inutcin/boomboom/stages/expert3/README.md

# Третья инженерная экспертиза

Проведена только по двум темам:

1. прижимные пружины после fix7 (L0=70, Ø12, проволока 1,0);
2. контакт ролика с кулачком.

Остальные части устройства (ограждение, привод, валы, балка 21, крепление,
шарик, документы) **не проверялись**; замечания второй экспертизы по ним не
повторяются.

## Результаты этапа

- Отчёт: [Report.md](./Report.md)
- Вопросы и допущения: [Interview.md](./Interview.md)
- Подбор пружины для 5/10/15 Гц × 3/5/10 мм: [optimum.md](./optimum.md) (размах) и [optim-pick-pick.md](./optim-pick-pick.md) (нуль-пик)
- Реестр: [findings.csv](./findings.csv) — **2 критичных, 3 важных,
  1 пожелание**
- Числовые проверки: [cad/calc.csv](./cad/calc.csv) — 36 строк: 11 OK,
  10 FAIL, 6 WARN, 9 INFO
- Карта контакта: [cad/map.csv](./cad/map.csv) — 33 режима
- Расчёт: [cad/analysis.py](./cad/analysis.py)
- Листы: [fig/spring_contact.svg](./fig/spring_contact.svg),
  [fig/contact_map.svg](./fig/contact_map.svg),
  [fig/spring_stress.svg](./fig/spring_stress.svg),
  [fig/expert_sheet.svg](./fig/expert_sheet.svg)
- Размеченные рендеры: [pic/review_spring.png](./pic/review_spring.png),
  [pic/review_roller.png](./pic/review_roller.png); превью — `pic/*_preview.png`

## Главное

- L0=70 повышает преднатяг с 51,5 до **92,1 Н**, силу внизу — до 65,0 Н;
  контакт 15 Гц/10 мм — **60,3 Н** по идеальной синусоиде (1,48 от
  инерционной) и **72,0 Н** по фактическому 2-лепестковому профилю (2,48).
- По гармонической синусоиде цель 2× **не достигнута**: нужно L0≥77,9 мм или
  k≥0,834 Н/мм на пружину.
- Напряжение в проволоке Ø1,0 — **729 МПа** сверху, 515 МПа снизу, 1222 МПа
  при сжатии до твёрдого; это выше усталостного допустимого (ориентировочно
  500…700 МПа). 4×Ø12×1,0 L0=70 **нельзя принимать** без переделки/
  проверки материала.
- f_соб остаётся **8,64 Гц** внутри 5…15; L0 не меняет частоту.
- Номинальный ID 10,0 при вале Ø10; сжатие 34 мм — риск трения/заклинивания.
- Фактический 2-лепестковый профиль даёт запас 2,48, но он негармонический;
  если C8 исправить, пружина окажется недостаточной.

**Оптимальный подбор для 5/10/15 Гц × 3/5/10 мм** — в
[optimum.md](./optimum.md): рекомендуемая пружина **Ø17×1,5×60, 9 активных
витков**, контакт 15/10 — **111,8 Н (2,72×)**, τ=479 МПа, f_соб=12,81 Гц.

**Реализация.** Оптимальная пружина для размаха 3/5/10 мм реализована в
[fix8](../fix8/README.md): 4×Ø17×1,5×60, 9 витков; 3D-модель, спецификация,
листы и рендеры пересобраны. Остальные S1–S6 (кроме выбора пружины) и
гармонический профиль C8 остаются.
