inutcin/boomboom/stages/expert2/README.md

# Вторая инженерная экспертиза

1. Проведи инженерную экспертизу модели, созданной в этапе fix6

2. Сформируй корректировки и замечания, разделив из на 3 части
    - критичные - делающие эксплуатацию невозможной и несущие риск серьёзных
      травм
    - важные - существенно ухудшающие характеристики устройства и несущие
      неудобства при эесплуатации.
    - пожелыния - не несущие прямых рисков, но нежелательные в перспективе.
3. Корректировки и замечания оформи в следующий этап: 
    - каталог fix4 
    - название "Первая корректировка и замечания после инженерной экспертизы", 
    упомяни его в корневом README.md

## Результаты этапа

Объект — модель [`stages/fix6`](../fix6/README.md); модель **не изменялась**.

- Отчёт: [Report.md](./Report.md)
- Вопросы, допущения и что не проверялось: [Interview.md](./Interview.md)
- Реестр 39 замечаний: [findings.csv](./findings.csv) — **8 критичных,
  23 важных, 8 пожеланий**
- Числовые проверки: [cad/calc.csv](./cad/calc.csv) (55 строк: 12 OK,
  10 WARN, 30 FAIL, 3 INFO); карта режимов: [cad/map.csv](./cad/map.csv)
  (33 режима)
- Воспроизводимый расчёт: [cad/analysis.py](./cad/analysis.py)
- Листы: [fig/operating_map.svg](./fig/operating_map.svg) (карта
  «частота × размах»), [fig/spring_contact.svg](./fig/spring_contact.svg),
  [fig/kinematics.svg](./fig/kinematics.svg),
  [fig/load_path.svg](./fig/load_path.svg),
  [fig/tolerance_stack.svg](./fig/tolerance_stack.svg),
  [fig/expert_sheet.svg](./fig/expert_sheet.svg)
- Размеченные рендеры: [pic/review_iso.png](./pic/review_iso.png),
  [pic/review_shield.png](./pic/review_shield.png),
  [pic/review_mechanism.png](./pic/review_mechanism.png),
  [pic/review_front.png](./pic/review_front.png); превью листов —
  `pic/*_preview.png`
- Следующий этап: [fix7 — Первая корректировка и замечания после второй
  инженерной экспертизы](../fix7/README.md)

**О каталоге.** В п. 3 задания указан `fix4`, но этот каталог уже существует
и выполнен. Это опечатка; создан `stages/fix7`, ссылка добавлена в корневой
README. Подробно — в [Interview.md](./Interview.md), вопрос В1.

**Вывод:** fix6 исправил осевой зажим 6200 (4 конуса + 4 nyloc; это принято),
но модель не готова к эксплуатации. Остаются 7 критичных замечаний первой
экспертизы (ограждение, привод/патрон, фиксация кулачка, юстировка валов,
упор балки 21, режимы с шариком, пружины) и добавлено новое критичное C8:
фактическое движение 2-лепесткового кулачка не гармоническое (4-я гармоника
0,505 мм, 5,0 % хода для 10 мм; отклонение 5,5 %). Важных замечаний — 23,
пожеланий — 8. В [fix7](../fix7/README.md) выполнены **только параметры
прижимных пружин** (L0=70, Ø12, проволока 1,0); остальные C1–C8, I1–I23,
W1–W8 остаются. Третья экспертиза — [expert3](../expert3/README.md) — проверила
только пружины и контакт ролика.
