inutcin/boomboom/stages/expert/README.md

# Инженерная экспертиза

1. Проведи инженерную экспертизу модели, созданной в этапе fix3
2. Сформируй корректировки и замечания, разделив из на 3 части
    - критичные - делающие эксплуатацию невозможной и несущие риск серьёзных
    травм
    - важные - существенно ухудшающие характеристики устройства и несущие
    неудобства при эесплуатации.
    - пожелыния - не несущие прямых рисков, но нежелательные в перспективе.
3. Корректировки и замечания оформи в следующий этап: 
    - каталог fix4 
    - название "Первая корректировка и замечания после инженерной экспертизы", 
    упомяни его в корневом README.md

## Результаты этапа

- Отчёт: [Report.md](./Report.md)
- Вопросы, допущения и что не проверялось: [Interview.md](./Interview.md)
- Реестр 33 замечаний: [findings.csv](./findings.csv) — 7 критичных,
  18 важных, 8 пожеланий
- Числовые проверки: [cad/calc.csv](./cad/calc.csv) (33 строки: 6 OK,
  8 WARN, 14 FAIL, 5 INFO); карта режимов: [cad/map.csv](./cad/map.csv)
- Воспроизводимый расчёт: [cad/analysis.py](./cad/analysis.py)
- Листы: [fig/operating_map.svg](./fig/operating_map.svg) (карта
  «частота × размах»), [fig/spring_contact.svg](./fig/spring_contact.svg),
  [fig/kinematics.svg](./fig/kinematics.svg),
  [fig/load_path.svg](./fig/load_path.svg),
  [fig/tolerance_stack.svg](./fig/tolerance_stack.svg),
  [fig/expert_sheet.svg](./fig/expert_sheet.svg)
- Размеченные рендеры: [pic/review_iso.png](./pic/review_iso.png),
  [pic/review_mechanism.png](./pic/review_mechanism.png),
  [pic/review_front.png](./pic/review_front.png); превью листов — `pic/*_preview.png`
- Следующий этап: [fix4 — Первая корректировка и замечания после инженерной экспертизы](../fix4/README.md)

**Вывод:** модель fix3 геометрически целостна (143/144 проверок OK), но не
готова к эксплуатации: 7 критичных замечаний (ограждение, привод/патрон,
осевая фиксация кулачка, юстировка валов, упор балки 21, режимы с шариком,
пружины), 18 важных и 8 пожеланий. Модель fix3 не изменялась; исправления
вынесены в fix4.
