inutcin/boomboom/stages/fix11/Report.md

# Отчёт по этапу «Третья корректировка после третьей инженерной экспертизы»

Дата: 2026-11-03; дополнение по валам — 2026-11-05
Этап: `stages/fix11`
База: [`stages/fix9`](../fix9/README.md) (имперская ветвь)
Инструменты: FreeCAD 0.19 (`Part`, HLR), Blender 3.0.1 (EEVEE),
Python 3.10, cairosvg.

Этап выполняет **10 замечаний** [`README.md`](./README.md) с уточнениями
пользователя: шпильки разведены на **40 мм** от осевой линии, сверху
ничего не накручивается, балка поджимается снизу шайбой и гайкой,
опора шпильки — шайба и гайка на нижней балке.

## 1. Результат

| Результат | Файлы |
|---|---|
| 3D-модель, STEP сборки | `cad/step/vibrotable_assembly.step` |
| STEP деталей и отрезков | `cad/step/22_T01…T18.step`, `22_frame.step`, `41_clamp_studs.step`, `42_clamp_bottom.step`, `43_clamp_press.step`, остальные `*.step` |
| Исходники | `cad/model.py`, `params.py`, `build.py`, `draw_sheet.py`, `export_groups.py`, `render_views.py` |
| Печатные детали | `cad/stl/table.stl`, `overlay.stl`, `podstol.stl`, `cam_3/5/10.stl`; `cad/print.csv` |
| Спецификация | [`spec.csv`](./spec.csv) (45 поз.), [`shopping.csv`](./shopping.csv) (47 строк), [`params.csv`](./params.csv) |
| Деталировка труб и сварка | [`fig/frame_tubes.svg`](./fig/frame_tubes.svg), [`tube_cut.csv`](./tube_cut.csv); размеры рамы 300/200/360, виброотсек/вынос 160/200, поперечины 140, балки выноса 180, по граням поперечин 110/130 |
| Раскрой 4 труб ×1000 мм | [`techdraw/`](./techdraw/README.md): A4 альбом, М 1:5, PDF/SVG/PNG, `cut_plan.csv`; 18 отрезков рамы, остаток 170 мм; балки 21 — из отдельной трубы |
| Раскрой направляющих валов | [`techdraw/shaft_cut_layout.py`](./techdraw/shaft_cut_layout.py): A4 альбом, М 1:2,5, PDF/SVG/PNG/CSV; 2 прутка Ø10×500 → 4 вала по 176 мм (166 + 5×2), резьба M10×15, рез 5 мм, остаток 276 мм |
| Эскизы деталей | [`fig/details.svg`](./fig/details.svg), [`fig/clamp.svg`](./fig/clamp.svg), [`fig/cam.svg`](./fig/cam.svg), [`fig/vibrotable_shield.svg`](./fig/vibrotable_shield.svg) |
| Проекции / изометрия | [`fig/vibrotable_views.svg`](./fig/vibrotable_views.svg), [`fig/iso.svg`](./fig/iso.svg), [`fig/iso_open.svg`](./fig/iso_open.svg) |
| Инструкция по сборке | [`Assembly.md`](./Assembly.md), [`fig/assembly_steps.svg`](./fig/assembly_steps.svg), [`torque.csv`](./torque.csv) |
| Проверки / массы | [`cad/checks.csv`](./cad/checks.csv) (207: 204 OK, 3 предупреждения), [`cad/mass.csv`](./cad/mass.csv) |
| Рендеры | `pic/render_*.png` (Blender EEVEE); превью листов — `pic/*.png` |

## 2. Что изменено по замечаниям

| № | Замечание | Реализация |
|---|---|---|
| 1 | Не фрезеровать пазы в уголках, не сверлить стойки | Пазы и отверстия в стойках убраны; в накладках только 2×Ø4,5 под M4 |
| 2 | Уголки не держат балку вниз; держат от вываливания вперёд/назад | Накладки 50×50, ширина 25, 2 мм, 8 шт.; лепесток 50 перекрывает стойку на 20 мм и упирается, без крепления; влево-вправо держат стойки |
| 3 | 2×Ø10 в верхней грани нижней балки, низ не сверлить | В T13/T14: 4 отверстия Ø10 (по 2 на балку), X=10/150, **Y=60/140**, только верхняя стенка |
| 4 | Сквозные Ø10 в прижимной балке | В балке 21: 2×Ø10 сквозь верхнюю и нижнюю грани на Y=60/140 |
| 5 | Шпилька M10 в нижнюю балку и через прижимную | 4 шпильки **M10×117**, строительные 4.6; низ Z=18 в гнезде, верх Z=135 (5 мм над балкой); Y=60/140 |
| 6 | Шайбы и гайки между балками; опускание верхними гайками | **Сверху ничего**; опора — шайба + гайка nyloc на верхней грани нижней балки (Z=20); поджим — шайба + гайка снизу прижимной балки (Z=100,5…110); ход 20 мм поджимной гайкой |
| 7 | Лепестки 50 мм; к балке M4 с nyloc; к стойкам не фиксировать | Накладки 50×50; 8 винтов M4×35 + 8 nyloc + 16 шайб; к стойкам крепления нет |
| 8 | Вал привода и ось ролика — высокопрочные | В спецификации: «8.8 высокопрочная»; шпильки поджима — «4.6 строительная» |
| 9 | 3 комплекта шпилек привода с приваренной гайкой | Поз. 20 — 3 компл. (1 установлена + 2 запасных); в сборке 1 |
| 10 | Шпильки поджима — строительные | Отдельная поз. 41, M10×117, 4 шт., 4.6 |

## 3. Геометрия узла поджима

- **Рама:** 18 отрезков 20×20×2, 360×200×300; T13/T14 — 4×Ø10 только
  в верхней стенке (Z=18…20), низ не сверлить; отверстий в стойках нет.
- **Балка 21:** 2 шт., труба 20×20×2, L=159,6, Z=110…130; седло R15×5;
  2×Ø10 на Y=60/140; 4×Ø4,5 на Y=30/45/155/170; 4 втулки 16×16×2 L=16.
- **Накладки:** 8 шт., 50×50, ширина 25, 2 мм; вертикальный лепесток
  25×50 (Z=80…130), горизонтальный 50×25 (Z=110…135); перекрытие
  стойки 20 мм; 2×M4×35 на конец.
- **Шпильки:** 4×M10×117; X=10/150, **Y=60/140**; низ Z=18 (гнездо),
  верх **Z=135**; над балкой **5 мм**; до нижних гаек валов (Z=140,5) —
  **5,5 мм** (по Y разнесены на 10 мм); до средней поперечины — 15 мм.
- **Опора:** шайба Ø20/Ø10,5×1,5 + гайка M10 nyloc на верхней грани
  нижней поперечины (Z=20…29,5); шпилька опирается на гайку.
- **Поджим:** шайба Ø20/Ø10,5×1,5 + гайка M10 снизу прижимной балки
  (Z=100,5…110); сверху на шпильку ничего нет.
- **Ход балки:** 20 мм (130→110) поджимной гайкой; прорезь уходит ниже
  6200 на 15 мм.
- **Съём:** отдать поджимную гайку, опустить балку на 20 мм, поднять её
  со шпильками на 2 мм; снять опорную гайку, поднять шпильку на 2 мм и
  вынуть. Верх шпильки при этом 137 мм — ниже средней поперечины (150).

## 4. Проверки

[`cad/checks.csv`](./cad/checks.csv): **207 проверок, 204 OK,
3 предупреждения**.

| Проверка | Значение | Норма | Статус |
|---|---|---|---|
| Рама — число отрезков / сечение | 18 / 20×20×2 | 18 / 20×20×2 | OK |
| Рама — габарит | 360×200×300 | 360×200×300 | OK |
| Рама — отверстия под шпильки | 4×Ø10, только верхняя стенка | 4 | OK |
| Рама — отверстия в стойках | 0 | 0 | OK |
| Балка 21 — Ø10 / Ø4,5 | 2 / 4 | 2 / 4 | OK |
| Накладки — 50×50 / перекрытие | 50×50 / 20 мм | 50×50 / 20 | OK |
| Накладки — к стойкам | нет | нет | OK |
| Шпильки — 4×M10×117 | 4 / 117 / 5 | 4 / 117 / ≤5 | OK |
| Шпильки — Y=60/140 | 40 мм от оси | 40 | OK |
| Шпильки — опора / поджим | шайба+гайка / шайба+гайка | 1+1 | OK |
| Шпильки — сверху | ничего | нет | OK |
| Шпильки — зазор до нижних гаек валов | 5,5 мм | >2 | OK |
| Валы — длина / резьба | 176 / M10×15 | 176 / M10×15 | OK |
| Валы — крепление | 2 гайки M10 + 2 шайбы Ø18 | 2+2 | OK |
| Шпильки — зазор до поперечины | 15 мм | >0 | OK |
| Шпильки — зазор до 6200 | 20 мм | >5 | OK |
| Ход балки | 20 мм | 20 | OK |
| Съём — подъём шпильки | 2 мм | <8 | OK |
| Съём — верх шпильки | 5 мм | ≤5 | OK |
| Съём — балка над шпильками | 2 мм | ≤8 | OK |
| Седло 6200 в стенке 2 мм | R15×5 | R15×5 | **ВНИМАНИЕ** |
| f_соб стола | 12,8 Гц | вне 5…15 | **ВНИМАНИЕ** |
| Кожух — резьба M4 в стенке 2 мм | 2 мм | ≥2 | **ВНИМАНИЕ** |
| Габарит сборки | 382×218×313 | 382×218×313 | OK |
| Масса без дрели | 9,12 кг | — | OK |
| Пересечения (все пары) | 0,000 мм³ | <0,5 | OK |
| Ходы стола ±5 / кулачки 3/5/10 | 0,000 мм³ | <0,5 | OK |
| Балка 21 вниз 20 / картридж 44 | 0,000 мм³ | <0,5 | OK |

Предупреждения — только унаследованные:

1. **Седло 6200 в стенке 2 мм** — контакт по кромке, проверить.
2. **f_соб 12,8 Гц** внутри 5…15 Гц — S3 expert3; демпфер.
3. **Резьба M4 в стенке 2 мм** под кожух — слабая, но нагрузка мала.

## 5. Масса

| Узел | Масса, г |
|---|---:|
| Рама (18 труб + втулки/гайки) | 4193,1 |
| Балка 21 + втулки + заглушки | 450,6 |
| Накладки + крепёж M4 | 297,7 |
| Шпильки, опора, поджим | 381,7 |
| Стол / накладка | 559,5 |
| Подстолье + винты | 540,2 |
| Валы / гайки / шайбы / пружины | 572,4 |
| LMK / 6200 / ролик | 579,4 |
| Картридж (кулачок, вал, ось, гайки, кронштейн) | 498,8 |
| Кожух / винты | 747,7 |
| Остальное (заглушки, U-хомуты, винты LMK/накладки, буферы, кольца) | 301,9 |
| **ИТОГО без дрели** | **9123,1** |

Масса снизилась с 9458,3 г (fix9) на **335,2 г**:

- добавлены шпильки, опора и поджим: +381,7 г;
- накладки и крепёж M4 вместо уголков и M6: −402,5 г;
- убраны 8 втулок из стоек: −108,9 г;
- замена ограничителей WCS10FR на гайки/шайбы и удлинение валов:
  −192,2 г;
- прочее (отверстия, заглушки): ≈−13,3 г.

Две запасные шпильки вала с гайками (по 149,5 г) в сборку не входят:
транспортная масса ≈**9,42 кг**. Движущаяся масса (стол + накладка +
LMK + кронштейны + ролик + пружины + шарик) ≈0,92 кг; 4k=5,989 Н/мм;
f_соб≈12,8 Гц.

## 6. Узел поджима: как работает

- Шпилька **не** проходит через всю высоту с гайками: сверху ничего нет,
  по длине только две гайки — опорная (nyloc) и поджимная.
- Опорная гайка с шайбой лежит на верхней грани нижней поперечины;
  шпилька опирается на неё, а не на дно балки. Это задаёт высоту шпильки.
- Поджимная гайка с шайбой стоит снизу прижимной балки и поднимает её
  к 6200; при ослаблении балка опускается на 20 мм. Верх шпильки 135 мм,
  поэтому нижние гайки валов (Z=140,5…148,5) не задеваются; по Y они
  разнесены на 10 мм.
- Съём: отдать поджимную гайку, опустить балку, поднять её со шпильками на 2 мм; затем снять опорную гайку и вынуть шпильку (подъём 2 мм).
  Средняя поперечина (Z=150) не мешает: верх шпильки 137 мм.

## 7. Остатки expert2 / expert3

В этап **не входили** и остаются:

- **C1** — ограждение/аварийный останов;
- **C2** — привод «дрель–вал» (патрон, хвостовик, муфта, осевой упор);
- **C3** — осевая/радиальная фиксация кулачка;
- **C4** — юстировка параллельности валов;
- **C5** — седло/кромка 2 мм балки 21 — испытания;
- **C6** — определение «амплитуды» (принят размах) и карта режимов;
- **C7** — пружины: паспорт/испытания;
- **C8** — гармонический профиль кулачка;
- **I1–I23** — смена диска, точность, шарик, дрель, крепление к станине,
  массы, моменты и т.д.;
- **W1–W8** — пожелания;
- **S3, S5, S6** — f_соб, профиль, преднатяг.

## 8. Ограничения

- Расчёт прочности шпилек/опоры — только геометрия и масса; FEA,
  усталости и испытаний 10^6 циклов нет.
- Ø10 в T13/T14 сверлить до сварки средних поперечин или угловой
  насадкой; сверху мешает средняя поперечина (Z=150…170).
- Опорная гайка nyloc на верхней грани нижней балки: доступ изнутри
  рамы; проверить, что гайка не мешает ходу балки (зазор до низа
  балки ≈80 мм при верхнем положении).
- Седло 6200 в стенке 2 мм — принятое решение fix9, не проверено на
  смятие/износ.
- Резьба M4 в стенке 2 мм — слабая; для кожуха принята.
- Резьба M10×15 на валах не моделируется в 3D (гладкий Ø10 h6);
  она задана на чертеже `tachdraw/pdf/02_shaft.pdf` и в спецификации.
- Реальные k/L0/ID пружины, материал и термообработка не измерены.
- Динамика с шариком, удар, податливость PLA, шум и резонанс рамы не
  моделировались.
- Масса — по объёмам модели и плотностям; реальные LMK/6200/крепёж могут
  дать отклонение.
- Остатки C1–C8, I1–I23, W1–W8, S3, S5, S6 — вне этапа.

## 9. Воспроизведение

```bash
cd stages/fix11/cad
freecadcmd build.py          # STEP, STL, spec, params, tube_cut, checks,
                             # mass, print, torque
freecadcmd draw_sheet.py     # fig/*.svg (кэш cache/views_v9.json)
freecadcmd export_groups.py  # stl/groups/*.stl
blender -b --python render_views.py
cd ..
python3 - <<'PY'
import cairosvg
for n in ("vibrotable_views", "vibrotable_spec", "iso", "iso_open",
          "frame_tubes", "details", "assembly_steps", "clamp", "cam",
          "vibrotable_shield"):
    cairosvg.svg2png(url=f"fig/{n}.svg", write_to=f"pic/{n}.png", dpi=110)
PY
```

Если нужно пересобрать проекции: удалить `cad/cache/views_v9.json`.

## 10. Изменение крепления валов (2026-11-05)

По требованию пользователя изменена концепция крепления направляющих
валов:

- кольца-ограничители WCS10FR (поз. 1, 8 шт.) **удалены** из модели,
  спецификации, списка покупок, чертежей, рисунков и рендеров;
- валы удлинены на **5 мм с каждого торца**: `L=176 мм`,
  `Z=137…313` (было 166 мм, `Z=142…308`);
- на обоих концах — резьба **M10×15**;
- крепление — **2 гайки M10 + 2 шайбы Ø18/Ø10,5×1,5 на вал**
  (поз. 45/46, 8 + 8 шт.), снаружи средней и верхней поперечин;
- затяжка 8 Н·м, фиксатор резьбы;
- резьбовые участки вне LMK: нижний `Z=137…152`, верхний `Z=298…313`.

Обновлены:

- `cad/model.py`, `cad/params.py`, `cad/build.py` — новая геометрия,
  гайки/шайбы, проверки;
- `spec.csv` — 45 позиций (поз. 1 исключена, добавлены 45/46);
- `shopping.csv` — удалён WCS10FR, добавлены пруток Ø10×500 (2 шт.),
  гайки M10 (8) и шайбы Ø18 (8);
- `torque.csv` — момент гаек вала 8 Н·м;
- `fig/*.svg`, `pic/*.png` — перегенерированы без колец;
- `tachdraw/pdf/02_shaft.pdf` — новый лист вала Ø10 h6, L=176,
  M10×15, деталь А 2:1;
- `techdraw/*` — лист раскроя валов обновлён: L=176, M10×15,
  гайка + шайба Ø18.

Проверки: **207, 204 OK, 3 предупреждения** (седло 2 мм, f_соб,
резьба кожуха). Габарит сборки — `382×218×313`; масса без дрели —
**9,123 кг**. Пересечений валов с гайками/шайбами и рамой нет.

## 11. Размеры на схеме сварки рамы (2026-11-05)

На лист [`fig/frame_tubes.svg`](./fig/frame_tubes.svg) (и
[`pic/frame_tubes.png`](./pic/frame_tubes.png)) добавлены размеры
схемы сварки рамы:

- общая высота — **300**;
- общая ширина — **200**;
- общая глубина — **360**;
- глубина виброотсека — **160**, выноса — **200**;
- расстояние между поперечинами виброотсека — **140** по осям
  (X=10/150);
- расстояние между продольными балками выноса — **180** по осям
  (Y=10/190);
- от нижней грани верхней поперечины (Z=280) до верхней грани
  средней поперечины (Z=170) — **110**;
- от нижней грани средней поперечины (Z=150) до верхней грани
  нижней поперечины (Z=20) — **130**.

Размеры 300/200/360/160/200 — по наружным плоскостям; 140 и 180 —
между осями труб; 110/130 — по граням поперечин. Значения сверены с
`params.csv`:
`H_frame=300`, `W_frame=200`, `L_frame=360`, `L_vibro=160`,
`L_ext=200`, `guide_x1/x2=10/150`, `top_z0=280`, `mid_z1=170`,
`mid_z0=150`, `base_h=20`; T11/T12 — `Y=0/180` (оси 10/190).
Лист перегенерирован в масштабе 1:4, PNG обновлён.

## 12. Стоимость генерации

Модель `deepseek/deepseek-flash` (variant high): вход $0,15/млн, чтение
кэша $0,003/млн, выход (включая reasoning) $0,60/млн. Учёт — `session_v2`
OpenCode, сессия `ses_e601a7ab3ffeW92x1UC57lqzAx`; снимок на 2026-11-03
после сборки.

| Категория | Токены | Стоимость, USD |
|---|---:|---:|
| **Всего** | **53 924 224** | **0,35160** |
| Входящие мимо кэша | 335 009 | 0,05025 |
| Закешированные входящие | 53 353 728 | 0,16006 |
| Исходящие (output) | 90 530 | 0,05432 |
| Исходящие (reasoning) | 144 957 | 0,08697 |
| **Исходящие всего (output + reasoning)** | **235 487** | **0,14129** |

Стоимость fix9 и expert3 — в их отчётах; здесь учтён только этап fix11.
Стоимость дополнений «изменение крепления валов» и «размеры на схеме
сварки» — в [`techdraw/Report.md`](./techdraw/Report.md), раздел 10.
