inutcin/boomboom/stages/model/Report_prev.md

# Отчёт по этапу «Формирование эскизов устройства по рисунку от руки»

## 1. Исходные данные и результат

Исходные данные — три эскиза от руки (`pic/vibrotable_front.png`,
`pic/vibrotable_left.png`, `pic/vibrotable_top.png`) и описание конструкции в
корневом `README.md`.

Сделано:

| Результат | Файл(ы) |
|---|---|
| Параметрическая 3D-модель (CadQuery 2.7) | `cad/model.py`, `cad/params.py` |
| Сборка STEP | `cad/step/assembly.step` |
| Детали STEP (31 типоразмер, локальные системы) | `cad/step/parts/*.step` |
| Печатные детали STL (ориентация для печати) | `cad/stl/print/overlay_150x150x10.stl`, `cam_R45-50_t14.stl` |
| STL сборки для рендера (86 позиций) | `cad/stl/asm/*.stl` |
| Эскиз в 3 проекциях, A3, HLR из модели | `fig/vibrotable_views.svg` |
| Спецификация + таблица параметров, A3 | `fig/vibrotable_spec.svg` |
| Спецификация (данные) | `cad/spec.csv` |
| Таблица параметров (данные) | `cad/params.csv` |
| Рендеры (9 ракурсов) | `pic/render_*.png` |
| Превью листов | `pic/views_sheet.png`, `pic/spec_sheet.png` |

## 2. Принятые базы и система координат

- **X** — вдоль рамы: 0 — левый торец, 400 — правый; вибро-байон 0…200,
  байон дрели 200…400.
- **Y** — поперёк рамы: 0 — плоскость симметрии, ±100 — наружные грани.
- **Z** — вверх: 0 — плоскость установки (пол/станина), 300 — верх рамы.
- **Ось привода и кулачка:** X = 100, Y = 0, Z = 150.
- **Оси направляющих:** X = 100 ± 54, Y = ±54.
- **Плоскости:** стол Z = 224…234, накладка 234…244, подстолье 188…200,
  верх рамы 300 (вибро-байон), 188 (байон дрели).

Все отверстия и центры подшипников привязаны к этим базам; размеры собраны в
`cad/params.py` (42 параметра) и `cad/params.csv`.

## 3. Состав изделия

31 типоразмер, 86 позиций сборки:

- **Рама** — сварная из трубы 20×20×1,5: нижний прямоугольник 400×200,
  4 стойки вибро-байона, 4 стойки байона дрели, верхние обвязки на Z=300 и
  Z=188, две средние поперечины (X = 80 и 120) с гнёздами Ø31 под подшипники
  вала привода и 4 дополнительные стойки этих поперечин.
- **Подвижный стол** — фанера 10 мм, 156×156, с отверстиями под валы, фланцы
  LMF10UU и потайные М4.
- **Накладка** — 3D-печать, 150×150×10, сферическая вогнутость R1500
  (стрела 1,9 мм).
- **4 направляющих** Ø10×120, **4 ограничителя** (планки 30×59×5 с гайкой М10),
  **4 линейных подшипника** LMF10UU (10×22×30, фланец Ø42),
  **4 прижимные пружины** Ø18×56 (свободная 70).
- **Кулачковый механизм:** вал привода — шпилька М10, **кулачковый диск**
  Ø95 (R45…R50, эксцентриситет 2,5, толщина 14, ложбинка 8×1,5),
  **2 ролика** 6200 (Ø30×9) на осях М10, зажатых **4 угловыми кронштейнами**
  40×40×20×2 через конические гайки и контрагайки, **2 подшипника вала** 6200
  в гнёздах поперечин, **2 балки фиксации** с полукольцевым гнездом,
  **4 зажима «краб-система»**.
- **Вынос дрели:** подстолье (фанера 12, 190×190), прокладка 17 мм под корпус
  дрели, **2 U-образных хомута** М6, шпилька-хвостовик М10 и соединительная
  гайка, дрель (условная модель-заглушка).

## 4. Числовые проверки

| Проверка | Значение | Норма/вывод |
|---|---|---|
| Габарит сборки | 485 × 200 × 313 мм | X выходит за раму на шпильку (−30) и дрель (455), Z — на гайки валов (313) |
| Габарит рамы | 400 × 200 × 300 мм | по эскизу |
| Ход стола | 5,0 мм (Rmax − Rmin) | требование 3…10 мм — выполнено |
| Радиус контакта ролика | 49,41 мм | в диапазоне Rmin…Rmax = 45…50; натяг к среднему профилю 0,3 мм |
| Зазор стол — кулачок | 24,0 мм | не пересекаются |
| Зазор стол — стойки | 2,0 мм | положительный |
| Фланец LMF — кромка стола | 3,0 мм | фланец целиком на столе |
| Шаг направляющих | 108 × 108 мм | принято (см. Interview.md, п. 1) |
| Пружина монтажная | 56 мм (сжатие 20 %) | свободная 70 мм |
| Ограничители вала | макс. Y = 98 мм | в габарите рамы (100) |
| Масса сборки | **8,324 кг** | сталь 5,328; покупные 1,378; дрель 0,693; фанера 0,398; PLA 0,370; резина 0,156 |
| Минимальная стенка | 1,5 мм (труба), 2 мм (кронштейн) | по эскизу/сортаменту |
| Число тел сборки | 86 | STEP переимпортируется, объём = сумме объёмов деталей |

Массы посчитаны по объёму STEP и плотностям (сталь 7,85; фанера 0,60;
PLA 1,24; резина 1,20 г/см³). Дрель учтена условно.

Визуальные проверки: 9 рендеров Blender (`render_iso`, `render_iso_rear`,
`render_front`, `render_left`, `render_top`, `render_cam`, `render_cam_axial`,
`render_mech_iso`, `render_mech_axial`). На двух последних рама, кронштейны и
LMF10UU скрыты — видны оба ролика, касающиеся кулачка, и эксцентриковое
отверстие диска.

## 5. Отклонения от эскиза и предложения

1. **Шаг направляющих** уменьшен с ~182×108 до 108×108, стол — с 160 до 156 мм:
   иначе фланец Ø42 свешивается за кромку стола, а стол касается стоек.
2. **Две средние поперечины получили 4 стойки** — в эскизе они не опираются на
   раму; без стоек балки фиксации подшипников крепить не к чему.
3. **Кулачок:** толщина 14 мм и кольцевая ложбинка 8×1,5 (в эскизе только
   «1–2 мм»).
4. **Два ролика по Y = ±30** вместо четырёх по углам стола: четыре ролика не
   могут одновременно касаться одного диска. Рекомендация — оставить один
   рабочий ролик, второй выставить с зазором (см. Interview.md, п. 2).
5. **Регулировочные пазы** оставлены в горизонтальной полке (как в эскизе);
   вертикальная регулировка ролика выполняется коническими гайками.
6. **Хомут дрели** R25, шпильки 60 мм вместо R90–100, h150 — размеры эскиза не
   соответствуют корпусу бытовой дрели.
7. **Прокладка 17 мм** между корпусом дрели и подстольем обеспечивает
   соосность патрона и вала привода (Z = 150); при другой дрели толщина
   подбирается.
8. **Накладка** — сферическая вогнутость R1500; в эскизе показан только профиль.
9. **Краб-система** смоделирована упрощённо (зажим с двумя М6).
10. **Пружины** выбраны без расчёта (усилие не задано): Ø18, 1,5 мм, 70/56 мм.

## 6. Ограничения этапа

- Не выполнялись прочностные, жёсткостные и динамические расчёты; жёсткость
  пружин подобрана конструктивно.
- Чертежи деталей (единичные) не выпускались — только эскиз сборки и
  спецификация; STEP-детали пригодны для правки и фрезеровки/печати.
- Дрель — модель-заглушка; конкретная модель не выбрана.
- Верхний вид насыщен скрытыми линиями (скрытые контуры пружин, фланцев,
  ограничителей); читаемость ограничена масштабом 1:2,5.
- В сборке номинальный натяг ролик–кулачок 0,3 мм; реальный зазор
  выставляется пазами кронштейнов и коническими гайками.
- Совпадающие контактные плоскости (верх рельсов рамы и низ подстолья на Z=188,
  прокладка и подстолье, накладка и стол) в модели корректны, но на рендерах дают
  тонкие тёмные линии на стыках; для печати/фрезеровки это не влияет, при
  изготовлении детали сопрягаются по месту.

## 7. Стоимость генерации

По данным учёта сессий OpenCode (модель deepseek/deepseek-flash: вход $0,15/млн,
кэш-чтение $0,003/млн, выход $0,60/млн).

| Категория | Токены | Стоимость, USD |
|---|---:|---:|
| **Всего** | **59 635 439** | **0,7507** |
| Входящие мимо кэша | 518 343 | 0,0778 |
| Закешированные входящие | 58 286 976 | 0,1749 |
| Исходящие (включая reasoning 562 684) | 830 120 | 0,4980 |

Это стоимость текущего прогона этапа (главная сессия + 13 подсессий-исполнителей) (по состоянию учёта на 17:55; финальные вызовы добавили < 2 %).
С учётом предыдущих попыток этого же этапа за 2026-10-29 (сервер перезапускался,
рабочее дерево откатывалось) суммарно по проекту за день: **90 104 076 токенов,
$1,2150** (вход 687 673 — $0,1032; кэш 88 003 328 — $0,2640; выход 1 413 075 —
$0,8478).

## 8. Как воспроизвести

```bash
export PYTHONPATH=/tmp/opencode/cadlibs      # cadquery 2.7 / OCP 7.8
cd stages/model/cad
python3 params.py      # params.csv
python3 model.py       # STEP, STL, spec.csv + проверки
python3 draw.py        # fig/*.svg, pic/*_sheet.png (HLR ~60 c)
blender -b --python render.py   # pic/render_*.png
```
