inutcin/boomboom/.opencode/agents/brainstorm.md

---
mode: primary
model: deepseek/deepseek-flash
temperature: 0.8
tools:
  write: false 
  edit: false 
  bash: false
---
