inutcin/boomboom/.opencode/agents/plan.md

---
mode: primary
model: deepseek/deepseek-flash
temperature: 0.1
permission:
  write: ask
tools:
  write: true
  edit: false 
  bash: false
---
