inutcin/boomboom/stages/correct/README.md

# Замечания и корректировки по модели

Во время этапа [Формирование модели устройства по эскизу от руки без конкретных размеров](../../model/README.md)
были сформированы первые версии чертежей. По этим чертежим надо реализовать 
несколько частей замечаний и корректировок.

- [Часть 1](./1/README.md)
