inutcin/boomboom/stages/correct/1/README.md

# Замечания и корректировки по модели. Часть 1.

## Исходные замечания

1. По чертежам не очень понятно устройство крепления роликов, подстолья,
   крепление дрели к подстолью и крепление кулачкового диска к дрели.
   Необходимо для каждой детали создать изометрическое изображение.
2. Платформа должна быть лёгкой достаточно, чтобы дрель её прокручивала.
3. На платформе (столе) будет лежать шарик. Платформа должна быть слегка
   вогнутой, чтобы шарик не слетал с центра, а если слетал, то корректировался.

## Замечания и уточнения из чата

1. **Узел ролик — кронштейн — втулка — болт и крепление к столу непонятны.**
   Нужна более реалистичная схема; при необходимости — дополнительные виды.
2. **Кронштейн воспринимается как направляющая кулачкового диска.**
   Размер недостаточен, диск может выходить из паза и цепляться за угол.
   Кронштейн нужно немного увеличить, углы скруглить.
3. **Шестигранный крепёж.** Все болты и гайки, имеющие шестигранную форму,
   должны выглядеть шестигранными; крепёж под внутренний шестигранник должен
   иметь шестигранное отверстие под ключ.
4. **Линии выносок не должны пересекаться.** При необходимости номера
   размещать по всем сторонам чертежа.
5. **Финальный PDF-альбом.** Нужно собрать не просто перечисление этапов,
   а все изображения, поясняющие как общий вид, так и детали конкретных
   узлов, используя все предыдущие этапы.

## Уточнения, принятые в чате

1. **«Платформа» и дрель.** Дрель вращает кулачковый диск, стол колеблется
   на пружинах. Требование «лёгкая платформа» понято как облегчение
   подвижного стола; кинематика сохранена.
2. **Шарик** — стальной, Ø20 мм (масса ≈ 33 г).
3. **Изометрии** — для четырёх узлов из замечания 1: крепление роликов,
   подстолье, крепление дрели, крепление диска. Крепёж показывается
   в спецификации; отдельные изометрии гаек и шайб не требуются.
4. **Каталоги** — существующие `figs/` и `pics/`; PNG — A3, 200 dpi,
   3307 × 2339 px.

## Принятые решения

1. **Столешница** — 500 × 400 × 12 мм, фанера; сферическая лунка Ø360 × 3 мм
   (R ≈ 5400 в центре), бортик 10 × 10 мм, шарик Ø20. Масса стола ≈ 1,9 кг,
   подвижной сборки ≈ 2,6 кг.
2. **Подстолье** — 500 × 400 × 18 мм; окно Ø250; отверстия шпилек M12
   Ø14 (440 × 340); отверстия U-болтов Ø9: (130; ±45) и (260; ±45).
3. **Крепление ролика** — кронштейн 84 × 50, щёки 50 × 55, углы R5;
   подшипник 6202-2RS (35 × 15 × 11), ось M12×45, втулка 15/12 × 11;
   крепление к столу винтами M8×20 с потайной головкой и внутренним
   шестигранником, головки закрыты пробками Ø16.
   Кронштейн не является радиальной направляющей: диск катится по ролику,
   а щёки образуют защитную скобу; зазор между щеками 11 мм, диск 6 мм,
   запас 2,5 мм на сторону.
4. **Крепление дрели** — два U-болта M8 под Ø80, подкладка-седло 10 мм,
   верхняя подкладка 2 мм; гайки M8 шестигранные.
5. **Крепление диска** — оправка Ø10/Ø40 × 6, диск с отверстием Ø40,
   винт M8×25 с внутренним шестигранником, шайба Ø60 × 4.
6. **Крепёж** — M12: шестигранные головка и гайка; M8: шестигранные гайки,
   потайные винты с внутренним шестигранником; для винтов добавлены виды
   на головку и разрезы с шестигранным гнездом.
7. **Выноски** — номера разнесены по сторонам; для изометрий и сечений
   применено упорядочивание по углу/стороне, чтобы линии не пересекались.
8. **PDF-альбом** — `stages/all_stages.pdf`, 11 страниц A3: обложка,
   общий вид (эскиз, вид сбоку, вид слева, изометрия) и детали узлов
   (столешница, подстолье, крепление ролика, ось ролика, крепление дрели,
   крепление диска). Более поздние редакции узлов — листы `correct/1`.

## Состав этапа

```
stages/correct/1/
  figs/
    table.svg
    subtable.svg
    roller_unit.svg
    roller_axle.svg
    drill_mount.svg
    cam_mount.svg
  pics/
    table.png
    subtable.png
    roller_unit.png
    roller_axle.png
    drill_mount.png
    cam_mount.png
  tools/
    generate.js
  Interview.md
  Report.md
  README.md
```

Сводный PDF: `stages/all_stages.pdf`.

## Замечания, которые нужно проверить на экспертизе

1. Жёсткость стола 12 мм при нагрузке до 5 кг.
2. Поведение шарика на 15 Гц и размахе 10 мм; плоский борт лунки.
3. Момент дрели на 150…450 об/мин и масса диска.
4. Посадка U-болтов относительно вентиляционных окон дрели.
5. Контакт ролик–диск, ресурс подшипников, биение оправки.
6. Обновление общих видов `model` по результатам части 1.
