inutcin/boomboom/stages/expert3/Report.md

# Отчёт по этапу «Третья инженерная экспертиза»

Дата: 2026-10-30
Этап: `stages/expert3`
Объект: [`stages/fix7`](../fix7/README.md) — модель после задания пружин
L0=70, Ø12, проволока 1,0.
Инструменты: Python 3.10 (`cad/analysis.py`, NumPy), Pillow, cairosvg;
исходные данные fix7 (`params.csv`, `mass.csv`, `checks.csv`), рендеры fix7.

**Область экспертизы.** Только прижимные пружины и контакт ролика с
кулачком. Ограждение, привод, валы, балка 21, крепление, шарик и документы
**не проверялись**; замечания второй экспертизы по ним не повторяются.
Модель fix7 не изменялась.

## 1. Результат

| Результат | Файлы |
|---|---|
| Отчёт | `Report.md` (этот файл) |
| Вопросы, допущения, что не проверялось | [`Interview.md`](./Interview.md) |
| Подбор пружины 5/10/15 Гц × 3/5/10 мм: размах / нуль-пик | [`optimum.md`](./optimum.md) / [`optim-pick-pick.md`](./optim-pick-pick.md) |
| Реестр 6 замечаний (2 / 3 / 1) | [`findings.csv`](./findings.csv) |
| Числовые проверки (36) | [`cad/calc.csv`](./cad/calc.csv) |
| Карта контакта (33 режима) | [`cad/map.csv`](./cad/map.csv) |
| Воспроизводимый расчёт | [`cad/analysis.py`](./cad/analysis.py) |
| Листы: пружины/контакт, карта, напряжение | [`fig/spring_contact.svg`](./fig/spring_contact.svg), [`fig/contact_map.svg`](./fig/contact_map.svg), [`fig/spring_stress.svg`](./fig/spring_stress.svg) |
| Сводный лист A3 | [`fig/expert_sheet.svg`](./fig/expert_sheet.svg), превью [`pic/expert_sheet_preview.png`](./pic/expert_sheet_preview.png) |
| Размеченные рендеры | [`pic/review_spring.png`](./pic/review_spring.png), [`pic/review_roller.png`](./pic/review_roller.png) |
| Превью | `pic/spring_contact_preview.png`, `contact_map_preview.png`, `spring_stress_preview.png` |

## 2. Постановка и допущения

Проверяется, достаточно ли пружин 4×Ø12×1,0 L0=70 для:

1. положительного контакта ролика с кулачком на всех режимах 5…15 Гц ×
   3…10 мм;
2. запаса контакта ≥2× инерционной силы (критерий второй экспертизы);
3. прочности/усталости пружины и её сборки (сжатие 34 мм, ID/вал);
4. отсутствия резонанса/недопустимых сил.

Принято: пружинная сталь (65Г/60С2ХА или аналог), 11 активных витков,
закрытые шлифованные концы, 4 пружины; установленная длина 36 мм; k по
формуле `G·d⁴/(8·D³·n)`; допустимое напряжение кручения для усталости
ориентировочно 500…700 МПа (зависит от материала/термообработки).
Движущаяся масса — 0,919 кг (с реальными LMK/6200 и шариком 33 г).

Контакт считается в двух вариантах:

- **идеальная синусоида** — цель по ТЗ «гармонические колебания»; сила
  контакта `F = F_пружин + mg − m·(s/2)·ω²`;
- **фактический 2-лепестковый профиль fix7** — по опорной функции h(φ)
  (C8 второй экспертизы); сила сверху/снизу разная.

## 3. Пружина в цифрах

| Параметр | Значение |
|---|---:|
| Свободная длина L0 | 70 мм |
| Наружный диаметр / проволока | 12 / 1,0 мм |
| Средний диаметр D | 11 мм |
| Активных витков | 11 |
| Жёсткость k | 0,677 Н/мм |
| 4 пружины, 4k | 2,708 Н/мм |
| Установленная длина | 36 мм |
| Сжатие | 34 мм (было 19 при L0=55) |
| Преднатяг | 92,1 Н |
| Сила внизу (L=46) | 65,0 Н |
| f_соб | 8,64 Гц |
| Твёрдая длина | 13 мм |
| Запас до твёрдого | 23 мм |
| Сила до твёрдого | 38,6 Н/пружину |
| Индекс C / Wahl | 11 / 1,131 |
| Масса | 2,38 г/шт.; 9,53 г на 4 |
| ID номинал / вал | 10,0 / 10,0 мм; в модели 10,2 |

Жёсткость не зависит от L0; L0=70 увеличивает только преднатяг и силу.

## 4. Напряжение и усталость пружины

`τ = Kw·8FD/(πd³)`, `Kw=1,131`:

| Режим | Сила/пружину, Н | τ, МПа |
|---|---:|---:|
| L0=55, верх (fix6) | 12,9 | 407 |
| L0=55, низ | 6,1 | 193 |
| **L0=70, верх** | **23,0** | **729** |
| **L0=70, низ** | **16,2** | **515** |
| L0=77,9 (для 2×), верх | 28,4 | 898 |
| 8×Ø12×0,9, верх | 14,7 | 636 |
| L0=70, сжатие до твёрдого | 38,6 | 1222 |

- Размах при L0=70: 729−515=214 МПа; среднее 622 МПа.
- Для пружинной проволоки Ø1,0 при C=11 это **выше** усталостного
  допустимого (ориентировочно 500…700 МПа); при 15 Гц и длительной работе
  риск просадки/поломки.
- При сжатии до твёрдого 1222 МПа — выше предела; сборка не должна доводить
  до твёрдого.
- Увеличение L0 до 77,9 мм для запаса 2× поднимает напряжение до 898 МПа —
  ещё хуже. Нужен не «длиннее», а другой пружинный пакет (больше пружин /
  меньшая проволока / проверенный материал).

**Геометрия.** Сжатие 34 мм при твёрдой длине 13 мм — запас 23 мм; по
геометрии допустимо. Но номинальный ID 10,0 при вале Ø10 (в модели 10,2)
означает нулевой зазор; при сжатии 34 мм витки могут тереться о вал.
Нужен ID≥10,5 или направляющая втулка.

## 5. Контакт ролика

### 5.1 Идеальная синусоида

| Режим | Инерционная, Н | Контакт, Н | Запас |
|---|---:|---:|---:|
| 15 Гц / 10 мм | 40,8 | **60,3** | **1,48** |
| 15 Гц / 5 мм | 20,4 | 80,7 | 3,95 |
| 15 Гц / 3 мм | 12,2 | 88,8 | 7,26 |
| 5 Гц / 10 мм | 4,5 | 96,6 | 21,3 |
| 8,64 Гц / 10 мм | 13,5 | 87,5 | 6,47 |

Цель 2× на 15 Гц/10 мм — 81,6 Н; фактически 60,3 Н. Нужно:

- L0≥**77,9 мм** (при том же k) — но напряжение 898 МПа; или
- k≥**0,834 Н/мм** на пружину (4k≥3,34) — напряжение ещё выше; или
- больше пружин с меньшей проволокой.

### 5.2 Фактический 2-лепестковый профиль

| Режим 15 Гц/10 мм | Сила, Н | Запас |
|---|---:|---:|
| сверху | 72,0 | 2,48 |
| снизу | 135,1 | 2,21 |

Фактический негармонический профиль даёт запас >2, но:

- он не соответствует требованию «гармонические колебания» (C8);
- внизу сила 135 Н и p0≈42 МПа на PLA-кулачке;
- если C8 исправить на гармонический закон, контакт падает до 60,3 Н
  (1,48) — пружина окажется недостаточной.

**Нельзя принимать пружину по фактическому профилю, не исправив/не
согласовав C8.**

### 5.3 Карта и варианты

[`fig/contact_map.svg`](./fig/contact_map.svg): красная область — идеальный
запас <2×; при L0=70 почти весь диапазон 3…10 мм при 5…13 Гц попадает в неё;
запас ≥2 только при больших размахах/высоких частотах (например, 10 мм при
15 Гц — 1,48, всё ещё <2).

Вариант **8×Ø12×0,9 L0=70**:

- k=0,432 Н/мм; 8k=3,46 Н/мм; преднатяг 117,6 Н;
- контакт 15/10 — 85,8 Н (2,10);
- τ=636 МПа — высокое (верхняя часть 500…700); нужен материал/испытание;
- f_соб=9,76 Гц — по-прежнему внутри 5…15;
- требуется 8 мест/переделка крепления пружин.

### 5.4. Оптимальный подбор

Подробный подбор для 5/10/15 Гц × 3/5/10 мм — в [`optimum.md`](./optimum.md).
Рекомендуемая пружина: **4×Ø17×1,5×60, 9 активных витков** (11 полных),
шайба Ø18; контакт 15/10 — **111,8 Н (2,72×)**, τ=479 МПа, f_соб=12,81 Гц.
Это лучше fix7 (4×Ø12×1,0 L0=70: 60,3 Н / 1,48×, τ=729 МПа) по контакту и
напряжению; вариант Ø18×1,5×70, 10 витков даёт 2,92×, но 535 МПа и шайбу
Ø20.

Реализация — [`../fix8`](../fix8/README.md): 4×Ø17×1,5×60, 9 витков;
3D-модель, спецификация, листы и рендеры пересобраны.

Для **нуль-пик** 3/5/10 мм — [`optim-pick-pick.md`](./optim-pick-pick.md):
4×Ø17×1,8×65, 12 витков; контакт 15/10 — **212,9 Н (2,57×)**, τ=558 МПа,
f_соб=16,4 Гц; шайба Ø18. Там размах 6/10/20 мм, а не 3/5/10.

## 6. Замечания

| ID | Категория | Замечание | Корректировка | Приёмка |
|---|---|---|---|---|
| S1 | критичное | 4×Ø12×1,0 L0=70 перегружены: τ=729/515 МПа, размах 214, твёрдое 1222; усталость | 8…16 пружин с меньшим d (8×0,9: 636 МПа) или проверенный материал/термообработка; допускаемое τ и ресурс | τ_max≤допускаемого; остаточная деформация ≤0,5 %; сила ±5 % после 10^6 |
| S2 | критичное | Контакт 1,48× по гармонической синусоиде <2×; L0=70 недостаточно | L0≥77,9 мм или k≥0,834 Н/мм (но растёт τ) или больше пружин; проверить оба профиля | Контакт ≥2× на 15 Гц/10 мм и на всём диапазоне для гармонического и фактического профиля |
| S3 | важное | f_соб=8,64 Гц внутри 5…15; L0 не меняет; демпфера нет | Демпфер/втулки или изменить k/m; проверить 8,64 Гц | f_соб вне 5…15 или ζ≥0,1; амплитуда ±0,2 мм |
| S4 | важное | ID 10,0 при вале Ø10; сжатие 34 мм — трение/заклинивание | ID≥10,5 или направляющая втулка Ø9,6; проверить скольжение | Зазор ≥0,3 мм; страгивание ≤5 Н; износ ≤0,02 мм за 10 ч |
| S5 | важное | Фактический 2-лепестковый профиль маскирует недостаток пружины; внизу 135 Н, p0≈42 МПа | Согласовать пружину и профиль; при гармоническом профиле усилить пакет; стальная вставка при необходимости | Контакт ≥2× для обоих профилей; p0≤допускаемого; 10^6 |
| S6 | пожелание | Нет регулировки преднатяга и паспорта пружины | Шайбы/винт преднатяга; паспорт k/L0/материал/концы/допуск/ресурс | Преднатяг регулируется; сила ±5 %; паспорт в spec.csv |

## 7. Числовые проверки

Полный список — [`cad/calc.csv`](./cad/calc.csv) (36 строк: 11 OK, 10 FAIL,
6 WARN, 9 INFO) и [`cad/map.csv`](./cad/map.csv) (33 режима). Ключевые:

| Проверка | Значение | Норма / вывод |
|---|---|---|
| L0 / OD / проволока | 70 / 12 / 1,0 мм | задание fix7 |
| k / 4k | 0,677 / 2,708 Н/мм | L0 не влияет |
| Преднатяг / внизу | 92,1 / 65,0 Н | было 51,5 / 24,4 |
| Сжатие / твёрдая длина | 34 / 13 мм | запас 23 мм |
| f_соб | 8,64 Гц | внутри 5…15 → S3 |
| τ верх / низ / твёрдое | 729 / 515 / 1222 МПа | выше 500…700 → S1 |
| ID / вал | 10,0 / 10,0; модель 10,2 | зазор 0 → S4 |
| Контакт 15/10 идеал | 60,3 Н (1,48) | цель 81,6 → S2 |
| Контакт 15/10 факт | 72,0 / 135,1 Н (2,48/2,21) | негармонический профиль → S5 |
| L0 для 2× | 77,9 мм | +7,9 мм; τ→898 |
| k для 2× | 0,834 Н/мм | +23 %; τ растёт |
| p0 при 135 Н | 42,1 МПа | PLA-кулачок; вставка/испытание |
| 8×0,9 L0=70 | 85,8 Н (2,10); τ=636 | лучше, но τ высокое |
| Допуск L0/k | не задан | ±1 мм/±5 %; контакт ±2,7 Н |
| Материал/концы/ресурс | не заданы | паспорт; 10^6 |
| Регулировка преднатяга | нет | S6 |

## 8. Визуальные проверки

- [pic/review_spring.png](./pic/review_spring.png) — пружины, S1/S3/S4;
- [pic/review_roller.png](./pic/review_roller.png) — ролик/кулачок, S2/S5;
- [fig/spring_contact.svg](./fig/spring_contact.svg) — сила пружин от сжатия
  и контакт при 15 Гц;
- [fig/contact_map.svg](./fig/contact_map.svg) — карта запаса 2×;
- [fig/spring_stress.svg](./fig/spring_stress.svg) — напряжения и геометрия;
- [fig/expert_sheet.svg](./fig/expert_sheet.svg) — сводный лист A3.

## 9. Ограничения

- Проверены только пружины и контакт; остальные части не оценивались.
- Нет FEA, усталостных и трибологических испытаний; напряжения — аналитические
  по Wahl, допускаемое 500…700 МПа — ориентировочное.
- Нет реальной пружины: k, L0, ID, концы и материал не измерены; допуски не
  заданы.
- Контакт — квазистатический, жёсткий ролик; удар, податливость PLA и
  динамика рамы не моделировались.
- Фактический 2-лепестковый профиль взят из expert2 (C8); его исправление не
  входит в этот этап.
- Нет испытаний 10^6 циклов, измерения силы/напряжения, износа ID.

## 10. Воспроизведение

```bash
cd stages/expert3/cad
python3 analysis.py          # calc.csv, map.csv, findings.csv, fig/*.svg,
                             # pic/review_*.png, pic/*_preview.png
```

Скрипт читает `stages/fix7/params.csv`, `cad/mass.csv`, `cad/checks.csv`, не
меняет fix7 и не требует FreeCAD.

## 11. Стоимость генерации

Модель `deepseek/deepseek-flash` (variant high): вход $0,15/млн, чтение кэша
$0,003/млн, выход (включая reasoning) $0,60/млн. Учёт — `session_v2`
OpenCode, сессия `ses_e726e0ef1ffeC8VnXNji0HrEe0`; разбивка по сообщениям
этапа expert3 (fix7 учитывается отдельно). Снимок на 2026-10-30 после
формирования отчёта; финальный ответ может добавить ~$0,002…0,005.

| Категория | Токены | Стоимость, USD |
|---|---:|---:|
| **Всего** | **28 797 242** | **0,17825** |
| Входящие мимо кэша | 53 379 | 0,00801 |
| Закешированные входящие | 28 603 136 | 0,08581 |
| Исходящие (включая reasoning) | 140 727 | 0,08444 |

Исходящие = 45 664 (output) + 95 063 (reasoning). Стоимость fix7 — в
[`../fix7/Report.md`](../fix7/Report.md), $0,05066.
