inutcin/boomboom/stages/expert_correct/Report.md

# Отчёт по этапу «Корректировки и замечания после инженерной экспертизы»

Дата: 28.10.2026  
Этап: `stages/expert_correct`  
Вход: [`stages/expert/Report.md`](../expert/Report.md), [`stages/expert/Interview.md`](../expert/Interview.md), листы `stages/model` и `stages/correct/1`, ответы 1–18 из [`README.md`](./README.md)  
Цель: устранить критические и важные замечания инженерной экспертизы, выпустить обновлённые листы, расчёты и оценку подскока шарика.

## 1. Краткое заключение

Конструкция переработана по ответам пользователя:

- кожух из поликарбоната 4–5 мм с двумя нижними Г-образными дверками, верхней крышкой и куполом-уловителем 500 мм;
- кулачок вынесен на отдельную ось с двумя подшипниками; вал зажимается в патроне дрели, ось смещена на 50 мм в сторону дрели, чтобы обе опоры стояли между кулачком и патроном;
- нижние пружины удалены; введены 4 верхние пружины, две балки и 4 направляющие с линейными подшипниками;
- верхняя плита удалена; стол — печатная плита с вогнутостью 6 мм и стальными накладками 0,5/0,3–0,5 мм;
- кулачки — печатные, 20 мм, `e = 1,38 / 2,76 / 4,60 мм` для амплитуд 3/6/10 мм;
- дрель крепится двумя U-болтами M8 с резиновой подкладкой и упором от проворота; ручка выведена через вырез в дверке;
- рама — стальная труба 30×30×1,5 с укосинами и усиливающими пластинами.

Главные ограничения:

- **масса ≈38–45 кг** при лимите 20 кг — принятое отклонение; для лёгкой версии нужна алюминиевая рама и/или сетка вместо части поликарбоната;
- **обратное вращение** требует проверки патрона на самоотвинчивание;
- **печатные кулачки** имеют ограниченный ресурс и точность FDM; нужен запасной комплект и маркировка по фактической амплитуде;
- **рама 30×30×1,5** примерно в 4,4 раза менее жёсткая, чем 40×40×3; укосины обязательны, резонанс проверяется на макете.

## 2. Что сделано

Выпущено 5 листов A3 и обложка:

| Лист | SVG | PNG | Содержание |
|---:|---|---|---|
| Обложка | `fig/00_cover.svg` | `pic/00_cover.png` | Титул, состав, габарит, масса |
| 1 | `fig/01_general.svg` | `pic/01_general.png` | Общий вид: рама, кожух, купол, стол, привод, дверки, пульт |
| 2 | `fig/02_suspension.svg` | `pic/02_suspension.png` | Подвеска: балки, 4 пружины, направляющие, линейные подшипники, демпферы |
| 3 | `fig/03_cam_roller.svg` | `pic/03_cam_roller.png` | Контакт кулачка и роликов: 3 профиля, 2×6202 на ролик, кронштейны |
| 4 | `fig/04_cam_mount.svg` | `pic/04_cam_mount.png` | Крепление кулачка: щель подстолья, опоры, подшипники, вал, гайки, патрон |
| 5 | `fig/05_drill_mount.svg` | `pic/05_drill_mount.png` | Крепление дрели: U-болты, подкладки, упор, вырез под ручку |

Каждый лист имеет четыре вида: сверху слева — вид сверху, сверху справа — вид слева, снизу слева — вид сбоку, снизу справа — изометрия; спецификация — в правой части листа. Выносные номера расположены по периметру видов; генератор проверяет выход текста за лист и пересечения выносок.

Генератор:

```bash
node stages/expert_correct/tools/generate.js
```

PNG — A3, 200 dpi, 3307 × 2339 px; PDF — `expert_correct.pdf`, 6 страниц (обложка + 5 листов); сводный `stages/all_stages.pdf` — 19 страниц (14 прежних + 5 новых).

## 3. Закрытие критических замечаний

| № | Замечание | Решение | Статус |
|---:|---|---|---|
| К1 | Открытый привод, нет ограждения и аварийного останова | ПК-кожух 4–5 мм, три глухие стороны, верхняя часть стороны дрели, две Г-образные дверки, верхняя крышка, купол 500 мм, E-stop, УЗО, концевики, знаки | Закрыто конструктивно; проверить блокировки и массу |
| К2 | Кулачок в патроне дрели, радиальная нагрузка | Кулачок на отдельной оси, две опоры 6202-2RS; ось смещена на 50 мм, чтобы опоры стояли между кулачком и патроном; патрон передаёт только момент | Закрыто с остаточной соосностью; проверить биение |
| К3 | Ненадёжное осевое крепление диска | Конические гайки + контргайки + резьбовой фиксатор + стопорная пластина/штифт; большой момент затяжки; обратное вращение | Закрыто с риском самоотвинчивания патрона; проверить |
| К4 | Нет направляющих, статическая неопределимость | 4 направляющие Ø20 + LM20UU, две балки, 4 пружины; нижние пружины удалены | Закрыто конструктивно; проверить люфт/наклон |
| К5 | Пружины не рассчитаны | 4 пружины `d=2,0`, `D=30`, `n=16`, `L0=233`, монтажная 110 мм, 45 Н/пружину, `f_соб≈3,5 Гц`; предподжим 180 Н; контакт при 15 Гц/10 мм сохраняется | Закрыто расчётом; проверить на макете |
| К6 | Несущая цепь из фанеры, верхняя плита | Верхняя плита удалена; пружины опираются на две балки; стол — печатная плита со стальными накладками; рама 30×30×1,5 с укосинами | Частично: масса и резонанс рамы требуют проверки |
| К7 | Крепление дрели только на трении | U-болты M8, резиновая подкладка 2–3 мм, регулировочные шайбы, положительный упор от проворота | Закрыто конструктивно; проверить 2× момент |

## 4. Закрытие важных замечаний

| № | Замечание | Решение | Статус |
|---:|---|---|---|
| В1 | Амплитуда не равна `2e` | Пересчитаны `e = 1,38 / 2,76 / 4,60` для `A = 3 / 6 / 10` при `z=±50`; маркировка по фактической амплитуде | Закрыто расчётом; калибровка на макете |
| В2 | Гармоничность не обеспечена | Предложен критерий THD вертикального ускорения ≤5–10 %; проверка на макете | Не подтверждено |
| В3 | Регулятор дрели не стабилизирует частоту | Плавная регулировка, фиксация курка, внешний тахометр/стробоскоп | Частично |
| В4 | Резонанс и пуск | `f_соб≈3,5 Гц`, рабочий диапазон 5–15 Гц; плавный пуск/останов; рама с укосинами | Частично; проверить АЧХ |
| В5 | Зазор по наружному кольцу подшипника | Зазор между щеками 24 мм, два 6202 (22 мм), по 1 мм на сторону; обработка после сварки | Закрыто |
| В6 | Винт M8×20 короток | Принято M8×25/30 или резьбовая вставка; проверить по месту | Закрыто в спецификации |
| В7 | Стол 12 мм и местное ослабление | Печатная плита 15 мм с рёбрами, стальные накладки 0,5/0,3–0,5 мм, локальные шайбы | Закрыто конструктивно; проверить прогиб |
| В8 | Шарик и лунка | Вогнутость 6 мм по всей плоскости, бортик, купол 500 мм | Закрыто конструктивно; испытания |
| В9 | 8 пружин и 4 шпильки | Нижние пружины удалены; 4 пружины, 4 направляющие; меньше точек трения | Закрыто |
| В10 | Износ и твёрдость кулачка | Печатный PA-CF/PETG, 20 мм, сменный комплект; контроль износа | Частично: ресурс ограничен |
| В11 | Нет регулировки кулачка | Подкладки под кронштейны, конические гайки, осевая регулировка, настройка по индикатору | Закрыто |
| В12 | Противоречия чертежей | Новые листы — единая редакция; старые листы `model`/`correct/1` сохранены как история | Частично: старые листы не перевыпущены |
| В13 | Балансировка и биение | Кулачок симметричен; биение кромки ≤0,05 мм; балансировка с оправкой | Частично; проверить |
| В14 | Жёсткость рамы | Труба 30×30×1,5, 4–6 укосин, усиливающие пластины, резиновые опоры | Частично; проверить резонанс |
| В15 | Нет программы испытаний | Программа в разделе 8 | Частично: протокол не заполнен |
| В16 | Технологичность и стоимость | Печатные кулачки/стол, покупные подшипники/крепёж; спецификация на листах | Частично |
| В17 | Расчётная нагрузка не определена | Принято: шарик 33 г, подвижная масса ≈3 кг | Закрыто |

## 5. Расчёты

### 5.1. Амплитуда при двух роликах

`A = √((R + e + r_р)² − z²) − √((R − e + r_р)² − z²)`, где `R = 110`, `r_р = 17,5`, `z = 50` мм.

| A, мм | e, мм | Rmax, мм | Rmin, мм |
|---:|---:|---:|---:|
| 3 | 1,38 | 111,38 | 108,62 |
| 6 | 2,76 | 112,76 | 107,24 |
| 10 | 4,60 | 114,60 | 105,40 |

Зависимость `A(e)` нелинейна; для точных 3/6/10 мм диски маркируются по фактическому измерению.

### 5.2. Пружины

Принято: подвижная масса `m ≈ 3,0 кг`, 4 пружины, `f_соб ≈ 3,5 Гц`.

- суммарная жёсткость `k = m(2πf)² ≈ 1,46 Н/мм`;
- на пружину `k₁ ≈ 0,366 Н/мм`;
- предподжим 45 Н/пружину (180 Н total), сжатие ≈123 мм;
- `d=2,0`, `D=30`, `n≈16`, `L0≈233`, монтажная 110 мм, твёрдость/материал 65Г/60С2А;
- напряжение при предподжиме ≈473 МПа; критическая частота витков ≈99 Гц;
- сила пружин на ходе ±5 мм меняется на ≈7,3 Н total;
- на верхней точке контакт ролика `N ≈ 84 Н` (положителен), на нижней ≈335 Н.

Параметры предварительные; окончательно проверить по фактической массе и на макете.

### 5.3. Контакт печатного кулачка

Для `F ≈ 300 Н`, ширины контакта 22 мм, `R_р=17,5`, `R_кул≈110`:

- приведённый радиус ≈15,1 мм;
- для стали по пластику `E*≈6,87 ГПа`, полуширина ≈0,195 мм, `p_max≈45 МПа`;
- при трёхкратной перегрузке `p_max≈135 МПа`.

Для PETG это на пределе, для PA-CF лучше. Рекомендуется PA-CF, заполнение 80–100 %, запасной комплект кулачков и контроль износа. Стальная вставка не применяется по решению пользователя.

### 5.4. Подскок шарика

Модель 1D, `dt=1·10⁻⁴ с` (в 10 раз крупнее первого варианта), 5 с, 4 начальные фазы. Подробно — [`Jump.md`](./Jump.md).

| Режим | e=0,7 | e=0,8 | e=0,9 |
|---|---:|---:|---:|
| 15 Гц / 10 мм | 109–209 мм | 187–363 мм | 304–408 мм |
| 15 Гц / 6 мм | — | — | ≈156 мм |
| 15 Гц / 3 мм | — | — | ≈38 мм |
| 10 Гц / 10 мм | — | — | ≈175 мм |
| 5 Гц / 10 мм | отрыва нет | отрыва нет | отрыва нет |

Принят купол 500 мм над столом (габарит ≈1060 мм) с мягкой накладкой. При 250 мм крышка будет касаться шариком.

### 5.5. Массовый бюджет

| Составляющая | Масса |
|---|---:|
| Рама 30×30×1,5 (6,6–7,8 м) | 9–10,5 кг |
| Укосины и усиливающие пластины | 3–5 кг |
| Поликарбонат 4–5 мм с куполом | 14–16 кг |
| Узлы, стол, подстолье, дрель, кулачки, крепёж | 12–14 кг |
| **Итого** | **≈38–45 кг** |

Лимит 20 кг **не выполняется**. Это принятое отклонение; резервы снижения: ПК 4 мм вместо 5 на глухих сторонах, сетка вместо части ПК, алюминиевая рама, облегчённые стол и подстолье.

### 5.6. Жёсткость рамы

Труба 30×30×1,5: `A=171 мм²`, масса 1,34 кг/м, `I≈23 213 мм⁴`. Труба 40×40×3: `I≈101 972 мм⁴`. Отношение ≈0,228, то есть 30×30×1,5 примерно в 4,4 раза менее жёсткая. Без укосин первая мода рамы может попасть в 5–15 Гц; обязательны 4–6 диагональных укосин и проверка резонанса. Стенка 1,5 мм не допускает нарезание резьбы — только сквозные болты, резьбовые заклёпки или закладные пластины.

## 6. Проверка требований README

| № | Требование | Статус | Комментарий |
|---:|---|---|---|
| 1 | Амплитуда 3…10 мм | Частично | Расчётные `e`; калибровка по столу |
| 2 | Частота 5…15 Гц | Частично | `f=n/30`; нужен тахометр/стробоскоп |
| 3 | Гармонический характер | Не подтверждено | Критерий THD; испытания |
| 4 | Минимум движущихся частей/трения | Частично | 4 направляющих и 4 линейных подшипника добавили деталей |
| 5 | Минимум сложных деталей | Частично | Печатные кулачки и стол; кронштейны |
| 6 | Минимум «непокупных» деталей | Частично | Кулачки, стол, кронштейны — изготовление |
| 7 | Минимизация вибраций подстолья | Частично | Укосины, балансировка, резиновые опоры; проверить |
| 8 | Минимум точек регулировки | Не выполнено | Амплитуда, частота, поджим, положение кулачка, осевое положение |
| 9 | Линейные зависимости | Не выполнено | `A(e)` нелинейна; `f=n/30` линейна |
| 10 | Безопасность | Частично | Кожух, E-stop, УЗО; масса и обратное вращение — риски |
| — | Масса ≤20 кг (ответ 16) | **Не выполнено** | ≈38–45 кг; принятое отклонение |

## 7. Программа проверки макета

1. Статическая тарировка пружин: жёсткость, свободная длина, предподжим.
2. Биение кромки кулачка ≤0,05 мм; балансировка с оправкой.
3. Амплитуда по индикатору на 3/6/10 мм; частота по тахометру/стробоскопу.
4. Ускорение и спектр: THD вертикального ускорения ≤5–10 %.
5. Контакт роликов: отсутствие отрыва и ударов на 5/10/15 Гц.
6. Температура дрели и подшипников за цикл.
7. Поведение шарика: видеофиксация на 15 Гц/10 мм; удержание около центра, отсутствие вылета.
8. Проверка патрона на самоотвинчивание при обратном вращении.
9. Проверка рамных резонансов: молоток/акселерометр, 5–15 Гц.
10. Ресурс: 10³–10⁴ циклов, осмотр кулачка, подшипников, крепежа.

## 8. Ограничения

- Расчёты ручные, без МКЭ, натурных испытаний и точных данных о дрели, пружинах и печатных материалах.
- Масса ориентировочная; фактические материалы и кожух могут дать ±10–15 %.
- Печатные кулачки: точность FDM и износ; контактное давление на пределе для PETG.
- Обратное вращение и патрон: риск самоотвинчивания не снят окончательно.
- Рама 30×30×1,5: резонанс требует экспериментальной проверки; без укосин вероятен в рабочем диапазоне.
- Листы — модельные, не рабочие чертежи; допуски, посадки и шероховатости — следующий этап.
- Старые листы `model`/`correct/1` не перевыпущены; в альбоме они остаются историческими, новые листы — единая редакция для изготовления.

## 9. Стоимость генерации

Оценка по объёму контекста, ответов и работы подчинённых сессий; точный учёт — по логам OpenCode. Тарифы DeepSeek Flash: 0,15 USD / 1 млн входящих, 0,60 USD / 1 млн исходящих, 0,003 USD / 1 млн закешированных входящих.

- **Всего:** ≈360 000 токенов (≈0,077 USD).
- **Входящие вне кэша:** ≈150 000 токенов (≈0,0225 USD).
- **Закешированные входящие:** ≈120 000 токенов (≈0,00036 USD).
- **Исходящие:** ≈90 000 токенов (≈0,054 USD).

## 10. Следующий этап

Изготовление опытного образца и испытания по разделу 7; затем рабочие чертежи, допуски/посадки, CAD/STEP и уточнение массово-жёсткостных характеристик. Для лёгкой версии — алюминиевая рама, ПК 2–3 мм + сетка, облегчённые стол и подстолье.
