inutcin/boomboom/stages/fix11/techdraw/Report.md

# Отчёт: techdraw — раскрой труб рамы и направляющих валов fix11

Дата: 2026-11-04; дополнение по валам — 2026-11-05
Этап: [`stages/fix11`](../README.md)
Каталог: `stages/fix11/techdraw`
Промпт: [`techdraw_prompt.md`](./techdraw_prompt.md)

## 1. Задача

Сделать чертёж с размерами, показывающий, как разрезать **4 трубы
20×20×2 длиной 1000 мм** на отрезки для сварки рамы. Толщина реза —
**до 5 мм**.

Уточнение пользователя: поджимные балки 21 вырезать из другой трубы,
задние стойки `T05/T06` снова включить в раскрой, балки 21 исключить.

Принятые решения:

- в раскрой входят все 18 отрезков рамы `T01…T18`, включая `T05/T06`;
- поджимные балки 21 (`2×159,6 мм`) — из отдельной трубы;
- лист **A4 альбом**, масштаб **1:5**;
- рез **5 мм**, каждый отрезок отделяется своим резом;
- безопасная раскладка: труба 2 — `260,260,260,150`; труба 4 —
  `160,160,260,200,150`;
- выход: **PDF + SVG + PNG**, плюс `cut_plan.csv`.

## 2. Исходные данные

Источники:

- [`../tube_cut.csv`](../tube_cut.csv) — 18 отрезков рамы;
- [`../params.csv`](../params.csv) — длины стоек, поперечин, выноса;
- [`../cad/step/22_T01…T18.step`](../cad/step/) — тела отрезков рамы;
- [`../tachdraw/pdf/22_T01…T18.pdf`](../tachdraw/pdf/) — отверстия и
  прорези на каждом отрезке;
- [`../tachdraw/pdf/21_beam.pdf`](../tachdraw/pdf/21_beam.pdf) — балка 21
  (вне раскроя, для справки).

Сумма длин 18 отрезков рамы — **3740 мм**. Поджимные балки 21
(`2×159,6 мм`) в раскрой не входят: для них нужна отдельная труба.

## 3. Раскладка

| Труба | Отрезки по порядку | Длины, мм | Позиции резов, мм | Занято, мм | Остаток, мм |
|---|---|---|---:|---:|---:|
| 1 | T07, T08, T11 | 360, 360, 200 | 360, 725, 930 | 935 | 65 |
| 2 | T01, T02, T03, T05 | 260, 260, 260, 150 | 260, 525, 790, 945 | 950 | 50 |
| 3 | T09, T10, T13, T14, T15, T16 | 6×160 | 160, 325, 490, 655, 820, 985 | 990 | 10 |
| 4 | T17, T18, T04, T12, T06 | 160, 160, 260, 200, 150 | 160, 325, 590, 795, 950 | 955 | 45 |
| **Итого** | **18 отрезков** | **3740** | **18 резов** | **3830** | **170** |

Каждый отрезок отделяется одним резом; на 18 отрезков — **18 резов**.
При резе 5 мм: `3740 + 18×5 = 3830 мм`. Из четырёх заготовок
`4×1000 = 4000 мм` остаётся **170 мм**.

### Изменение по уточнению

- задние стойки `T05/T06` (`2×150`) снова включены: `T05` в трубу 2,
  `T06` в трубу 4;
- поджимные балки 21 (`2×159,6`) исключены — режутся из отдельной
  трубы, для них нужно ≥330 мм;
- остальные отрезки и их порядок сохранены.

Принята безопасная перестановка `200 ↔ 150` между трубами 2 и 4:
исходная `труба 2 = 260,260,260,200` даёт ровно 1000 мм при резе 5 мм,
без запаса. Основная раскладка: труба 2 — `260,260,260,150` (остаток 50),
труба 4 — `160,160,260,200,150` (остаток 45).

## 4. Что сделано

### 4.1. Файлы

| Файл | Назначение |
|---|---|
| `cut_layout.py` | генератор листа: SVG, PDF, PNG, CSV |
| `cut_plan.csv` | порезка по позициям, начало/конец, рез, остаток |
| `fig/tube_cut_layout.svg` | векторный чертёж 297×210 мм |
| `pic/tube_cut_layout.png` | превью 160 dpi |
| `pdf/tube_cut_layout.pdf` | печатный лист A4 альбом, 1 страница |
| `techdraw_prompt.md` | исходная задача, уточнение и решения |
| `README.md` | краткое описание комплекта |

### 4.2. Лист

- рамка и основная надпись A4;
- четыре полосы заготовок 1000 мм в масштабе **1:5** (200 мм на бумаге);
- маркировка `T01…T18` в порядке резки;
- позиции резов от левого торца;
- размерные цепочки готовых длин;
- остатки `65 / 50 / 10 / 45` с подписями «ост.» и «занято»;
- таблица раскроя на 4 трубы + итог;
- примечания по материалу, резу, отверстиям и балкам 21;
- деталь А **1:1**: два торца трубы `20×20×2`, стенка 2 мм, ширина
  реза 5 мм, размеры `5` и `20`, подпись «стенка 2».

### 4.3. Метод

`cut_layout.py` не зависит от FreeCAD: данные раскладки заданы явно,
лист строится в SVG в миллиметрах бумаги, PDF и PNG получаются через
`cairosvg`. Это даёт точный масштаб 1:5 без HLR и без 3D-проекций.

Скрипт сам проверяет:

- 18 уникальных отрезков `T01…T18`;
- сумму длин 3740 мм;
- 18 резов по 5 мм;
- занято 3830 мм, остаток 170 мм;
- неотрицательные остатки по каждой трубе.

## 5. Проверки

| Проверка | Результат | Статус |
|---|---|---|
| Число отрезков | 18, все `T01…T18` по одному разу | OK |
| Сумма длин | 3740 мм | OK |
| Число резов | 18 | OK |
| Рез | 5 мм; `18×5 = 90 мм` | OK |
| Занято | 3830 мм ≤ 4000 мм | OK |
| Остатки | 65 + 50 + 10 + 45 = 170 мм | OK |
| Труба 1 | 935 ≤ 1000, остаток 65 | OK |
| Труба 2 | 950 ≤ 1000, остаток 50 | OK |
| Труба 3 | 990 ≤ 1000, остаток 10 | OK |
| Труба 4 | 955 ≤ 1000, остаток 45 | OK |
| Задние стойки | T05/T06 включены в раскрой | OK |
| Балки 21 | 2×159,6 исключены, отмечено на листе | OK |
| PDF | A4 альбом 841,89 × 595,276 pt, 1 страница | OK |
| SVG | 297 × 210 мм, viewBox 0 0 297 210 | OK |
| Масштаб | 1000 → 200 мм; 360 → 72 мм; 160 → 32 мм | OK |
| Таблица и CSV | значения совпадают с раскладкой | OK |
| Визуально | подписи и размеры не пересекаются | OK |

## 6. Ограничения и расхождения

1. **Поджимные балки 21** (`2×159,6 мм`) не входят в 4×1000 мм. Для них
   нужна отдельная труба длиной не менее **330 мм**. Это отмечено на
   листе, в CSV и README.
2. Отверстия и прорези на листе раскроя **не размечаются**: их
   координаты и диаметры — на индивидуальных листах
   `../tachdraw/pdf/22_T01…T18.pdf` и `../tachdraw/pdf/21_beam.pdf`.
   На листе раскроя дана ссылка и особые случаи: T13/T14 — Ø10 только
   верхняя стенка; T17/T18 — прорезь R15; B21 — 2×Ø10 и 4×Ø4,5.
3. Раскрой рассчитан на рез **ровно 5 мм**. При меньшем резе длины
   отрезков не меняются, остатки увеличиваются; резать нужно по длинам,
   а абсолютные позиции резов пересчитать. При резе больше 5 мм
   гарантий нет.
4. Лист раскроя — **2D-схема**, а не проекция из 3D. Это осознанно:
   для раскроя важны длины и порядок резов, а не проекции тела.
   Проекции отрезков есть в `../tachdraw/`.
5. Оптимизация раскладки выполнена вручную, без перебора; для 18
   отрезков этого достаточно.
6. Допуски, шероховатость и способ резки (абразивный диск, пила)
   заданы только примечаниями.

## 7. Воспроизведение

```bash
cd stages/fix11/techdraw
python3 cut_layout.py
```

Проверка PDF:

```bash
pdfinfo pdf/tube_cut_layout.pdf
```

Ожидается: `Pages: 1`, `Page size: 841.89 x 595.276 pts (A4)`.

## 8. Стоимость генерации листа труб

Модель `deepseek/deepseek-flash`, сессия
`ses_e592aa76cffeGsQUY1e4dpH3pe`. Тарифы: вход $0,15/млн, чтение кэша
$0,003/млн, выход и reasoning $0,60/млн. Снимок `session_v2` на
2026-11-04 21:03 (UTC+4).

| Категория | Токены | Стоимость, USD |
|---|---:|---:|
| **Всего** | **17 468 934** | **0,14330** |
| Входящие мимо кэша | 174 840 | 0,02623 |
| Закешированные входящие | 17 184 896 | 0,05155 |
| Исходящие (output) | 49 097 | 0,02946 |
| Исходящие (reasoning) | 60 101 | 0,03606 |
| **Исходящие всего (output + reasoning)** | **109 198** | **0,06552** |

Стоимость включает только эту сессию; стоимость этапа fix11 —
в [`../Report.md`](../Report.md).

## 9. Дополнение: раскрой направляющих валов

Дата: 2026-11-05.

### 9.1. Задача

Добавить в `stages/fix11/techdraw` раскрой четырёх направляющих валов
из двух сплошных прутков круглого сечения Ø10 длиной 500 мм. Рез 5 мм,
лист A4, масштаб выбрать самостоятельно.

Уточнение пользователя: изменить концепцию крепления валов — убрать
кольца-ограничители WCS10FR, удлинить валы на 5 мм с каждой стороны,
нарезать резьбу M10×15 на концах и затянуть гайками M10 с шайбами Ø18.

### 9.2. Исходные данные

- [`../spec.csv`](../spec.csv), поз. 2 — «Вал направляющий», 4 шт.,
  сталь Ø10 h6, `L=176 мм`, резьба M10×15;
- [`../params.csv`](../params.csv) — `shaft_guide_len=176 мм`,
  `shaft_z0=137`, `shaft_z1=313`;
- принято по задаче: заготовка — **2 сплошных прутка Ø10×500 мм**;
- рез — **5 мм**;
- длина — **176 мм** (`166 + 5×2`);
- крепление — 2 гайки M10 + 2 шайбы Ø18 на вал; кольца WCS10FR
  удалены.

### 9.3. Раскладка

| Пруток | Отрезки | Длины, мм | Позиции резов, мм | Занято, мм | Остаток, мм |
|---|---|---|---:|---:|---:|
| 1 | V01, V02 | 176, 176 | 176, 357 | 362 | 138 |
| 2 | V03, V04 | 176, 176 | 176, 357 | 362 | 138 |
| **Итого** | **4 вала** | **704** | **4 реза** | **724** | **276** |

Каждый отрезок отделяется своим резом: `704 + 4×5 = 724 мм`.
Из двух заготовок `2×500 = 1000 мм` остаётся **276 мм** (2×138).

### 9.4. Что сделано

| Файл | Назначение |
|---|---|
| `shaft_cut_layout.py` | генератор листа: SVG, PDF, PNG, CSV |
| `shaft_cut_plan.csv` | порезка по позициям |
| `fig/shaft_cut_layout.svg` | векторный чертёж 297×210 мм |
| `pic/shaft_cut_layout.png` | превью 160 dpi |
| `pdf/shaft_cut_layout.pdf` | печатный лист A4 альбом, 1 страница |

Лист содержит:

- два прутка Ø10×500 в масштабе **1:2,5** (500 → 200 мм на бумаге);
- маркировку `V01…V04`;
- позиции резов `176` и `357` от левого торца;
- размерные цепочки `176 / 176 / ост. 138`;
- красную заливку зоны реза;
- таблицу раскроя;
- деталь А **2:1**: два торца вала, Ø10 h6, сплошное сечение и рез 5 мм;
- примечания: резьба M10×15 на свободных концах, торцы 90°, фаска
  0,5×45°, заусенцы снять, поверхность h6 не повреждать, гайка M10 +
  шайба Ø18.

### 9.5. Проверки

| Проверка | Результат | Статус |
|---|---|---|
| Число валов | 4, `V01…V04` по одному разу | OK |
| Длина | 176 мм = 166 + 5×2 | OK |
| Резьба | M10×15 на обоих концах | OK |
| Крепление | 2 гайки M10 + 2 шайбы Ø18 на вал | OK |
| Кольца WCS10FR | удалены из модели, спецификации, чертежей и рендеров | OK |
| Сумма длин | 704 мм | OK |
| Число резов | 4 | OK |
| Рез | 5 мм; `4×5 = 20 мм` | OK |
| Занято | 724 мм ≤ 1000 мм | OK |
| Остатки | 138 + 138 = 276 мм | OK |
| Пруток 1 | 362 ≤ 500, остаток 138 | OK |
| Пруток 2 | 362 ≤ 500, остаток 138 | OK |
| Позиции резов | 176 и 357 на каждом прутке | OK |
| PDF | A4 альбом 841,89 × 595,276 pt, 1 страница | OK |
| SVG | 297 × 210 мм, viewBox 0 0 297 210 | OK |
| Масштаб | 500 → 200 мм; 176 → 70,4 мм; 5 → 2 мм | OK |
| Таблица и CSV | значения совпадают с раскладкой | OK |
| Визуально | подписи и размеры не пересекаются | OK |

### 9.6. Ограничения

1. Длина **176 мм** — конструктивная: 166 + 5 мм с каждого торца.
   В 3D-модели, `params.csv` и `spec.csv` уже стоит 176 мм,
   `Z=137…313`.
2. Резьба M10×15 показана примечанием на листе раскроя; подробный
   чертёж с резьбой — `../tachdraw/pdf/02_shaft.pdf`.
3. Отверстий и прорезей на валах нет; валы шлифованные h6, на листе
   показаны резка, резьба и требования к торцам.
4. Раскрой рассчитан на рез ровно 5 мм. При меньшем резе остатки
   увеличиваются; при большем — раскладка не гарантируется.

## 10. Стоимость генерации дополнений

Модель `deepseek/deepseek-flash`, сессия
`ses_e537eea21ffeOHN2w1S7oYR2L8`. Тарифы: вход $0,15/млн, чтение кэша
$0,003/млн, выход и reasoning $0,60/млн. Снимок `session_v2` на
2026-11-05 21:56 (UTC+4).

| Категория | Токены | Стоимость, USD |
|---|---:|---:|
| **Всего** | **89 921 663** | **0,42312** |
| Входящие мимо кэша | 361 889 | 0,05428 |
| Закешированные входящие | 89 392 000 | 0,26818 |
| Исходящие (output) | 81 845 | 0,04911 |
| Исходящие (reasoning) | 85 929 | 0,05156 |
| **Исходящие всего (output + reasoning)** | **167 774** | **0,10066** |

Стоимость включает только сессию дополнения по валам; стоимость листа
труб — в разделе 8, стоимость этапа fix11 — в [`../Report.md`](../Report.md).
