inutcin/boomboom/stages/expert3/optimum.md

# Оптимальная пружина для режимов 5/10/15 Гц × 3/5/10 мм

**Реализация:** выбранная пружина установлена в [`../fix8`](../fix8/README.md).

Дата: 2026-10-30
Объект: [`stages/fix7`](../fix7/README.md), 4 прижимные пружины, установленная
длина 36 мм, ход/размах 3/5/10 мм (сменные диски), вал Ø10, шайба
Ø18/Ø10,5×1,5.

**Важно об «амплитуде».** В таблице амплитуда — это **размах (ход)**
3/5/10 мм, как у сменных дисков fix6/fix7 (peak-to-peak). Если в ТЗ
«амплитуда» означает нуль-пик, то размах будет 6/10/20 мм; для 20 мм при
15 Гц эта пружина не подходит — см. [`optim-pick-pick.md`](./optim-pick-pick.md)
и раздел 6.

## 1. Рекомендация

**Основной вариант — 4 шт. пружины сжатия:**

> **Ø17 × проволока 1,5 × L0=60 мм, 9 активных витков (11 полных),
> закрытые шлифованные концы, 65Г/60С2ХА (или аналог), L0±1 мм, k±5 %.**
>
> Шайбы — существующие **Ø18/Ø10,5×1,5**; ID пружины 14 мм надевается на вал
> Ø10, OD 17 мм не соскальзывает с шайбы Ø18 (запас 0,5 мм на сторону).

Это **одна и та же пружина на все 9 режимов**. Минимальный запас —
**2,72×** в точке 15 Гц / 10 мм; напряжение **479 МПа**; f_соб≈12,8 Гц.
По сравнению с 4×Ø12×1,0 L0=70 (fix7): контакт сверху растёт с 60,3 Н
(1,48×) до 111,8 Н (2,72×), напряжение падает с 729 до 479 МПа; сила на
кулачок внизу — 115/135 Н (fix7, идеал/факт) против 134 Н у выбранной,
то есть практически та же, но контакт сверху почти вдвое больше.

## 2. Параметры выбранной пружины

| Параметр | Значение |
|---|---:|
| Наружный диаметр OD | 17 мм |
| Проволока d | 1,5 мм |
| Средний диаметр D | 15,5 мм |
| Внутренний диаметр ID | 14,0 мм |
| Свободная длина L0 | 60 мм |
| Установленная длина | 36 мм |
| Сжатие | 24 мм |
| Твёрдая длина (11 витков) | 16,5 мм |
| Запас до твёрдого | 19,5 мм |
| Активных витков | 9 |
| Полных витков | 11 |
| Жёсткость k | **1,497 Н/мм** |
| 4 пружины, 4k | **5,989 Н/мм** |
| Преднатяг при L=36 | **143,7 Н** |
| Сила внизу (L=46) | **83,9 Н** |
| Контакт 15 Гц/10 мм (верх) | **111,8 Н (2,72×)** |
| Контакт 15 Гц/10 мм (низ) | 134,0 Н |
| Напряжение τ верх / низ | **479 / 279 МПа** |
| τ при сжатии до твёрдого | 868 МПа (не достигать) |
| f_соб | **12,81 Гц** |
| Масса | 6,14 г/шт.; 24,5 г на 4 |
| Материал / концы | 65Г/60С2ХА; закрытые шлифованные |
| Шайба | Ø18/Ø10,5×1,5 (существующая) |

Формулы: `k=G·d⁴/(8·D³·n)`, `F=4k·(L0−36)`,
`F_контакта=F+mg−m·(s/2)·(2πf)²`,
`τ=Kw·8FD/(πd³)`, `f_соб=√(4k/m)/(2π)`.
Движущаяся масса с учётом 4 пружин — **0,924 кг**.

## 3. Таблица 3 × 3: частота × размах

В каждой клетке — **сила контакта сверху (минимум) / запас к инерционной**.
Одна и та же пружина Ø17×1,5×60, 9 активных витков; установленная 36 мм.

| Частота \ Размах | **3 мм** | **5 мм** | **10 мм** |
|---|---:|---:|---:|
| **5 Гц** | 151,4 Н / **110,7×** | 150,5 Н / **66,0×** | 148,2 Н / **32,5×** |
| **10 Гц** | 147,3 Н / **26,9×** | 143,7 Н / **15,8×** | 134,6 Н / **7,38×** |
| **15 Гц** | 140,5 Н / **11,4×** | 132,3 Н / **6,45×** | **111,8 Н / 2,72×** |

- Все 9 клеток ≥2,7×; целевой минимум 2× выполнен.
- Худшая клетка — **15 Гц / 10 мм**: 111,8 Н при инерционной 41,0 Н,
  запас 2,72; цель 2× — 82,1 Н.
- Внизу хода сила больше (134 Н на 15 Гц/10 мм), потому что пружина сжата
  меньше, а инерционная сила направлена вверх.
- При 5 Гц/3 мм запас 111× — пружина там «переразмерена», но это плата за
  один типоразмер на все режимы.

### Минимально необходимая жёсткость

Для 2× в худшей точке 15 Гц/10 мм при L0=60 нужно `k≥1,19 Н/мм` на пружину
(4k≥4,76 Н/мм). Выбранная k=1,497 даёт запас по жёсткости **+26 %**.
Уменьшать k ниже 1,19 нельзя — контакт упадёт ниже 2×.

## 4. Почему именно эта пружина

- **L0=60** — не максимум 70, а оптимум: при установленной 36 мм сжатие
  24 мм; это позволяет взять k=1,50 при напряжении 479 МПа. При L0=70
  (сжатие 34 мм) для того же контакта нужна k≈1,12, но напряжение 509 МПа,
  f_соб 11,1 Гц (ближе к 10) и сила на кулачок 158 Н. L0=60 даёт лучший
  баланс контакта, напряжения, резонанса и нагрузки на кулачок.
- **Проволока 1,5 мм** — из распространённого ряда 1,0…3,0; при 1,0 мм
  напряжение было бы ≈729 МПа (fix7), при 1,5 мм — 479 МПа.
- **9 активных витков (11 полных)** — типовое число для пружин сжатия
  такого размера; закрытые шлифованные концы.
- **OD17 / ID14** — надевается на вал Ø10 (зазор 4 мм) и не соскальзывает
  с шайбы Ø18 (OD17, запас 0,5 мм). Шайбу менять не нужно.
- **Контакт 2,72×** — достаточный запас, без избыточной силы на кулачок
  (внизу 134 Н против 158 Н у варианта L0=70).
- **τ=479 МПа** — ниже, чем у 4×Ø12×1,0 L0=70 (729 МПа) и у 8×Ø12×0,9
  (636 МПа).
- **f_соб=12,8 Гц** — дальше от 10 Гц, чем у L0=70 (11,1 Гц), но всё ещё
  внутри 5…15; нужен демпфер.

## 5. Альтернативы (если основной типоразмер недоступен)

| Вариант | Параметры | Контакт 15/10 | τ верх | f_соб | Комментарий |
|---|---|---:|---:|---:|---|
| **Основной** | **Ø17×1,5×60, 9 витков** | **111,8 Н (2,72×)** | **479 МПа** | **12,81 Гц** | шайба Ø18; лучший баланс |
| Ходовой Ø18 | Ø18×1,5×60, 9 витков | 87,2 Н (2,12×) | 420 МПа | 11,6 Гц | шайба Ø20; меньше запас |
| Ходовой длинный | Ø18×1,5×70, 10 витков | 119,9 Н (2,92×) | 535 МПа | 11,06 Гц | шайба Ø20; ближе к 10 Гц |
| Максимальный запас | Ø16×1,5×60, 9 витков | 143,8 Н (3,50×) | 548 МПа | 14,1 Гц | выше нагрузка на кулачок |
| 8 пружин | 8×Ø12×0,9×70, 11 витков | 85,8 Н (2,10×) | 636 МПа | 9,76 Гц | 8 мест; напряжение высокое |

Если в продаже есть только **Ø18×1,5×60** — берите 9 витков и шайбу
Ø20/Ø10,5×1,5: контакт 2,12×, напряжение 420 МПа; запас ниже, но
приемлемый. Если важнее запас 2× и f_соб дальше от 10 Гц — **Ø18×1,5×70,
10 витков** (2,92×, 535 МПа, 11,06 Гц), но шайба Ø20 и сила на кулачок
выше.

## 6. Ограничения и важные оговорки

1. **Амплитуда = размах.** Если 3/5/10 — нуль-пик, то размах 6/10/20 мм;
   при 15 Гц/20 мм выбранная пружина даёт контакт
   `143,7+9,1−4·41,0≈−11 Н` — отрыв. Для нуль-пик 10 мм нужен другой
   пружинный пакет (8…16 пружин, другая геометрия/кулачок), в рамках
   4 пружин и L0≤70 это не решается с допустимым напряжением.
2. **f_соб=12,81 Гц** внутри 5…15 Гц; от 10 Гц 2,8 Гц, от 15 Гц 2,2 Гц.
   Контакт на 10 Гц положительный (7,38×), но для «качественного» удержания
   нужен демпфер/полиуретановые втулки или изменение массы; иначе возможны
   резонансные колебания силы/шума.
3. **Напряжение 479 МПа** — ниже нижней границы ориентировочного
   допуска 500…700 МПа, то есть с запасом; материал и термообработку
   нужно подтвердить. При сжатии до твёрдого τ≈868 МПа — не доводить;
   установленное сжатие 24 мм, до твёрдого 43,5 мм; запас 19,5 мм.
4. **Кулачок/ролик.** Внизу 15 Гц/10 мм сила 134 Н; p0 на PLA-кулачке
   ориентировочно 42 МПа. Это меньше, чем у варианта L0=70 (158 Н), но
   проверить контактную усталость/вставку (expert2 S5).
5. **ID=14 мм** — пружина свободно надевается на вал Ø10, но не центрируется
   валом; центрируют шайбы. Если нужен более плотный пояс, поставить
   направляющую втулку Ø10/Ø13,5 или выбрать Ø16×1,5 (ID13).
6. **Типоразмер.** Ø17×1,5×60 — из распространённого ряда, но перед
   покупкой проверить каталог (DIN 2098/ГОСТ 13764): если есть только
   Ø18×1,5×60 или Ø18×1,5×70, использовать варианты из раздела 5.
7. **Расчёт квазистатический**, без удара шарика, податливости PLA и
   динамики рамы; напряжения — по Wahl, допускаемое 500…700 МПа —
   ориентировочное.

## 7. Что покупать и как проверить

- 4 шт. пружины сжатия **Ø17×1,5×60**, 9 активных витков (11 полных),
  закрытые шлифованные концы, 65Г/60С2ХА, L0±1 мм, k±5 %.
- Шайбы — существующие **Ø18/Ø10,5×1,5**, 4 шт. (если Ø18×1,5 — шайбы
  Ø20/Ø10,5×1,5).
- Проверить: k (сжатие 20 мм — сила 29,9 Н), L0, ID/OD, отсутствие
  заклинивания на валу, силу при 36 и 46 мм (143,7/83,9 Н), 10^6 циклов,
  остаточную деформацию ≤0,5 %, контакт на 15 Гц/10 мм (≥82 Н),
  p0/износ кулачка.

**Итог:** для всех девяти режимов 5/10/15 Гц × 3/5/10 мм (размах) нужна
**Ø17×1,5×60, 9 активных витков, 4 шт.**; она держит контакт с запасом
2,72…111×, напряжение 479 МПа, f_соб 12,8 Гц и садится на существующую
шайбу Ø18. Если нужен запас 2× с большим отрывом от 10 Гц — альтернатива
**Ø18×1,5×70, 10 витков** (2,92×, 535 МПа, 11,1 Гц) с шайбой Ø20.
