inutcin/boomboom/stages/expert3/optim-pick-pick.md

# Оптимальная пружина: амплитуда — нуль-пик 3/5/10 мм

Дата: 2026-10-30
Объект: [`stages/fix7`](../fix7/README.md), 4 прижимные пружины, установленная
длина 36 мм, вал Ø10, шайба Ø18/Ø10,5×1,5.

**Определение.** Здесь амплитуда — **нуль-пик** (0…A), поэтому размах
(peak-to-peak) равен **6/10/20 мм** для A=3/5/10 мм. Это отличается от
[`optimum.md`](./optimum.md), где 3/5/10 — размах. Для нуль-пик нужны
сменные диски с ходом 6/10/20 мм; текущие диски 3/5/10 (размах) дают
нуль-пик 1,5/2,5/5 мм.

## 1. Рекомендация

**Основной вариант — 4 шт. пружины сжатия:**

> **Ø17 × проволока 1,8 × L0=65 мм, 12 активных витков (14 полных),
> закрытые шлифованные концы, 65Г/60С2ХА (или аналог), L0±1 мм, k±5 %.**
>
> Шайбы — существующие **Ø18/Ø10,5×1,5**; ID пружины 13,4 мм надевается на
> вал Ø10, OD 17 мм не соскальзывает с шайбы Ø18 (запас 0,5 мм на сторону).

Минимальный запас — **2,57×** в точке 15 Гц / 10 мм (нуль-пик);
напряжение **558 МПа**; f_соб≈16,4 Гц — **выше** рабочего диапазона 5…15 Гц.
Это 4 пружины, без перехода на 8 мест; но нужен более толстый винт 1,8 мм
и свободная длина 65 мм.

## 2. Параметры выбранной пружины

| Параметр | Значение |
|---|---:|
| Наружный диаметр OD | 17 мм |
| Проволока d | 1,8 мм |
| Средний диаметр D | 15,2 мм |
| Внутренний диаметр ID | 13,4 мм |
| Свободная длина L0 | 65 мм |
| Установленная длина | 36 мм |
| Сжатие | 29 мм |
| Твёрдая длина (14 витков) | 25,2 мм |
| Запас до твёрдого | 10,8 мм |
| Активных витков | 12 |
| Полных витков | 14 |
| Жёсткость k | **2,469 Н/мм** |
| 4 пружины, 4k | **9,877 Н/мм** |
| Преднатяг при L=36 | **286,4 Н** |
| Сила внизу (L=56) | **88,9 Н** |
| Контакт 15 Гц / 10 мм нуль-пик (верх) | **212,9 Н (2,57×)** |
| Контакт 15 Гц / 10 мм (низ) | 180,7 Н |
| Напряжение τ верх / низ | **558 / 173 МПа** |
| τ при сжатии до твёрдого | 765 МПа (не достигать) |
| f_соб | **16,39 Гц** (вне 5…15) |
| Масса | 11,52 г/шт.; 46,1 г на 4 |
| Материал / концы | 65Г/60С2ХА; закрытые шлифованные |
| Шайба | Ø18/Ø10,5×1,5 (существующая) |

Формулы: `k=G·d⁴/(8·D³·n)`, `F=4k·(L0−36)`,
`F_контакта=F+mg−m·A·(2πf)²` (A — нуль-пик), `τ=Kw·8FD/(πd³)`,
`f_соб=√(4k/m)/(2π)`. Движущаяся масса с учётом 4 пружин — **0,931 кг**.

## 3. Таблица 3 × 3: частота × амплитуда (нуль-пик)

В каждой клетке — **сила контакта сверху (минимум) / запас к инерционной**.
Одна и та же пружина Ø17×1,8×65, 12 активных витков; установленная 36 мм.

| Частота \ Амплитуда (нуль-пик) | **3 мм** | **5 мм** | **10 мм** |
|---|---:|---:|---:|
| **5 Гц** | 292,8 Н / **106,2×** | 291,0 Н / **63,3×** | 286,4 Н / **31,2×** |
| **10 Гц** | 284,5 Н / **25,8×** | 277,2 Н / **15,1×** | 258,8 Н / **7,04×** |
| **15 Гц** | 270,8 Н / **10,9×** | 254,2 Н / **6,15×** | **212,9 Н / 2,57×** |

- Все 9 клеток ≥2,57×; целевой минимум 2× выполнен.
- Худшая клетка — **15 Гц / 10 мм нуль-пик** (размах 20 мм): 212,9 Н при
  инерционной 82,7 Н, запас 2,57; цель 2× — 165,4 Н.
- Внизу хода сила 180,7 Н; это выше, чем у peak-to-peak-варианта (134 Н),
  потому что ход 20 мм, а не 10.
- При 5 Гц/3 мм запас 106× — пружина «переразмерена», но это плата за
  один типоразмер на все режимы.

### Минимально необходимая жёсткость

Для 2× в худшей точке 15 Гц / 10 мм нуль-пик при L0=65 нужно
`k≥2,06 Н/мм` на пружину (4k≥8,24 Н/мм). Выбранная k=2,469 даёт запас по
жёсткости **+20 %**. Уменьшать k ниже 2,06 нельзя — контакт упадёт ниже 2×.

## 4. Почему именно эта пружина

- **4 пружины** — сохраняется текущее число мест; 4×Ø1,5 для нуль-пик 10 мм
  не проходит по напряжению (нужна k≈2,06, n≈6…7, τ>800 МПа). Ø1,8 — минимум,
  при котором 4 пружины укладываются в 500…700 МПа.
- **L0=65**: при установленной 36 мм сжатие 29 мм; k=2,47; контакт 2,57×;
  при L0=70 сжатие 34 мм, k=2,22, контакт 2,55×, но напряжение 583 МПа;
  при L0=60 сжатие 24 мм, k=2,47, контакт 2,1× (ниже цели). L0=65 — оптимум
  по контакту/напряжению.
- **12 активных витков (14 полных)** — типовое число; закрытые шлифованные
  концы.
- **OD17 / ID13,4** — надевается на вал Ø10 (зазор 3,4 мм) и не соскальзывает
  с шайбы Ø18 (OD17, запас 0,5 мм). Шайбу менять не нужно.
- **f_соб=16,4 Гц** — вне 5…15 Гц; резонанс стола в рабочем диапазоне
  отсутствует (в отличие от 4×1,0 L0=70 с 8,6 Гц и peak-to-peak-варианта
  с 12,8 Гц).
- **τ=558 МПа** — в допустимой зоне 500…700 МПа; ниже, чем у 4×1,0 L0=70
  (729 МПа) и 8×0,9 (636 МПа).

## 5. Альтернативы

| Вариант | Параметры | Контакт 15/10 | τ верх | f_соб | Комментарий |
|---|---|---:|---:|---:|---|
| **Основной** | **Ø17×1,8×65, 12 витков** | **212,9 Н (2,57×)** | **558 МПа** | **16,39 Гц** | шайба Ø18; лучший баланс |
| Ø18, 10 витков | Ø18×1,8×65, 10 витков | 210,5 Н (2,55×) | 583 МПа | 16,34 Гц | шайба Ø20; чуть выше τ |
| Ø18, 11 витков | Ø18×1,8×65, 11 витков | 184,6 Н (2,23×) | 530 МПа | 15,56 Гц | ниже контакт/напряжение |
| 8 пружин | 8×Ø17×1,5×65, 11 витков | 210,4 Н (2,54×) | 473 МПа | 16,3 Гц | 8 мест; ниже напряжение |
| 4×Ø1,5 | Ø17×1,5×65, 7 витков | ~150 Н (1,8×) | ~744 МПа | — | **не проходит** по контакту/τ |

Если в продаже есть только **Ø18×1,8×65** — берите 10 витков и шайбу
Ø20/Ø10,5×1,5: контакт 2,55×, τ=583 МПа, f_соб=16,3 Гц. Если нужен меньший
стресс — 11 витков (2,23×, 530 МПа), но контакт ближе к 2×.

## 6. Ограничения и важные оговорки

1. **Это нуль-пик.** Для размаха 3/5/10 мм (текущие диски) используйте
   [`optimum.md`](./optimum.md): там 4×Ø17×1,5×60, 9 витков, контакт 2,72×,
   τ=479 МПа. Для нуль-пик 3/5/10 нужны **диски 6/10/20 мм**; текущие
   3/5/10 дают нуль-пик 1,5/2,5/5, а не 3/5/10.
2. **f_соб=16,39 Гц** — выше 15 Гц, это хорошо для резонанса, но 15 Гц
   всего на 1,4 Гц ниже; при 15 Гц/20 мм контакт 2,57×, запас есть.
3. **Напряжение 558 МПа** — в допустимой зоне 500…700; при сжатии до
   твёрдого 765 МПа — не доводить; установленное сжатие 29 мм, до твёрдого
   39,8 мм; запас 10,8 мм.
4. **Кулачок/ролик.** Внизу 15 Гц/10 мм нуль-пик сила 180,7 Н; p0 на
   PLA-кулачке ориентировочно 48 МПа. Это выше, чем у peak-to-peak-варианта
   (134 Н); проверить контактную усталость/вставку (expert2 S5).
5. **ID=13,4 мм** — пружина надевается на вал Ø10, но не центрируется валом;
   центрируют шайбы. Если нужен более плотный пояс — направляющая втулка
   Ø10/Ø12,8.
6. **Типоразмер.** Ø17×1,8×65, 12 витков — из распространённого ряда, но
   перед покупкой проверить каталог; если есть только Ø18×1,8×65, использовать
   вариант из раздела 5 (шайба Ø20).
7. **Расчёт квазистатический**, без удара шарика, податливости PLA и
   динамики рамы; напряжения — по Wahl, допускаемое 500…700 МПа —
   ориентировочное.

## 7. Что покупать и как проверить

- 4 шт. пружины сжатия **Ø17×1,8×65**, 12 активных витков (14 полных),
  закрытые шлифованные концы, 65Г/60С2ХА, L0±1 мм, k±5 %.
- Шайбы — существующие **Ø18/Ø10,5×1,5**, 4 шт. (если Ø18×1,8×65 —
  шайбы Ø20/Ø10,5×1,5).
- Проверить: k (сжатие 20 мм — сила 49,4 Н), L0, ID/OD, отсутствие
  заклинивания на валу, силу при 36 и 56 мм (286,4/88,9 Н), 10^6 циклов,
  остаточную деформацию ≤0,5 %, контакт на 15 Гц/10 мм нуль-пик (≥165 Н),
  p0/износ кулачка.

**Итог:** для нуль-пик амплитуд 3/5/10 мм и частот 5/10/15 Гц нужна
**Ø17×1,8×65, 12 активных витков, 4 шт.**: контакт 2,57…106×, τ=558 МПа,
f_соб=16,4 Гц, шайба Ø18 без изменений. Для размаха 3/5/10 мм — вариант
[`optimum.md`](./optimum.md).
