inutcin/boomboom/stages/expert3/Interview.md

# Интервью по этапу «Третья инженерная экспертиза»

Дата: 2026-10-30
Этап: `stages/expert3`
Объект: [`stages/fix7`](../fix7/README.md) — пружины L0=70, Ø12, проволока 1,0.

Экспертиза проведена **только по пружинам и контакту ролика**. Остальные
части устройства не проверялись; замечания expert2 по ограждению, приводу,
валам, балке 21, шарику, креплению и документам здесь не повторяются.

## 1. Вопросы к пользователю

**В1. «Длина 70» — свободная длина L0 или установленная длина?**

Принято: **свободная L0=70 мм**. Установленная длина 36 мм задана геометрией
(стол 241, верхняя поперечина 280, шайбы 1,5+1,5). Если 70 мм — установленная
длина, потребуется поднять верхнюю поперечину/переделать стойки; это не
выполнено.

**В2. Сколько пружин и сколько витков?**

Принято: **4 пружины, 11 активных витков**, закрытые шлифованные концы, как в
fix6. В задании число пружин/витков не указано. При другом числе/витках
жёсткость и преднатяг нужно пересчитать; expert3 показывает, что 4×Ø1,0
L0=70 перегружены.

**В3. Какой материал пружины и допускаемое напряжение?**

Принято: пружинная сталь (65Г/60С2ХА или аналог), допустимое напряжение
кручения для усталости ориентировочно **500…700 МПа**. Точное значение
зависит от материала, термообработки и ресурса; в задании не задано.
Рекомендация: задать материал/τ_доп и ресурс 10^6 циклов.

**В4. Цель контакта 2× — обязательна?**

Принято: да, критерий второй экспертизы — сила контакта ≥2× инерционной на
15 Гц/10 мм. Если цель другая (например, положительный контакт без 2×),
скажите; вывод S2 изменится.

**В5. Какой профиль кулачка считать расчётным — гармонический или
фактический 2-лепестковый?**

Проверены оба. По гармонической синусоиде L0=70 даёт 1,48× (недостаточно);
по фактическому 2-лепестковому профилю — 2,48×, но он негармонический (C8
expert2) и маскирует недостаток пружины. Если C8 будет исправлен, пружину
нужно усиливать. Нужно решение: исправлять ли профиль.

**В6. Допустим ли ID 10,0 при вале Ø10?**

Нет: номинальная 12×1,0 даёт ID 10,0; в модели 10,2; при сжатии 34 мм
возможно трение/заклинивание. Рекомендация: ID≥10,5 или направляющая
втулка Ø9,6. Нужно подтвердить, что вал Ø10 остаётся.

**В7. Можно ли перейти на 8 пружин (8×Ø12×0,9) или на другой пакет?**

Это рекомендация S1/S2: 8×0,9 L0=70 даёт контакт 2,10×, но τ≈636 МПа
(всё ещё высоко) и требует 8 мест. Нужно решение по числу мест/пакету и
материалу.

**В8. Какой протокол испытаний пружин и контакта?**

Рекомендация: измерить k, L0, ID, силу при 36 и 46 мм; 10^6 циклов (или
эквивалент); контроль остаточной деформации; измерить контакт/амплитуду на
15 Гц/10 мм; проверить p0/износ кулачка; протокол.

**В9. Нужен ли отдельный этап fix8?**

В этом этапе fix8 **не создавался**. Замечания S1–S6 — в
[`findings.csv`](./findings.csv). Следующая корректировка возможна после
решения по пружинному пакету, материалу и профилю (C8).

## 2. Принятые допущения

| Вопрос | Принято | Почему |
|---|---|---|
| L0 | 70 мм свободная | установленная 36 задана геометрией |
| OD / проволока | 12 / 1,0 мм | fix7 |
| Витки / концы | 11 / закрытые шлифованные | как fix6 |
| Количество | 4 | как fix6 |
| Материал | пружинная сталь | spec.csv |
| τ_доп | 500…700 МПа | ориентир для усталости |
| Установленная длина | 36 мм | 280−241−2×1,5 |
| Движущаяся масса | 0,919 кг | реальные LMK/6200 + шарик 33 г |
| Контакт | квазистатический, жёсткий ролик | оценка |
| Профиль | идеальная синусоида + фактический 2-лепестковый | C8 expert2 |
| f_соб | 8,64 Гц | k/m; L0 не влияет |

## 3. Что не проверялось

1. Ограждение, привод/дрель, валы, LMK, балка 21, крепление, шарик,
   документы — вне scope.
2. FEA, модальный анализ, усталость рамы/кулачка/вала.
3. Реальная пружина: k, L0, ID, концы, материал, допуски.
4. Удар шарика, податливость PLA, динамика рамы, шум.
5. Износ ID/вала, p0/износ кулачка, ресурс 10^6 циклов.
6. Тепловое поведение, старение, влажность.
7. Испытания на вибростенде; все выводы — аналитические.

## 4. Противоречия и предложения

1. **L0=70 улучшает контакт, но перегружает пружину**: τ 729 МПа при
   допустимом 500…700; нельзя принять 4×Ø12×1,0 L0=70 без переделки/
   проверки. Нужен другой пакет (больше пружин/меньше проволока/материал).
2. **Цель 2× по гармонической синусоиде не достигнута** (1,48); фактический
   профиль даёт 2,48, но он негармонический. Нельзя принимать пружину по
   фактическому профилю.
3. **f_соб 8,64 Гц** внутри 5…15; L0 не меняет; нужен демпфер или другой
   k/m.
4. **ID 10,0 при вале 10** — нулевой зазор; сжатие 34 мм; риск трения.
5. **8×0,9** — вариант, но τ 636 МПа; требуется материал/испытание и 8 мест.
6. **fix8 не создан**; сначала нужно решение по пружинному пакету и C8.

## 5. Связь с fix8

Если пользователь подтвердит пакет (например, 8×Ø12×0,9 или иной), материал
и необходимость гармонического профиля, можно оформить fix8 с S1–S6 и
испытаниями. Пока ограничиваемся этим отчётом и реестром.
