inutcin/boomboom/stages/expert_correct/Interview.md

# Интервью по этапу «Корректировки и замечания после инженерной экспертизы»

Дата: 28.10.2026  
Этап: `stages/expert_correct`  
Исходные материалы: `stages/expert/Report.md`, `stages/expert/Interview.md`, `stages/model/*`, `stages/correct/1/*`

## 1. Ответы, заданные в описании этапа

Ответы 1–18 из [`README.md`](./README.md) приняты как исходные данные. Ключевые:

| № | Вопрос | Ответ |
|---:|---|---|
| 1 | Что измеряется в эксперименте? | Время между соударениями (микрофон), частота (стробоскоп); дополнительно коэффициент восстановления. |
| 2 | Какие сочетания частота–амплитуда нужны? | Достаточно фиксированной амплитуды и регулировки частоты; важна величина `ω²A`. |
| 3 | Полезная нагрузка? | Шарик 33 г, по центру; 5 кг не планируется. |
| 4 | Какая дрель? | Любая бытовая с фиксацией курка и плавной регулировкой; крепление под популярные габариты. |
| 5 | Ресурс? | От секунд до нескольких минут непрерывной работы. |
| 6 | Требования безопасности? | Защитный кожух, вынос ручки управления дрелью. |
| 7 | Шум? | Не регламентируется. |
| 8 | Критерий гармоничности? | Жёстких критериев нет; не должно быть биений, резких фронтов и срезов. |
| 9 | Допустима ли направляющая? | Да, чтобы убрать нижние пружины. |
| 10 | Можно ли убрать нижние пружины? | Да. |
| 11 | Можно ли заменить верхнюю плиту стальной? | Верхнюю плиту убрать, чтобы шарик не бился. |
| 12 | Можно ли заменить фанерную столешницу? | Да: печатная плита с вогнутой поверхностью + стальные листы 0,3–0,5 мм. |
| 13 | Кулачок: закалка/CNC? | Комплект печатных кулачков, толщина 20 мм; ролики и кронштейны увеличить. |
| 14 | Нужен ли CAD/STEP? | Позже, после согласования конструкции и материалов. |
| 15 | Нужны ли датчики в составе? | Измерения внешние. |
| 16 | Габариты/масса? | 600 × 500 × 860 мм, масса ≤ 20 кг; вверх можно увеличить куполом. |
| 17 | Число лепестков? | Два (овальный кулачок). |
| 18 | Шарик и колпак? | Шарик Ø20…33 мм; вместо колпака — купол-уловитель. |

## 2. Вопросы, заданные при выполнении этапа

В ходе работы потребовались уточнения, потому что ответы README вступали в противоречие с массой, безопасностью и компоновкой.

| № | Вопрос | Ответ |
|---:|---|---|
| 1 | Лимит 20 кг не выполняется со стальной рамой 40×40×4 и поликарбонатом 4–5 мм. Что принять? | Сначала: оставить сталь 40×40×4 и ПК 4–5 мм. Затем уточнено: **рама — стальная труба 30×30×1,5 мм**, кожух — **первоначальный ПК 4–5 мм**. |
| 2 | Как соединять вал кулачка с дрелью? | **Вал прямо в патроне + две опоры**, без упругой муфты. |
| 3 | Как обеспечить осевое крепление кулачка? | **Принудительно против часовой стрелки**, правая резьба, большой момент затяжки. |
| 4 | Как изготавливать кулачки 20 мм? | **Только печать PETG/PA-CF**, без стальной вставки. |
| 5 | Высота купола? | **500 мм** над столом, общий габарит ≈1060 мм. |
| 6 | Можно ли 2 мм поликарбонат? | Рассмотрено; 2 мм снижает массу, но слабее защиты. Принято: **вернуться к первоначальному ПК 4–5 мм**. |
| 7 | Можно ли заменить верхнюю часть и купол сеткой, а осевые стороны оставить открытыми? | Рассмотрено; от схемы отказались в пользу полного ПК-кожуха и купола. |
| 8 | Можно ли раму 30×30×1,5? | **Да**, принято; с обязательными укосинами и усиливающими пластинами. |

## 3. Принятые допущения

1. **Амплитуда** — размах (peak-to-peak) вертикального перемещения стола.
2. **Кулачок** — двухлепестковый, `r(φ) = R + e·cos(2φ)`, `R = 110 мм`, `e = 1,38 / 2,76 / 4,60 мм` для `A = 3 / 6 / 10 мм` при двух роликах `z = ±50 мм`.
3. **Ролики** — по два подшипника 6202-2RS на ролик (суммарная ширина 22 мм), кронштейны 100 × 60, щёки 60 × 65, зазор 24 мм.
4. **Кулачок** — печатный, 20 мм, PETG/PA-CF; контактная пара «печатный кулачок — стальное кольцо подшипника»; ресурс ограничен, комплект сменный.
5. **Вал** — шпилька M12, гладкий хвостовик Ø12 в патроне, две опоры 6202-2RS через втулки 15/12. Ось кулачка смещена на 50 мм в сторону дрели, чтобы обе опоры стояли между кулачком и патроном.
6. **Дрель** — бытовая, с фиксацией курка; вращение принудительно против часовой стрелки; патрон должен быть проверен на самоотвинчивание.
7. **Подвеска** — 4 верхние пружины (предв. `d=2,0`, `D=30`, `n=16`, `L0=233`, монтажная 110 мм, 45 Н/пружину, `f_соб ≈ 3,5 Гц`), 4 направляющие Ø20 с LM20UU, две балки на 670 мм; нижние пружины удалены.
8. **Стол** — печатная плита 500 × 400 × 15 с эллиптической вогнутостью 6 мм, стальной лист 0,5 мм сверху и 0,3–0,5 мм снизу, бортики и саморезы; печать сегментами.
9. **Рама** — стальная труба 30 × 30 × 1,5, сварная/сборная, 4–6 укосин, усиливающие пластины, резиновые опоры.
10. **Кожух** — поликарбонат 4–5 мм по первоначальной схеме, две Г-образные дверки, верхняя крышка, купол 500 мм, аварийный останов, УЗО, концевики.
11. **Масса** — расчётно 38–45 кг; лимит 20 кг не выполняется; это принятое отклонение, зафиксированное в `Report.md`.
12. **Габарит** — 600 × 500 × 1060 мм (купол выше станины 860 мм); ответ 16 допускает увеличение вверх.

## 4. Открытые вопросы и риски

1. **Масса 38–45 кг** против лимита 20 кг. Принято отклонение; для будущей лёгкой версии — алюминиевая рама, ПК 2–3 мм + сетка, облегчённые стол и подстолье.
2. **Резонанс рамы 30×30×1,5.** Без укосин первая мода может попасть в 5–15 Гц; обязательны 4–6 укосин и проверка акселерометром/молотком.
3. **Самоотвинчивание патрона при обратном вращении.** Нужен патрон с фиксацией или дополнительный стопор; проверить при первом пуске.
4. **Износ и точность печатных кулачков.** FDM ±0,2 мм при `e=1,38 мм` — заметная погрешность; кулачки измерять, маркировать фактическую амплитуду, иметь запасной комплект.
5. **Контактное давление печатного кулачка.** Оценка 45 МПа статически и до 135 МПа при 3×; для PETG на пределе, для PA-CF лучше; следить за износом.
6. **Соосность вала и патрона.** Вал в патроне + две опоры требуют регулировки подкладками; биение кромки кулачка ≤0,05 мм.
7. **Печатный стол.** Сегментная печать, склейка/стяжка, стальные листы; проверить плоскостность, вогнутость и отсутствие дребезга.
8. **Пружины.** Параметры предварительные; проверить на макете, особенно критическую частоту витков и усталость.
9. **Гармоничность.** Критерий не задан; в отчёте предложен THD вертикального ускорения ≤5–10 % и проверка на макете.
10. **Опечатка в описании этапа.** В README указан «Review.md»; фактически по конвенции проекта выпущен `Report.md`.

## 5. Итог

Все вопросы, влияющие на конструкцию, закрыты или переведены в принятые отклонения. Этап выпускает обновлённые листы, расчёты, `Jump.md` и программу проверки; рабочие чертежи и испытания — следующий этап.
