inutcin/boomboom/stages/expert_correct/Jump.md

# Оценка подскока шарика и высоты купола-уловителя

Дата: 28.10.2026  
Этап: `stages/expert_correct`  
Вход: `stages/expert_correct/README.md` (ответы 1–18), `stages/expert/Report.md`, `stages/expert_correct/Report.md`

## 1. Постановка задачи

Нужно оценить, может ли стальной шарик, лежащий на колеблющемся столе, подскочить настолько, чтобы коснуться верхней крышки (купола-уловителя). Шарик — Ø20…33 мм, масса 33…150 г. Стол совершает вертикальные колебания с размахом `A = 3…10 мм` и частотой `f = 5…15 Гц`.

Рассматриваются два эффекта:

1. **Однократный отрыв** от стола на верхней части хода, когда ускорение стола вниз превышает `g`.
2. **Повторные соударения** шарика со столом при коэффициенте восстановления `e = 0,7…0,9`; при удачном фазировании шарик может накапливать энергию и подниматься существенно выше однократного отрыва.

## 2. Модель

Принята одномерная вертикальная модель:

- стол: `y_ст(t) = (A/2)·sin(ωt)`, `ω = 2πf`;
- шарик: свободный полёт с ускорением `−g`, удар о стол при `y_ш = y_ст`;
- при ударе: `v_ш⁺ = v_ст + e·(v_ст − v_ш⁻)`, где `v_ш⁻` — скорость шарика до удара;
- вращение, трение, качение и воздух не учитываются;
- начальная фаза стола варьируется (0°, 45°, 90°, 135°);
- расчёт вёлся с шагом `dt = 1·10⁻⁴ с` (в 10 раз крупнее первого варианта `1·10⁻⁵ с`), 5 с на режим, 4 начальные фазы. Это 50 тыс. шагов на режим вместо миллионов; для оценочного вывода достаточно.

Модель консервативна по вертикали: реальный шарик на вогнутом столе катится, удары часто косые, а стальной лист на печатной плите имеет коэффициент восстановления ниже, чем сталь по стали.

## 3. Однократный отрыв

Условие отрыва на верхней части хода:

`(A/2)·ω² > g`.

Для 15 Гц и 10 мм:

`(0,005 м)·(2π·15)² = 44,4 м/с² = 4,5g`.

Для 5 Гц и 10 мм:

`(0,005 м)·(2π·5)² = 4,93 м/с² < g` — отрыва нет.

Если бы шарик отрывался только один раз и без повторных ударов, его подъём над средним положением стола при 15 Гц/10 мм составил бы около **11,9 мм**, то есть всего ≈7 мм над верхней точкой стола. Это безопасно. Опасность создают повторные соударения.

## 4. Результаты модели повторных соударений

Максимальная высота шарика над положением стола при `f = 15 Гц`, `A = 10 мм`:

| Коэффициент восстановления e | Высота за 5 с, мм (диапазон по 4 фазам) |
|---:|---:|
| 0,7 | 109–209 |
| 0,8 | 187–363 |
| 0,9 | **304–408** |

Другие режимы (для сравнения):

| Режим | e | Максимальная высота, мм |
|---|---:|---:|
| 15 Гц / 6 мм | 0,9 | ≈156 |
| 15 Гц / 3 мм | 0,9 | ≈38 |
| 10 Гц / 10 мм | 0,9 | ≈175 |
| 5 Гц / 10 мм | 0,9 | отрыва нет, ≈5 |

При `e = 0,9` и 15 Гц/10 мм шарик может подняться на **300–400 мм** над столом. Это выше, чем 250 мм, поэтому плоская крышка на высоте 250 мм будет касаться шариком; при 500 мм запас есть.

## 5. Принятое решение

- Высота купола-уловителя над столом: **500 мм**.
- Верхняя крышка/купол: на высоте ≈1060 мм от пола (стол 560 мм + 500 мм); общий габарит 600 × 500 × 1060 мм. Ответ 16 допускает увеличение вверх за счёт купола.
- Купол — поликарбонат 4–5 мм, с мягкой накладкой (пенополиуретан 10–20 мм) на верхней крышке; шарик может касаться купола, но не должен разрушать крышку.
- Если габарит 860 мм жёсткий: купол 250 мм + мягкий уловитель; при этом касание крышки шариком возможно, крышка должна быть ударопрочной и с мягкой накладкой. Этот вариант не принят.

## 6. Ограничения оценки

- Модель одномерная, без вращения и качения; реальный шарик на вогнутой поверхности может вести себя иначе.
- Коэффициент восстановления `e = 0,7…0,9` — оценка; для стального шарика по стальному листу он может быть 0,8–0,9, для печатной плиты с податливой подложкой — ниже.
- Шаг `dt = 1·10⁻⁴ с` coarse; при удачном фазировании возможны и большие высоты, поэтому запас 500 мм выбран с учётом разброса.
- Модель не учитывает удар шарика о стенку купола и повторное падение; купол должен выдерживать многократные удары.
- Для окончательного вывода нужны испытания с видеофиксацией на 15 Гц/10 мм и измерением фактического `e`.

## 7. Вывод

При 15 Гц и размахе 10 мм шарик может подскакивать на 300–400 мм, поэтому верхняя крышка на 250 мм будет касаться шариком. Принят купол **500 мм** (общий габарит ≈1060 мм), с мягкой накладкой. Если верхнюю часть оставить открытой, шарик будет улетать с установки — это противоречит требованию «шарик остаётся около центра» и не допускается.
