inutcin/boomboom/stages/expert_correct/README.generated.md

# Корректировки и замечания после инженерной экспертизы (черновик, создан по результатам инженерной экспертизы, не является описанием этапа)

Статус: **выполнен 28.10.2026.** Актуальное описание этапа — [`README.md`](./README.md), отчёт — [`Report.md`](./Report.md); этот файл — исторический черновик плана.  
Дата создания плана: 28.10.2026  
Вход: [`stages/expert/Report.md`](../expert/Report.md), [`stages/expert/Interview.md`](../expert/Interview.md), листы `stages/model` и `stages/correct/1`.

## 1. Цель этапа

Устранить критичные замечания, реализовать важные и подготовить основу для пожеланий; выпустить согласованные обновлённые листы, расчёты и программу испытаний макета. Этап не является производством; его результат — конструкция, готовая к изготовлению опытного образца.

## 2. Приоритеты

1. **Безопасность и привод** — критично.
2. **Подвеска, направляющие и несущая цепь** — критично.
3. **Кинематика, амплитуда и динамика** — важно.
4. **Стол, шарик и защита** — важно.
5. **Документация, спецификация и испытания** — важно.
6. **Пожелания** — по возможности, без ущерба первым пяти пунктам.

## 3. Пакеты работ

### WP1. Безопасность и привод (К1–К3, К7)

- Кожух вокруг кулачка, роликов, патрона/муфты и пружин; стальная сетка + поликарбонат 4…5 мм; блокировка кожуха; аварийный останов; УЗО; знаки.
- Отдельный вал кулачка на двух подшипниках в жёстком корпусе; упругая муфта к дрели; радиальная нагрузка на патрон — ноль.
- Положительное осевое крепление диска: буртик, два штифта/шпонка, левая резьба или стопорная пластина, резьбовой фиксатор, момент затяжки.
- Антипроворот дрели: стальное седло/хомуты, реактивная тяга, тонкая резина 2…3 мм; проверка вентиляционных окон.
- Балансировка диска с оправкой; биение кромки ≤ 0,05 мм.

**Приёмка:** при открытом кожухе пуск невозможен; аварийный останов работает; относительный проворот диска отсутствует при 2-кратном моменте; радиальная нагрузка на патрон равна нулю; биение ≤ 0,05 мм.

### WP2. Подвеска, направляющие и несущая цепь (К4–К6)

- Расчёт пружин: 4 верхние (или 8 с обоснованием), жёсткость, свободная длина, диаметр проволоки, материал, напряжение, усталость, критическая частота витков.
- Предподжим с запасом 1,5: не менее 170 Н для 2,6 кг и не менее 480 Н для 7,6 кг (при 15 Гц/10 мм).
- Решение по нижним пружинам: убрать или существенно пересчитать; проверить, что они не отрывают стол от кулачка.
- Направляющая вертикального перемещения: линейные подшипники/стойки, параллелограммная упругая подвеска или центральная штанга; боковой люфт ≤ 0,1 мм, наклон ≤ 0,1°.
- Ловители/ограничители хода, не позволяющие столу упасть при потере контакта; демпфер.
- Стальная верхняя плита 8…10 мм или фанера со стальными прижимными пластинами; болты M8 + штифты к раме; стальные шайбы под гайками; расчёт шпилек.
- Раскосы/косынки рамы; анкеровка/резиновые опоры.

**Приёмка:** контакт ролика положителен на всех режимах; статическая нагрузка 3-кратного веса без остаточной деформации; отсутствие люфта после 10^3 циклов; рама не имеет резонансов в 5…15 Гц.

### WP3. Кинематика, амплитуда и динамика (В1–В4, В11, В13)

- Выбрать схему: один центральный ролик + направляющая (A ≈ 2e) или два ролика с корректным расчётом `A(e)`.
- Пересчитать диски: для точных 3/6/10 мм при двух роликах `e ≈ 1,38 / 2,76 / 4,60 мм`; при одном ролике — 1,5/3/5 мм. Проверить, что максимальная амплитуда не превышает 10 мм.
- Обеспечить регулировку положения кулачка относительно роликов (пазы/шайбы) и осевого положения; процедура настройки по индикатору.
- Критерий гармоничности: THD вертикального ускорения ≤ 5…10 % (уточнить); проверить на макете.
- Стабилизация частоты: мотор с замкнутым контуром или дрель с тахометром; плавный пуск/останов; запрет длительной работы вблизи резонанса.
- Проверить балансировку и биение после сборки.

**Приёмка:** измеренная амплитуда 3…10 мм с допуском ±10 %; частота 5…15 Гц с допуском ±5 %; THD в допуске; отсутствие отрыва и ударов на всех режимах.

### WP4. Стол, шарик и защита (В7, В8)

- Полная вогнутость рабочей плоскости (эллиптическая/параболическая чаша 5…8 мм) либо наклонный борт к лунке; твёрдая съёмная накладка.
- Бортик выше/прозрачный колпак; защита от вылета шарика.
- Локальное усиление столешницы под кронштейнами роликов; проверить прогиб и дребезг.
- Испытания шарика на 15 Гц/10 мм: удержание около центра, отсутствие вылета, видеофиксация.

**Приёмка:** шарик остаётся в центральной зоне на всех режимах; отсутствует вылет; поверхность не деформируется.

### WP5. Крепления и детали (В5, В6, В9, В10, В12, В14, В16)

- Кронштейн ролика: зазор по наружному кольцу 0,5…1 мм на сторону, упорные шайбы, обработка после сварки.
- Крепление кронштейна: M8×25/30 или резьбовая вставка; проверка вырыва.
- Кулачок: 40Х/45, 40…45 HRC, шлифовка, скругление кромки 0,5…1 мм, смазка; лазерная/CNC-резка.
- Обновить общие виды `model` и листы `correct/1` под единую редакцию; устранить расхождения 18/12 мм, M10/M12, хомут/U-болты, 542/548 мм.
- Спецификация с покупными деталями, допусками, посадками, шероховатостями; оценка стоимости.
- Проверить покупные U-болты, пружины, подшипники; при необходимости заменить на стандартные.

**Приёмка:** все детали собираются без доработки по месту; спецификация полная; альбом согласован.

### WP6. Документация и испытания (В15)

- Программа испытаний: статическая тарировка пружин, биение, амплитуда, частота, ускорение/спектр, температура, ресурс, поведение шарика.
- Точки крепления индикатора, акселерометра, тахометра.
- Протокол испытаний и критерии приёмки.
- Обновить `stages/all_stages.pdf`: общие виды, детали, листы экспертизы и корректировок.
- Риск-анализ и инструкция по эксплуатации.

**Приёмка:** протокол заполнен; все требования README подтверждены измерениями или обоснованно признаны неприменимыми.

## 4. Критерии приёмки этапа

1. Все 7 критичных замечаний закрыты или явно приняты как ограничение с письменным обоснованием.
2. Все 17 важных замечаний закрыты либо переведены в пожелания с оценкой последствий.
3. Амплитуда 3…10 мм (размах), частота 5…15 Гц, гармоничность в согласованном допуске.
4. Безопасность: кожух, блокировка, аварийный останов, защита от вылета, инструкция.
5. Комплект: обновлённые листы, спецификация, расчёты, программа испытаний, альбом.

## 5. Ожидаемый состав этапа

```
stages/expert_correct/
  figs/          — обновлённые виды/узлы
  pics/          — PNG-дубли
  (каталоги figs/pics — по конвенции предыдущих этапов)
  tools/         — генератор листов
  Report.md      — отчёт о выполненных корректировках
  Interview.md   — вопросы и ответы
  README.md      — этот план
```

## 6. Открытые вопросы

См. [`stages/expert/Interview.md`](../expert/Interview.md), раздел 3. До начала работ желательно уточнить: расчётную нагрузку, требования лаборатории по безопасности, критерий гармоничности, допустимость направляющей и замены фанеры на сталь, наличие дрели/мотор-редуктора и требуемый ресурс.

## 7. Следующий этап

После выполнения корректировок — изготовление и испытания опытного образца, затем рабочие чертежи и сводный альбом.
