inutcin/boomboom/stages/all_stages.pdf

# ВИБРОСТОЛ

# Сводный альбом: общий вид, детали узлов и экспертиза

ОБЩИЙ ВИД | ДЕТАЛИ УЗЛОВ

### 2. Исходный эскиз

Фотография эскиза от руки — исходная идея устройства.

### 3. Вид сбоку. Разрез А–А

Общая компоновка, разрез по оси, пружины и привод.

### 4. Вид слева

Два ролика, кулачковый диск и пружинная подвеска.

### 5. Изометрия

Пространственная схема устройства и расположение узлов.

### 6. Столешница

Облегчение, лунка Ø360 × 3, бортик и шарик Ø20.

### 7. Подстолье

Окно Ø250, отверстия шпилек M12 и U-болтов M8.

### 8. Крепление ролика

Вид снизу, разрез Д–Д, шестигранный крепёж M8.

### 9. Ось ролика и подшипник

Разрез А–А, 6202-2RS, втулка 15/12, болт M12×45.

### 10. Крепление дрели

Два U-болта M8, резиновые подкладки и окно.

### 11. Крепление кулачкового диска

Оправка Ø10/Ø40, шайба Ø60, винт M8, профиль диска.

## ЭКСПЕРТИЗА

### 12. Кинематика кулачок–ролики

Фактическая амплитуда, угол контакта, боковые силы.

### 13. Динамика подвески и контакт

Сила инерции, требуемый поджим пружин, резонанс.

### 14. Карта рисков и защита

Критичные зоны, рекомендуемый привод, сводка замечаний.

Редакции

Страницы 2–5 — общий вид этапа model; страницы 6–11 — детали узлов этапа correct/1.
Страницы 12–14 — листы инженерной экспертизы; полный перечень замечаний — stages/expert/Report.md. Более поздние редакции узлов — листы correct/1. При противоречии использовать их.
Общие виды model сохранены как исходная редакция, так как позднее не перевыпускались.

28.10.2026 · DeepSeek / OpenCode · A3, 200 dpi · 14 страниц Источники: stages/model/pics/*, stages/correct/1/pics/*, stages/expert/pics/*

# Исходный эскиз

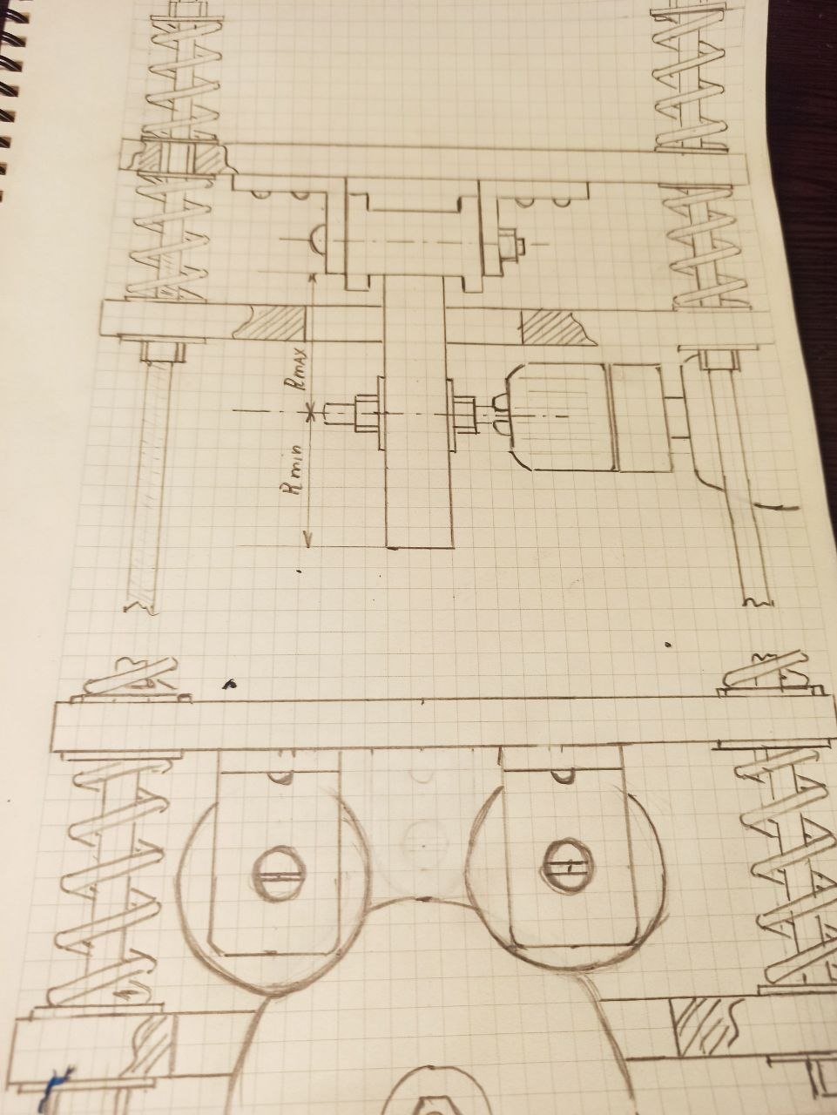
[picture p1: page 2]

model · stages/model/pics/common_idea.jpg

Фотография эскиза от руки; исходный материал этапа model.

# Общий вид установки

Рама 600×500×860, кожух ПК 4–5 мм, купол-уловитель, привод с кулачком

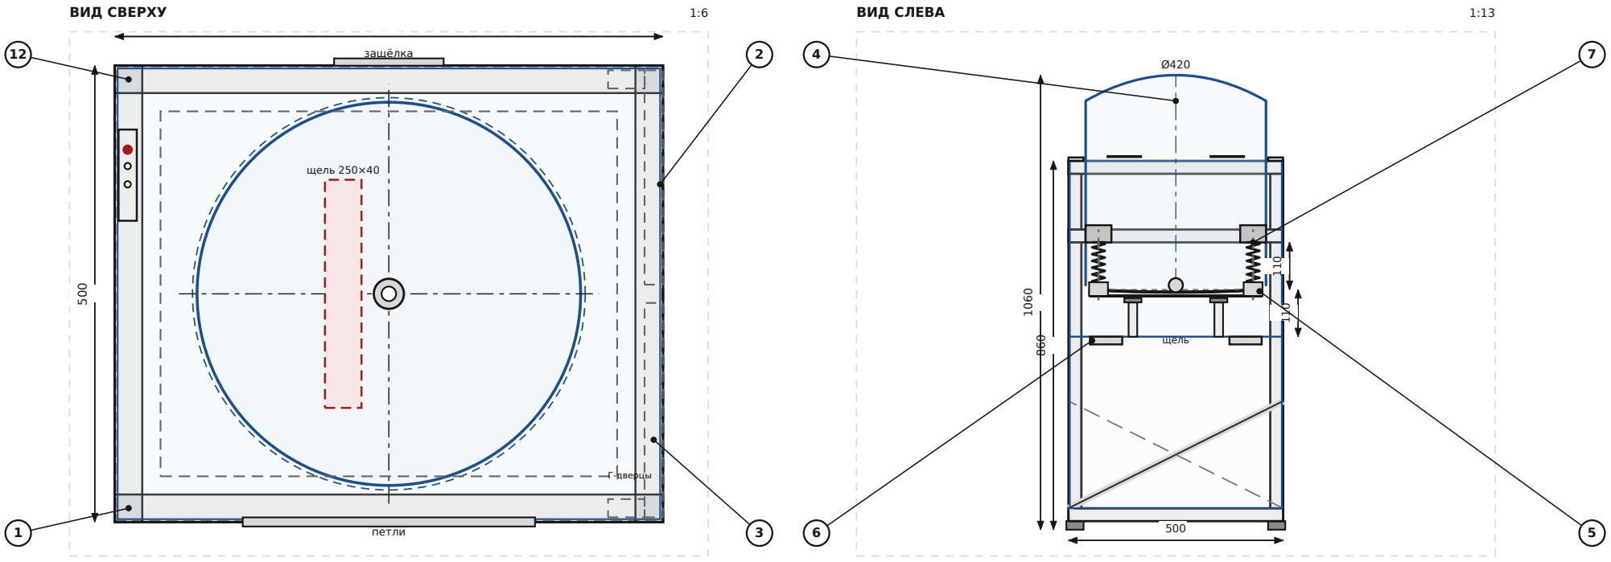
[picture p2: figure]
ВИД СВЕРХУ; ВИД СЛЕВА; защёлка; петли; щель 250×40; Г-дверцы; щель

## СПЕЦИФИКАЦИЯ

№ | Наименование | Кол. | Примечание
1 | Рама 30×30×1,5 | 1 | сталь, раскосы
2 | Панели ПК 4–5 мм | к-т | 3 стороны + верх
3 | Дверцы нижние Г-обр. | 2 | петли, защёлка, концевик
4 | Крышка + купол | 1 | Ø420, верх 1060
5 | Стол 500×400×15 | 1 | печать + сталь
6 | Подстолье 500×400×18 | 1 | щель 250×40
7 | Подвеска стола | к-т | 4 пружины, 4 направ.
8 | Дрель | 1 | покупная
9 | Кулачок 20 мм | 1 из 3 | PETG / PA-CF
10 | Крепление дрели | к-т | 2 U-болта M8
11 | E-stop / УЗО | к-т | E-stop, УЗО, знаки
12 | Опоры / косынки | к-т | резина, сталь

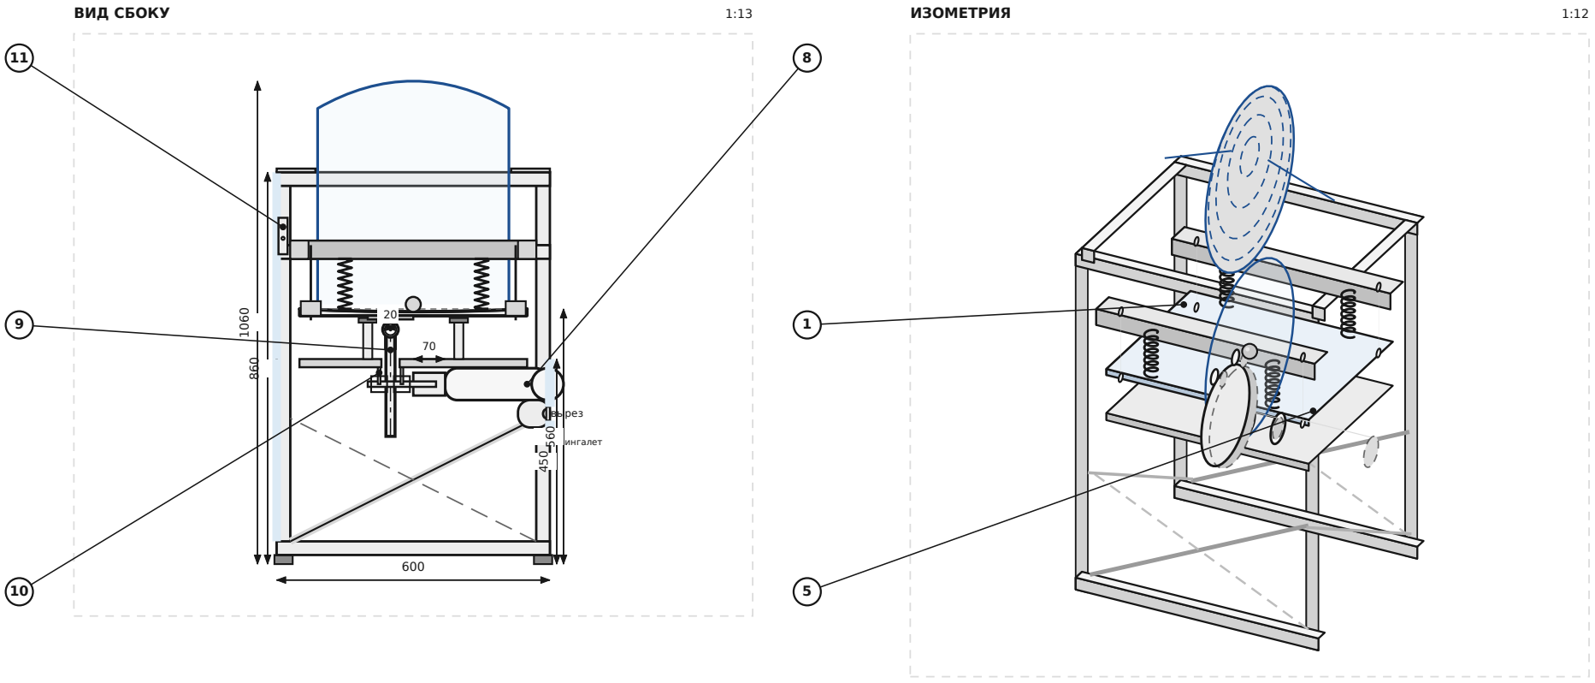
[picture p3: figure]
ВИД СБОКУ; ИЗОМЕТРИЯ; вырез; шпингалет

Масса ≈38–45 кг. Лимит 20 кг НЕ выполнен — принятое отклонение.
Рама 30×30×1,5: жёсткость ≈4,4× ниже 40×40×3; раскосы обязательны.
Габарит с куполом 600×500×1060; рама 860, стол 560, подстолье 450. Купол закреплён на крышке и поднимается вместе с ней.

# ВИБРОСТОЛ

Этап: корректировки после экспертизы
Общий вид

М 1:6…1:13 · размеры, мм
Лист 1 из 5
28.10.2026 · DeepSeek / OpenCode | A3 · 1:10

Корректировки после инженерной экспертизы · 28.10.2026 · лист 1 из 5

# Подвеска стола

## СПЕЦИФИКАЦИЯ

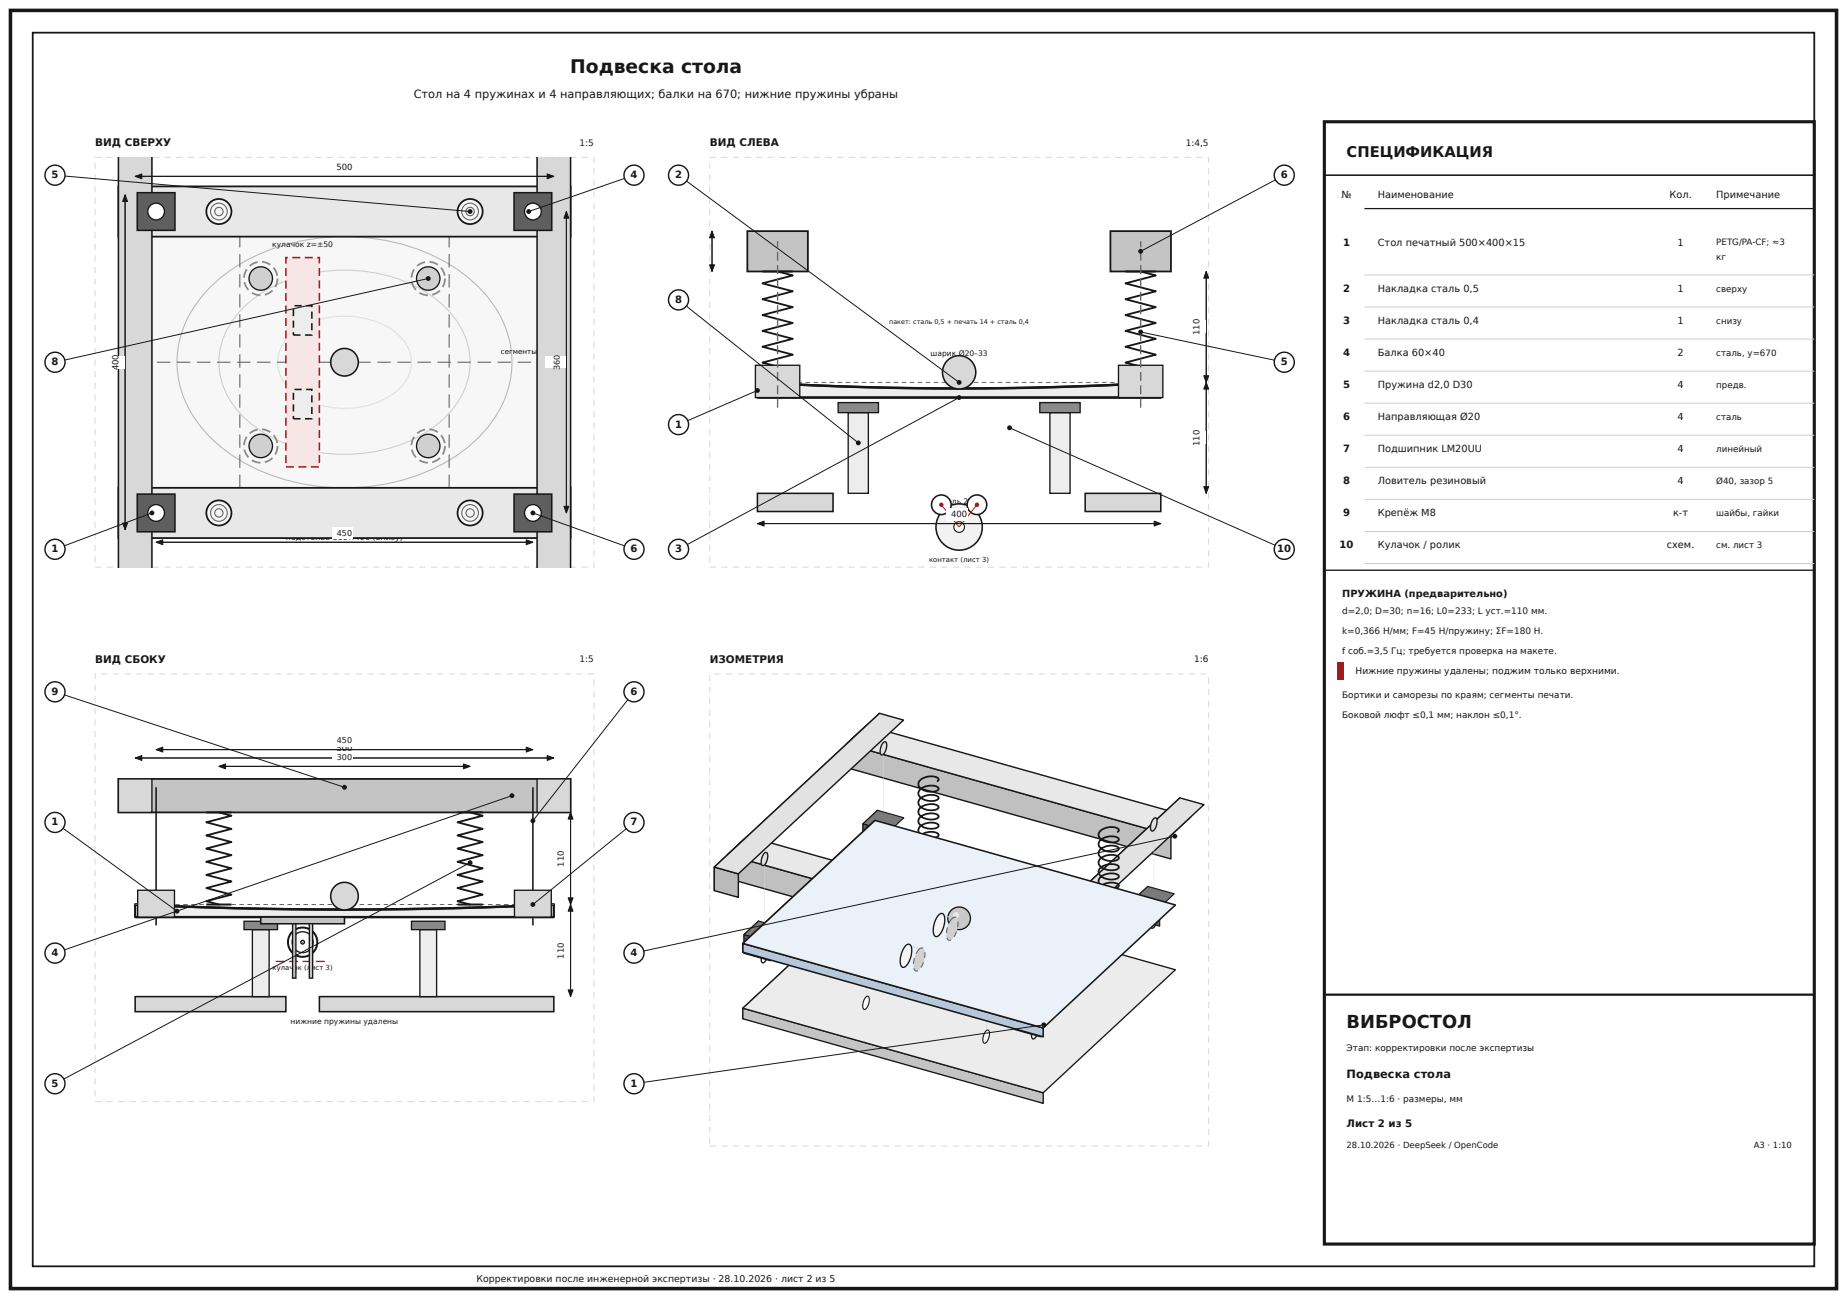
[picture p4: page 16]
ВИД СВЕРХУ; ВИД СЛЕВА; ВИД СБОКУ; ИЗОМЕТРИЯ; подстолье 500×400 (внизу); вогнутость 6 мм; сегменты; кулачок z=±50; щель 250; шарик Ø20–33; контакт (лист 3); кулачок (лист 3); Наименование; Кол.; Примечание; Стол печатный 500×400×15; PETG/PA-CF; ≈3; Накладка сталь 0,5; сверху; Накладка сталь 0,4; снизу; Балка 60×40; сталь, y=670; Пружина d2,0 D30; предв.; Направляющая Ø20; сталь; Подшипник LM20UU; линейный; Ловитель резиновый; Ø40, зазор 5; Крепёж M8; шайбы, гайки; Кулачок / ролик; схем.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

Стол на 4 пружинах и 4 направляющих; балки на 670; нижние пружины убраны

пакет: сталь 0,5 + печать 14 + сталь 0,4

k=0,366 Н/мм; F=45 Н/пружину; ΣF=180 Н.
f соб.=3,5 Гц; требуется проверка на макете.
Нижние пружины удалены; поджим только верхними.
Бортики и саморезы по краям; сегменты печати.
Боковой люфт ≤0,1 мм; наклон ≤0,1°.

нижние пружины удалены

Этап: корректировки после экспертизы
Подвеска стола
М 1:5…1:6 · размеры, мм
Лист 2 из 5

Корректировки после инженерной экспертизы · 28.10.2026 · лист 2 из 5

# Контакт кулачка и роликов

## СПЕЦИФИКАЦИЯ

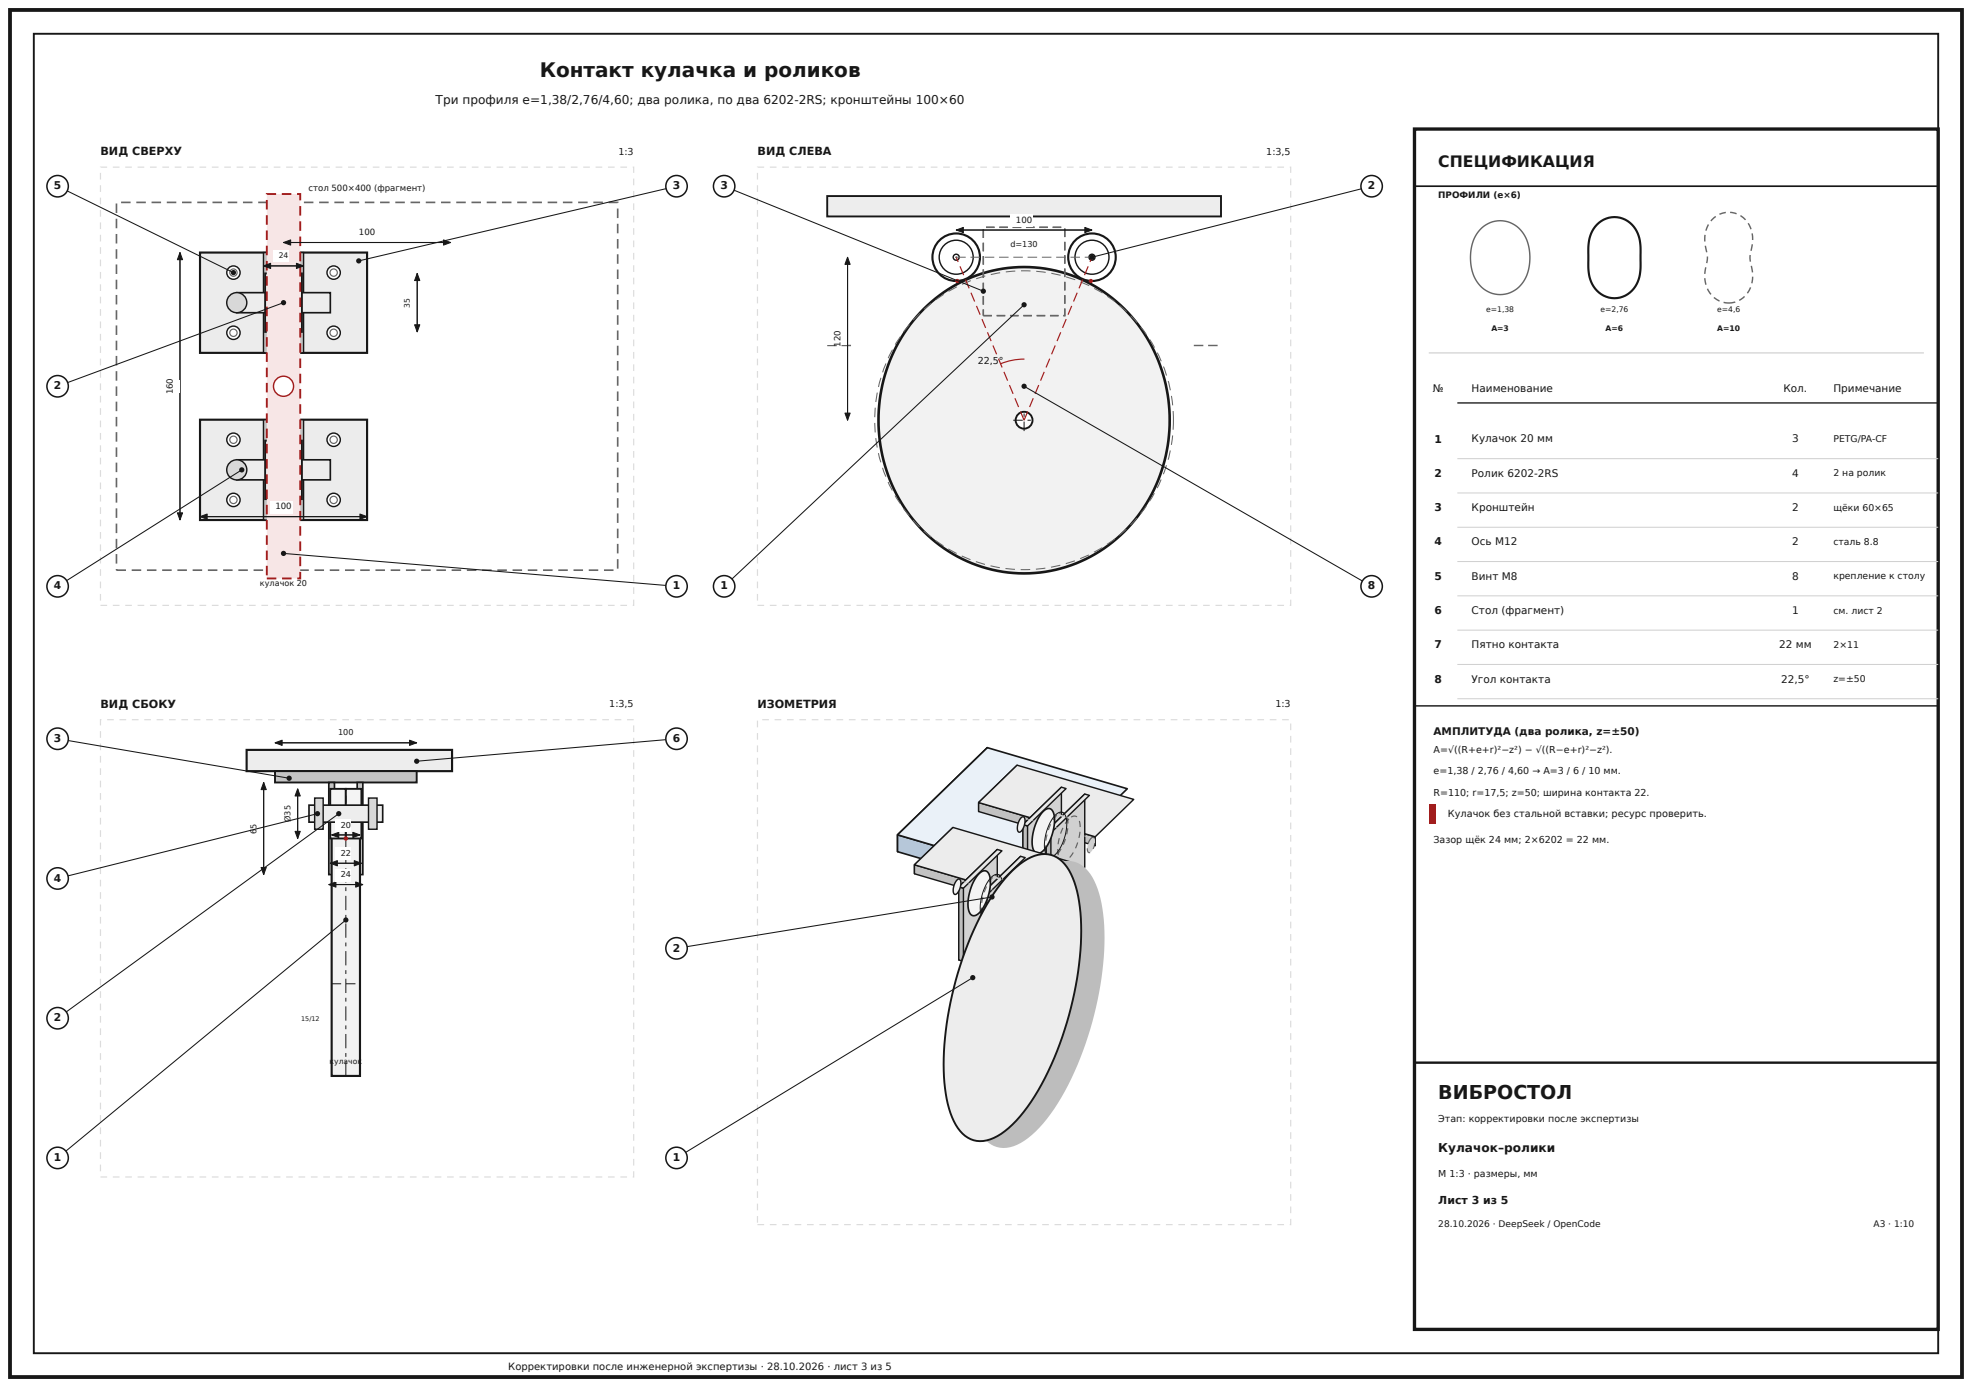
[picture p5: page 17]
ВИД СВЕРХУ; ВИД СЛЕВА; ВИД СБОКУ; ИЗОМЕТРИЯ; стол 500×400 (фрагмент); кулачок 20; подстолье, щель 250; кулачок; ПРОФИЛИ (e×6); Наименование; Кол.; Примечание; Кулачок 20 мм; PETG/PA-CF; Ролик 6202-2RS; 2 на ролик; Кронштейн; щёки 60×65; Ось M12; сталь 8.8; Винт M8; крепление к столу; Стол (фрагмент); см. лист 2; Пятно контакта; Угол контакта; ВИБРОСТОЛ; 28.10.2026 · DeepSeek / OpenCode

Три профиля e=1,38/2,76/4,60; два ролика, по два 6202-2RS; кронштейны 100×60

АМПЛИТУДА (два ролика, z=±50)

R=110; r=17,5; z=50; ширина контакта 22.
Кулачок без стальной вставки; ресурс проверить.

Зазор щёк 24 мм; 2×6202 = 22 мм.

Этап: корректировки после экспертизы
Кулачок–ролики
М 1:3 · размеры, мм
Лист 3 из 5

Корректировки после инженерной экспертизы · 28.10.2026 · лист 3 из 5

# Крепление кулачка на оси

Кулачок на шпильке M12, два подшипника 6202; смещение 50 мм; хвостовик в патроне

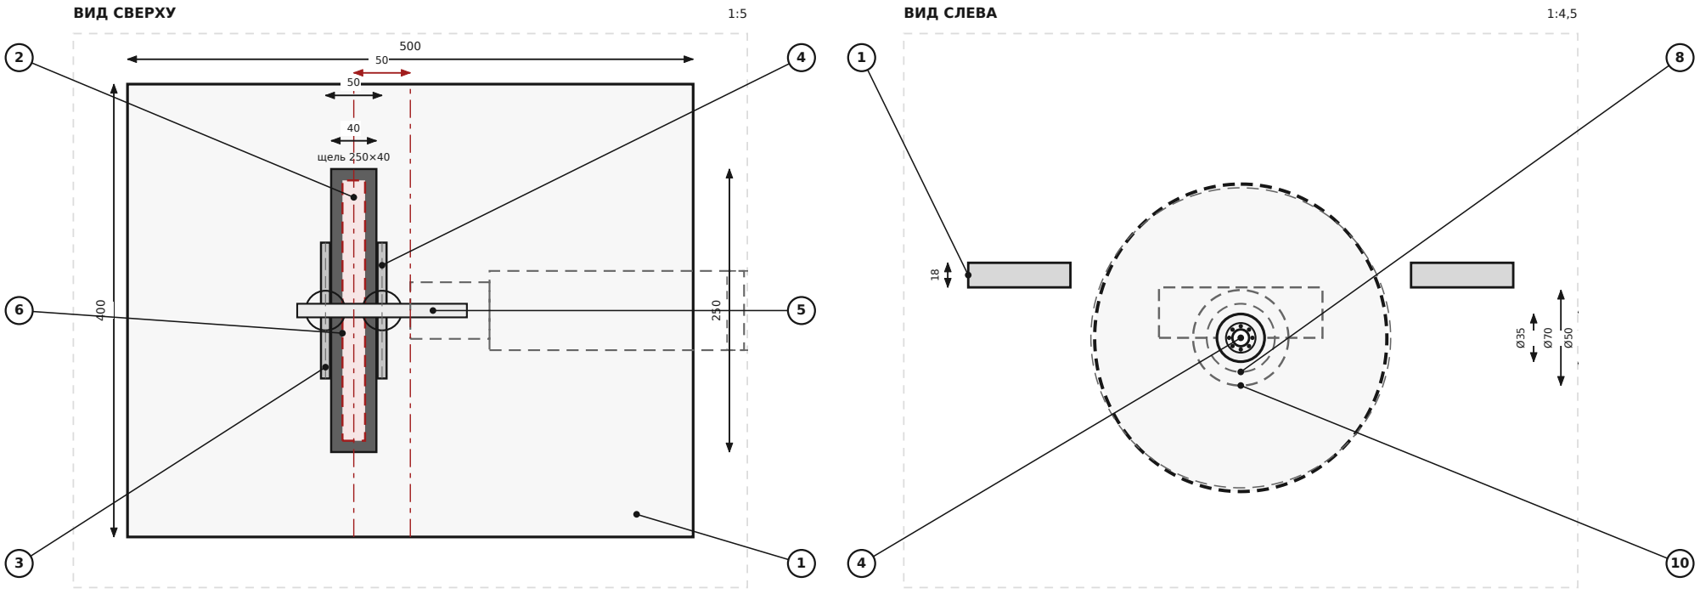
[picture p6: figure]
ВИД СВЕРХУ; ВИД СЛЕВА; щель 250×40; щель 250

## СПЕЦИФИКАЦИЯ

№ | Наименование | Кол. | Примечание
1 | Подстолье 500×400×18 | 1 | щель 250×40
2 | Кулачок 20 мм | 1 | x=−50
3 | Подвес подшипника | 2 | x=−75/−25
4 | Подшипник 6202-2RS | 2 | 35×15×11; втулка 15/12
5 | Вал-шпилька M12 | 1 | Ø12 в патрон
6 | Гайка конич. + контр. | 2+2 | M12
7 | Стопорная пластина | 1 | штифт/винт
8 | Патрон дрели | 1 | покупной
9 | Шайбы-подкладки | к-т | 0,5/1/2 мм
10 | Резьбовой фиксатор | 1 | средний

Ось кулачка смещена на 50 мм от центра стола; подшипники −75/−25. Вращение принудительно против часовой; резьба правая — патрон не должен
| самоотвинчиваться.
Затяжка: большой момент + конические гайки + контрагайки + фиксатор + штифт. Щель 250×40 усилить накладками; биение кромки ≤0,05 мм.
Корпус дрели 70…300; на виде 70…295 + резерв.

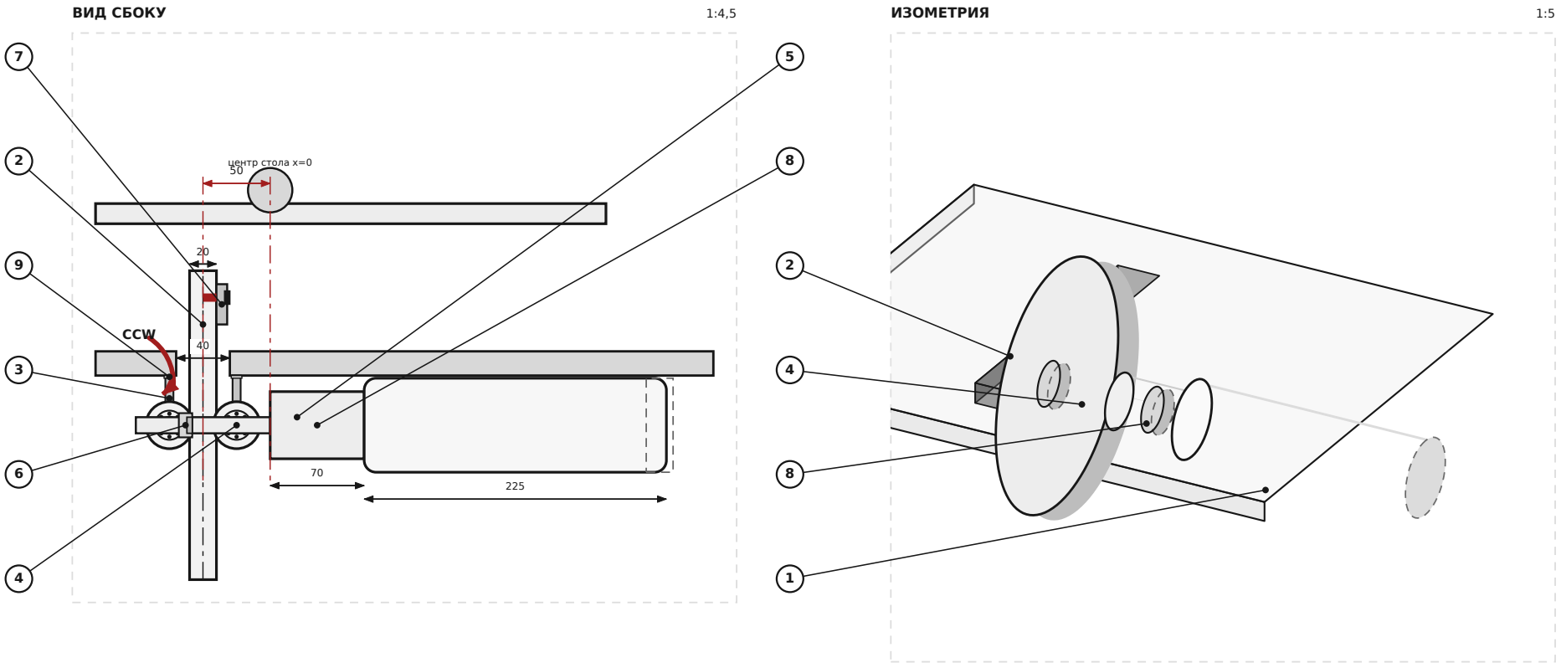
[picture p7: figure]
ВИД СБОКУ; ИЗОМЕТРИЯ; центр стола x=0; CCW

# ВИБРОСТОЛ

Этап: корректировки после экспертизы
Крепление кулачка

М 1:4,5…1:5 · размеры, мм
Лист 4 из 5
28.10.2026 · DeepSeek / OpenCode | A3 · 1:10

Корректировки после инженерной экспертизы · 28.10.2026 · лист 4 из 5

# Крепление дрели к подстолью

Два U-болта M8 под Ø80, резина 2–3 мм, упор от проворота, рычаг курка

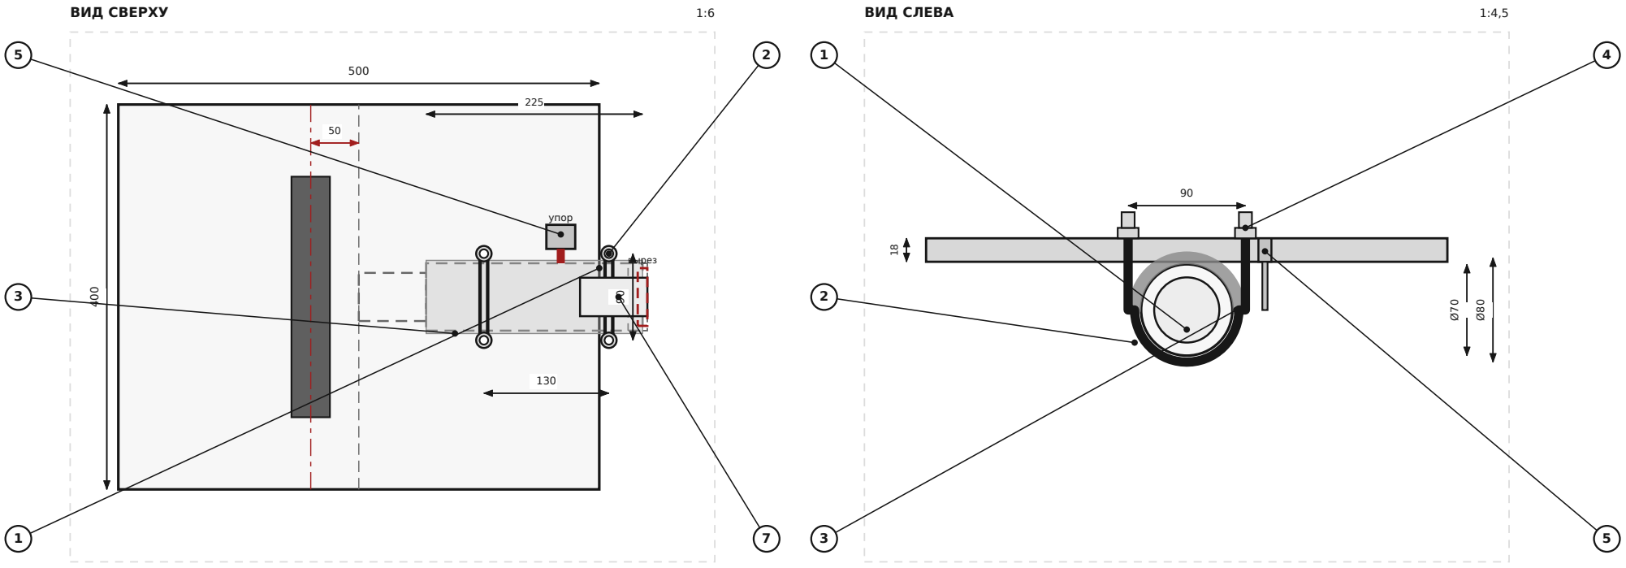
[picture p8: figure]
ВИД СВЕРХУ; ВИД СЛЕВА; упор; вырез

## СПЕЦИФИКАЦИЯ

№ | Наименование | Кол. | Примечание
1 | Дрель бытовая | 1 | покупная
2 | U-болт M8 под Ø80 | 2 | x=130/260
3 | Подкладка резиновая 2–3 | 2 | под скобу
4 | Шайба / гайка M8 | 4+4 | сталь
5 | Упор от проворота | 1 | положительный
6 | Шайбы-подкладки | к-т | 0,5/1/2 мм
7 | Рычаг курка | 1 | через вырез
8 | Ось кулачка | 1 | x=−50
9 | Подстолье | 1 | см. лист 4
| U-болты не должны перекрывать вентиляционные окна дрели. Проверить отсутствие проворота при 2-кратном моменте.

Резина 2–3 мм; шайбы/подкладки для регулировки высоты.
Рычаг курка выведен наружу через вырез в дверце.
Ось кулачка x=−50; патрон 0…70; корпус 70…295 (резерв 300).

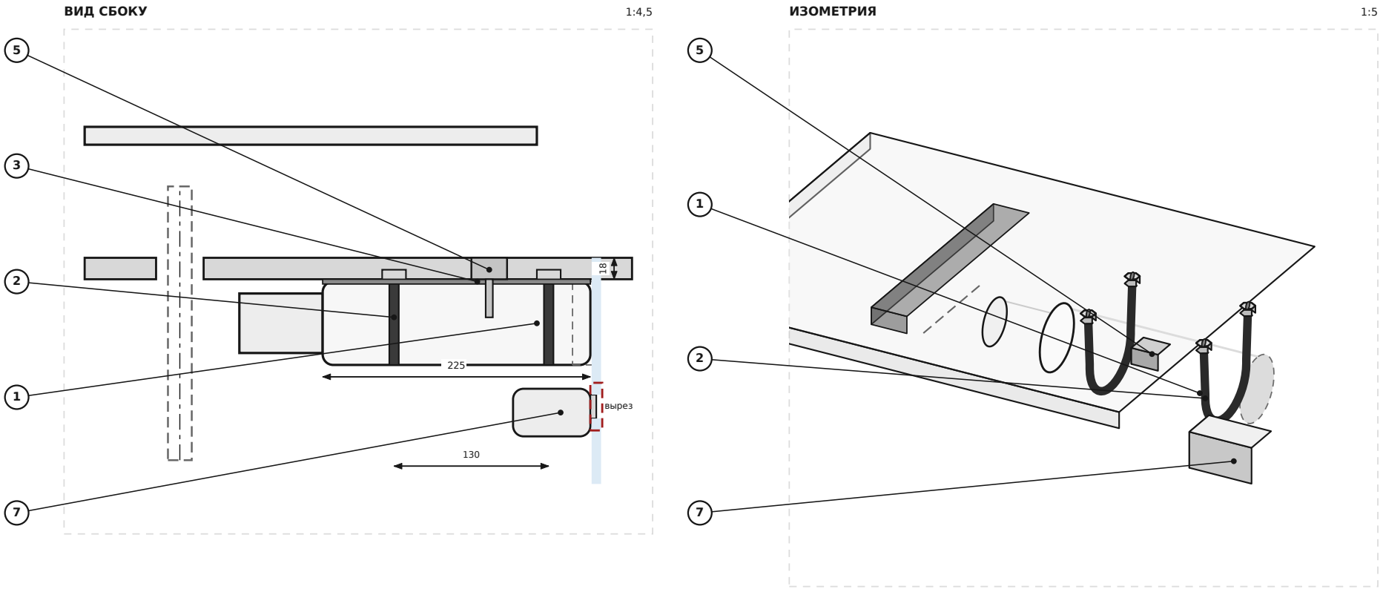
[picture p9: figure]
ВИД СБОКУ; ИЗОМЕТРИЯ; вырез

# ВИБРОСТОЛ

Этап: корректировки после экспертизы
Крепление дрели

М 1:4,5…1:6 · размеры, мм
Лист 5 из 5
28.10.2026 · DeepSeek / OpenCode | A3 · 1:10

Корректировки после инженерной экспертизы · 28.10.2026 · лист 5 из 5
