inutcin/boomboom/stages/fix10l/Report.md

# Отчёт по этапу «Первая версия орочьего вибростола»

Дата: 2026-11-02
Этап: `stages/fix10l`
База: [`stages/fix9`](../fix9/README.md)
Инструменты: FreeCAD 0.19 (`Part`, HLR), Blender (EEVEE), Python 3.10,
cairosvg.

Этап выполняет требования [`README.md`](./README.md). Полная имперская
версия (наследник fix9) остаётся без суффикса; `fix10l` — отдельная
«орочья» ветвь.

## 1. Результат

| Результат | Файлы |
|---|---|
| 3D-модель, STEP сборки | `cad/step/vibrotable_assembly.step` |
| STEP деталей | `cad/step/01_studs.step` … `cad/step/35_cartridge.step` |
| Исходники | `cad/model.py`, `params.py`, `build.py`, `draw_sheet.py`, `export_groups.py`, `render_views.py` |
| Печатные/переиспользуемые детали | `cad/stl/overlay.stl`, `cam_3/5/10.stl`; `cad/print.csv` |
| Спецификация | [`spec.csv`](./spec.csv) (38 поз.), [`params.csv`](./params.csv) |
| Отрезки труб и шпилек | [`beam_cut.csv`](./beam_cut.csv), [`fig/beams.svg`](./fig/beams.svg) |
| Проекции | [`fig/vibrotable_views.svg`](./fig/vibrotable_views.svg) |
| Механизм | [`fig/mechanism.svg`](./fig/mechanism.svg) |
| Детальные эскизы | [`fig/details.svg`](./fig/details.svg) |
| Спецификация-лист | [`fig/spec.svg`](./fig/spec.svg) |
| Изометрия | [`fig/iso.svg`](./fig/iso.svg) |
| Сборка | [`Assembly.md`](./Assembly.md), [`fig/assembly_steps.svg`](./fig/assembly_steps.svg) |
| Проверки / массы / печать | [`cad/checks.csv`](./cad/checks.csv), [`cad/mass.csv`](./cad/mass.csv), [`cad/print.csv`](./cad/print.csv) |
| Моменты | [`torque.csv`](./torque.csv) |
| Рендеры | `pic/render_*.png`; превью листов — `pic/*.png` |

## 2. Что изменено по сравнению с fix9

| Узел | fix9 | fix10l |
|---|---|---|
| Рама | сварная сталь 20×20×2, 18 отрезков | **нет**; 6 шпилек M10 |
| Стойки | 4 высокие + 2 задние трубы | 4+2 шпильки M10 |
| Направляющие стола | 4 вала Ø10 + 8 ограничителей | **шпильки M10** через Ø11 в столе |
| Линейные подшипники | 4×LMK10UU | **нет**; стол скользит по шпилькам |
| Опоры вала | 2×6200 в раме и балке 21 | **2 отверстия Ø10,2** в поперечных балках |
| Балка 21 / уголки | труба + 8 плоских уголков | **нет**; 2 поперечные балки |
| Продольные балки | нет | **2×20×20×2, L=400** |
| Стол | PLA 200×150×10 | **фанера 200×200×10** |
| Накладка | fix9 200×150×6 | **fix9 без изменений**, по центру |
| Верхняя платформа | верхние балки рамы | **фанера 200×200×10, вырез 120×120** |
| Пружины | 4×Ø17×1,5×60, L=36 | **те же**; шайбы Ø20×2; 2 полосы 200×25×5 |
| Нижний демпфер | резиновые кольца на валах | **4 резиновых кольца Ø30/12×2** |
| Кронштейн ролика | 40×40×20×2, паз, M4×16 | **2 уголка 50×50×2, ширина 20, 8 саморезов M4×12** |
| Вал привода | Ø10 L=225, 2×6200, сварная гайка | **M10 L=226, 2 опоры скольжения, приваренная гайка** |
| Подстолье | PETG 160×200×12, 4×M6×60 | **фанера 200×200×10, 2 nyloc + болт M10** |
| Основание | нижние балки рамы | **фанера 400×200×24, 6 шпилек** |
| Кожух | поликарбонат, 22 винта | **нет** (C1) |
| Масса без дрели | 9,458 кг | **6,080 кг** |
| Новые печатные детали | стол, подстолье, кожух, кулачки | **нет**; только fix9 |

## 3. Компоновка

Система координат: X — глубина 0…400 (перед → дрель), Y — ширина 0…200,
Z — высота 0…300.

| Элемент | Положение / размер |
|---|---|
| Шпильки виброотсека | 4×M10: X=30/175, Y=15/185, Z=0…300 |
| Задние шпильки | 2×M10: X=385, Y=15/185, Z=0…220 |
| Стол | фанера 200×200×10, Z=225…235; 4×Ø11 |
| Накладка fix9 | 200×150×6, X=0…200, Y=25…175, Z=235…241 |
| Подкладки пружин | 2 полосы 200×25×5, Z=235…240; 4×Ø12 |
| Пружины | 4×Ø17×1,5×60, Z=242…278 (L=36); шайбы Ø20×2 |
| Верхняя платформа | фанера 200×200×10, Z=280…290; вырез 120×120 (40…160/40…160) |
| Поперечные балки | 2×20×20×2, L=200, X=20…40 и 165…185, Z=130…150 |
| Продольные балки | 2×20×20×2, L=400, Y=15/185, Z=174…194 |
| Подстолье | фанера 200×200×10, X=200…400, Z=194…204 |
| Основание | фанера 400×200×24, Z=0…24; 6 цековок Ø22×20 |
| Вал привода | M10, X=0…226, Y=100, Z=140; 2 шайбы+гайка+jam с каждой стороны балок |
| Кулачок | fix9, X=84…106; приваренная гайка M10 94…102 |
| Ролик | 6200, X=100, Y=100, Z=205 (центр стола) |
| U-болты | 2×M6 R70, X=240/300, Y=30/170; резиновые полукольца Ø100/134 |
| Габарит | 400×200×300 |

Ключевые зазоры:

- шпилька Ø10 — отверстие стола Ø11: радиальный люфт 0,5 мм;
- стол/накладка — шайбы пружин Ø20×2: 0 мм (касание кромки); пружина OD17 — 1,5 мм;
- вырез платформы 120×120 — шайбы Ø20×2 у шпилек: 5 мм;
- нижний демпфер — стол: 11 мм; при ходе 10 мм остаётся 1 мм;
- патрон дрели (X=206) — задняя балка (до X=185): 21 мм;
- корпус дрели Ø100 — продольные балки Y=15/185: 35 мм по Y;
- рукоятка дрели (до X=381) — задние шпильки X=385: 4 мм;
- U-болт R70 — дрель Ø100: 17 мм, заполняется резиновым полукольцом.

## 4. Проверки

[`cad/checks.csv`](./cad/checks.csv): **75 проверок, 72 OK, 3 предупреждения**.

| Проверка | Значение | Норма | Статус |
|---|---|---|---|
| Габарит сборки | 400×200×300 | 400×200×300 | OK |
| Шпильки | 6×M10; 4×300 + 2×220 | 6 | OK |
| Стол | 200×200×10; 4×Ø11 | 200×200×10 | OK |
| Накладка | 200×150×6; без отверстий под шпильки | fix9 | OK |
| Платформа / вырез | 200×200×10 / 120×120 | 120×120 | OK |
| Основание | 400×200×24; 6×Ø11 + Ø22×20 | 400×200×24 | OK |
| Подстолье | 200×200×10 | 200×200×10 | OK |
| Балки | 2×L400 + 2×L200, 20×20×2 | 2+2 | OK |
| Вал / опоры | M10 L=226; 2×Ø10,2; 4 стопки | 2 | OK |
| Пружины | 4×Ø17×1,5×60, L=36; 143,7 Н | L=36 | OK |
| Демпфер | 4×Ø30/12×2; зазор 11 | ≥10 | OK |
| Шайбы пружин | 8×Ø20/10,5×2 | 8 | OK |
| Подкладки пружин | 2×200×25×5; 6 саморезов | 2 | OK |
| Платформа — зазор до шайб | 5 мм | ≥5 | OK |
| Кронштейн | 2 уголка 50×50×2; 8 саморезов | 2 | OK |
| Ролик / ось | 6200 + M10 L=44 | Ø10 | OK |
| Ролик — центр стола | X=100 / 200 | 100 | OK |
| Накладка — крепление | 4×M4×12 саморез | 4 | OK |
| Подстолье — крепление | 2 nyloc; 0 jam | 2 | OK |
| Nyloc — низ станины | 6 | 6 | OK |
| Nyloc — верх подстолья | 2 | 2 | OK |
| Nyloc — верх платформы | 4 | 4 | OK |
| Nyloc — ось ролика | 2 | 2 | OK |
| Nyloc — болт подстолья | 1 | 1 | OK |
| Болт подстолья | M10×50 + nyloc | 1 | OK |
| Контрагайки — шпильки | 26 | 26 | OK |
| Контрагайки — вал | 4 | 4 | OK |
| Вал — вылет за балку | 20 мм | 20 | OK |
| Вал — стопки | 4 стопки | 4 | OK |
| Пересечения (все пары) | 0,000 мм³ / 0 пар | <0,5 | OK |
| Стол, ход 3/5/10 | 0,000 мм³; контакт 0,0000 мм | <0,05 | OK |
| Кронштейн — кулачок | 0,000 мм³ | <0,5 | OK |
| Дрель — подстолье | 0,000 мм³ (касание) | <0,5 | OK |
| Масса без дрели | 6,080 кг | — | OK |
| Движущаяся масса | 685 г | — | OK |
| f_соб стола | ≈14,9 Гц | вне 5…15 или демпфер | **ВНИМАНИЕ** |
| Ограждение | нет | C1 | **ВНИМАНИЕ** |
| Привод дрель-вал | патрон + шпилька | C2 | **ВНИМАНИЕ** |

Три предупреждения — осознанные:

1. **f_соб ≈14,9 Гц** — движущаяся масса 685 г (легче fix9), частота на
   верхней границе 5…15 Гц. Нужен демпфер/испытания; при необходимости —
   добавить массу или изменить пружины.
2. **C1 — нет ограждения.** Вращающийся кулачок, ролик и пружины открыты;
   для реальной работы установить кожух/щиток и аварийный останов.
3. **C2 — привод «дрель–вал».** Прямая шпилька в патроне, без муфты;
   биение и соосность проверять при сборке.

Дополнительно проверено: все 75 строк; 0 пересечений среди 40 деталей;
ход стола вниз 3/5/10 на всех кулачках; контакт ролика `distToShape = 0`;
кулачок не задевает кронштейн; накладка и кулачки совпадают с fix9 по
объёму.

## 5. Масса

| Материал / узел | Масса, г |
|---|---:|
| Сталь (шпильки, балки, крепёж, вал, уголки, U-болты) | 3803,6 |
| Фанера (стол, платформа, основание, подстолье, подкладки) | 1776,8 |
| PLA (накладка fix9 + кулачок) | 306,1 |
| Резина (демпферы + подкладки дрели) | 149,2 |
| Подшипник 6200 | 44,3 |
| **ИТОГО без дрели** | **6079,8** |

Движущаяся масса (стол + накладка + подкладки + кронштейны + ролик +
крепёж + половина нижних пружинных шайб + треть пружин) — **685 г**.
Дрель в массу не входит; её масса ориентировочно 1,5…2 кг.

## 6. Переиспользование и противоречия

- **Накладка fix9**: импортирована из `fix9/cad/step/04_overlay.step`,
  сдвинута на +20 по X; объём **161 413 мм³**, габарит 200×150×6; без
  изменений. Отверстий под шпильки нет — шпильки вынесены на стол.
- **Кулачки fix9**: `10_cam_3/5/10.step`; объём cam_5 **85 378 мм³**;
  R45…50, ход 3/5/10; без изменений.
- **Эскиз пользователя** показывает `Rmin=55`, `Rmax=60` (Ø120). Это
  противоречит требованию переиспользовать диски fix9; принят fix9
  R45/50. Новые диски Ø120 — отдельный этап.
- **Вырез 120×120** несовместим с накладкой 150 мм и шпильками,
  проходящими через неё. Принято: стол 200×200, накладка 200×150 по
  центру, шпильки Y=15/185, пружины на столе. Это отличается от буквального
  «отверстия в накладке и столе», но сохраняет накладку и вырез.
- **Нижняя пружина** заменена резиновыми кольцами: иначе она уменьшала бы
  прижим ролика.
- **Две опоры вала** вместо одной — добавлена вторая поперечная балка;
  это улучшает жёсткость, но отличается от единственного числа в README.
- **Болт M10 / гайка M4.** В ТЗ указана гайка M4 при болте M10 —
  несовместимо. Принят **M10 nyloc** по болту; при необходимости M4 —
  заменить болт на M4×40 и гайку на M4 nyloc.
- **Заглушки торцов труб** убраны по решению пользователя; торцы открыты.
- **Контрагайки h=8** вместо тонких h=4: основание 24 мм (цековки Ø22×20),
  балки Z=174…194, подстолье Z=194…204, демпферы Ø30/12×2 (Z=212…214).
- **Кожух** отсутствует (C1); в «орочьей» версии не входил.

## 7. Остатки expert2 / expert3

Не входили в этап и остаются:

- **C1** — ограждение/аварийный останов;
- **C2** — привод «дрель–вал» (патрон, хвостовик, муфта, осевой упор);
- **C3** — осевая/радиальная фиксация кулачка (сейчас приваренная гайка
  и гайки; проверить);
- **C4** — юстировка параллельности шпилек (сверление по кондуктору,
  регулировка гайками);
- **C5** — износ вала в отверстиях Ø10,2 (заменить балки/втулки при люфте);
- **C6** — определение «амплитуды» (принят размах) и карта режимов;
- **C7** — пружины: паспорт/испытания 4×Ø17×1,5×60;
- **C8** — гармонический профиль кулачка (фактический 2-лепестковый);
- **I1–I23**, **W1–W8**, **S3**, **S5**, **S6** — по отчётам expert2/expert3.

## 8. Ограничения

- Расчёт прочности шпилек, балок, уголков и саморезов — только геометрия и
  масса; FEA, усталости и 10^6 циклов нет.
- Вал M10 в стальных отверстиях Ø10,2 — пара трения скольжения; ресурс не
  проверен; смазка обязательна, при износе — заменить балки/втулки.
- Саморезы M4 в фанере и 2-мм полке — слабые соединения; при ослаблении
  заменить на болты с гайками/заклёпочные гайки.
- Реальные k/L0/ID пружин, материал и термообработка не измерены.
- Динамика с шариком, удар, податливость фанеры/PLA, шум и резонанс не
  моделировались.
- Масса — по объёмам и плотностям; реальные шпильки/крепёж могут дать
  отклонение.
- Дрель — условная модель Ø100; реальная геометрия и биение другие.
- Остатки C1–C8, I1–I23, W1–W8, S3, S5, S6 — вне этапа.

## 9. Воспроизведение

```bash
cd stages/fix10l/cad
freecadcmd build.py
rm -f cache/views_v10l.json          # если нужно пересобрать проекции
freecadcmd draw_sheet.py
freecadcmd export_groups.py
blender -b --python render_views.py
cd ..
python3 - <<'PY'
import cairosvg
for n in ("vibrotable_views", "mechanism", "details", "beams",
          "assembly_steps", "iso", "spec"):
    cairosvg.svg2png(url=f"fig/{n}.svg", write_to=f"pic/{n}.png", dpi=110)
PY
```

`freecadcmd` не принимает `--force` как аргумент скрипта; для сброса кэша
удалить `cad/cache/views_v10l.json`.

## 10. Стоимость генерации

Модель `deepseek/deepseek-flash` (variant high): вход $0,15/млн,
чтение кэша $0,003/млн, выход (включая reasoning) $0,60/млн. Учёт — `session_v2`
OpenCode, сессия `ses_e6317626fffeD3GsznhZYKIx4E`; снимок на 2026-11-02
после сборки, проверок и рендеров. Финальный ответ может добавить
~$0,002…0,005.

| Категория | Токены | Стоимость, USD |
|---|---:|---:|
| **Всего** | **150 590 617** | **0,91154** |
| Входящие мимо кэша | 795 336 | 0,11930 |
| Закешированные входящие | 149 220 992 | 0,44766 |
| Исходящие (output) | 162 256 | 0,09735 |
| Исходящие (reasoning) | 412 033 | 0,24722 |
| **Исходящие всего (output + reasoning)** | **574 289** | **0,34457** |

Стоимость fix9 и expert3 — в их отчётах; здесь учтён только этап fix10l.
