inutcin/boomboom/stages/fix9/Report.md

# Отчёт по этапу «Вторая корректировка после третьей инженерной экспертизы»

Дата: 2026-11-02
Этап: `stages/fix9`
База: [`stages/fix8`](../fix8/README.md)
Инструменты: FreeCAD 0.19 (`Part`, HLR), Blender 3.0.1 (EEVEE),
Python 3.10, cairosvg.

Этап выполняет **только 7 замечаний** [`README.md`](./README.md). Остальные
замечания expert2/expert3 в этап не входят; они перечислены в разделе 7.

## 1. Результат

| Результат | Файлы |
|---|---|
| 3D-модель, STEP сборки | `cad/step/vibrotable_assembly.step` |
| STEP деталей и отрезков | `cad/step/22_T01…T18.step`, `22_frame.step`, `35_cartridge.step`, остальные `*.step` |
| Исходники | `cad/model.py`, `params.py`, `build.py`, `draw_sheet.py`, `export_groups.py`, `render_views.py` |
| Печатные детали | `cad/stl/table.stl`, `overlay.stl`, `podstol.stl`, `cam_3/5/10.stl`; `cad/print.csv` |
| Спецификация | [`spec.csv`](./spec.csv) (45 поз.), [`params.csv`](./params.csv) |
| Деталировка труб и сварка | [`fig/frame_tubes.svg`](./fig/frame_tubes.svg), [`tube_cut.csv`](./tube_cut.csv) |
| Эскизы деталей | [`fig/details.svg`](./fig/details.svg), [`fig/cam.svg`](./fig/cam.svg), [`fig/vibrotable_shield.svg`](./fig/vibrotable_shield.svg) |
| Проекции / изометрия | [`fig/vibrotable_views.svg`](./fig/vibrotable_views.svg), [`fig/iso.svg`](./fig/iso.svg), [`fig/iso_open.svg`](./fig/iso_open.svg) |
| Инструкция по сборке | [`Assembly.md`](./Assembly.md), [`fig/assembly_steps.svg`](./fig/assembly_steps.svg), [`torque.csv`](./torque.csv) |
| Проверки / массы | [`cad/checks.csv`](./cad/checks.csv) (180: 177 OK, 3 предупреждения), [`cad/mass.csv`](./cad/mass.csv) |
| Рендеры | `pic/render_*.png` (новые, Blender EEVEE); превью листов — `pic/*.png` |

## 2. Что изменено

| Узел | fix8 | fix9 |
|---|---|---|
| Рама | PETG, печать одним куском, 26 галтелей | **сварная сталь 20×20×2**, 18 отрезков, все резы 90° |
| Балка 21 | PETG 20×20 сплошная | **стальная труба 20×20×2**, L=159,6; прорезь R15×5 |
| Седла 6200 | карманы R15×5 в PETG | **прорези R15×5 в стенке трубы 2 мм**, без вкладышей |
| Уголки | 2 мм, 20 мм, M4 | **плоские 2 мм, ширина 25, 80×80; M6×40**, 8 шт. |
| LMK | M4×16, Ø4,2 | **M4×12**, цековка фланца Ø7,2×4,2; гайка в столе 7,2×5 |
| Кожух | 22 самореза M4×16 | **22 винта M4×10** с головкой Ø7×4; резьба в раме 2 мм |
| Подстолье | M6×45, обычная головка | **M6×60 потайной**, гайки M6 приварены снизу балок |
| Кронштейн ролика | потайной M4, паз 10×4,5 | **M4×16, головка Ø7×4**, углубление Ø8×5, паз 10×5 |
| Заглушки | не было | **6×20×20 + 4×16×16 (рама); 4×16×16 (балка)** |
| Масса без дрели | 6405,8 г | **9458,3 г** |

Геометрия стола, накладки, кулачка, вала, 6200, ролика, пружин и
подстолья (кроме крепежа) не менялась.

## 3. Рама и балка 21

### 3.1. Рама — 18 отрезков

| Элемент | Длина, мм | Кол. |
|---|---:|---:|
| Стойки высокие | 260 | 4 |
| Стойки задние | 150 | 2 |
| Нижние продольные | 360 | 2 |
| Верхние виброотсека | 160 | 2 |
| Верхние выноса | 200 | 2 |
| Нижние поперечины | 160 | 2 |
| Верхние поперечины | 160 | 2 |
| Средние поперечины | 160 | 2 |

Все резы 90°, стыки 45° не допускаются. Стойки — один кусок; верхние
балки виброотсека лежат на стойках; стойки опираются на нижние продольные
балки. Балки выноса лежат на задних коротких стойках; к средней высокой
стойке — Т-стык без разреза стойки. Приварные гайки M6 — 4 шт.;
распорные втулки 16×16×2, L=16 — 16 шт. (8 в стойках, 8 в балке).
Заглушки: 6×20×20 + 4×16×16 (рама), 4×16×16 (балка).

### 3.2. Седла 6200

По решению пользователя — **прорезь R15×5 в стенке трубы 2 мм**, без
вкладыша, в раме (T17/T18) и в балке 21. Осевой зазор 0,2 мм; ширина
прорези 9,4 мм; плечи 5,3 мм. Контакт идёт по кромке стенки 2 мм — в
проверках предупреждение; после обкатки проверить смятие/люфт. При
появлении люфта — отдельным этапом добавить накладку/вкладыш.

### 3.3. Балка 21

Стальная труба 20×20×2, L=159,6, 2 шт.; прорезь-седло R15×5 в верхней
стенке; 4×Ø6,6 под M6 (Y=30/60/140/170, Z=120); 4 втулки 16×16×2 L=16
на балку; 4 заглушки 16×16.

## 4. Крепёж по замечаниям

### 4.1. LMK10UU — замечание 1

- 16 отверстий Ø5 в столе; 16 шестигранных углублений 7,2 AF×5 под гайки
  M4 nyloc; гайки на клей, заподлицо.
- Цековка фланца LMK 4×Ø7,2×4,2 снизу; остаток фланца 1,8 мм.
- Винт **M4×12** (резьбовая часть 12 мм; по решению пользователя вместо
  10 мм); головка Ø7×4 в цековке; зацепление гайки 5 мм.
- Проверка: головка не выступает, гайка не выступает, LMK вращается.

### 4.2. Кожух — замечание 2

22 винта **M4×10** с цилиндрической головкой Ø7×4; без гаек; резьба M4
в стенке рамы 2 мм. Резьба в стенке 2 мм — предупреждение; в сборке
фиксатор резьбы. Габарит по Y — 218 мм (головки).

### 4.3. Подстолье — замечание 3

4 потайных **M6×60**; зенковка Ø12/90° в подстолье; гайки M6 приварены
снизу верхних балок выноса; выступание винта ниже гайки ≈22 мм (info).

### 4.4. Кронштейн ролика — замечание 4

Винт **M4×16** с головкой Ø7×4; сверху стола углубление Ø8×5; отверстие
Ø5; в кронштейне паз 10×5; гайка M4 nyloc снизу.

### 4.5. Уголки — замечание 5

- 8 плоских уголков, сталь **2 мм**, 80×80, ширина **25 мм**;
- наружная кромка по Y вровень с рамой (Y=0/200), внутрь +5 мм;
- пазы 2×26,6×6,6 с концами R3 на средней оси стойки Y=10/190,
  смещены на 2,5 мм от центра 25-мм лепестка; отверстия в стойке
  Ø6,6, Y=10/190, Z=59/94: верхнее 104→94 (−10), нижнее 74→59
  (−15), шаг 30→35; верхний паз заходит в горизонтальную полку на
  7,3 мм вместо 17,3;
- 8 болтов M6×40 к балке + 8 к стойке; гайки nyloc, шайбы
  Ø18/Ø6,4×1,6 с двух сторон;
- втулки 16×16×2, L=16 в стойках и балке; ход балки 20 мм;
- вырез под стойку в горизонтальной полке убран: полка идёт от
  Y=0/200; верхний паз проходит и через горизонтальную полку над
  стойкой (следствие удаления выреза); болты балки Y=30/60 вне паза.

### 4.6. Заглушки — замечание 7

6 заглушек 20×20×6 и 4 заглушки 16×16×4 в раме (верхние торцы
виброотсека — внутренние, под кожухом); 4 заглушки 16×16×5 в торцы
балки 21.

## 5. Проверки

[`cad/checks.csv`](./cad/checks.csv): **180 проверок, 177 OK,
3 предупреждения**.

| Проверка | Значение | Норма | Статус |
|---|---|---|---|
| Рама — число отрезков / сечение | 18 / 20×20×2 | 18 / 20×20×2 | OK |
| Рама — габарит | 360×200×300 | 360×200×300 | OK |
| Стойки / верхние балки | одним куском; на стойках | — | OK |
| Рама — седла 6200 | 2 × прорезь R15×5 в стенке 2 мм | R15×5 | **ВНИМАНИЕ** |
| LMK — цековка / винт / гайка | Ø7,2×4,2 / M4×12 / 7,2×5 | — | OK |
| Балка 21 — материал / прорезь | сталь 20×20×2 / R15×5 | — | OK |
| Уголки — толщина / ширина / ход | 2 / 25 / 20 | 2 / 25 / 20 | OK |
| Уголки — полки / пазы | 80×80 / 2×26,6×6,6 R3 | 80×80 | OK |
| Уголки — болты | 8 + 8 M6×40 | 8 + 8 | OK |
| Подстолье — винты | 4 × M6×60 | 4 | OK |
| Кожух — винты / резьба | 22 × M4×10 / 2 мм | 22 / ≥2 | **ВНИМАНИЕ** |
| f_соб стола | 12,8 Гц | вне 5…15 или демпфер | **ВНИМАНИЕ** |
| Габарит сборки | 382×218×308 | 382×218×308 | OK |
| Масса без дрели | 9,46 кг | — | OK |
| Масса рамы | 4,30 кг | ≈4,4 | OK |
| Пересечения (все пары) | 0,000 мм³ | <0,5 | OK |
| Ходы стола ±5 / кулачки 3/5/10 | 0,000 мм³ | <0,5 | OK |
| Балка 21 вниз 15 / картридж 44 | 0,000 мм³ | <0,5 | OK |

Три предупреждения — осознанные:

1. **Седло 6200 в стенке 2 мм** — контакт по кромке; проверить после
   обкатки.
2. **f_соб 12,8 Гц** внутри 5…15 Гц — S3 expert3 остаётся; резиновые
   кольца — существующий демпфер.
3. **Резьба M4 в стенке 2 мм** под кожух — слабая, но нагрузка мала;
   фиксатор резьбы, при ослаблении — бобышки/заклёпочные гайки.

Предупреждение «Рама — винты кожуха» снято: пересечение резьбы не
считается столкновением; в модели отверстие Ø4,5, резьба M4 не
моделируется.

## 6. Масса

| Узел | Масса, г |
|---|---:|
| Рама (18 труб + втулки/гайки) | 4302,0 |
| Балка 21 + втулки + заглушки | 463,9 |
| Уголки + крепёж (болты/гайки/шайбы) | 700,2 |
| Стол / накладка | 559,5 |
| Подстолье + винты | 540,2 |
| Валы / ограничители / пружины | 764,7 |
| LMK / 6200 / ролик | 579,4 |
| Кулачок / вал / ось / гайки / кронштейн | 498,8 |
| Кожух / винты | 747,7 |
| Остальное (заглушки рамы, U-хомуты, винты LMK/накладки/кронштейнов, буферы, кольца) | 302,2 |
| **ИТОГО без дрели** | **9458,3** |

Сумма строк 9458,6 г из-за округления; итог по модели — 9458,3 г.

Движущаяся масса (стол + накладка + LMK + кронштейны + ролик + пружины +
шарик) ≈0,92 кг; 4k=5,989 Н/мм; f_соб≈12,8 Гц. Масса рамы выросла с
1,885 кг (PETG) до 4,30 кг; общая — с 6,406 до 9,458 кг. Станина и
струбцины должны держать ≈9,3 кг.

## 7. Остатки expert2 / expert3

В этап **не входили** и остаются:

- **C1** — ограждение/аварийный останов (кожух не замкнут, E-stop нет);
- **C2** — привод «дрель–вал» (патрон, хвостовик, муфта, осевой упор);
- **C3** — осевая/радиальная фиксация кулачка (PLA-буртик, шпонка/втулка);
- **C4** — юстировка параллельности валов (сверление по кондуктору
  улучшает, но регулировки нет);
- **C5** — балка 21: теперь стальная труба, но седло/кромка 2 мм и
  крепление уголками требуют испытаний;
- **C6** — определение «амплитуды» (принят размах) и карта режимов;
- **C7** — пружины: fix8 выбрал 4×Ø17×1,5×60; паспорт/испытания нужны;
- **C8** — гармонический профиль кулачка (фактический 2-лепестковый);
- **I1–I23** — смена диска, шпилька, PETG-карманы (частично снято),
  точность, шарик, дрель, крепление к станине, массы, моменты и т.д.;
- **W1–W8** — пожелания (модульность, привод с обратной связью, демпфер,
  протокол эксперимента);
- **S3** — f_соб 12,8 Гц внутри 5…15 Гц; демпфер/испытания;
- **S5** — фактический 2-лепестковый профиль маскирует запас пружины;
- **S6** — регулировка преднатяга и паспорт пружины.

## 8. Ограничения

- Расчёт прочности рамы/сварки — только проверки геометрии и массы; FEA,
  усталости и испытаний 10^6 циклов нет.
- Седло 6200 в стенке 2 мм — принятое решение, но не проверено на
  смятие/износ; риск отмечен.
- Резьба M4 в стенке 2 мм — слабая; для кожуха принята.
- Реальные k/L0/ID пружины, материал и термообработка не измерены.
- Динамика с шариком, удар, податливость PLA, шум и резонанс рамы не
  моделировались.
- Масса — по объёмам модели и плотностям; реальные LMK/6200/крепёж могут
  дать отклонение.
- Остатки C1–C8, I1–I23, W1–W8, S3, S5, S6 — вне этапа.

## 9. Воспроизведение

```bash
cd stages/fix9/cad
freecadcmd build.py          # STEP, STL, spec, params, tube_cut, checks,
                             # mass, print, torque
freecadcmd draw_sheet.py     # fig/*.svg (кэш cache/views_v9.json)
freecadcmd export_groups.py  # stl/groups/*.stl
blender -b --python render_views.py
cd ..
python3 - <<'PY'
import cairosvg
for n in ("vibrotable_views", "vibrotable_spec", "iso", "iso_open",
          "frame_tubes", "details", "assembly_steps", "cam",
          "vibrotable_shield"):
    cairosvg.svg2png(url=f"fig/{n}.svg", write_to=f"pic/{n}.png", dpi=110)
PY
```

Если нужно пересобрать проекции: удалить `cad/cache/views_v9.json`.

## 10. Стоимость генерации

Модель `deepseek/deepseek-flash` (variant high): вход $0,15/млн, чтение
кэша $0,003/млн, выход (включая reasoning) $0,60/млн. Учёт — `session_v2`
OpenCode, сессия `ses_e6527d936ffeC4Y1EZClrlzZd8`; снимок на 2026-11-02
после сборки. Финальный ответ может добавить ~$0,002…0,005.

| Категория | Токены | Стоимость, USD |
|---|---:|---:|
| **Всего** | **93 632 875** | **0,62201** |
| Входящие мимо кэша | 556 135 | 0,08342 |
| Закешированные входящие | 92 642 304 | 0,27793 |
| Исходящие (output) | 122 746 | 0,07365 |
| Исходящие (reasoning) | 311 690 | 0,18701 |
| **Исходящие всего (output + reasoning)** | **434 436** | **0,26066** |

Стоимость fix8 и expert3 — в их отчётах; здесь учтён только этап fix9.
