inutcin/boomboom/stages/fix8/Report.md

# Отчёт по этапу «Первая корректировка после третьей инженерной экспертизы»

Дата: 2026-10-30
Этап: `stages/fix8`
База: [`stages/fix7`](../fix7/README.md)
Инструменты: FreeCAD 0.19 (`Part`, `Drawing`/HLR), Blender 3.0.1 (EEVEE),
Python 3.10, cairosvg.

Этап выполнен по выбранной в третьей экспертизе оптимальной пружине для
**размаха (peak-to-peak)** 3/5/10 мм. Остальные замечания expert2/expert3 не
выполнялись.

## 1. Результат

| Результат | Файлы |
|---|---|
| 3D-модель, STEP сборки | `cad/step/vibrotable_assembly.step` |
| Блок кулачка | `cad/step/35_cartridge.step` |
| STEP деталей | `cad/step/*.step` |
| Исходники | `cad/model.py`, `cad/params.py`, `cad/build.py` |
| Печатные детали | `cad/stl/frame.stl`, `table.stl`, `overlay.stl`, `podstol.stl`, `retainer.stl`, `cam_3/5/10.stl` |
| Параметры печати | `cad/print.csv` |
| Эскиз в 3 проекциях | `fig/vibrotable_views.svg` (лист 1/2) |
| Спецификация и параметры | `fig/vibrotable_spec.svg` (лист 2/2), `spec.csv` (36 поз.), `params.csv` |
| Изометрия (HLR) | `fig/iso.svg`, `fig/iso_open.svg` |
| Проверки / массы | `cad/checks.csv` (241: 240 OK, 1 предупреждение), `cad/mass.csv` |
| Рендеры | `pic/render_*.png` (17 шт., Blender EEVEE) |
| Превью | `pic/vibrotable_views.png`, `vibrotable_spec.png`, `iso.png`, `iso_open.png` |

## 2. Что изменено

| Параметр | fix7 | fix8 |
|---|---:|---:|
| Пружина | 4×Ø12×1,0 | **4×Ø17×1,5** |
| Свободная длина L0 | 70 мм | **60 мм** |
| Активных витков | 11 | **9** |
| Полных витков | 13 | **11** |
| Установленная длина | 36 мм | 36 мм |
| Сжатие | 34 мм | **24 мм** |
| Жёсткость k | 0,677 Н/мм | **1,497 Н/мм** |
| 4k | 2,708 Н/мм | **5,989 Н/мм** |
| Преднатяг | 92,1 Н | **143,7 Н** |
| Сила внизу (L=46) | 65,0 Н | **83,9 Н** |
| Контакт 15/10 | 60,3 Н (1,48×) | **111,8 Н (2,72×)** |
| τ верх / низ | 729 / 515 МПа | **479 / 279 МПа** |
| f_соб | 8,64 Гц | **12,81 Гц** |
| Масса пружин на 4 | 9,5 г | **24,6 г** |
| Масса без дрели | 6390,8 г | **6405,8 г** |

Геометрия рамы, стола, кулачка, вала и крепежа не менялась. Шайбы пружин —
существующие Ø18/Ø10,5×1,5: ID пружины 14,0 надевается на вал Ø10, OD 17 не
соскальзывает с шайбы Ø18.

## 3. Проверки

[`cad/checks.csv`](./cad/checks.csv): **241 проверка, 240 OK,
1 предупреждение**. Изменённые строки:

| Проверка | Значение | Норма | Статус |
|---|---|---|---|
| Пружина свободная L0 | 60 мм | 60 | OK |
| Пружина установленная (верх) | 36 мм | ≤L0 (60) | OK |
| Пружина при верхнем/нижнем | 36…46 мм | ≤60 | OK |
| Пружина ID — вал Ø10 | 4,0 мм | ≥0,3 | OK |
| Стенка кулачка на минимуме (10 мм) | 3,0 мм | ≥3 (принято) | ВНИМАНИЕ |

Предупреждение осталось только по стенке 3 мм у отверстия R32 на минимуме
диска 10; прежнее предупреждение «пружина ID 10,0 при вале Ø10» снято.

## 4. Пружина и контакт

Выбранная пружина — из [`../expert3/optimum.md`](../expert3/optimum.md):

| Параметр | Значение |
|---|---:|
| k / 4k | 1,497 / 5,989 Н/мм |
| Преднатяг / внизу | 143,7 / 83,9 Н |
| Контакт 15 Гц/10 мм (верх/низ) | 111,8 / 134,0 Н |
| Запас 15 Гц/10 мм | 2,72× |
| τ верх / низ / твёрдое | 479 / 279 / 868 МПа |
| f_соб | 12,81 Гц |
| Твёрдая длина / запас | 16,5 / 19,5 мм |

Таблица 3 × 3 для размаха 3/5/10 мм (сила контакта / запас):

| Частота \ Размах | 3 мм | 5 мм | 10 мм |
|---|---:|---:|---:|
| 5 Гц | 151,4 / 110,7× | 150,5 / 66,0× | 148,2 / 32,5× |
| 10 Гц | 147,3 / 26,9× | 143,7 / 15,8× | 134,6 / 7,38× |
| 15 Гц | 140,5 / 11,4× | 132,3 / 6,45× | 111,8 / 2,72× |

Все 9 режимов ≥2,72×. f_соб=12,81 Гц внутри 5…15 Гц (около 12,8); для
качественного удержания на 10…13 Гц нужен демпфер — это ограничение
сохраняется.

## 5. Визуальные проверки

- `pic/render_iso.png`, `render_front.png`, `render_left.png`,
  `render_top.png`, `render_mechanism.png` — новая пружина Ø17×1,5, 9 витков;
- `pic/render_bearing_1/2/2_left/clamp.png` — осевые зажимы 6200 (без
  изменений);
- `fig/vibrotable_views.svg`, `fig/vibrotable_spec.svg` — проекции и
  спецификация с L0=60;
- `pic/vibrotable_views.png`, `vibrotable_spec.png` — превью листов.

## 6. Ограничения

- Выполнена только замена пружин; C1–C8, I1–I23, W1–W8 expert2 и S1–S6
  expert3 (кроме выбора пружины) не выполнялись.
- Расчёт контакта — квазистатический, без удара шарика/динамики рамы;
  напряжения — по Wahl, допускаемое 500…700 МПа — ориентировочное.
- Пружина покупная; в модели показана установленная (36 мм), свободная 60 мм
  задана в спецификации/расчёте. Реальные k/L0/ID нужно проверить.
- Для нуль-пик 3/5/10 мм (размах 6/10/20) этот вариант не подходит; см.
  [`../expert3/optim-pick-pick.md`](../expert3/optim-pick-pick.md).
- Остаётся предупреждение по стенке 3 мм у R32 на диске 10.

## 7. Воспроизведение

```bash
cd stages/fix8/cad
freecadcmd build.py
freecadcmd draw_sheet.py
freecadcmd export_groups.py
blender -b --python render_views.py
cd ..
python3 - <<'PY'
import cairosvg
for n in ("vibrotable_views", "vibrotable_spec", "iso", "iso_open"):
    cairosvg.svg2png(url=f"fig/{n}.svg", write_to=f"pic/{n}.png", dpi=110)
PY
```

## 8. Стоимость генерации

Модель `deepseek/deepseek-flash` (variant high): вход $0,15/млн, чтение кэша
$0,003/млн, выход (включая reasoning) $0,60/млн.

| Категория | Токены | Стоимость, USD |
|---|---:|---:|
| **Всего** | **14 896 558** | **0,05682** |
| Входящие мимо кэша | 13 518 | 0,00203 |
| Закешированные входящие | 14 866 048 | 0,04460 |
| Исходящие (включая reasoning) | 16 992 | 0,01020 |

Исходящие = 9 770 (output) + 7 222 (reasoning). Стоимость fix7 и expert3 — в
их отчётах; финальный ответ может добавить ~$0,002…0,005.
