inutcin/boomboom/stages/fix6/Report.md

# Отчёт по этапу «Третья корректировка после инженерной экспертизы»

Дата: 2026-10-30
Этап: `stages/fix6`
База: [`stages/fix5`](../fix5/README.md)
Инструменты: FreeCAD 0.19 (`Part`, `Drawing`/HLR), Blender 3.0.1 (EEVEE),
Python 3.10, cairosvg.

Этап выполнен по единственному замечанию [`README.md`](./README.md). Вопросы
и решения — [`Interview.md`](./Interview.md).

## 1. Результат

| Результат | Файлы |
|---|---|
| 3D-модель, STEP сборки | `cad/step/vibrotable_assembly.step` |
| Блок кулачка | `cad/step/35_cartridge.step` |
| STEP деталей | `cad/step/*.step` (в т.ч. `16_shaft_locknuts`, `17_shaft_conical_nuts`, `20_drive_shaft`) |
| Исходники | `cad/model.py`, `cad/params.py`, `cad/build.py` |
| Печатные детали | `cad/stl/frame.stl`, `table.stl`, `overlay.stl`, `podstol.stl`, `retainer.stl`, `cam_3/5/10.stl` |
| Параметры печати | `cad/print.csv` |
| Эскиз в 3 проекциях | `fig/vibrotable_views.svg` (лист 1/2) |
| Спецификация и параметры | `fig/vibrotable_spec.svg` (лист 2/2), `spec.csv` (36 поз.), `params.csv` (237) |
| Изометрия (HLR) | `fig/iso.svg`, `fig/iso_open.svg` |
| Проверки / массы | `cad/checks.csv` (240), `cad/mass.csv` |
| Рендеры | `pic/render_*.png` (17 шт., включая 4 новых вида зажима 6200) |
| Превью | `pic/vibrotable_views.png`, `vibrotable_spec.png`, `iso.png`, `iso_open.png` |

## 2. Замечание и что сделано

**Замечание.** «Оба подшипника подвески основного вала привода должны
поджиматься с боков коническими [гайками], которые должны контриться гайками
M10».

**Что было в fix5.** Оба 6200 (X=10 и X=150) формально имели по 2 конуса и
по 2 контргайки, но при переносе 6200 №2 с X=190 на X=150 (fix3) левая
контргайка осталась на смещении старой схемы:

| Деталь 6200 №2 | fix5 | fix6 |
|---|---|---|
| левый конус | 140…145,5 | 140…145,5 |
| левая контргайка | **137,5…145,5** (поверх конуса) | **132…140** (снаружи конуса) |
| 6200 | 145,5…154,5 | 145,5…154,5 |
| правый конус | 154,5…160 | 154,5…160 |
| правая контргайка | 160…168 | 160…168 |

Пересечение «конус — контргайка» в fix5 — **403 мм³**. Слева у 6200 №2
контргайки фактически не было: гайка сидела на конусе и не могла его
контрить. Это и есть регрессия, которую фиксирует замечание.

**Что сделано.** Осевой стек вынесен в функцию `bearing_clamp(bx)`:
интервалы строятся от центра `bx`, ширины 6200 (9 мм), длины конуса (5,5 мм)
и ширины гайки (8 мм). Для обоих 6200:

| 6200 | гайка M10 | конус | подшипник | конус | гайка M10 |
|---|---|---|---|---|---|
| №1, X=10 | −8…0 | 0…5,5 | 5,5…14,5 | 14,5…20 | 20…28 |
| №2, X=150 | 132…140 | 140…145,5 | 145,5…154,5 | 154,5…160 | 160…168 |

Всего: **4 конуса + 4 контргайки** на опорные 6200 (поз. 17 — 6 шт. с
роликом; поз. 16 — 8 шт. с кулачком и роликом). Спецификация и остальные
детали не менялись.

## 3. Осевой зажим 6200

- Конус: **Ø12 → Ø16 × 5,5 мм**, малый торец к подшипнику. Конус прижимает
  **внутреннее** кольцо; наружное остаётся в кармане 9,4 мм (зазор 0,2 мм).
- Контргайка: **M10 nyloc, 17 AF, 8 мм**, стоит снаружи большого торца
  конуса вплотную. Nyloc — по требованию fix1 для гаек, работающих с
  вибрацией; в fix2 так же были выполнены опорные 6200.
- Затяжка: конус поджимается к торцу внутреннего кольца, затем снаружи
  затягивается контргайка. Вал фиксируется от осевого смещения с двух
  сторон каждого подшипника.
- Конусы и гайки **вынесены по X за 20-мм балку 21 и поперечину**:
  X=20…28, 132…140 (−8…0 и 160…168 — наружные), поэтому ключ заводится
  сбоку по Y. Модель даёт зазор 0,19 мм (правильный шестигранник 17 AF,
  e=19,63); у покупной гайки e≈18,9, реальный зазор ≈0,55 мм.
- Пересечения: конус — 6200 = 0 (касание по торцу), конус — гайка = 0,
  гайка — подшипник = 5,5 мм, гайка — балка/поперечина = 0,19/0,19 мм.

## 4. Числовые проверки

[`cad/checks.csv`](./cad/checks.csv): **240 проверок, 238 OK, 2
предупреждения**. Предупреждения прежние, к зажиму 6200 не относятся:

1. пружина 12×1,0 даёт ID 10,0 при вале Ø10 (в модели 10,2);
2. стенка 3 мм у отверстия R32 на минимуме диска 10 (принято по fix5 п. 5;
   предложение Ø8 / R30).

Новых проверок — **18** (было 222, стало 240): блок осевой фиксации
расширен с 6 до 15 проверок (+9) и добавлены 9 пар пересечений с рамой,
балкой 21, уголками, кулачком и между собой.

| Проверка | Значение | Норма |
|---|---|---|
| Конусные гайки / контргайки 6200 | 4 / 4 | по 2+2 на 6200 |
| 6200 №1 — осевой стек | −8…0 / 0…5,5 / 5,5…14,5 / 14,5…20 / 20…28 | симметрично |
| 6200 №2 — осевой стек | 132…140 / 140…145,5 / 145,5…154,5 / 154,5…160 / 160…168 | симметрично |
| 6200 №2, левая гайка — конус | 132…140 против 140…145,5 | снаружи, не поверх |
| Конус — 6200 (4 шт.) | 0,000 мм | касание |
| Конус — контргайка | 0,000 мм³ | 0 |
| Контргайка — подшипник | 5,5 мм | ≥5 |
| Контргайки — балка 21 / поперечина | 0,19 / 0,19 мм | ≥0,1 |
| Конусы/гайки — рама, балка 21, уголки, кулачок | 0,000 мм³ | <0,5 |
| Вал привода — осевой люфт | 0 (зажат) | 0 |
| Извлечение блока (44 мм, вперёд) | 0,000 мм³ | <0,5 |
| Габарит сборки | 380×215×308 | — |
| Масса без дрели | 6,39 кг | — |

## 5. Массы

[`cad/mass.csv`](./cad/mass.csv): **6390,8 г** без дрели — без изменений
относительно fix5 (детали не добавлялись, одна контргайка только
переставлена).

| Материал | Масса, г |
|---|---:|
| PETG (рама, балка 21, подстолье) | 2526 |
| PLA (стол, накладка, кулачок) | 669 |
| Поликарбонат (кожух) | 704 |
| Сталь (валы, крепёж, уголки) | 1831 |
| Подшипники (LMK, 6200) | 592 |
| Резина (буферы, кольца) | 68 |
| **Итого** | **6391** |

Масса подшипников по-прежнему завышена: LMK/6200 в модели сплошные.

## 6. Визуальные проверки

Новые рендеры (Blender, EEVEE, 1200×900):

- `pic/render_bearing_1.png` — 6200 №1: гайка → конус → подшипник → конус
  → гайка;
- `pic/render_bearing_2.png` — 6200 №2 справа;
- `pic/render_bearing_2_left.png` — **левая пара 6200 №2** (исправленная):
  гайка 132…140, конус 140…145,5, подшипник; гайка не лежит на конусе;
- `pic/render_bearing_clamp.png` — оба опорных узла вдоль вала.

Остальные рендеры обновлены из новой модели: `render_iso`,
`render_iso_rear`, `render_left`, `render_top`, `render_front`,
`render_shield`, `render_mechanism`, `render_cam`, `render_washer`,
`render_ring`, `render_pad`, `render_retainer_down`, `render_podstol`.

Листы: `fig/vibrotable_views.svg` — 3 проекции без кожуха (вид спереди,
слева, сверху), размеры, выноски, примечания; в примечании 6 описаны
4 конуса и 4 контргайки. `fig/vibrotable_spec.svg` — 36 позиций,
параметры, массы, проверки (238/240 OK). Изометрия — `fig/iso.svg`,
`fig/iso_open.svg`.

## 7. Принятые решения и отклонения

1. **«Конические подшипники» прочитано как конические гайки** — по тексту
   fix2 и терминологии проекта; 6200 не заменялись.
2. **Замечание относится к осевой фиксации вала**, а не к наружным
   кольцам: наружные кольца остаются в карманах 9,4 мм с зазором 0,2 мм.
3. **Контргайки — M10 nyloc** (fix1/fix2), по одной на конус; спецификация
   поз. 16 не менялась.
4. **Стек строится от центра 6200**; исправлена только левая пара 6200 №2,
   но проверяются обе пары и обе стороны.
5. **Остальные детали и масса — как fix5**; новых позиций спецификации нет.
6. **4 новых рендера** добавлены в `render_views.py`; листы и кэш проекций
   пересобраны (`views_v7.json`).

## 8. Остаточные риски

1. **Момент затяжки и преднатяг** не рассчитаны; при перетяжке возможно
   смятие торца внутреннего кольца/резьбы, при недотяжке — осевой люфт.
2. **Nyloc не создаёт контрнатяг** на конус; при сильной вибрации
   контргайка держит от проворота, но не поджимает конус. Проверить момент
   после обкатки; при ослаблении — фиксатор резьбы/обычная гайка.
3. **Зазор 0,19 мм** до балки/поперечины в модели (0,55 мм у реальной
   гайки) — контролировать фаску и покрытие гайки.
4. **Шпилька M10 как посадка 6200** — резьба уменьшает поверхность
   (экспертиза I3); предложение — ступенчатый вал с гладкими поясами.
5. **Биение и балансировка** вала с 4 конусами и 4 гайками не проверялись;
   при 450 об/мин возможна вибрация.
6. **Наружное кольцо** имеет осевой зазор 0,2 мм; при стуке — шайбы в
   карман.
7. **Динамика, пружины, дрель, шарик, удержание шарика** — как в fix5, не
   проверялись.

## 9. Ограничения

- Прочность резьбы, сварки, усталость, износ PLA/PETG, фреттинг, момент
  затяжки и точность FDM не рассчитывались.
- Динамика 2-лепесткового кулачка, пружин и дрели не проверялась.
- Массы покупных LMK/6200 завышены; пружина — оболочка.
- Чертежи эскизные; для производства нужны рабочие чертежи/DXF.
- Импорт сборочного STEP (39 тел) в FreeCAD 0.19 падает с сегфолтом —
  та же ошибка на fix5; отдельные STEP-детали и `35_cartridge.step`
  читаются. Для проверки сборки использовать FreeCAD 1.x или другой CAD.

## 10. Воспроизведение

```bash
cd stages/fix6/cad
freecadcmd build.py            # params/spec/checks/mass/print, STEP, STL
freecadcmd export_groups.py    # cad/stl/groups для рендера
blender -b --python render_views.py
freecadcmd draw_sheet.py       # fig/*.svg; кэш cad/cache/views_v7.json
```

## 11. Стоимость генерации

Модель `deepseek/deepseek-flash` (variant high): вход $0,15/млн, чтение кэша
$0,003/млн, выход (включая reasoning) $0,60/млн. Учёт — `session_v2`
OpenCode, сессия `ses_e7285004fffecZ55DuO9bvwqjE`; снимок на 2026-10-30
16:04 UTC (20:04 местного). Сессия создана для этого этапа, поэтому ниже —
её полные токены; предыдущие этапы шли в другой сессии.

| Категория | Токены | Стоимость, USD |
|---|---:|---:|
| **Всего за fix6** | **16 988 847** | **0,13459** |
| Входящие мимо кэша | 170 332 | 0,02555 |
| Закешированные входящие | 16 720 384 | 0,05016 |
| Исходящие (включая reasoning) | 98 131 | 0,05888 |

Исходящие = 37 953 (output) + 60 178 (reasoning). Финальные ответы и
правки этого отчёта читают тот же кэш и могут добавить ориентировочно
$0,001…0,003.
