inutcin/boomboom/stages/fix7/Report.md

# Отчёт по этапу «Первая корректировка после второй инженерной экспертизы»

Дата: 2026-10-30
Этап: `stages/fix7`
База: [`stages/fix6`](../fix6/README.md)
Инструменты: FreeCAD 0.19 (`Part`, `Drawing`/HLR), Python 3.10, cairosvg;
Blender-рендеры fix6 (геометрия не менялась).

Этап выполнен по единственному замечанию пользователя: задать параметры
прижимных пружин. Вопросы и решения — [`Interview.md`](./Interview.md).
Остальные замечания второй экспертизы в fix7 **не выполнялись**.

## 1. Результат

| Результат | Файлы |
|---|---|
| 3D-модель, STEP сборки | `cad/step/vibrotable_assembly.step` |
| Блок кулачка | `cad/step/35_cartridge.step` |
| STEP деталей | `cad/step/*.step` |
| Исходники | `cad/model.py`, `cad/params.py`, `cad/build.py` |
| Печатные детали | `cad/stl/frame.stl`, `table.stl`, `overlay.stl`, `podstol.stl`, `retainer.stl`, `cam_3/5/10.stl` |
| Параметры печати | `cad/print.csv` |
| Эскиз в 3 проекциях | `fig/vibrotable_views.svg` (лист 1/2) |
| Спецификация и параметры | `fig/vibrotable_spec.svg` (лист 2/2), `spec.csv` (36 поз.), `params.csv` |
| Изометрия (HLR) | `fig/iso.svg`, `fig/iso_open.svg` |
| Проверки / массы | `cad/checks.csv` (241: 239 OK, 2 предупреждения), `cad/mass.csv` |
| Рендеры | `pic/render_*.png` (fix6; геометрия не менялась) |
| Превью | `pic/vibrotable_views.png`, `vibrotable_spec.png`, `iso.png`, `iso_open.png` |

## 2. Что изменено

| Параметр | fix6 | fix7 |
|---|---:|---:|
| Свободная длина L0 | ≈55 мм | **70 мм** |
| Наружный диаметр | 12 мм | **12 мм** |
| Проволока | 1,0 мм | **1,0 мм** |
| Число витков (активных) | 11 | 11 |
| Количество | 4 | 4 |
| Установленная длина | 36 мм | **36 мм** (геометрия не менялась) |
| Жёсткость k | 0,677 Н/мм | **0,677 Н/мм** (не зависит от L0) |
| Преднатяг при L=36 | 51,5 Н | **92,1 Н** |
| Сила при L=46 (низ) | 24,4 Н | **65,0 Н** |
| f_соб | 8,64 Гц | **8,64 Гц** (не зависит от L0) |

Жёсткость считана для 12×1,0, D=11, n=11:
`k = G·d⁴/(8·D³·n) = 79 300·1/(8·11³·11) = 0,677 Н/мм`.
Преднатяг: `4k·(70−36)=92,1 Н`; внизу `4k·(70−46)=65,0 Н`.

## 3. Проверки fix7

[`cad/checks.csv`](./cad/checks.csv): **241 проверка, 239 OK,
2 предупреждения**. Новые/изменённые строки:

| Проверка | Значение | Норма | Статус |
|---|---|---|---|
| Пружина свободная L0 | 70 мм | 70 | OK |
| Пружина установленная (верх) | 36 мм | ≤L0 (70) | OK |
| Пружина при верхнем/нижнем | 36…46 мм | ≤70 | OK |
| Пружина ID — вал Ø10 | 0,2 мм | ≥0,1 | ВНИМАНИЕ |
| Стенка кулачка на минимуме (10 мм) | 3,0 мм | ≥3 (принято) | ВНИМАНИЕ |

Предупреждения прежние, к параметру L0 не относятся: номинальная пружина
12×1,0 даёт ID 10,0 при вале Ø10; стенка 3 мм у отверстия R32 на минимуме
диска 10.

Масса без дрели — **6390,8 г**; пружина в модели 2,4 г/шт., её проволока не
изменилась. Геометрия установленной пружины (36 мм) и остальных деталей не
менялась, поэтому STEP/STL и рендеры соответствуют fix6; пересобраны только
параметры, спецификация, проверки и листы.

## 4. Что это значит для пружин и контакта

Кратко (подробно — в [`stages/expert3`](../expert3/README.md)):

- L0=70 повышает преднатяг с 51,5 до 92,1 Н; контакт ролика на 15 Гц/10 мм
  растёт с 19,7 до **60,3 Н** по идеальной синусоиде (0,48 → 1,48 от
  инерционной) и с 31,4 до **72,0 Н** по фактическому 2-лепестковому профилю
  (0,77 → 2,48).
- Цель «контакт ≥2× инерционной» по идеальной синусоиде **не достигнута**:
  нужно L0≈77,9 мм или k≥1,5 Н/мм. По фактическому профилю 2× получается, но
  он не гармонический (C8 второй экспертизы).
- Напряжение в проволоке при 92,1 Н / 4 = 23,0 Н на пружину — около
  **729 МПа** (с коэффициентом Wahl); это существенно выше, чем при L0=55
  (≈409 МПа). Вопрос допустимости для 15 Гц — в expert3.
- f_соб остаётся 8,64 Гц внутри 5…15 Гц; L0 не меняет собственную частоту.

## 5. Ограничения

- «Длина 70» принята как **свободная** длина; установленная 36 мм не
  менялась. Если имелась в виду установленная длина 70 мм, потребуется
  переделка стоек/верхней поперечины — это не выполнено (см. Interview.md).
- Число витков 11, материал «пружинная сталь», концы закрытые/шлифованные —
  допущения; в задании они не указаны.
- Прочность, усталость и напряжение пружины — в expert3; в fix7 только
  параметры и геометрические проверки.
- Остальные замечания expert2 (ограждение, привод, кулачок, валы, балка 21,
  шарик, крепление, документы) в fix7 не выполнялись.

## 6. Воспроизведение

```bash
cd stages/fix7/cad
freecadcmd build.py
freecadcmd draw_sheet.py
python3 - <<'PY'
import cairosvg
for n in ("vibrotable_views","vibrotable_spec","iso","iso_open"):
    cairosvg.svg2png(url=f"../fig/{n}.svg", write_to=f"../pic/{n}.png", dpi=110)
PY
```

## 7. Стоимость генерации

Модель `deepseek/deepseek-flash` (variant high): вход $0,15/млн, чтение кэша
$0,003/млн, выход (включая reasoning) $0,60/млн.

| Категория | Токены | Стоимость, USD |
|---|---:|---:|
| **Всего** | **9 178 327** | **0,05066** |
| Входящие мимо кэша | 30 075 | 0,00451 |
| Закешированные входящие | 9 116 928 | 0,02735 |
| Исходящие (включая reasoning) | 31 324 | 0,01879 |

Исходящие = 9 052 (output) + 22 272 (reasoning). Разбивка — по сообщениям
этапа fix7 в сессии `ses_e726e0ef1ffeC8VnXNji0HrEe0`; expert3 учитывается
отдельно: [`../expert3/Report.md`](../expert3/Report.md), $0,17825.
Финальный ответ может добавить ~$0,002…0,005.
