inutcin/boomboom/stages/fix5/Report.md

# Отчёт по этапу «Вторая корректировка после инженерной экспертизы»

Дата: 2026-10-30
Этап: `stages/fix5`
База: [`stages/fix4`](../fix4/README.md)
Инструменты: FreeCAD 0.19 (`Part`, `Drawing`/HLR), Blender 3.0.1 (EEVEE),
Python 3.10, Inkscape 1.1.2.

Этап выполнен по семи замечаниям [`README.md`](./README.md). Рекомендации
`promos.md` не выполнялись. Вопросы и решения — [`Interview.md`](./Interview.md).

## 1. Результат

| Результат | Файлы |
|---|---|
| 3D-модель, STEP сборки | `cad/step/vibrotable_assembly.step` |
| Блок кулачка | `cad/step/35_cartridge.step` |
| STEP деталей | `cad/step/*.step` (в т.ч. `33_cam_washers`, `34_cam_nuts`, `16_cam_locknuts`) |
| Исходники | `cad/model.py`, `cad/params.py`, `cad/build.py` |
| Печатные детали | `cad/stl/frame.stl`, `table.stl`, `overlay.stl`, `podstol.stl`, `retainer.stl`, `cam_3/5/10.stl`, `shield.stl` |
| Параметры печати | `cad/print.csv` |
| Эскиз в 3 проекциях | `fig/vibrotable_views.svg` (лист 1/2) |
| Спецификация и параметры | `fig/vibrotable_spec.svg` (лист 2/2), `spec.csv` (36 поз.), `params.csv` |
| Изометрия (HLR) | `fig/iso.svg`, `fig/iso_open.svg` |
| Проверки / массы | `cad/checks.csv` (222), `cad/mass.csv` |
| Рендеры | `pic/render_iso.png`, `render_iso_rear.png`, `render_left.png`, `render_top.png`, `render_front.png`, `render_shield.png`, `render_mechanism.png`, `render_cam.png`, `render_washer.png`, `render_ring.png`, `render_pad.png`, `render_retainer_down.png`, `render_podstol.png` |
| Превью | `pic/vibrotable_views.png`, `vibrotable_spec.png`, `iso.png`, `iso_open.png` |

## 2. Что изменено по семи замечаниям

| № | Замечание | Реализация | Проверка |
|---|---|---|---|
| 1 | Отверстие в кулачке под вал — плотно под гайку M10 | Шестигранник **17,1 мм AF** через диск и буртик; гайка 17 AF входит с зазором 0,1 мм. | `Кулачок — отверстие 17,1 AF`; `Кулачок — приваренная гайка 0 мм³` |
| 2 | Буртик Ø40×10 с одной стороны; насечек нет | Буртик **Ø40×10**, X=64…74 (левый торец), вокруг отверстия. На обеих сторонах **насечек нет**; фаски нет. | `Буртик Ø40×10`; `Насечки 0`; `Фаска 0` |
| 3 | Гайку M10 закрутить и приварить к шпильке | Гайка **M10 17 AF, X=74…82** — шестигранный буртик на валу (неразъёмный, сварка). Кулачок садится на неё. | `Приваренная гайка 17 AF`; `Кулачок — приваренная гайка 0` |
| 4 | Шайбы с обеих сторон, с каждой стороны гайка + контргайка | **2 шайбы Ø40/Ø10,5×2,5**: слева на буртике (61,5…64), справа на торце (86…88,5). Слева гайка 53,5…61,5 + контргайка 45,5…53,5; справа 88,5…96,5 + 96,5…104,5. | `Шайбы 2`, `Гайки 2+2`, `Осевой стек 45,5…104,5`, все пересечения 0 |
| 5 | 8 облегчающих отверстий того же размера/радиуса: 2 макс, 2 мин, 4 между | **8 × Ø10 на R32**, углы 0/45/90/…/315; 2 на макс (90/270), 2 на мин (0/180), 4 между. | `8×Ø10 R32`; стенка 13/8/3 мм (макс./45°/мин., диск 10) — **предупреждение 3 мм** |
| 6 | Буферы не по обе стороны пружины, а в угол «поперечина — стойка» | **4 буфера 20×19×36**, по одному на угол: X=0…20/140…160, Y=20…39/161…180, Z=244…280; прижаты к поперечине (Z=280) и стойке (Y=20/180). | `4 / 1`; 5 мм до пружины, 3 мм до стола; буфер–рама 0 |
| 7 | Галтели на стыке нижней поперечины и стоек, а также везде внутри балок выноса | **26 галтелей R10**: 20 из fix4 + 6 в выносе (2 верх у граничной поперечины, 2 верх у задних стоек, 2 низ у задних стоек). Нижний стык X=160 заподлицо — без галтели. | `26 шт.`, `6 в выносе`, рама одно тело |
| 8 | Внутренние бортики поликарбоната не нужны — от шарика страхуют резиновые ограничители | **4 внутренних бортика удалены**; остались 2 боковые панели и 2 наружных бортика. Крепёж — **22 самореза** (16 боковых + 6 наружных). | `Кожух — внутренние 0`, `4 пластины`, `22 самореза`; буферы 4, прижаты к поперечине и стойке |

## 3. Кулачок и его осевой стек

- Профиль: `r(θ)=50−s/2−(s/2)·cos2θ`; диски 3/5/10; верх стола 241,
  ход вниз 3/5/10; 2 колебания за оборот (150…450 об/мин).
- Центр: шестигранник **17,1 AF** (под гайку M10 17 AF) через
  буртик и диск. Посадка 0,1 мм — «плотно».
- Буртик: **Ø40×10**, X=64…74; гладкий, без насечек.
- Облегчение: **8×Ø10 R32**; 2 на максимумах, 2 на минимумах,
  4 между (45°). Для диска 10 минимальная стенка **3 мм** — риск,
  записан как предупреждение; предложение — Ø8 или R30.
- Приваренная гайка: M10 17 AF, X=74…82; в модели — шестигранный
  буртик вала; передаёт момент.
- Осевой стек:
  контргайка 45,5…53,5 / гайка 53,5…61,5 / шайба 61,5…64 /
  буртик 64…74 / диск 74…86 / шайба 86…88,5 / гайка 88,5…96,5 /
  контргайка 96,5…104,5.
- Шайбы гладкие Ø40/Ø10,5×2,5; с каждой стороны шайба прижата гайкой,
  контргайка фиксирует. Пересечения «кулачок — шайбы — гайки —
  контргайки — вал» — 0.

## 4. Рама, буферы, кожух

- Рама PETG 360×200×300; добавлены 6 галтелей R10 в выносе:
  верх у X=160 (2), верх у задних стоек (2), низ у задних стоек (2).
  Всего 26; верхние внутренние углы виброотсека без галтелей — там
  бортики кожуха и буферы.
- Буферы: 4 шт. 20×19×36, по одному в угол; прижаты к поперечине и
  стойке; 5 мм до пружины, 3 мм до стола. Восемь буферов fix4 удалены.
- Кожух: 2 боковые панели + 2 наружных бортика; 4 внутренних бортика
  удалены (п. 8), их функцию берут 4 резиновых буфера в углах. 22 самореза
  (16 боковых + 6 наружных). Кольца, балки 21, подстолье, дрель — без
  изменений fix4.

## 5. Числовые проверки

[`cad/checks.csv`](./cad/checks.csv): **222 проверки, 220 OK, 2
предупреждения**:

1. пружина 12×1,0 даёт ID 10,0 при вале Ø10 (в модели 10,2);
2. стенка 3 мм у отверстия R32 на минимуме диска 10 (принято по
   замечанию 5; предложение Ø8/R30).

Ключевые:

| Проверка | Значение | Норма |
|---|---|---|
| Отверстие под гайку | 17,1 AF | 17,0…17,2 |
| Буртик | Ø40×10, 64…74 | Ø40×10 |
| Насечки / фаска | 0 / 0 | 0 |
| Облегчение | 8×Ø10 R32 | 8, 2+2+4 |
| Стенка на минимуме | 3 мм | предупреждение |
| Приваренная гайка | 17 AF, 74…82 | M10 |
| Шайбы | 2 × Ø40/10,5×2,5 | с двух сторон |
| Гайки/контргайки | 2 + 2 | по одной с каждой стороны |
| Осевой стек | 45,5…104,5 | без зазоров |
| Буферы | 4 × 20×19×36 | 1 на угол |
| Буфер — пружина / стол | 5 / 3 мм | 5 / 3 |
| Галтели | 26 (20+6) | 26 |
| Кулачок 3/5/10 — ролик | 0 / 0 / 0 мм³ | касание |
| Блок −44 мм — рама/уголки/стол/кожух | 0 | путь извлечения |
| Габарит сборки | 380×215×308 | — |

## 6. Массы

[`cad/mass.csv`](./cad/mass.csv): **6390,8 г** без дрели.

| Материал | Масса, г |
|---|---:|
| PETG (рама, балка 21, подстолье) | 2526 |
| PLA (стол, накладка, кулачок) | 669 |
| Поликарбонат (кожух) | 704 |
| Резина (буферы, кольца) | 68 |
| Сталь (валы, крепёж, уголки, шайбы) | 1831 |
| Подшипники (LMK, 6200) | 592 |
| **Итого** | **6391** |

Изменения к fix4 (6590 г): кулачок +7,7 г (буртик/8 отверстий), вал +7,4 г
(приваренная гайка), 4 буфера −23,2 г, 6 галтелей +3,3 г, шайбы/гайки
кулачка −9,4 г, удалённые 4 внутренних бортика −164,8 г, 12 саморезов
−21,7 г, суммарно −199,3 г. Масса подшипников по-прежнему завышена
(сплошные LMK/6200).

## 7. Визуальные проверки

- `render_iso.png` — общий вид с прозрачным кожухом и новым кулачком;
- `render_mechanism.png`, `render_cam.png`, `render_washer.png` —
  кулачок с буртиком, шестигранником, 8 отверстиями, шайбами и гайками;
- `render_ring.png` — кольца на валах;
- `render_pad.png` — 4 буфера в углах;
- `render_shield.png` — кожух;
- `render_retainer_down.png` — балка 21 опущена;
- `render_podstol.png` — подстолье и дрель.

Листы: `fig/vibrotable_views.svg` — 3 проекции без кожуха; размеры,
выноски; `fig/vibrotable_spec.svg` — 36 позиций, параметры, массы,
проверки; `fig/iso.svg`, `fig/iso_open.svg` — изометрия HLR.

## 8. Принятые решения и отклонения

1. **Шестигранное отверстие 17,1** вместо круглого Ø17: только оно
   передаёт момент от приваренной гайки. Посадка 0,1 мм.
2. **Буртик слева**, X=64…74; шайба на буртике. Если сварка окажется
   справа, буртик нужно перенести (симметрично).
3. **8×Ø10 R32** — по замечанию 5; стенка 3 мм на минимуме диска 10
   записана как предупреждение. Альтернатива — Ø8/R30.
4. **4 буфера**, а не 8: по одному в угол; по обе стороны пружины
   удалены.
5. **26 галтелей**: 20 + 6 в выносе; нижний стык X=160 заподлицо,
   верхние внутренние углы — под кожух/буферы.
6. **Кожух/кольца/балки/подстолье** не менялись; их замечания fix4
   остаются в силе.
7. **Блок кулачка** теперь включает 2 шайбы, 2 гайки, 2 контргайки;
   `35_cartridge.step` обновлён.

## 9. Остаточные риски

1. **3-мм стенка** у отверстий R32 на минимуме диска 10: риск
   разрушения PLA/износа. Предложение — Ø8 или R30, либо диск 10 мм
   печатать PETG/100 % с проверкой.
2. **Сварка гайки**: перекос, деформация резьбы, качество шва; биение
   кулачка. Проверить на оправке; при необходимости — метчик и
   проточка.
3. **Балансировка**: буртик + шайба + гайки с одной стороны смещают
   массу; на 450 об/мин возможна вибрация. Предложение — уравновесить.
4. **Смятие PLA** шайбой Ø40 при затяжке; контролировать момент,
   при необходимости — стальная вставка/шайба Ø50.
5. **Осевое положение** задаётся только затяжкой шайб (буртик вала
   удалён); при ослаблении кулачок может сместиться. Контроль момента,
   фиксация резьбы.
6. **Удержание шарика**: внутренние бортики удалены (п. 8), остаются
   вогнутость накладки и 4 угловых резиновых буфера; середина краёв
   стола борта не имеет. Динамически не проверялось; при уходе шарика —
   вернуть локальные бортики/кольцо.
7. **Извлечение блока** — снять балки 21, опустить на 44 мм, выдвинуть;
   новые гайки слева расширили стек до X=45,5, путь проверен.
8. **Дрель, пружины, шарик, динамика** — как в fix4; не проверялись.
9. **Открытые нижние передняя/задняя стороны** кожуха — как в fix4.

## 10. Ограничения

- Прочность сварки, усталость, износ PLA/PETG, балансировка, момент
  затяжки, точность FDM-шестигранника — не рассчитывались.
- Динамика 2-лепесткового кулачка, пружины, дрель не проверялись.
- Массы покупных LMK/6200 завышены; пружина — оболочка.
- Чертежи эскизные; для производства нужны рабочие чертежи/DXF.

## 11. Воспроизведение

```bash
cd stages/fix5/cad
freecadcmd build.py            # params/spec/checks/mass/print, STEP, STL
freecadcmd export_groups.py    # cad/stl/groups для рендера
blender -b --python render_views.py
freecadcmd draw_sheet.py       # fig/*.svg; кэш cad/cache/views_v6.json
```

## 12. Стоимость генерации

Модель `deepseek/deepseek-flash`: вход $0,15/млн, чтение кэша $0,003/млн,
выход (включая reasoning) $0,60/млн. Учёт — `session_v2` OpenCode, сессия
`ses_e7356bbc4ffesrwNzFdWzs3F7i`; снимок на 2026-10-30 13:32 UTC (17:32
местного). Так как fix5 выполнялся в той же сессии, что fix4, ниже —
**приращение этапа fix5** от снимка fix4 ($0,3123; 52 243 068 токенов).

| Категория | Токены | Стоимость, USD |
|---|---:|---:|
| **Всего за fix5** | **43 208 544** | **0,2029** |
| Входящие мимо кэша | 72 915 | 0,0109 |
| Закешированные входящие | 43 030 912 | 0,1291 |
| Исходящие (включая reasoning) | 104 717 | 0,0628 |

Для справки: вся сессия на момент снимка — 95 501 612 токенов, $0,5152
(включая fix4). Финальный ответ и правки отчёта читают тот же кэш и могут
добавить ориентировочно $0,003…0,006.
