inutcin/boomboom/model/Report.md

# Отчёт по этапу «Формирование модели устройства»

Дата: 27.10.2026  
Источник: эскиз от руки `model/pics/common_idea.jpg`  
Стадия: модель, без рабочих чертежей и расчёта на прочность

## 1. Что сделано

По эскизу разработана параметрическая модель вибростола и выпущены три листа A3
в масштабе 1:5:

| Лист | Файл SVG | Растр PNG | Содержание |
|---:|---|---|---|
| 1 | `model/figs/side_view.svg` | `model/pics/side_view.png` | Вид сбоку, разрез A–A по оси |
| 2 | `model/figs/left_view.svg` | `model/pics/left_view.png` | Вид слева: два ролика, кулачковый диск, пружины |
| 3 | `model/figs/isometric.svg` | `model/pics/isometric.png` | Изометрия; столешница, подстолье и ближняя правая стойка — контуром |

Дополнительно в `model/tools/generate.js` лежит параметрический генератор
листов. Запуск:

```bash
node model/tools/generate.js
```

Генератор детерминированный; SVG пересобираются из одних и тех же параметров.
PNG получены из SVG через headless Chromium при 200 dpi: 3307 × 2339 px
(A3, 420 × 297 мм).

## 2. Принятая схема

1. **Станина** — П-образная рама с верхней траверсой и верхней плитой.
   Стойки 40 × 40 мм, наружный габарит 600 × 500 × 860 мм.
2. **Столешница** 500 × 400 × 18 мм подвешена на четырёх шпильках M12 между
   верхними и нижними пружинами. В столешнице отверстия с люфтом, поэтому она
   может совершать движение в вертикальной плоскости.
3. **Подстолье** 500 × 400 × 18 мм закреплено на шпильках; в центре окно
   Ø250 мм.
4. **Дрель** закреплена под подстольем, вал горизонтально, патрон направлен
   к центру. На патроне через оправку установлен кулачковый диск.
5. **Диск** проходит через окно подстолья и контактирует с двумя роликами,
   закреплёнными кронштейнами снизу столешницы.
6. **Два ролика** — подшипники 6202-2RS (Ø35 мм) на осях M10.
7. **Кулачковый диск** — двухлепестковый, с центральной симметрией:
   `r(φ) = R + e·cos(2φ)`. Центр масс совпадает с осью вращения, поэтому диск
   статически уравновешен.
8. **Амплитуда** задаётся сменным диском, **частота** — встроенным регулятором
   оборотов дрели. Отдельного регулятора в конструкции нет.

## 3. Основные параметры

| Параметр | Значение | Примечание |
|---|---|---|
| Столешница | 500 × 400 × 18 мм, фанера | верхняя плоскость 560 мм |
| Подстолье | 500 × 400 × 18 мм | верх 450 мм, окно Ø250 мм |
| Станина | 600 × 500 × 860 мм | 4 стойки 40 × 40, верхняя плита |
| Шпильки | 4 × M12, L ≈ 400 мм | гайки, шайбы, контргайки |
| Пружины | 4 верхних + 4 нижних | верх 560…802, низ 450…542 |
| Ролики | 2 × 6202-2RS, Ø35 × 11 мм | Z = ±50 мм, оси M10 |
| Диск, средний | R = 110 мм, e = 3 мм | Rmax/Rmin = 113/107 мм |
| Диски | 3 сменных | e = 1,5 / 3 / 5 мм |
| Амплитуда стола | 3 / 6 / 10 мм (предв.) | размах по вертикали |
| Частота | 5…15 Гц | f = n/30 при двух лепестках |
| Обороты дрели | 150…450 об/мин | встроенный регулятор |
| Материалы | фанера, уголок 40 × 40 × 4, покупной крепёж | диск, оправка, кронштейны — изготовление |

### 3.1. Диск и амплитуда

Принят двухлепестковый профиль:

`r(φ) = R + e·cos(2φ)`

- два максимума через 180°;
- два минимума через 180°;
- центральная симметрия → центр масс на оси вращения, диск уравновешен;
- за один оборот стол проходит два цикла, поэтому `f = 2n/60 = n/30`.

Три диска:

| Диск | e, мм | Rmax, мм | Rmin, мм | Aст (предв.), мм |
|---|---:|---:|---:|---:|
| 1 | 1,5 | 111,5 | 108,5 | 3 |
| 2 | 3,0 | 113,0 | 107,0 | 6 |
| 3 | 5,0 | 115,0 | 105,0 | 10 |

**Важно:** по требованию пользователя амплитуда измеряется по перемещению
стола, а не по разнице радиусов диска. Поэтому значения `Aст` в таблице —
предварительные; окончательная амплитуда каждого диска устанавливается
измерением вертикального перемещения стола (индикатор часового типа или
шкала) и, при необходимости, коррекцией профиля/глубины лепестков. Диски
маркируются по фактической `Aст`.

### 3.2. Частота

При двух лепестках:

`f = 2n/60 = n/30`

Для 5…15 Гц нужны 150…450 об/мин. Это в диапазоне встроенного регулятора
дрели. Отдельный блок регулятора не предусмотрен.

## 4. Проверка требований README

| № | Требование | Как обеспечено | Статус |
|---:|---|---|---|
| 1 | Амплитуда 3…10 мм | три сменных диска; измерение по столу | выполнено в модели, требует калибровки |
| 2 | Частота 5…15 Гц | f = n/30, 150…450 об/мин, регулятор дрели | выполнено в модели; зависит от момента дрели на низах |
| 3 | Гармонический характер | двухлепестковый кулачок + два ролика; вертикальная составляющая периодическая | требует проверки чистоты гармоники |
| 4 | Минимум движущихся частей и трения | 2 ролика-подшипника, 1 диск, 8 пружин; отдельных направляющих нет | в основном выполнено |
| 5 | Минимум сложных деталей | диск — плоский профиль; кронштейны из уголка | выполнено |
| 6 | Минимум «непокупных» деталей | покупные дрель, пружины, шпильки, подшипники, крепёж; изготовление — диск, оправка, кронштейны, плита | выполнено |
| 7 | Минимум вибраций подстолья | уравновешенный двухлепестковый диск, жёсткая рама, резиновые опоры | частично; реакция дрели и контакта остаётся |
| 8 | Минимум точек регулировки | амплитуда — сменой диска, частота — регулятором дрели | две точки |
| 9 | Линейные зависимости | `Aст ≈ 2e`, `f = n/30` | предварительно; калибровка по столу |
| 10 | Безопасность | закрытый кожух привода, фиксация курка, аварийное отключение | рекомендуется, в модель не включено |

## 5. Отклонения от эскиза и принятые решения

1. **Станина** в эскизе не показана; добавлена П-образная рама с верхней
   траверсой и плитой — иначе верхним пружинам не на что опираться.
2. **Диск** вместо эксцентрикового круга/неправильной формы принят
   двухлепестковым, центрально-симметричным: это требование пользователя и
   одновременно пассивная балансировка.
3. **Дрель** расположена под подстольем, вал горизонтально; диск через окно
   подстолья выходит к роликам. В эскизе взаимное положение диска и роликов
   читается неоднозначно; принят вариант, при котором диск Ø226…230 мм
   достаёт до роликов под столешницей.
4. **Верхняя плита** 500 × 400 × 18 мм добавлена как опора верхних пружин и
   элемент жёсткости рамы.
5. **Отверстия в столешнице** под шпильки приняты с люфтом: столешница
   совершает движение в вертикальной плоскости, и шпильки не должны работать
   направляющими.
6. **Вид сбоку** выполнен разрезом A–A по оси; вид слева — обычный вид.
7. Каталоги `model/figs` и `model/pics` — существующие в репозитории; они
   использованы вместо `fig`/`pic` из формулировки `AGENTS.md`. При
   необходимости каталоги можно переименовать.

## 6. Риски и что проверить на этапе экспертизы

1. **Момент дрели на 150…450 об/мин.** Встроенный регулятор может давать
   недостаточный момент; при просадке оборотов частота уйдёт. Проверить
   реальную характеристику дрели под нагрузкой; при необходимости —
   мотор-редуктор или дрель с поддержанием оборотов.
2. **Амплитуда по столу.** `Rmax − Rmin` — только предварительная оценка.
   Фактическое вертикальное перемещение зависит от профиля, угла контакта
   роликов и податливости пружин. Нужна калибровка на собранном макете.
3. **Чистота гармоники.** Двухлепестковый профиль и два ролика дают
   периодическое движение, но не гарантируют идеальную синусоиду. Проверить
   вертикальное перемещение/ускорение; при необходимости оптимизировать
   профиль.
4. **Горизонтальная составляющая.** Два ролика и кулачок дают движение в
   вертикальной плоскости с горизонтальной составляющей. Люфт в отверстиях
   столешницы и боковая податливость пружин должны это обеспечивать; иначе
   возможны заклинивание/ударные нагрузки.
5. **Контактная прочность.** Кромка диска 6 мм и ролик 6202 — проверить
   контактные напряжения, твёрдость кромки, ресурс подшипников.
6. **Неуравновешенность.** Диск уравновешен по массе, но оправка, патрон и
   биение могут дать вибрацию. Проверить биение и балансировку в сборе.
7. **Резонанс.** Собственная частота подвески предварительно 3…4 Гц; рабочий
   диапазон 5…15 Гц. Нижняя граница близка к резонансу; проверить
   амплитудно-частотную характеристику и при необходимости изменить
   жёсткость пружин/массу.
8. **Безопасность.** Открытые диск и ролики, вращающийся патрон, подвижная
   столешница. Нужен защитный кожух, фиксация курка, аварийная кнопка,
   ограничение хода. В модель не включены; рекомендуется на этапе экспертизы.

## 7. Состав этапа

```
model/
  figs/
    side_view.svg
    left_view.svg
    isometric.svg
  pics/
    common_idea.jpg        — исходный эскиз
    side_view.png
    left_view.png
    isometric.png
  tools/
    generate.js            — параметрический генератор
  Report.md
  Interview.md
```

## 8. Следующий этап

Передать модель на инженерную экспертизу:
- проверить кинематику двухлепесткового кулачка и двух роликов;
- рассчитать пружины, собственную частоту и амплитуду по столу;
- проверить дрель по моменту/оборотам;
- проверить прочность рамы, шпилек, кронштейнов, контакт ролик–диск;
- проработать кожух, фиксацию дрели и аварийное отключение.
