inutcin/boomboom/stages/fix4/Report.md

# Отчёт по этапу «Первая корректировка и замечания после инженерной экспертизы»

Дата: 2026-10-30
Этап: `stages/fix4`
База: [`stages/fix3`](../fix3/README.md)
Экспертиза: [`stages/expert/Report.md`](../expert/Report.md)
Инструменты: FreeCAD 0.19 (`Part`, `Drawing`/HLR), Blender 3.0.1 (EEVEE),
Python 3.10, Inkscape 1.1.2.

Этап выполнен по **семи замечаниям** [`README.md`](./README.md). Рекомендации
[`promos.md`](./promos.md) (C1–C7, I1–I18, W1–W8) по указанию задания **не
выполнялись** — оставлены для информации. Вопросы и принятые решения —
[`Interview.md`](./Interview.md).

## 1. Результат

| Результат | Файлы |
|---|---|
| 3D-модель, STEP сборки | `cad/step/vibrotable_assembly.step` |
| Блок кулачка (картридж) | `cad/step/35_cartridge.step` |
| STEP деталей | `cad/step/*.step` (в т.ч. `29_shield`, `30_shield_screws`, `31_rubber_pads`, `32_rubber_rings`, `33_contact_washer`, `34_cam_nut`, `16_cam_locknut`) |
| Исходники | `cad/model.py`, `cad/params.py`, `cad/build.py` |
| Печатные детали | `cad/stl/frame.stl`, `table.stl`, `overlay.stl`, `podstol.stl`, `retainer.stl`, `cam_3/5/10.stl`; раскрой — `shield.stl` |
| Параметры печати | `cad/print.csv` |
| Эскиз в 3 проекциях (без кожуха) | `fig/vibrotable_views.svg` (лист 1/4) |
| Лист кожуха | `fig/vibrotable_shield.svg` (лист 2/4) |
| Лист кулачка (профиль, насечки, осевой стек) | `fig/cam_symmetric.svg` (лист 3/4) |
| Спецификация и параметры | `fig/vibrotable_spec.svg` (лист 4/4), `spec.csv`, `params.csv` |
| Изометрия (HLR) | `fig/iso.svg` (с кожухом), `fig/iso_open.svg` (без) |
| Проверки / массы | `cad/checks.csv` (215), `cad/mass.csv` |
| Рендеры | `pic/render_iso.png`, `render_iso_rear.png`, `render_left.png`, `render_top.png`, `render_front.png`, `render_shield.png`, `render_mechanism.png`, `render_cam.png`, `render_washer.png`, `render_ring.png`, `render_pad.png`, `render_retainer_down.png`, `render_podstol.png` |
| Превью листов | `pic/vibrotable_views.png`, `vibrotable_shield.png`, `cam_symmetric.png`, `vibrotable_spec.png`, `iso.png`, `iso_open.png` |

## 2. Постановка и границы

Исходная модель fix3 геометрически целостна (143/144 проверок), но после
инженерной экспертизы требовала семи корректировок. В fix4 исправлены
**только они**:

1. симметричный кулачок с 2 максимумами и 2 минимумами;
2. кожух из поликарбоната 5 мм;
3. контактная шайба с насечками + контргайка; фаска отверстия убрана;
4. резиновые буферы в углах верхних балок;
5. резиновые кольца на направляющих валах;
6. общий блок «кулачок + вал + 6200»;
7. вогнутые галтели R10 в стыках рамы — 20 шт.; верхние внутренние углы
   (X=20/140, Y=20/180) пропущены, потому что там стоят бортики кожуха и
   буферы (исключение, разрешённое п. 7).

Критичные замечания экспертизы (C1–C7) и важные (I1–I18) **не закрывались**
— по указанию README этапа они не выполняются. Поэтому модель fix4 — это
корректировка по семи пунктам, а не «готовая к эксплуатации» машина:
остаточные риски перечислены в разделе 8.

## 3. Базы и координаты

- **X** — вдоль рамы: 0 — передний торец, 360 — задний (вынос);
  виброотсек 0…160, вынос 160…360. Стол `X=−20…180`, подстолье
  `X=200…360`.
- **Y** — поперёк: рама 0…200, стол `Y=25…175`, кожух снаружи
  `Y=−5…0` и `200…205`.
- **Z** — вверх: 0 — плоскость установки, 300 — верх рамы; стол
  225…235, накладка 235…241; верхнее положение стола 241; кожух до 246;
  валы 142…308.
- Привод: ось `Y=100`, `Z=140`; 6200 в `X=10` и `150`; кулачок
  `X=74…86`; ролик `Z=205`; вал `X=−10…215`.
- Валы: `X=10/150`, `Y=50/150`; кольца `Z=170…177`.
- Кулачок: буртик вала `70,5…74`, шайба `86…88,5`, гайка `88,5…96,5`,
  контргайка `96,5…104,5`.
- Кожух: боковые панели `Y=−5…0/200…205`, бортики до `Z=246`, наружные
  `X=−5…0/160…165`.

Все размеры привязаны к этим базам; параметры — в [`params.csv`](./params.csv)
со статусом `fix4`.

## 4. Что сделано по семи замечаниям

| № | Замечание | Реализация | Проверка |
|---|---|---|---|
| 1 | Кулачок симметричный: 2 максимума и 2 минимума; отверстия по радиусам лепестков | Профиль `r(θ)=r0+e·cos2θ`; `r0=50−s/2`, `e=s/2`; максимум R50, минимум R50−s. Верх стола 241 для дисков 3/5/10, ход вниз. Отверстия — 4×Ø12: R38 на максимумах, R28 на минимумах. | `Кулачок — лепестки 2/2`, `симметрия 7,1e−15`, `R50/R45`, 4×Ø12, стенка 6/11 мм |
| 2 | Кожух из поликарбоната 4–5 мм: боковые панели, 4 внутренних и 2 наружных бортика; вынос не закрывать; саморезы с прижимной шляпкой | 8 пластин PC 5 мм: 2 боковые 160×300 (Y=−5…0, 200…205); 4 внутренних и 2 наружных бортика до Z=246; вынос X>165 открыт; 34 самореза M4×16, шляпка Ø8, пилоты Ø3,5. | `Кожух — толщина 5`, `зазор 5`, `вынос 0 мм³`, `саморезы 34`, пересечения с рамой/столом/пружинами — 0 |
| 3 | Контактная шайба с насечками + ещё одна гайка; на кулачке убрать фаску и сделать радиальные насечки 3 см | Стальная шайба Ø70/Ø10,5×2,5 с 8 рёбрами 3×29,8×0,5; гайка + контргайка M10; буртик вала Ø16; фаска 0; на кулачке 8 насечек 3×30×0,5, смещение 22,5°. | `Контактная шайба`, `Осевой стек`, `Кулачок — контактная шайба 0`, `Кулачок — буртик 0` |
| 4 | В углы верхних балок вклеить 2 прямоугольных кусочка резины: 5 мм до пружины, 3 мм до максимальной точки стола | 8 буферов (по 2 на пружину), 20×13×36, низ 244, верх 280; Y=26…39 и 61…74 (и зеркально для Y=150). | `Буферы 8/2`, `3 мм до стола`, `5 мм до пружины`, `Стол +2,9 — 0`, `Стол +3,1 — 200,9 мм³` |
| 5 | На валы между средней поперечиной и LMK надеть резиновые кольца; 3 мм до нижней границы | 4 кольца Ø18/Ø10,5×7, Z=170…177; при диске 10 мм низ LMK 180 → 3 мм; при 5 мм — 8 мм. | `Кольца 4`, `3 мм при диске 10`, `8 мм при диске 5`, `0 мм до поперечины` |
| 6 | Общий блок кулачка, оси и подшипников; менять, открутив и отжав прижимные балки | Блок: вал + кулачок + 2×6200 + шайба + гайки; `35_cartridge.step`; осевой упор — буртик вала. Извлечение: снять балки 21, опустить блок на 44 мм, выдвинуть вперёд. | `Блок, опущен на 44 мм — рама/уголки/стол/кожух 0`; `выдвинут вперёд — рама 0` |
| 7 | Галтели R10 в стыках рамы, кроме мест, где они мешают | 20 вогнутых галтелей R10: 4 нижних угла нижнего пояса, 8 стыков средних поперечин со стойками, 8 стыков верхних/нижних поперечин со стойками. Верхние внутренние углы (X=20/140, Y=20/180) пропущены — там бортики кожуха и резиновые буферы (исключение п. 7). | `Галтели R10 — 20`, рама одно тело; пересечения с кожухом/буферами 0 |

## 5. Конструкция

### 5.1. Кулачок и его фиксация

- Профиль: `r(θ)=50−s/2−(s/2)·cos2θ`; для дисков 3/5/10:
  - 3 мм: R47…50, `e=1,5`;
  - 5 мм: R45…50, `e=2,5`;
  - 10 мм: R40…50, `e=5`.
- Верхнее положение стола **241 мм** для всех дисков; ход вниз 3/5/10 мм.
  Стол совершает **2 колебания за оборот**; 5…15 Гц → 150…450 об/мин.
- Ложбинка 9,5×2 мм с коническими бортиками (58°) — самоцентровка ролика
  6200; центральное отверстие Ø10,2, **без фаски**.
- Облегчение: 4 отверстия Ø12: R38 на радиусах максимумов, R28 на
  минимумах; минимальная стенка 6 мм (диск 10).
- На правом торце — 8 радиальных насечек 3×30×0,5 мм, смещены на 22,5°
  от отверстий (не пересекают их).
- Фиксация: буртик вала Ø16 (70,5…74) + контактная шайба Ø70/Ø10,5×2,5
  с 8 рёбрами (входят в пазы) + гайка M10 + контргайка M10 nyloc.
  Конусные гайки на кулачке удалены; на опорных 6200 и ролике остались.
- Осевой стек 70,5…104,5 мм; пересечения «кулачок — шайба — гайка —
  контргайка — буртик» — 0.

### 5.2. Кожух

- 2 боковые панели PC 5 мм: X=0…160, Y=−5…0 и 200…205, Z=0…300 —
  закрывают бока виброотсека от нижней до верхней балки.
- 4 внутренних бортика: X=21…26, 134…139 и Y=21…26, 174…179,
  Z=246…300; низ 246 = верх стола 241 + 5.
- 2 наружных бортика: X=−5…0 и 160…165, Y=0…200, Z=246…300 —
  закрывают большую часть пружин.
- Вынос X>165 не закрыт; подстолье, дрель и хомуты открыты.
- Крепление: 34 самореза M4×16 с прижимной шляпкой Ø8; в раме — пилоты
  Ø3,5 (16 боковых + 12 внутренних + 6 наружных). Панели съёмные.
- Масса кожуха ≈868 г (PC 1,2 г/см³).

### 5.3. Буферы и кольца

- 8 резиновых буферов 20×13×36, низ 244, верх 280; по 2 на пружину
  (Y=26…39 и 61…74; для Y=150 — 126…139 и 161…174). До пружины 5 мм,
  до стола 3 мм.
- 4 кольца Ø18/Ø10,5×7, Z=170…177; при диске 10 мм до LMK 3 мм,
  при 5 мм — 8 мм; кольцо лежит на средней поперечине (0 мм).

### 5.4. Блок кулачка

- Вал Ø10, X=−10…215, буртик Ø16 X=70,5…74; 6200 в X=10/150;
  кулачок 74…86; шайба/гайки 86…104,5.
- Блок собран на валу; при снятых балках 21 опускается на 44 мм
  (верх кулачка 148 < 150 — низ средней поперечины), выдвигается вперёд.
- Геометрические проверки пути: 0 мм³ с рамой, уголками, столом и
  кожухом; при выдвижении на 100 мм вперёд — 0 мм³ с рамой.

### 5.5. Остальное

- Рама, стол, накладка, балки 21, уголки, подстолье, U-хомуты, дрель —
  без изменений fix3. Отверстия под валы: стол Ø11, накладка Ø12;
  карманы 6200 9,4 мм; балка 21 на 8 уголках.
- В раме добавлены 34 пилота Ø3,5 под саморезы кожуха.
- В раме добавлены **20 вогнутых галтелей R10** (fix4 п. 7): 4 нижних
  угла нижнего пояса, 8 стыков средних поперечин со стойками, 8 стыков
  верхних/нижних поперечин со стойками. Верхние внутренние углы
  (X=20/140, Y=20/180) пропущены — там бортики кожуха и буферы (исключение
  п. 7). Рама осталась одним телом; масса 1,8809 кг (+11 г).

## 6. Числовые проверки

Полный список — [`cad/checks.csv`](./cad/checks.csv): **215 проверок,
214 OK, 1 предупреждение**. Предупреждение прежнее: номинал пружины
12×1,0 даёт ID 10,0 при вале Ø10 (в модели 10,2). Ключевые новые:

| Проверка | Значение | Норма / вывод |
|---|---|---|
| Кулачок — лепестки / симметрия | 2/2; 7,1e−15 | 2 максимума и 2 минимума |
| Кулачок — Rmax/Rmin (диск 5) | 50/45 мм | ход 5 |
| Кулачок — ход по дискам | 3/5/10 мм | 2e |
| Кулачок — отверстия | 4×Ø12: R38/R28 | стенка 6/11 мм |
| Фаска отверстия | 0 мм | убрана |
| Насечки | 8 × 3×30×0,5 | на правом торце |
| Контактная шайба | Ø70/Ø10,5×2,5; 8 рёбер | позитивный упор |
| Осевой стек | 70,5…104,5 мм | без зазоров |
| Частота стола | 2 × вал; 150…450 об/мин | 2 лепестка |
| Кожух — толщина / бортик | 5 мм / 246 | 241 + 5 |
| Кожух — вынос | 0 мм³ при X>170 | не закрыт |
| Кожух — саморезы | 34 × M4×16, Ø8 | пилоты 3,5 |
| Буферы | 8; 244; 3/5 мм | 2 на пружину |
| Кольца | 4 × Ø18/Ø10,5×7 | 3 мм при диске 10 |
| Стол +2,9 / +3,1 — буферы | 0 / 200,9 мм³ | мягкий упор |
| Стол +4,9 / +5,1 — кожух | 0 / 240,2 мм³ | барьер |
| Кулачок 3/5/10: макс./мин. — ролик | 0 / 0 мм³ | касание |
| Блок, −44 мм — рама/уголки/стол/кожух | 0 / 0 / 0 / 0 мм³ | путь извлечения |
| Блок, −44 и −100 мм — рама | 0 мм³ | выдвижение вперёд |
| Габарит сборки | 380×215×308 | Y — кожух и шляпки |
| Пересечения (все пары) | 0 мм³ | < 0,5 |

Проверки стола при ±5 мм: 0 мм³ с рамой, балкой 21, уголками, валами,
подстольем и кожухом. Проверки буферов и колец — 0 с рамой, столом,
пружинами, LMK, валами и кожухом.

## 7. Массы

[`cad/mass.csv`](./cad/mass.csv): **6590,1 г** без дрели.

| Материал | Масса, г |
|---|---:|
| PETG (рама, балка 21, подстолье) | 2522 |
| PLA (стол, накладка, кулачок) | 661 |
| Поликарбонат (кожух) | 868 |
| Резина (буферы, кольца) | 92 |
| Сталь (валы, крепёж, уголки, шайба) | 1855 |
| Подшипники (LMK, 6200) | 592 |
| **Итого** | **6590** |

Рост к fix3 (5,49 кг) — **+1,09 кг**: кожух 0,87 кг, саморезы 0,06 кг,
буферы/кольца 0,09 кг, шайба/гайки кулачка 0,10 кг; при этом удалены
2 конусные гайки и 2 контргайки кулачка (−0,04 кг). Масса подшипников
по-прежнему завышена (сплошные LMK/6200): реальная оценка ≈0,37 кг меньше,
то есть ≈6,2 кг. Пружина в модели — оболочка (2,4 г/шт.), её масса
занижена; для динамики брать каталожную.

## 8. Визуальные проверки

Blender/EEVEE 1200×900, 64 сэмпла:

- `render_iso.png` — общий вид с полупрозрачным кожухом;
- `render_iso_rear.png` — задний торец: вынос и подстолье открыты;
- `render_left.png`, `render_front.png`, `render_top.png` — вид сбоку,
  спереди и сверху;
- `render_shield.png` — кожух более плотный (α=0,65), боковые панели и
  бортики;
- `render_mechanism.png` — механизм без рамы/стола: кулачок с 4
  отверстиями, ролик, кронштейн, балка 21;
- `render_cam.png`, `render_washer.png` — кулачок крупно: 2 лепестка,
  4 отверстия, буртик, шайба, гайки;
- `render_ring.png` — кольца на валах под LMK;
- `render_pad.png` — резиновые буферы в углу верхней балки;
- `render_retainer_down.png` — балка 21 опущена на 15 мм;
- `render_podstol.png` — подстолье, U-хомуты, дрель.

Листы:

- `fig/vibrotable_views.svg` (A3, 1:3) — 3 проекции без кожуха, размеры
  380/300/200/160/150/140/100 и выноски 1…35;
- `fig/vibrotable_shield.svg` — кожух, панели/бортики, 34 самореза,
  зазоры 5/3 мм, вынос открыт;
- `fig/cam_symmetric.svg` — 3 профиля 3/5/10, 4 отверстия, 8 насечек,
  шайба Ø70, осевой стек;
- `fig/vibrotable_spec.svg` — 35 позиций, параметры, массы, проверки;
- `fig/iso.svg`, `fig/iso_open.svg` — изометрия HLR с кожухом и без.

## 9. Принятые решения и отклонения

1. **Верх стола 241 одинаков для всех дисков**, а ход направлен вниз
   (3/5/10). Это отличается от fix3, где верхнее положение зависело от
   диска (188/190/195). Плюс — общая база и постоянный преднатяг пружин
   в верхней точке; минус — среднее положение для диска 10 ниже на 5 мм
   (236 против 238,5). Экспертное I7 «общая средняя высота» не выполнено;
   при необходимости сдвинуть ось ролика.
2. **4 отверстия Ø12 вместо 8×Ø10**. Одно отверстие на лепесток
   обеспечивает симметрию и стенку ≥6 мм; 8 отверстий на одной радиальной
   линии дали бы перемычку 2…3 мм. Если пользователь настаивает на 8 —
   добавить по второму отверстию на углах 45°/135° (смещение по радиусу).
3. **Насечки 3×30×0,5**: «3 см» прочитано как длина от края отверстия,
   ширина 3 мм. Если имелась в виду ширина 30 мм — решение нужно изменить
   (Interview.md, В3).
4. **Контактная шайба Ø70** (а не Ø30): перекрывает насечки 30 мм и
   распределяет затяжку по площади; масса 76,5 г. Проверить, что шайба не
   задевает кронштейн ролика (зазор 1,5 мм до стойки X=90).
5. **Кожух — только бока + верхние бортики.** Нижние передняя/задняя
   стороны открыты; это соответствует п. 2, но оставляет кулачок
   доступным спереди. См. раздел 10.
6. **Буферы — 8, по 2 на пружину** (а не 2 на весь угол): так они
   симметрично ограничивают отрыв стола у каждой пружины. Если нужны
   «2 кусочка всего», модель легко сократить до 2 (по одному на передние
   углы), но защита станет несимметричной.
7. **Кольца 7 мм, Z=170…177**: 10-мм кольцо при диске 10 мм вошло бы в
   среднюю поперечину. 7 мм дают 3 мм до LMK при максимальном диске и
   лежат на поперечине.
8. **Блок снимается после снятия балок 21 и опускания на 44 мм.** Это
   отличается от «только отжать балки»; проверено геометрически, но
   требует поддержки/домкрата. См. раздел 10.
9. **Саморезы в PETG, без вставок** — по п. 2. При частой разборке
   появятся вставки M4.
10. **Галтели R10** добавлены в 20 свободных стыков (низ 4, средние
    поперечины 8, верх/низ поперечин 8); верхние внутренние углы
    (X=20/140, Y=20/180) пропущены, потому что там стоят бортики кожуха и
    буферы — это исключение, прямо разрешённое п. 7. Галтели увеличили
    массу рамы на 11 г (1,8809 кг).

## 10. Остаточные риски и предложения

1. **Открытые нижние передняя/задняя стороны** (Z=20…246): вращающийся
   кулачок, вал, гайки и патрон доступны спереди. Экспертный C1 не
   закрыт. Предложение: съёмные нижние панели PC 5 мм на X=−5…0 и
   160…165 (или прозрачные окна), сохранив доступ к выносу.
2. **Смена блока** требует снять 16 болтов балок 21, поддержать и опустить
   блок на 44 мм, выдвинуть вперёд. Предложение: домкратный винт/клин под
   блок, быстросъёмные балки или направляющие; иначе операция неудобна.
3. **Пружины и контакт ролика** (C7 экспертизы): при диске 10 мм
   установленная длина 46 мм, сжатие 9 мм; сила контакта на верхних
   режимах не гарантирована. Предложение: `k≥1,3 Н/мм` или 6…8 пружин,
   регулировка преднатяга.
4. **6200 в PETG и балка 21 на трении** (C5/I4): не входили в семь
   пунктов; остаются. Предложение: стальные вкладыши/расточка, положительный
   упор балки.
5. **Дрель не выбрана** (C2/I11): заглушка Ø100; патрон, биение, осевой
   люфт и минимальные обороты не проверены. 150…450 об/мин — низкий
   диапазон; проверить устойчивость и момент.
6. **Саморезы в PETG** — ресурс 10…20 циклов; при частой смене блока
   поставить вставки M4.
7. **Кожух закрывает прижимные болты балок 21**; для смены блока панели
   снимаются. Предложение: вырез/лючок в боковой панели или невыпадающие
   саморезы.
8. **Поликарбонат и удары**: буферы защищают бортик, но при отрыве стола
   выше 246 мм удар придётся в PC; толщина 5 мм и крепление саморезами
   не рассчитывались. Проверить на испытаниях; при необходимости — 6 мм
   и стальная накладка.
9. **Стол 10-мм диск**: среднее положение 236, кольца/буферы/бортики
   проверены; пружины — см. п. 3.
10. **Галтели и жёсткость рамы** (I8): 20 галтелей R10 добавлены в
    свободные стыки; верхние внутренние углы остаются без галтелей из-за
    кожуха/буферов. Рама — один PETG-кусок 1,8809 кг; циклические
    испытания не выполнялись.

## 11. Ограничения

- Прочностные, жёсткостные, усталостные, модальные и трибологические
  расчёты не выполнялись; проверки — геометрия, зазоры, кинематика и
  массы.
- Динамика 2-лепесткового кулачка (гармоничность, отрыв ролика, силы)
  аналитически не пересчитана; оценка экспертизы для эксцентрика — только
  ориентир.
- Реальная дрель, патрон, рукоятка и хвостовик не моделировались;
  дрель — заглушка Ø100.
- Массы LMK/6200 завышены (сплошные тела); пружина — оболочка.
- Точность печати, посадки, биение и допуски не проверялись; чертежи —
  эскизные, не рабочие.
- Извлечение блока проверено геометрически (опускание/выдвижение), без
  веса, трения и поддержки.
- Поликарбонат, резина и саморезы — по свойствам/размерам, без испытаний.

## 12. Воспроизведение

```bash
cd stages/fix4/cad

freecadcmd build.py            # params/spec/checks/mass/print, STEP, STL
freecadcmd export_groups.py    # cad/stl/groups для рендера
blender -b --python render_views.py   # pic/render_*.png
freecadcmd draw_sheet.py       # fig/*.svg; кэш cad/cache/views_v6.json
```

Проекции HLR считаются `Drawing.project` по двум наборам: `full` (с
кожухом) и `open` (без кожуха и саморезов); кэш —
`cad/cache/views_v6.json`. Для принудительного пересчёта удалить кэш
(в FreeCAD 0.19 ключ `--force` перехватывается CLI).

Превью листов:

```bash
cd stages/fix4/fig
for f in vibrotable_views vibrotable_shield cam_symmetric vibrotable_spec; do
  inkscape "$f.svg" --export-type=png \
           --export-filename="../pic/$f.png" --export-dpi=150
done
inkscape iso.svg --export-type=png --export-filename=../pic/iso.png --export-dpi=150
inkscape iso_open.svg --export-type=png --export-filename=../pic/iso_open.png --export-dpi=150
```

## 13. Стоимость генерации

Модель `deepseek/deepseek-flash`: вход $0,15/млн, чтение кэша $0,003/млн,
выход (включая reasoning) $0,60/млн. Учёт — `session_v2` OpenCode, основная
сессия `ses_e7356bbc4ffesrwNzFdWzs3F7i`; снимок на 2026-10-30 12:41 UTC
(16:41 местного) после сборки модели, листов и рендеров. Служебные сессии
проверки инструментов (`ses_e735e023…`, `ses_e735ba3e…`, `ses_e735d603…`,
`ses_e735e5c3…`) в таблицу не входят.

| Категория | Токены | Стоимость, USD |
|---|---:|---:|
| **Всего** | **52 243 068** | **0,3123** |
| Входящие мимо кэша | 183 598 | 0,0275 |
| Закешированные входящие | 51 894 272 | 0,1557 |
| Исходящие (включая reasoning) | 215 198 | 0,1291 |

Итог по этапу fix4 на момент снимка: **52,24 млн токенов, $0,3123** (без
стоимости предыдущих этапов `model`, `fix1`, `fix2`, `fix3`, `expert`).
Финальный ответ и правки отчёта читают тот же кэш и могут добавить
ориентировочно $0,005…0,01.
