inutcin/boomboom/stages/fix3/Report.md

# Отчёт по этапу «Третье устранение замечаний по первоначальной версии модели»

Дата: 2026-10-30
Этап: `stages/fix3`
База: [`stages/fix2`](../fix2/README.md) (вторая доработка)
Инструменты: FreeCAD 0.19 (`Part`, `Drawing`/HLR), Blender 3.0.1 (EEVEE),
Python 3.10, Inkscape 1.1.2.

Этап выполнен по замечаниям [`README.md`](./README.md) этапа fix3 и решениям
[`Interview.md`](./Interview.md). Главные изменения: виброотсек сокращён на
40 мм (рама 360×200×300), в выносе нет поперечин, подстолье без рёбер и с
обычными болтами, балка 21 крепится 8 плоскими Γ-образными накладками 2 мм с
креплением к балке сбоку болтами M4 и стяжкой стоек прижимными болтами M4,
кулачок получил скошенный бортик, фаску и 8 отверстий облегчения, отверстия
под валы увеличены (Ø11 в столе, Ø12 в накладке).

## 1. Результат

| Результат | Файлы |
|---|---|
| 3D-модель, STEP сборки | `cad/step/vibrotable_assembly.step` |
| STEP деталей | `cad/step/*.step` (включая `14_angle`, `14_angles`, `24_clamp_bolts`, `24_clamp_nuts`, `24_beam_bolts`, `24_beam_nuts`, `18_podstol_bolts`, `27_podstol_nuts`) |
| Исходники модели | `cad/model.py`, `cad/params.py`, `cad/build.py` |
| Печатные детали STL | `cad/stl/frame.stl`, `table.stl`, `overlay.stl`, `podstol.stl`, `retainer.stl`, `cam_3/5/10.stl` |
| STL сборки (просмотр) | `cad/stl/vibrotable_assembly.stl` |
| Параметры печати | `cad/print.csv` |
| Эскиз в 3 проекциях, A3, HLR, М 1:3 | `fig/vibrotable_views.svg` |
| Изометрия (HLR) | `fig/iso.svg` |
| Спецификация и параметры, A3 | `fig/vibrotable_spec.svg` |
| Спецификация / параметры (данные) | `spec.csv`, `params.csv` |
| Проверки / массы | `cad/checks.csv`, `cad/mass.csv` |
| Рендеры | `pic/render_iso.png`, `render_iso_rear.png`, `render_left.png`, `render_top.png`, `render_front.png`, `render_mechanism.png`, `render_clamp.png`, `render_crab.png`, `render_bearing_pocket.png`, `render_shaft_nuts.png`, `render_podstol.png`, `render_retainer_down.png` |
| Превью листов | `pic/views_sheet.png`, `pic/spec_sheet.png`, `pic/iso_sheet.png` |

## 2. Базы и система координат

- **X** — вдоль рамы: 0 — передний торец, 360 — задний (вынос);
  виброотсек 0…160, вынос 160…360. Стол выходит за раму: `X=−20…180`.
- **Y** — поперёк: рама 0…200; стол `Y=25…175` (зазор 5 мм до боковых стоек).
- **Z** — вверх: 0 — плоскость установки, 300 — верх рамы; стол 225…235,
  накладка 235…241, верхние поперечины 280…300; валы 142…308 (без изменений).
- Привод: ось `Y=100`, `Z=140`; 6200 в `X=10` и `150`; кулачок `X=74…86`
  (ось 80); ролик `Z=205`. Вал привода — `X=−10…215`.
- Валы: `X=10/150`, `Y=50/150` (140×100); Ø10; низ 142, верх 308.
- Балки 21: `Z=110…130`, `Y=20,2…179,8` (в распор между стойками);
  карманы 6200 — ширина 9,4 мм, плечи 5,3 мм.
- Подстолье: `X=200…360`, `Y=0…200`, `Z=190…202`, без рёбер.
- Накладки балки 21: две на каждый конец (передняя и задняя грани),
  сталь 2 мм, полки 60×20:
  - горизонтальная — на боковой грани балки, `Z=110…130`, `Y=20…80`
    (у левой стойки) и `Y=120…180` (у правой); 2 болта M4 насквозь
    через балку при `Z=120`, `Y=30/60` и `140/170`;
  - вертикальная — вниз по стойке, `Y=0…20` (и `180…200`), `Z=50…130`,
    два паза 20 мм (`Z=58…78` и `84…104`);
  - прижимные болты M4 — по 2 на пару, через стойку при `Z=61` и `87`.

Все отверстия и центры подшипников привязаны к этим базам; параметры — в
[`params.csv`](./params.csv) со статусом `fix3`.

## 3. Что изменено по замечаниям fix3

| Замечание fix3 | Реализация |
|---|---|
| 1. На подстолье обычные болты, а не потайные | 4 болта **M6×45** с шестигранной головкой сверху (Z=202…206), шайба + гайка nyloc снизу верхней балки (Z=163,4…170). Зенковка из подстолья убрана: объём материала у болта 203 мм³ вместо 0. |
| 2. Убрать лишние поперечные балки в выносе | Передняя поперечина выноса (200…220) удалена, граничная поперечина обрезана до **140…160**. В выносе остались только 2 верхние продольные балки **140…360** (опираются на граничную поперечину по Z=170 и входят в стойки) и 2 нижние. Проверки: 0 мм³ в зонах X=210…330 на уровнях Z=171…189, 151…169 и 1…19. |
| 3. Убрать рёбра на подстолье | Подстолье **160×200×12 без рёбер** (габарит по Z 12 вместо 22). Проверка: 0 мм³ в зоне под подстольем. |
| 4. Вернуть плоские уголки fix1: без полок на верхней грани, передний «вниз», добавить уголки на заднюю грань | Балка 21 крепится **8 плоскими Γ-образными накладками** 2 мм: полки 60×20, горизонтальная ложится **на боковую грань** балки и стягивается с ней **2 болтами M4 насквозь** (жёстко, сбоку), вертикальная идёт **вниз по стойке** и имеет 2 паза 20 мм под прижимные болты M4. Пара накладок (передняя + задняя) обжимает стойку с двух сторон **2 болтами M4**. Нижней полки нет; над верхней гранью балки ничего нет (0 мм³ в зоне Z=131…170). |
| 5. Бортик ложбинки кулачка скошенный; фаска отверстия; отверстия для облегчения | Бортики — **конусы** от r_work (47,5) к r_flange (49,5) на толщине 1,25 мм — угол **58°**; ложбинка 2 мм; ролик самоцентрируется. Фаска **1×45° с обеих сторон** отверстия Ø10,2. Облегчение — **8 отверстий Ø10 на R32** (шаг 45°, шаг по хорде 24,5 мм). |
| 6. Отверстия под валы +1 мм в столе и +2 мм в накладке | От вала Ø10: **стол Ø11, накладка Ø12** (было Ø10,5 в обоих). Отверстия в поперечинах рамы остались Ø10,5 — вал относительно рамы неподвижен. |
| 7. Уменьшить глубину виброотсека на 40 мм и пересчитать всё | Виброотсек **160** (было 200), рама **360×200×300**, стол **200×150** (`X=−20…180`), валы в `X=10/150` (шаг 140), 6200 в 10/150, вал привода **−10…215** (L=225), кулачок по центру пролёта `X=74…86`, кронштейны ролика 68…70 и 90…92, пазы стола 45 и 110, подстолье 200…360, болты X=220/320, U-хомуты 250/300, дрель 210…340. |

Дополнительно к замечаниям (по уточнениям пользователя после первой сборки
fix3):

- в кулачке **8 отверстий** Ø10 на R32 вместо 6;
- форма накладок балки 21 — **Γ-образная** (полки 60×20, сталь 2 мм) вместо
  прямоугольных пластин 62×54 и полки под балкой; в спецификации (поз. 14)
  указано, что допускается замена покупной краб-системой «угол» для
  профильной трубы 20×20;
- крепление накладок к балке — **сбоку, 2 болта M4 насквозь** (было снизу,
  прижимные винты M6 в полку под балкой);
- ход опускания балки — **15 мм** (требуется 10 = 5 мм выхода кольца 6200 из
  паза + 5 мм запас);
- направляющие валы, пружины, ограничители и ход стола не менялись
  (L=166, Z=142…308) — высота устройства прежняя;
- узел ролика собран симметрично относительно X=80: 6200 75,5…84,5,
  конусные гайки 70…75,5 и 84,5…90, стойки кронштейнов 68…70 и 90…92,
  контргайки 60…68 и 92…100, ось 58…102; добавлена проверка
  «Кронштейн — гайки ролика»;
- количество резьбовых вставок M4 — 16 (только фланцы LMK10UU): накладки
  балки крепятся болтами насквозь;
- в спецификации (28 поз.) обновлены поз. 4, 5, 10, 11, 14, 18, 20…22, 24, 26.

## 4. Конструкция

### Рама (поз. 22)

- 4 стойки виброотсека 20×20 (X=0…20 и 140…160), 2 стойки выноса
  (340…360); верхний и нижний пояса виброотсека, нижний пояс выноса.
- Средние поперечины: передняя `X=0…20` и граничная `X=140…160`
  (`Z=150…170`); в выносе поперечин нет.
- Верхние продольные балки выноса `X=140…360`, `Z=170…190` — от граничной
  поперечины до задних стоек; на них опирается подстолье.
- Карманы 6200: `X=5,3…14,7` и `145,3…154,7`, R15, глубина 5.
- Отверстия валов Ø10,5; отверстия M4 (Ø4,5) под прижимные болты накладок
  (Z=61 и 87) через стойки; отверстия M6 под подстолье в верхних балках.
- Рама — одно тело (проверка `checks.csv`), 360×200×300, PETG.

### Балка 21 и накладки (поз. 21, 14, 24)

- Балка 21: PETG, сплошная 20×20, длина **159,6**, `Y=20,2…179,8`,
  `Z=110…130`; карман 6200 R15 шириной 9,4; 4 сквозных отверстия Ø4,5
  под болты накладок.
- Накладка: сталь 2 мм, Γ-образная, полки 60×20 (полный габарит 80×80):
  - горизонтальная полка `Y=20…80` (у правой стойки `120…180`), `Z=110…130`,
    прилегает к боковой грани балки, **2 отверстия Ø4,5**, не выходит за
    габарит балки;
  - вертикальная полка `Y=0…20` (и `180…200`), `Z=50…130`, два паза
    `20×5` для прижимных болтов.
- Крепление к балке: **2 болта M4×30 насквозь** (головка снаружи, гайка
  nyloc с внутренней стороны) — жёстко, болты работают на срез и на сжатие.
- Крепление к стойке: **2 прижимных болта M4×30 на пару** накладок (через
  стойку при `Z=61` и `87`) — регулируемое, трение по граням стойки.
- Опускание: при ослаблении 2 прижимных болтов пара с балкой опускается на
  **15 мм** (пазы 20 мм), верх балки уходит с 130 на 115 мм, кольцо 6200
  (низ 125 мм) освобождается — вал снимается вперёд. После опускания низ
  накладок — 35 мм (15 мм выше нижнего пояса).

### Стол и накладка (поз. 5, 4)

- Стол 200×150×10, `X=−20…180`, `Y=25…175`; отверстия под валы Ø11,
  отверстия M4 фланцев LMK, пазы под кронштейны ролика (X=45 и 110),
  4 угловых отверстия накладки.
- Накладка 200×150×6, сферическая вогнутость Ø140, h=2, отверстия под валы
  Ø12, 4 угловых потайных M4 с гайками nyloc.

### Валы, пружины

- 4 вала Ø10, `X=10/150`, `Y=50/150`, `Z=142…308` (L=166) — без изменений.
- 8 ограничителей WCS10FR Ø30×8: под средней поперечиной и над верхней.
- 4 пружины Ø12×1,0, установленная длина 36 мм; 8 шайб Ø18/Ø10,5×1,5.

### Привод, кулачок, ролик

- Вал привода — шпилька M10, `X=−10…215`, ось `Y=100`, `Z=140`.
- 6200 в `X=10` и `150`; карманы 9,4 мм; осевая фиксация — по 2 конусные
  гайки и по 2 контргайки M10 nyloc на подшипник:
  - 6200 №1: гайки `0…5,5` и `14,5…20`; контргайки `−8…0` и `20…28`;
  - 6200 №2: гайки `140…145,5` и `154,5…160`; контргайки `132…140` и
    `160…168`.
- Кулачок `X=74…86`: рабочая поверхность R45…50, ложбинка 9,5×2 мм со
  скошенными бортиками (58°), фаска 1×45°, **8 отверстий Ø10 на R32**;
  комплект дисков 3/5/10 мм. Гайки кулачка — конусные 66…74 и 86…94,
  контргайки 58…66 и 94…102.
- Ролик 6200 на оси M10 (58…102) между стойками кронштейнов 40×40×20×2;
  кронштейны крепятся к столу M4 в пазах, к ролику — 2 конусные гайки и
  2 контргайки.

### Подстолье и дрель

- Подстолье 160×200×12, PETG, `X=200…360`, `Y=0…200`, `Z=190…202`,
  **без рёбер**.
- Крепление: 4 болта **M6×45** с головкой сверху, шайба + гайка nyloc снизу
  верхней продольной балки.
- Дрель условная Ø100, ось `Z=140`, корпус `X=210…340`; U-хомуты M6
  `X=250/300`. В спецификации — против часовой стрелки, мягкий пуск,
  регулировка оборотов, фиксируемый курок.

### Крепёж (spec.csv, 28 позиций)

- 8 ограничителей, 4 вала, 4 пружины, 8 шайб, 4 LMK10UU, 3×6200.
- 8 конусных гаек M10, 8 контргаек M10.
- 8 накладок-уголков 2 мм; 8 прижимных болтов M4×30 + 8 гаек; 8 болтов
  M4×30 крепления к балке + 8 гаек.
- 16 резьбовых вставок M4 (только фланцы LMK), 16 винтов M4×16.
- 4 болта M6×45 + 4 гайки nyloc + 4 шайбы (подстолье), 8 гаек/шайб U-хомутов.

## 5. Числовые проверки

Полный список — [`cad/checks.csv`](./cad/checks.csv): **143 из 144 — OK**.
Единственное предупреждение — прежнее: номинал пружины 12×1,0 даёт ID 10,0
при вале Ø10 (в модели принят ID 10,2). Ключевые:

| Проверка | Значение | Норма / вывод |
|---|---|---|
| Рама — число тел | 1 | печать одним куском |
| Габарит рамы | 360×200×300 | п. 7: виброотсек −40 |
| Габарит сборки | 380×200×308 | X — вылет стола −20; Z — ограничители |
| Виброотсек / вынос | 160 / 200 | по замечанию |
| Стол | 200×150×10 | X=−20…180 |
| Шаг валов | 140×100 | X=10/150, Y=50/150 |
| Длина направляющего вала | 166 мм | без изменений (высота не меняется) |
| Стол + вылет | 20 / 20 мм | фланцы LMK: запас 10 / 10 и 5 / 5 мм |
| Отверстия под валы: стол / накладка | Ø11 / Ø12 | п. 6 (зазор 0,5 / 1,0) |
| Поперечины выноса (верх, середина, низ) | 0,000 мм³ | п. 2 |
| Рёбра подстолья | 0,000 мм³ | п. 3 |
| Головка болта подстолья | 6-гр., M6×45 | п. 1; зенковки нет (203 мм³ материала) |
| Карман 6200 — ширина / плечо | 9,4 / 5,3 мм | осевой зазор 0,2 мм |
| Рама / балка 21 — опорные 6200 | 0,000 / 0,000 мм³ | касание в кармане |
| Вал привода — концы / длина | −10…215 / 225 мм | п. 7 |
| Конусные гайки / контргайки 6200 | 4 / 4 | по 2 на подшипник |
| Задняя контргайка — подстолье | 32 мм | свободный ход до X=200 |
| Накладки — количество / на конец | 8 / 2 | передняя + задняя грани |
| Накладка — верх / низ | 130 / 50 мм | верх = верх балки 21 |
| Накладка — зазор до LMK / стола | 60 / 95 мм | ≥60 / ≥90 |
| Верхняя грань балки 21 | 0,000 мм³ | накладок сверху нет |
| Под балкой (нижняя полка) | 0,000 мм³ | зона Y=20…180, Z=100…109,5 |
| Накладка — пазы / ход опускания | 2 × 20 / **15** мм | требуется 10 (5 + 5 запас) |
| Накладка — низ после опускания / зазор | 35 / 15 мм | ≥5 |
| Балка 21 после опускания на 15 мм | верх 115 мм | < 125 (низ 6200) — кольцо свободно |
| Крепление накладок к балке | 2×M4 насквозь | жёсткое, сбоку |
| Прижимные болты накладок | 2×M4 на пару (8) | регулируемое к стойке |
| Подстолье, X×Y×Z | 160×200×12 | X=200…360 |
| Подстолье — зазор до стола / LMK | 20 / 23 и 30 мм | ≥15 / ≥5 |
| Кулачок — бортик / ложбинка | конус 58° / 2 мм | самоцентровка ролика |
| Кулачок — облегчение | 8×Ø10 на R32 | шаг по хорде 24,5 мм |
| Фаска отверстия кулачка | 1×45° | с обоих торцов |
| Ход стола | 5 мм (диски 3/10) | 3…10 мм |
| Пружина ID — вал Ø10 | 0,2 мм | ВНИМАНИЕ (номинал 10,0) |
| Стол при ходе −5 / +5 — рама, балка, накладки, валы, подстолье | 0,000 мм³ | без касаний |
| Кулачок 10 / 3 — ролик | 0,000 / 0,000 мм³ | касание |
| Пересечения (63 пары) | 0,000 мм³ | < 0,5 |
| Масса без дрели | **5,49 кг** | PETG 2,52; PLA 0,66; сталь 1,72; подшипники 0,59 |
| Область печати рамы | ≥370×210×310 | рама одним куском |

Массы — по объёмам модели и плотностям (PETG 1,27; PLA 1,24; сталь 7,85;
подшипники 7,85 г/см³). Для покупных 6200/LMK масса по модели завышена
(сплошные кольца/корпуса): реальные 6200 ≈15 г, LMK10UU ≈45 г — итог
завышен примерно на 0,35 кг. Пружина в модели — оболочка, её масса занижена
(≈10 г вместо ≈40 г).

Уменьшение массы относительно fix2 (6,01 кг) на 0,52 кг дают: рама короче
на 40 мм (1871 г против 2139 г), накладки 2 мм (322 г против 398 г у пластин
крабов) и подстолье без рёбер (484 г против 516 г); при этом добавились
16 болтов M4 с гайками (≈74 г) вместо 16 прижимных винтов M6 (107 г).

## 6. Визуальные проверки

Рендеры Blender/EEVEE 1200×900, 64 сэмпла:

- `render_iso.png` — общий вид: рама 360 мм, Γ-накладки на балке 21,
  подстолье без рёбер с головками болтов;
- `render_iso_rear.png` — задний торец: в выносе поперечин нет, подстолье
  вровень с рамой, балки выноса идут под ним;
- `render_left.png` — вид слева: вал, гайки, кулачок, подстолье, дрель;
- `render_top.png` — сверху: подстолье 160×200, 4 болта и U-хомуты, стол
  не перекрыт, поперечин в выносе нет;
- `render_front.png` — спереди: накладки, балка 21, стол, LMK;
- `render_mechanism.png` — механизм без рамы/стола: кулачок с 8 отверстиями
  и скошенным бортиком, ролик, кронштейн, балка 21, накладки;
- `render_clamp.png` — крупно накладка: Γ-образная, горизонтальная полка с
  2 болтами M4 к балке, вертикальная — с 2 пазами и прижимными болтами
  через стойку;
- `render_crab.png` — накладки на переднем и заднем концах балки;
- `render_bearing_pocket.png` — карман 6200, конусная гайка, контргайка,
  прижимной болт накладки;
- `render_shaft_nuts.png` — передний 6200: контргайка, конусная гайка,
  подшипник, кулачок;
- `render_podstol.png` — подстолье 160×200×12 без рёбер, головки болтов,
  U-хомуты, дрель;
- `render_retainer_down.png` — прижимные болты ослаблены, балка 21 с
  накладками опущена на 15 мм, 6200 освобождён.

Лист `fig/vibrotable_views.svg` (A3, 1:3) — три проекции HLR из модели
(спереди, слева, сверху) с размерами 380/300/200/160/150/140/100 и выносками
основных позиций 1…25; дрель — штриховым контуром. Лист
`fig/vibrotable_spec.svg` — спецификация 28 позиций, основные параметры,
масса по материалам, проверки/решения. `fig/iso.svg` — изометрия HLR.

## 7. Принятые решения и отклонения

1. **Накладка — плоская Γ-образная пластина 2 мм с полками 60×20.**
   Горизонтальная полка ложится на боковую грань балки 21 на всю её высоту
   (Z=110…130) и не выходит за габарит; вертикальная идёт вниз по стойке на
   80 мм. Толщина 2 мм — по указанию; при недостаточной жёсткости
   допускается 3 мм без изменения остальных размеров.
2. **Геометрия «перевёрнутой L» уточнена по месту.** Плоские полки 60×20
   на боковой грани балки дают именно Γ-профиль (горизонтальная полка на
   уровне балки, вертикальная — вниз), при этом нижней полки нет, а над
   балкой ничего не выступает.
3. **Крепление к балке — 2 болта M4 насквозь.** Они проходят через пару
   накладок и балку (3+20+3+гайка = 26 мм → M4×30), обеспечивают жёсткое
   соединение и работают на срез; резьбовые вставки в балке не нужны.
4. **Стяжка стоек — 2 прижимных болта M4 на пару** (через стойку и оба
   паза). Регулируемое трение по граням стойки; при ослаблении пара с
   балкой опускается.
5. **Ход опускания 15 мм.** Требуется 10 мм (5 мм — выход кольца 6200 из
   паза кармана + 5 мм запас); пазы 20 мм дают 15 мм хода с резервом, после
   опускания верх балки 115 мм < 125 мм (низ кольца).
6. **8 отверстий облегчения кулачка.** Ø10 на R32, шаг 45° (хорда 24,5 мм);
   не задевают ни отверстие Ø10,2, ни рабочую поверхность R45…50.
7. **Бортик ложбинки — конус 58°, а не 45°.** Буртик имеет толщину
   1,25 мм при подъёме 2 мм, поэтому 45° геометрически невозможны;
   получившийся конус 58° даёт ту же самоцентровку и печатается без
   поддержек.
8. **Болт подстолья M6×45.** 4 (головка) + 12 (подстолье) + 20 (балка) +
   1,6 (шайба) + 5 (гайка) = 42,6 мм → ближайший стандарт 45.
9. **Рёбра подстолья удалены полностью.** Толщина 12 мм сохранена;
   прогиб под дрелью не рассчитывался (см. ограничения).
10. **Резьбовые вставки M4 — только под фланцы LMK (16 шт.).**
11. **Основной `README.md` не обновлялся.** Он по-прежнему описывает
    сварную стальную раму из трубы 20×20×1,5 и стол, вытянутый по Y;
    фактическая модель — печатная PETG-рама сплошного сечения 20×20,
    360×200×300 и стол 200×150. Предлагается обновить раздел «Описание
    конструкции» после приёмки этапа.

## 8. Ограничения

- Прочностные, жёсткостные и динамические расчёты не выполнялись; профиль
  кулачка — эксцентриковая окружность (закон близок к гармоническому, но не
  идеально синусоидальный с учётом радиуса ролика).
- Балка 21 держится на трении прижимных болтов M4 о PETG-стойку: расчёт
  усилия не выполнялся. При проскальзывании — увеличить момент затяжки,
  поставить шайбы или перейти на M5 (места в пазах достаточно).
- Накладки 2 мм работают на изгиб в зоне пазов; при деформации — 3-4 мм или
  уменьшить зазор в пазах.
- Дрель — заглушка Ø100; реальная модель повлияет на патрон, U-хомут,
  положение вала и подстолье.
- 6200 на шпильке M10: резьба уменьшает посадочную поверхность; при люфте
  нужен вал с гладкими поясами под подшипники.
- Карман 9,4 мм: проверить фактическую ширину 6200 и точность печати.
- Печать рамы 360×200×300 одним куском требует принтера ≥370×210×310,
  поддержек и большого времени; 100 % заполнение — тяжело (1,87 кг).
- Подстолье 160×200×12 без рёбер: проверить прогиб под массой дрели
  (расчёт не выполнялся; при заметном прогибе — вернуть рёбра вдоль Y
  вне зоны дрели).
- После удаления поперечин выноса его жёсткость обеспечивают продольные
  балки и подстолье; проверить на собранном изделии.
- Пружина в модели — оболочка; массы покупных подшипников завышены;
  резьбы, большинство фасок, сварные швы и допуски не моделировались.
- Чертежи — эскизные (3 проекции + спецификация), не рабочие чертежи
  деталей; для фрезеровки/печати нужны отдельные рабочие чертежи и DXF.

## 9. Воспроизведение

```bash
cd stages/fix3/cad

freecadcmd build.py           # params.csv, spec.csv, checks, mass, print,
                              # STEP, STL
freecadcmd export_groups.py   # cad/stl/groups для рендера
blender -b -P render_views.py # pic/render_*.png
freecadcmd draw_sheet.py      # fig/*.svg; кэш cad/cache/views_v5.json
```

Для принудительного пересчёта проекций удалить `cad/cache/views_v5.json`
(в FreeCAD 0.19 ключ `--force` перехватывается CLI и не доходит до скрипта).
Превью листов:

```bash
cd stages/fix3/fig
inkscape vibrotable_views.svg --export-type=png \
         --export-filename=../pic/views_sheet.png --export-dpi=150
inkscape vibrotable_spec.svg  --export-type=png \
         --export-filename=../pic/spec_sheet.png --export-dpi=150
inkscape iso.svg              --export-type=png \
         --export-filename=../pic/iso_sheet.png --export-dpi=150
```

Проекции HLR считаются `Drawing.project` по полной сборке (видимые рёбра);
кэш — `cad/cache/views_v5.json`. Blender работает в fallback-режиме
управления цветом (в системе нет `colormanagement/config.ocio`); EEVEE при
этом даёт корректную картинку.

## 10. Стоимость генерации

Модель `deepseek/deepseek-flash`: вход $0,15/млн, чтение кэша $0,003/млн,
выход (включая reasoning) $0,60/млн. Учёт — по `session_v2` OpenCode,
сессия `ses_e7425d6fdffedSwPsEnTYnmaYp`; снимок на 2026-10-30 13:41.
Финальные вызовы этого ответа добавляют <1 %.

| Категория | Токены | Стоимость, USD |
|---|---:|---:|
| **Всего** | **41 695 062** | **0,3198** |
| Входящие мимо кэша | 285 655 | 0,0428 |
| Закешированные входящие | 41 153 536 | 0,1235 |
| Исходящие (включая reasoning) | 255 871 | 0,1535 |

Итог по этапу fix3: **41,70 млн токенов, $0,3198** (без стоимости предыдущих этапов
`stages/model`, `stages/fix1` и `stages/fix2`). Стоимость служебной
под-сессии проверки окружения — $0,0015 (не входит в таблицу).
