inutcin/boomboom/stages/fix1/Report.md

# Отчёт по этапу «Устранение замечания по первоначальной версии модели»

Дата: 2026-10-30
Этап: `stages/fix1`
База: [`stages/model`](../model/README.md) (первоначальная модель)
Инструменты: FreeCAD 0.19 (`Part`, `Drawing`/HLR), Blender 3.0.1 (EEVEE),
Python 3.10, Inkscape (превью листов).

Этап выполнен по замечаниям [`README.md`](./README.md) этапа fix1 и ответам
интервью [`Interview.md`](./Interview.md). Основные решения: рама — PETG,
сплошное сечение 20×20, печать одним куском; стол вытянут по X и выступает за
раму; средние боковые балки, центральная балка с окном и задняя нижняя
поперечина удалены; 6200 зажаты между средними поперечинами и балками 21;
крабы — сталь 1,2 мм; LMK10UU; стол/накладка/подстолье — печать.

## 1. Результат

| Результат | Файлы |
|---|---|
| 3D-модель, STEP сборки | `cad/step/vibrotable_assembly.step` (2,7 МБ) |
| STEP деталей | `cad/step/01…25_*.step`, `10_cam_3/5/10.step` |
| Исходники модели | `cad/model.py`, `cad/params.py`, `cad/build.py` |
| Печатные детали STL | `cad/stl/frame.stl`, `table.stl`, `overlay.stl`, `podstol.stl`, `retainer.stl`, `cam_3/5/10.stl` |
| STL сборки (просмотр) | `cad/stl/vibrotable_assembly.stl` |
| Параметры печати | `cad/print.csv` |
| Эскиз в 3 проекциях, A3, HLR | `fig/vibrotable_views.svg` |
| Изометрия (HLR) | `fig/iso.svg` |
| Спецификация и параметры, A3 | `fig/vibrotable_spec.svg` |
| Спецификация / параметры (данные) | `spec.csv`, `params.csv` |
| Проверки / массы | `cad/checks.csv`, `cad/mass.csv` |
| Рендеры | `pic/render_iso.png`, `render_iso_rear.png`, `render_left.png`, `render_top.png`, `render_front.png`, `render_mechanism.png`, `render_clamp.png`, `render_retainer_down.png` |
| Превью листов | `pic/views_sheet.png`, `pic/spec_sheet.png`, `pic/iso_sheet.png` |

## 2. Базы и система координат

- **X** — вдоль рамы: 0 — передний торец, 400 — задний (вынос);
  виброотсек 0…200, вынос 200…400. Стол выходит за раму: `X=−20…220`.
- **Y** — поперёк: рама 0…200; стол `Y=25…175` (зазор 5 мм до боковых стоек).
- **Z** — вверх: 0 — плоскость установки, 300 — верх рамы; стол 225…235,
  накладка 235…241, верхние поперечины 280…300; валы 142…308.
- Привод: ось `Y=100`, `Z=140`; подшипники 6200 в `X=10` и `190`;
  кулачок `X=94…106`; ролик `Z=205`.
- Валы: `X=10/190`, `Y=50/150` (180×100); Ø10; низ 142, верх 308.
- Балки 21: `Z=110…130`; средние поперечины `Z=150…170`;
  сёдла 6200 — по 5 мм в нижней грани поперечины и в верхней грани балки 21.

Все отверстия и центры подшипников привязаны к этим базам; параметры — в
[`params.csv`](./params.csv) (124 строки, статусы «эскиз / fix1 / принято /
расчёт»).

## 3. Что изменено по замечаниям

| Замечание fix1 | Реализация |
|---|---|
| Рама печатается пластиком одним куском | Рама — PETG, сплошное сечение 20×20, одно тело; STL `frame.stl`; принтер ≥410×210×310 |
| Средняя поперечная балка с боковых сторон лишняя | Удалены средние продольные балки по Y=0…20 и 180…200; валы крепятся к средним поперечинам переднего торца и границы выноса |
| Серединная балка с окном под кулачок лишняя | Удалена; кулачок вращается в открытом пространстве между поперечинами |
| Стыки и сочленения рамы гладкими, без перепадов | Наружные плоскости всех балок/стоек вровень; рама — единое тело; на границе выноса средняя поперечина продлена до X=220, чтобы передняя поперечина выноса опиралась на неё гранью, а не ребром |
| Нижняя поперечина с заднего торца лишняя | Удалена; задние стойки и верхние балки выноса оставлены, жёсткость — подстольем |
| Балка 21 — отдельная деталь того же профиля/сечения | PETG, сплошная 20×20, 2 шт., `Z=110…130`, седло 6200 в верхней грани; STL `retainer.stl` |
| 6200 зажаты между выемкой поперечины и выемкой балки 21 | Сёдла R15 по 5 мм; 6200 в `X=10/190`; балка 21 подтягивается крабом |
| Балка 21 идёт ниже средней поперечины, концами в стойки, крепится Т-крабом | Балка под поперечиной, концы через крабы у стоек; крайние 1,2 мм — толщина краба |
| Крабы ослабляются, балка опускается для замены вала | Крабы сталь 1,2 мм, 3×M4; при ослаблении балка опускается по стойке (рендер `render_retainer_down.png`) |
| Стол/накладка — печать; стол выходит за раму спереди и у выноса, зазор 5 мм до боковых стоек | Стол 240×150×10, `X=−20…220`, `Y=25…175`; накладка 240×150×6; оба — печать |
| Накладка крепится по углам потайными M4 с контрагайками | 4 угловых потайных M4, отступ 5 мм; гайки M4 nyloc снизу; центральное крепление удалено |
| Валы крепятся к верхней и средней поперечинам ограничителями | 8 ограничителей WCS10FR: по 2 на вал (под средней и над верхней поперечиной); валы через сплошные поперечины |
| Гайки, колеблющиеся со столом, — с нейлоновой вставкой | 6×M4 nyloc (накладка + кронштейны), 2×M10 nyloc (ролик) |
| Шайбы между пружиной и столом/поперечиной | 8 шайб Ø18/Ø10,5×1,5 — сверху и снизу каждой пружины |
| Фаска отверстия кулачка | 1×45° с обоих торцов отверстия Ø10,2 |
| Дрель против часовой стрелки, мягкий пуск, регулировка, фиксируемый курок | Внесено в спецификацию (поз. 28) и примечания листа; в 3D-модель дрель не входит |
| Подстолье — 3D-печать | PETG, 200×160×12 + рёбра 10×10 снизу, `Z=190…202` |
| Стол — 3D-печать | PLA, 240×150×10 |

Дополнительно, по примерам деталей этапа fix1, линейные подшипники заменены с
LMF10UU на **LMK10UU** (квадратный фланец 40×40, 4×Ø4,5 по сетке 32×32);
крепление фланцев — 16 винтов M4×16 во вставки стола. Ограничители —
WCS10FR Ø30×8 (в этапе 1 в модели был заниженный Ø16).

## 4. Конструкция

### Рама (поз. 22)

- 4 стойки виброотсека 20×20, 2 стойки выноса.
- Верхний пояс виброотсека: 2 продольные балки + 2 поперечины.
- Средний пояс: только 2 поперечины (передняя `X=0…20`, граничная
  `X=180…220`); средних продольных балок нет. Граничная поперечина продлена
  на 20 мм в вынос и служит опорой передней поперечине выноса.
- Нижний пояс виброотсека и выноса; задняя нижняя поперечина отсутствует.
- Верхние балки выноса `Z=170…190`; подстолье `Z=190…202`; задние стойки
  выноса сохранены.
- Отверстия валов Ø10,5 в верхних и средних поперечинах; сёдла 6200;
  отверстия M4 под крабы; отверстия M6 под подстолье.
- Рама — одно тело (проверка `checks.csv`: 1 solid).

### Балки 21 и крабы (поз. 21, 14)

- Балка 21: PETG, сплошная 20×20, длина 157,6, `Y=21,2…178,8`,
  `Z=110…130`; седло R15 в верхней грани; отверстия M4 под винты крабов.
- Краб: сталь 1,2 мм, угловой, по форме примера; пластина на передней грани
  (X=0 или X=180), вертикальная полка — по внутренней грани стойки,
  горизонтальная — на верхнюю грань балки 21. Два винта M4 крепят краб к
  стойке, третий — через горизонтальную полку в балку 21; при затяжке балка
  подтягивается вверх и зажимает 6200.
- При ослаблении крабов балка опускается по стойкам; подшипники
  освобождаются для замены вала привода. Показано в
  `render_retainer_down.png`.

### Стол и накладка (поз. 5, 4)

- Стол 240×150×10, `X=−20…220`, `Y=25…175`; вылет 20 мм спереди и у выноса;
  зазор 5 мм до боковых стоек.
- Накладка 240×150×6, сферическая вогнутость Ø140, h=2.
- Крепление накладки — 4 потайных M4 по углам (`±5 мм` от кромок), гайки
  nyloc снизу; в центре отверстия нет.
- LMK10UU: 4 шт.; фланцы 40×40 полностью на столе (запас 10 мм по X, 5 мм
  по Y); 16 винтов M4×16 во вставки стола.
- Кронштейны ролика крепятся 2 M4 в пазах стола `X=65/135`; головки
  потайные, закрыты накладкой (для регулировки накладка снимается).

### Валы, пружины

- 4 вала Ø10, `X=10/190`, `Y=50/150`, `Z=142…308`.
- 8 ограничителей WCS10FR Ø30×8: под средней поперечиной (`Z=142…150`) и
  над верхней (`Z=300…308`).
- 4 пружины Ø12×1,0, установленная длина 36 мм; 8 шайб Ø18/Ø10,5×1,5.
- Пружина ID 10,2 при вале Ø10 (единственное предупреждение проверок;
  номинал 12×1,0 даёт 10,0 — при сборке притереть/проверить).

### Привод и кулачок

- Вал привода — шпилька M10, `X=0…255`, ось `Y=100`, `Z=140`.
- 6200 в `X=10` и `190` зажаты между средней поперечиной и балкой 21.
- Кулачок `X=94…106`; рабочая поверхность R45…50, ложбинка 2 мм; комплект
  дисков 3/5/10 мм; фаска 1×45° на отверстии Ø10,2.
- Конусные гайки M10 и контргайки nyloc на кулачке — 2+2; на ролике — 2+2.
- Ролик 6200 на оси M10 между уголками 40×40×20×2; кронштейны — 2 шт.
- Осевое положение вала привода задаётся патроном дрели; отдельный упор не
  вводился (см. ограничения).

### Подстолье, дрель

- Подстолье 200×160×12, PETG, `Z=190…202`; два ребра 10×10 снизу по краям,
  `X=220…380`, вне зоны дрели Ø100; крепление 4 M6×25 во вставки верхних
  балок выноса.
- Задняя нижняя поперечина удалена; задние стойки и верхние балки выноса
  оставлены.
- Дрель: условная Ø100, ось `Z=140`, корпус `X=250…380`; U-хомуты M6
  `X=290/340`; в спецификации — против часовой стрелки, мягкий пуск,
  регулировка оборотов, фиксируемый курок.

### Крепёж (spec.csv, 28 позиций)

- 8 ограничителей, 4 вала, 4 пружины, 8 шайб, 4 LMK10UU, 3×6200,
  8 винтов фланцев и т.д.
- Вставки резьбовые: 28×M4 (16 фланцы LMK + 12 крабы), 4×M6 (подстолье).
- Гайки nyloc: 6×M4, 2×M10; конусные M10 — 4, контргайки M10 — 4.

## 5. Числовые проверки

Полный список — [`cad/checks.csv`](./cad/checks.csv): **90 из 91 — OK**;
единственное предупреждение — посадка пружины (номинал 12×1,0 даёт ID 10,0
при вале Ø10; в модели принят ID 10,2). Ключевые:

| Проверка | Значение | Норма / вывод |
|---|---|---|
| Рама — число тел | 1 | одно тело, печать одним куском |
| Габарит рамы | 400×200×300 | по эскизу |
| Габарит сборки | 420×200×308 | X — вылет стола −20; Z — ограничители 308 |
| Стол | 240×150×10 | X=−20…220, Y=25…175 |
| Вылет стола: спереди / у выноса | 20 / 20 | по fix1 |
| Зазор стол — боковые стойки | 5 / 5 | по fix1 |
| Шаг валов | 180×100 | X=10/190, Y=50/150 |
| Запас фланца LMK по X / Y | 10 / 10 и 5 / 5 | фланец 40×40 целиком на столе |
| Зазор гайки накладки — фланец LMK | 1,0 мм | ≥0,5 |
| Задняя нижняя поперечина | 0,000 мм³ | удалена |
| Средняя боковая балка | 0,000 мм³ | удалена |
| Центральная балка с окном | 0,000 мм³ | удалена |
| Седло 6200: поперечина / балка 21 | 150 / 130 | просвет 20, сёдла 5+5 |
| Перекрытие седел 6200 | 0,0 мм | зажим обеспечен |
| Рама — 6200 / балка 21 — 6200 | 0,000 / 0,000 мм³ | касание в сёдрах |
| Балка 21 — низ / верх | 110 / 130 | опускается при ослаблении крабов |
| Ход стола | 5,0 мм | диски 3 и 10 мм — 3…10 |
| Пружина установленная / при ходе | 36 / 31…41 мм | ≤55 |
| Зазор LMK — верх средней поперечины | 15 мм (номинал 20) | ≥5 |
| Зазор ограничителя Ø30 — балка 21 | 12 мм | ≥5 |
| Пружина ID — вал Ø10 | 0,2 мм | **ВНИМАНИЕ**: номинал даёт 10,0 |
| Кулачок — вал / фаска | 0,2 мм / 1×45° | Ø10,2; фаска с двух торцов |
| Дрель Ø100 — подстолье | 0,0 мм | прилегает снизу |
| U-хомут — дрель | 0,0 мм | раствор 100 |
| Пересечения (рама/стол/LMK/подстолье/кулачок/балки/крабы/валы/пружины/шайбы/кронштейны) | 0,000 мм³ | <0,5 |
| Стол ±5 мм — рама / балка 21 / крабы / валы | 0,000 мм³ | ход без касаний |
| Диски 10 и 3 мм — контакт ролика | 0,000 мм³ | касание |
| Масса без дрели | **5,63 кг** | рама 2,17; балка 21 0,16; стол/накладка/подстолье 1,20; кулачок 0,11; сталь 1,40; подшипники 0,59 |
| Область печати рамы | ≥410×210×310 | рама одним куском |

Массы — по объёмам модели и плотностям (PETG 1,27; PLA 1,24; сталь 7,85;
подшипники 7,85 г/см³). Для покупных 6200/LMK масса по модели завышена
(сплошные кольца/корпуса): реальные 6200 ≈15 г, LMK10UU ≈45 г — итог
завышен примерно на 0,35 кг. Пружина в модели — оболочка, её масса занижена
(≈10 г вместо ≈40 г); на итог влияет в пределах ±0,03 кг.

## 6. Визуальные проверки

Рендеры Blender/EEVEE 1200×900, 64 сэмпла:

- `render_iso.png` — общий вид со стороны вибростола: рама, стол/накладка,
  пружины, LMK, крабы, подстолье, дрель;
- `render_iso_rear.png` — со стороны привода и выноса;
- `render_left.png` — вид слева (−Y): камера, ролик, вал привода, подстолье,
  дрель;
- `render_top.png` — сверху: вогнутость накладки, 4 угловых винта, фланцы,
  подстолье;
- `render_front.png` — спереди (−X): стол, пружины, LMK, 6200 в седле,
  крабы;
- `render_mechanism.png` — механизм без рамы/стола: кулачок, ролик,
  кронштейн, ось, гайки, балка 21, краб, вал и опоры 6200;
- `render_clamp.png` — деталь зажима 6200: седло поперечины, седло балки 21,
  краб и его винт;
- `render_retainer_down.png` — крабы ослаблены, балка 21 опущена, 6200
  освобождён.

Лист `fig/vibrotable_views.svg` (A3, 1:2,5) — три проекции HLR из модели
(спереди, слева, сверху) с размерами 400/420/300/240/200/180/160/150/100 и
выносками поз. 1…25; дрель — штриховым контуром. Лист
`fig/vibrotable_spec.svg` — спецификация 28 позиций, основные параметры,
масса по материалам, проверки/решения. `fig/iso.svg` — изометрия HLR.

## 7. Принятые решения и отклонения

1. **LMK10UU вместо LMF10UU.** В примерах fix1 указан LMK10UU (квадратный
   фланец 40×40); в этапе 1 был LMF10UU. Пересчитаны отверстия стола (сетка
   32×32), винты M4×16, вставки. Если нужен LMF10UU — меняются только
   отверстия фланца.
2. **Стол 240×150, шаг валов 180×100.** Это следствие требования «стол
   вытянут по оси привода и выступает за раму»; прежние 150×240 и 100×170
   заменены. Фланцы LMK полностью на столе.
3. **Рама — PETG, сплошное 20×20, 100 % заполнение.** В ответе выбрано
   сплошное сечение; материал PETG принят по рекомендации. Масса рамы
   2,17 кг; при необходимости печати с 40–60 % заполнением масса/время
   уменьшатся, но прочность сёдел и стоек нужно проверять.
4. **Средняя поперечина у выноса продлена до X=220.** Иначе передняя
   поперечина выноса (`Z=170…190`) касалась её только по ребру, и объединение
   давало немногообразное тело (`frame.isValid() == False`, ложные
   пересечения в проверках). После продления — общая грань `Z=170`,
   рама валидна, число тел 1. Это внутренняя полка под поперечиной выноса;
   наружные плоскости остаются вровень.
5. **Крабы — сталь 1,2 мм, упрощённая форма.** Модель повторяет
   функциональную схему примера (пластина + две полки + 3 отверстия), но не
   воспроизводит декоративный треугольный вырез и скругления покупного краба.
   При покупке готового краба проверить отверстия/габарит; при
   недостаточной жёсткости — сталь 2 мм.
6. **Накладка — 4 угловых винта, отступ 5 мм.** Меньший отступ выбран, чтобы
   гайки не задевали квадратные фланцы LMK (зазор 1 мм). Головки потайные;
   кромка головки в 1 мм от кромки накладки — при печати проверить.
7. **Подстолье 12 мм с рёбрами.** Верх поднят до 202; рёбра 10×10 снизу по
   краям, `X=220…380`, вне дрели. Крепление — 4 M6 во вставки.
8. **Задние стойки выноса оставлены.** Удалена только нижняя задняя
   поперечина; стойки и верхние балки нужны для подстолья.
9. **Осевая фиксация вала привода — патрон дрели + гайки кулачка.**
   Отдельный упор/ограничитель на вал не вводился; при люфте добавить
   WCS10FR на вал за задним 6200.
10. **Гайки nyloc в модели — обычный шестигранник.** Нейлоновое кольцо не
    моделировалось; в спецификации и на листе указано nyloc.
11. **Основной README противоречит fix1** (сварная стальная рама из трубы
    20×20×1,5, стол, вытянутый по Y). После приёмки этапа предлагается
    обновить раздел «Описание конструкции» основного README.

## 8. Ограничения

- Прочностные, жёсткостные и динамические расчёты не выполнялись; жёсткость
  пружин подобрана конструктивно, профиль кулачка — эксцентриковая
  окружность (закон близок к гармоническому, но не идеально синусоидальный
  с учётом радиуса ролика).
- Дрель — заглушка Ø100; реальная модель повлияет на патрон, U-хомуты,
  положение вала и подстолье.
- 6200 на шпильке M10: резьба уменьшает посадочную поверхность; при люфте
  нужен вал с гладкими поясами под подшипники.
- Крабы 1,2 мм и винты M4 в PETG: проверить усилие зажима на образце;
  при недостатке — сталь 2 мм / M5.
- Печать рамы 400×200×300 одним куском требует принтера ≥410×210×310,
  поддержек и времени; 100 % заполнение — heavy. Проверить коробление и
  прочность сёдел.
- Стол/накладка 240×150 печатаются на столе ≥250×160; при меньшем —
  разбивать нельзя без изменения требования (цельная накладка).
- Пружина в модели — оболочка; массы покупных подшипников завышены;
  резьбы, фаски (кроме кулачка), сварные швы и допуски не моделировались.
- Чертежи — эскизные (3 проекции + спецификация), не рабочие чертежи
  деталей; для фрезеровки/печати нужны отдельные рабочие чертежи и DXF.
- В модели не проверялись: прочность краба при затяжке, смятие PETG под
  винтами M4, тепловая деформация рамы, уровень шума/вибрации.

## 9. Воспроизведение

```bash
cd stages/fix1/cad

freecadcmd build.py          # params.csv, spec.csv, checks, mass, print,
                             # STEP, STL
freecadcmd export_groups.py  # cad/stl/groups для рендера
blender -b -P render_views.py   # pic/render_*.png
freecadcmd draw_sheet.py        # fig/*.svg; кэш cad/cache/views_v4.json
```

Для принудительного пересчёта проекций удалить `cad/cache/views_v4.json`
(в FreeCAD 0.19 ключ `--force` перехватывается CLI и не доходит до скрипта).
Превью листов:

```bash
cd stages/fix1/fig
inkscape vibrotable_views.svg --export-type=png \
         --export-filename=../pic/views_sheet.png --export-dpi=150
inkscape vibrotable_spec.svg  --export-type=png \
         --export-filename=../pic/spec_sheet.png --export-dpi=150
inkscape iso.svg              --export-type=png \
         --export-filename=../pic/iso_sheet.png --export-dpi=150
```

Проекции HLR считаются `Drawing.project` по полной сборке (видимые рёбра);
кэш — `cad/cache/views_v4.json`. Blender работает в fallback-режиме
управления цветом (в системе нет `colormanagement/config.ocio`); EEVEE при
этом даёт корректную картинку.

## 10. Стоимость генерации

Модель `deepseek/deepseek-flash`: вход $0,15/млн, чтение кэша $0,003/млн,
выход (включая reasoning) $0,60/млн. Учёт — по `session_v2` OpenCode,
сессия `ses_e76b4fbccffeafIicxPvfvPbVf`; снимок на 2026-10-30 00:51.
Финальные вызовы этого ответа добавляют <2 %.

| Категория | Токены | Стоимость, USD |
|---|---:|---:|
| **Всего** | **17 793 923** | **0,2432** |
| Входящие мимо кэша | 247 605 | 0,0371 |
| Закешированные входящие | 17 289 344 | 0,0519 |
| Исходящие (включая reasoning) | 256 974 | 0,1542 |

Итог по этапу fix1: **17,79 млн токенов, $0,2432** (без стоимости
предыдущего этапа `stages/model`, у которого в отчёте 96,7 млн / $1,2521).
