inutcin/boomboom/stages/fix2/Report.md

# Отчёт по этапу «Повторное устранение замечаний по первоначальной версии модели»

Дата: 2026-10-30
Этап: `stages/fix2`
База: [`stages/fix1`](../fix1/README.md) (первая доработка)
Инструменты: FreeCAD 0.19 (`Part`, `Drawing`/HLR), Blender 3.0.1 (EEVEE),
Python 3.10, Inkscape 1.1.2.

Этап выполнен по замечаниям [`README.md`](./README.md) этапа fix2 и решениям
[`Interview.md`](./Interview.md). Главные изменения: карманы 6200 шириной
9,4 мм вместо выемки на всю ширину балки; по две конусные гайки и две
контргайки на каждый опорный 6200; краб-система из двух пластин 1,2 мм на
соединение, ничего не занимающая выше балки; подстолье 160×200 развёрнуто на
90°, крепится M6×35 через верхние продольные балки, задняя верхняя поперечина
удалена.

## 1. Результат

| Результат | Файлы |
|---|---|
| 3D-модель, STEP сборки | `cad/step/vibrotable_assembly.step` |
| STEP деталей | `cad/step/*.step` (включая `16_shaft_locknuts`, `17_shaft_conical_nuts`, `24_crab_*`, `27_podstol_nuts`) |
| Исходники модели | `cad/model.py`, `cad/params.py`, `cad/build.py` |
| Печатные детали STL | `cad/stl/frame.stl`, `table.stl`, `overlay.stl`, `podstol.stl`, `retainer.stl`, `cam_3/5/10.stl` |
| STL сборки (просмотр) | `cad/stl/vibrotable_assembly.stl` |
| Параметры печати | `cad/print.csv` |
| Эскиз в 3 проекциях, A3, HLR | `fig/vibrotable_views.svg` |
| Изометрия (HLR) | `fig/iso.svg` |
| Спецификация и параметры, A3 | `fig/vibrotable_spec.svg` |
| Спецификация / параметры (данные) | `spec.csv`, `params.csv` |
| Проверки / массы | `cad/checks.csv`, `cad/mass.csv` |
| Рендеры | `pic/render_iso.png`, `render_iso_rear.png`, `render_left.png`, `render_top.png`, `render_front.png`, `render_mechanism.png`, `render_clamp.png`, `render_crab.png`, `render_bearing_pocket.png`, `render_shaft_nuts.png`, `render_podstol.png`, `render_retainer_down.png` |
| Превью листов | `pic/views_sheet.png`, `pic/spec_sheet.png`, `pic/iso_sheet.png` |

## 2. Базы и система координат

- **X** — вдоль рамы: 0 — передний торец, 400 — задний (вынос);
  виброотсек 0…200, вынос 200…400. Стол выходит за раму: `X=−20…220`.
- **Y** — поперёк: рама 0…200; стол `Y=25…175` (зазор 5 мм до боковых стоек).
- **Z** — вверх: 0 — плоскость установки, 300 — верх рамы; стол 225…235,
  накладка 235…241, верхние поперечины 280…300; валы 142…308.
- Привод: ось `Y=100`, `Z=140`; 6200 в `X=10` и `190`; кулачок `X=94…106`;
  ролик `Z=205`. Вал привода — `X=−10…255`.
- Валы: `X=10/190`, `Y=50/150` (180×100); Ø10; низ 142, верх 308.
- Балки 21: `Z=110…130`; карманы 6200 — ширина 9,4 мм, плечи 5,3 мм;
  средние поперечины `Z=150…170`.
- Подстолье: `X=240…400`, `Y=0…200`, `Z=190…202`.
- Краб-система: пластины `X=−1,2…0` и `20…21,2` (переднее соединение),
  `178,8…180` и `200…201,2` (заднее); верх `Z=130`, низ `Z=48`.

Все отверстия и центры подшипников привязаны к этим базам; параметры — в
[`params.csv`](./params.csv).

## 3. Что изменено по замечаниям fix2

| Замечание fix2 | Реализация |
|---|---|
| Выемка под 6200 сделана на всю глубину поперечины и балки 21 | Карман шириной **9,4 мм** (6200 9 мм + 0,2 на сторону) только в центральной части; плечи по **5,3 мм**; радиальная глубина 5 мм. Наружное кольцо фиксируется в осевом направлении. |
| Вал не фиксируется в подшипниках, возможен осевой сдвиг кулачка | На каждый опорный 6200 — **2 конусные гайки** и **2 контргайки M10 nyloc**; вал удлинён до `X=−10`, передняя контргайка снаружи рамы. Всего на вал 4+4; с кулачком и роликом — 8+8. |
| Краб-система занимает место над балкой; на модели уголки, а не крабы | На соединение — **2 пластины 1,2 мм** 62×62 на передней и задней гранях стойки и балки, лапка 9 мм под балку. Верх — `Z=130` (вровень с балкой), ниже — до `Z=48`. Паз 24 мм (20 мм хода + радиус M6) позволяет опустить балку. |
| Подстолье под выступом стола, мешает столу/LMK | Подстолье **160×200×12**, `X=240…400`, `Y=0…200`; развёрнуто на 90°, вровень с задним торцом; до стола 20 мм, до LMK 30 мм. |
| Болты подстолья должны идти через верхние балки; лишняя балка и выступы не нужны | 4 потайных **M6×35** сквозь подстолье и верхние продольные балки (`X=260/360`, `Y=10/190`), гайки снизу. Задняя верхняя поперечина удалена. |

Дополнительно:
- удалена задняя верхняя поперечина — два участка `X=380…400`,
  `Y=0…50` и `150…200` при `Z=170…190`; жёсткость обеспечивает подстолье;
- рёбра подстолья развёрнуты вдоль Y: `X=240…248` и `392…400`,
  `Y=20…180`, вне зоны дрели;
- крабы получили вертикальный паз 24 мм (ход 20 мм), поэтому балка 21 опускается для
  замены вала привода;
- в спецификацию добавлены 4 конусные гайки и 4 контргайки на опорные 6200,
  4 болта M6×35 подстолья, 4 гайки M6, крепёж краб-системы.

## 4. Конструкция

### Рама (поз. 22)

- 4 стойки виброотсека 20×20, 2 стойки выноса; верхний пояс виброотсека,
  нижний пояс, верхние продольные балки выноса.
- Средние поперечины: передняя `X=0…20` и граничная `X=180…220`;
  боковых средних балок и центральной балки с окном нет.
- Задняя нижняя и задняя верхняя поперечины удалены; задние стойки
  соединены с продольными балками. Подстолье работает как диафрагма.
- Карманы 6200: `X=5,3…14,7` и `185,3…194,7`, R15, глубина 5.
- Отверстия валов Ø10,5; отверстия M6 под крабы через стойки; отверстия
  M6 под подстолье в верхних продольных балках.
- Рама — одно тело (проверка `checks.csv`).

### Балки 21 и краб-система (поз. 21, 14, 24)

- Балка 21: PETG, сплошная 20×20, длина 157,6, `Y=21,2…178,8`,
  `Z=110…130`; карман 6200 R15 шириной 9,4; глухие отверстия M4 снизу под
  винты лапок.
- Краб-система: 8 пластин 1,2 мм (2 на каждое из 4 соединений), 62×62,
  вертикальная часть `Z=48…130`, лапка 9 мм внутрь под балку на `Z=110`.
- В каждой пластине вертикальный паз `Z=76…100` (24 мм) под болт M6; болт проходит
  через стойку и обе пластины. Дополнительно 4 винта M4 на соединение
  входят снизу через лапки в балку 21 (резьбовые вставки).
- При ослаблении M6 пластины вместе с балкой опускаются на 20 мм; низ
  пластин остаётся на 8 мм выше нижнего пояса; 6200 освобождается.
- Верх краба `Z=130`; зазор до LMK 60 мм, до стола 95 мм.

### Стол и накладка (поз. 5, 4)

- Стол 240×150×10, `X=−20…220`, `Y=25…175`; накладка 240×150×6,
  сферическая вогнутость Ø140, h=2.
- Накладка — 4 угловых потайных M4 с гайками nyloc; центральное крепление
  отсутствует.
- LMK10UU: 4 шт., фланец 40×40, 16 винтов M4×16 во вставки стола.
- Кронштейны ролика — 2 M4 в пазах стола.

### Валы, пружины

- 4 вала Ø10, `X=10/190`, `Y=50/150`, `Z=142…308`.
- 8 ограничителей WCS10FR Ø30×8: под средней поперечиной и над верхней.
- 4 пружины Ø12×1,0, установленная длина 36 мм; 8 шайб Ø18/Ø10,5×1,5.

### Привод и кулачок

- Вал привода — шпилька M10, `X=−10…255`, ось `Y=100`, `Z=140`.
- 6200 в `X=10` и `190`; карманы 9,4 мм.
- Осевая фиксация: на каждый 6200 по 2 конусные гайки (5,5 мм) и 2
  контргайки M10 nyloc:
  - 6200 №1: гайки `0…5,5` и `14,5…20`; контргайки `−8…0` и `20…28`;
  - 6200 №2: гайки `180…185,5` и `194,5…200`; контргайки `172…180` и
    `200…208`.
- Кулачок `X=94…106`; рабочая поверхность R45…50, ложбинка 2 мм; комплект
  дисков 3/5/10 мм; фаска 1×45° на отверстии Ø10,2.
- Конусные гайки и контргайки кулачка — 2+2; ролика — 2+2.
- Ролик 6200 на оси M10 между уголками 40×40×20×2.

### Подстолье и дрель

- Подстолье 160×200×12, PETG, `X=240…400`, `Y=0…200`, `Z=190…202`;
  рёбра 8×10 вдоль Y у краёв `X=240…248` и `392…400`, `Y=20…180`.
- Крепление: 4 потайных M6×35 сквозь подстолье и верхние продольные балки,
  гайки M6 nyloc снизу; вставки M6 не используются.
- Дрель условная Ø100, ось `Z=140`, корпус `X=250…380`; U-хомуты M6
  `X=290/340`. В спецификации — против часовой стрелки, мягкий пуск,
  регулировка оборотов, фиксируемый курок.

### Крепёж (spec.csv, 28 позиций)

- 8 ограничителей, 4 вала, 4 пружины, 8 шайб, 4 LMK10UU, 3×6200,
  8 конусных гаек M10, 8 контргаек M10, 8 пластин крабов.
- Вставки M4: 16 фланцы LMK + 16 лапки крабов = 32.
- Болты подстолья: 4×M6×35 + 4 гайки M6 nyloc.
- Крепёж крабов: 4×M6×30 + 4 гайки M6 nyloc + 16×M4×12.

## 5. Числовые проверки

Полный список — [`cad/checks.csv`](./cad/checks.csv): **120 из 121 — OK**.
Единственное предупреждение — посадка пружины (номинал 12×1,0 даёт ID 10,0
при вале Ø10; в модели принят ID 10,2). Ключевые:

| Проверка | Значение | Норма / вывод |
|---|---|---|
| Рама — число тел | 1 | одно тело, печать одним куском |
| Габарит рамы | 400×200×300 | по эскизу |
| Габарит сборки | 420×200×308 | X — вылет стола −20; Z — ограничители 308 |
| Стол | 240×150×10 | X=−20…220, Y=25…175 |
| Шаг валов | 180×100 | X=10/190, Y=50/150 |
| Карман 6200 — ширина / плечо | 9,4 / 5,3 мм | 6200 9 мм + 0,2; плечо 5,3 |
| Осевой зазор 6200 в кармане | 0,2 / 0,2 мм | ≤0,2 |
| Рама / балка 21 — опорные 6200 | 0,000 / 0,000 мм³ | касание в кармане |
| Вал привода — концы | −10 / 255 | передняя контргайка снаружи |
| Конусные гайки / контргайки 6200 | 4 / 4 | по 2 на 6200; всего 8 / 8 |
| Вал привода — осевой люфт | 0 (зажат) | внутренние кольца зажаты |
| Передняя контргайка — вылет | 8 мм | габарит сборки не меняется |
| Краб — верхняя точка | 130 мм | вровень с верхом балки 21 |
| Краб — зазор до LMK / стола | 60 / 95 мм | ≥60 / ≥90 |
| Краб — паз / ход опускания | 24 / 20 мм | паз 24; ход 20 |
| Краб — низ после опускания / зазор | 28 / 8 мм | ≥5 |
| Подстолье, X×Y×Z | 160×200×22 | X=240…400, Y=0…200 |
| Подстолье — зазор до стола по X / Z | 20 / 23 мм | при нижнем ходе 18 мм |
| Подстолье — зазор до LMK | 30 мм | ≥5 |
| Подстолье — крепление | 4×M6×35 сквозь балки | 4 |
| Задняя верхняя поперечина | 0,000 мм³ | удалена |
| Стол при ходе −5/+5 — рама, балка 21, крабы, направляющие, подстолье | 0,000 мм³ | без касаний |
| Кулачок 10 / 3 — ролик | 0,000 мм³ | касание |
| Пересечения (рама, стол, LMK, подстолье, крабы, валы, гайки) | 0,000 мм³ | <0,5 |
| Масса без дрели | **6,01 кг** | PETG 2,81; PLA 0,79; сталь 1,82; подшипники 0,59 |
| Область печати рамы | ≥410×210×310 | рама одним куском |

Массы — по объёмам модели и плотностям (PETG 1,27; PLA 1,24; сталь 7,85;
подшипники 7,85 г/см³). Для покупных 6200/LMK масса по модели завышена
(сплошные кольца/корпуса): реальные 6200 ≈15 г, LMK10UU ≈45 г — итог
завышен примерно на 0,35 кг. Пружина в модели — оболочка, её масса занижена
(≈10 г вместо ≈40 г); на итог влияет в пределах ±0,03 кг.

Рост массы относительно fix1 (5,63 кг) в основном даёт краб-система:
8 пластин 1,2 мм вместо 4 уголков (+≈0,2 кг), а также 4 конусные гайки и
4 контргайки на опорных 6200.

## 6. Визуальные проверки

Рендеры Blender/EEVEE 1200×900, 64 сэмпла:

- `render_iso.png` — общий вид; видно, что крабы не выступают выше балки,
  подстолье развёрнуто и занимает всю ширину;
- `render_iso_rear.png` — задний торец: верхняя поперечина удалена,
  подстолье вровень с рамой, болты через продольные балки;
- `render_left.png` — вид слева: вал, гайки, кулачок, подстолье, дрель;
- `render_top.png` — сверху: подстолье 160×200, его крепление, стол не
  перекрыт;
- `render_front.png` — спереди: крабы, балка 21, стол, LMK;
- `render_mechanism.png` — механизм без рамы/стола: кулачок, ролик,
  кронштейн, балка 21, крабы;
- `render_clamp.png` — крупно узел краба: две пластины, лапка, паз, болт;
- `render_crab.png` — краб-система на переднем соединении;
- `render_bearing_pocket.png` — карман 6200 в поперечине, гайки вала;
- `render_shaft_nuts.png` — передний 6200: контргайка, конусная гайка,
  подшипник;
- `render_podstol.png` — подстолье 160×200, рёбра, болты, U-хомуты;
- `render_retainer_down.png` — крабы ослаблены, балка 21 опущена на 20 мм,
  6200 освобождён.

Лист `fig/vibrotable_views.svg` (A3, 1:2,5) — три проекции HLR из модели
(спереди, слева, сверху) с размерами 400/420/300/240/200/160/150/100/180 и
выносками поз. 1…28; дрель — штриховым контуром. Лист
`fig/vibrotable_spec.svg` — спецификация 28 позиций, основные параметры,
масса по материалам, проверки/решения. `fig/iso.svg` — изометрия HLR.

## 7. Принятые решения и отклонения

1. **Карман 6200 — 9,4 мм, а не 9,0.** Осевой зазор 0,2 мм на сторону
   компенсирует допуск печати и ширины подшипника; плечи 5,3 мм удерживают
   наружное кольцо. При необходимости карман можно притереть.
2. **По две контргайки на 6200.** Формально в замечании «ещё одной гайкой»
   можно прочитать одну контргайку на подшипник. Принято по одной на каждую
   конусную гайку — надёжнее при вибрации; при желании количество можно
   уменьшить до 6 без изменения геометрии.
3. **Передняя контргайка снаружи рамы.** В 20 мм стойки не помещаются
   подшипник 9 мм, две конусные гайки по 5,5 мм и две контргайки. Вал
   удлинён до `X=−10`; габарит сборки не меняется, так как стол выступает
   до `X=−20`.
4. **Краб-система упрощена.** Покупной G-краб (`../fix1/pic/krab_plan.png`)
   имеет декоративный треугольный вырез и 21° отгиб. В модели сохранены
   габарит 62×62, толщина 1,2, лапка 9 мм, паз 20 мм и схема «две пластины
   + болты + винты в профиль»; декоративный вырез не воспроизводился.
5. **Задняя верхняя поперечина удалена.** «Выступы на заднем торце под
   болты» трактованы как два верхних участка `X=380…400`, `Y=0…50/150…200`.
   Болты теперь идут через продольные балки; жёсткость даёт подстолье.
   Если имелись в виду только бобышки/полки, удаление поперечины можно
   пересмотреть.
6. **Подстолье 160×200, а не 200×160.** Разворот на 90° даёт длину 160 по
   X и ширину 200 по Y; задний торец совпадает с рамой, до стола 20 мм.
7. **Рёбра подстолья вдоль Y.** После удаления задней верхней поперечины
   рёбра `X=240…248` и `392…400` усиливают свободные края и не попадают в
   зону дрели Ø100.
8. **Крепление подстолья — сквозные M6×35 с гайками снизу.** Резьбовые
   вставки M6 не используются; болты проходят через подстолье и верхние
   продольные балки.
9. **Крабы — сталь 1,2 мм.** При недостаточной жёсткости рекомендуется
   2 мм или M5; проверять на образце.
10. **Основной `README.md` не обновлялся.** Он всё ещё описывает сварную
    стальную раму из трубы 20×20×1,5 и стол, вытянутый по Y; фактическая
    модель — PETG-рама сплошного сечения 20×20 и стол 240×150, вытянутый по
    X. После приёмки этапа предлагается обновить раздел «Описание
    конструкции» основного README.

## 8. Ограничения

- Прочностные, жёсткостные и динамические расчёты не выполнялись; профиль
  кулачка — эксцентриковая окружность (закон близок к гармоническому, но не
  идеально синусоидальный с учётом радиуса ролика).
- Дрель — заглушка Ø100; реальная модель повлияет на патрон, U-хомут,
  положение вала и подстолье.
- 6200 на шпильке M10: резьба уменьшает посадочную поверхность; при люфте
  нужен вал с гладкими поясами под подшипники.
- Крабы 1,2 мм и винты M4 в PETG: проверить усилие зажима на образце;
  при недостатке — сталь 2 мм / M5.
- Карман 9,4 мм: проверить фактическую ширину 6200 и точность печати;
  при необходимости притереть плечи.
- Печать рамы 400×200×300 одним куском требует принтера ≥410×210×310,
  поддержек и времени; 100 % заполнение — heavy. Проверить коробление и
  прочность карманов.
- Подстолье 160×200×12: проверить прогиб под массой дрели; при
  необходимости увеличить толщину/рёбра.
- После удаления задней верхней поперечины жёсткость задней части рамы
  обеспечивается только подстольем; проверить на собранном изделии.
- Пружина в модели — оболочка; массы покупных подшипников завышены;
  резьбы, фаски (кроме кулачка), сварные швы и допуски не моделировались.
- Чертежи — эскизные (3 проекции + спецификация), не рабочие чертежи
  деталей; для фрезеровки/печати нужны отдельные рабочие чертежи и DXF.

## 9. Воспроизведение

```bash
cd stages/fix2/cad

freecadcmd build.py          # params.csv, spec.csv, checks, mass, print,
                             # STEP, STL
freecadcmd export_groups.py  # cad/stl/groups для рендера
blender -b -P render_views.py   # pic/render_*.png
freecadcmd draw_sheet.py        # fig/*.svg; кэш cad/cache/views_v4.json
```

Для принудительного пересчёта проекций удалить `cad/cache/views_v4.json`
(в FreeCAD 0.19 ключ `--force` перехватывается CLI и не доходит до скрипта).
Превью листов:

```bash
cd stages/fix2/fig
inkscape vibrotable_views.svg --export-type=png \
         --export-filename=../pic/views_sheet.png --export-dpi=150
inkscape vibrotable_spec.svg  --export-type=png \
         --export-filename=../pic/spec_sheet.png --export-dpi=150
inkscape iso.svg              --export-type=png \
         --export-filename=../pic/iso_sheet.png --export-dpi=150
```

Проекции HLR считаются `Drawing.project` по полной сборке (видимые рёбра);
кэш — `cad/cache/views_v4.json`. Blender работает в fallback-режиме
управления цветом (в системе нет `colormanagement/config.ocio`); EEVEE при
этом даёт корректную картинку.

## 10. Стоимость генерации

Модель `deepseek/deepseek-flash`: вход $0,15/млн, чтение кэша $0,003/млн,
выход (включая reasoning) $0,60/млн. Учёт — по `session_v2` OpenCode,
сессия `ses_e76740a6cffejdIiVOqBkyYDwT`; снимок на 2026-10-30 01:53.
Финальные вызовы этого ответа добавляют <1 %.

| Категория | Токены | Стоимость, USD |
|---|---:|---:|
| **Всего** | **22 319 103** | **0,2029** |
| Входящие мимо кэша | 288 971 | 0,0433 |
| Закешированные входящие | 21 873 536 | 0,0656 |
| Исходящие (включая reasoning) | 156 596 | 0,0940 |

Итог по этапу fix2: **22,32 млн токенов, $0,2029** (без стоимости
предыдущих этапов `stages/model` и `stages/fix1`).
