inutcin/boomboom/stages/model/Report.md

# Отчёт по этапу «Формирование эскизов устройства по рисунку от руки»

Дата: 2026-10-29
Инструменты: FreeCAD 0.19 (`Part`, `Drawing`/HLR), Blender 3.0 (EEVEE), Python 3.10.

Реализация выполнена по уточнениям, полученным в интервью
([`Interview.md`](./Interview.md)). Предыдущая попытка (CadQuery, стол 156×156,
направляющие 108×108) сохранена отдельно как
[`Report_prev.md`](./Report_prev.md) и в каталогах `fig/prev`, `pic/prev`,
`cad/prev`; она не соответствует последним требованиям (стол 150×240,
выход за раму по Y, шаг валов 100×170, балки 21 вдоль X, подстолье 200×160)
и заменена этой сборкой.

## 1. Результат

| Результат | Файлы |
|---|---|
| 3D-модель, STEP сборки | `cad/step/vibrotable_assembly.step` (3,3 МБ) |
| STEP деталей | `cad/step/01…22_*.step`, `10_cam_3/5/10.step` |
| Исходники модели | `cad/model.py`, `cad/params.py`, `cad/build.py` |
| Печатные детали STL | `cad/stl/overlay.stl`, `cam_3.stl`, `cam_5.stl`, `cam_10.stl` |
| STL сборки (просмотр) | `cad/stl/vibrotable_assembly.stl` |
| Эскиз в 3 проекциях, A3, HLR | `fig/vibrotable_views.svg` |
| Изометрия (HLR) | `fig/iso.svg` |
| Спецификация и параметры, A3 | `fig/vibrotable_spec.svg` |
| Спецификация / параметры (данные) | `spec.csv`, `params.csv` |
| Проверки / массы | `cad/checks.csv`, `cad/mass.csv` |
| Рендеры | `pic/render_iso.png`, `render_iso_rear.png`, `render_left.png`, `render_top.png`, `render_mechanism.png` |
| Превью листов | `pic/views_sheet.png`, `pic/spec_sheet.png` |

## 2. Базы и система координат

- **X** — вдоль рамы: 0 — левый торец, 400 — правый; виброотсек 0…200,
  вынос дрели 200…400.
- **Y** — поперёк: рама 0…200, стол и накладка −20…220 (выход по 20 мм).
- **Z** — вверх: 0 — плоскость установки, 300 — верх рамы; стол 225…235,
  накладка 235…241, верхние балки 280…300.
- Привод: ось X, Y=100, Z=140; кулачок X=94…106; 6200 на X=60 и 140;
  ролик 6200 на Z=205; вал X=40…255.
- Валы: X=50/150, Y=15/185 (100×170); Ø10; низ 142, верх 308.

Все отверстия и центры подшипников привязаны к этим базам; параметры — в
`params.csv` (92 строки, статусы «эскиз / принято / расчёт»).

## 3. Конструкция

Спецификация — 24 позиции (`spec.csv`, лист `fig/vibrotable_spec.svg`):

1. Ограничитель вала Ø10 — 8 (по 2 на вал).
2. Вал Ø10, L=166 — 4.
3. Пружина 12×1,0, L0≈55 — 4.
4. Накладка 150×240×6, сфера Ø140, h=2 (PLA) — 1.
5. Стол 150×240×10 (фанера) — 1.
6. Кронштейн-уголок 40×40×20×2 — 2 (один кронштейн = два уголка).
7. Ось ролика M10 — 1.
8. LMF10UU — 4.
9. Подшипник 6200 — 3 (1 ролик + 2 опоры вала).
10. Кулачковый диск R45…50 — комплект 3/5/10 мм (PLA).
11. Подстолье 200×160×10 — 1.
12. U-образный хомут M6 (раствор ~100, h=150) — 2.
13. Потайной M4 — 3; 15. Гайка M4 — 3.
14. Т-образный краб — 4.
16. Контрагайка M10 — 6; 17. Конусная гайка M10 — 8.
18. Болт M6×40 — 4; 19. Гайка M6 — 4.
20. Вал привода — шпилька M10 — 1.
21. Балка фиксации подшипников — 2.
22. Рама сварная 400×200×300 (труба 20×20×1,5) — 1.
23. Винт M4×12 фланцев LMF10UU — 16.
24. Крепёж крабов M6 — 12.

Рама: четыре стойки 20×20, верхний и средний пояса, нижняя обвязка, вынос
200×200 с верхними балками на Z=170…190 под подстолье. Средняя балка —
сплошной брус 20×20 с окном X=92…108 под кулачок и сёдлами 6200 (глубина
5 мм); она же служит упором упавшего стола. Балки 21 — стальные бруски
20×20 под каждым 6200, прижимаются Т-крабами с выносом ~80 мм к угловым
стойкам; в балках — глухие отверстия под потайные M6.

## 4. Числовые проверки

Полный список — `cad/checks.csv` (**49 из 50 — OK**; одно предупреждение —
посадка пружины). Ключевые:

| Проверка | Значение | Норма / вывод |
|---|---|---|
| Габарит рамы | 400×200×300 | по эскизу |
| Габарит сборки | 400×240×308 | выход стола по Y 2×20; ограничители +8 |
| Стол | 150×240×10 | 5 мм до стоек, без вырезов |
| Шаг валов | 100×170 | X=50/150, Y=15/185 |
| Фланец Ø40 на столе | запас 5 мм по X, 15 мм по Y | фланец целиком |
| Ход стола | 5,0 мм (R45…50) | диски 3 и 10 мм — 3…10 мм |
| Низ стола при ходе вниз | 220 | LMF 186…215, верх балки 170 |
| Зазор LMF — средняя балка | 16 мм | ≥5 |
| Пружина установленная | 39…44 (5 мм); 34…44 (10); 37…44 (3) | ≤55 |
| Кулачок — окно балки | 2,0 мм | ≥1 |
| Ролик — буртик кулачка | 0,25 мм | ≥0,1 |
| Пружина ID — вал Ø10 | 0,2 мм (принято ID 10,2) | **ВНИМАНИЕ**: номинал 12×1,0 даёт 10,0 |
| Вал — отверстия стола / балок | 0,5 мм | Ø10,5 |
| Дрель Ø100 — подстолье | 0 | прилегает снизу |
| U-хомут — дрель | 0 | раствор 100 |
| LMF10UU — подстолье | 30 мм | подстолье Y=20…180 |
| Краб — вал привода | 4 мм | потайной M6, головка ≤131 |
| Пересечения (рама/стол/LMF/подстолье/кулачок/балки/крабы/валы/U-хомуты) | 0,000 мм³ | <0,5 |
| Стол ±5 мм — рама/балки/крабы | 0,000 мм³ | ход без касаний |
| Диски 10 и 3 мм — контакт ролика | 0,000 мм³ | касание |
| Масса без дрели | **8,03 кг** | рама 4,88; балки 0,42; стол/накладка/подстолье 0,72; привод/крепёж ≈2,01 |

Массы — по объёмам модели и плотностям (сталь 7,85; фанера 0,70; PLA 1,24
г/см³). Для покупных 6200/LMF масса по модели завышена (сплошное кольцо);
реальные 6200 ≈15 г, LMF10UU ≈45 г — на общий итог влияет в пределах ~0,3 кг.

## 5. Визуальные проверки

Рендеры Blender/EEVEE 1200×900, 64 сэмпла:

- `render_iso.png` — общий вид со стороны вибростола;
- `render_iso_rear.png` — со стороны привода;
- `render_left.png` — вид слева (−Y): видно зацепление ролика с кулачком,
  вал привода, патрон и U-хомуты дрели;
- `render_top.png` — сверху: вогнутость накладки, фланцы, подстолье;
- `render_mechanism.png` — механизм без рамы, стола и накладки: кулачок,
  ролик, кронштейн, ось, гайки, балка 21, краб, вал и опоры 6200.

Лист `fig/vibrotable_views.svg` (A3, 1:2,5) — три проекции HLR из модели
с размерами 400/300/240/200/150/100/170/160 и выносками поз. 1…23. На виде
спереди и сбоку передняя/ближняя рама условно не показаны, чтобы были видны
пружины, стол и кулачок (как на исходном эскизе); это отмечено в примечаниях.
Дрель показана штриховым контуром.

## 6. Принятые решения и отклонения от эскиза

1. **Стол 150×240** (X=25…175), без вырезов под стойки, зазор 5 мм; выход
   по Y на 20 мм с каждой стороны — чтобы фланец Ø40 LMF10UU целиком лежал
   на столе (запас 15 мм). Валы по X сдвинуты с ~170 до 100 мм (X=50/150);
   по Y оставлен шаг 170 (15/185) — иначе фланец не помещается.
2. **Шаг валов 100×170** — это компромисс между исходным 170×120 и
   требованием «фланец на столе»; в `params.csv` меняется одной строкой.
3. **Две балки 21 вдоль X** (X=20…90 и 110…180), по одной под каждым 6200.
   Т-крабы 14 с выносом ~80 мм крепятся к угловым стойкам, как в ответе
   интервью; в балках — глухие M6, в стойках — закладные.
4. **Окно в средней балке** X=92…108 — вынужденное: кулачок R50 на Z=140
   пересекает уровень 150…170. Балка выполнена сплошным брусом с сёдлами
   глубиной 5 мм (в трубе седло не держится).
5. **Кулачок** — эксцентриковый диск (рабочая окружность R45…50,
   эксцентриситет 2,5, ложбинка 2×9,5, толщина 12). Ход 5 мм; сменные диски
   3 и 10 мм (R45…48 / R45…55). Ложбинка удерживает ролик от осевого схода.
6. **Ролик один** (6200) на оси M10 с двумя уголками 40×40×20×2 и
   коническими гайками; у валов кронштейнов нет — только фланцы LMF10UU.
7. **Подстолье 200×160** (Y=20…180): не задевает задний фланец LMF10UU
   (подстолье Y=20…180, по X начинается с 200 — зазор до фланца 30 мм). Крепление — 4×M6 в поперечины выноса.
8. **Пружины 12×1,0**. Номинал даёт ID 10,0 при валу Ø10 — в модели принят
   фактический ID 10,2; при сборке вал в поясе пружины шлифовать до Ø9,8,
   если пружина окажется ровно 10,0 (единственное предупреждение проверок).
9. **Дрель** — условная модель Ø100, ось Z=140, патрон X=240…270; в STEP
   и спецификацию не входит, в рендере и на листе показана условно.
   «R=90-100» с эскиза трактуется как раствор хомута ~100 мм.
10. **Поз. 23, 24** добавлены в конец: 16 винтов M4×12 фланцев и 12 болтов
    крабов; исходные номера 1…22 сохранены.
11. **Вид спереди/сбоку** — с условно снятой передней/ближней рамой;
    иначе стойки и средняя поперечина закрывают пружины и кулачок.
12. **Рендер/эскиз**: дрель и U-хомуты показаны в сборе; в STEP дрели нет.

## 7. Ограничения этапа

- Прочностные, жёсткостные и динамические расчёты не выполнялись; жёсткость
  пружин подобрана конструктивно, профиль кулачка — эксцентриковая
  окружность (закон близок к гармоническому, но не идеально синусоидальный
  с учётом радиуса ролика).
- Дрель — заглушка; её реальная модель повлияет на патрон, хомуты и
  положение вала.
- Пружина в модели — оболочка постоянного сечения (упрощение); посадочные
  размеры и длина соответствуют.
- Резьбы, фаски, сварные швы и допуски не моделировались; STEP пригоден для
  правки/изготовления, но перед фрезеровкой нужны рабочие чертежи деталей.
- Не выпускались отдельные чертежи деталей и DXF раскроя фанеры; эскиз
  сборки и STEP/STL — по заданию этапа.
- Крабы и балки 21 проверены геометрически, но их жёсткость при затяжке
  требует проверки на собранном изделии.

## 8. Воспроизведение

```bash
cd stages/model/cad

freecadcmd build.py          # params.csv, spec.csv, checks, mass, STEP, STL
freecadcmd draw_sheet.py     # fig/*.svg; кэш проекций, --force для пересчёта
freecadcmd export_groups.py  # cad/stl/groups для рендера

blender -b -P render_views.py   # pic/render_*.png
```

Проекции HLR считаются `Drawing.project` (FreeCAD) по трём вариантам рамы:
передняя/ближняя рама условно снята; кэш — `cad/cache/views_v3.json`.
Blender работает в fallback-режиме управления цветом (в системе нет
`colormanagement/config.ocio`); EEVEE при этом даёт корректную картинку,
Cycles с включённым денойзером — нет (проверено, поэтому денойзер отключён,
используется EEVEE).

## 9. Стоимость генерации

Модель `deepseek/deepseek-flash`: вход $0,15/млн, кэш-чтение $0,003/млн,
выход $0,60/млн. Учёт — по `session_v2` OpenCode; снимок на 19:46, финальные
вызовы этого ответа добавляют <2 %.

### Этап в текущем прогоне (главная сессия + ранее запущенные подсессии)

| Категория | Токены | Стоимость, USD |
|---|---:|---:|
| **Всего** | **66 206 185** | **0,7878** |
| Входящие мимо кэша | 527 797 | 0,0792 |
| Закешированные входящие | 64 821 504 | 0,1945 |
| Исходящие (включая reasoning) | 856 884 | 0,5141 |

### Эта реализация (добавление после отчёта предыдущей попытки)

| Категория | Токены | Стоимость, USD |
|---|---:|---:|
| **Всего** | **6 570 746** | **0,0370** |
| Входящие мимо кэша | 9 454 | 0,0014 |
| Закешированные входящие | 6 534 528 | 0,0196 |
| Исходящие (включая reasoning 22 375) | 26 764 | 0,0161 |

### С учётом предыдущих попыток этапа за 2026-10-29

| Категория | Токены | Стоимость, USD |
|---|---:|---:|
| **Всего** | **96 674 822** | **1,2521** |
| Входящие мимо кэша | 697 127 | 0,1046 |
| Закешированные входящие | 94 537 856 | 0,2836 |
| Исходящие (включая reasoning) | 1 439 839 | 0,8639 |

Итог по этапу: **96,7 млн токенов, $1,2521**; из них на текущую реализацию
(после последнего отчёта) — **6,57 млн токенов, $0,0370**.
