inutcin/boomboom/stages/fix10l/tachdraw/Report.md

# Отчёт: tachdraw fix10l — чертежи изготавливаемых деталей по STEP

Дата: 2026-11-04
Этап: [`stages/fix10l`](../README.md)
Каталог: `stages/fix10l/tachdraw`
Промпт: [`techdraw_prompt.md`](./techdraw_prompt.md)

## 1. Задача

Создать в `fix10l` каталог `tachdraw`; по STEP-моделям сделать
чертежи только изготавливаемых деталей:

- отрезы труб с отверстиями/прорезями;
- стол, подстолье, накладка стола;
- уголки кронштейна;
- кулачковый диск.

Формат: A4 портрет, М 1:2, две проекции, только PDF. Размеры —
**на чертеже**, без координатных таблиц: габариты, расстояния от краёв
до центров отверстий и Ø, расстояния от краёв до кромок вырезов.
Покупные детали не чертить.

## 2. Что сделано

### 2.1. Комплект — 12 PDF

| Группа | Листы |
|---|---|
| Стол / подстолье / накладка | `06_table`, `11_podstol`, `07_overlay` |
| Отрезы труб | `12_B01`, `12_B02`, `13_B03`, `13_B04` |
| Уголки кронштейна | `27_bracket_left`, `27_bracket_right` |
| Кулачковый диск | `19_cam_3`, `19_cam_5`, `19_cam_10` |

Все — A4 портрет, 1 страница, М 1:2.

### 2.2. STEP

- Стол, подстолье, накладка, уголки и кулачки — индивидуальные STEP
  `cad/step`; все отверстия/вырезы уже в них.
- Для B01…B04 отдельных STEP не было: выделены из групповых
  `12_beams_long.step` / `13_beams_trans.step` в
  `tachdraw/cad/B01.step` … `B04.step` **со всеми отверстиями**.
- B01 — 3×Ø11 + Ø11 болт; B02 — 3×Ø11 (по STEP; в `beam_cut.csv`
  у B02 указан болт — расхождение);
- B03/B04 — 2×Ø11 + Ø10,2; стол — 18×Ø4,2 + 4×Ø11; подстолье —
  3×Ø11 + 4×Ø7; накладка — 4×Ø12 + 4×Ø4,2 + сфера Ø140; уголки —
  4×Ø4,2 + Ø10,5; кулачки — 8×Ø10 + S17,1.

### 2.3. Размеры

- габариты — на каждой проекции;
- отверстия — ординатами/цепями от левого/нижнего края; диаметры —
  выносками; **таблиц координат нет**;
- вырезы/элементы — размерными линиями/выносками с размером; для
  сферы накладки и шестигранника кулачка — Ø140 / S17,1;
- у B01/B02 (400 мм, вертикально) диаметры Ø11 — в примечании,
  позиции — ординатами.

## 3. Проверки

| Проверка | Результат |
|---|---|
| Число PDF | 12, по 1 странице |
| Формат | все A4 портрет 595,3 × 841,9 pt |
| Масштаб | S=0,5; 400→200; 200→100; 50→25 |
| Габариты | на каждой проекции |
| Отверстия | размеры на чертеже + Ø-выноски; без таблиц |
| Стол | 18×Ø4,2 + 4×Ø11 (по STEP) |
| Подстолье | 3×Ø11 + 4×Ø7 |
| Накладка | 4×Ø12 + 4×Ø4,2; сфера Ø140 |
| B01/B02 | Ø11 по STEP; B01 + болт |
| B03/B04 | 2×Ø11 + Ø10,2 |
| Уголки | 4×Ø4,2 + Ø10,5 |
| Кулачки | 8×Ø10 + S17,1 |

## 4. Расхождения

1. **Стол.** В `spec.csv` поз. 6 — 4×Ø4,2; в STEP — 18×Ø4,2
   (отверстия накладки, пружин и уголков). На чертеже все 18.
2. **B02.** В `beam_cut.csv` указан болт; в STEP B02 болтового
   отверстия нет (болт в B01, Y=15). На чертеже — по STEP.
3. **B01/B02** — 400 мм: диаметры Ø11 в примечании (тонкий вид), без
   выноски.

## 5. Ограничения

- скрытые линии не строятся;
- для стола (22 отверстия) — плотная цепная схема;
- кулачок: боковой вид — силуэт; допуски/шероховатость — примечаниями.

## 6. Воспроизведение

```bash
cd stages/fix10l/tachdraw
freecadcmd -c "p='batch.py'; g={'__name__':'__main__','__file__':p}; \
exec(compile(open(p).read(), p, 'exec'), g)"
```

## 7. Стоимость генерации

Модель `deepseek/deepseek-flash`, сессия
`ses_e5d2a0161ffe72Fheuh8esFkNn` (вход $0,15/млн, кэш $0,003/млн,
выход и reasoning $0,60/млн). Снимок `session_v2` на 2026-11-04 00:40.

| Категория | Токены | Стоимость, USD |
|---|---:|---:|
| **Всего** | **133 440 650** | **0,70955** |
| Входящие мимо кэша | 236 962 | 0,03554 |
| Закешированные входящие | 132 744 064 | 0,39823 |
| Исходящие (output) | 127 209 | 0,07633 |
| Исходящие (reasoning) | 332 415 | 0,19945 |
| **Исходящие всего (output + reasoning)** | **459 624** | **0,27577** |

- Общее число токенов: **133 440 650** (0,70955 USD).
- Входящие мимо кэша: **236 962** (0,03554 USD).
- Закешированные входящие: **132 744 064** (0,39823 USD).
- Исходящие (output + reasoning): **459 624** (0,27577 USD).

Стоимость включает только эту сессию; стоимость этапа fix10l —
в [`../Report.md`](../Report.md).
