inutcin/boomboom/stages/correct/1/Report.md

# Отчёт по этапу «Замечания и корректировки по модели. Часть 1»

Дата: 27.10.2026  
Этап: `stages/correct/1`  
Исходная модель: `stages/model/figs/*.svg`, `stages/model/Report.md`  
Цель проекта: [README.md](../../../README.md)

## 1. Что сделано

Выпущено шесть листов A3. Для каждого узла из замечания 1 есть изометрия;
для столешницы и узла ролика дополнительно показаны разрезы и увеличенные
детали.

| Лист | SVG | PNG | Содержание |
|---:|---|---|---|
| 1 | `figs/table.svg` | `pics/table.png` | Столешница: облегчение, вогнутость, бортик, шарик |
| 2 | `figs/subtable.svg` | `pics/subtable.png` | Подстолье: окно Ø250, отверстия шпилек и U-болтов |
| 3 | `figs/roller_unit.svg` | `pics/roller_unit.png` | Крепление ролика к столу: изометрия снизу, вид снизу, местный разрез Д–Д |
| 4 | `figs/roller_axle.svg` | `pics/roller_axle.png` | Ось ролика: разрез А–А, разнесённая изометрия, деталь Е |
| 5 | `figs/drill_mount.svg` | `pics/drill_mount.png` | Крепление дрели: изометрия и разрез В–В |
| 6 | `figs/cam_mount.svg` | `pics/cam_mount.png` | Крепление диска: вид, изометрия, деталь Б |

Листы строятся параметрическим генератором:

```bash
node stages/correct/1/tools/generate.js
```

PNG получены из SVG через Inkscape при 200 dpi: 3307 × 2339 px (A3,
420 × 297 мм).

## 2. Замечание 1. Понятность креплений

### 2.1. Крепление роликов (листы 3 и 4)

Узел разбит на два листа, чтобы показать и крепление к столу, и сборку оси.

**Лист 3 — крепление к столешнице.**

- Изометрия снизу: видно скруглённое основание кронштейна, две скруглённые
  щеки, подшипник между ними, шестигранную головку болта, шестигранную гайку
  и две шестигранные гайки M8 снизу; столешница показана контуром.
- Вид снизу 1:1: основание **84 × 50**, R5; два отверстия/гайки M8 с шагом
  **64** мм (x = ±32), щеки (наружный размер 19, просвет 11), ролик **Ø35**,
  болт **M12×45**.
- Местный разрез Д–Д 2:1: потайной винт **M8×20 с внутренним шестигранником**
  проходит через столешницу, основание кронштейна, шайбу и гайку; головка
  утоплена в лунку и закрыта пробкой **Ø16** заподлицо. Показаны местная
  толщина фанеры (9,3 мм под лункой), кронштейн 4 мм, шайба Ø16 и гайка M8.
  Отдельно показан вид на головку винта с шестигранным отверстием под ключ.

**Лист 4 — ось и подшипник.**

- Разрез А–А 1:1 по оси ролика и одновременно по винтам M8: столешница,
  основание, щеки, подшипник, втулка, ось, шайбы, головка болта и гайка;
  винты M8 и пробки также видны в разрезе.
- Подшипник **6202-2RS** (35 × 15 × 11) показан с наружным и внутренним
  кольцами, шариками и уплотнениями 2RS.
- Ось — болт **M12×45 с шестигранной головкой**; в отверстие подшипника Ø15
  установлена переходная втулка **15/12 × 11**. Шайбы Ø24,
  самоконтрящаяся **шестигранная** гайка M12.
- Кронштейн сварной из полосы 4 мм: основание **84 × 50 × 4**, две щеки
  **50 × 55 × 4**, углы скруглены **R5**; просвет между щеками 11 мм,
  наружный размер 19 мм.
- Разнесённая изометрия показывает порядок сборки:
  кронштейн → подшипник с втулкой → шайбы → болт/гайка. Головка болта и гайка
  показаны шестигранными.
- Деталь Е 3:1 крупно показывает наружное кольцо, шарики, внутреннее кольцо,
  втулку 15/12 и ось M12.
- Дополнительно добавлены два вида по оси: со стороны гайки и со стороны
  головки болта — шестигранники видны в плане; показаны шайба и ролик.

**Уточнение по назначению кронштейна.** Кронштейн не является направляющей
диска по радиусу: диск катится по ролику, а щёки кронштейна образуют защитную
скобу и ограничивают осевой уход. Поэтому увеличены основание (84 × 50) и
щёки (50 × 55 по z), углы скруглены R5; зазор между щеками 11 мм
соответствует ширине подшипника, диск 6 мм имеет запас 2,5 мм на сторону.

**Устранены несоответствия старой модели:** у подшипника 6202-2RS отверстие
Ø15, а в модели была ось M10 — принята ось M12 с втулкой 15/12. Крепёж к
столу уточнён: вместо условного «винта M8×30» — потайной **M8×20** с пробкой
Ø16, что соответствует местной толщине столешницы под лункой.

### 2.2. Подстолье (лист 2)

- Плита **500 × 400 × 18** мм, фанера.
- Окно **Ø250** мм для прохода кулачкового диска.
- Четыре отверстия **Ø14** под шпильки M12: 440 × 340 мм.
- Четыре отверстия **Ø9** под U-болты крепления дрели:
  (130; ±45) и (260; ±45).
- Изометрия и план 1:8 с размерами; левые отверстия U-болтов удалены от
  кромки окна на 12,6 мм, чтобы шайбы не нависали над окном.

### 2.3. Крепление дрели (лист 5)

- Дрель с корпусом Ø70 прижата к нижней плоскости подстолья через резиновую
  подкладку **2 мм**.
- Два **U-болта M8** под трубу Ø80: ножки на расстоянии 90 мм (z = ±45),
  радиус седла 45 мм; между корпусом и U-болтом — резиновая подкладка-седло
  **10 мм**.
- Ножки проходят через отверстия Ø9 в подстолье; сверху — шайбы и
  самоконтрящиеся шестигранные гайки M8.
- Разрез В–В (1:2) показывает затяжку, подкладки, отверстия и положение
  корпуса относительно окна.

**Устранено несоответствие старой модели:** вместо условного «хомута»-
параллелепипеда показаны два реальных U-болта с подкладками.

### 2.4. Крепление диска (лист 6)

- Кулачковый диск **Ø226 × 6** мм, центральное отверстие **Ø40**.
- Оправка: хвостовик **Ø10 × 40** в патрон, фланец **Ø40 × 6**; фланец
  входит в отверстие диска заподлицо и центрирует его.
- Прижим: винт **M8×25 с внутренним шестигранником** и шайба **Ø60 × 4**;
  шайба прижимает диск к фланцу по кольцу вокруг отверстия Ø40.
- В листе: вид на диск 1:2 с профилем `r(φ) = R + e·cos(2φ)`, базовой
  окружностью R110, метками Rmax = 113 и Rmin = 107; разнесённая изометрия;
  деталь Б 1:1 с разрезом по оправке.

**Устранено несоответствие старой модели:** диск больше не «висит» на патроне
без пояснения — показана оправка, фланец, шайба и винт.

## 3. Замечание 2. Лёгкая платформа

Кинематика сохранена: **дрель вращает кулачковый диск**, а стол колеблется на
пружинах. Формулировка «дрель прокручивает платформу» понята как требование
снизить массу подвижной части, чтобы привод не терял обороты.

Принято:

- столешница **12 мм** вместо 18 мм (берёзовая фанера);
- масса заготовки 12 мм: ≈ 1,63 кг;
- минус материал лунки ≈ 0,10 кг;
- бортик ≈ 0,09 кг;
- шайбы, гайки, винты, пробки ≈ 0,2 кг;
- итого стол ≈ **1,9 кг** (было ≈ 2,5 кг у заготовки 18 мм);
- подвижная сборка со столешницей, двумя кронштейнами, роликами и шариком —
  ≈ **2,6 кг**.

Расчёт ориентировочный; окончательная масса — по фактическим материалам.
Снижение массы стола примерно на 0,6…0,7 кг уменьшает инерционную нагрузку
на дрель. Достаточность момента дрели проверяется на этапе экспертизы.

## 4. Замечание 3. Вогнутая платформа и шарик

- Шарик — сталь **Ø20** мм, масса ≈ 33 г.
- В столешнице выполнена сферическая лунка **Ø360 × 3** мм. В модели
  используется параболоид с той же стрелой; радиус кривизны в центре
  **R ≈ 5400** мм (R = 180² / (2·3)).
- По периметру — бортик **10 × 10** мм: страховка от падения шарика.
- Лунка обеспечивает возврат шарика к центру при выходе из положения
  равновесия; бортик не даёт шарику уйти с платформы.
- В листе 1: изометрия, разрез А–А 1:2,5 и деталь А 1:1 с шариком, глубиной
  3 мм и толщиной 12 мм.

**Остаточный риск:** между лункой Ø360 и бортиком остаётся плоский борт
(10…60 мм). Если шарик выйдет из лунки на этот борт, возврат к центру не
гарантирован. Предложение на экспертизу/часть 2: выполнить вогнутость по всей
плоскости стола (эллиптическая чаша, глубина ≈ 5 мм) либо наклонный борт от
бортика к лунке. Это также записано в `Interview.md`.

## 5. Основные параметры после корректировки

| Параметр | Значение | Примечание |
|---|---|---|
| Столешница | 500 × 400 × 12, фанера | лунка Ø360 × 3, R ≈ 5400 |
| Бортик | 10 × 10 | по периметру |
| Шарик | Ø20, сталь | масса ≈ 33 г |
| Подстолье | 500 × 400 × 18, фанера | окно Ø250 |
| Шпильки | 4 × M12 | отверстия Ø14, 440 × 340 |
| Ролики | 2 × 6202-2RS | 35 × 15 × 11 |
| Кронштейн ролика | 84 × 50 × 4, R5 | сварной, щеки 50 × 55 |
| Ось ролика | M12×45 (шестигр.) + втулка 15/12×11 | кронштейн 4 мм |
| Крепление ролика | 4 × M8×20 (вн. шестигр.) + пробки Ø16 | по 2 на кронштейн |
| Крепление дрели | 2 × U-болт M8 под Ø80 | подкладки 10 и 2 мм |
| Отверстия U-болтов | (130; ±45), (260; ±45), Ø9 | в подстолье |
| Диск | Ø226 × 6, отв. Ø40 | R110, e3, два лепестка |
| Оправка | Ø10×40 / Ø40×6 | фланец в отверстии диска |
| Прижим диска | M8×25 (вн. шестигр.) + шайба Ø60×4 | сталь |
| Масса стола | ≈ 1,9 кг | подвижная сборка ≈ 2,6 кг |

## 6. Проверка требований README

| № | Требование | Как обеспечено | Статус |
|---:|---|---|---|
| 1 | Амплитуда 3…10 мм | три сменных диска; амплитуда по перемещению стола | без изменений; калибровка на макете |
| 2 | Частота 5…15 Гц | `f = n/30`; 150…450 об/мин, регулятор дрели | без изменений; проверить момент |
| 3 | Гармонический характер | двухлепестковый кулачок + два ролика | без изменений; проверить чистоту гармоники |
| 4 | Минимум движущихся частей и трения | 2 ролика-подшипника, 1 диск, 8 пружин; оправка и крепления неподвижны | новых кинематических пар нет |
| 5 | Минимум сложных деталей | диск — плоский профиль; кронштейн — сварной; оправка — точение | простое изготовление |
| 6 | Минимум «непокупных» деталей | покупные дрель, подшипники, U-болты, крепёж, шпильки | стол, кронштейны, оправка — изготовление |
| 7 | Минимум вибраций подстолья | уравновешенный диск, жёсткая рама | облегчение стола может изменить резонанс; проверить |
| 8 | Минимум точек регулировки | амплитуда — сменой диска, частота — регулятором дрели | две точки |
| 9 | Линейные зависимости | `Aст ≈ 2e`, `f = n/30` | без изменений |
| 10 | Безопасность | кожух, фиксация курка, аварийная кнопка | в модель не включены; рекомендуется |

## 7. Риски и что проверить на экспертизе

1. **Жёсткость стола 12 мм.** Лунка оставляет ≈ 9 мм под центром; проверить
   прогиб при нагрузке до 5 кг. При недостаточной жёсткости — 15 мм или рёбра.
2. **Плоский борт лунки.** Шарик может выйти из лунки; проверить на 15 Гц и
   размахе 10 мм. Предложение — вогнутость по всей плоскости или наклонный
   борт.
3. **Динамика шарика.** Возможны отрыв и подпрыгивание; нужны испытания,
   при необходимости — изменить глубину лунки/высоту бортика.
4. **Пробки над винтами M8.** Должны быть заподлицо с поверхностью лунки;
   проверить после сборки. Альтернатива — резьбовые втулки снизу.
5. **Посадка U-болтов.** Проверить, не перекрывают ли они вентиляционные окна
   дрели и не деформируют ли корпус; при необходимости — седловой кронштейн.
6. **Диск и оправка.** Масса стального диска ≈ 1,7 кг; проверить биение,
   балансировку, патрон и возможность облегчения диска.
7. **Момент дрели.** После облегчения стола измерить обороты под нагрузкой;
   при просадке — мотор-редуктор или дрель с поддержанием оборотов.
8. **Контакт ролик–диск.** Проверить контактные напряжения, твёрдость кромки
   диска и ресурс подшипников.
9. **Резонанс.** Масса стола уменьшилась; пересчитать собственную частоту
   подвески и проверить рабочий диапазон 5…15 Гц.
10. **Общие виды.** Листы этапа `model` не перевыпускались. Исправленные узлы
    показаны на листах 1–6; общие виды нужно привести в соответствие в
    следующей части корректировок.

## 8. Состав этапа

```
stages/correct/1/
  figs/
    table.svg
    subtable.svg
    roller_unit.svg
    roller_axle.svg
    drill_mount.svg
    cam_mount.svg
  pics/
    table.png
    subtable.png
    roller_unit.png
    roller_axle.png
    drill_mount.png
    cam_mount.png
  tools/
    generate.js
  Interview.md
  Report.md
  README.md
```

## 9. Следующий этап

Передать скорректированные узлы на инженерную экспертизу:
- проверить жёсткость стола 12 мм и динамику шарика;
- проверить момент дрели и массу диска;
- проверить прочность кронштейнов, U-болтов и оправки;
- при необходимости перейти к вогнутости по всей плоскости стола;
- обновить общие виды этапа `model` по результатам части 1.
