inutcin/boomboom/model/Interview.md

# Интервью по этапу «Формирование модели устройства»

Дата: 27.10.2026  
Этап: `model/` — модель по эскизу `model/pics/common_idea.jpg`

## 1. Первичные вопросы и ответы

| № | Вопрос | Ответ |
|---:|---|---|
| 1 | Характер колебаний: орбитальные в вертикальной плоскости или строго вертикальные? | **В вертикальной плоскости** |
| 2 | Станина: П-образная с верхней траверсой или другая? | **П-образная с верхней траверсой** |
| 3 | Дрель: вал горизонтально или вертикально? | **Вал горизонтально** |
| 4 | Амплитуда: сменные диски или плавная регулировка? | **Три сменных диска** |
| 5 | Частота: регулятор оборотов дрели или мотор-редуктор/ЧРП? | Сначала: **регулятор отсутствует**; затем уточнено: **у дрели есть регулятор оборотов** |
| 6 | Габариты и нагрузка 500 × 400 мм, до 5 кг? | **Подходят** |
| 7 | Материалы: фанера, стальной уголок, покупной крепёж? | **Да** |
| 8 | Что считать амплитудой: разницу радиусов диска или перемещение стола? | **Амплитуду меряем по перемещению стола** |
| 9 | Нужен ли CAD-файл (STEP/SCAD)? | **Пока достаточно изометрического изображения** |

## 2. Дополнительное требование по диску

Формулировка пользователя:

> «Форму диска для компенсации вибраций необходимо сделать с количеством
> максимумов более одного, расположенных с центральной симметрией».

Принято:

- **два максимума** через 180° (минимально достаточное число, центральная
  симметрия);
- профиль `r(φ) = R + e·cos(2φ)`;
- центр масс совпадает с осью вращения — диск уравновешен;
- за один оборот два цикла колебаний, `f = n/30`;
- три сменных диска с `e = 1,5 / 3 / 5 мм` (предварительно);
- амплитуда назначается по перемещению стола: `Aст = 3 / 6 / 10 мм`
  (размах по вертикали, предварительно).

Уточнения по этому пункту:

| № | Вопрос | Ответ |
|---:|---|---|
| 10 | Сколько максимумов: два или четыре? | **Два** |
| 11 | Амплитуда — по вертикальному перемещению стола? | **Да, по вертикальному перемещению стола** |
| 12 | Каталоги `figs`/`pics` или `fig`/`pic`? | **Существующие `figs`/`pics`** |

## 3. Принятые допущения

1. **Амплитуда — размах (peak-to-peak) вертикального перемещения стола.**
   Если нужна амплитуда от среднего положения (полуразмах), значения `e` и
   диски нужно пересчитать.
2. **Два лепестка** — минимальное число максимумов, удовлетворяющее
   требованию «более одного» и центральной симметрии. Четыре лепестка дали бы
   `f = n/15` и потребовали бы 75…225 об/мин, что для обычной дрели хуже.
3. **Регулятор — встроенный в дрель** (курок/электроника). Отдельного блока
   нет. Если у выбранной дрели нет встроенного регулятора, требование
   «5…15 Гц» без дополнительного регулятора/редуктора невыполнимо.
4. **Колебания в вертикальной плоскости** означают, что столешница движется
   по замкнутой траектории в этой плоскости; измеряемая амплитуда — размах
   вертикальной составляющей.
5. **Три сменных диска** отличаются глубиной лепестков; наружный контур
   одинаковый. Маркировка дисков — по фактической амплитуде стола.
6. **Станина** добавлена в модель, хотя в эскизе её нет: без верхней
   траверсы/плиты верхним пружинам не на что опираться.
7. **Размеры** приняты ориентировочно (500 × 400, высота столешницы 560,
   общая высота 860); на этапе экспертизы уточняются.

## 4. Вопросы к этапу экспертизы

1. Какую именно физическую величину должен измерять эксперимент —
   вертикальное перемещение, ускорение, или траекторию в вертикальной
   плоскости?
2. Допустима ли горизонтальная составляющая движения столешницы, или нужны
   направляющие и один ролик?
3. Какая полезная нагрузка и распределение массы на столешнице (точечная,
   по площади, смещённая)?
4. Есть ли требования к шуму, массе, габаритам, безопасности (кожух,
   аварийная кнопка)?
5. Какой ресурс/непрерывность работы? Это влияет на выбор подшипников,
   дрели и пружин.
6. Нужна ли фиксация частоты (тахометр/обратная связь) или достаточно
   регулятора дрели?
7. Нужен ли впоследствии CAD-файл (STEP/SCAD) или достаточно чертежей и
   изометрии?

## 5. Итог

Все вопросы, влияющие на модель, закрыты ответами пользователя. Оставшиеся
пункты относятся к этапу инженерной экспертизы и не мешают выпуску модели.
