inutcin/boomboom/stages/expert2/Interview.md

# Интервью по этапу «Вторая инженерная экспертиза»

Дата: 2026-10-30
Этап: `stages/expert2`
Объект: [`stages/fix6`](../fix6/README.md)
Следующий этап: [`stages/fix7`](../fix7/README.md)

Экспертиза выполнена по модели fix6 и документам предыдущих этапов. Модель
fix6 **не изменялась**. Вопросы ниже требуют решения пользователя до начала
fix7: от них зависят привод, ограждение, комплект дисков, пружины и постановка
эксперимента. Пока ответов нет, в расчётах приняты допущения из раздела 2; они
помечены в [`cad/calc.csv`](./cad/calc.csv) и [`Report.md`](./Report.md).

## 1. Вопросы к пользователю

**В1. В задании этапа expert2 написано: следующий каталог — `fix4`. Это
опечатка?**

`stages/fix4` уже существует и выполнен («Первая корректировка и замечания
после инженерной экспертизы»). Перезаписывать его нельзя. Решение: следующий
этап — **`stages/fix7`**, название — «Первая корректировка и замечания после
второй инженерной экспертизы». Ссылка добавлена в корневой README. Если
требовался другой каталог — сообщите, перенесу.

**В2. Что означает «амплитуда 3…10 мм» в корневом README — размах
(peak-to-peak) или амплитуда от среднего (нуль-пик)?**

Сейчас «ход» 3/5/10 мм — это **размах**. Если ТЗ требует нуль-пик 3…10 мм, то
нужен ход 6…20 мм, а текущие диски 3/5/10 дают амплитуду 1,5/2,5/5 мм и
**не покрывают** обязательный диапазон. Рекомендация: зафиксировать в README
«размах (ход) 3…10 мм» либо переделать комплект дисков на 6/10/20 мм размаха.
Это критичное C6.

**В3. Какая дрель будет использоваться (модель, патрон, диаметр корпуса,
рукоятка, диапазон оборотов, направление, фиксируемый курок)?**

Сейчас дрель — заглушка Ø100, X=210…340; патрон не смоделирован; конец вала
X=215 находится на 5 мм внутри корпуса. Нужны габариты патрона/рукоятки и
способ крепления. Рекомендация: компактная дрель с патроном 10 мм,
0…1500 об/мин (рабочие 150…450), плавным пуском и фиксируемым курком;
хвостовик Ø10 h6 с лыской и гибкая муфта. Это критичное C2.

**В4. Какой критерий «гармоничности» считать обязательным?**

В ТЗ сказано «характер колебаний — гармонический». Для текущего
2-лепесткового полярного профиля фактический подъём ролика имеет 4-ю
гармонику 0,505 мм для 10 мм (5,0 % хода) и отклонение от синусоиды 0,548 мм
(5,5 %). Рекомендация: принять 4-ю гармонику ≤2 % хода, а ускорения
вверх/вниз — отличающиеся не более чем на 10 %. Это критичное C8.

**В5. Нужно ли ограждение с блокировкой и аварийным остановом, или
достаточно существующего кожуха?**

Сейчас закрыты только бока (2 панели 160×300×5) и перед/зад выше Z=246; верх
и низ перед/задом открыты, патрон/вал при X≥210 вне кожуха; E-stop и
блокировки нет. Это критичное C1. Рекомендация: замкнутый прозрачный кожух,
дверца/крышка с концевиком, E-stop, закрытый патрон, маркировка.

**В6. Какую пружину выбираем: k, L0, число витков, материал, допуск; 4 или
8…12 пружин?**

Сейчас в спецификации только «Ø12, проволока 1,0, L0≈55, установленная 36»;
k и допуск не заданы. Для 4 пружин 12×1,0 (D=11, n=11) k≈0,677 Н/мм,
f_соб≈8,64 Гц внутри 5…15; на 15 Гц/10 мм контакт 19,7 Н (0,48 от
инерционной). Рекомендация: k≥1,5 Н/мм (2×) или 8…12 пружин; L0 55±1 мм;
регулировка преднатяга; f_соб вне 5…15 Гц (k≥2,2 Н/мм) или демпфер. Это
критичное C7.

**В7. Можно ли делать кулачок из PLA 100 % или нужна стальная вставка?**

У диска 10 мм стенка на минимуме R40 — 3 мм (8×Ø10 на R32), бортик ложбинки
1,25 мм; контакт внизу ~95 Н. Это важное I20. Рекомендация: Ø8/R30 или R34,
стенка ≥4…5 мм, стальная вставка/накладка в зоне контакта, испытание 10^6
циклов.

**В8. К какой станине/столу будет крепиться рама и чем (струбцины, болты
M6, размеры)?**

README требует крепления к тяжёлой станине, но в раме нет отверстий и
площадок; лапы 20×20 PETG мнутся. Рекомендация: 4×M6 в нижних балках +
стальные/фанерные подкладки + резиновый коврик. Это важное I12.

**В9. Допустим ли борт/кольцо вокруг лотка и сменная ударная пластина?**

При 10 мм/15 Гц шарик 20/33 г покидает лоток; PLA сминается. Рекомендация:
прозрачное кольцо высотой 10…15 мм (съёмное) и закалённая пластина 2 мм в
центре. Это важное I10.

**В10. Какие реальные массы покупных узлов (LMK10UU, 6200, пружина,
дрель)?**

Модель даёт 6,391 кг; с LMK 4×45 г и 6200 3×15 г — 6,023 кг; движущаяся
масса 1,225/0,916 кг. Нужны взвешивание и пересчёт. Это важное I15.

**В11. Какой протокол приёмки и испытаний считать обязательным?**

Рекомендация: статическая сборка; прокрутка вручную; 1 ч на 15 Гц (450
об/мин вала); измерение амплитуды индикатором/акселерометром и частоты
тахометром; контроль момента всех гаек; температура подшипников/кулачка;
повтор через 24 ч; протокол на каждый диск; проверка шарика 20 и 33 г.

**В12. Нужен ли отдельный этап для замены 6200 на конические роликовые
подшипники?**

Нет. В fix6 «конические подшипники» прочитаны как конические гайки; 6200
оставлены. Если имелись в виду конические роликовые подшипники — это отдельный
этап с переделкой карманов, вала и регулировкой преднатяга.

## 2. Принятые допущения (до ответов)

| Вопрос | Принято | Почему |
|---|---|---|
| Каталог следующего этапа | `fix7` | `fix4` уже занят; в задании опечатка |
| «Амплитуда» | В расчётах — размах; отдельно дан вариант нуль-пик | В модели «ход» = размах |
| Пружина | 12×1,0; D=11; n=11; G=79,3 ГПа; k=0,677 Н/мм | Типовой вариант; в spec k нет |
| Массы покупных | LMK10UU 45 г; 6200 15 г | Каталог/практика; модель завышает |
| Материалы | PLA E=3,5 ГПа; PETG E=2,0 ГПа; ν=0,35/0,40 | Типовые значения |
| Движущаяся масса | 0,916 кг (реальная), 1,225 кг (по mass.csv) | Расчёт по составу стола |
| Кулачок | 2-лепестковый полярный профиль r=50−e−e·cos2θ, как в fix6 | fix4/fix6 |
| Ролик | 6200 Ø30, радиус 15 мм; профиль выпуклый | fix6 |
| Дрель | Заглушка Ø100, X=210…340; патрон не смоделирован | fix6 |
| Частота | 2 лепестка: 5…15 Гц стола = 150…450 об/мин вала | fix4 |
| Испытания | Не проводились; все выводы — аналитические | Этап экспертизы |

## 3. Что не проверялось

1. Прочность/жёсткость рамы, вала, кронштейнов, балки 21 и кулачка методом
   конечных элементов; модальный анализ рамы/подстолья/дрели.
2. Усталость вала M10, резьбовых соединений, PETG-стоек и PLA-кулачка;
   ресурс 10^6 циклов.
3. Износ LMK10UU, 6200 в PETG-карманах, кулачка по стали, фреттинг.
4. Реальная дрель: масса, центр масс, патрон, рукоятка, крутящий момент,
   стабильность оборотов, нагрев.
5. Динамика с шариком (коэффициент восстановления, время контакта,
   микрофон), влияние борта/пластины; расчёт C8 — кинематический, без удара.
6. Тепловое поведение PETG/PLA при длительной работе, старение, влажность;
   тепловое расширение оценено линейно.
7. Точность печати и сборки на конкретном принтере; допуски и юстировка.
8. Электрическая безопасность дрели, E-stop, ограждение — только требования,
   не реализация.

## 4. Противоречия и предложения

1. **Каталог fix4 в задании expert2** — опечатка; создан `fix7`. Это
   единственный неразрушающий вариант: `fix4` уже содержит выполненный этап.
2. **README и модель**: README описывает сварную сталь 20×20×1,5 и стол,
   вытянутый по Y; модель — PETG 20×20 сплошного сечения и стол 200×150 по X
   (I2). Нужен один источник истины.
3. **Спецификация поз. 20**: «Ø10, хвостовик Ø10» при шпильке M10; гладкого
   хвостовика в модели нет (I18/C2).
4. **«Амплитуда»**: в README 3…10 мм, в модели ход 3/5/10 мм; это разные
   величины (C6).
5. **fix6**: осевой зажим 6200 (4 конуса + 4 nyloc) геометрически корректен и
   принят; замечание C3 теперь относится к кулачку, а не к 6200. Это важно,
   чтобы не переделывать уже исправленный узел.
6. **2-лепестковый профиль**: полярный профиль r(θ) не равен закону движения
   ролика h(φ); фактическая 4-я гармоника 5,5 % (C8). Предложение — строить
   кулачок как внутреннюю эквидистанту кривой центров ролика
   Rc(φ)=65−e−e·cos2φ.

## 5. Связь с fix7

Ответы на В1…В12 должны быть внесены в `stages/fix7/Interview.md` (или в этот
файл) до моделирования. Рекомендуемый порядок: В1 (каталог) → В2/В4 (режимы
и гармоничность) → В3 (дрель) → В5 (ограждение) → В6/В7 (пружины/кулачок) →
В8/В9 (крепление/шарик) → В10/В11 (массы/приёмка).
