inutcin/boomboom/stages/expert/Interview.md

# Интервью по этапу «Инженерная экспертиза»

Дата: 2026-10-30
Этап: `stages/expert`
Объект: [`stages/fix3`](../fix3/README.md)

Экспертиза выполнена по модели fix3 и документам предыдущих этапов. Вопросы
ниже требуют решения пользователя **до начала fix4**: от них зависят длина
вала, патрон, комплект дисков, крепление рамы и постановка эксперимента.
Пока ответов нет, в расчётах приняты допущения из раздела 2; они помечены в
[`cad/calc.csv`](./cad/calc.csv) и [`Report.md`](./Report.md).

## 1. Вопросы к пользователю

**В1. Что означает «амплитуда 3…10 мм» в корневом README — размах
(peak-to-peak) или амплитуда от среднего (нуль-пик)?**

Сейчас в модели «ход» 3/5/10 мм — это **размах**. Если ТЗ требует нуль-пик
3…10 мм, то нужен ход 6…20 мм, а текущие диски 3/5/10 не покрывают диапазон.
Рекомендация: зафиксировать в README «размах (ход) 3…10 мм» и использовать
это в паспорте; если нужна амплитуда нуль-пик — переделать комплект дисков.

**В2. Какие сочетания (частота, размах) обязательны для эксперимента с
шариком?**

При 5 Гц даже размах 10 мм даёт `a_max=4,93 м/с² < g`; шарик не отрывается.
Для отрыва на 5 Гц нужен размах >19,9 мм. Рекомендация: либо ограничить
эксперимент частотами ≥7…13 Гц в зависимости от диска, либо увеличить
размах/изменить привод. Нужна таблица обязательных режимов.

**В3. Какая дрель будет использоваться (модель, патрон, диаметр корпуса,
рукоятка, диапазон оборотов, направление, фиксируемый курок)?**

Сейчас дрель — заглушка Ø100, X=210…340; патрон не смоделирован; конец вала
X=215 попадает внутрь корпуса. Нужны габариты патрона/рукоятки и способ
крепления. Рекомендация: компактная дрель с патроном 10 мм, 0…3000 об/мин,
плавным пуском и фиксируемым курком; хвостовик Ø10 h6 с лыской и гибкая
муфта.

**В4. Оставляем печатную PETG-раму или возвращаемся к сварной стальной
трубе 20×20×1,5, как в корневом README?**

Модель fix1…fix3 — PETG одним куском 1,87 кг; README — сварная сталь. Это
принципиальное расхождение (I2). Рекомендация: для вибростола с шариком
оставить PETG-раму, но добавить галтели, стальные вставки в карманы 6200,
расточку отверстий и обновить README; либо вернуться к стальной раме и
пересчитать карманы/крепления.

**В5. К какой станине/столу будет крепиться рама и чем (струбцины, болты
M6, размеры)?**

README требует крепления к тяжёлой станине, но в раме нет отверстий и
площадок; лапы 20×20 PETG мнутся. Рекомендация: 4×M6 в нижних балках +
стальные/фанерные подкладки + резиновый коврик; указать станину и усилие
зажима.

**В6. Допустим ли борт/кольцо вокруг лотка и сменная стальная ударная
пластина?**

При 10 мм/15 Гц шарик покидает лоток; PLA сминается. Рекомендация:
прозрачное кольцо высотой 10…15 мм (съёмное) и закалённая пластина 2 мм в
центре; проверить, не искажает ли кольцо измерения микрофоном.

**В7. Можно ли печатать кулачок на 100% заполнения из PETG/PLA+ или
поставить стальную вставку/кольцо?**

Сейчас PLA, 50% заполнения; контактное давление ~35 МПа, износ. Рекомендация:
100% заполнения PETG/PLA+ или стальная вставка в зоне контакта; кулачок —
расходник, иметь ЗИП.

**В8. Какой протокол приёмки и испытаний считать обязательным?**

Рекомендация: статическая сборка; прокрутка вручную; 1 ч на 15 Гц; измерение
амплитуды индикатором/акселерометром и частоты тахометром; контроль момента
всех гаек; температура подшипников/кулачка; повтор через 24 ч; протокол на
каждый диск.

## 2. Принятые допущения (до ответов)

| Вопрос | Принято | Почему |
|---|---|---|
| Пружина | 12×1,0; D=11; n=11; G=79,3 ГПа; k=0,68 Н/мм | Типовой вариант; в spec.csv k нет |
| Массы покупных | LMK10UU 45 г; 6200 15 г | Каталог/практика; модель завышает |
| Материалы | PLA E=3,5 ГПа; PETG E=2,0 ГПа; ν=0,35/0,40 | Типовые значения |
| Движущаяся масса | 0,92 кг (реальная), 1,22 кг (по mass.csv) | Расчёт по составу стола |
| Кулачок | Эксцентриковая окружность, как в модели | fix3 |
| Дрель | Заглушка Ø100, X=210…340; патрон не смоделирован | fix3 |
| «Амплитуда» | В расчётах — размах; отдельно дан вариант нуль-пик | В модели «ход» = размах |
| Испытания | Не проводились; все выводы — аналитические | Этап экспертизы |

## 3. Что не проверялось

1. Прочность/жёсткость рамы, вала, кронштейнов и балки 21 методом конечных
   элементов; модальный анализ рамы/подстолья/дрели.
2. Усталость вала M10, резьбовых соединений, PETG-стоек и PLA-кулачка.
3. Износ LMK10UU, 6200 в PETG-карманах, кулачка по стали, фреттинг.
4. Реальная дрель: масса, центр масс, патрон, рукоятка, крутящий момент,
   стабильность оборотов.
5. Динамика с шариком (коэффициент восстановления, время контакта,
   микрофон), влияние борта/пластины.
6. Тепловое поведение PETG/PLA при длительной работе, старение, влажность.
7. Точность печати и сборки на конкретном принтере; допуски и юстировка.
8. Электрическая безопасность дрели, E-stop, ограждение — только требования,
   не реализация.

## 4. Связь с fix4

Ответы на В1…В8 должны быть внесены в `stages/fix4/Interview.md` (или в этот
файл) до моделирования. Пока рекомендуемый порядок: В1/В2 (режимы) → В3
(дрель) → В4/В5 (рама/крепление) → В6/В7 (материалы/шарик) → В8 (приёмка).
