inutcin/boomboom/stages/model/Interview.md

# Интервью по этапу «Формирование эскизов устройства по рисунку от руки»

Дата: 2026-10-29
Этап: `stages/model`

Ниже — все вопросы, заданные при разборе эскизов, и ответы, полученные до начала
моделирования. Ответы помечены как решения; всё, что не задано эскизом и не
уточнено, вынесено в раздел «Принятые допущения» и продублировано в
[`params.csv`](./params.csv) со статусом `принято`.

## 1. Вопросы по постановке и окружению

**В1. Как получать STEP/STL/рендеры, если в агентах был отключён bash?**
Ответ: включить bash в build-агенте. Сделано, используется FreeCAD 0.19
(`freecadcmd`) и Blender 3.0.1.

**В2. Ориентация привода: вал вдоль длинной оси (400, ось X) от дрели к кулачку?**
Ответ: да. Дрель справа, патрон смотрит влево, кулачок на X≈100, два
подшипника 6200 на X≈60 и 140, балка фиксации — вдоль X.

**В3. Кулачок R45…50 даёт ход 5 мм; как трактовать требование «амплитуда 3…10 мм»?**
Ответ: 5 мм — базовый размах, остальное достигается сменными дисками
(комплект 3 / 5 / 10 мм).

**В4. Как поступать с размерами, которых нет на эскизе (пружины, шаг валов, дрель,
толщина кулачка, вогнутость накладки)?**
Ответ: принять типовые значения и пометить их `[принято]`, чтобы потом менять
одним числом.

## 2. Вопросы по конструкции (ответы пользователя)

**В5. Пружины.**
Ответ: наружный диаметр 12 мм, проволока 1 мм; вал Ø10 должен проходить через
пружину.

**В6. Расположение валов и проход через раму.**
Ответ: прямоугольник ~170×120 правильный. Валы проходят сверху вниз через
верхнюю часть рамы, пружину, стол, линейные подшипники и серединную балку рамы,
затем с обоих концов фиксируются кольцевыми ограничителями.

**В7. Сменные кулачковые диски.**
Ответ: да, диапазон 3…10 мм обеспечивается сменным диском.

**В8. Балки фиксации подшипников и крабы.**
Ответ: балок две, каждая подпирает к средней балке рамы по одному подшипнику.
Балки идут вдоль X между стойками рамы, параллельны земле и прижимают
подшипник в выемках к средней балке. Т-образные крабы крепят балки к стойкам.

**В9. Ролик и кронштейны.**
Ответ: ролик один, кронштейн один. «Кронштейнами» в тексте README названы
уголки, которые крепят ролик к столу. У валов кронштейнов нет — это фланцы
LMF10UU.

**В10. Дрель и подстолье.**
Ответ: параметры приняты (корпус условно Ø100, ось на высоте вала), крепление
двумя U-хомутами M6 под подстольем.

**В11. Вогнутая накладка.**
Ответ: параметры приняты: сферическая вогнутость, глубина 2 мм.

**В12. Нумерация спецификации.**
Ответ: сохранить оригинальные номера 1…20; новые позиции добавлять в конец.
Балка фиксации подшипников — поз. 21, рама — поз. 22.

**В13. Стол и фланцы LMF10UU.**
Ответ: стол и накладка выходят за габарит верхней части рамы по Y; это нужно,
чтобы полностью разместить фланец LMF10UU. Вырезы под стойки в столе не делать:
уменьшить стол по X, оставив по 5 мм до вертикальных стоек рамы
(200−20−20−5−5 = 150 мм), а валы сместить к центру по X так, чтобы фланцы
умещались на столе.

**В14. Подстолье по Y.**
Ответ: подстолье по Y должно быть короче, чтобы об него не задевали LMF10UU.

**В15. Крепление балок 21 крабами.**
Ответ: крабы с выносом на угловые стойки (вариант 2). Центральные стойки в
торцы рамы не добавлять.

## 3. Принятые допущения

Все значения ниже продублированы в `params.csv` со статусом `принято`.

| Параметр | Принято | Почему |
|---|---|---|
| Шаг валов по X | 100 мм (X=50 и 150) | Стол 150 мм; фланец Ø40 вписывается с запасом 5 мм |
| Шаг валов по Y | 170 мм (Y=15 и 185) | Исходный прямоугольник 170×120; 170 отнесено к Y, т.к. стол выходит за раму по Y |
| Стол / накладка | 150×240 мм | 150 по условию; 240 = 200 + 2×20 для фланцев по Y |
| Накладка | 6 мм, сфера Ø140, глубина 2 мм, R≈1225 | Нужен запас под потайной M4 в центре |
| Пружина | 12×1,0; свободная 55; установленная 39…44 | Ход 5 мм; 4 пружины дают предварительный поджим |
| Кулачок | эксцентриковый диск, рабочая поверхность R45…50, ложбинка 2 мм, толщина 12 | Rmin/Rmax из эскиза; эксцентрик даёт гармонический закон |
| Диски | 3 мм (R45…48), 5 мм (R45…50), 10 мм (R45…55) | Требование 3…10 мм |
| Подстолье | 200×160 мм (Y=20…180), фанера 10 | Ответ В14; зазор до фланцев LMF10UU |
| Дрель | корпус Ø100, L≈110, ось Z=140; патрон X=240…270 | Ответ В10; точная модель будет позже |
| U-хомут | M6, внутренняя ширина ~100, ножки 150 | Надпись «R=90-100, h=150» трактуется как размеры под Ø100 |
| Балка 21 | труба 20×20×1,5, Z=106…126, X=20…90 и 110…180 | Под каждый 6200; окно под кулачок |
| Крабы 14 | Т-пластина 5 мм, вынос 70…80 мм от угловой стойки | Ответ В15 |
| Средняя балка | центральная балка Y=90…110 с окном X=92…108 | Кулачок R50 физически проходит через этот уровень |
| Крепёж фланцев | 16 винтов M4×12 | В эскизе не показаны, без них фланец не закрепить |

## 4. Места, требующие проверки на реальном изделии

1. **Пружина 12×1,0** номинально даёт ID=10,0 при валу Ø10 — посадка в ноль.
   В модели принят фактический ID 10,2; если пружина окажется ровно 10,0,
   вал в поясе пружины нужно шлифовать до Ø9,8.
2. **Крабы** крепятся к угловым стойкам 20×20 с выносом ~80 мм; в модели
   вынос выполнен Т-пластиной 5 мм с двумя M6 в стойку и одним потайным M6
   в балку 21. При сборке проверить жёсткость выноса.
3. **U-хомут**: «R=90-100» может означать и радиус гиба, и раствор. Принят
   раствор ~100 мм под корпус дрели Ø100; при другой дрели — резиновая
   подкладка по README п. 10.
4. **Кулачок**: рабочая поверхность — эксцентриковая окружность; при
   необходимости точного гармонического закона с учётом радиуса ролика
   профиль можно скорректировать (это уже этап изготовления диска).
5. **Средняя балка** разрезана окном под кулачок. Это вынужденное решение;
   при иной компоновке кулачка окно можно уменьшить.
6. **Подстолье** опирается на две поперечины выноса; при массе дрели более
   ~3 кг желательно добавить продольные стрингеры (в спецификацию не вводились).
