inutcin/boomboom/stages/correct/1/Interview.md

# Интервью по этапу «Замечания и корректировки по модели. Часть 1»

Дата: 27.10.2026  
Этап: `stages/correct/1`  
Исходная модель: `stages/model/figs/*.svg`

## 1. Вопросы и ответы

| № | Вопрос | Ответ |
|---:|---|---|
| 1 | Пункт 2: «Платформа должна быть лёгкой достаточно, чтобы дрель её прокручивала». В текущей схеме дрель вращает кулачковый диск, а стол колеблется. Что имеется в виду? | **Облегчить подвижный стол; кинематику сохранить.** Дрель по-прежнему вращает кулачковый диск, стол совершает колебания. |
| 2 | Параметры шарика для расчёта вогнутости? | **Стальной шарик Ø20 мм** (масса ≈ 33 г). |
| 3 | Что считать «изометрическим изображением для каждой детали»? | **Четыре узла из замечания:** крепление роликов, подстолье, крепление дрели, крепление диска. Крепёж — в спецификации, отдельные изометрии гаек/шайб не делать. |

## 2. Принятые допущения

1. **Столешница:** 500 × 400 × 12 мм, берёзовая фанера; сферическая лунка Ø360 × 3 мм
   (R ≈ 5400 мм в центре), бортик 10 × 10 мм по периметру.
2. **Шарик** Ø20 мм, сталь; расположен в центре лунки.
3. **Крепление роликов:** подшипник 6202-2RS (35 × 15 × 11), ось M12×45
   с шестигранной головкой и шестигранной гайкой, переходная втулка
   15/12 × 11, сварной кронштейн из полосы 4 мм: основание 84 × 50,
   щеки 50 × 55, углы R5.
   Крепление к столу — винты M8×20 с потайной головкой и внутренним
   шестигранником; головки утоплены и закрыты пробками Ø16 заподлицо.
   Гайки M8 — шестигранные.
   Узел дополнен видами снизу, местным разрезом Д–Д, разрезом А–А,
   разнесённой изометрией, деталью Е и видами по оси со стороны гайки
   и головки болта (листы 3 и 4).
   Кронштейн не является направляющей диска по радиусу: диск катится по
   ролику, щёки образуют защитную скобу. Зазор между щеками 11 мм (по ширине
   подшипника); диск 6 мм имеет запас 2,5 мм на сторону.
4. **Крепление дрели:** два U-болта M8 под трубу Ø80, резиновая подкладка-седло
   10 мм, верхняя подкладка 2 мм. Отверстия в подстолье Ø9:
   (130; ±45) и (260; ±45); гайки M8 — шестигранные.
5. **Крепление диска:** оправка с хвостовиком Ø10 × 40 в патрон и фланцем
   Ø40 × 6; диск с центральным отверстием Ø40; прижим — винт M8×25
   с внутренним шестигранником и шайба Ø60 × 4.
6. **Каталоги:** `figs/` и `pics/` — как на этапе `model`; PNG — A3, 200 dpi,
   3307 × 2339 px.
7. **Общие виды этапа `model`** в этой части не перевыпускаются: исправленные
   узлы показаны на отдельных листах этапа `correct/1`.

## 3. Открытые вопросы и предложения

1. **Вогнутость по всей плоскости.** В модели принята центральная лунка
   Ø360 × 3 мм с плоским бортом до бортика. Шарик удерживается в лунке, но
   если он выйдет на плоский борт, возврат к центру не гарантирован.
   Предложение на экспертизу/часть 2: выполнить вогнутость по всей плоскости
   стола (эллиптическая чаша, глубина ≈ 5 мм) либо наклонный борт от бортика
   к лунке.
2. **Динамика шарика** на 15 Гц и размахе 10 мм: проверить отрыв, подпрыгивание
   и удержание; при необходимости увеличить глубину/изменить профиль.
3. **Жёсткость стола 12 мм** при нагрузке до 5 кг: проверить прогиб; при
   необходимости перейти на 15 мм или добавить рёбра.
4. **Посадка U-болтов** относительно вентиляционных окон дрели и допустимость
   обжатия корпуса; при необходимости — седловой кронштейн.
5. **Масса диска** (сталь 6 мм, ≈ 1,7 кг) и биение оправки: проверить патрон,
   балансировку и возможность облегчения диска.
6. **Момент дрели** на 150…450 об/мин после облегчения стола: измерить под
   нагрузкой; при просадке оборотов — мотор-редуктор или дрель с поддержанием
   оборотов.
