inutcin/boomboom/stages/correct/1/pics/cam_mount.png

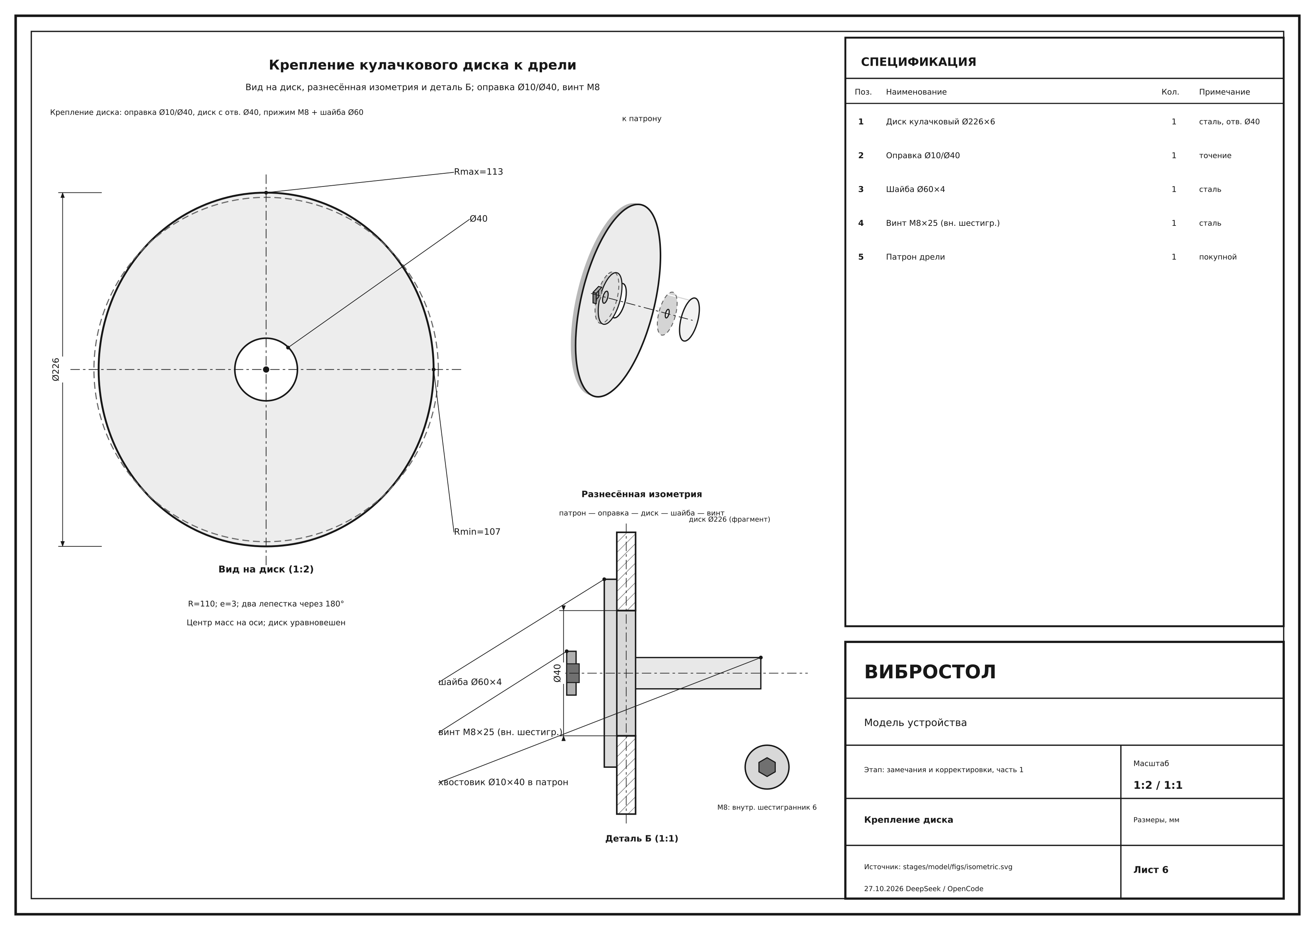
stages/correct/1/pics/cam_mount.png
