inutcin/boomboom/stages/correct/1/pics/drill_mount.png

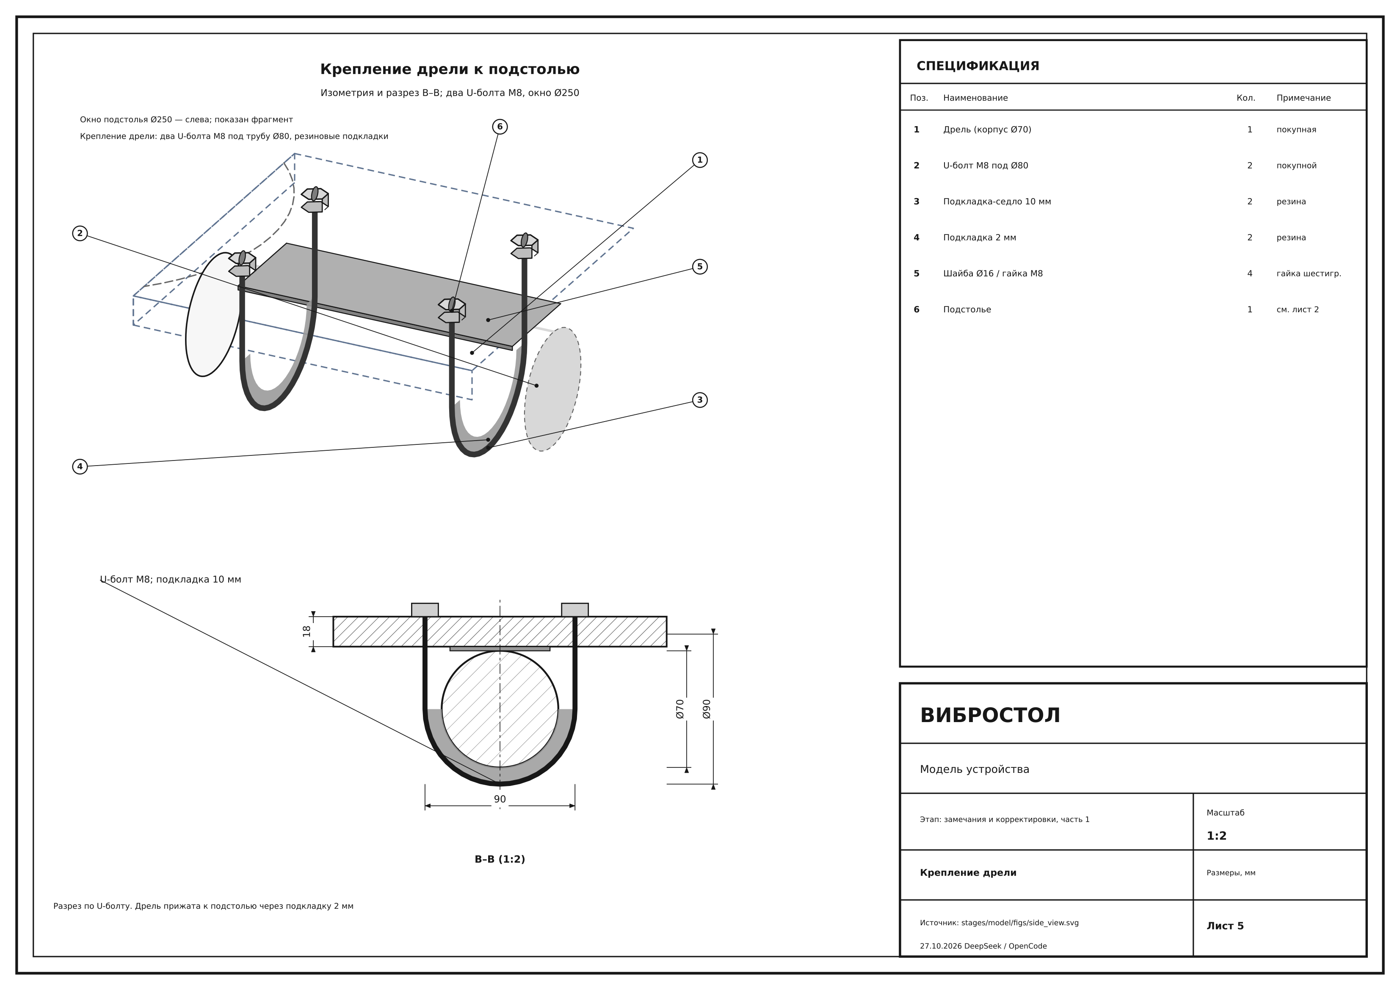
stages/correct/1/pics/drill_mount.png
