inutcin/boomboom/stages/correct/1/pics/roller_axle.png

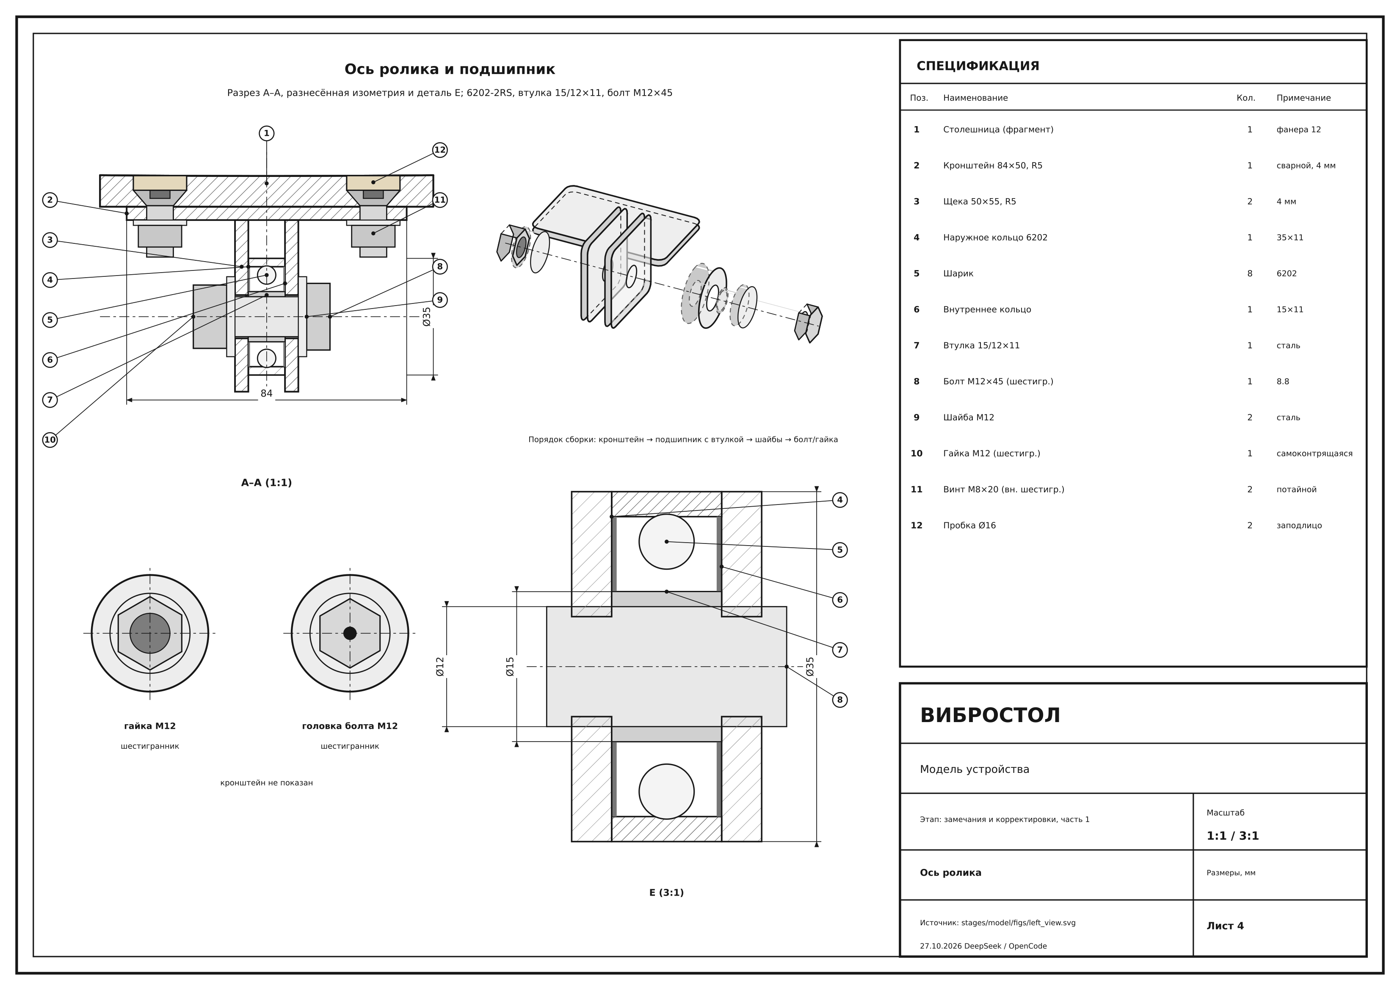
stages/correct/1/pics/roller_axle.png
