inutcin/boomboom/stages/correct/1/pics/roller_unit.png

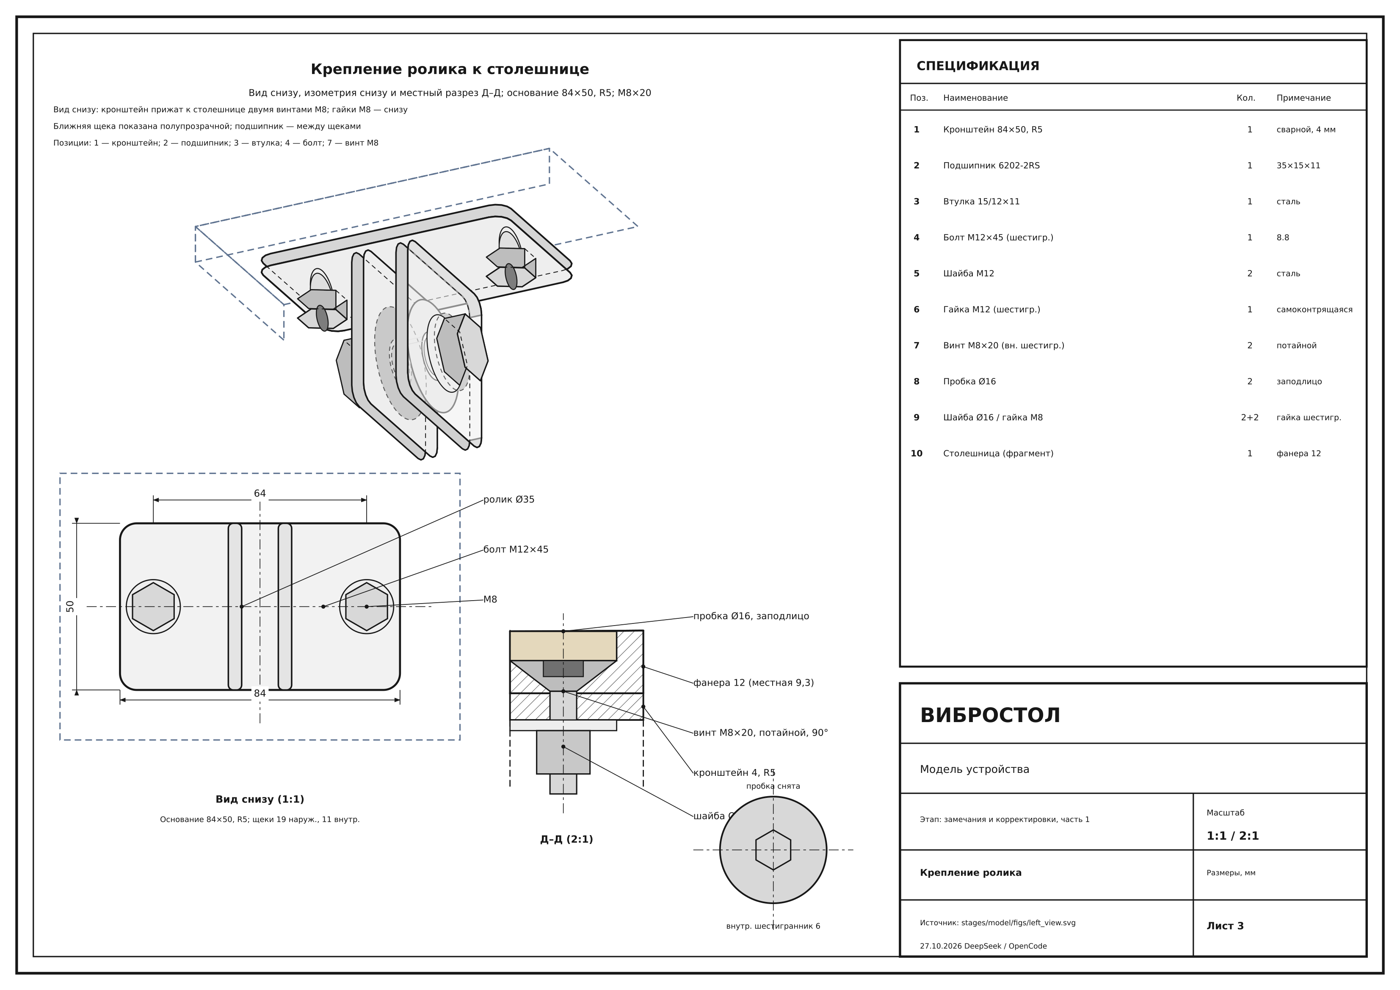
stages/correct/1/pics/roller_unit.png
