inutcin/boomboom/stages/correct/1/pics/subtable.png

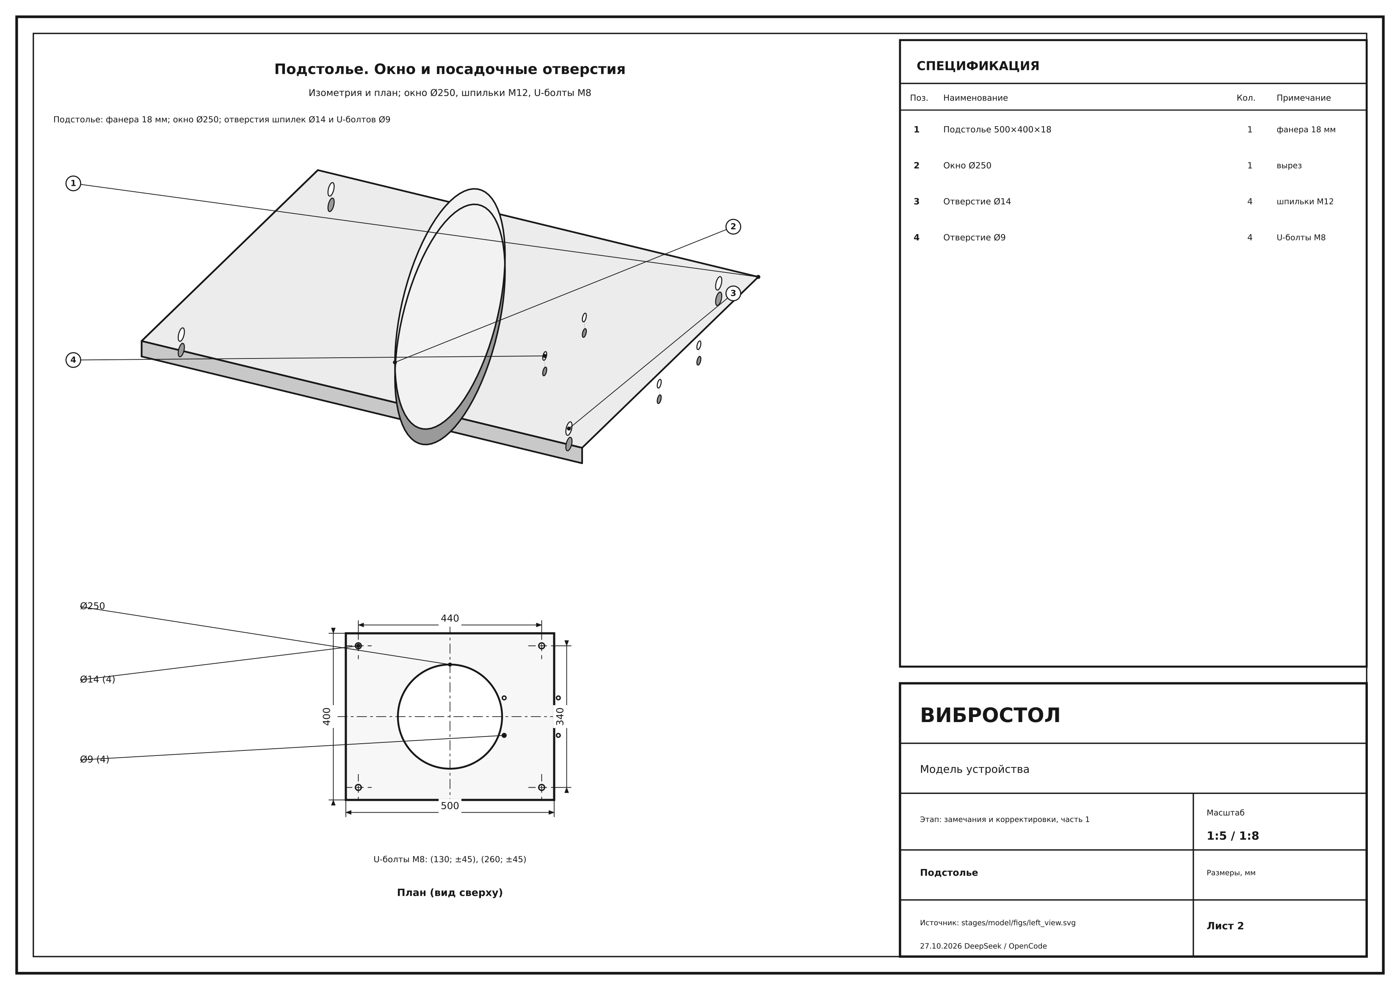
stages/correct/1/pics/subtable.png
