inutcin/boomboom/stages/correct/1/pics/table.png

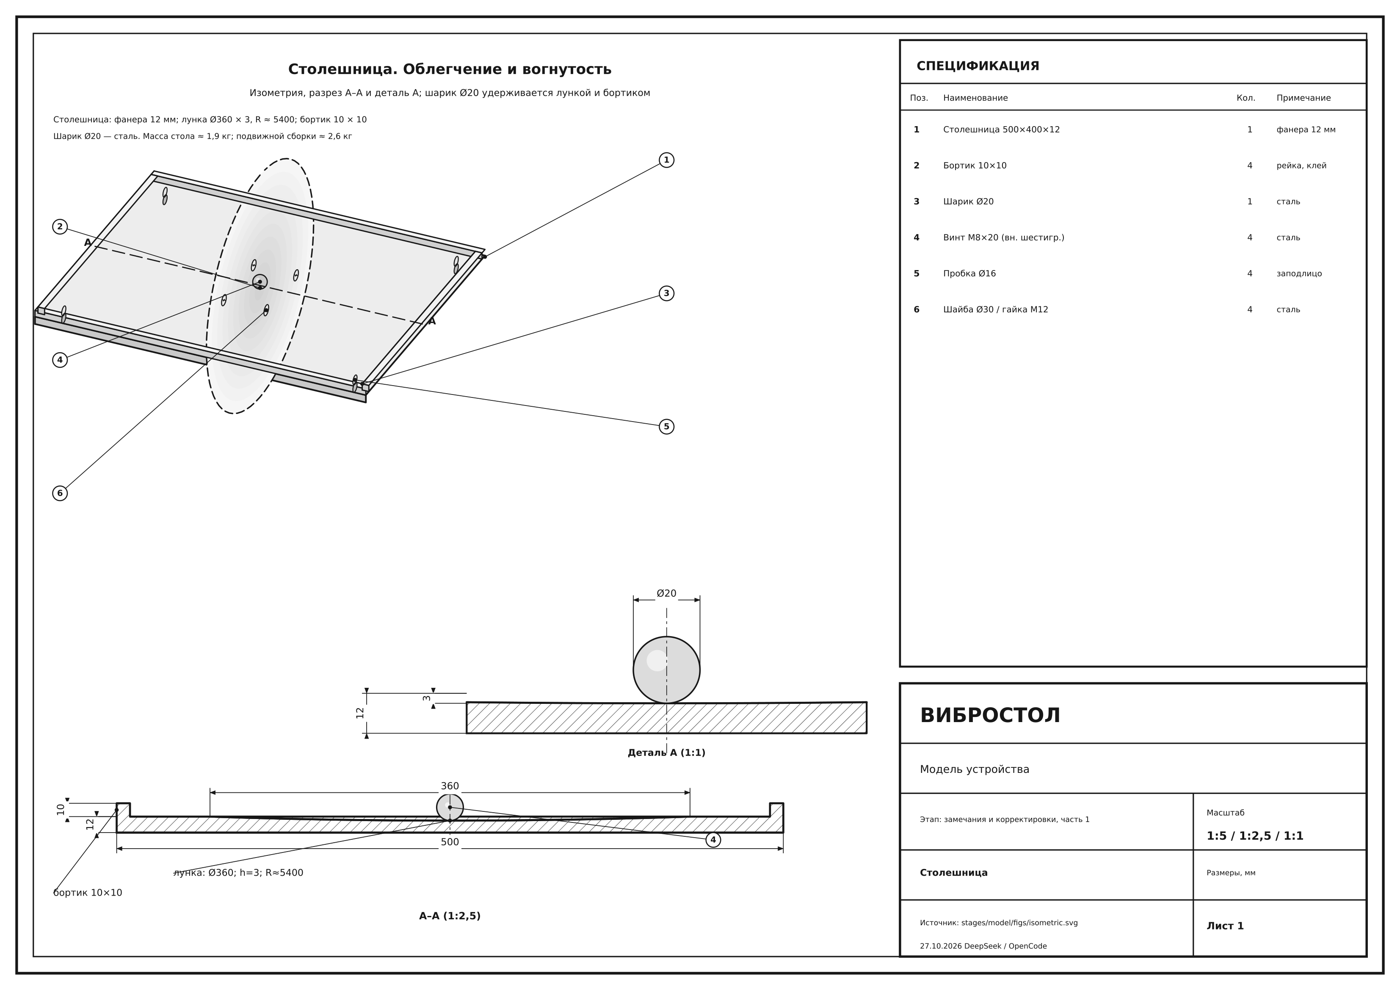
stages/correct/1/pics/table.png
