inutcin/boomboom/stages/expert2/pic/expert_sheet_preview.png

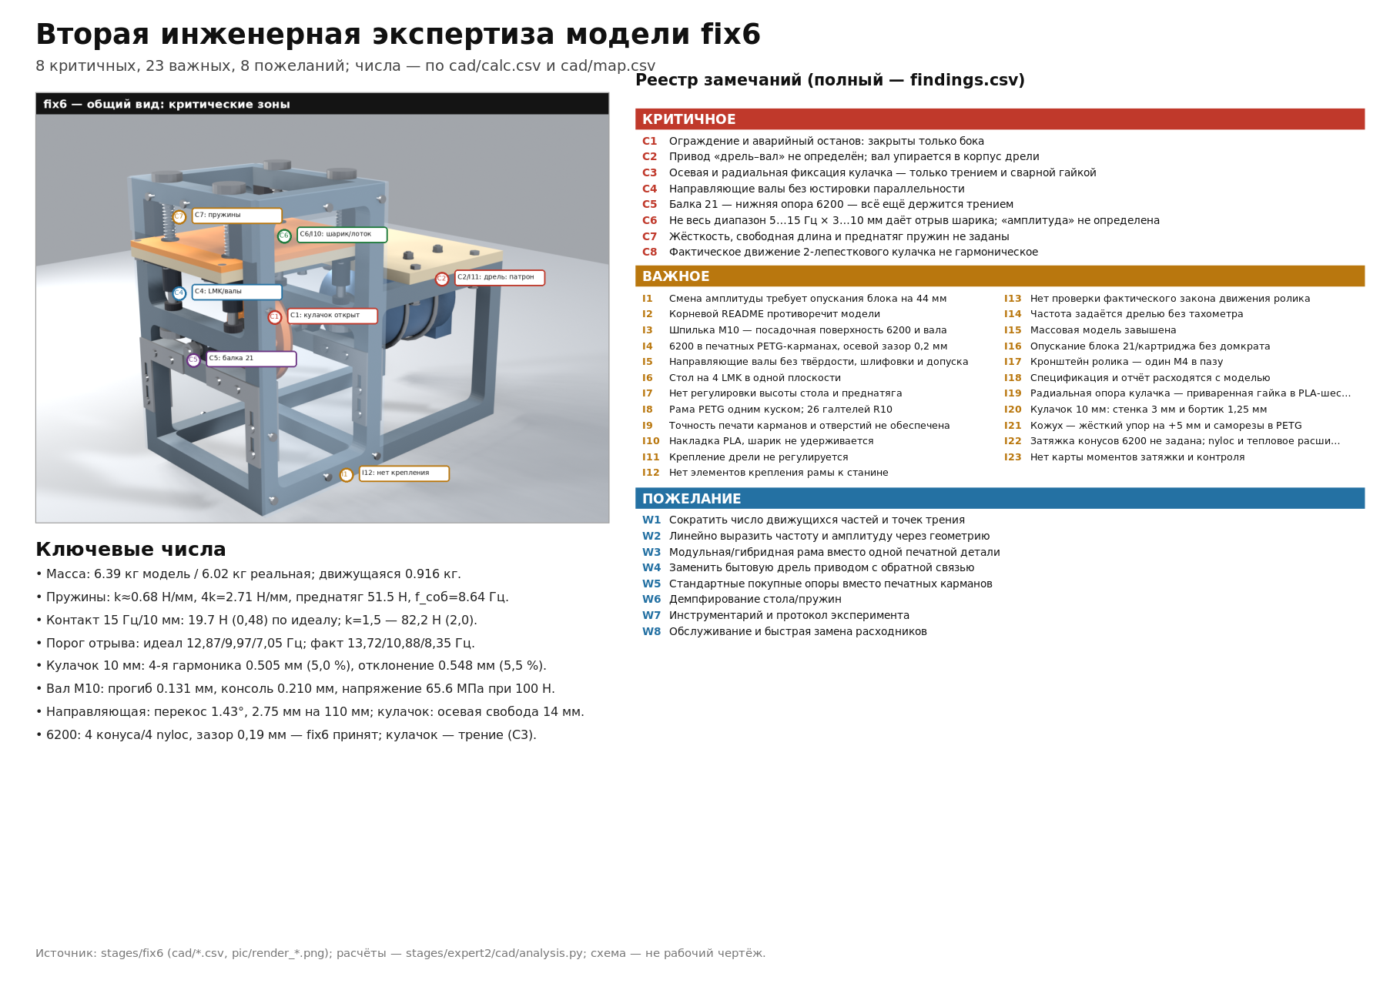
stages/expert2/pic/expert_sheet_preview.png
