inutcin/boomboom/stages/expert2/pic/kinematics_preview.png

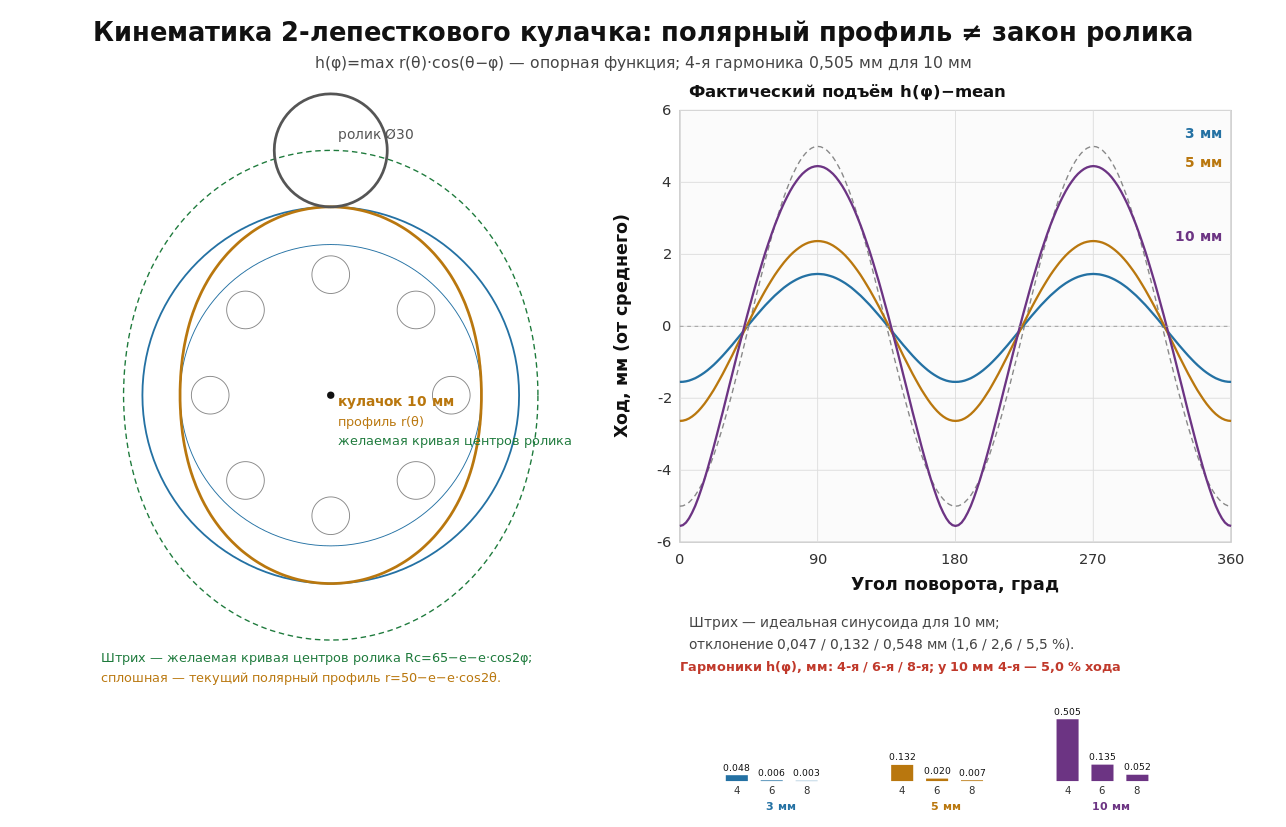
stages/expert2/pic/kinematics_preview.png
