inutcin/boomboom/stages/expert2/pic/load_path_preview.png

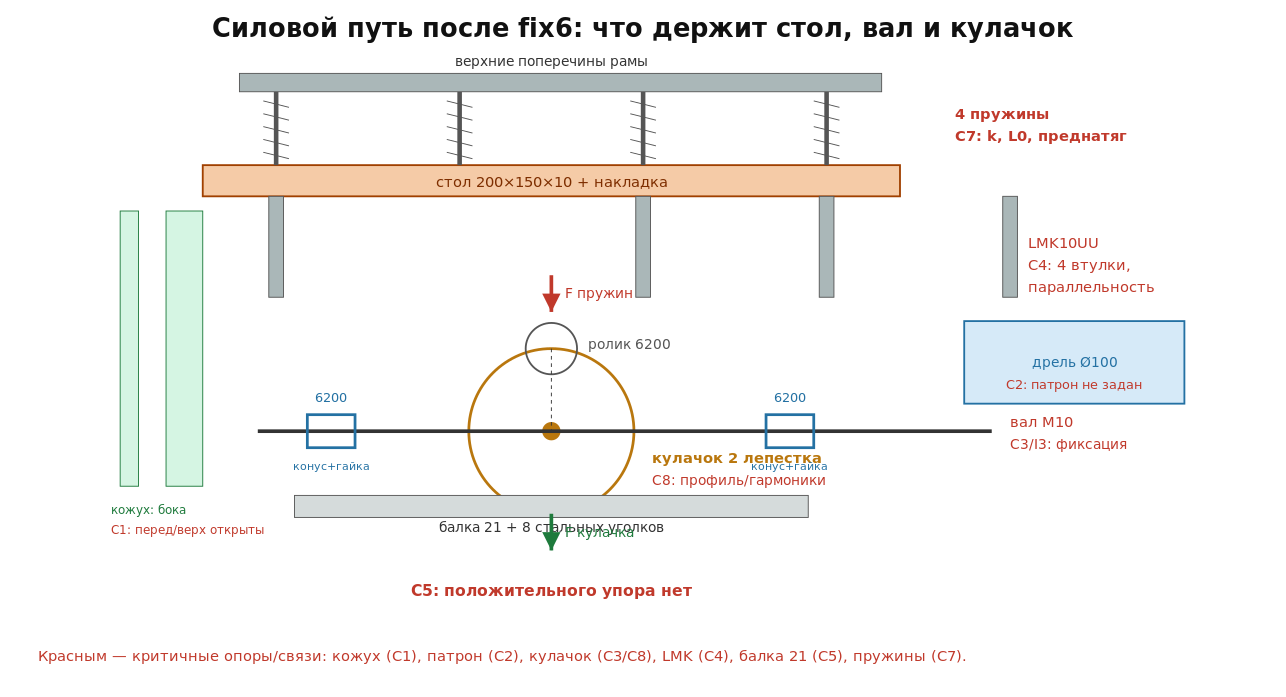
stages/expert2/pic/load_path_preview.png
