inutcin/boomboom/stages/expert2/pic/spring_contact_preview.png

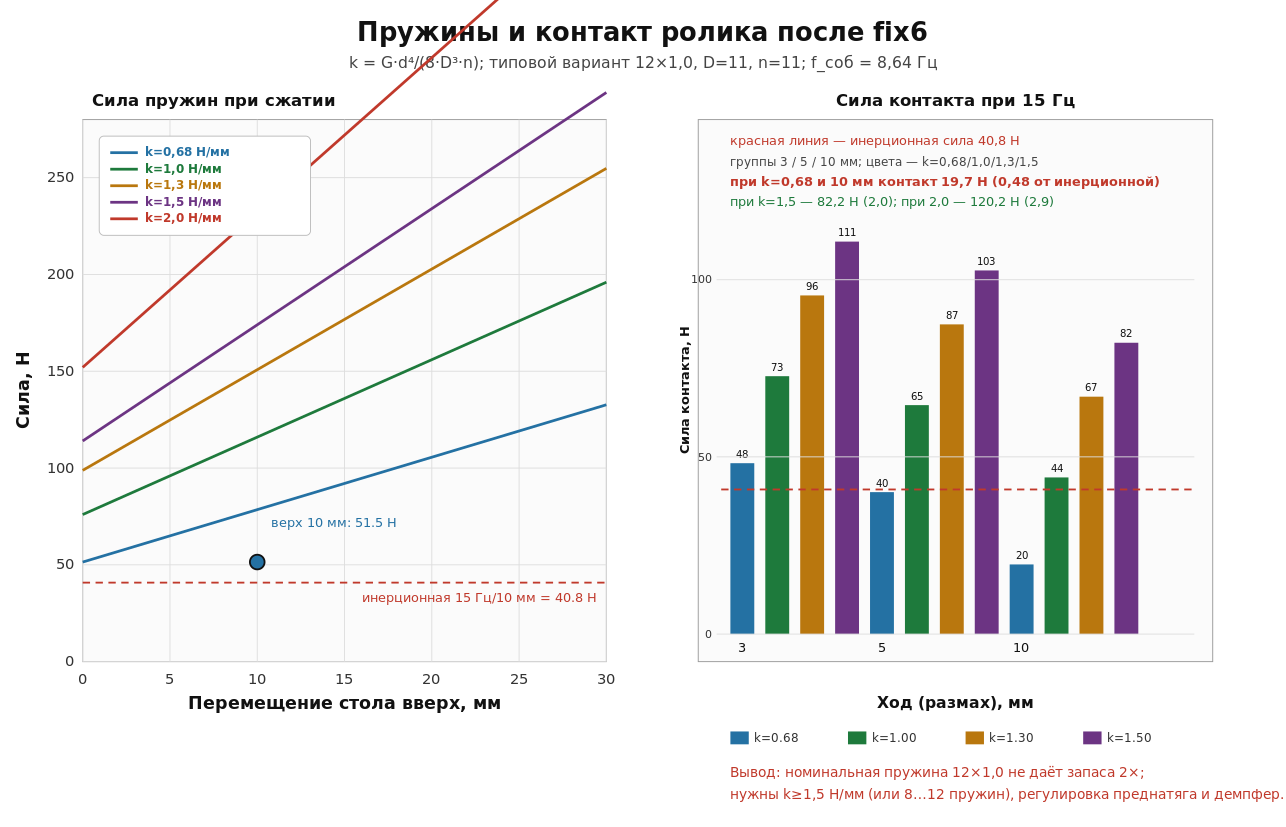
stages/expert2/pic/spring_contact_preview.png
