inutcin/boomboom/stages/expert2/pic/tolerance_stack_preview.png

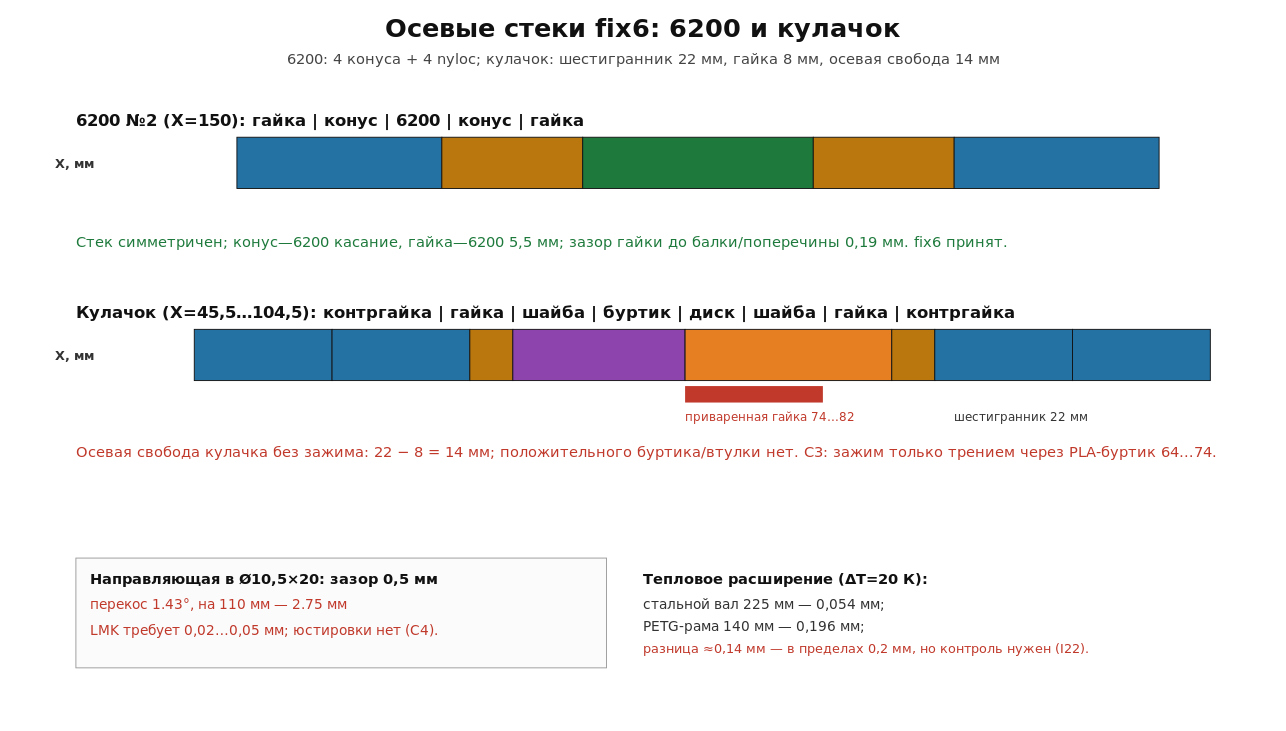
stages/expert2/pic/tolerance_stack_preview.png
