inutcin/boomboom/stages/expert3/pic/contact_map_preview.png

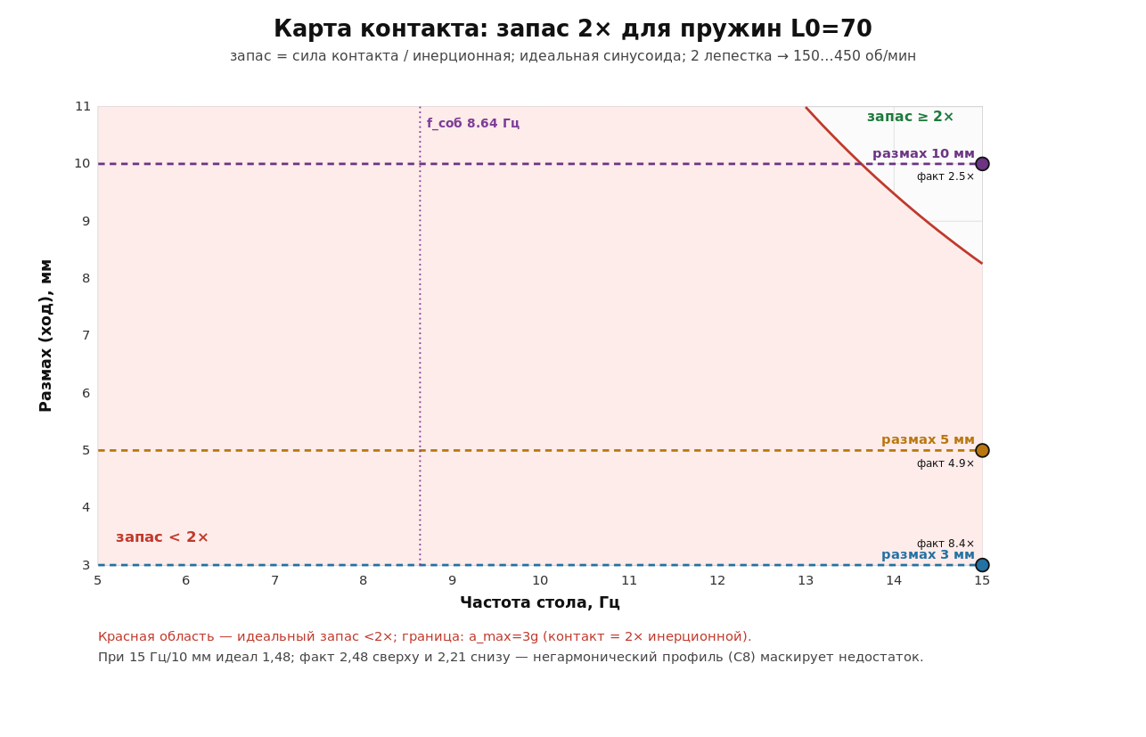
stages/expert3/pic/contact_map_preview.png
