inutcin/boomboom/stages/expert3/pic/expert_sheet_preview.png

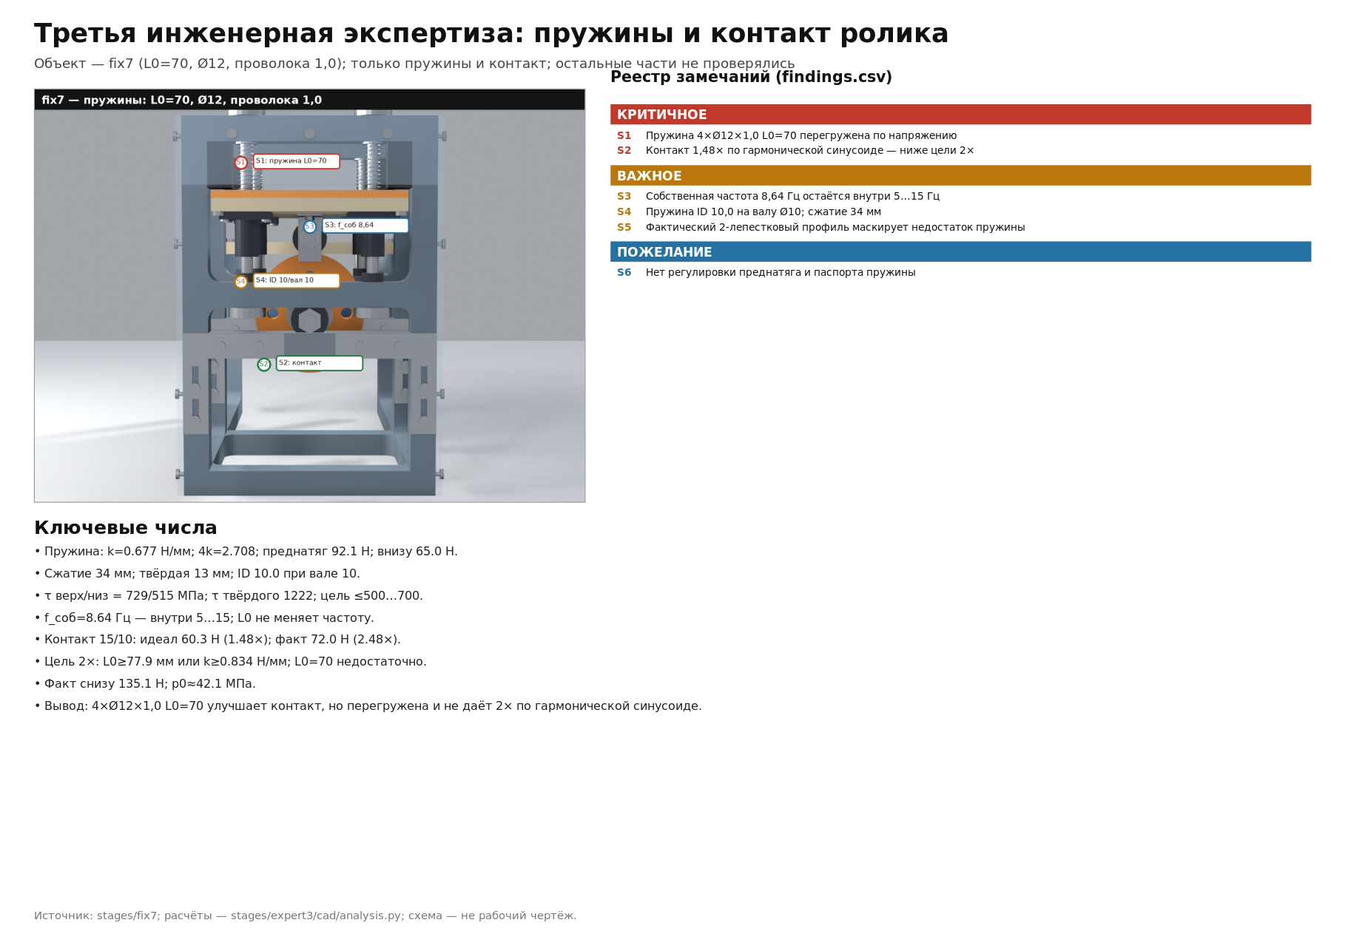
stages/expert3/pic/expert_sheet_preview.png
