inutcin/boomboom/stages/expert3/pic/spring_contact_preview.png

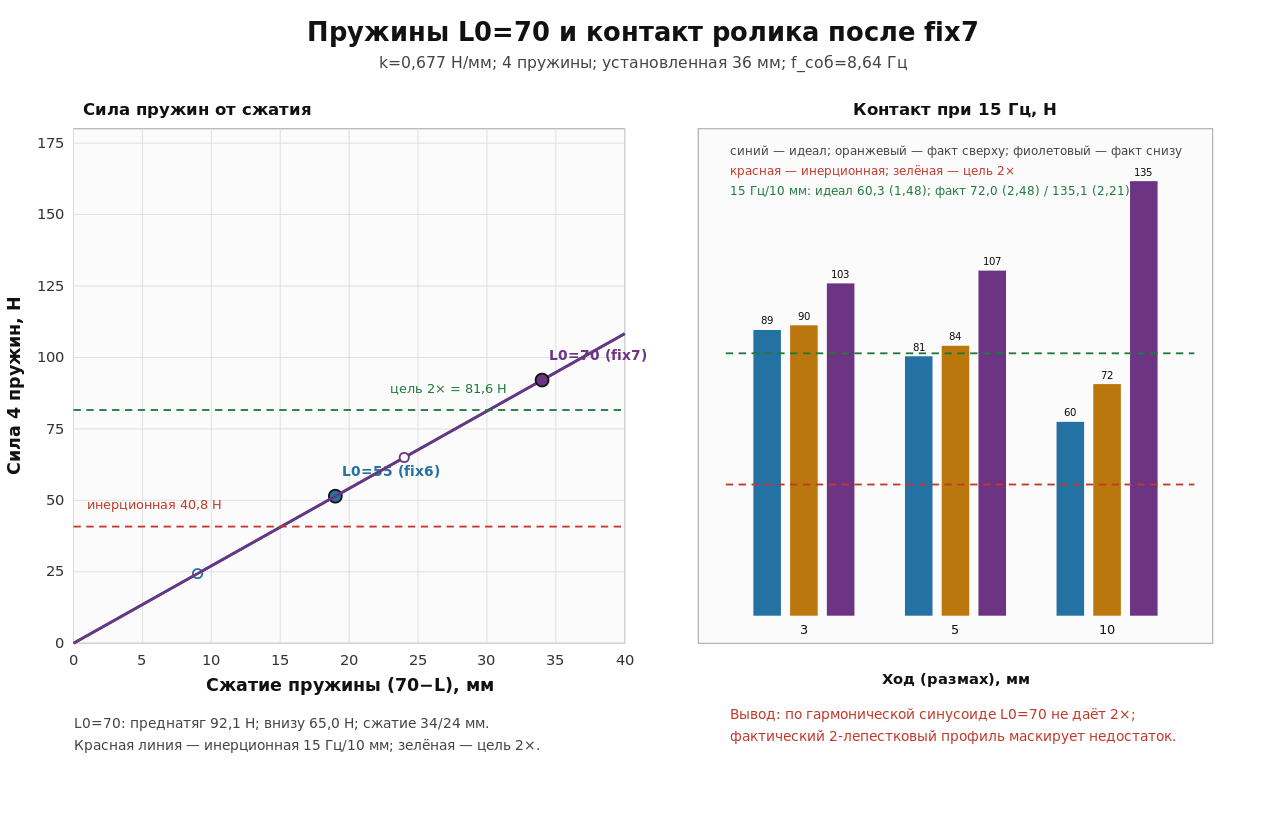
stages/expert3/pic/spring_contact_preview.png
