inutcin/boomboom/stages/expert3/pic/spring_stress_preview.png

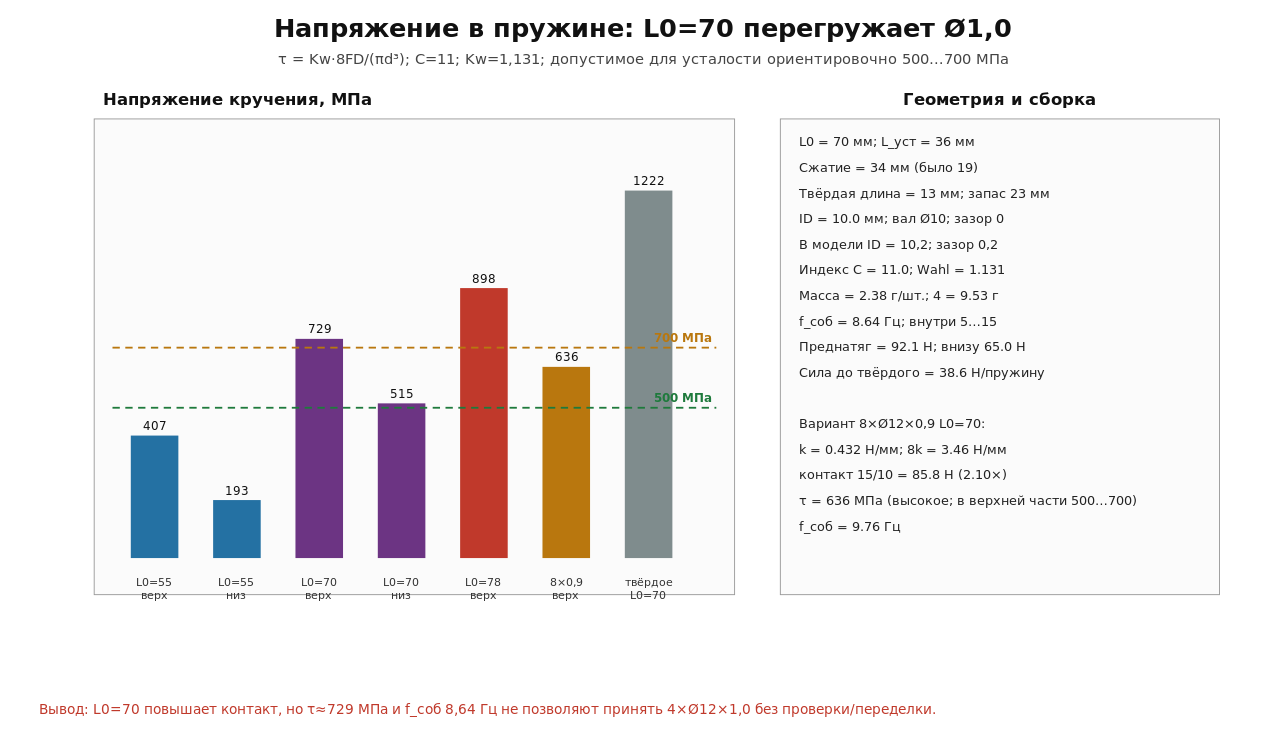
stages/expert3/pic/spring_stress_preview.png
