inutcin/boomboom/stages/expert/pics/dynamics.png

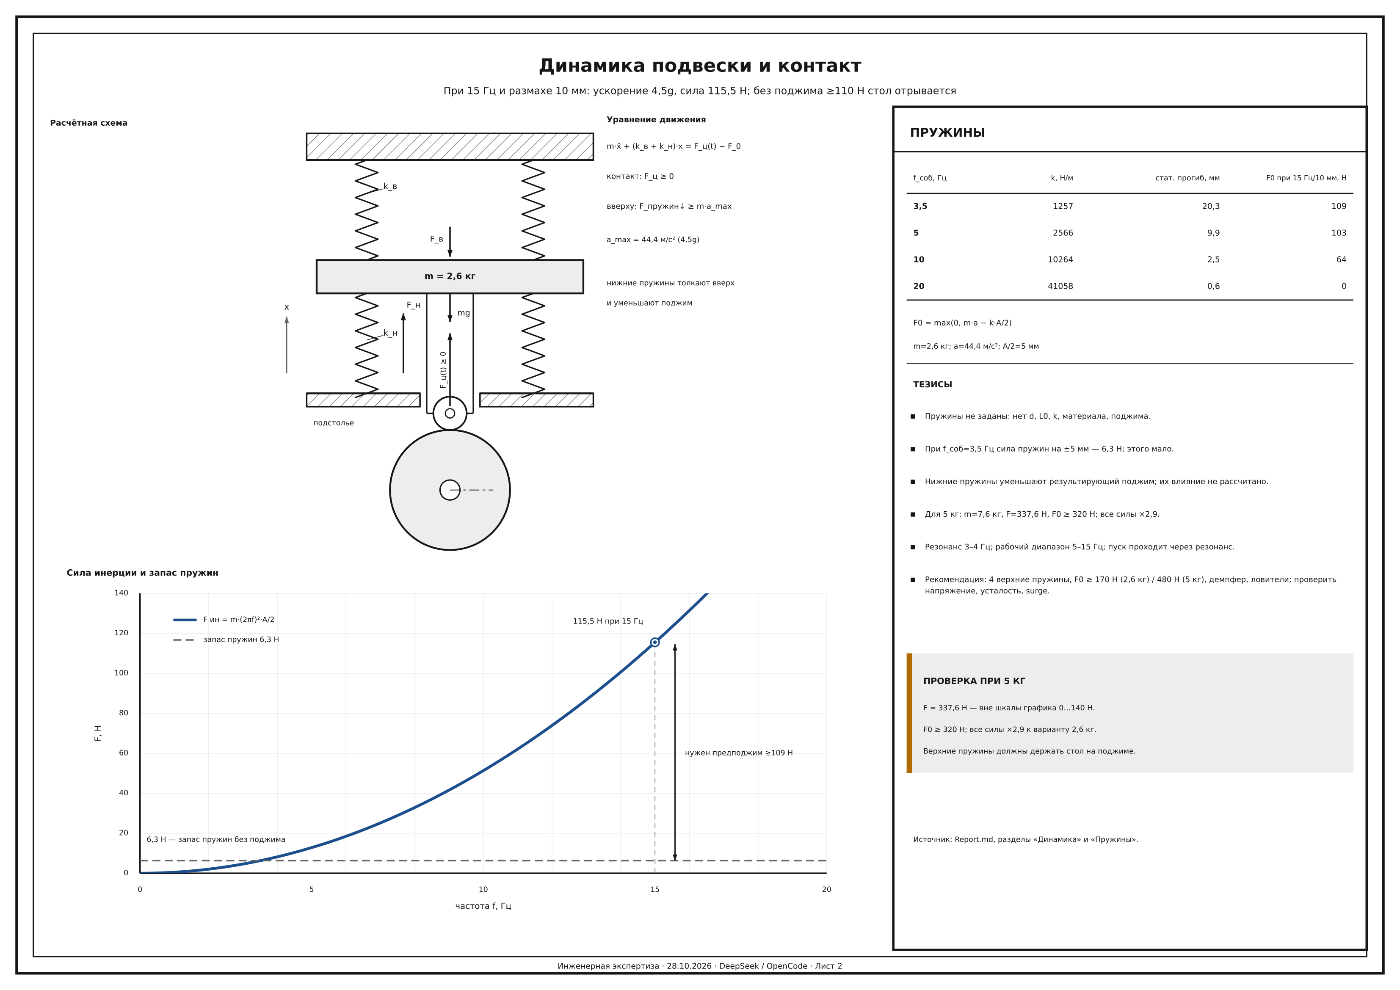
stages/expert/pics/dynamics.png
