inutcin/boomboom/stages/expert/pics/kinematics.png

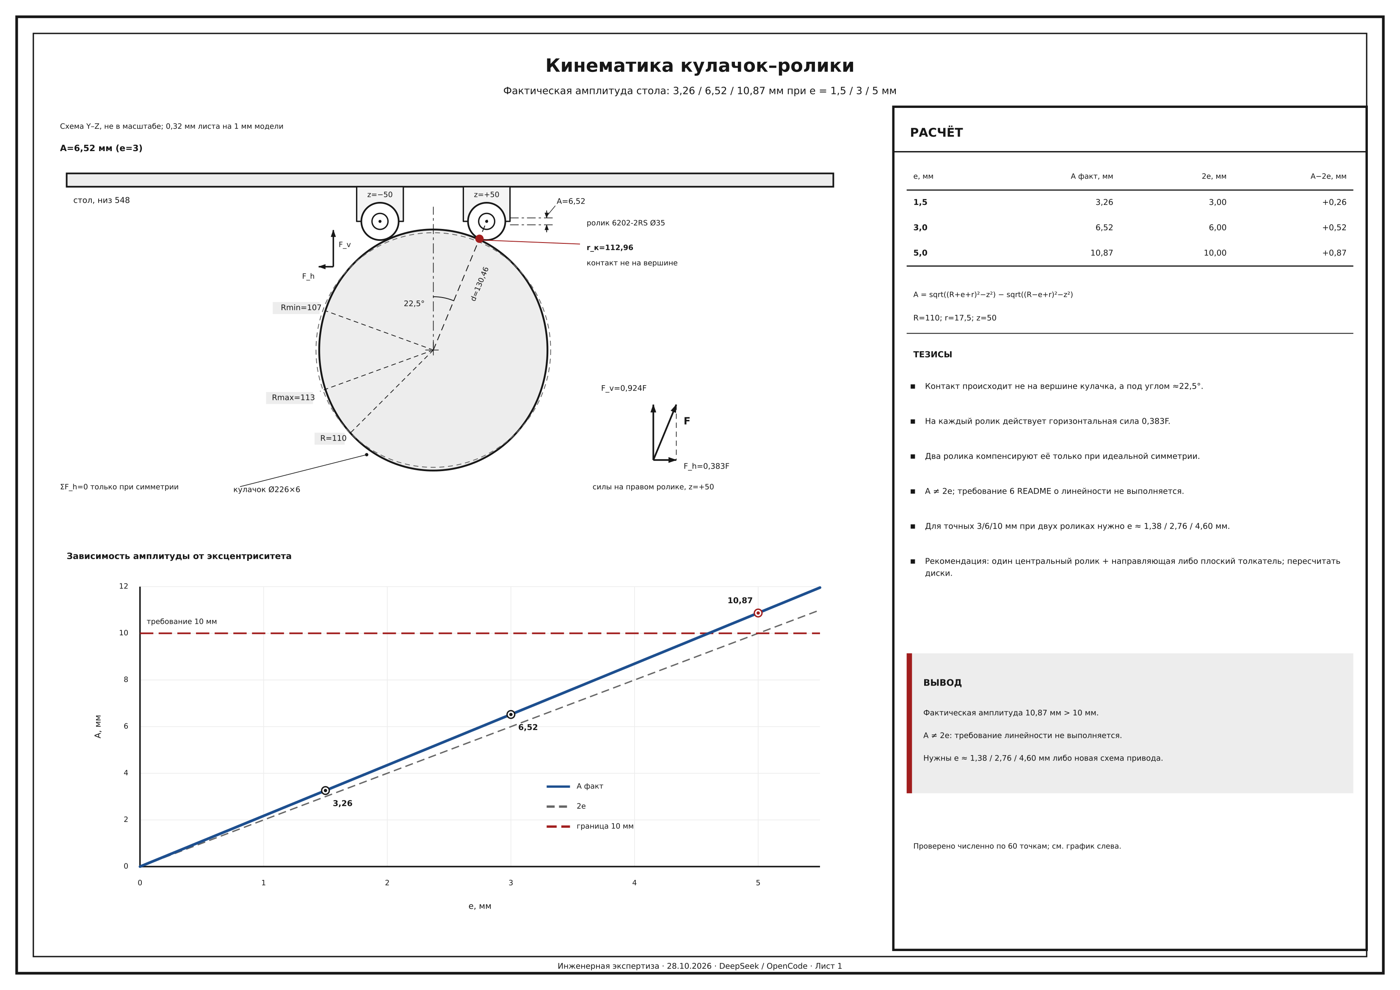
stages/expert/pics/kinematics.png
