inutcin/boomboom/stages/expert/pics/safety.png

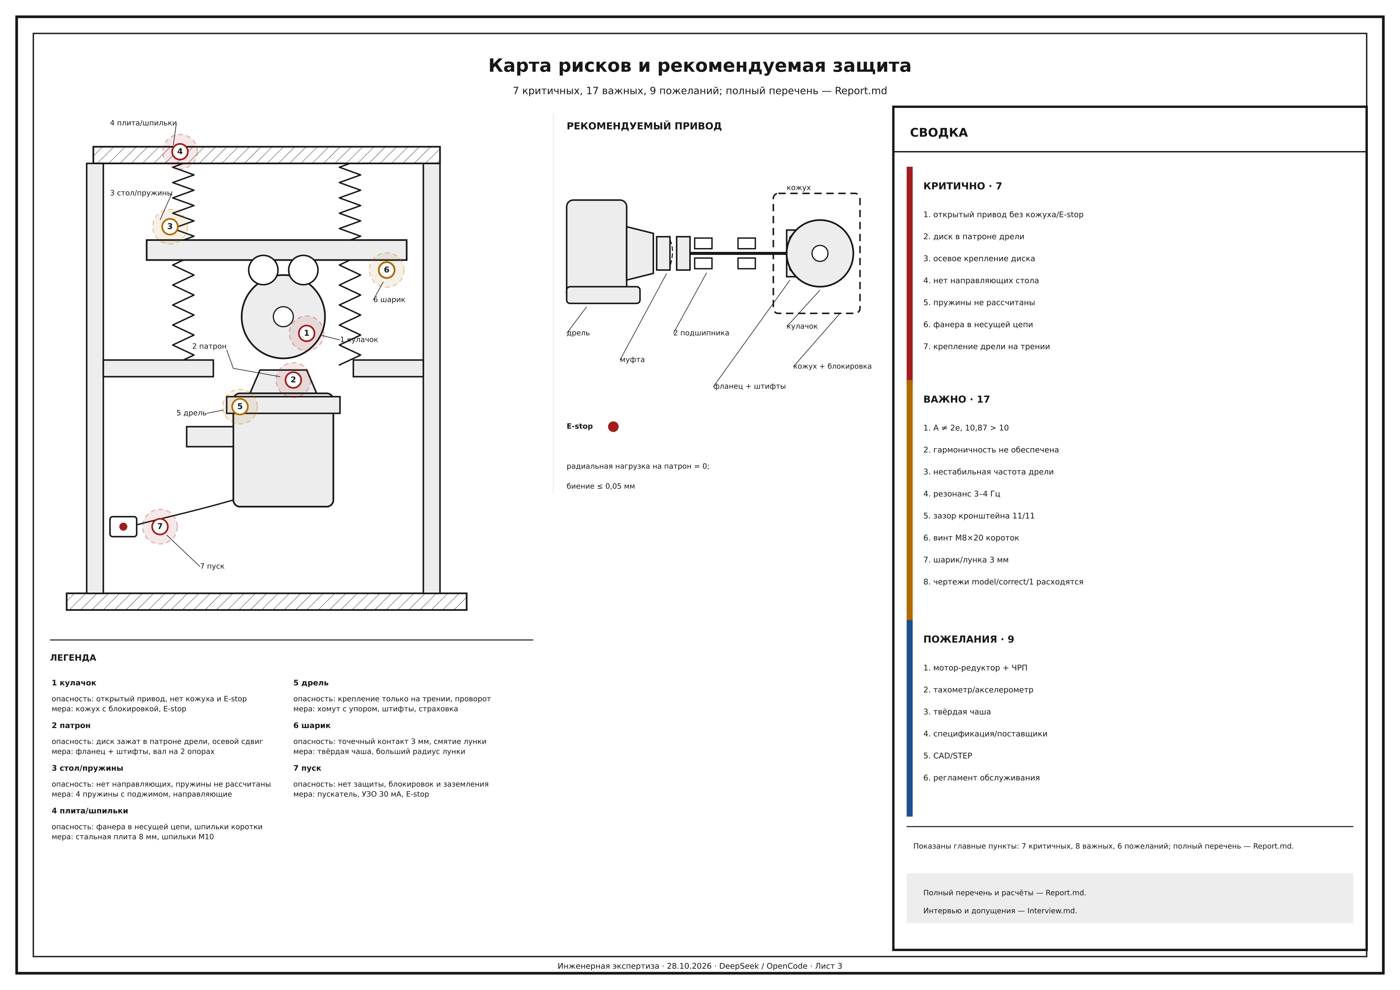
stages/expert/pics/safety.png
