inutcin/boomboom/stages/expert_correct/pic/00_cover.png

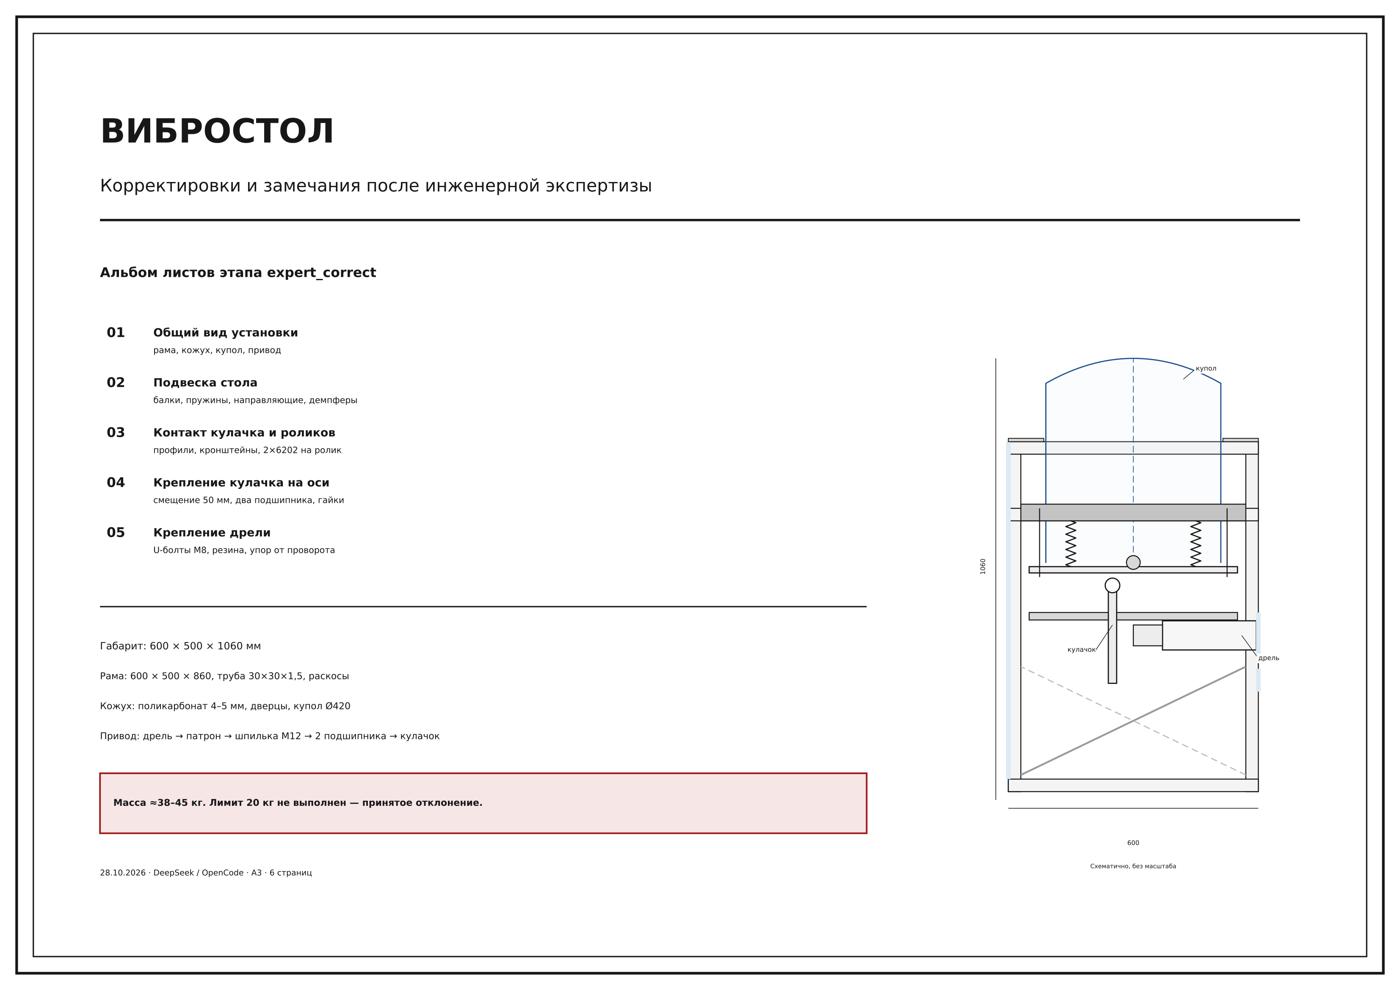
stages/expert_correct/pic/00_cover.png
