inutcin/boomboom/stages/expert_correct/pic/01_general.png

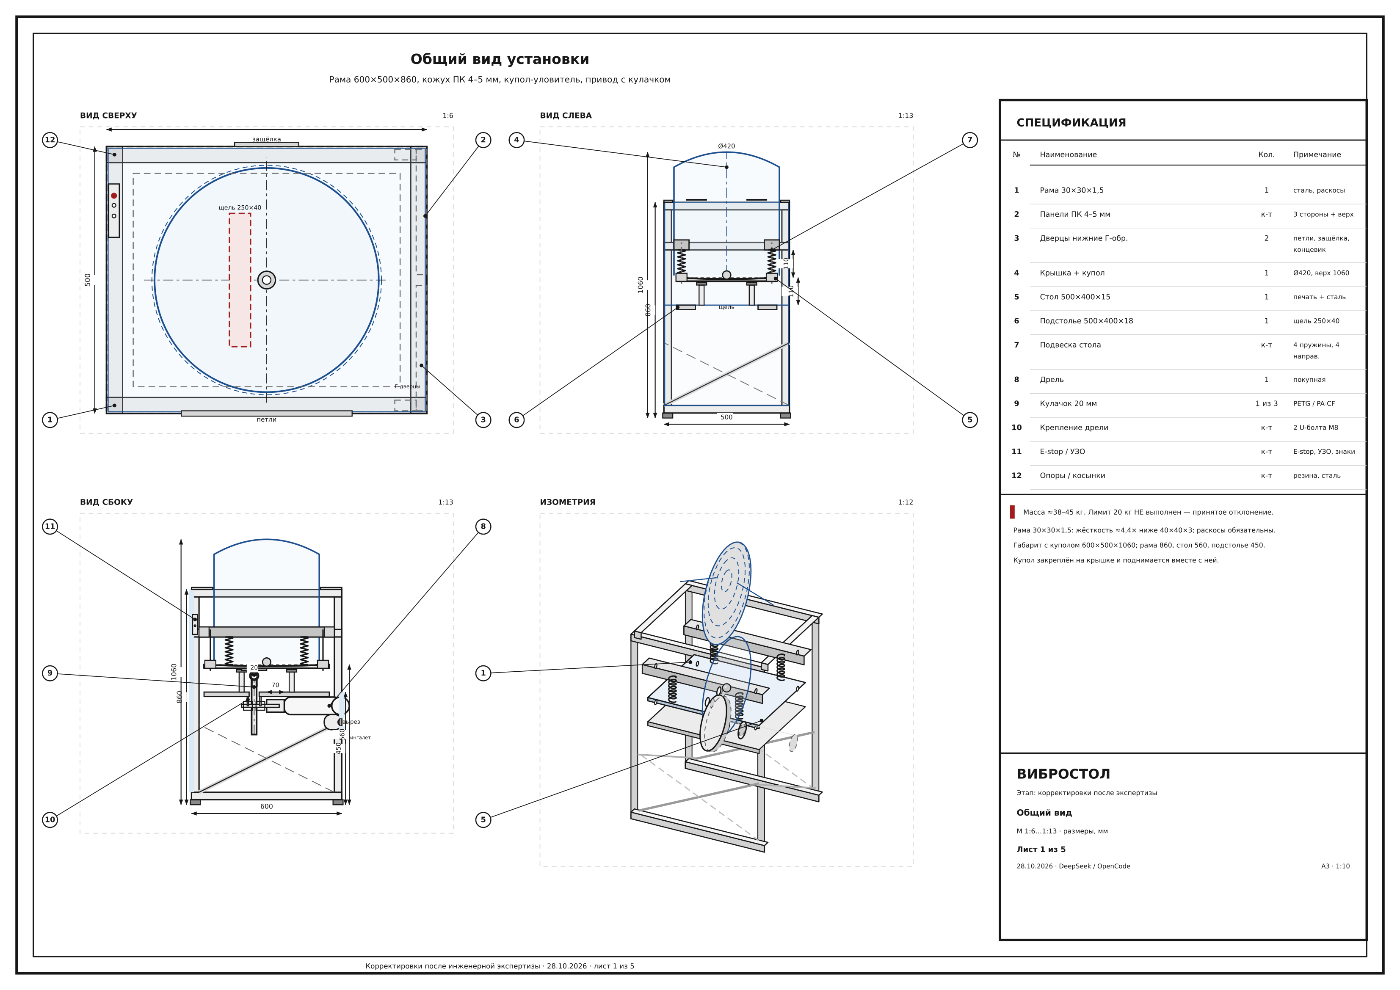
stages/expert_correct/pic/01_general.png
