inutcin/boomboom/stages/expert_correct/pic/04_cam_mount.png

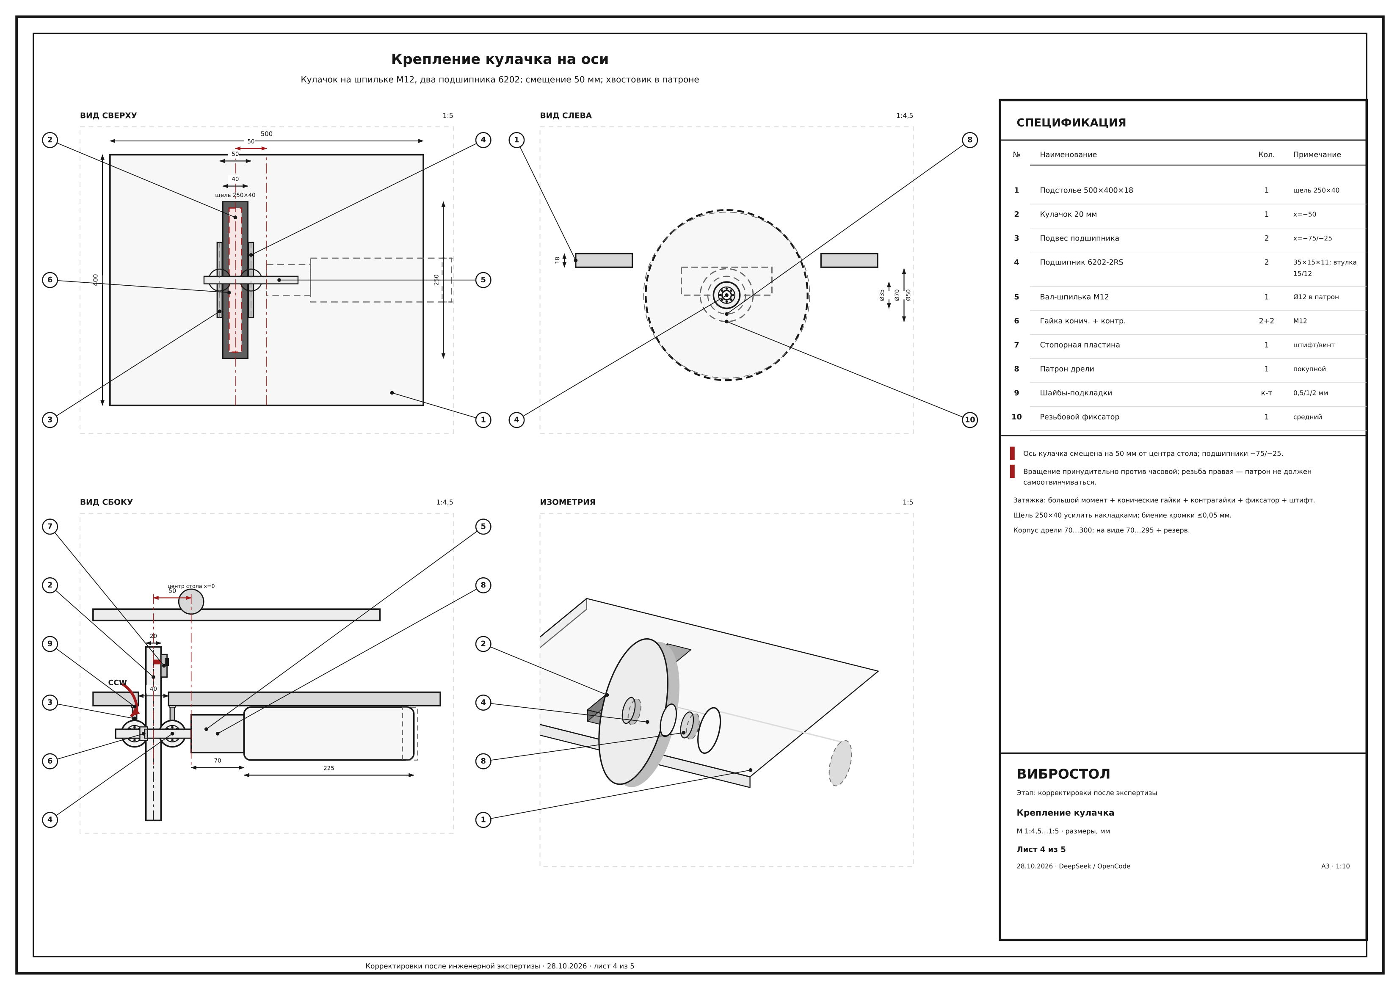
stages/expert_correct/pic/04_cam_mount.png
