inutcin/boomboom/stages/expert_correct/pic/05_drill_mount.png

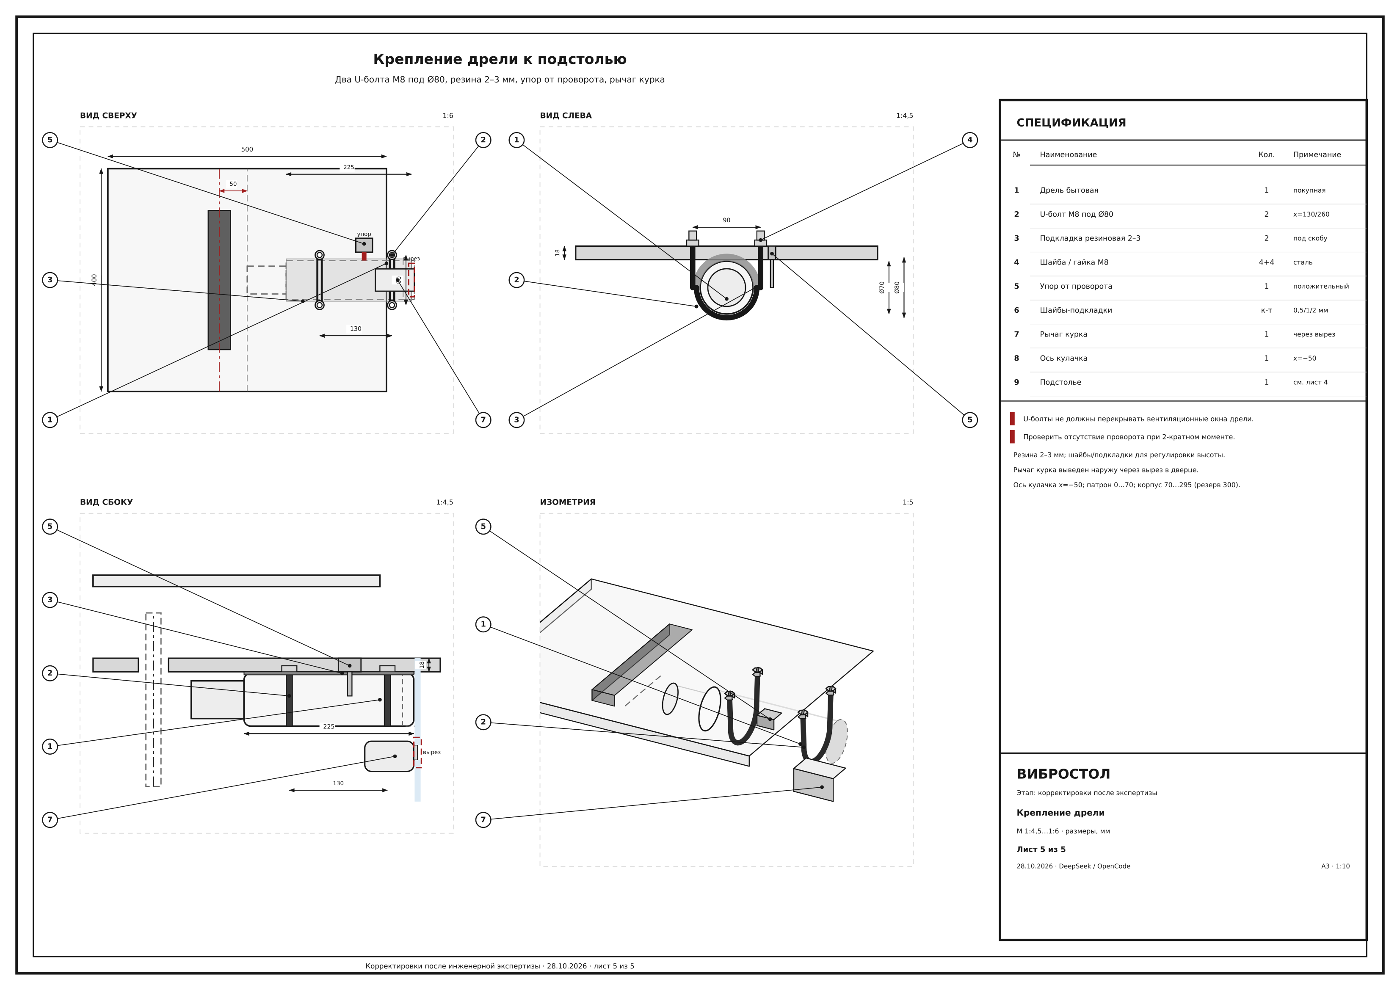
stages/expert_correct/pic/05_drill_mount.png
