inutcin/boomboom/stages/fix1/pic/spec_sheet.png

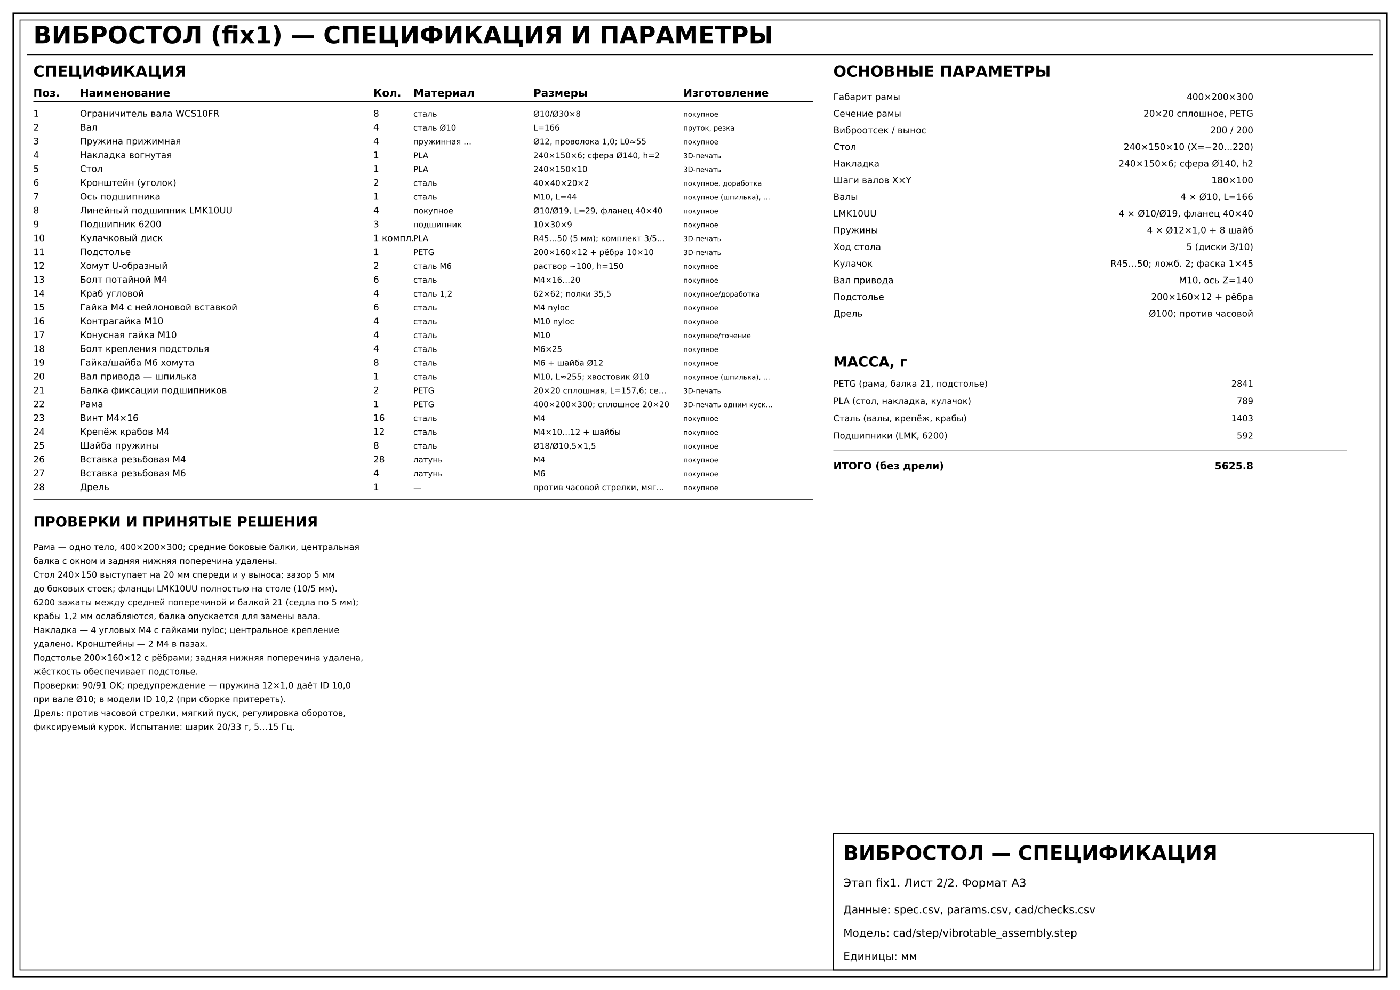
stages/fix1/pic/spec_sheet.png
