inutcin/boomboom/stages/fix3/pic/spec_sheet.png

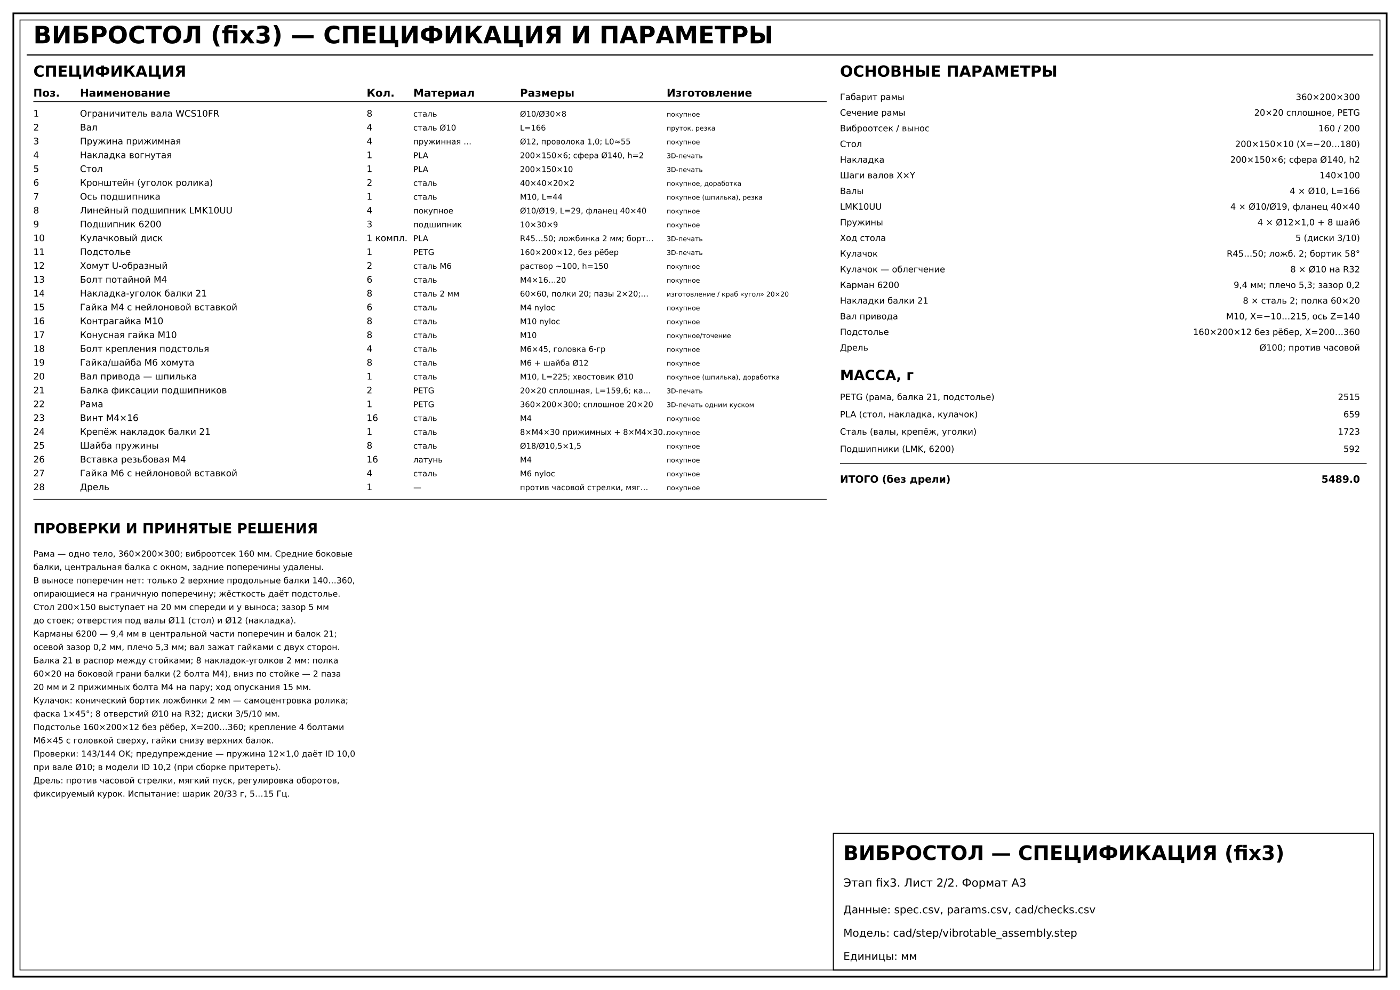
stages/fix3/pic/spec_sheet.png
