inutcin/boomboom/stages/fix10l/pic/spec.png

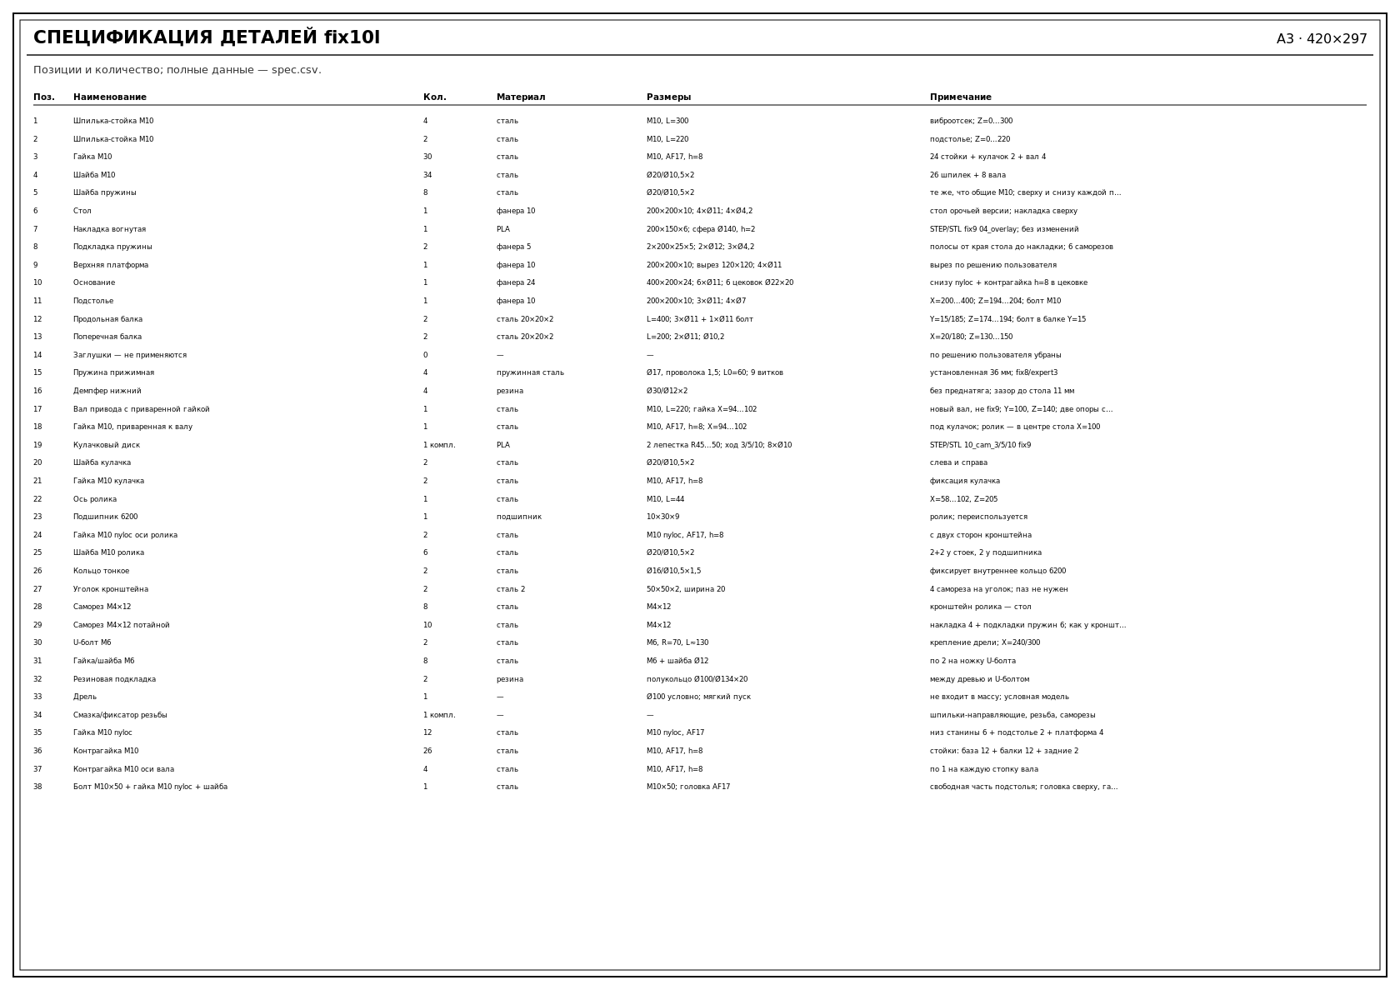
stages/fix10l/pic/spec.png
