inutcin/boomboom/stages/fix11/pic/vibrotable_spec.png

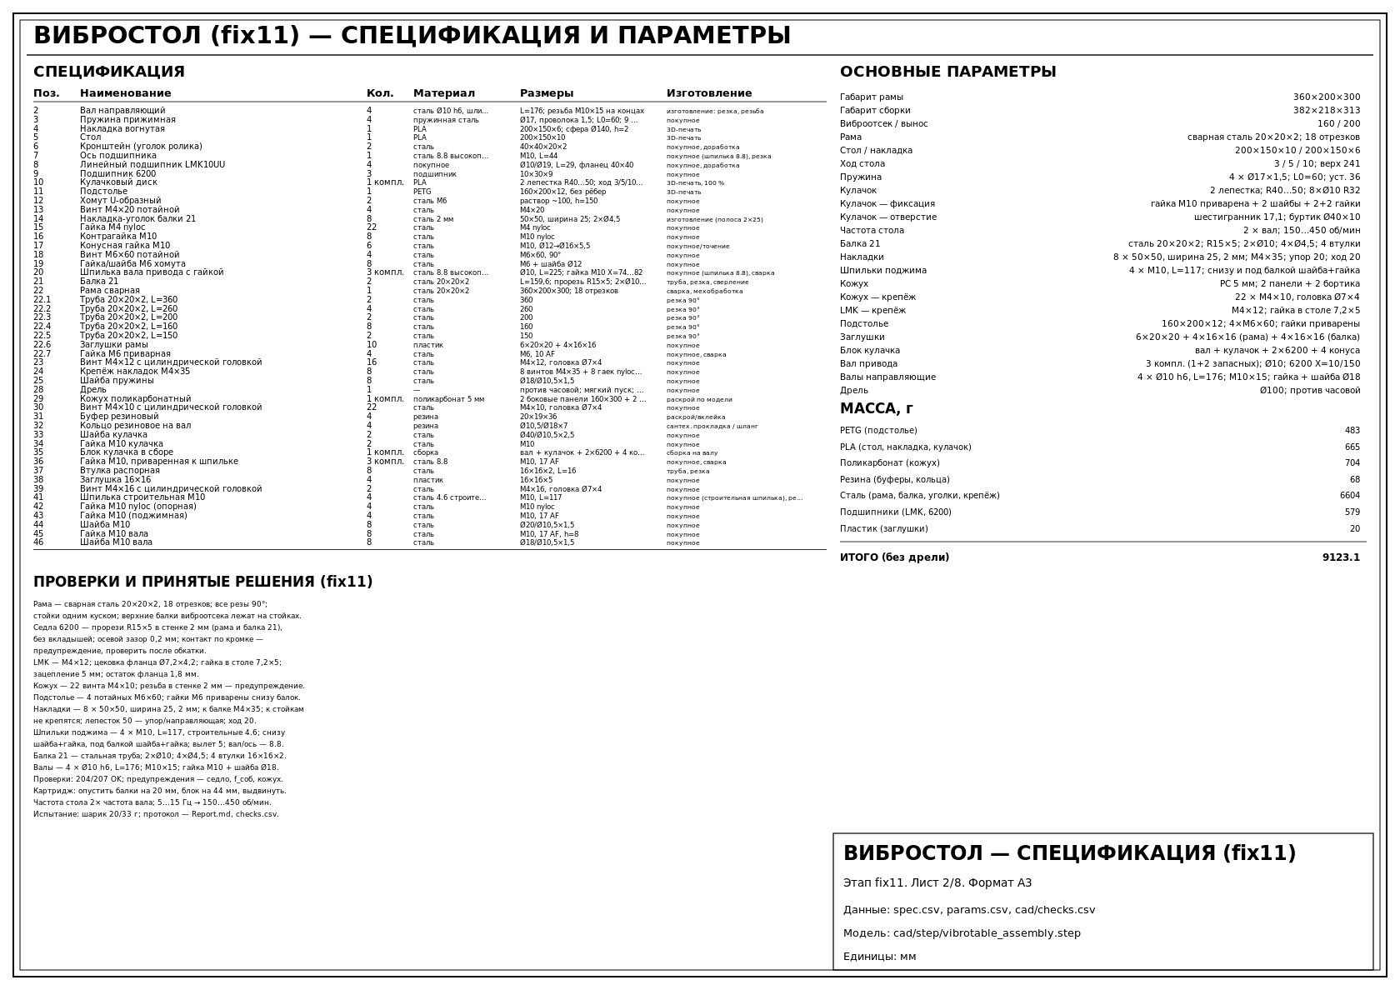
stages/fix11/pic/vibrotable_spec.png
