inutcin/boomboom/stages/model/pic/prev/render_cam.png

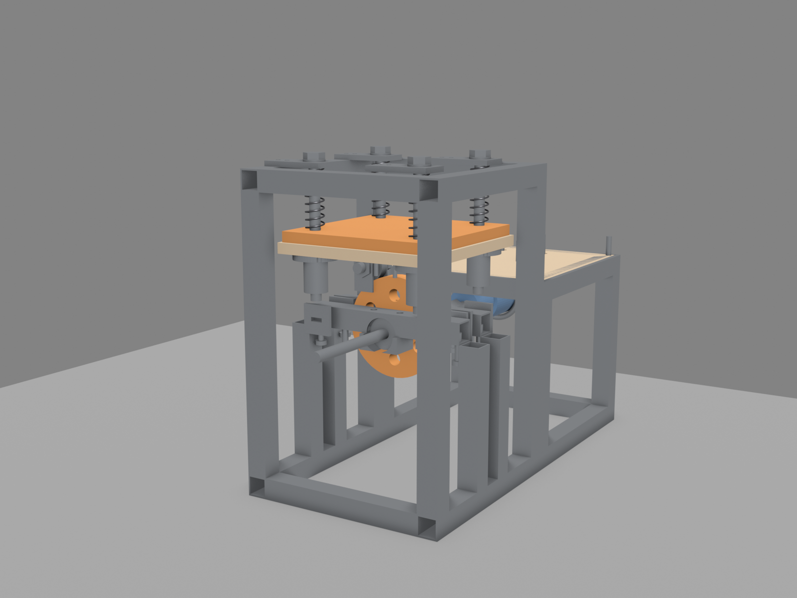
stages/model/pic/prev/render_cam.png
