inutcin/boomboom/stages/model/pic/prev/render_cam_axial.png

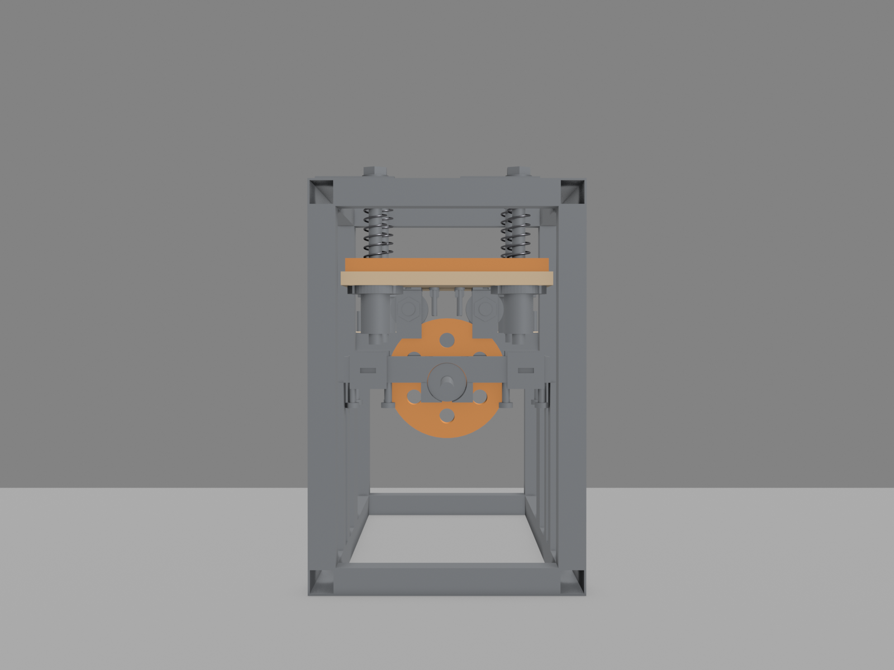
stages/model/pic/prev/render_cam_axial.png
