inutcin/boomboom/stages/model/pic/prev/render_front.png

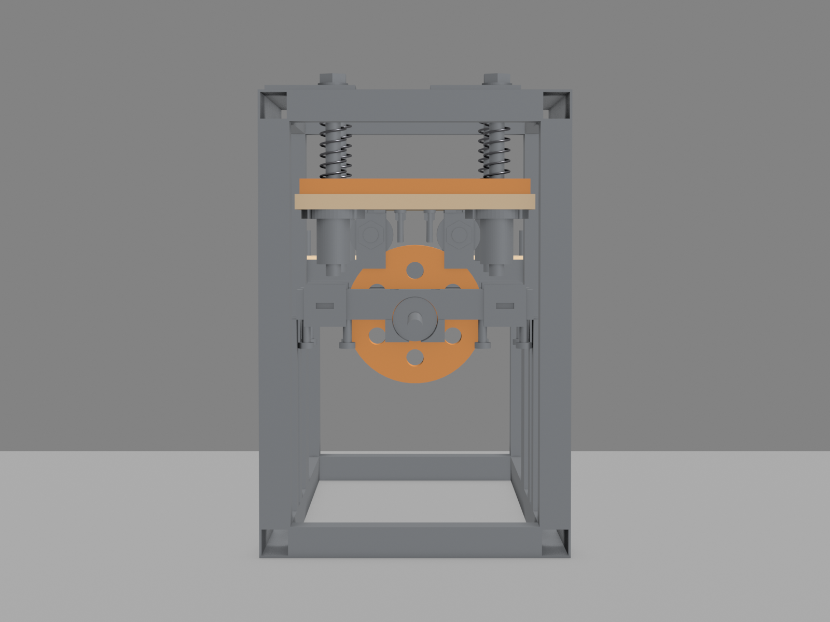
stages/model/pic/prev/render_front.png
