inutcin/boomboom/stages/model/pic/prev/render_iso.png

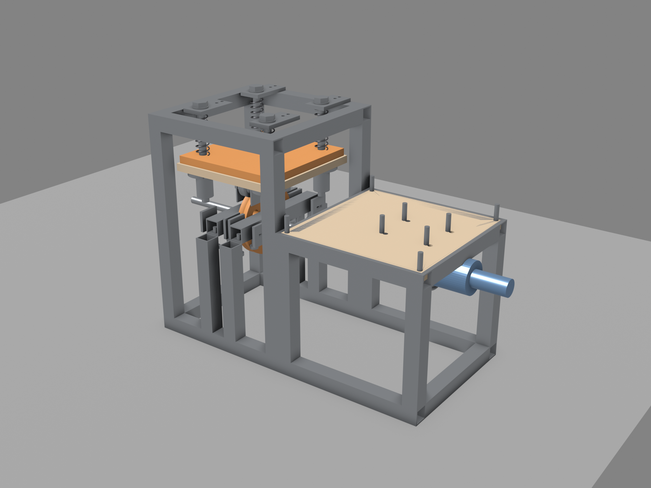
stages/model/pic/prev/render_iso.png
