inutcin/boomboom/stages/model/pic/prev/render_iso_rear.png

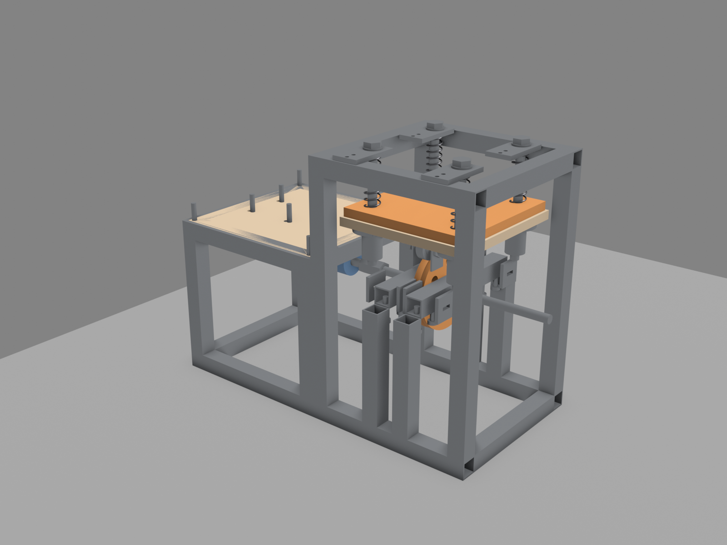
stages/model/pic/prev/render_iso_rear.png
