inutcin/boomboom/stages/model/pic/prev/render_left.png

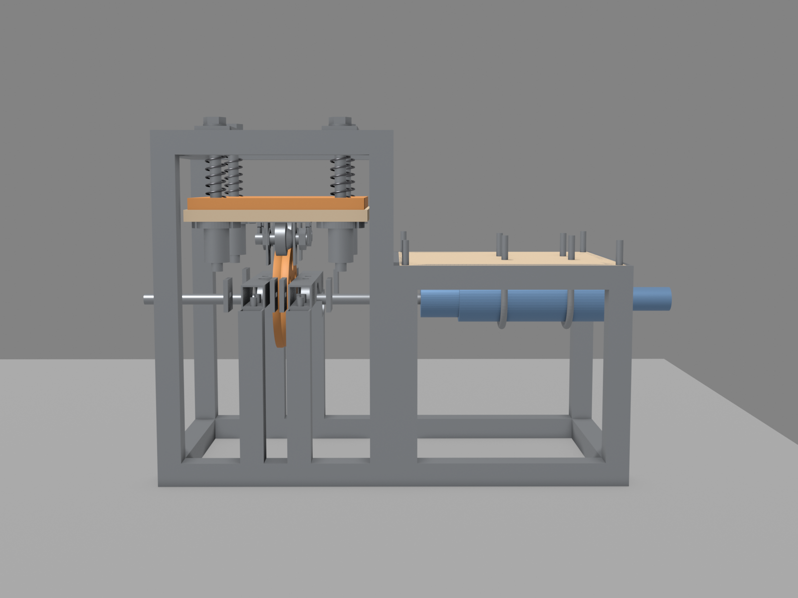
stages/model/pic/prev/render_left.png
