inutcin/boomboom/stages/model/pic/prev/render_mech_axial.png

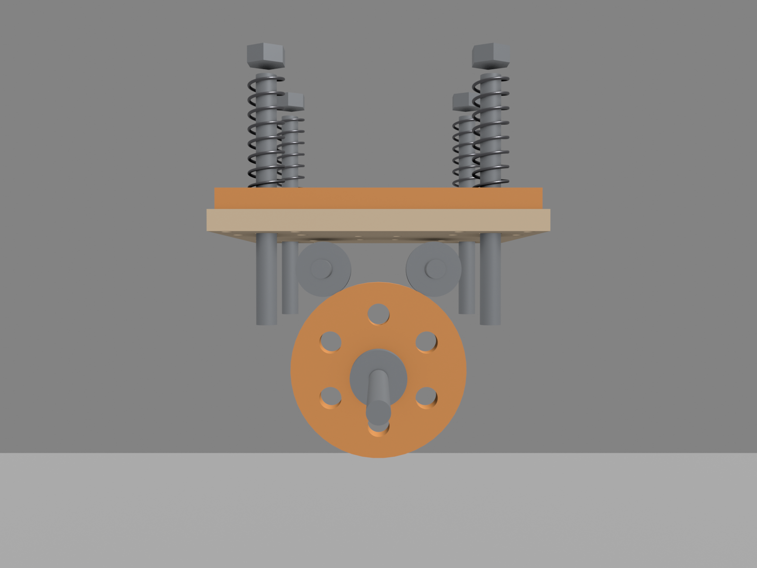
stages/model/pic/prev/render_mech_axial.png
