inutcin/boomboom/stages/model/pic/prev/render_mech_iso.png

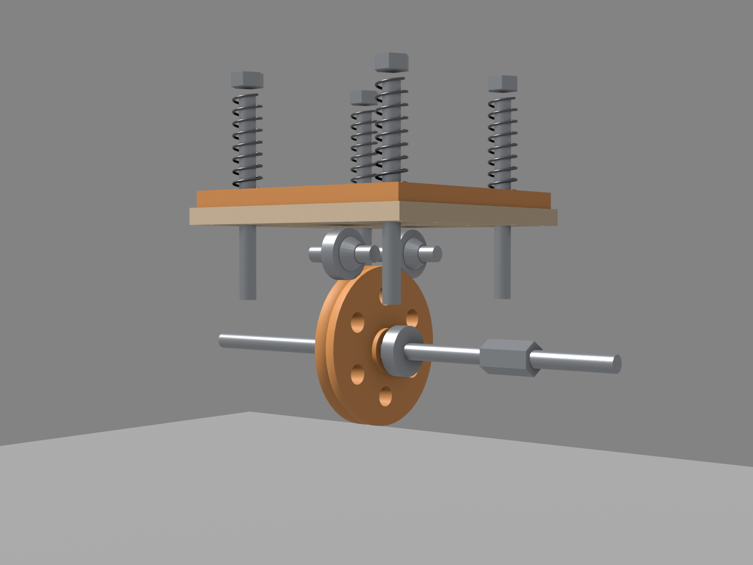
stages/model/pic/prev/render_mech_iso.png
