inutcin/boomboom/stages/model/pic/prev/render_top.png

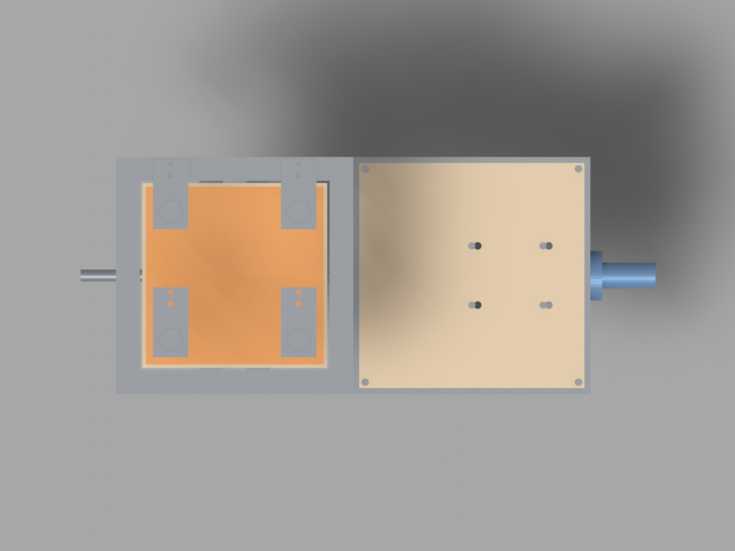
stages/model/pic/prev/render_top.png
