inutcin/boomboom/stages/model/pic/prev/spec_sheet.png

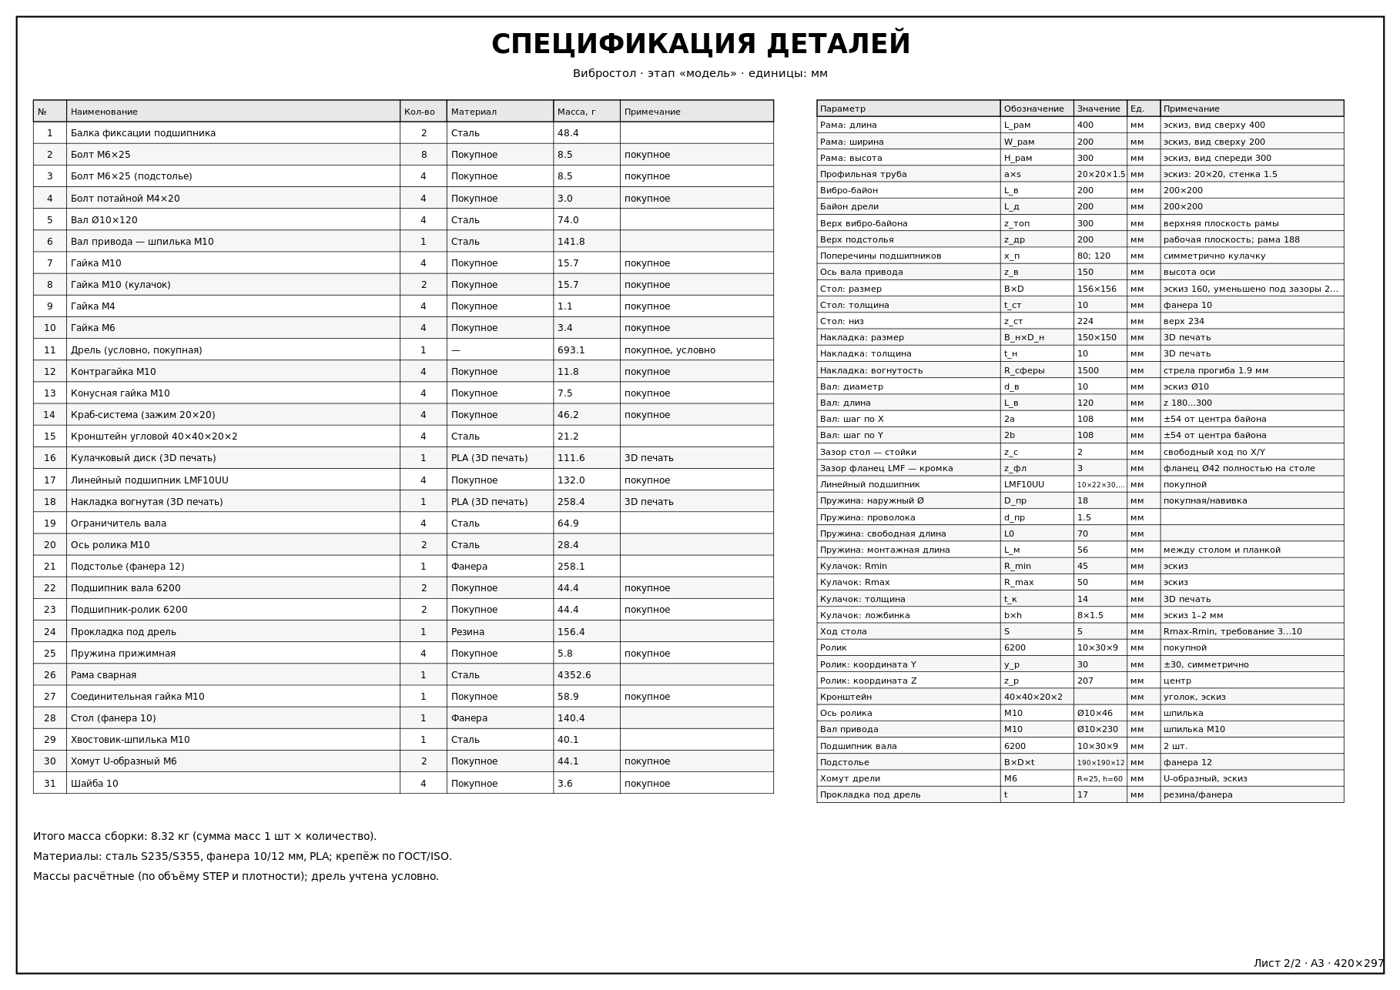
stages/model/pic/prev/spec_sheet.png
