inutcin/boomboom/stages/model/pic/prev/views_sheet.png

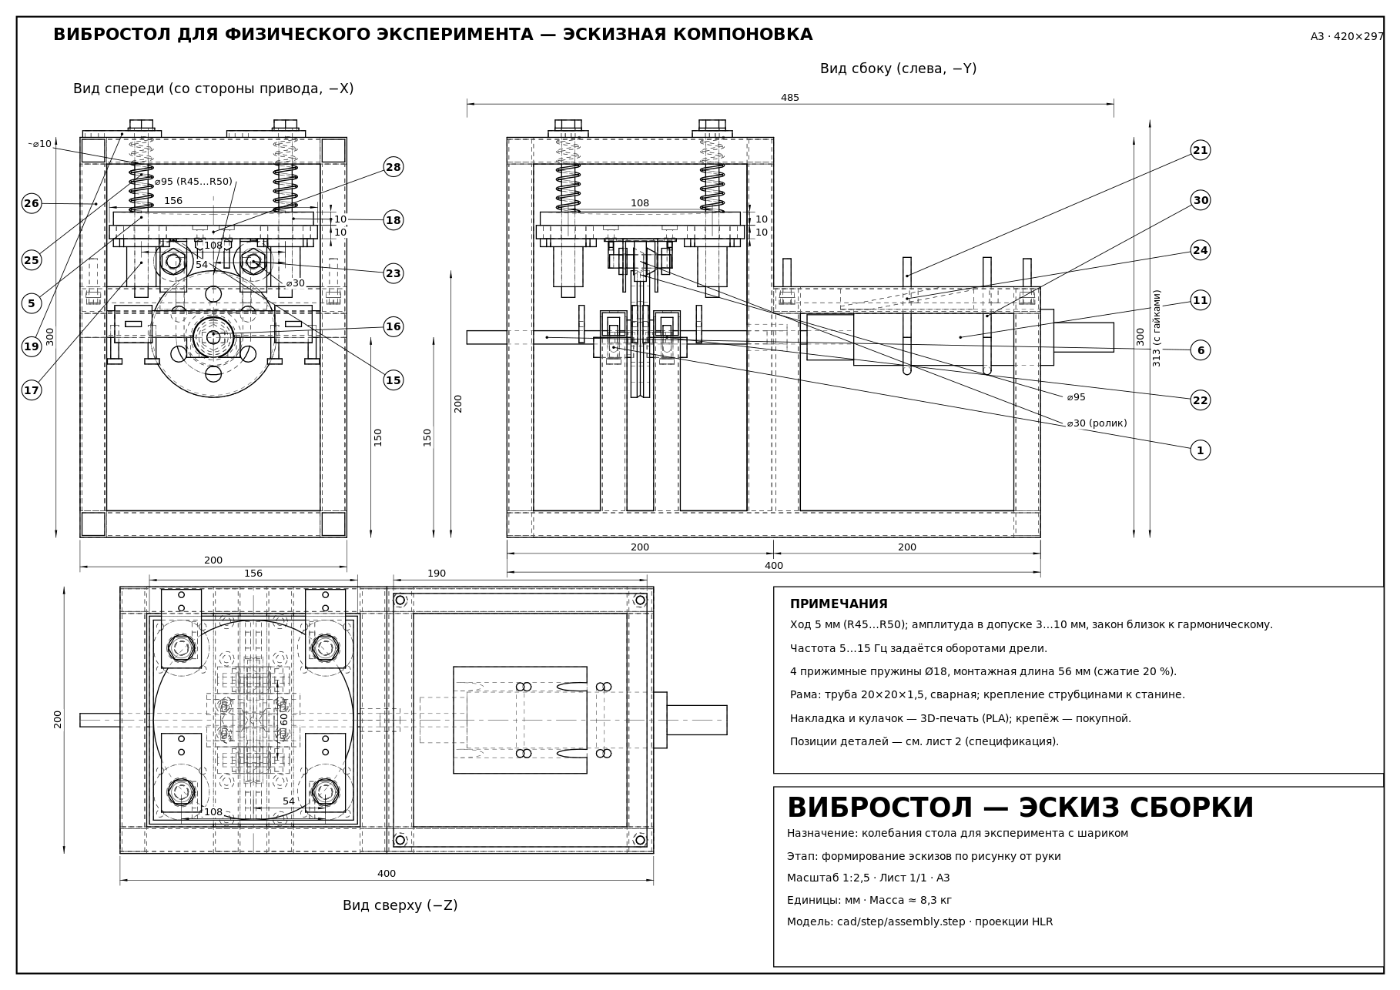
stages/model/pic/prev/views_sheet.png
