inutcin/boomboom/stages/model/pic/spec_sheet.png

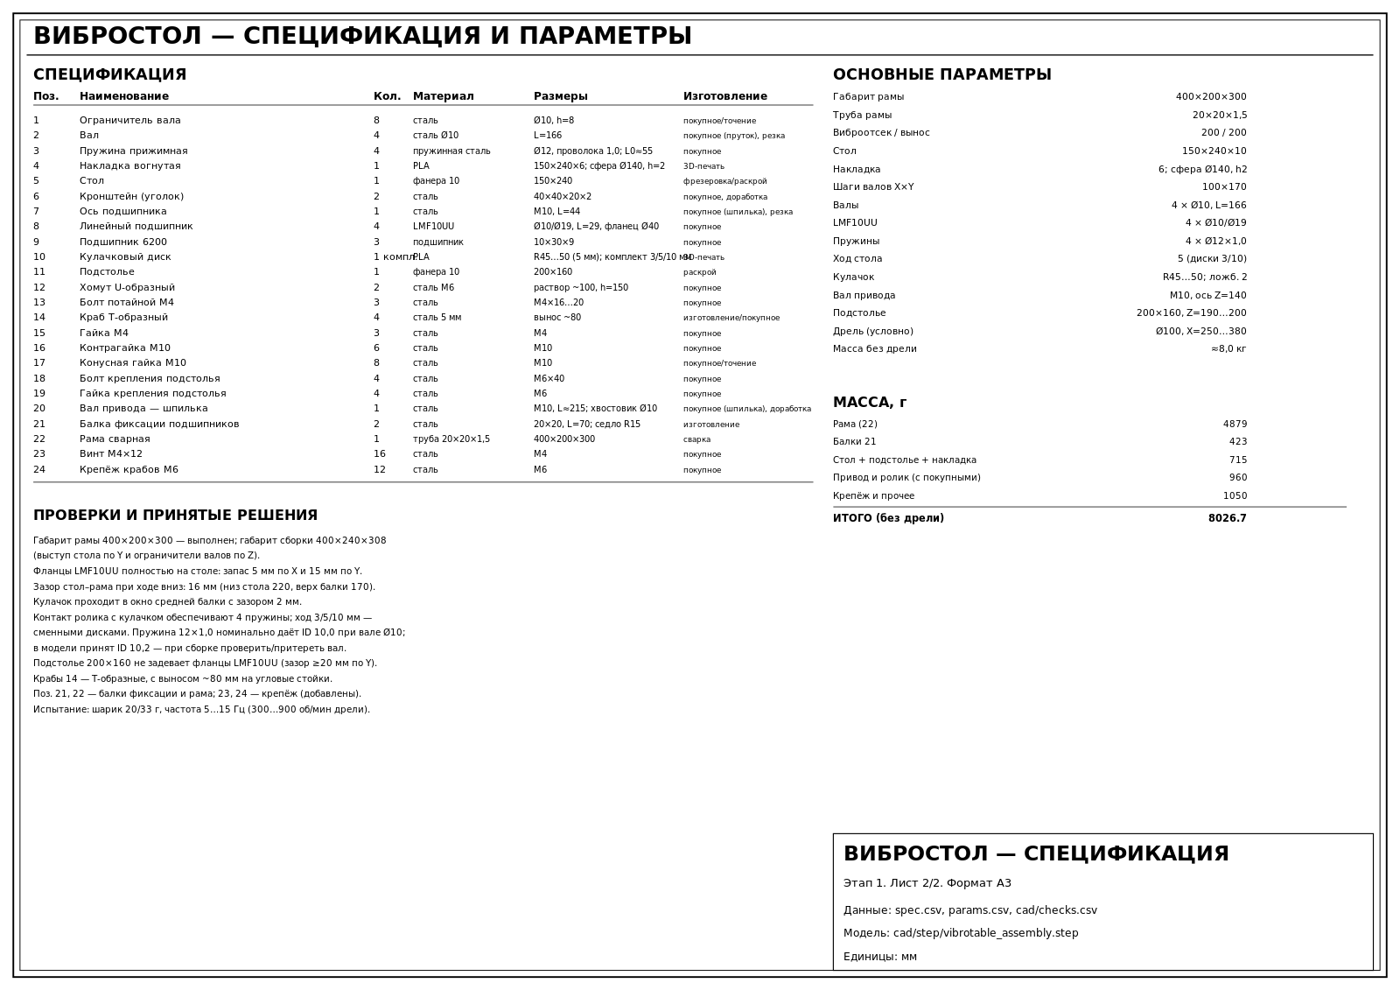
stages/model/pic/spec_sheet.png
