inutcin/boomboom/stages/model/pic/vibrotable_top.png

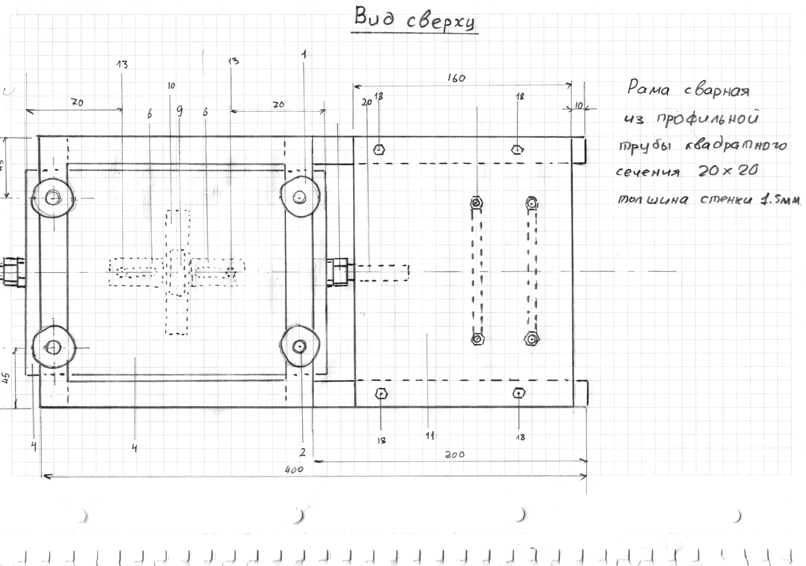
stages/model/pic/vibrotable_top.png
