inutcin/boomboom/stages/model/pic/views_sheet.png

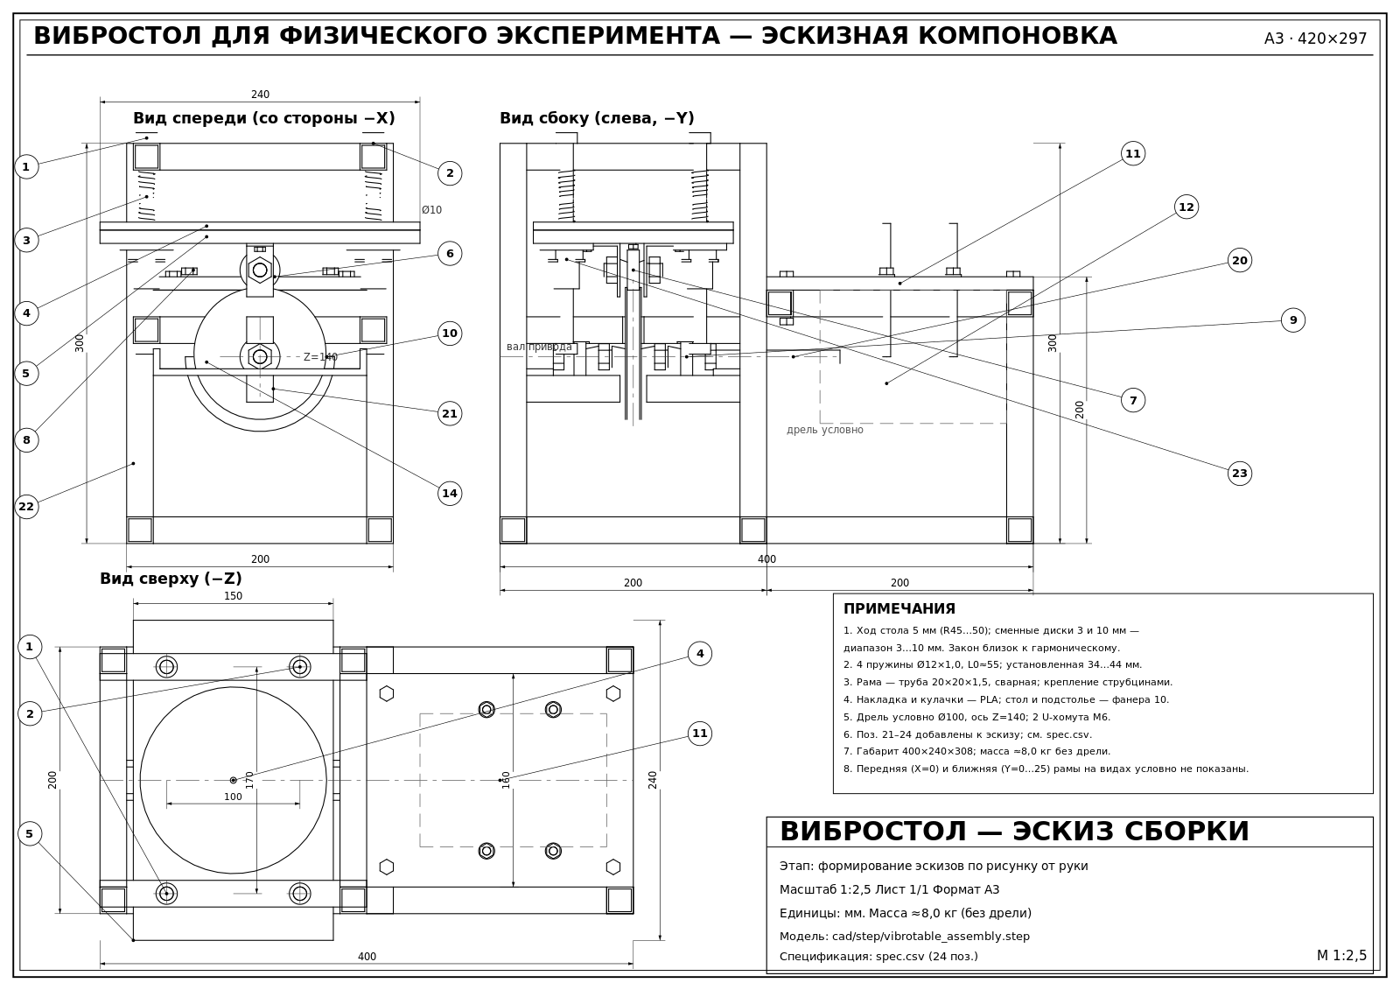
stages/model/pic/views_sheet.png
