inutcin/boomboom/stages/model/pics/common_idea.jpg

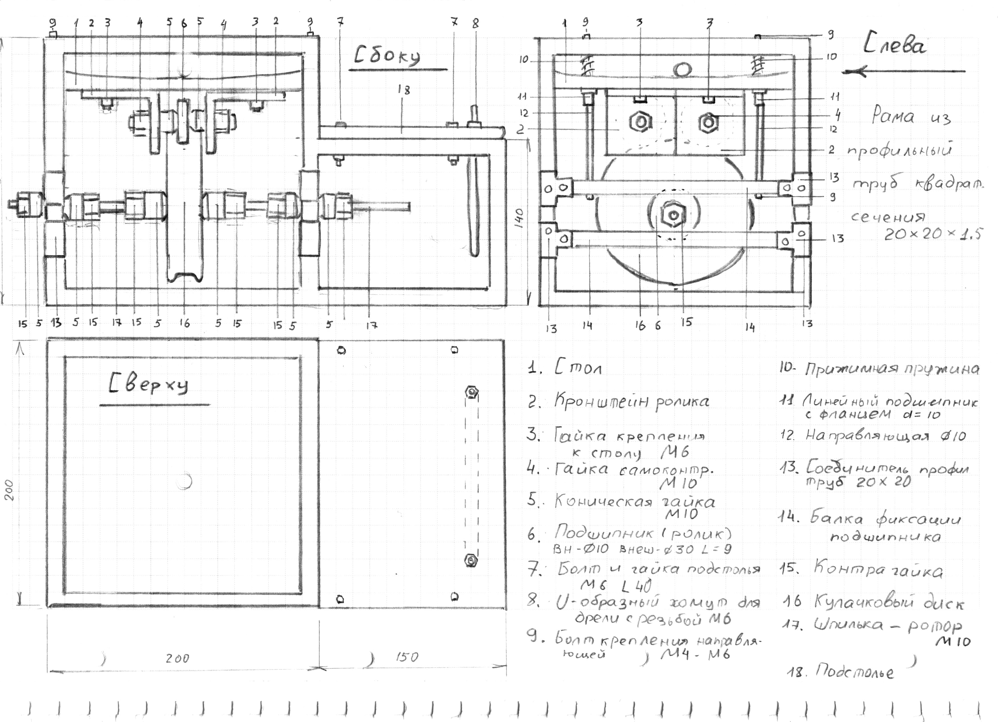
stages/model/pics/common_idea.jpg
