inutcin/boomboom/stages/model/pics/isometric.png

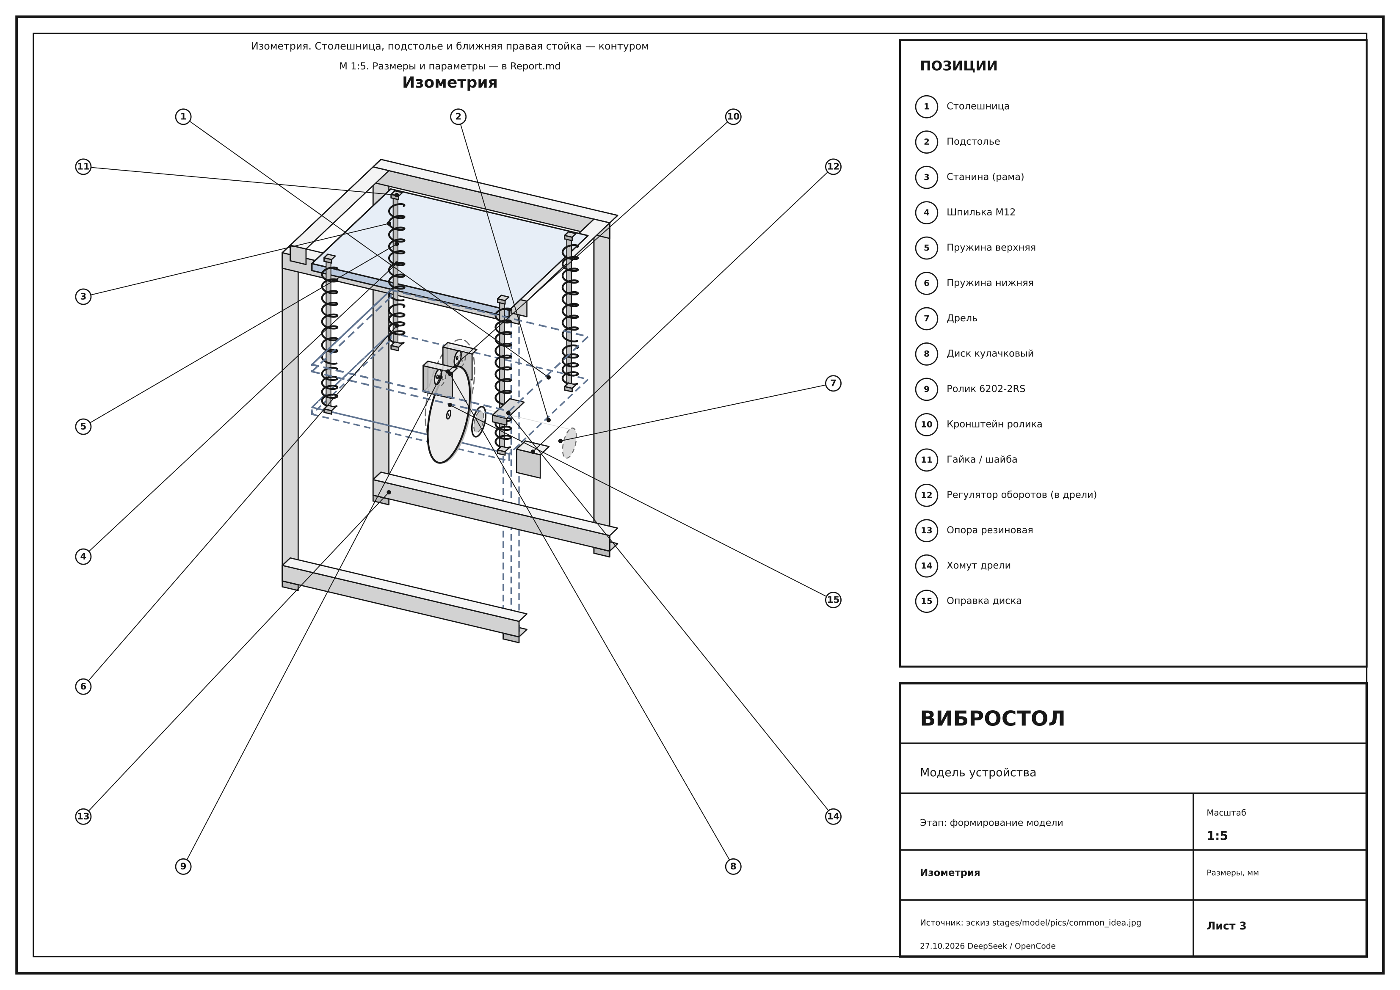
stages/model/pics/isometric.png
