inutcin/boomboom/stages/model/pics/left_view.png

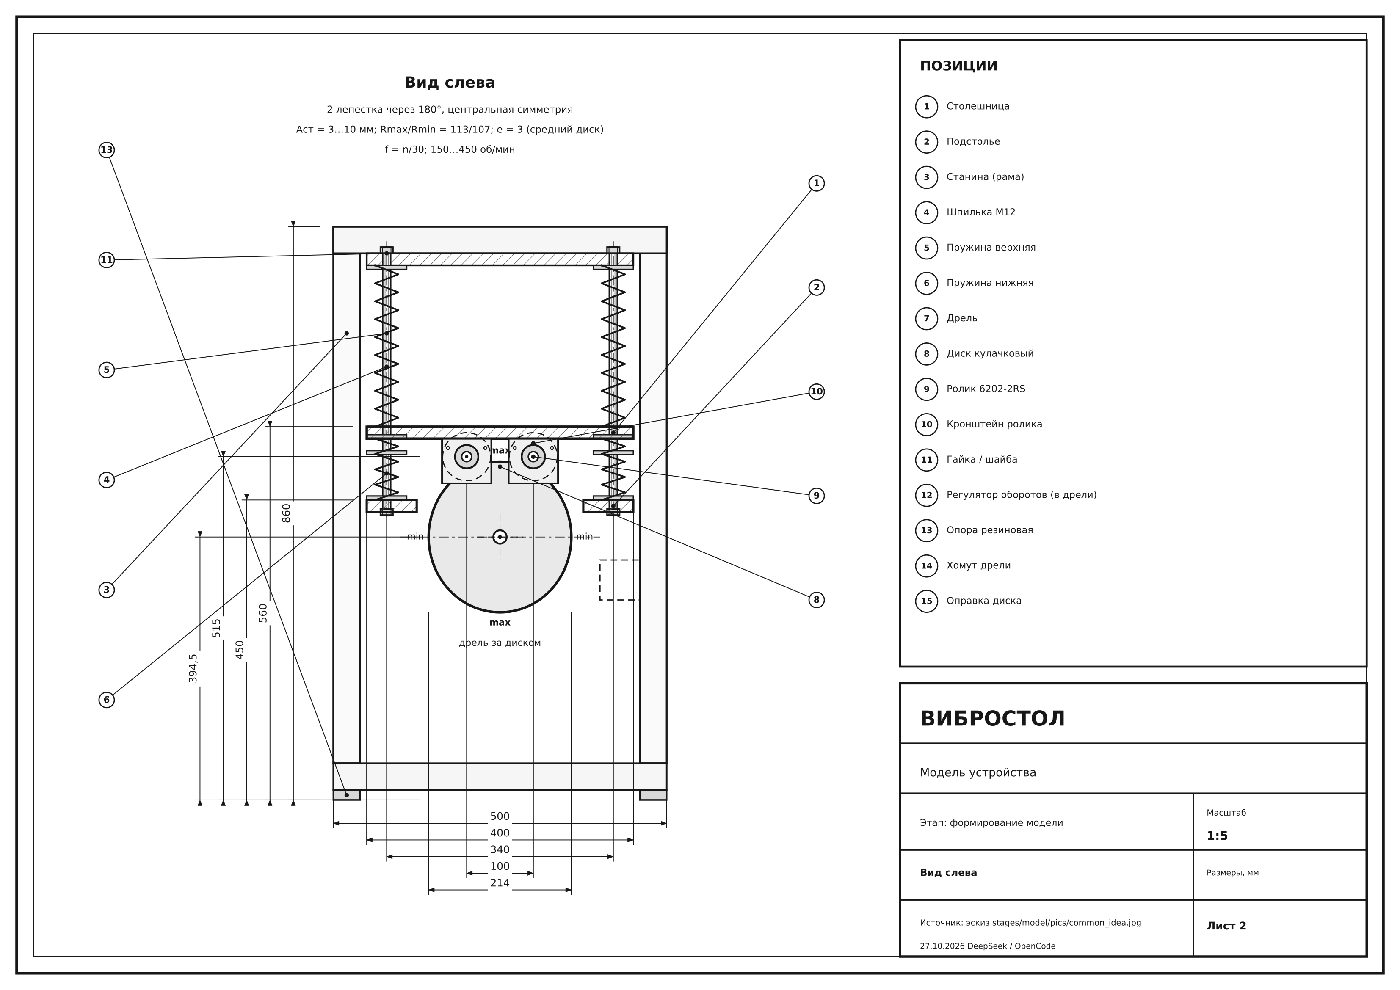
stages/model/pics/left_view.png
