inutcin/boomboom/stages/model/pics/side_view.png

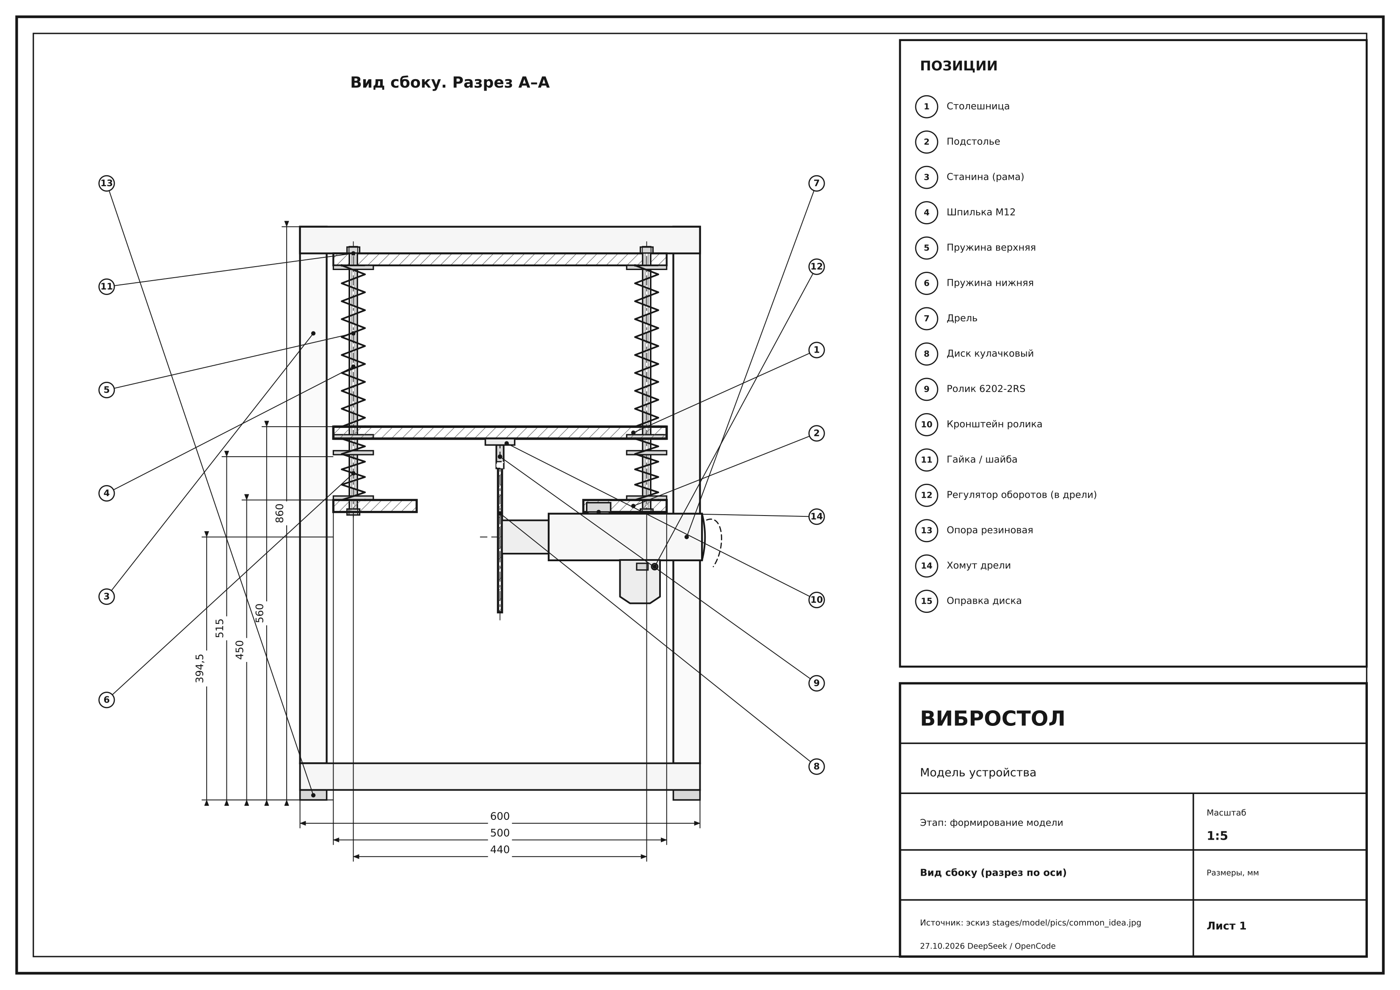
stages/model/pics/side_view.png
