inutcin/boomboom/stages/fix11/shopping.csv

Группа | Поз. | Наименование | Кол. | Материал / размер | Примечание | Единицы измерения | Единиц измерения в шт. | Требуется единиц | Единиц в купленном комплекте | Цена комплекта | Куплено в комплектов | Стоимость | Остаток единиц | Стоимость остатка | Ссылка
Крепёж | 41 | Шпилька строительная M10, L=117 | 4 | сталь 4.6 | 2 на балку; Y=60/140 | мм | 117 | 468 | 1000 | 272 | 1 | 272 | 532 | 144,704 | https://www.ozon.ru/product/burke-shpilka-krepezhnaya-1-sht-5329754360/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
Крепёж | 42 | Гайка M10 nyloc (опорная) | 4 | сталь | на верхнюю грань нижней балки, через шайбу | шт | 1 | 4 | 10 | 88 | 2 | 176 | 16 | 140,8 | https://www.ozon.ru/product/gayka-m10-stopornaya-samokontryashchayasya-s-neylonovym-koltsom-din985-10-sht-3882171076/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
Крепёж | 43 | Гайка M10 (поджимная) | 4 | сталь | снизу прижимной балки |  |  | 0 |  |  |  | 0 | 0 | #ДЕЛ/0! | https://www.ozon.ru/product/gayka-shestigrannaya-m10-10sht-din-934-otsinkovannaya-2922782237/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
Крепёж | 44 | Шайба M10 Ø20/Ø10,5×1,5 | 8 | сталь | 4 опорные + 4 поджимные |  |  | 0 |  |  |  | 0 | 0 | #ДЕЛ/0!
Крепёж | 24 | Винт M4×35 с цилиндрической головкой | 8 | сталь | накладки; 2 на конец |  |  | 0 |  |  |  | 0 | 0 | #ДЕЛ/0!
Крепёж | 24 | Гайка M4 nyloc для накладок | 8 | сталь | в комплекте с винтами M4×35 |  |  | 0 |  |  |  | 0 | 0 | #ДЕЛ/0!
Крепёж | 24 | Шайба M4 Ø9/Ø4,3×1 | 16 | сталь | под головку и гайку |  |  | 0 |  |  |  | 0 | 0 | #ДЕЛ/0!
Крепёж | 23 | Винт M4×12 с цилиндрической головкой | 16 | сталь | LMK10UU |  |  | 0 |  |  |  | 0 | 0 | #ДЕЛ/0!
Крепёж | 15 | Гайка M4 nyloc | 22 | сталь | 16 LMK + 4 накладка + 2 кронштейна |  |  | 0 |  |  |  | 0 | 0 | #ДЕЛ/0!
Крепёж | 13 | Винт M4×20 потайной | 4 | сталь | углы накладки |  |  | 0 |  |  |  | 0 | 0 | #ДЕЛ/0!
Крепёж | 39 | Винт M4×16 с цилиндрической головкой | 2 | сталь | кронштейны ролика |  |  | 0 |  |  |  | 0 | 0 | #ДЕЛ/0!
Крепёж | 30 | Винт M4×10 с цилиндрической головкой | 22 | сталь | кожух; резьба в раме |  |  | 0 |  |  |  | 0 | 0 | #ДЕЛ/0!
Крепёж | 18 | Винт M6×60 потайной | 4 | сталь | подстолье |  |  | 0 |  |  |  | 0 | 0 | #ДЕЛ/0!
Крепёж | 19 | Гайка/шайба M6 хомута | 8 | сталь | U-хомуты; по 2 на ножку |  |  | 0 |  |  |  | 0 | 0 | #ДЕЛ/0!
Крепёж | 16 | Гайка M10 nyloc (6200/кулачок/ролик) | 8 | сталь | 4 опоры 6200 + 2 кулачок + 2 ролик |  |  | 0 |  |  |  | 0 | 0 | #ДЕЛ/0!
Крепёж | 34 | Гайка M10 кулачка | 2 | сталь | с двух сторон диска |  |  | 0 |  |  |  | 0 | 0 | #ДЕЛ/0!
Крепёж | 22.7 | Гайка M6 приварная | 4 | сталь | снизу верхних балок выноса |  |  | 0 |  |  |  | 0 | 0 | #ДЕЛ/0!
Подшипники | 9 | Подшипник 6200 10×30×9 | 3 | подшипник | 2 опоры вала + 1 ролик |  |  | 0 |  |  |  | 0 | 0 | #ДЕЛ/0!
Подшипники | 8 | Линейный подшипник LMK10UU | 4 | покупное | доработка: цековка фланца |  |  | 0 |  |  |  | 0 | 0 | #ДЕЛ/0!
Крепёж | 45 | Гайка M10 вала | 8 | сталь | по 2 на вал; 17 AF |  |  | 0 |  |  |  | 0 | 0 | #ДЕЛ/0!
Крепёж | 46 | Шайба M10 вала Ø18/Ø10,5×1,5 | 8 | сталь | по 2 на вал |  |  | 0 |  |  |  | 0 | 0 | #ДЕЛ/0!
Сталь и трубы | 22 | Труба 20×20×2, L=360 | 2 | сталь | нижние продольные |  |  | 0 |  |  |  | 0 | 0 | #ДЕЛ/0!
Сталь и трубы | 22 | Труба 20×20×2, L=260 | 4 | сталь | высокие стойки |  |  | 0 |  |  |  | 0 | 0 | #ДЕЛ/0!
Сталь и трубы | 22 | Труба 20×20×2, L=200 | 2 | сталь | верхние балки выноса |  |  | 0 |  |  |  | 0 | 0 | #ДЕЛ/0!
Сталь и трубы | 22 | Труба 20×20×2, L=160 | 8 | сталь | поперечины и виброотсек |  |  | 0 |  |  |  | 0 | 0 | #ДЕЛ/0!
Сталь и трубы | 22 | Труба 20×20×2, L=150 | 2 | сталь | задние стойки |  |  | 0 |  |  |  | 0 | 0 | #ДЕЛ/0!
Сталь и трубы | 14 | Полоса 2×25, сталь 2 мм | 1 | сталь | ≈1 м на 8 накладок 50×50 |  |  | 0 |  |  |  | 0 | 0 | #ДЕЛ/0!
Сталь и трубы | 37 | Труба 16×16×2, L=16 (втулки) | 8 | сталь | ≈0,15 м |  |  | 0 |  |  |  | 0 | 0 | #ДЕЛ/0!
Сталь и трубы | 2 | Пруток сталь Ø10 h6, L=500 | 2 | сталь | на 4 вала V01…V04; резка, резьба M10×15 |  |  | 0 |  |  |  | 0 | 0 | #ДЕЛ/0!
Сталь и трубы | 20 | Шпилька M10 8.8, L=225 | 3 | сталь 8.8 | вал привода; 1 + 2 запасных |  |  | 0 |  |  |  | 0 | 0 | #ДЕЛ/0!
Сталь и трубы | 7 | Шпилька M10 8.8, L=44 | 1 | сталь 8.8 | ось ролика |  |  | 0 |  |  |  | 0 | 0 | #ДЕЛ/0!
Печать | 5 | PLA для стола | 1 | PLA | table.stl; 200×150×10 |  |  | 0 |  |  |  | 0 | 0 | #ДЕЛ/0!
Печать | 4 | PLA для накладки | 1 | PLA | overlay.stl; 200×150×6 |  |  | 0 |  |  |  | 0 | 0 | #ДЕЛ/0!
Печать | 10 | PLA для кулачков 3/5/10 | 1 | PLA | cam_3/5/10.stl; 100 % |  |  | 0 |  |  |  | 0 | 0 | #ДЕЛ/0!
Печать | 11 | PETG для подстолья | 1 | PETG | podstol.stl; 160×200×12 |  |  | 0 |  |  |  | 0 | 0 | #ДЕЛ/0!
Прочее | 3 | Пружина Ø17×1,5×60, 9 витков | 4 | пружинная сталь | установленная 36 мм |  |  | 0 |  |  |  | 0 | 0 | #ДЕЛ/0!
Прочее | 17 | Конусная гайка M10 | 6 | сталь | 4 опоры 6200 + 2 ролик |  |  | 0 |  |  |  | 0 | 0 | #ДЕЛ/0!
Прочее | 25 | Шайба пружины Ø18/Ø10,5×1,5 | 8 | сталь | сверху и снизу |  |  | 0 |  |  |  | 0 | 0 | #ДЕЛ/0!
Прочее | 33 | Шайба кулачка Ø40/Ø10,5×2,5 | 2 | сталь | с двух сторон |  |  | 0 |  |  |  | 0 | 0 | #ДЕЛ/0!
Прочее | 29 | Поликарбонат 5 мм | 1 | PC | кожух: 2 панели 160×300 + 2 бортика |  |  | 0 |  |  |  | 0 | 0 | #ДЕЛ/0!
Прочее | 31 | Буфер резиновый 20×19×36 | 4 | резина | 1 на угол |  |  | 0 |  |  |  | 0 | 0 | #ДЕЛ/0!
Прочее | 32 | Кольцо резиновое Ø10,5/Ø18×7 | 4 | резина | сантех. прокладка/шланг |  |  | 0 |  |  |  | 0 | 0 | #ДЕЛ/0!
Прочее | 22.6 | Заглушка 20×20×6 | 6 | пластик | наружные торцы рамы |  |  | 0 |  |  |  | 0 | 0 | #ДЕЛ/0!
Прочее | 22.6 | Заглушка 16×16×4 | 4 | пластик | верхние торцы виброотсека |  |  | 0 |  |  |  | 0 | 0 | #ДЕЛ/0!
Прочее | 38 | Заглушка 16×16×5 | 4 | пластик | торцы балки 21 |  |  | 0 |  |  |  | 0 | 0 | #ДЕЛ/0!
Прочее | 28 | Дрель | 1 | — | против часовой; регулировка; Ø100 условно |  |  | 0 |  |  |  | 0 | 0 | #ДЕЛ/0!
 |  |  |  |  | Итого |  |  |  |  |  |  | 448 |  | #ДЕЛ/0!
