inutcin/boomboom/stages/fix11/shopping_spent.xlsx

Группа | Поз. | Наименование | Кол. | Материал / размер | Примечание | Единицы измерения | Единиц измерения в шт. | Требуется единиц | Единиц в купленном комплекте | Цена комплекта | Цена единицы | Куплено в комплектов | Стоимость | Остаток единиц | Стоимость остатка | Ссылка
Крепёж | 41 | Шпилька строительная M10, L=117 | 4 | сталь 4.6 | 2 на балку; Y=60/140 | мм | 117 | 468 | 1000 | 272 | 0.272 | 1 | 272 | 532 | 144.704 | https://www.ozon.ru/product/burke-shpilka-krepezhnaya-1-sht-5329754360/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
Крепёж | 42 | Гайка M10 nyloc (опорная) | 4 | сталь | на верхнюю грань нижней балки, через шайбу | шт | 1 | 4 | 10 | 88 | 8.8 | 2 | 176 | 16 | 140.8 | https://www.ozon.ru/product/gayka-m10-stopornaya-samokontryashchayasya-s-neylonovym-koltsom-din985-10-sht-3882171076/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
Крепёж | 43 | Гайка M10 (поджимная) | 4 | сталь | снизу прижимной балки | шт | 1 | 4 | 10 | 83 | 8.3 | 2 | 166 | 16 | 132.8 | https://www.ozon.ru/product/gayka-shestigrannaya-m10-10sht-din-934-otsinkovannaya-2922782237/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
Крепёж | 44 | Шайба M10 Ø20/Ø10,5×1,5 | 8 | сталь | 4 опорные + 4 поджимные | шт | 1 | 8 | 100 | 114 | 1.14 | 1 | 114 | 92 | 104.88 | https://www.ozon.ru/product/zitar-shayba-ploskaya-m10-din125-gost-11074-93-100-sht-374-g-2936251660/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
Крепёж | 24 | Винт M4×35 с цилиндрической головкой | 8 | сталь | накладки; 2 на конец | шт | 1 | 8 | 20 | 296 | 14.8 | 1 | 296 | 12 | 177.6 | https://www.ozon.ru/product/vint-4-x-35-mm-golovka-tsilindricheskaya-20-sht-70-g-5666929402/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
Крепёж | 24 | Гайка M4 nyloc для накладок | 8 | сталь | в комплекте с винтами M4×35 | шт | 1 | 8 | 50 | 84 | 1.68 | 1 | 84 | 42 | 70.56 | https://www.ozon.ru/product/gayka-m4-otsinkovannaya-samokontryashchayasya-50-shtuk-2517438771/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
Крепёж | 24 | Шайба M4 Ø9/Ø4,3×1 | 16 | сталь | под головку и гайку | шт | 1 | 16 | 100 | 0 | 0 | 0 | 0 | -16 | 0 | Есть в запасах
Крепёж | 23 | Винт M4×12 с цилиндрической головкой | 16 | сталь | LMK10UU | шт | 1 | 16 | 10 | 431 | 43.1 | 2 | 862 | 4 | 172.4 | https://www.ozon.ru/product/vint-din-912-m4h12-s-tsilindricheskoy-golovkoy-10-sht-nerzhaveyushchaya-stal-a2-3133022936/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
Крепёж | 15 | Гайка M4 nyloc | 22 | сталь | 16 LMK + 4 накладка + 2 кронштейна | шт | 1 | 22 | 50 | 84 | 1.68 | 0 | 0 | -22 | -36.96 | В составе купленного комплекта выше
Крепёж | 13 | Винт M4×20 потайной | 4 | сталь | углы накладки | шт | 1 | 4 | 20 | 128 | 6.4 | 1 | 128 | 16 | 102.4 | https://www.ozon.ru/product/krepkom-vint-m4-x-4-x-20-mm-golovka-potaynaya-20-sht-35-g-1383417863/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
Крепёж | 39 | Винт M4×16 с цилиндрической головкой | 2 | сталь | кронштейны ролика | шт | 1 | 2 | 10 | 182 | 18.2 | 1 | 182 | 8 | 145.6 | https://www.ozon.ru/product/vint-din-912-m4h16-s-tsilindricheskoy-golovkoy-10-sht-polnaya-rezba-oksidirovannaya-stal-1755833369/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
Крепёж | 30 | Винт M4×10 с цилиндрической головкой | 22 | сталь | кожух; резьба в раме | шт | 1 | 22 | 20 | 338 | 16.9 | 2 | 676 | 18 | 304.2 | https://www.ozon.ru/search/?product_id=1708513718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
Крепёж | 18 | Винт M6×60 потайной | 4 | сталь | подстолье | шт | 1 | 4 | 20 | 259 | 12.95 | 1 | 259 | 16 | 207.2 | https://www.ozon.ru/product/vint-otsinkovannyy-s-potaynoy-golovkoy-m6h60-mm-din965-20-shtuk-3201265178/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
Крепёж | 19 | Гайка/шайба M6 хомута | 8 | сталь | U-хомуты; по 2 на ножку | шт | 1 | 8 | 100 | 179 | 1.79 | 1 | 179 | 92 | 164.68 | https://www.ozon.ru/product/shayba-m6-otsinkovannaya-uvelichennaya-kuzovnaya-usilennaya-100shtuk-din-9021-2960305057/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
Крепёж | 16 | Гайка M10 nyloc (6200/кулачок/ролик) | 8 | сталь | 4 опоры 6200 + 2 кулачок + 2 ролик | шт | 1 | 8 | 10 | 88 | 8.8 | 0 | 0 | -8 | -70.4 | В составе купленного комплекта выше
Крепёж | 34 | Гайка M10 кулачка | 2 | сталь | с двух сторон диска | шт | 1 | 2 | 10 | 83 | 8.3 | 0 | 0 | -2 | -16.6 | В составе купленного комплекта выше
Крепёж | 22.7 | Гайка M6 приварная | 4 | сталь | снизу верхних балок выноса | шт | 1 | 4 | 10 | 282 | 28.2 | 2 | 564 | 16 | 451.2 | (куплено для другой компоновки) https://www.ozon.ru/product/zitar-bolt-6-x-40-mm-golovka-shestigrannaya-10-sht-130-g-2530683174/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
Подшипники | 9 | Подшипник 6200 10×30×9 | 3 | подшипник | 2 опоры вала + 1 ролик | шт | 1 | 3 | 10 | 658 | 65.8 | 1 | 658 | 7 | 460.6 | https://www.ozon.ru/product/podshipnik-6200-2rs-gost-180200-razmer-10x30x9-komplekt-10-sht-758653566/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
Подшипники | 8 | Линейный подшипник LMK10UU | 4 | покупное | доработка: цековка фланца | шт | 1 | 4 | 1 | 697 | 697 | 4 | 2788 | 0 | 0 | https://www.ozon.ru/product/podshipnik-s-kvadratnym-flantsem-lmk10uu-1653639430/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
Подшипники | 1 | Ограничитель вала WCS10FR | 8 | сталь | по 2 на вал | шт | 1 | 8 | 1 | 304 | 304 | 9 | 2736 | 1 | 304 | https://www.ozon.ru/product/ogranichitel-vala-wcs-mq-10x30-10-diametr-10-mm-5385502796/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
Сталь и трубы | 22 | Труба 20×20×2, L=360 | 2 | сталь | нижние продольные | мм | 360 | 720 | 1000 | 261 | 0.261 | 4 | 1044 | 3280 | 856.08 | https://www.ozon.ru/product/truba-profilnaya-20h20h2-0-mm-1m-h-1-sht-4636970310/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
Сталь и трубы | 22 | Труба 20×20×2, L=260 | 4 | сталь | высокие стойки | мм | 260 | 1040 | 1000 | 261 | 0.261 | 0 | 0 | -1040 | -271.44 | В составе купленного комплекта выше
Сталь и трубы | 22 | Труба 20×20×2, L=200 | 2 | сталь | верхние балки выноса | мм | 200 | 400 | 1000 | 261 | 0.261 | 0 | 0 | -400 | -104.4 | В составе купленного комплекта выше
Сталь и трубы | 22 | Труба 20×20×2, L=160 | 8 | сталь | поперечины и виброотсек | мм | 160 | 1280 | 1000 | 261 | 0.261 | 0 | 0 | -1280 | -334.08 | В составе купленного комплекта выше
Сталь и трубы | 22 | Труба 20×20×2, L=150 | 2 | сталь | задние стойки | мм | 150 | 300 | 1000 | 261 | 0.261 |  | 0 | -300 | -78.3 | В составе купленного комплекта выше
Сталь и трубы | 14 | Полоса 2×25, сталь 2 мм | 8 | сталь | ≈1 м на 8 накладок 50×50 | шт | 1 | 8 | 10 | 721 | 72.1 | 1 | 721 | 2 | 144.2 | https://www.ozon.ru/product/mebelnyy-okonnyy-ugolok-rusconnect-rna1-150h150h25h2-mm-10-sht-3391270033/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
Сталь и трубы | 37 | Труба 16×16×2, L=16 (втулки) | 8 | сталь | ≈0,15 м | шт | 1 | 8 | 1 | 0 | 0 | 0 | 0 | -8 | 0 | не понял что это и куда
Сталь и трубы | 20 | Шпилька M10 8.8, L=225 | 3 | сталь 8.8 | вал привода; 1 + 2 запасных | мм | 255 | 765 | 1000 | 573 | 0.573 | 1 | 573 | 235 | 134.655 | https://www.ozon.ru/product/shpilka-rezbovaya-oksidirovannaya-vysokoprochnaya-m10h1000-din-975-s-klassom-prochnosti-12-9-1sht-3582573884/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
Сталь и трубы | 7 | Шпилька M10 8.8, L=44 | 1 | сталь 8.8 | ось ролика | мм | 44 | 44 | 1000 | 573 | 0.573 | 0 | 0 | -44 | -25.212 | В составе купленного комплекта выше
Печать | 5 | PLA для стола | 1 | PLA | table.stl; 200×150×10 | м | 1 | 1 | 1 | 0 | 0 | 0 | 0 | -1 | 0 | Изготовит заказчик
Печать | 4 | PLA для накладки | 1 | PLA | overlay.stl; 200×150×6 | м | 1 | 1 | 1 | 0 | 0 | 0 | 0 | -1 | 0 | Изготовит заказчик
Печать | 10 | PLA для кулачков 3/5/10 | 1 | PLA | cam_3/5/10.stl; 100 % | м | 1 | 1 | 1 | 0 | 0 | 0 | 0 | -1 | 0 | Изготовит заказчик
Печать | 11 | PETG для подстолья | 1 | PETG | podstol.stl; 160×200×12 | м | 1 | 1 | 1 | 0 | 0 | 0 | 0 | -1 | 0 | Изготовит заказчик
Прочее | 3 | Пружина Ø17×1,5×60, 9 витков | 4 | пружинная сталь | установленная 36 мм | шт | 1 | 4 | 5 | 501 | 100.2 | 1 | 501 | 1 | 100.2 | https://www.ozon.ru/product/pruzhiny-szhatiya-65mln-1-5-17-65-diametr-provoloki-shirina-dlina-pruzhinnaya-stal-5-na-upakovku-4197080114/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
Прочее | 17 | Конусная гайка M10 | 6 | сталь | 4 опоры 6200 + 2 ролик | шт | 1 | 6 | 16 | 962 | 60.125 | 1 | 962 | 10 | 601.25 | https://www.ozon.ru/product/gayka-m10x1-25-18-hex17-konus-otkrytaya-ch-h-1018-16sht-1638100725/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
Прочее | 25 | Шайба пружины Ø18/Ø10,5×1,5 | 8 | сталь | сверху и снизу | шт | 1 | 8 | 100 | 114 | 1.14 | 0 | 0 | -8 | -9.12 | В составе купленного комплекта выше
Прочее | 33 | Шайба кулачка Ø40/Ø10,5×2,5 | 2 | сталь | с двух сторон | шт | 1 | 2 | 83 | 276 | 3.325301205 | 1 | 276 | 81 | 269.3493976 | https://www.ozon.ru/product/shayba-kuzovnaya-uvelichennaya-m10-1kg-83sht-din-9021-2573673588/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
Прочее | 29 | Поликарбонат 5 мм | 1 | PC | кожух: 2 панели 160×300 + 2 бортика | шт | 1 | 1 | 1 | 0 | 0 | 0 | 0 | -1 | 0 | Есть в запасах
Прочее | 31 | Буфер резиновый 20×19×36 | 4 | резина | 1 на угол | шт | 1 | 4 | 1 | 0 | 0 | 0 | 0 | -4 | 0 | Приспособлю какой-нибудь кусок говна
Прочее | 32 | Кольцо резиновое Ø10,5/Ø18×7 | 4 | резина | сантех. прокладка/шланг | шт | 1 | 4 | 1 | 0 | 0 | 0 | 0 | -4 | 0 | В запасах
Прочее | 22.6 | Заглушка 20×20×6 | 6 | пластик | наружные торцы рамы | шт | 1 | 6 | 20 | 141 | 7.05 | 1 | 141 | 14 | 98.7 | https://www.ozon.ru/product/zaglushki-20h20-dlya-profilnoy-truby-i-nozhek-stulev-20sht-3468900994/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
Прочее | 22.6 | Заглушка 16×16×4 | 4 | пластик | верхние торцы виброотсека | шт | 1 | 4 | 1 | 0 | 0 | 0 | 0 | -4 | 0 | То же что и заглушка 20 на 20
Прочее | 38 | Заглушка 16×16×5 | 4 | пластик | торцы балки 21 | шт | 1 | 4 | 1 | 0 | 0 | 0 | 0 | -4 | 0 | То же что и заглушка 20 на 20
Прочее | 28 | Дрель | 1 | — | против часовой; регулировка; Ø100 условно |  |  | 0 | 1 | 0 | 0 | 0 | 0 | 0 | 0 | Есть в запасах
 |  |  |  |  | Итого |  |  |  |  |  |  |  | 14358 |  | 4341.546398
 |  | 720
 |  | 1040
 |  | 400
 |  | 1280
 |  | 300
 |  | 3740
