inutcin/boomboom/stages/model/cad/prev/spec.csv

№ | Наименование | Кол-во | Материал | Масса 1 шт, г | Примечание
1 | Балка фиксации подшипника | 2 | Сталь | 48.4
2 | Болт М6×25 | 8 | Покупное | 8.5 | покупное
3 | Болт М6×25 (подстолье) | 4 | Покупное | 8.5 | покупное
4 | Болт потайной М4×20 | 4 | Покупное | 3.0 | покупное
5 | Вал Ø10×120 | 4 | Сталь | 74.0
6 | Вал привода — шпилька М10 | 1 | Сталь | 141.8
7 | Гайка М10 | 4 | Покупное | 15.7 | покупное
8 | Гайка М10 (кулачок) | 2 | Покупное | 15.7 | покупное
9 | Гайка М4 | 4 | Покупное | 1.1 | покупное
10 | Гайка М6 | 4 | Покупное | 3.4 | покупное
11 | Дрель (условно, покупная) | 1 | Алюминий | 693.1 | покупное, условно (модель-заглушка)
12 | Контрагайка М10 | 4 | Покупное | 11.8 | покупное
13 | Конусная гайка М10 | 4 | Покупное | 7.5 | покупное
14 | Краб-система (зажим 20×20) | 4 | Покупное | 46.2 | покупное
15 | Кронштейн угловой 40×40×20×2 | 4 | Сталь | 21.2
16 | Кулачковый диск (3D печать) | 1 | PLA (3D печать) | 111.6 | 3D печать
17 | Линейный подшипник LMF10UU | 4 | Покупное | 132.0 | покупное
18 | Накладка вогнутая (3D печать) | 1 | PLA (3D печать) | 258.4 | 3D печать
19 | Ограничитель вала | 4 | Сталь | 64.9
20 | Ось ролика М10 | 2 | Сталь | 28.4
21 | Подстолье (фанера 12) | 1 | Фанера | 258.1
22 | Подшипник вала 6200 | 2 | Покупное | 44.4 | покупное
23 | Подшипник-ролик 6200 | 2 | Покупное | 44.4 | покупное
24 | Прокладка под дрель | 1 | Резина | 156.4
25 | Пружина прижимная | 4 | Покупное | 5.8 | покупное
26 | Рама сварная | 1 | Сталь | 4352.6
27 | Соединительная гайка М10 | 1 | Покупное | 58.9 | покупное
28 | Стол (фанера 10) | 1 | Фанера | 140.4
29 | Хвостовик-шпилька М10 | 1 | Сталь | 40.1
30 | Хомут U-образный М6 | 2 | Покупное | 44.1 | покупное
31 | Шайба 10 | 4 | Покупное | 3.6 | покупное
