inutcin/boomboom/stages/model/cad/prev/assembly.step

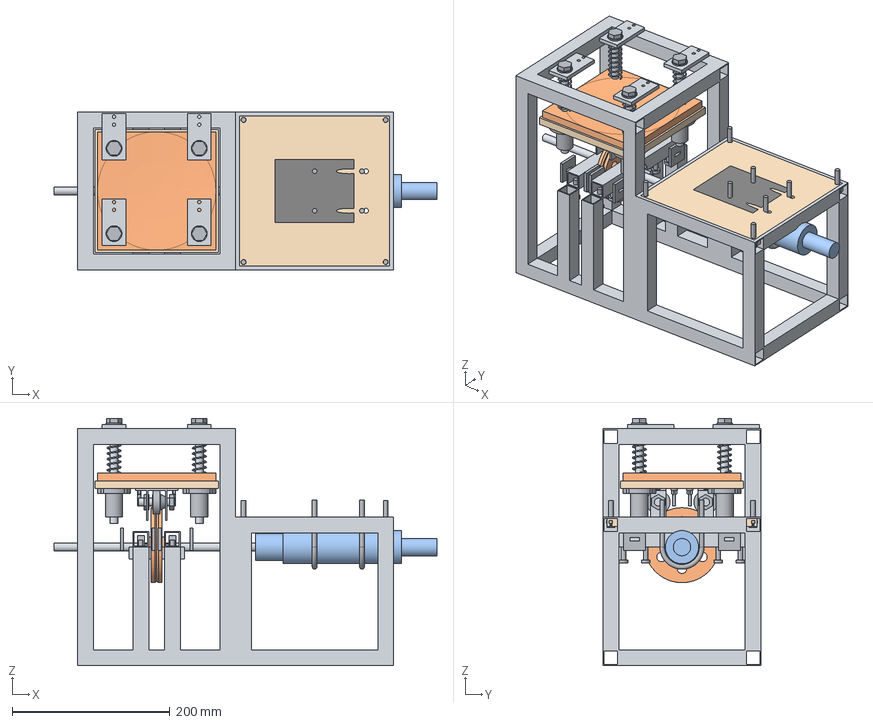
[picture p61: CAD file, 2026-10-29]
stages/model/cad/prev/assembly.step
485.0 x 200.0 x 313.0 mm
01_Ð Ð°Ð¼Ð° ÑÐ²Ð°ÑÐ½Ð°Ñ
02_Ð¡ÑÐ¾Ð» (ÑÐ°Ð½ÐµÑÐ° 10)
03_ÐÐ°ÐºÐ»Ð°Ð´ÐºÐ° Ð²Ð¾Ð³Ð½ÑÑÐ°Ñ (3D Ð¿ÐµÑÐ°ÑÑ)
04_ÐÐ°Ð» Ã10Ã120
05_ÐÐ°Ð» Ã10Ã120
06_ÐÐ°Ð» Ã10Ã120
07_ÐÐ°Ð» Ã10Ã120
08_ÐÐ³ÑÐ°Ð½Ð¸ÑÐ¸ÑÐµÐ»Ñ Ð²Ð°Ð»Ð°
09_ÐÐ³ÑÐ°Ð½Ð¸ÑÐ¸ÑÐµÐ»Ñ Ð²Ð°Ð»Ð°
10_ÐÐ³ÑÐ°Ð½Ð¸ÑÐ¸ÑÐµÐ»Ñ Ð²Ð°Ð»Ð°
11_ÐÐ³ÑÐ°Ð½Ð¸ÑÐ¸ÑÐµÐ»Ñ Ð²Ð°Ð»Ð°
12_ÐÐ°Ð¹ÐºÐ° Ð10
13_Ð¨Ð°Ð¹Ð±Ð° 10
14_ÐÐ°Ð¹ÐºÐ° Ð10
15_Ð¨Ð°Ð¹Ð±Ð° 10
16_ÐÐ°Ð¹ÐºÐ° Ð10
17_Ð¨Ð°Ð¹Ð±Ð° 10
18_ÐÐ°Ð¹ÐºÐ° Ð10
19_Ð¨Ð°Ð¹Ð±Ð° 10
20_ÐÐ¸Ð½ÐµÐ¹Ð½ÑÐ¹ Ð¿Ð¾Ð´ÑÐ¸Ð¿Ð½Ð¸Ðº LMF10UU
21_ÐÐ¸Ð½ÐµÐ¹Ð½ÑÐ¹ Ð¿Ð¾Ð´ÑÐ¸Ð¿Ð½Ð¸Ðº LMF10UU
22_ÐÐ¸Ð½ÐµÐ¹Ð½ÑÐ¹ Ð¿Ð¾Ð´ÑÐ¸Ð¿Ð½Ð¸Ðº LMF10UU
23_ÐÐ¸Ð½ÐµÐ¹Ð½ÑÐ¹ Ð¿Ð¾Ð´ÑÐ¸Ð¿Ð½Ð¸Ðº LMF10UU
24_ÐÑÑÐ¶Ð¸Ð½Ð° Ð¿ÑÐ¸Ð¶Ð¸Ð¼Ð½Ð°Ñ
25_ÐÑÑÐ¶Ð¸Ð½Ð° Ð¿ÑÐ¸Ð¶Ð¸Ð¼Ð½Ð°Ñ
26_ÐÑÑÐ¶Ð¸Ð½Ð° Ð¿ÑÐ¸Ð¶Ð¸Ð¼Ð½Ð°Ñ
27_ÐÑÑÐ¶Ð¸Ð½Ð° Ð¿ÑÐ¸Ð¶Ð¸Ð¼Ð½Ð°Ñ
28_ÐÐ¾Ð´ÑÐ¸Ð¿Ð½Ð¸Ðº-ÑÐ¾Ð»Ð¸Ðº 6200
29_ÐÑÑ ÑÐ¾Ð»Ð¸ÐºÐ° Ð10
30_ÐÑÐ¾Ð½ÑÑÐµÐ¹Ð½ ÑÐ³Ð»Ð¾Ð²Ð¾Ð¹ 40Ã40Ã20Ã2
31_ÐÐ¾Ð½ÑÑÐ½Ð°Ñ Ð³Ð°Ð¹ÐºÐ° Ð10
32_ÐÐ¾Ð½ÑÑÐ°Ð³Ð°Ð¹ÐºÐ° Ð10
33_ÐÑÐ¾Ð½ÑÑÐµÐ¹Ð½ ÑÐ³Ð»Ð¾Ð²Ð¾Ð¹ 40Ã40Ã20Ã2
34_ÐÐ¾Ð½ÑÑÐ½Ð°Ñ Ð³Ð°Ð¹ÐºÐ° Ð10
35_ÐÐ¾Ð½ÑÑÐ°Ð³Ð°Ð¹ÐºÐ° Ð10
36_ÐÐ¾Ð´ÑÐ¸Ð¿Ð½Ð¸Ðº-ÑÐ¾Ð»Ð¸Ðº 6200
37_ÐÑÑ ÑÐ¾Ð»Ð¸ÐºÐ° Ð10
38_ÐÑÐ¾Ð½ÑÑÐµÐ¹Ð½ ÑÐ³Ð»Ð¾Ð²Ð¾Ð¹ 40Ã40Ã20Ã2
39_ÐÐ¾Ð½ÑÑÐ½Ð°Ñ Ð³Ð°Ð¹ÐºÐ° Ð10
40_ÐÐ¾Ð½ÑÑÐ°Ð³Ð°Ð¹ÐºÐ° Ð10
41_ÐÑÐ¾Ð½ÑÑÐµÐ¹Ð½ ÑÐ³Ð»Ð¾Ð²Ð¾Ð¹ 40Ã40Ã20Ã2
42_ÐÐ¾Ð½ÑÑÐ½Ð°Ñ Ð³Ð°Ð¹ÐºÐ° Ð10
43_ÐÐ¾Ð½ÑÑÐ°Ð³Ð°Ð¹ÐºÐ° Ð10
44_ÐÐ¾Ð»Ñ Ð¿Ð¾ÑÐ°Ð¹Ð½Ð¾Ð¹ Ð4Ã20
45_ÐÐ°Ð¹ÐºÐ° Ð4
46_ÐÐ¾Ð»Ñ Ð¿Ð¾ÑÐ°Ð¹Ð½Ð¾Ð¹ Ð4Ã20
47_ÐÐ°Ð¹ÐºÐ° Ð4
48_ÐÐ¾Ð»Ñ Ð¿Ð¾ÑÐ°Ð¹Ð½Ð¾Ð¹ Ð4Ã20
49_ÐÐ°Ð¹ÐºÐ° Ð4
50_ÐÐ¾Ð»Ñ Ð¿Ð¾ÑÐ°Ð¹Ð½Ð¾Ð¹ Ð4Ã20
51_ÐÐ°Ð¹ÐºÐ° Ð4
52_ÐÑÐ»Ð°ÑÐºÐ¾Ð²ÑÐ¹ Ð´Ð¸ÑÐº (3D Ð¿ÐµÑÐ°ÑÑ)
53_ÐÐ°Ð» Ð¿ÑÐ¸Ð²Ð¾Ð´Ð° â ÑÐ¿Ð¸Ð»ÑÐºÐ° Ð10
54_ÐÐ¾Ð´ÑÐ¸Ð¿Ð½Ð¸Ðº Ð²Ð°Ð»Ð° 6200
55_ÐÐ¾Ð´ÑÐ¸Ð¿Ð½Ð¸Ðº Ð²Ð°Ð»Ð° 6200
56_ÐÐ°Ð»ÐºÐ° ÑÐ¸ÐºÑÐ°ÑÐ¸Ð¸ Ð¿Ð¾Ð´ÑÐ¸Ð¿Ð½Ð¸ÐºÐ°
57_ÐÐ°Ð»ÐºÐ° ÑÐ¸ÐºÑÐ°ÑÐ¸Ð¸ Ð¿Ð¾Ð´ÑÐ¸Ð¿Ð½Ð¸ÐºÐ°
58_ÐÑÐ°Ð±-ÑÐ¸ÑÑÐµÐ¼Ð° (Ð·Ð°Ð¶Ð¸Ð¼ 20Ã20)
59_ÐÐ¾Ð»Ñ Ð6Ã25
60_ÐÐ¾Ð»Ñ Ð6Ã25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
