inutcin/boomboom/stages/fix11/cad/step/vibrotable_assembly.step

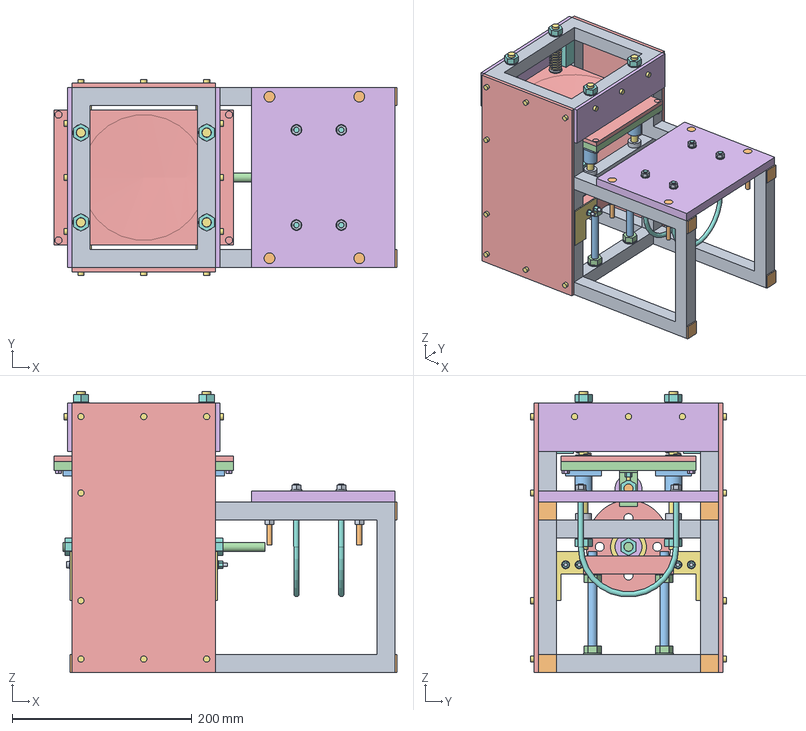
[picture p62: CAD file, 2026-11-05]
stages/fix11/cad/step/vibrotable_assembly.step
382.0 x 218.0 x 313.0 mm
frame
frame_plugs
table
overlay
podstol
shaft
shaft_nuts
shaft_washers
spring
spring_washer
lmk
drive_shaft
cam
shaft_bearings
cam_washers
cam_nuts
cam_locknuts
shaft_conical_nuts
shaft_locknuts
roller
axle
roller_nuts
bracket
retainer
retainer_plugs
angles
ubolts
ubolt_nuts
podstol_bolts
lmk_screws
lmk_nuts
table_screws
table_nuts
bracket_screws
bracket_nuts
angle_bolts
angle_nuts
clamp_studs
clamp_bottom
clamp_press
shield
shield_screws
rubber_pads
rubber_rings
