inutcin/boomboom/stages/fix10l/cad/step/vibrotable_assembly.step

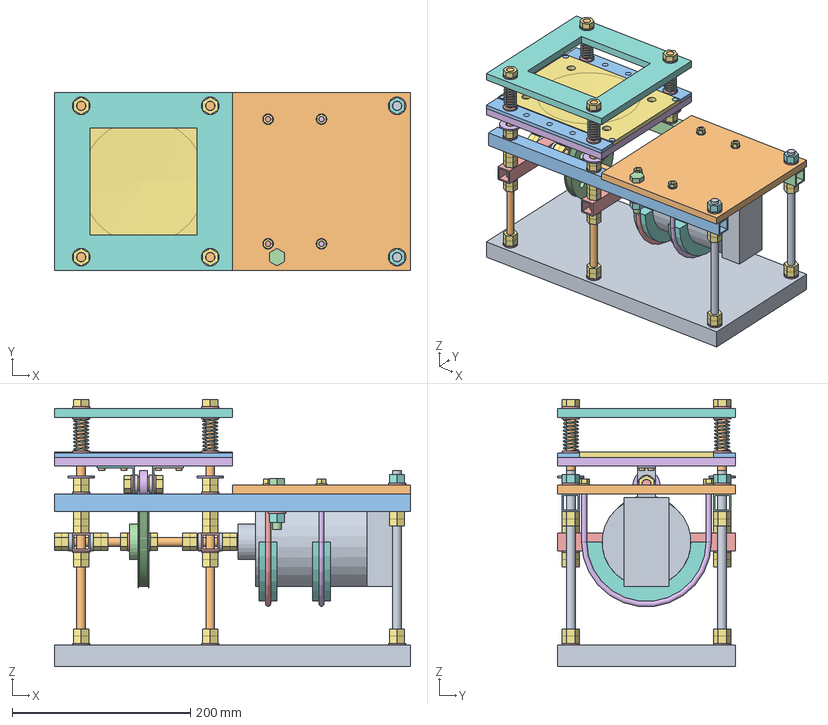
[picture p63: CAD file, 2026-11-02]
stages/fix10l/cad/step/vibrotable_assembly.step
400.0 x 200.0 x 300.0 mm
studs
beams_long
beams_trans
table
overlay
top_platform
base
podstol
spring_pads
springs
spring_washers
bumpers
nuts
jam_nuts
nyloc_nuts
washers
shaft_nuts
shaft_jams
shaft_washers
drive_shaft
weld_nut
cam
cam_washers
cam_nuts
axle
roller
roller_nuts
roller_washers
roller_shims
brackets
bracket_screws
table_screws
pad_screws
pod_bolt
pod_bolt_nut
pod_bolt_washer
ubolts
ubolt_hw
drill_pads
drill
