inutcin/boomboom/stages/fix10l/cad/stl/groups/grp_steel.stl

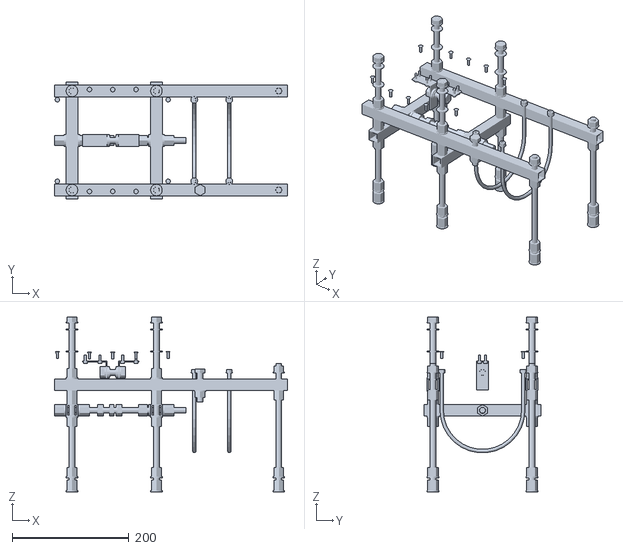
[picture p64: CAD file, 2026-11-02]
stages/fix10l/cad/stl/groups/grp_steel.stl
400.0 x 200.0 x 300.0
