inutcin/boomboom/stages/fix10l/cad/stl/overlay.stl

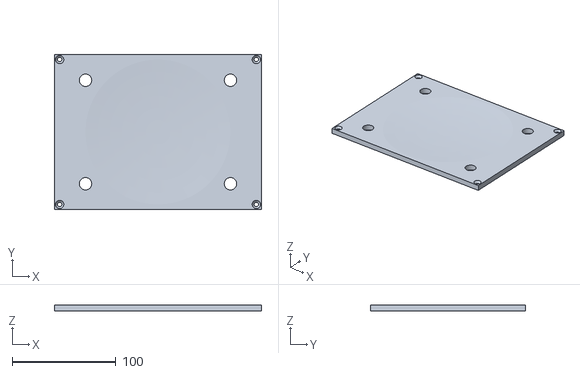
[picture p65: CAD file, 2026-11-02]
stages/fix10l/cad/stl/overlay.stl
200.0 x 150.0 x 6.00
