inutcin/boomboom/stages/fix10l/tachdraw/cad/B03.step

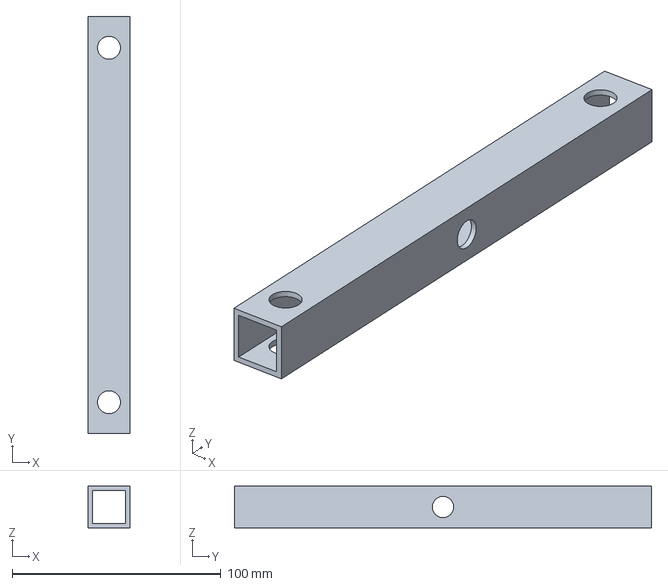
[picture p66: CAD file, 2026-11-03]
stages/fix10l/tachdraw/cad/B03.step
20.0 x 200.0 x 20.0 mm
