inutcin/boomboom/stages/fix11/cad/step/10_cam_10.step

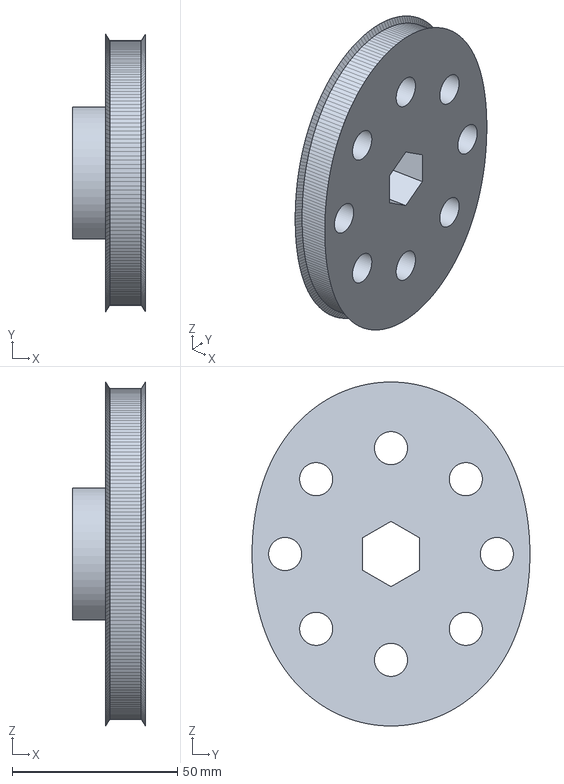
[picture p67: CAD file, 2026-11-05]
stages/fix11/cad/step/10_cam_10.step
22.0 x 84.0 x 104.0 mm
