inutcin/boomboom/stages/fix11/cad/stl/cam_5.stl

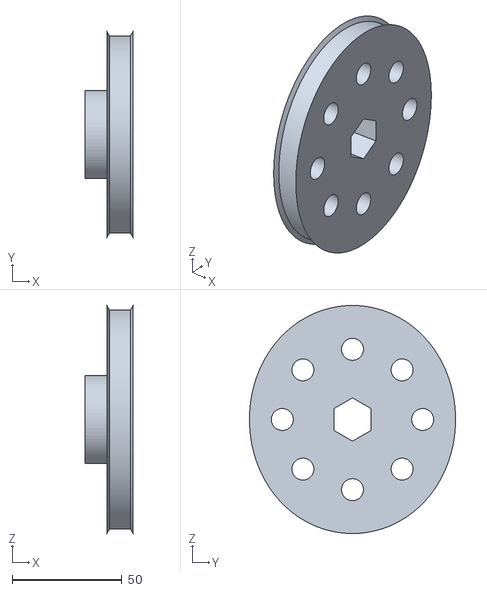
[picture p68: CAD file, 2026-11-03]
stages/fix11/cad/stl/cam_5.stl
22.0 x 94.0 x 104.0
