inutcin/boomboom/stages/fix11/cad/stl/groups/grp_steel.stl

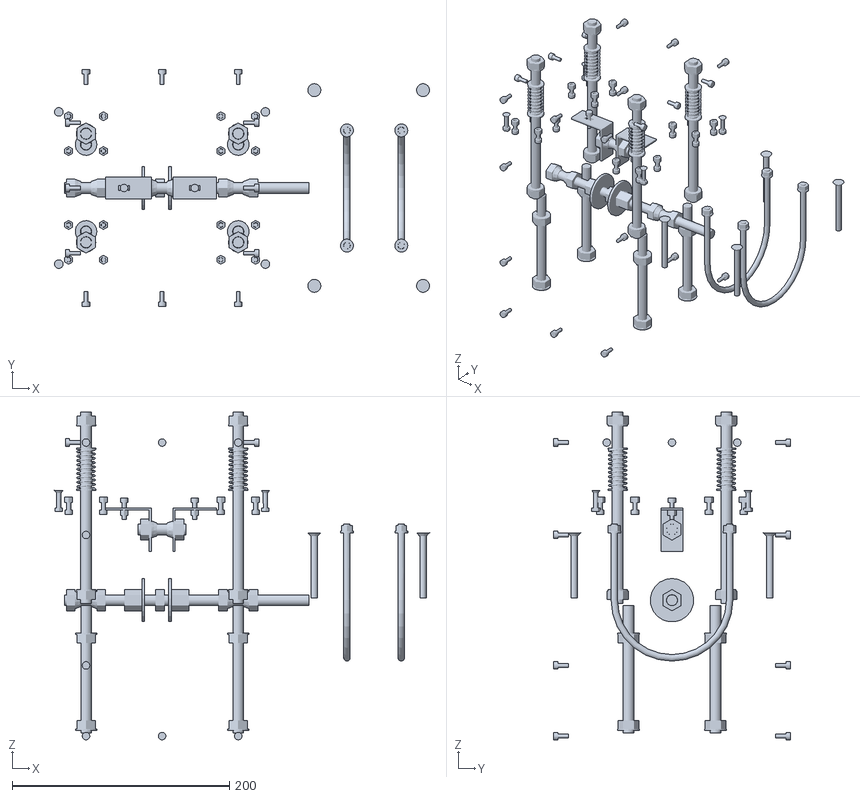
[picture p69: CAD file, 2026-11-05]
stages/fix11/cad/stl/groups/grp_steel.stl
344.9 x 218.0 x 301.5
