inutcin/boomboom/stages/fix2/cad/stl/groups/grp_crabs.stl

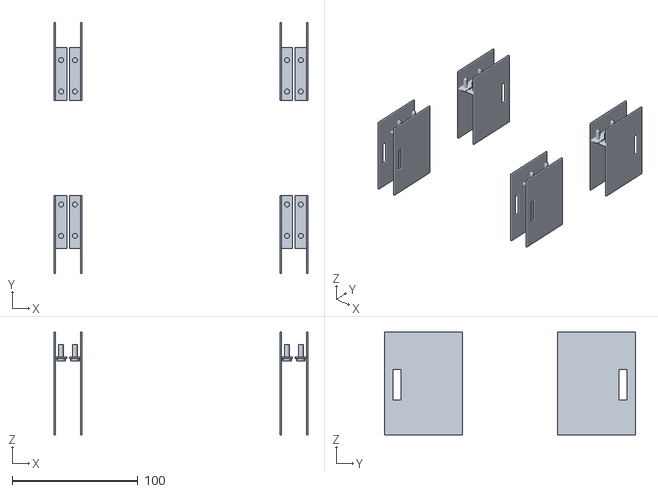
[picture p70: CAD file, 2026-10-29]
stages/fix2/cad/stl/groups/grp_crabs.stl
202.4 x 200.0 x 82.0
