inutcin/boomboom/stages/fix4/cad/stl/shield.stl

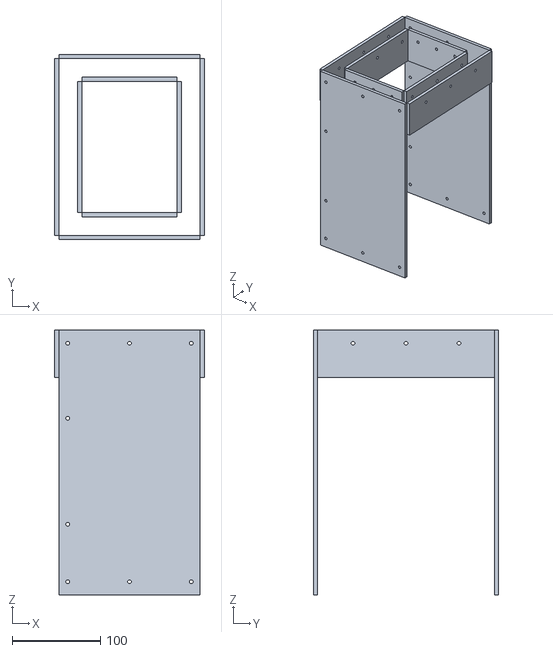
[picture p72: CAD file, 2026-10-30]
stages/fix4/cad/stl/shield.stl
170.0 x 210.0 x 300.0
