inutcin/boomboom/stages/fix7/cad/stl/groups/grp_angles.stl

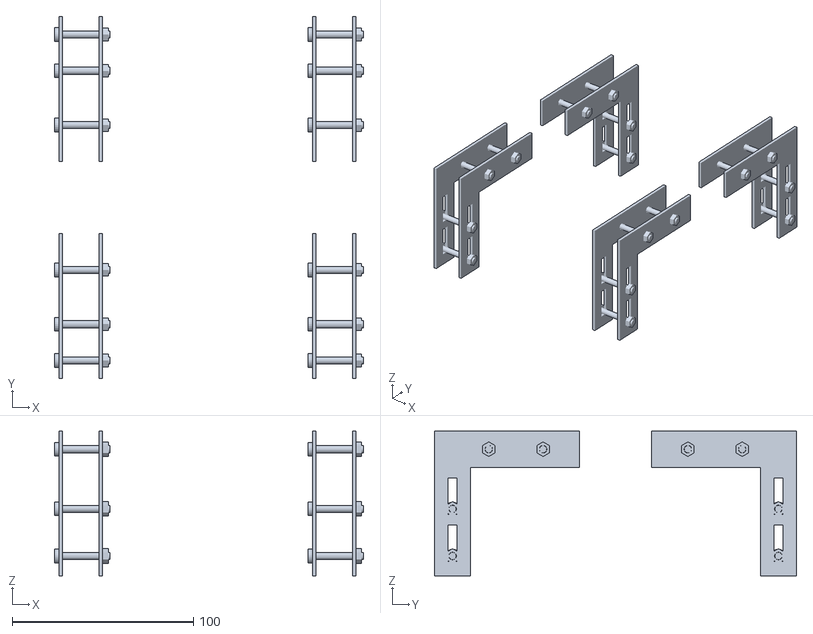
[picture p73: CAD file, 2026-10-30]
stages/fix7/cad/stl/groups/grp_angles.stl
170.7 x 200.0 x 80.0
