inutcin/boomboom/stages/fix9/cad/step/24_beam_nuts.step

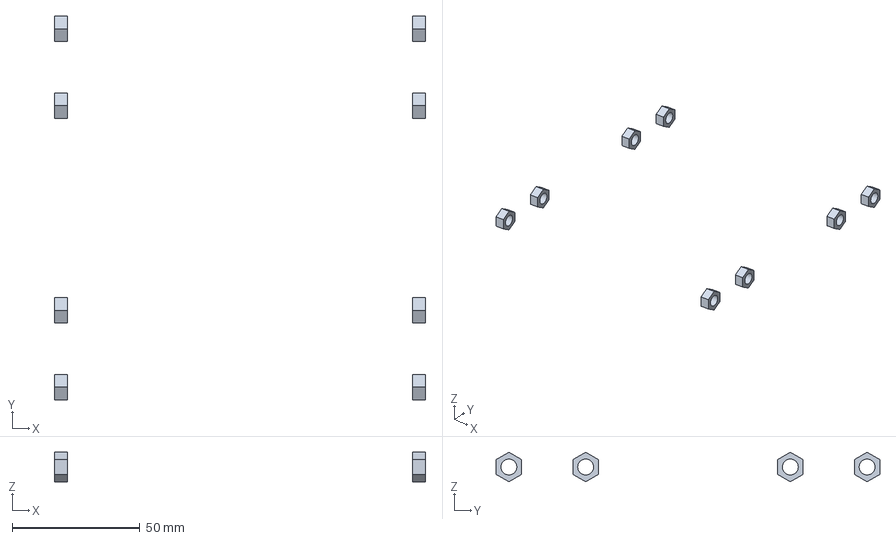
[picture p74: CAD file, 2026-11-02]
stages/fix9/cad/step/24_beam_nuts.step
145.0 x 150.0 x 11.5 mm
