inutcin/boomboom/stages/fix9/cad/stl/groups/grp_retainer.stl

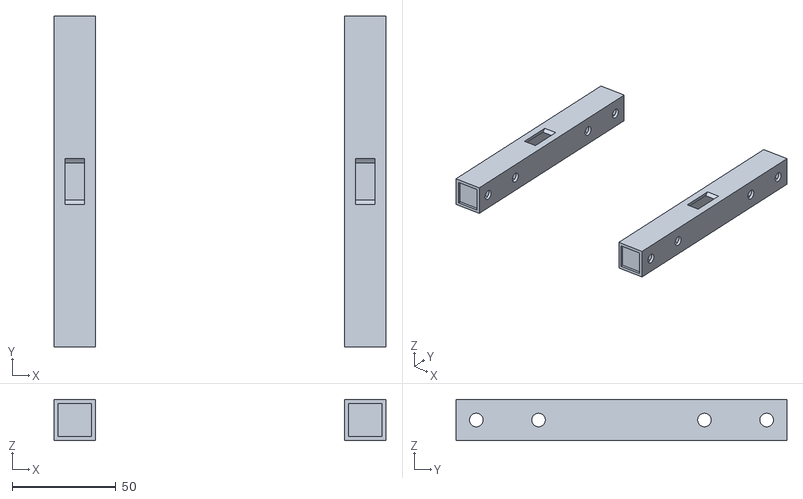
[picture p75: CAD file, 2026-11-02]
stages/fix9/cad/stl/groups/grp_retainer.stl
160.0 x 159.6 x 20.0
