inutcin/boomboom/stages/model/cad/prev/step_parts/Болт_М6x25_подстолье.step

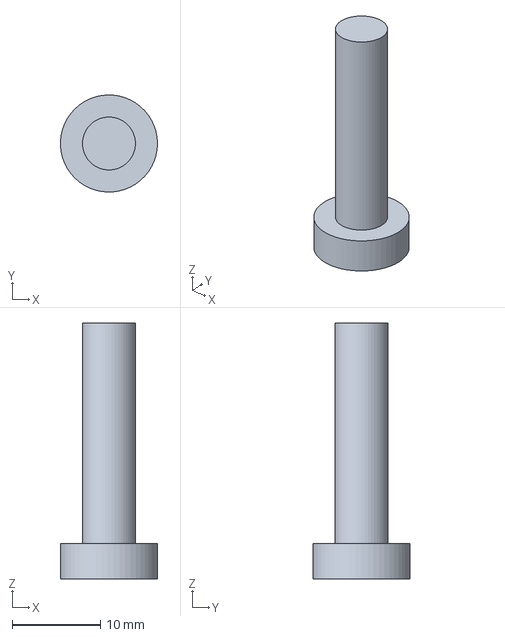
[picture p76: CAD file, 2026-10-29]
stages/model/cad/prev/step_parts/Болт_М6x25_подстолье.step
11.0 x 11.0 x 29.0 mm
