inutcin/boomboom/stages/model/cad/prev/stl_asm/31_Конусная гайка М10.stl

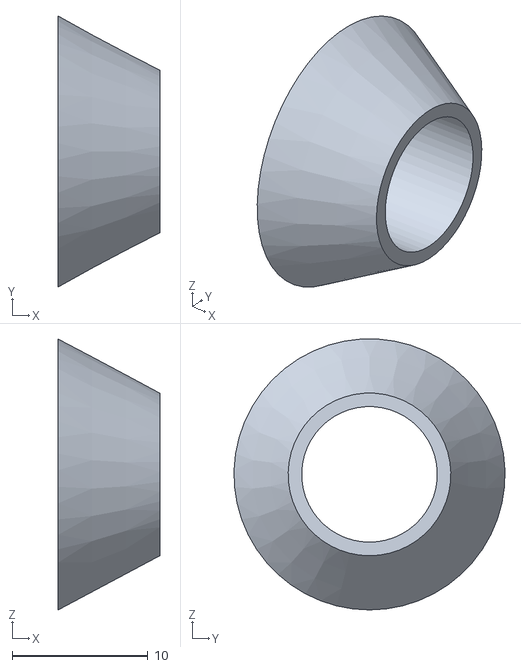
[picture p77: CAD file, 2026-10-29]
stages/model/cad/prev/stl_asm/31_Конусная гайка М10.stl
7.50 x 20.0 x 20.0
