inutcin/boomboom/stages/model/cad/prev/stl_print/overlay_150x150x10.stl

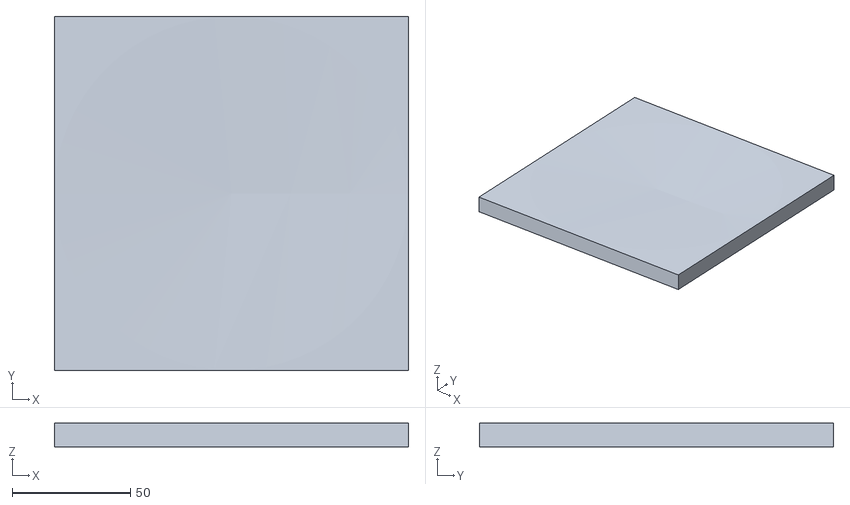
[picture p78: CAD file, 2026-10-29]
stages/model/cad/prev/stl_print/overlay_150x150x10.stl
150.0 x 150.0 x 10.0
