inutcin/boomboom/stages/model/cad/stl/groups/grp_printed.stl

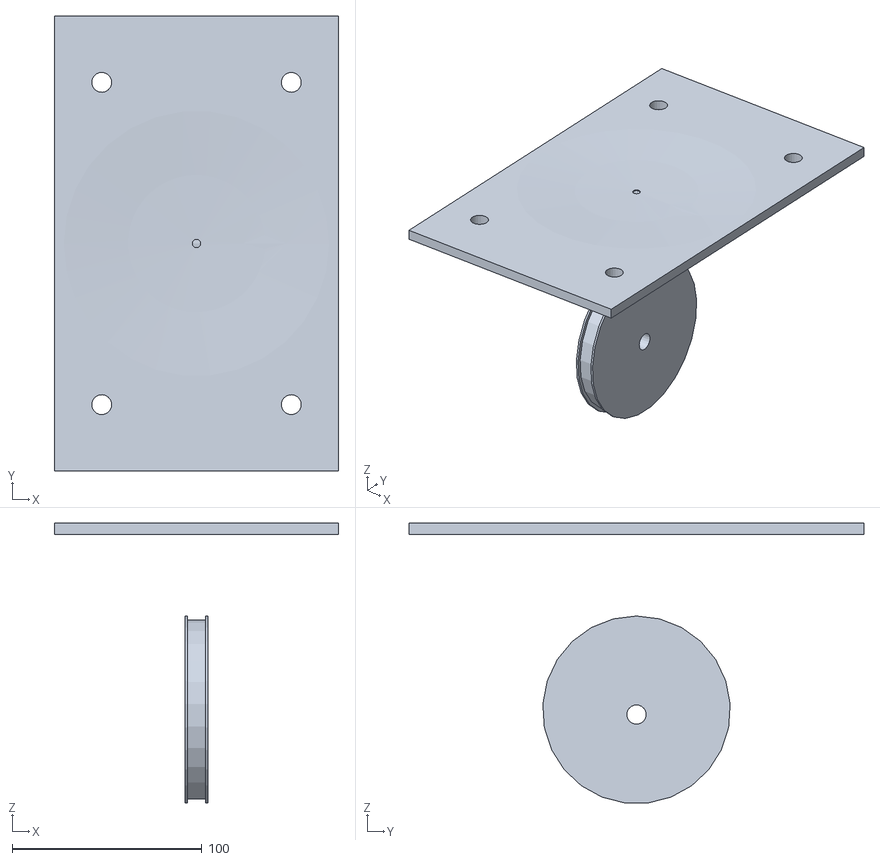
[picture p79: CAD file, 2026-10-29]
stages/model/cad/stl/groups/grp_printed.stl
150.0 x 240.0 x 147.6
