inutcin/boomboom/stages/fix1/cad/stl/groups/grp_overlay.stl

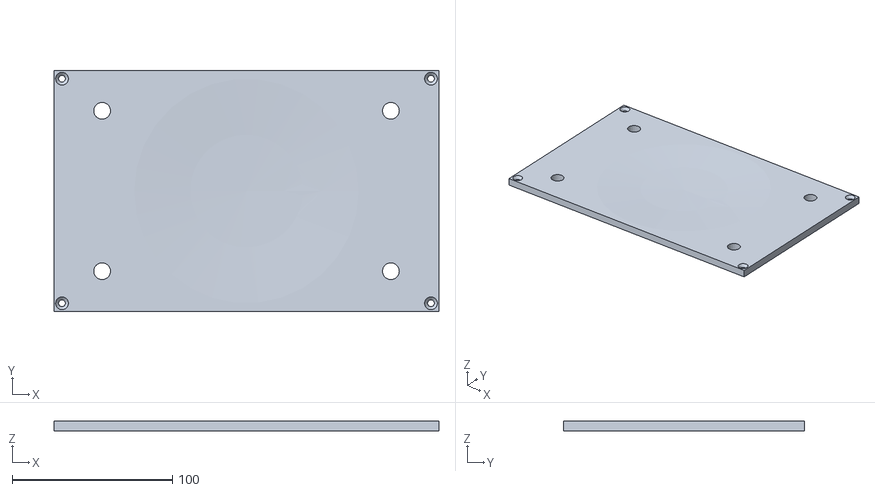
[picture p80: CAD file, 2026-10-29]
stages/fix1/cad/stl/groups/grp_overlay.stl
240.0 x 150.0 x 6.00
