inutcin/boomboom/stages/fix10l/cad/step/03_shaft_nuts.step

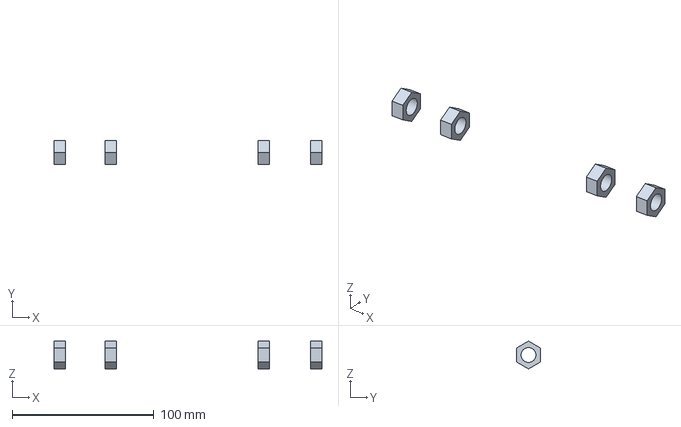
[picture p81: CAD file, 2026-11-02]
stages/fix10l/cad/step/03_shaft_nuts.step
189.0 x 17.0 x 19.6 mm
