inutcin/boomboom/stages/fix10l/tachdraw/cad/B02.step

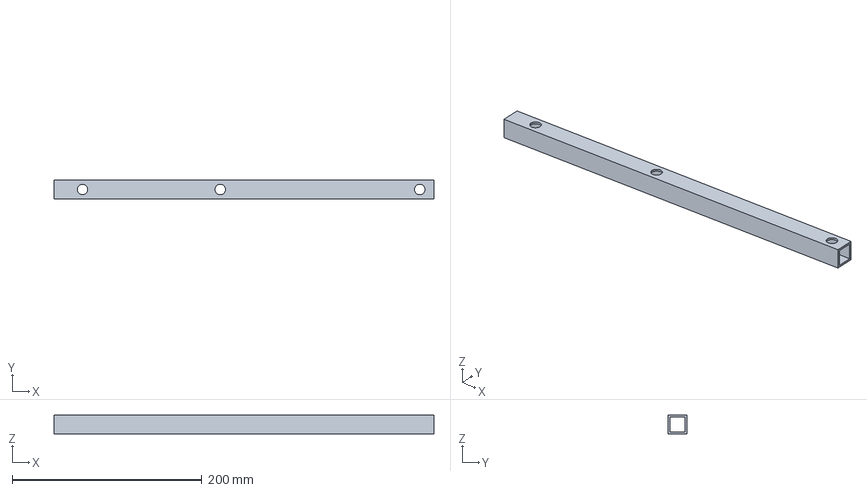
[picture p82: CAD file, 2026-11-03]
stages/fix10l/tachdraw/cad/B02.step
400.0 x 20.0 x 20.0 mm
