inutcin/boomboom/stages/fix11/cad/step/29_shield.step

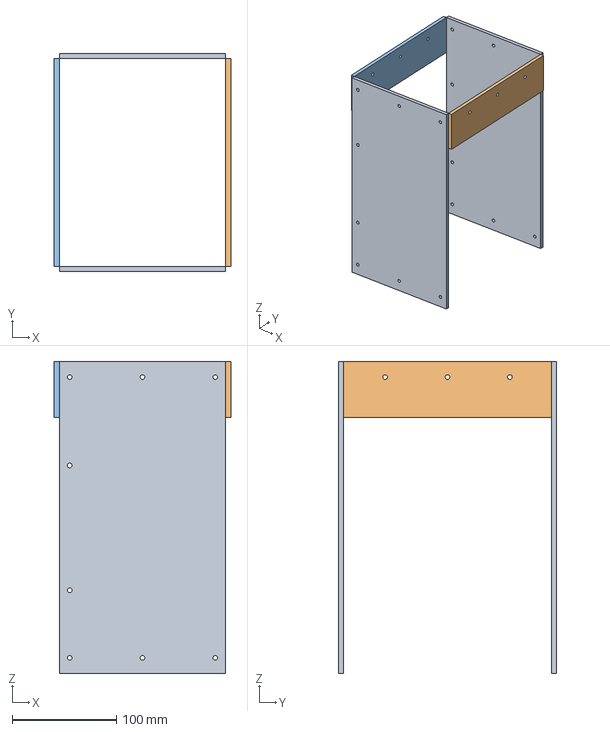
[picture p83: CAD file, 2026-11-05]
stages/fix11/cad/step/29_shield.step
170.0 x 210.0 x 300.0 mm
