inutcin/boomboom/stages/fix11/cad/stl/groups/grp_frame.stl

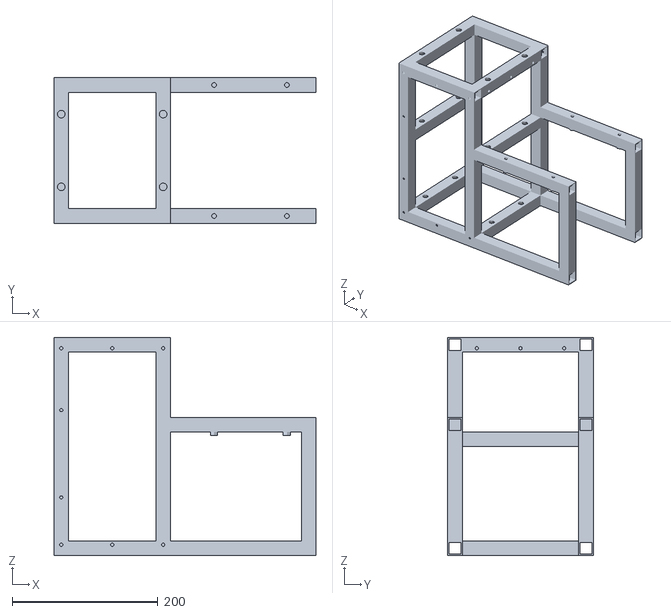
[picture p84: CAD file, 2026-11-03]
stages/fix11/cad/stl/groups/grp_frame.stl
360.0 x 200.0 x 300.0
