inutcin/boomboom/stages/fix11/cad/stl/table.stl

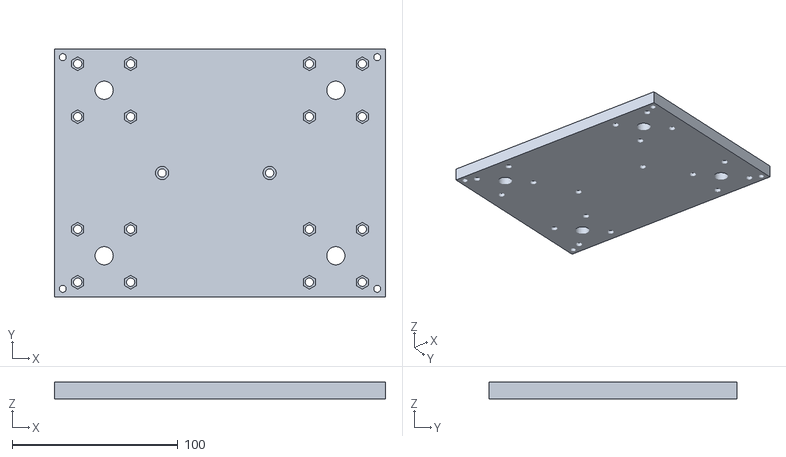
[picture p85: CAD file, 2026-11-03]
stages/fix11/cad/stl/table.stl
200.0 x 150.0 x 10.0
