inutcin/boomboom/stages/fix4/cad/stl/cam_5.stl

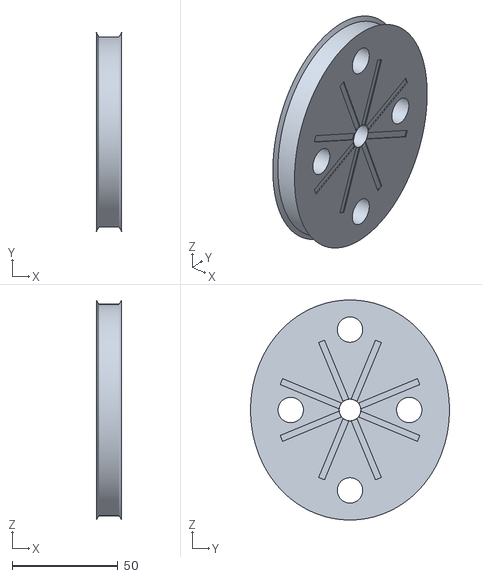
[picture p86: CAD file, 2026-10-30]
stages/fix4/cad/stl/cam_5.stl
12.0 x 94.0 x 104.0
