inutcin/boomboom/stages/fix6/cad/stl/groups/grp_table.stl

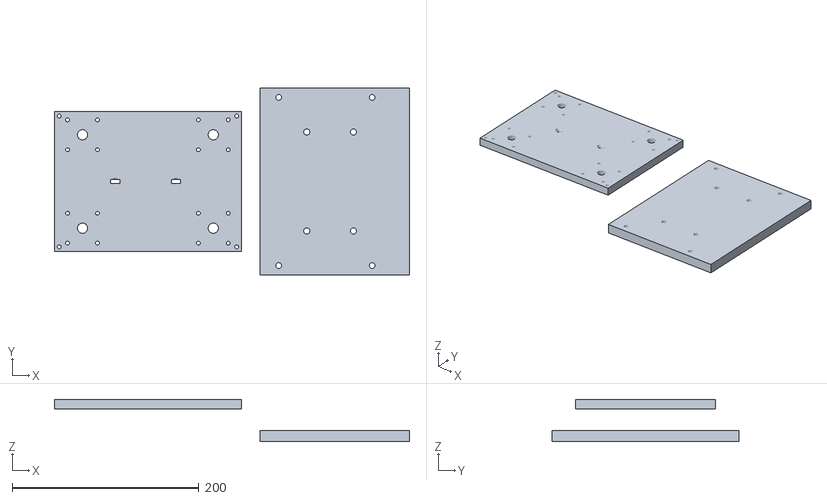
[picture p87: CAD file, 2026-10-30]
stages/fix6/cad/stl/groups/grp_table.stl
380.0 x 200.0 x 45.0
