inutcin/boomboom/stages/fix9/cad/stl/groups/grp_steel.stl

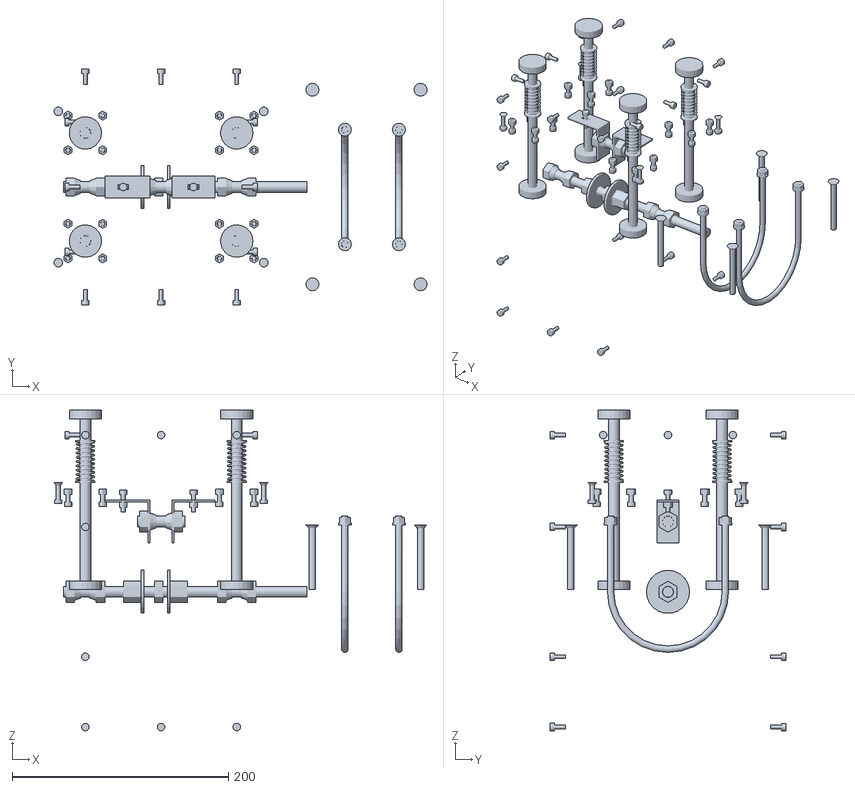
[picture p88: CAD file, 2026-11-02]
stages/fix9/cad/stl/groups/grp_steel.stl
344.9 x 218.0 x 296.5
