inutcin/boomboom/stages/model/cad/prev/step_parts/Пружина_прижимная.step

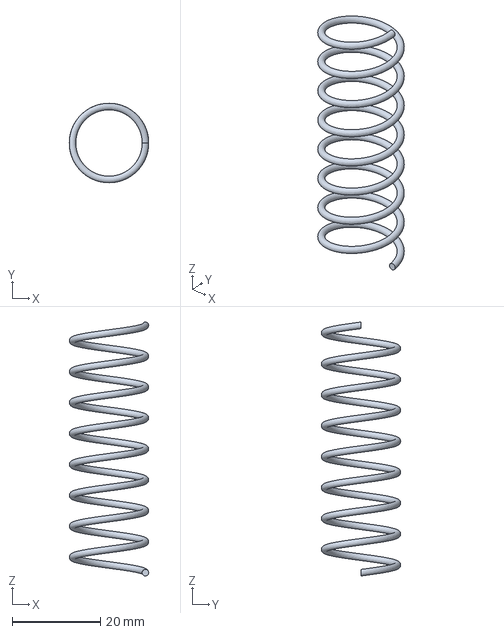
[picture p89: CAD file, 2026-10-29]
stages/model/cad/prev/step_parts/Пружина_прижимная.step
18.0 x 18.0 x 57.5 mm
