inutcin/boomboom/stages/model/cad/prev/stl_asm/49_Гайка М4.stl

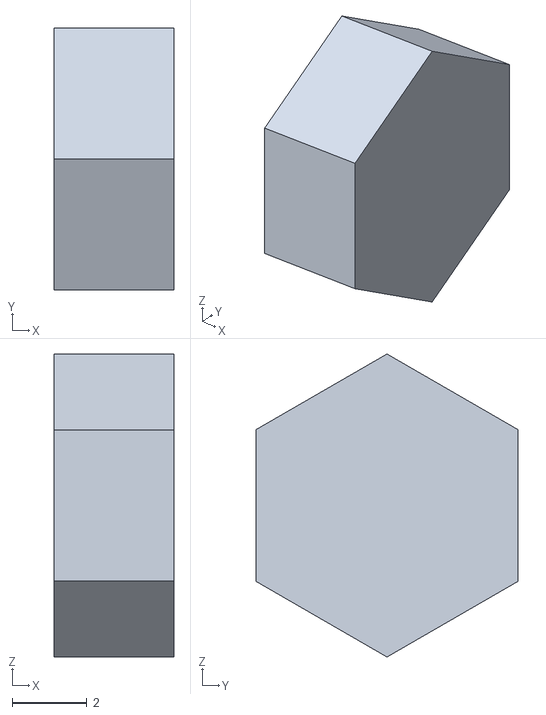
[picture p90: CAD file, 2026-10-29]
stages/model/cad/prev/stl_asm/49_Гайка М4.stl
3.20 x 7.00 x 8.08
