inutcin/boomboom/stages/model/cad/prev/stl_print/cam_R45-50_t14.stl

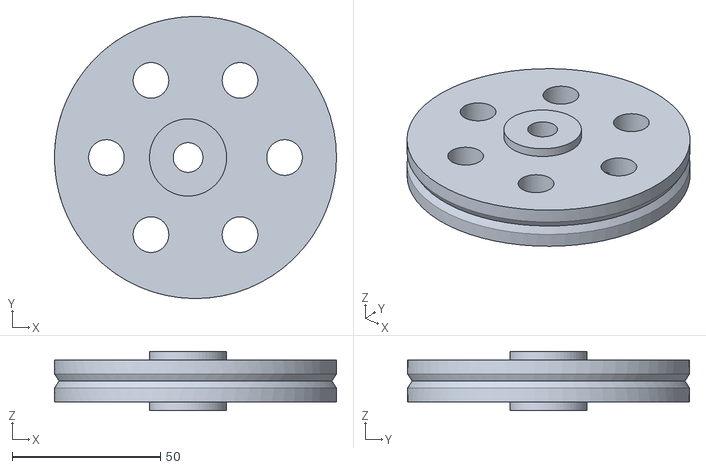
[picture p91: CAD file, 2026-10-29]
stages/model/cad/prev/stl_print/cam_R45-50_t14.stl
95.0 x 95.0 x 20.0
