inutcin/boomboom/stages/model/cad/step/14_crab.step

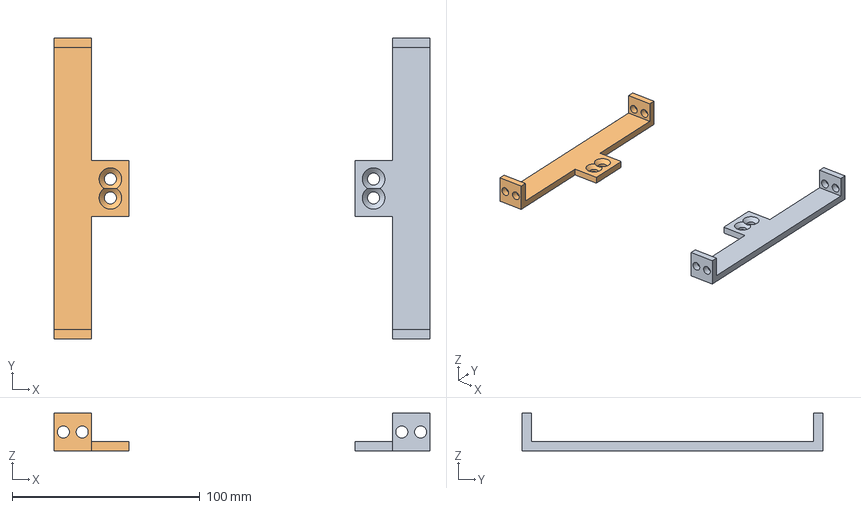
[picture p92: CAD file, 2026-10-29]
stages/model/cad/step/14_crab.step
200.0 x 160.0 x 20.0 mm
