inutcin/boomboom/stages/fix1/cad/stl/retainer.stl

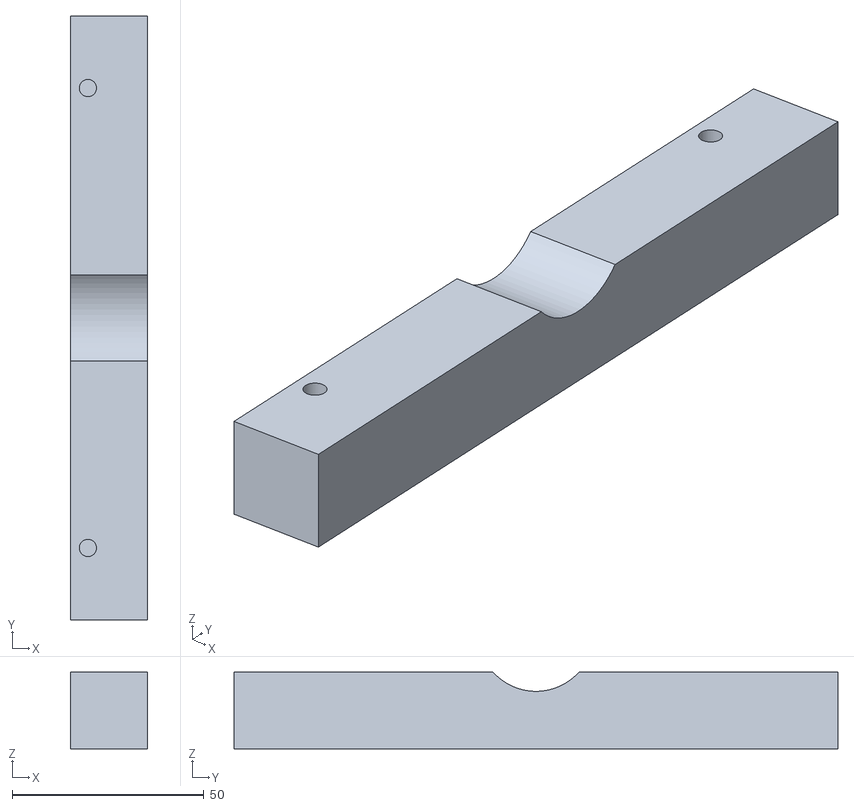
[picture p93: CAD file, 2026-10-29]
stages/fix1/cad/stl/retainer.stl
20.0 x 157.6 x 20.0
