inutcin/boomboom/stages/fix10l/cad/stl/groups/grp_bearing.stl

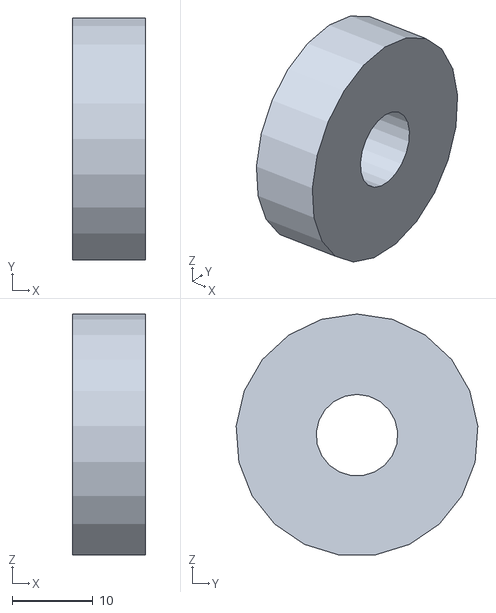
[picture p94: CAD file, 2026-11-02]
stages/fix10l/cad/stl/groups/grp_bearing.stl
9.00 x 29.9 x 29.8
