inutcin/boomboom/stages/fix11/cad/step/17_shaft_conical_nuts.step

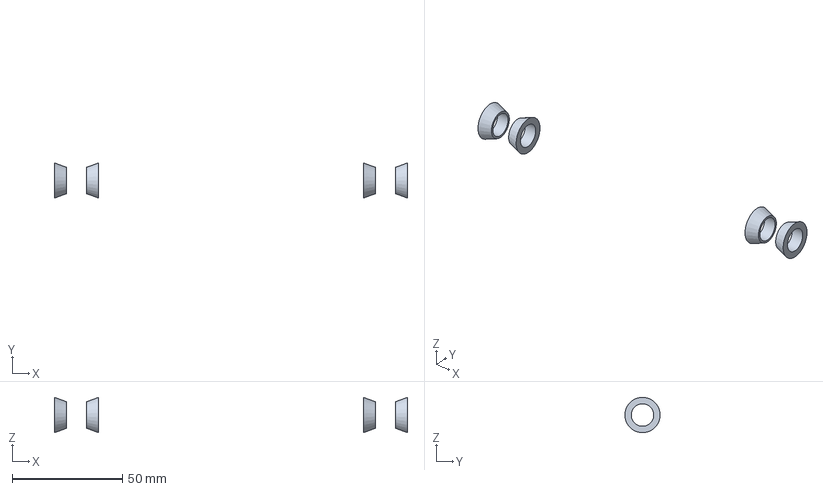
[picture p95: CAD file, 2026-11-05]
stages/fix11/cad/step/17_shaft_conical_nuts.step
160.0 x 16.0 x 16.0 mm
