inutcin/boomboom/stages/fix11/cad/stl/groups/grp_bearing.stl

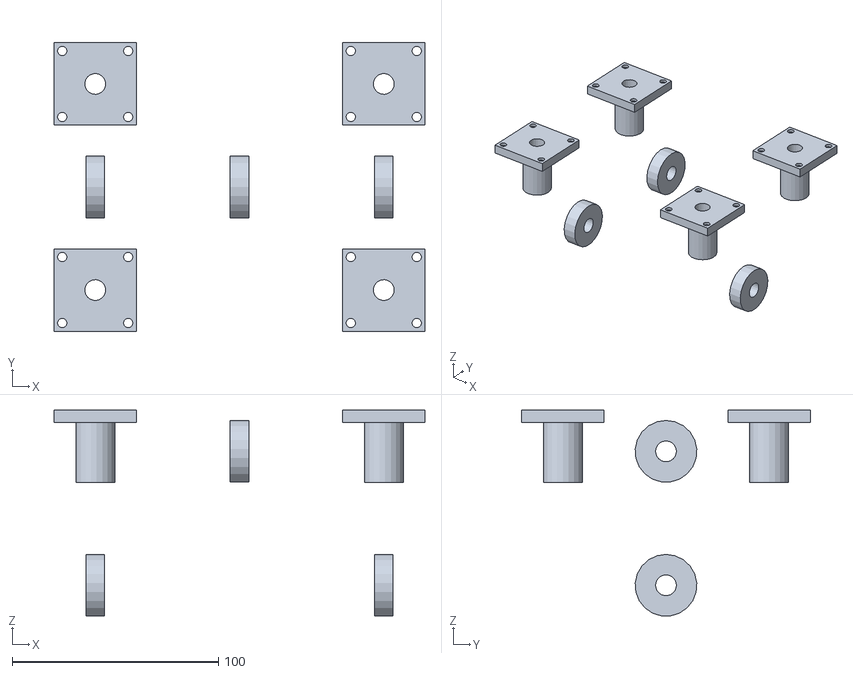
[picture p96: CAD file, 2026-11-03]
stages/fix11/cad/stl/groups/grp_bearing.stl
180.0 x 140.0 x 99.8
