inutcin/boomboom/stages/fix11/cad/stl/podstol.stl

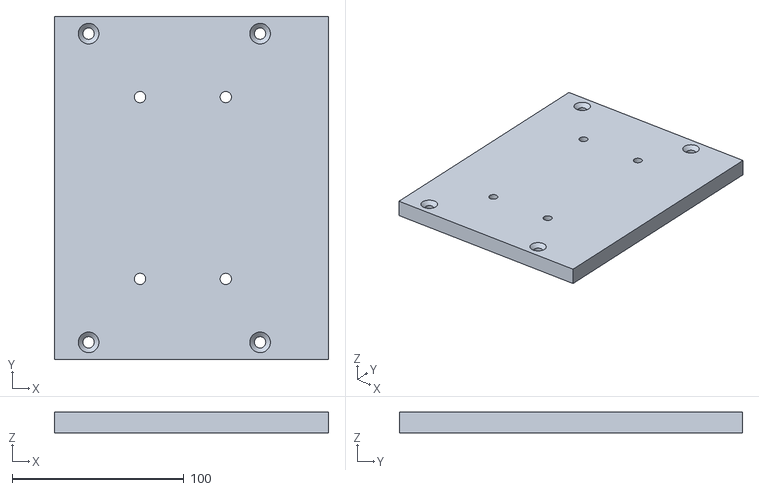
[picture p97: CAD file, 2026-11-03]
stages/fix11/cad/stl/podstol.stl
160.0 x 200.0 x 12.0
