inutcin/boomboom/stages/fix4/cad/stl/cam_3.stl

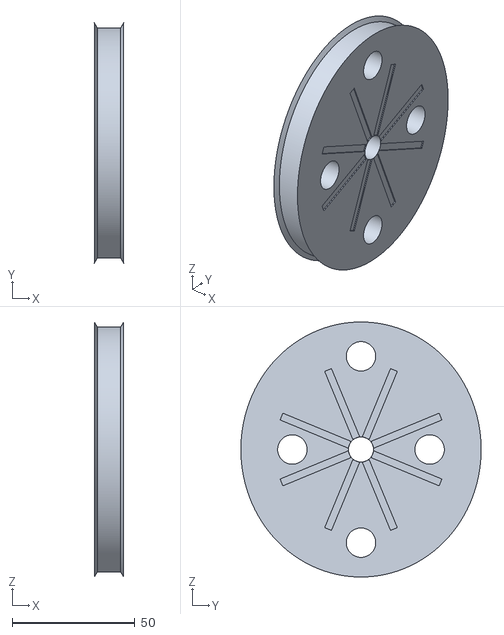
[picture p98: CAD file, 2026-10-30]
stages/fix4/cad/stl/cam_3.stl
12.0 x 98.0 x 104.0
