inutcin/boomboom/stages/fix4/cad/stl/groups/grp_bearing.stl

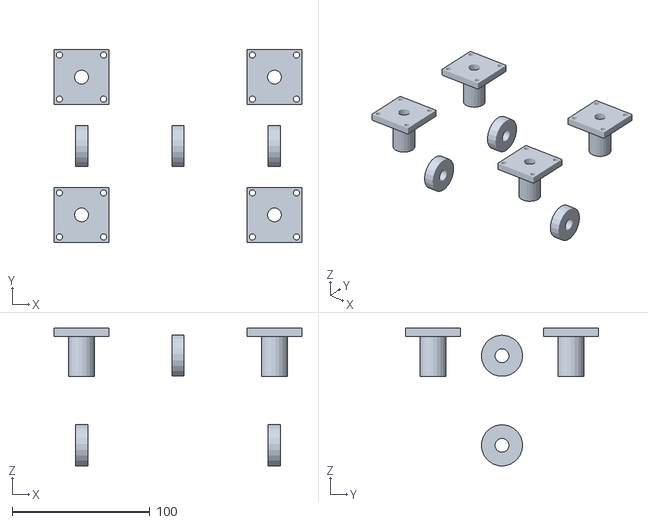
[picture p99: CAD file, 2026-10-30]
stages/fix4/cad/stl/groups/grp_bearing.stl
180.0 x 140.0 x 99.8
