inutcin/boomboom/stages/fix8/cad/stl/frame.stl

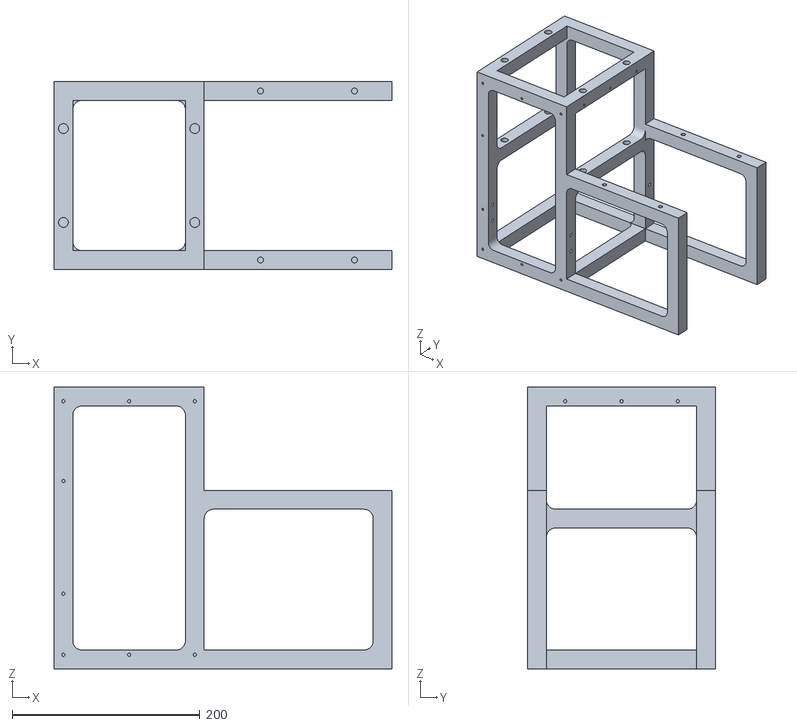
[picture p100: CAD file, 2026-10-30]
stages/fix8/cad/stl/frame.stl
360.0 x 200.0 x 300.0
