inutcin/boomboom/stages/model/cad/prev/step_parts/Ограничитель_вала.step

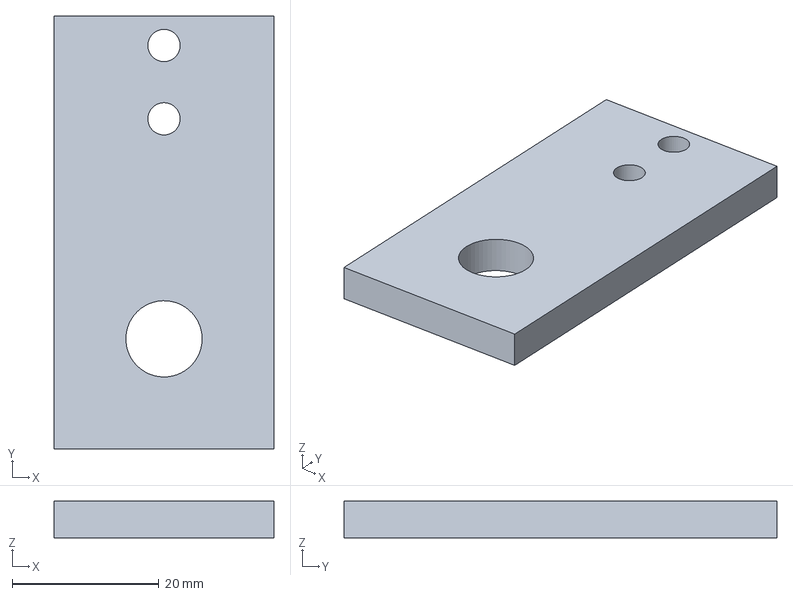
[picture p101: CAD file, 2026-10-29]
stages/model/cad/prev/step_parts/Ограничитель_вала.step
30.0 x 59.0 x 5.00 mm
