inutcin/boomboom/stages/model/cad/prev/stl_asm/85_Хвостовик-шпилька М10.stl

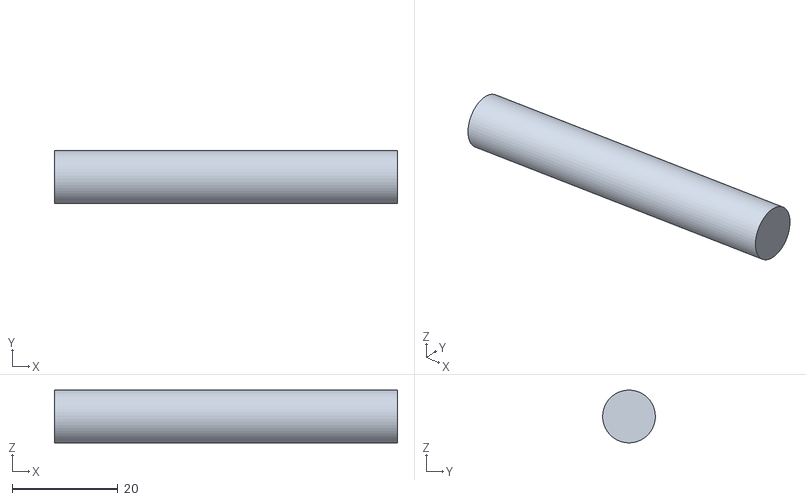
[picture p102: CAD file, 2026-10-29]
stages/model/cad/prev/stl_asm/85_Хвостовик-шпилька М10.stl
65.0 x 10.00 x 9.99
