inutcin/boomboom/stages/model/cad/stl/groups/grp_frame.stl

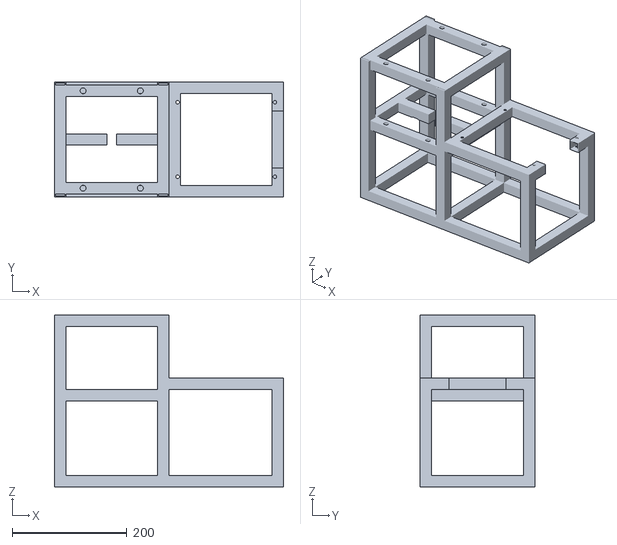
[picture p103: CAD file, 2026-10-29]
stages/model/cad/stl/groups/grp_frame.stl
400.0 x 200.0 x 300.0
