inutcin/boomboom/stages/fix1/cad/stl/groups/grp_crabs.stl

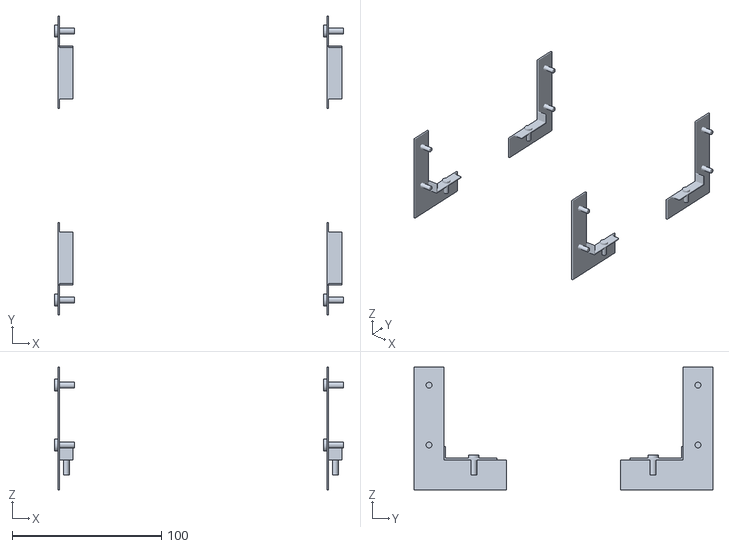
[picture p104: CAD file, 2026-10-29]
stages/fix1/cad/stl/groups/grp_crabs.stl
193.4 x 200.0 x 82.0
