inutcin/boomboom/stages/fix10l/cad/step/08_spring_pads.step

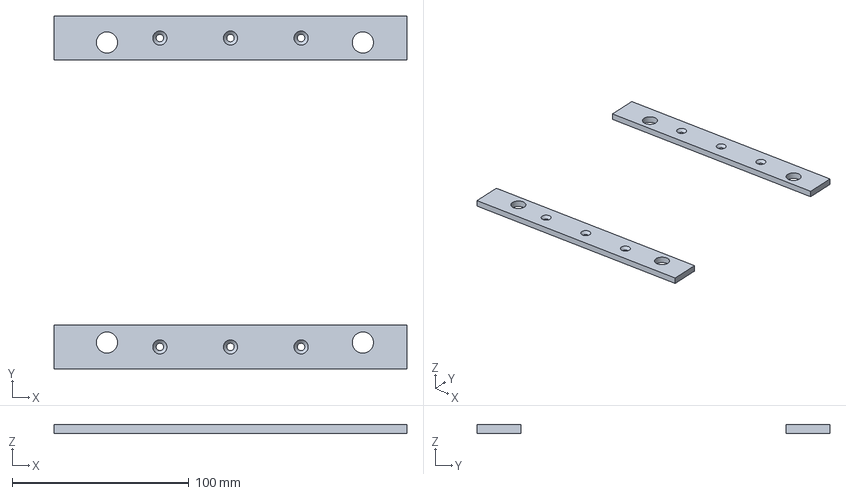
[picture p105: CAD file, 2026-11-02]
stages/fix10l/cad/step/08_spring_pads.step
200.0 x 200.0 x 5.00 mm
