inutcin/boomboom/stages/fix10l/cad/stl/cam_3.stl

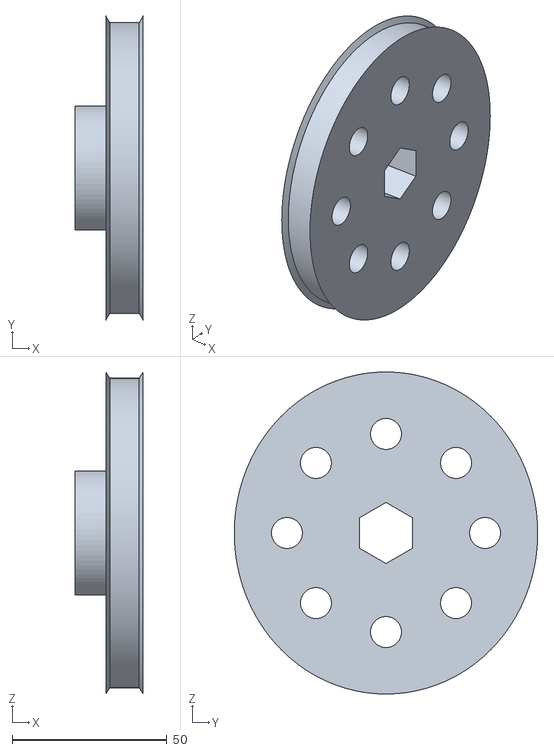
[picture p106: CAD file, 2026-11-02]
stages/fix10l/cad/stl/cam_3.stl
22.0 x 98.0 x 104.0
