inutcin/boomboom/stages/fix10l/cad/stl/groups/grp_rubber.stl

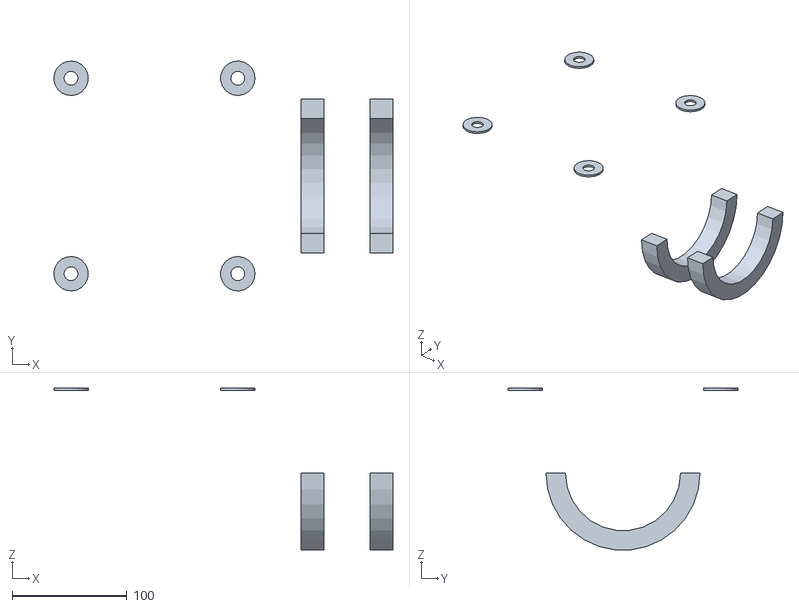
[picture p107: CAD file, 2026-11-02]
stages/fix10l/cad/stl/groups/grp_rubber.stl
294.8 x 199.9 x 140.6
