inutcin/boomboom/stages/fix11/cad/step/45_shaft_nuts.step

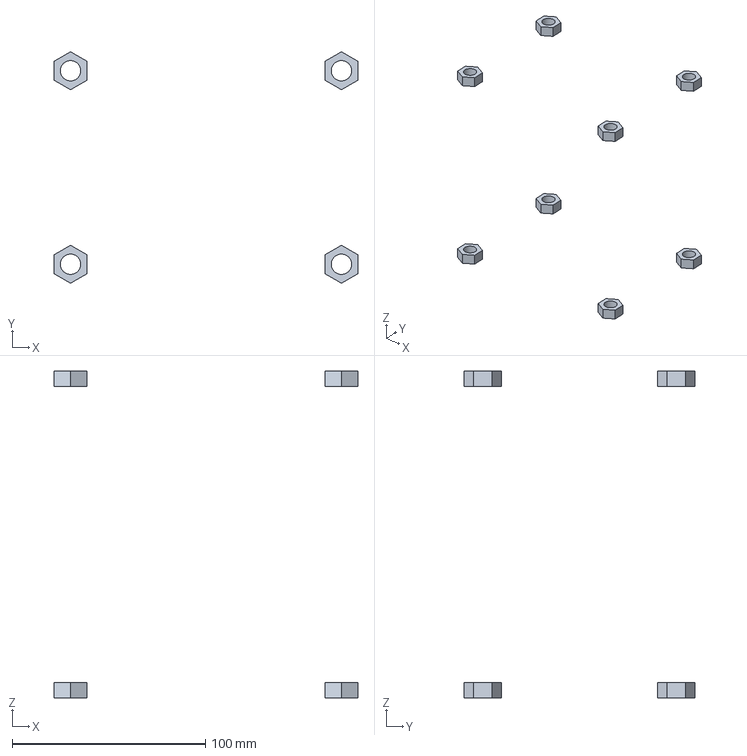
[picture p108: CAD file, 2026-11-05]
stages/fix11/cad/step/45_shaft_nuts.step
157.0 x 119.6 x 169.0 mm
