inutcin/boomboom/stages/fix2/cad/stl/groups/grp_cam.stl

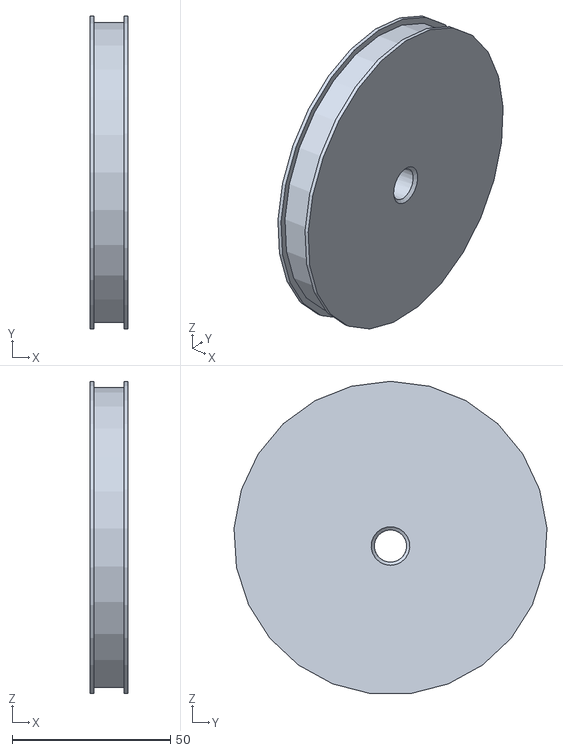
[picture p109: CAD file, 2026-10-29]
stages/fix2/cad/stl/groups/grp_cam.stl
12.0 x 98.8 x 98.6
