inutcin/boomboom/stages/fix4/cad/stl/cam_10.stl

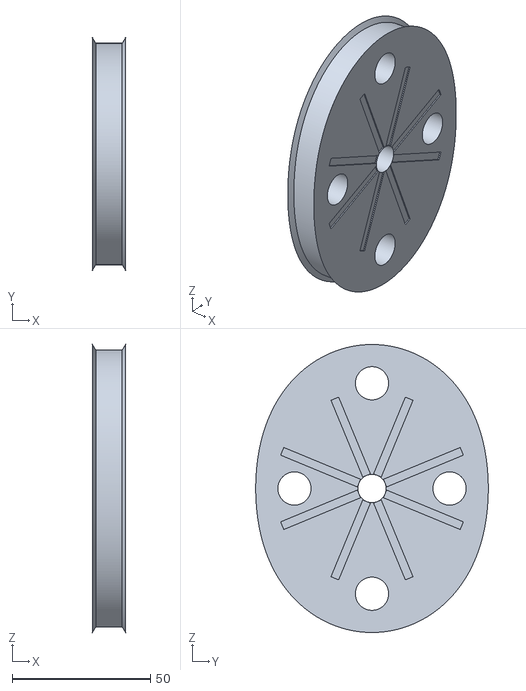
[picture p110: CAD file, 2026-10-30]
stages/fix4/cad/stl/cam_10.stl
12.0 x 84.0 x 104.0
