inutcin/boomboom/stages/fix9/cad/stl/groups/grp_frame.stl

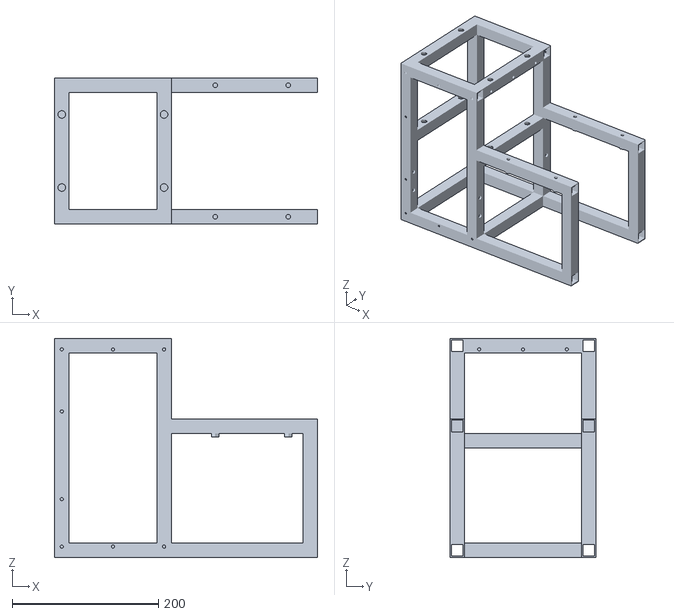
[picture p111: CAD file, 2026-11-02]
stages/fix9/cad/stl/groups/grp_frame.stl
360.0 x 200.0 x 300.0
