inutcin/boomboom/stages/model/cad/prev/step_parts/Хомут_U-образный_М6.step

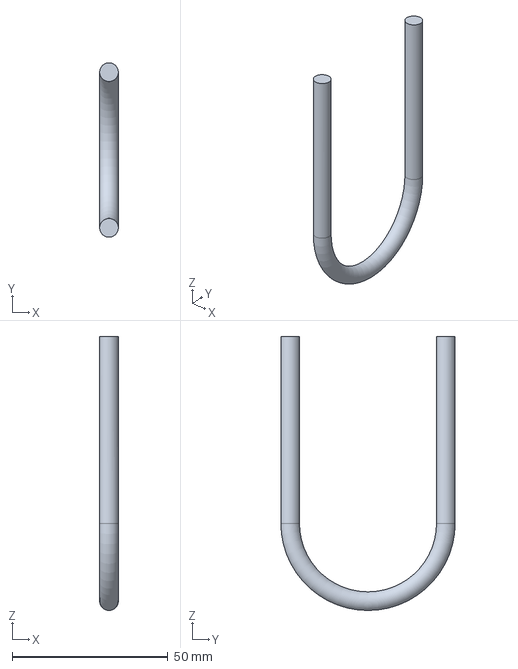
[picture p112: CAD file, 2026-10-29]
stages/model/cad/prev/step_parts/Хомут_U-образный_М6.step
6.00 x 56.0 x 88.0 mm
