inutcin/boomboom/stages/fix10l/cad/stl/groups/grp_drill.stl

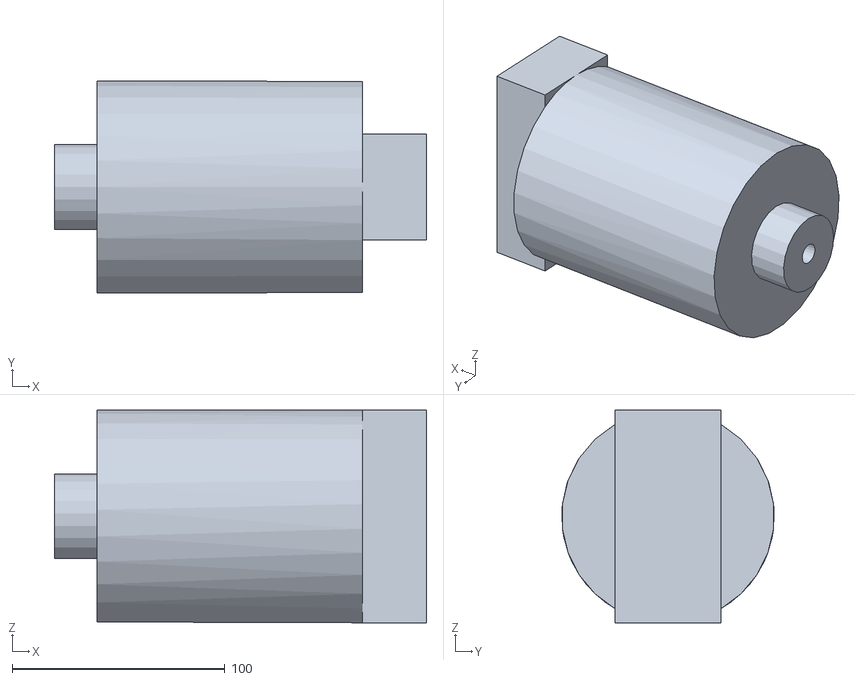
[picture p113: CAD file, 2026-11-02]
stages/fix10l/cad/stl/groups/grp_drill.stl
175.0 x 99.8 x 100.0
