inutcin/boomboom/stages/fix11/cad/stl/groups/grp_retainer.stl

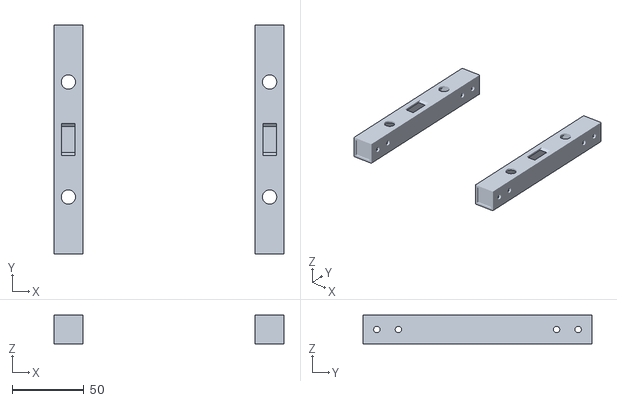
[picture p114: CAD file, 2026-11-03]
stages/fix11/cad/stl/groups/grp_retainer.stl
160.0 x 159.6 x 20.0
