inutcin/boomboom/stages/fix3/cad/stl/table.stl

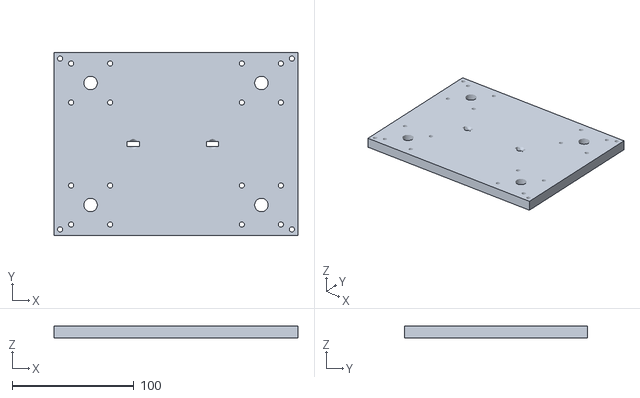
[picture p115: CAD file, 2026-10-30]
stages/fix3/cad/stl/table.stl
200.0 x 150.0 x 10.0
