inutcin/boomboom/stages/fix4/cad/stl/groups/grp_rubber.stl

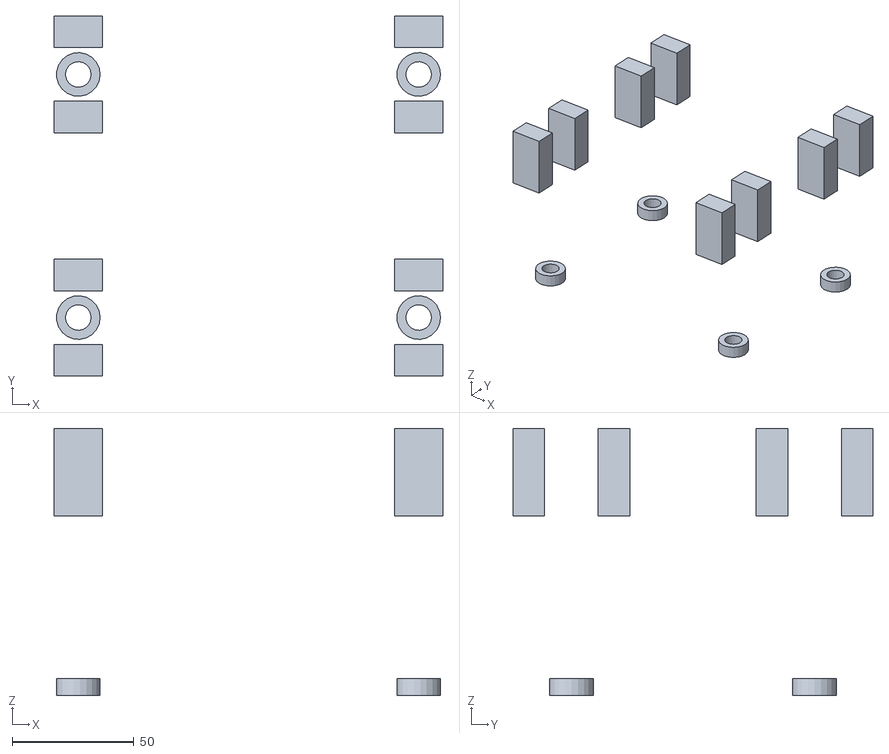
[picture p116: CAD file, 2026-10-30]
stages/fix4/cad/stl/groups/grp_rubber.stl
160.0 x 148.0 x 110.0
