inutcin/boomboom/stages/fix9/cad/stl/groups/grp_angles.stl

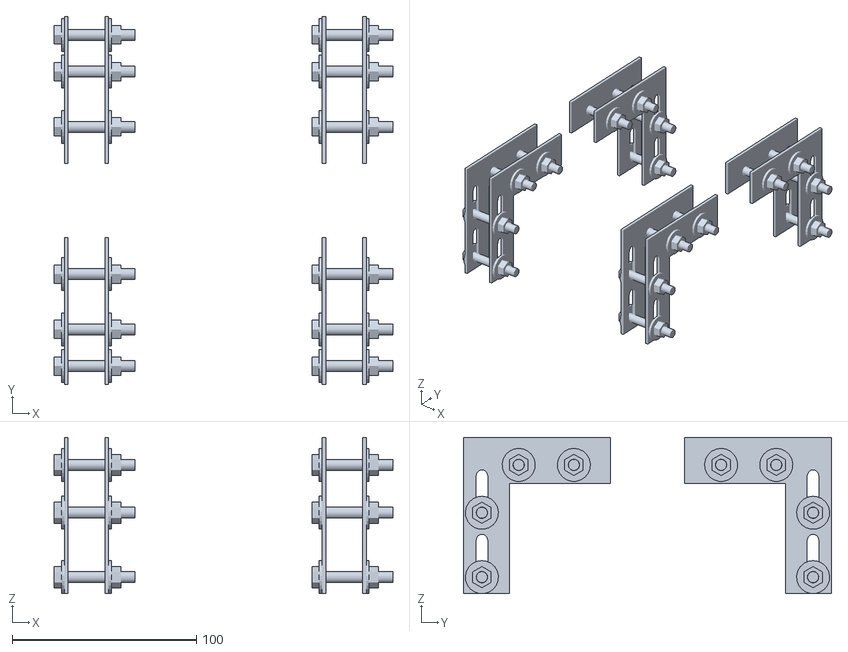
[picture p117: CAD file, 2026-11-02]
stages/fix9/cad/stl/groups/grp_angles.stl
184.0 x 200.0 x 85.0
