inutcin/boomboom/stages/model/cad/prev/step_parts/Гайка_М6.step

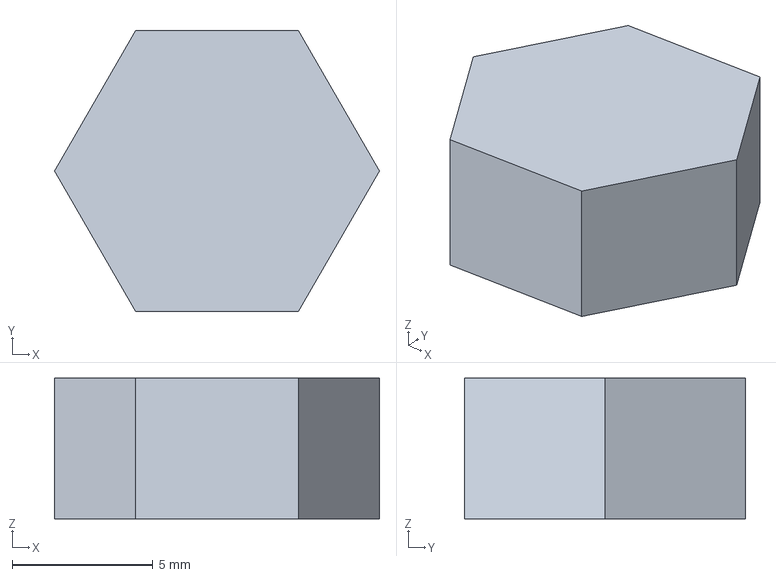
[picture p118: CAD file, 2026-10-29]
stages/model/cad/prev/step_parts/Гайка_М6.step
11.5 x 10.0 x 5.00 mm
