inutcin/boomboom/stages/fix10l/cad/stl/groups/grp_spring.stl

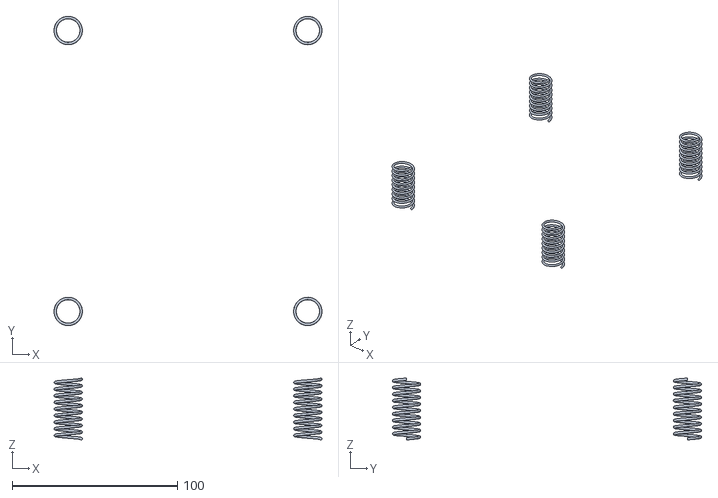
[picture p119: CAD file, 2026-11-02]
stages/fix10l/cad/stl/groups/grp_spring.stl
162.2 x 187.2 x 37.5
