inutcin/boomboom/stages/fix11/cad/step/41_clamp_studs.step

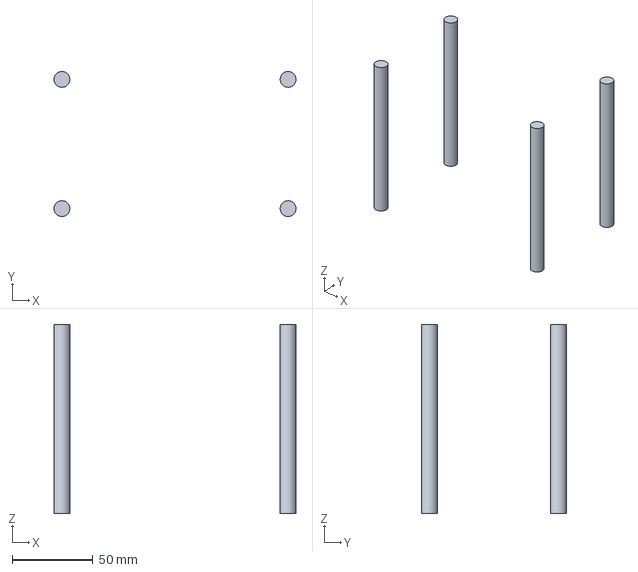
[picture p120: CAD file, 2026-11-05]
stages/fix11/cad/step/41_clamp_studs.step
149.8 x 89.8 x 117.0 mm
