inutcin/boomboom/stages/fix11/cad/stl/groups/grp_plastic.stl

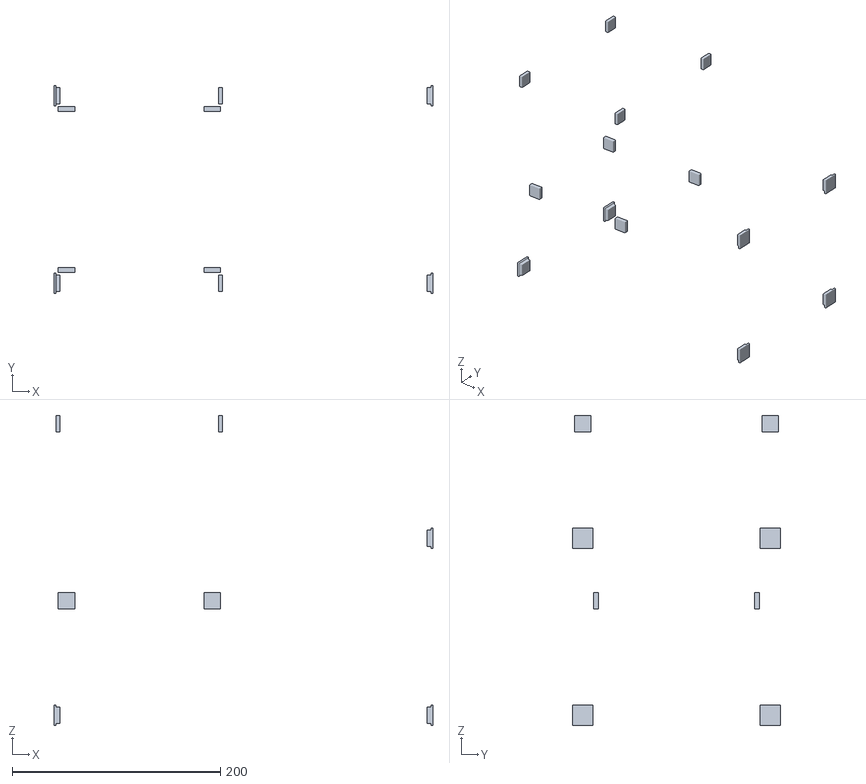
[picture p121: CAD file, 2026-11-03]
stages/fix11/cad/stl/groups/grp_plastic.stl
364.0 x 200.0 x 298.0
