inutcin/boomboom/stages/fix2/cad/step/14_crab.step

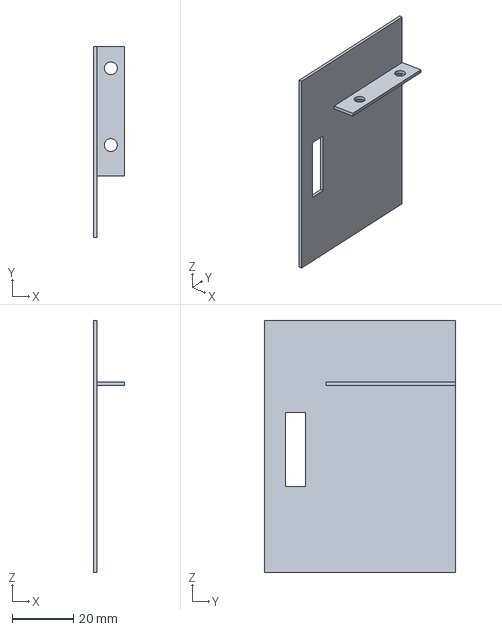
[picture p122: CAD file, 2026-10-29]
stages/fix2/cad/step/14_crab.step
10.2 x 62.0 x 82.0 mm
