inutcin/boomboom/stages/fix2/cad/stl/podstol.stl

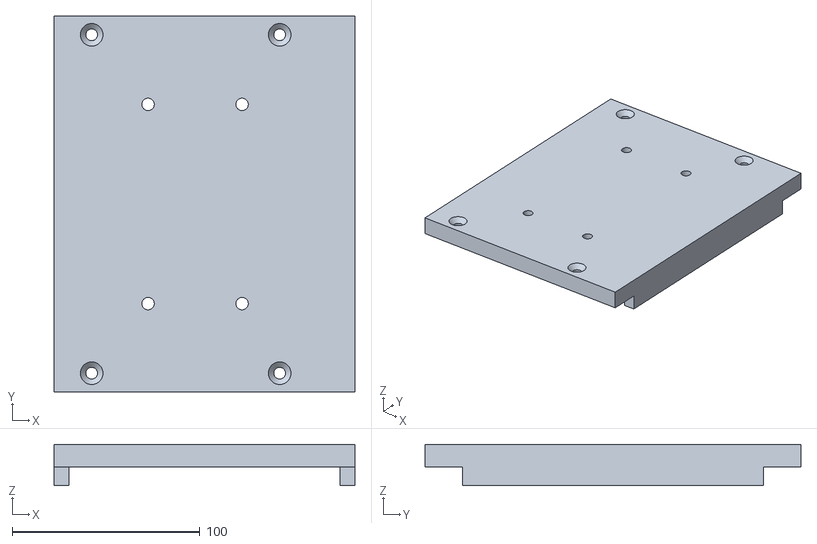
[picture p123: CAD file, 2026-10-29]
stages/fix2/cad/stl/podstol.stl
160.0 x 200.0 x 22.0
