inutcin/boomboom/stages/model/cad/prev/step_parts/Шайба_10.step

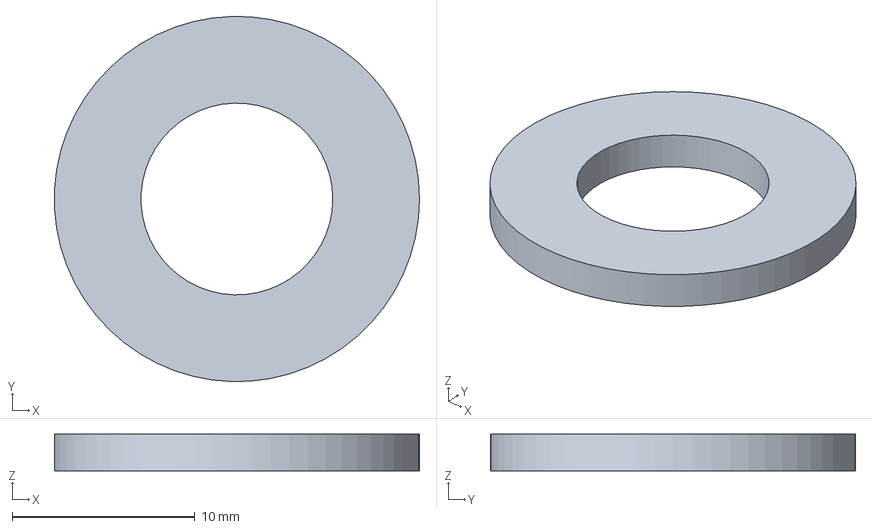
[picture p124: CAD file, 2026-10-29]
stages/model/cad/prev/step_parts/Шайба_10.step
20.0 x 20.0 x 2.00 mm
