inutcin/boomboom/stages/model/cad/prev/stl_asm/02_Стол (фанера 10).stl

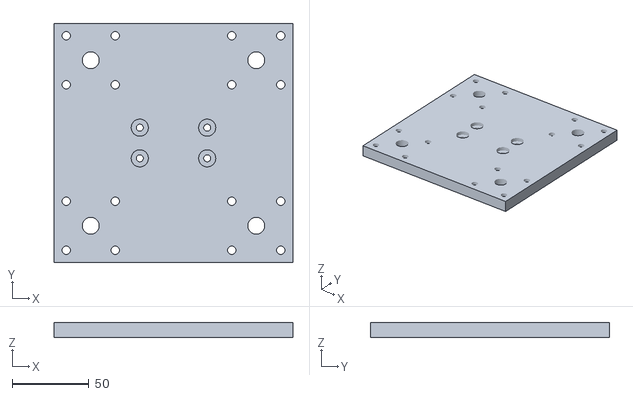
[picture p125: CAD file, 2026-10-29]
stages/model/cad/prev/stl_asm/02_Стол (фанера 10).stl
156.0 x 156.0 x 10.0
