inutcin/boomboom/stages/fix10l/cad/step/26_roller_shims.step

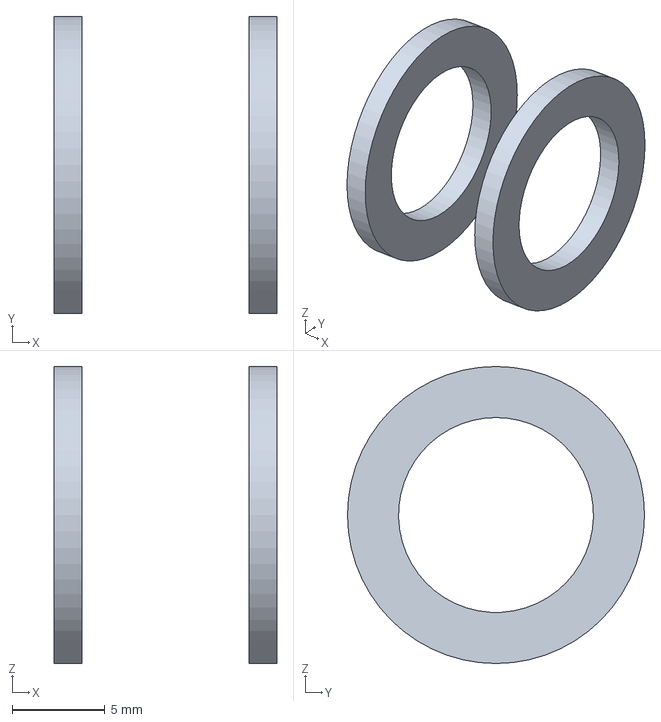
[picture p126: CAD file, 2026-11-02]
stages/fix10l/cad/step/26_roller_shims.step
12.0 x 16.0 x 16.0 mm
