inutcin/boomboom/stages/fix10l/cad/stl/groups/grp_wood.stl

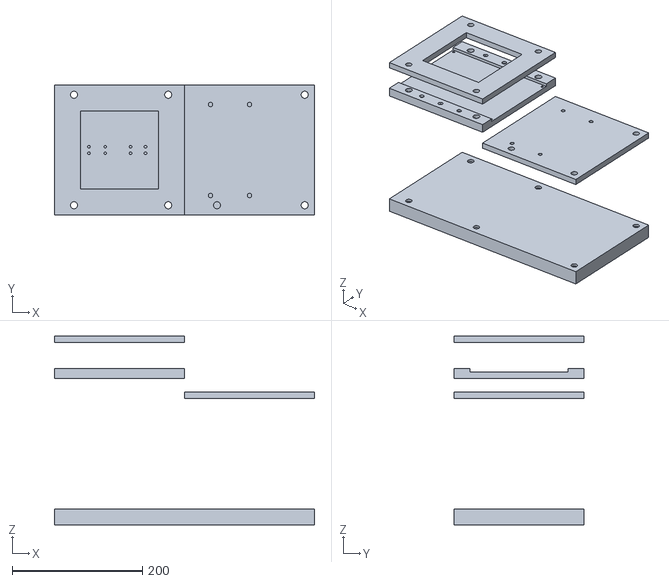
[picture p127: CAD file, 2026-11-02]
stages/fix10l/cad/stl/groups/grp_wood.stl
400.0 x 200.0 x 290.0
