inutcin/boomboom/stages/fix11/cad/stl/groups/grp_angles.stl

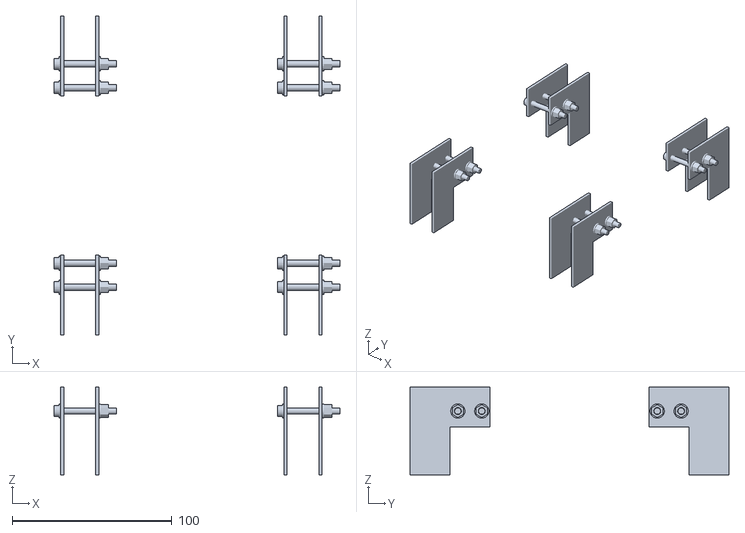
[picture p128: CAD file, 2026-11-03]
stages/fix11/cad/stl/groups/grp_angles.stl
179.0 x 200.0 x 55.0
