inutcin/boomboom/stages/fix9/cad/stl/groups/grp_cartridge.stl

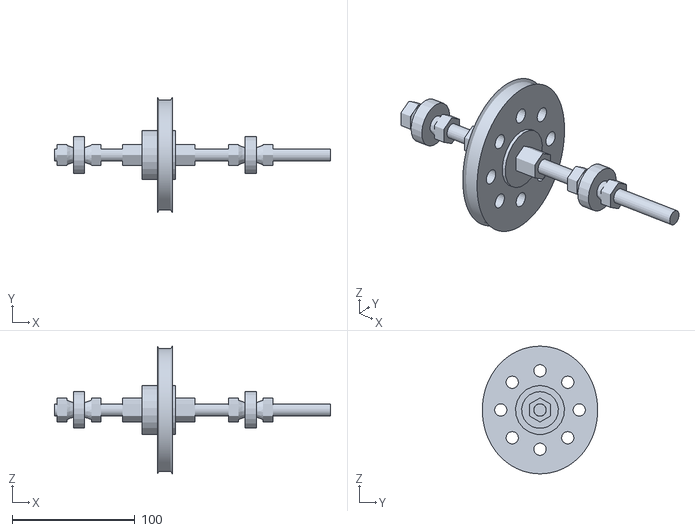
[picture p129: CAD file, 2026-11-02]
stages/fix9/cad/stl/groups/grp_cartridge.stl
225.0 x 94.0 x 104.0
