inutcin/boomboom/stages/model/cad/prev/step_parts/Контрагайка_М10.step

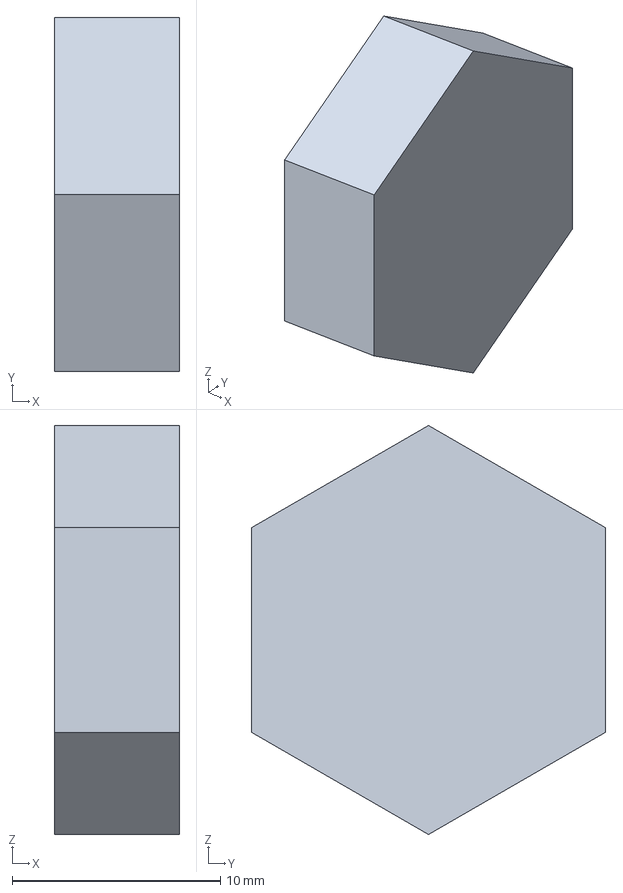
[picture p130: CAD file, 2026-10-29]
stages/model/cad/prev/step_parts/Контрагайка_М10.step
6.00 x 17.0 x 19.6 mm
