inutcin/boomboom/stages/fix10l/cad/step/03_nuts.step

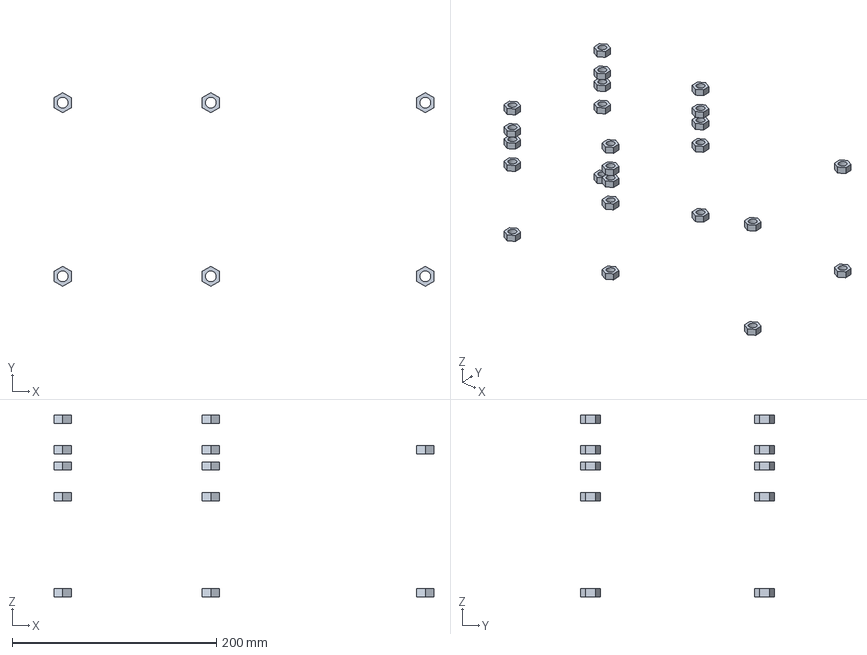
[picture p131: CAD file, 2026-11-02]
stages/fix10l/cad/step/03_nuts.step
372.0 x 189.6 x 178.0 mm
