inutcin/boomboom/stages/fix11/cad/step/20_drive_shaft.step

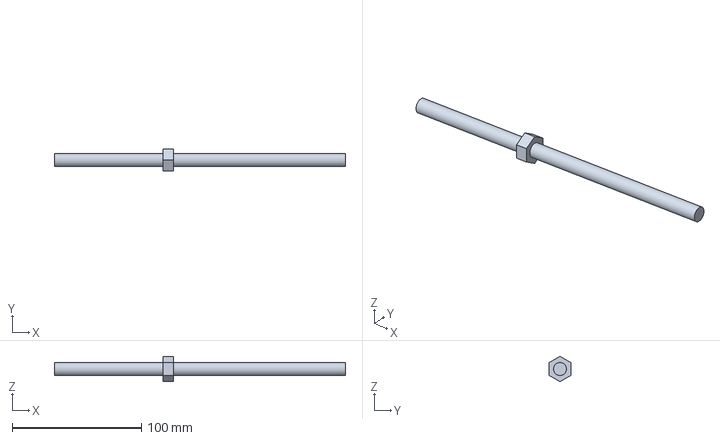
[picture p132: CAD file, 2026-11-05]
stages/fix11/cad/step/20_drive_shaft.step
225.0 x 17.0 x 19.6 mm
