inutcin/boomboom/stages/model/cad/prev/step_parts/Гайка_М10_кулачок.step

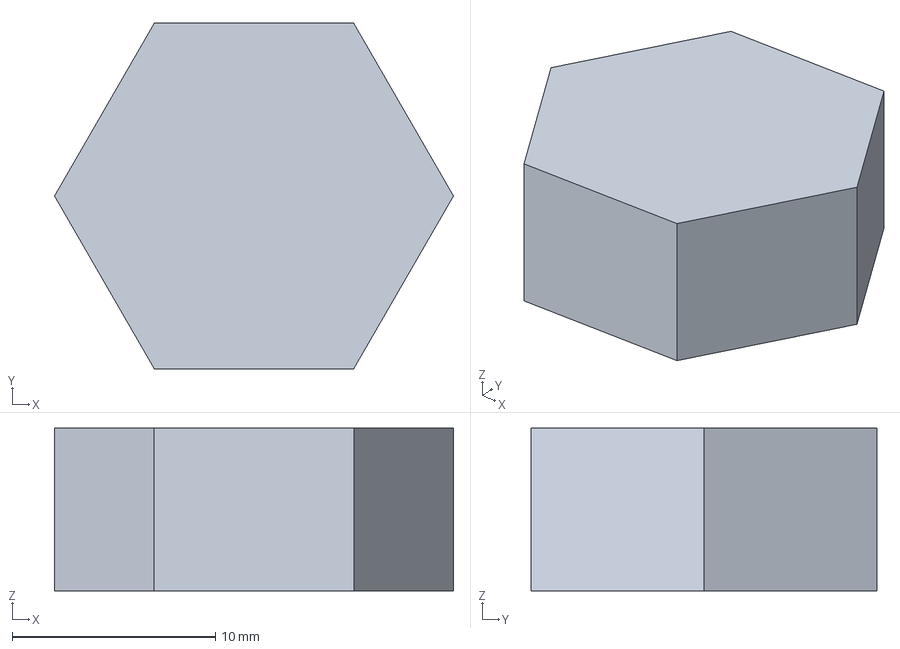
[picture p133: CAD file, 2026-10-29]
stages/model/cad/prev/step_parts/Гайка_М10_кулачок.step
19.6 x 17.0 x 8.00 mm
