inutcin/boomboom/stages/model/cad/prev/stl_asm/61_Краб-система (зажим 20×20).stl

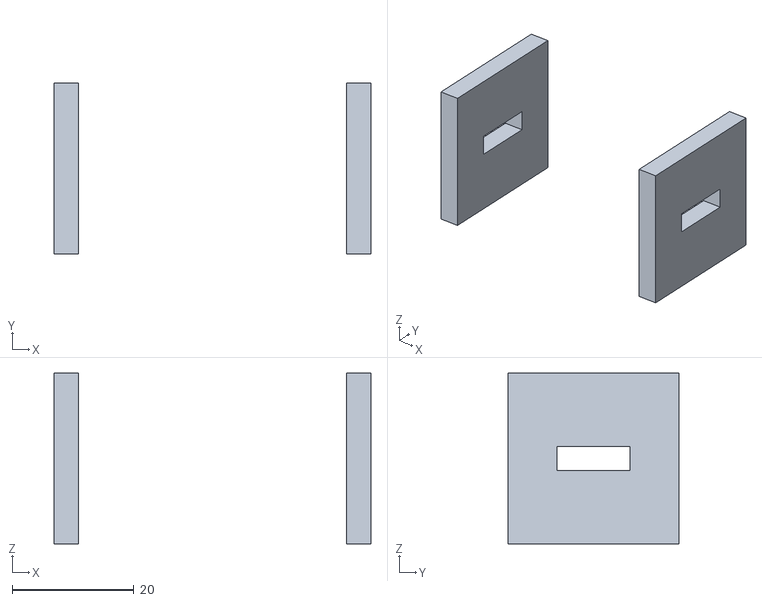
[picture p134: CAD file, 2026-10-29]
stages/model/cad/prev/stl_asm/61_Краб-система (зажим 20×20).stl
52.0 x 28.0 x 28.0
