inutcin/boomboom/stages/fix11/cad/step/06_bracket.step

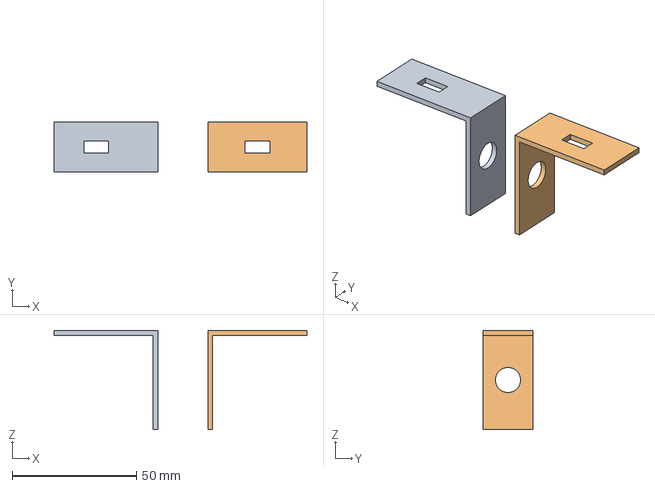
[picture p135: CAD file, 2026-11-05]
stages/fix11/cad/step/06_bracket.step
102.0 x 20.0 x 40.0 mm
