inutcin/boomboom/stages/model/cad/prev/stl_asm/48_Болт потайной М4×20.stl

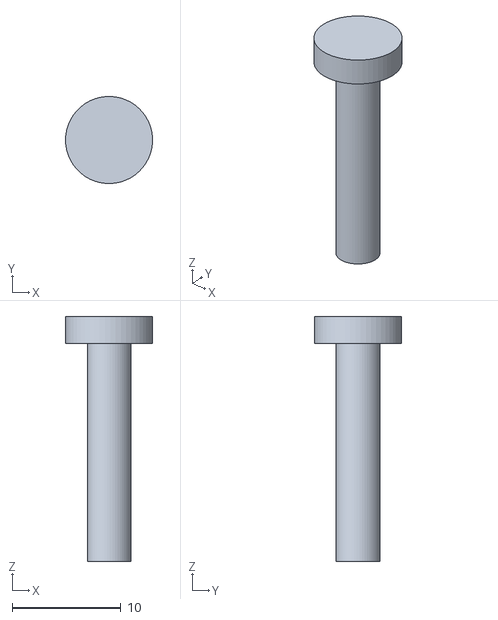
[picture p136: CAD file, 2026-10-29]
stages/model/cad/prev/stl_asm/48_Болт потайной М4×20.stl
7.99 x 8.00 x 22.5
