inutcin/boomboom/stages/fix11/cad/step/03_spring.step

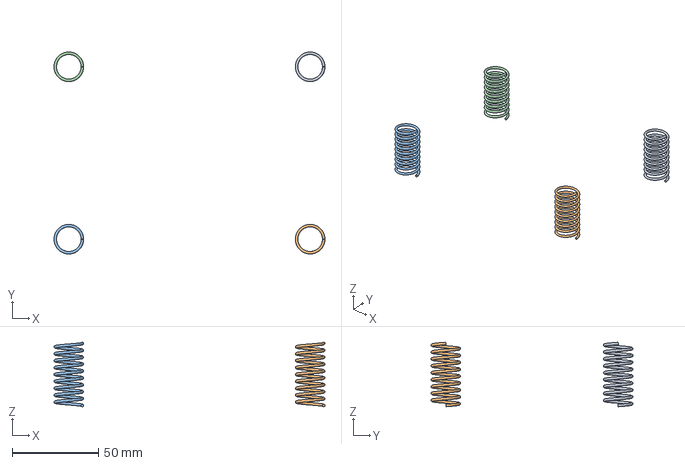
[picture p137: CAD file, 2026-11-05]
stages/fix11/cad/step/03_spring.step
157.2 x 117.2 x 37.5 mm
