inutcin/boomboom/stages/model/cad/prev/stl_asm/07_Вал Ø10×120.stl

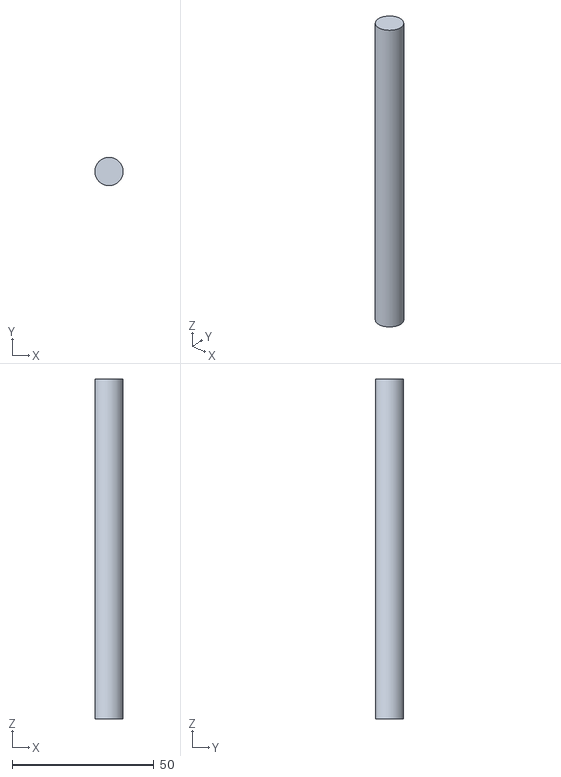
[picture p138: CAD file, 2026-10-29]
stages/model/cad/prev/stl_asm/07_Вал Ø10×120.stl
9.99 x 10.00 x 120.0
