inutcin/boomboom/stages/fix10l/cad/step/09_top_platform.step

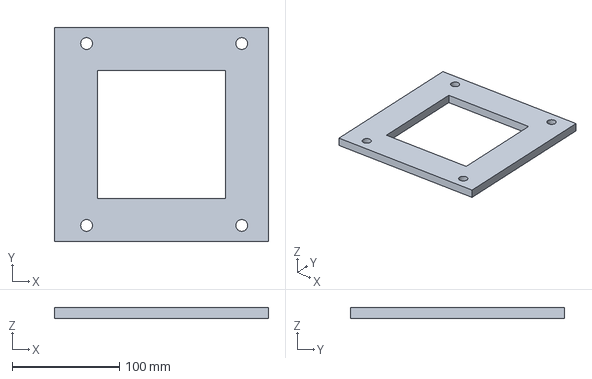
[picture p139: CAD file, 2026-11-02]
stages/fix10l/cad/step/09_top_platform.step
200.0 x 200.0 x 10.0 mm
