inutcin/boomboom/stages/fix11/cad/step/22_T17.step

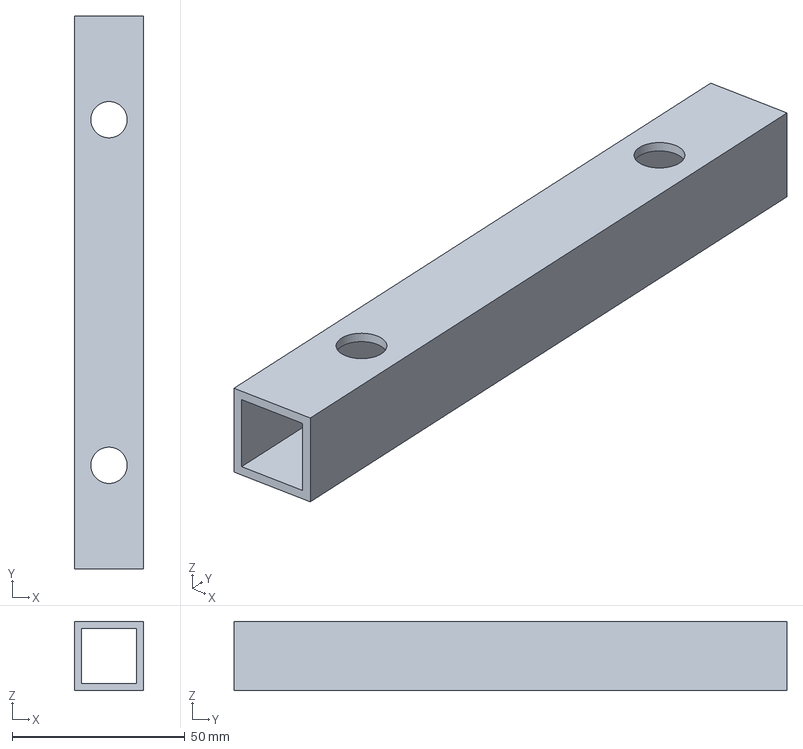
[picture p140: CAD file, 2026-11-05]
stages/fix11/cad/step/22_T17.step
20.0 x 160.0 x 20.0 mm
