inutcin/boomboom/stages/model/cad/prev/step_parts/Линейный_подшипник_LMF10UU.step

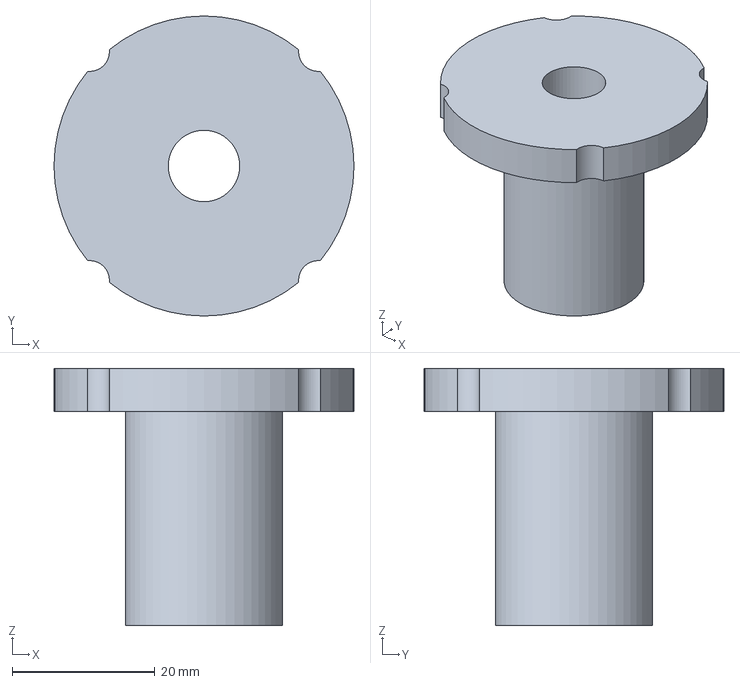
[picture p141: CAD file, 2026-10-29]
stages/model/cad/prev/step_parts/Линейный_подшипник_LMF10UU.step
42.0 x 42.0 x 36.0 mm
