inutcin/boomboom/stages/fix11/cad/step/09_6200.step

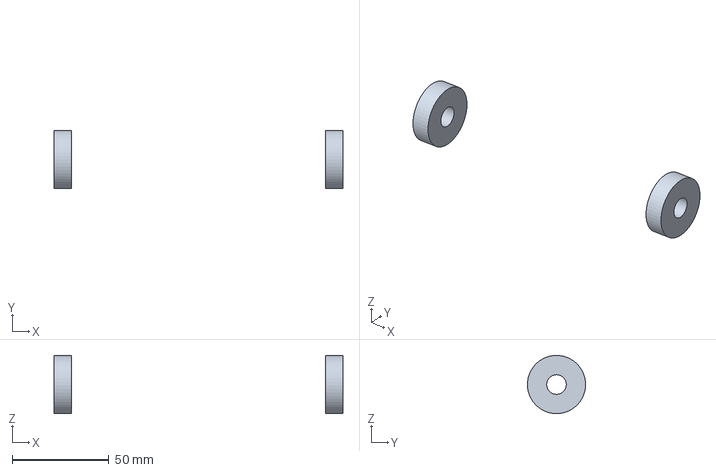
[picture p142: CAD file, 2026-11-05]
stages/fix11/cad/step/09_6200.step
149.0 x 30.0 x 30.0 mm
