inutcin/boomboom/stages/fix10l/cad/step/36_jam_nuts.step

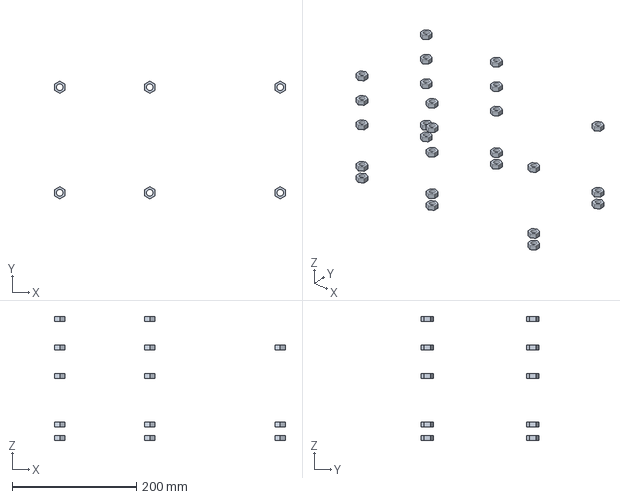
[picture p143: CAD file, 2026-11-02]
stages/fix10l/cad/step/36_jam_nuts.step
372.0 x 189.6 x 200.0 mm
