inutcin/boomboom/stages/fix10l/cad/step/06_table.step

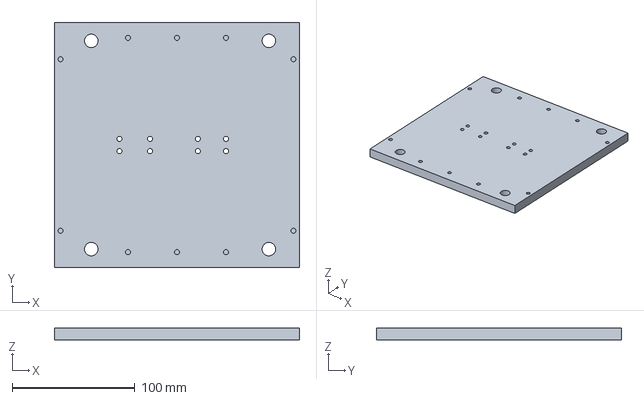
[picture p144: CAD file, 2026-11-02]
stages/fix10l/cad/step/06_table.step
200.0 x 200.0 x 10.0 mm
