inutcin/boomboom/stages/model/cad/prev/step_parts/Подстолье_фанера_12.step

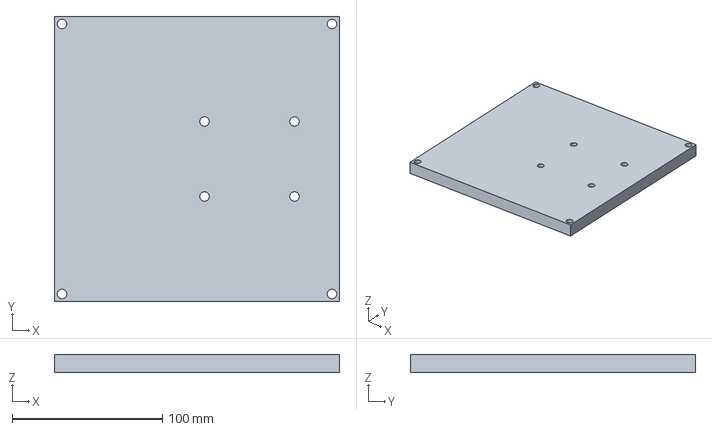
[picture p145: CAD file, 2026-10-29]
stages/model/cad/prev/step_parts/Подстолье_фанера_12.step
190.0 x 190.0 x 12.0 mm
