inutcin/boomboom/stages/fix10l/cad/step/01_studs.step

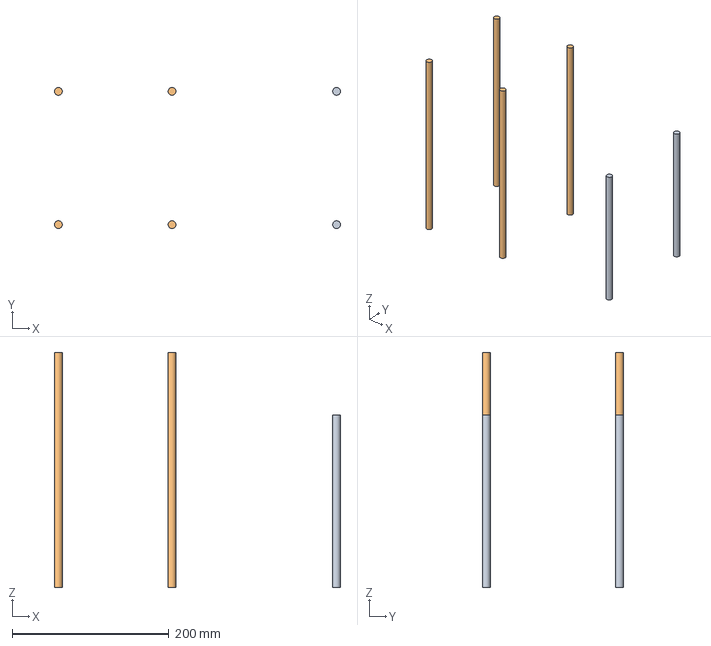
[picture p146: CAD file, 2026-11-02]
stages/fix10l/cad/step/01_studs.step
365.0 x 180.0 x 300.0 mm
