inutcin/boomboom/stages/fix11/cad/step/22_T06.step

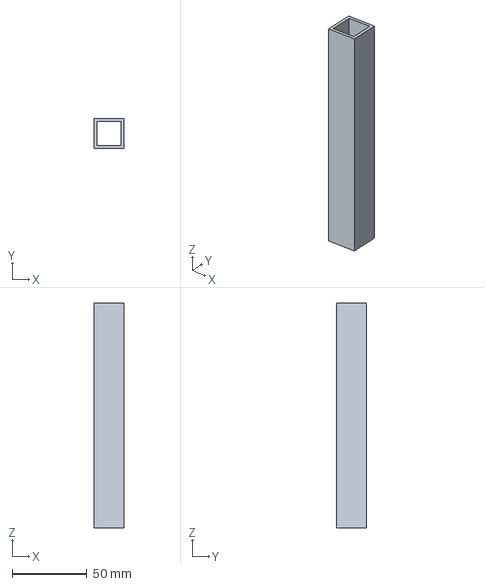
[picture p147: CAD file, 2026-11-05]
stages/fix11/cad/step/22_T06.step
20.0 x 20.0 x 150.0 mm
