inutcin/boomboom/stages/model/cad/prev/step_parts/Соединительная_гайка_М10.step

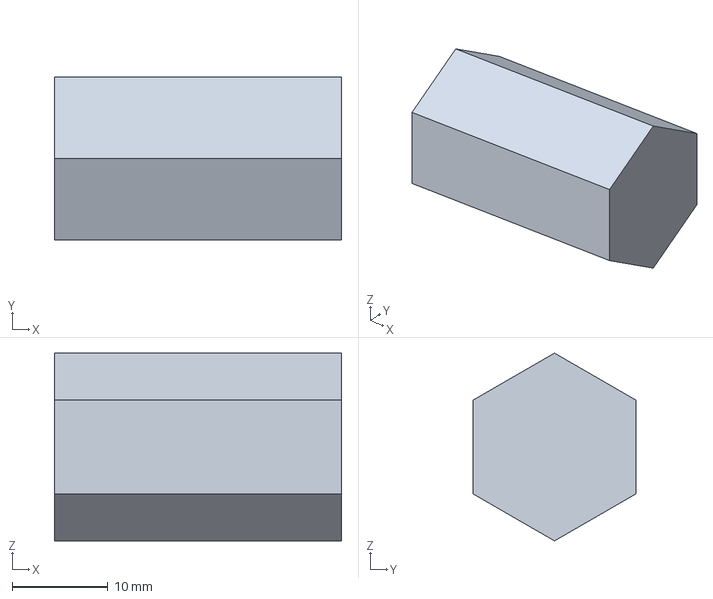
[picture p148: CAD file, 2026-10-29]
stages/model/cad/prev/step_parts/Соединительная_гайка_М10.step
30.0 x 17.0 x 19.6 mm
