inutcin/boomboom/stages/fix11/cad/step/21_plugs.step

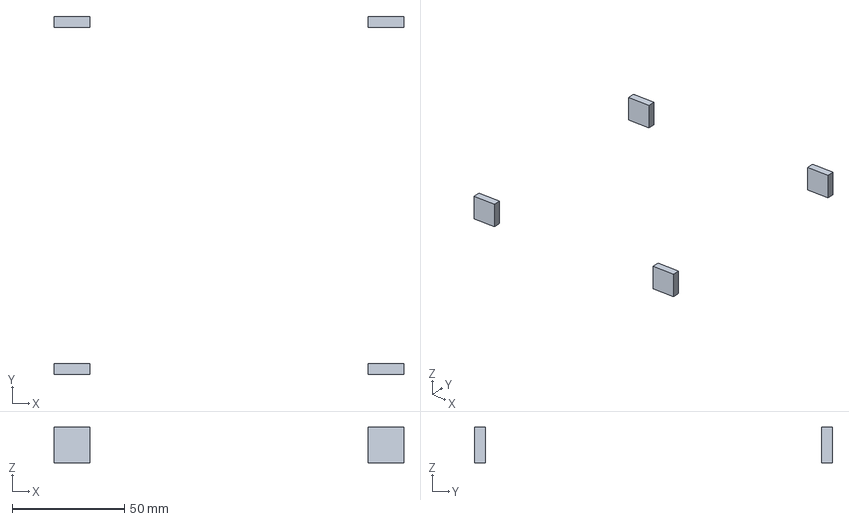
[picture p149: CAD file, 2026-11-05]
stages/fix11/cad/step/21_plugs.step
156.0 x 159.6 x 16.0 mm
