inutcin/boomboom/stages/model/cad/step/08_lmf10uu.step

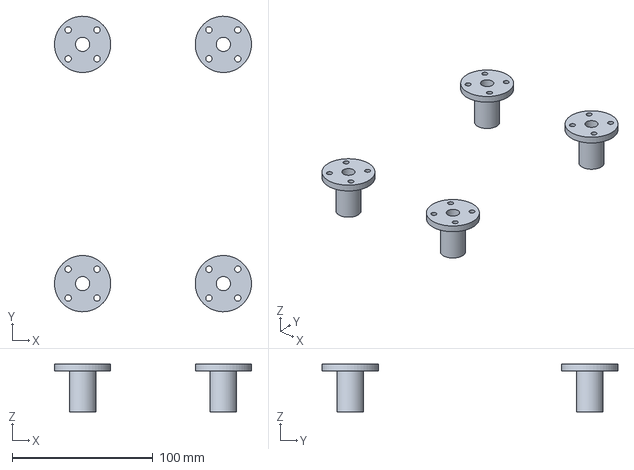
[picture p150: CAD file, 2026-10-29]
stages/model/cad/step/08_lmf10uu.step
140.0 x 210.0 x 34.0 mm
