inutcin/boomboom/stages/fix10l/cad/step/16_bumpers.step

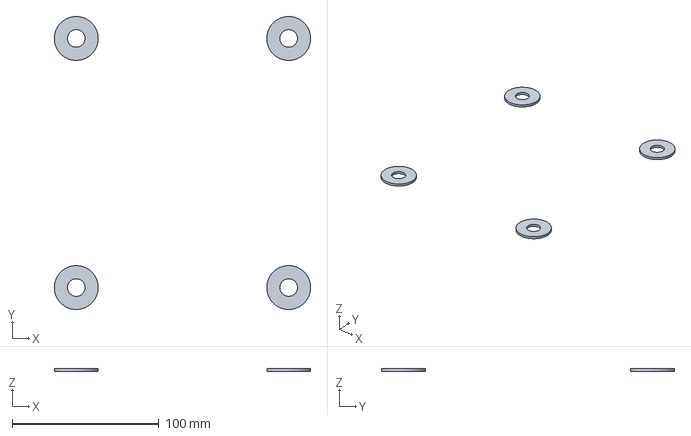
[picture p151: CAD file, 2026-11-02]
stages/fix10l/cad/step/16_bumpers.step
175.0 x 200.0 x 2.00 mm
