inutcin/boomboom/stages/model/cad/prev/step_parts/Дрель_условно,_покупная.step

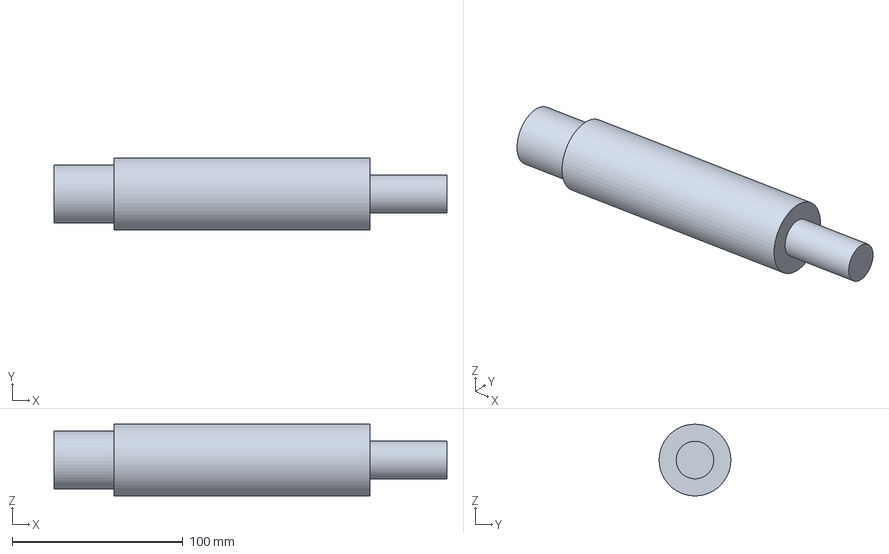
[picture p152: CAD file, 2026-10-29]
stages/model/cad/prev/step_parts/Дрель_условно,_покупная.step
230.0 x 42.0 x 42.0 mm
