inutcin/boomboom/stages/fix1/cad/step/14_crab.step

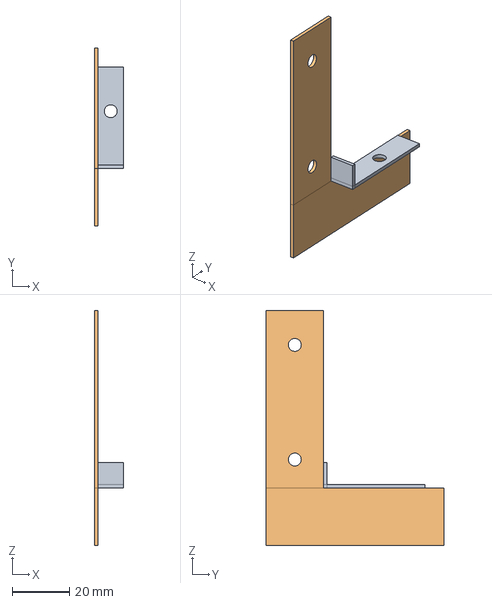
[picture p153: CAD file, 2026-10-29]
stages/fix1/cad/step/14_crab.step
10.2 x 62.0 x 82.0 mm
