inutcin/boomboom/stages/fix11/cad/step/32_rubber_rings.step

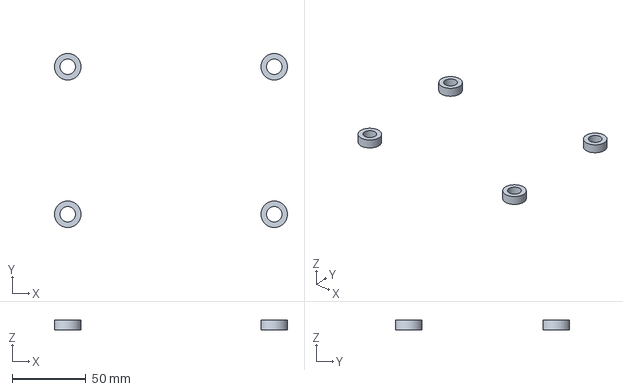
[picture p154: CAD file, 2026-11-05]
stages/fix11/cad/step/32_rubber_rings.step
158.0 x 118.0 x 7.00 mm
