inutcin/boomboom/stages/model/cad/prev/step_parts/Вал_привода_-_шпилька_М10.step

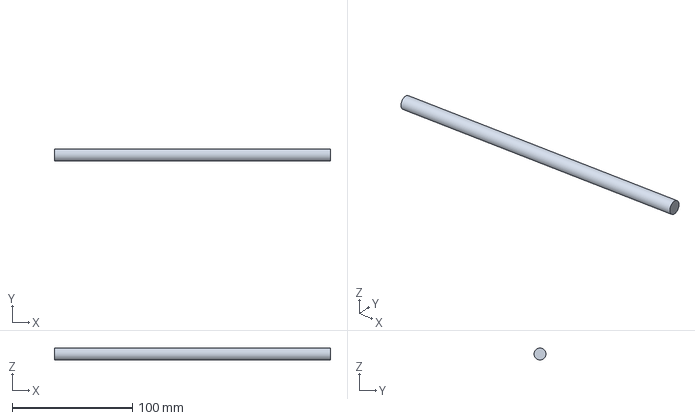
[picture p155: CAD file, 2026-10-29]
stages/model/cad/prev/step_parts/Вал_привода_-_шпилька_М10.step
230.0 x 10.00 x 9.99 mm
