inutcin/boomboom/stages/fix10l/cad/step/24_roller_nuts.step

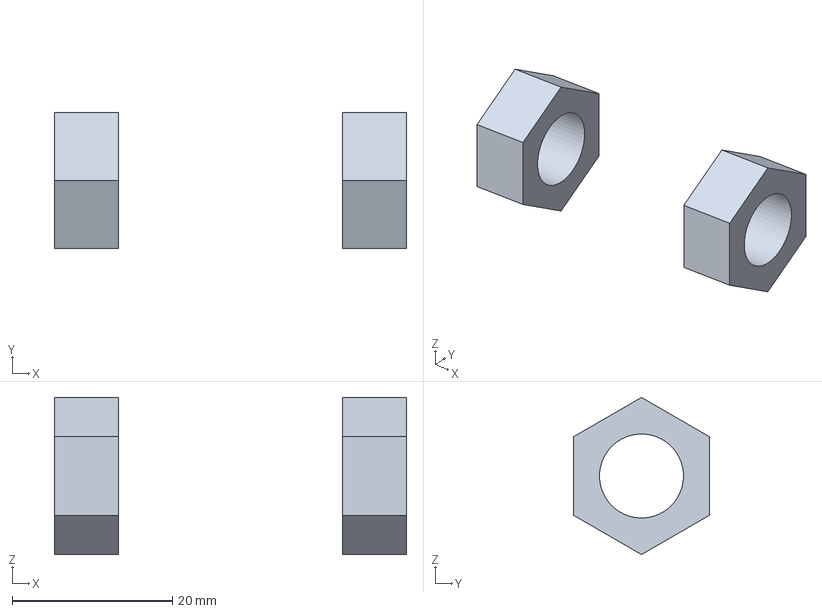
[picture p156: CAD file, 2026-11-02]
stages/fix10l/cad/step/24_roller_nuts.step
44.0 x 17.0 x 19.6 mm
