inutcin/boomboom/stages/fix2/cad/step/24_crab_nuts.step

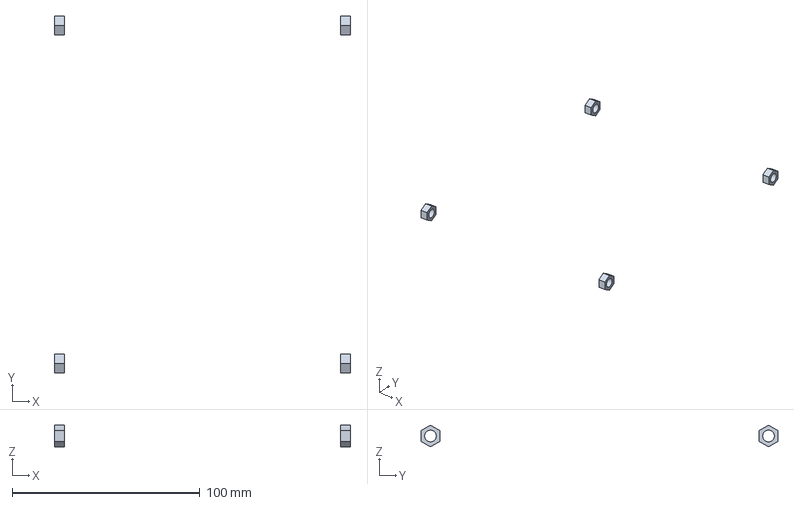
[picture p157: CAD file, 2026-10-29]
stages/fix2/cad/step/24_crab_nuts.step
157.6 x 190.0 x 11.5 mm
