inutcin/boomboom/stages/fix10l/cad/step/27_bracket_right.step

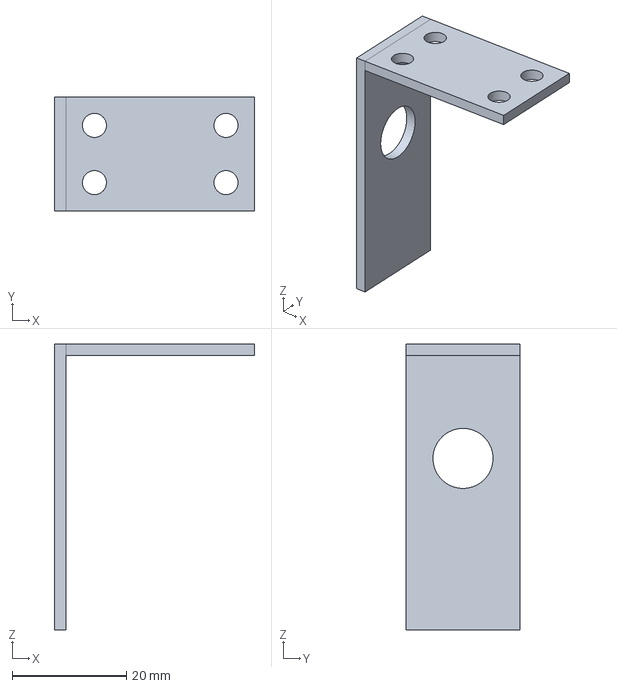
[picture p158: CAD file, 2026-11-02]
stages/fix10l/cad/step/27_bracket_right.step
35.0 x 20.0 x 50.0 mm
