inutcin/boomboom/stages/fix11/cad/step/22_T07.step

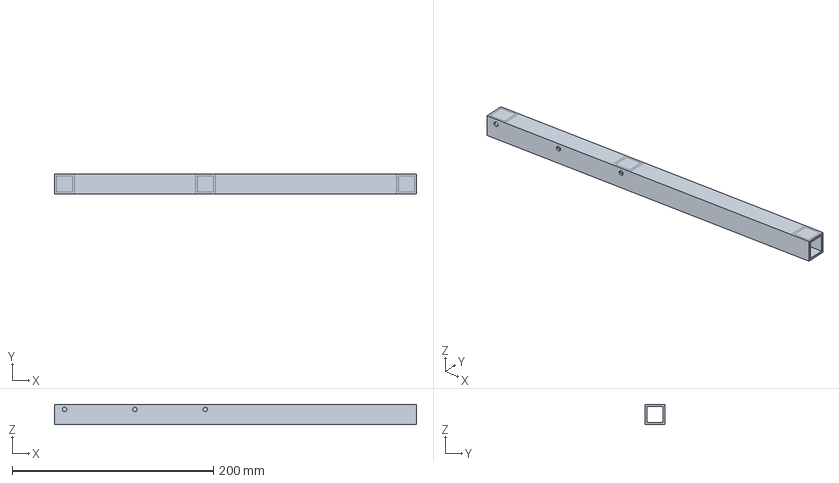
[picture p159: CAD file, 2026-11-05]
stages/fix11/cad/step/22_T07.step
360.0 x 20.0 x 20.0 mm
