inutcin/boomboom/stages/model/cad/prev/step_parts/Прокладка_под_дрель.step

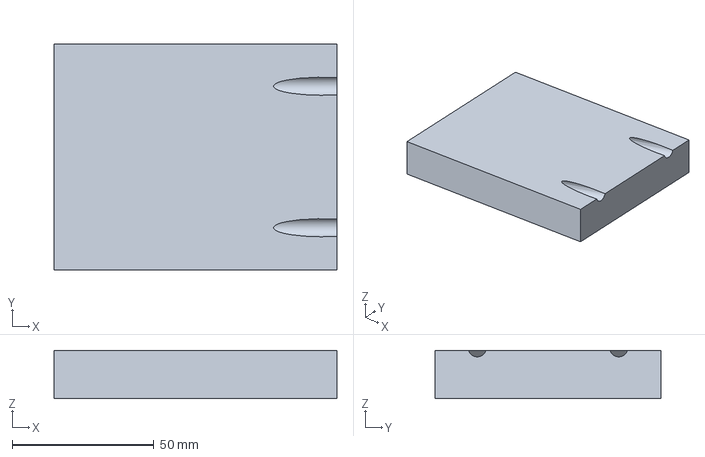
[picture p160: CAD file, 2026-10-29]
stages/model/cad/prev/step_parts/Прокладка_под_дрель.step
100.0 x 80.0 x 17.0 mm
