inutcin/boomboom/stages/fix10l/cad/step/32_drill_pads.step

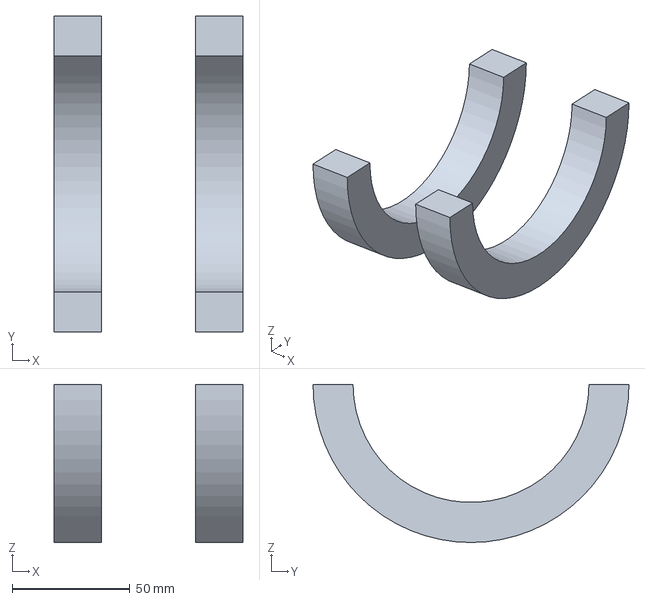
[picture p161: CAD file, 2026-11-02]
stages/fix10l/cad/step/32_drill_pads.step
80.0 x 134.0 x 67.0 mm
