inutcin/boomboom/(list of files, cad)

Other CAD files:
stages/fix6/cad/stl/groups/grp_overlay.stl
stages/fix8/cad/stl/cam_10.stl
stages/fix10l/cad/stl/cam_5.stl
stages/fix10l/cad/stl/groups/grp_overlay.stl
stages/fix2/cad/stl/overlay.stl
stages/fix8/cad/stl/retainer.stl
stages/fix10l/cad/stl/cam_10.stl
stages/fix10l/tachdraw/cad/B01.step
stages/fix6/cad/stl/groups/grp_steel.stl
stages/fix9/cad/stl/groups/grp_shield.stl
stages/fix10l/tachdraw/cad/B04.step
stages/fix11/cad/stl/groups/grp_table.stl
stages/fix11/cad/stl/shield.stl
stages/fix6/cad/stl/groups/grp_shield.stl
stages/model/cad/prev/stl_asm/83_Хомут U-образный М6.stl
stages/fix10l/cad/step/19_cam_10.step
stages/fix4/cad/stl/podstol.stl
stages/model/cad/prev/stl_asm/54_Подшипник вала 6200.stl
stages/fix4/cad/stl/frame.stl
stages/fix9/cad/stl/groups/grp_cam.stl
stages/model/cad/prev/stl_asm/27_Пружина прижимная.stl
stages/fix10l/cad/stl/groups/grp_cam.stl
stages/fix10l/cad/step/07_overlay.step
stages/model/cad/prev/step_parts/Кулачковый_диск_3D_печать.step
stages/model/cad/prev/step_parts/Хвостовик-шпилька_М10.step
stages/model/cad/prev/stl_asm/62_Болт М6×25.stl
stages/model/cad/prev/step_parts/Конусная_гайка_М10.step
stages/model/cad/prev/stl_asm/63_Болт М6×25.stl
stages/fix11/cad/step/22_T09.step
stages/model/cad/prev/step_parts/Болт_потайной_М4x20.step
stages/model/cad/prev/stl_asm/39_Конусная гайка М10.stl
stages/fix11/cad/step/11_podstol.step
stages/model/cad/prev/stl_asm/71_Гайка М10 (кулачок).stl
stages/model/cad/prev/stl_asm/51_Гайка М4.stl
stages/model/cad/prev/step_parts/Вал_D10x120.step
stages/model/cad/prev/stl_asm/40_Контрагайка М10.stl
stages/fix11/cad/step/04_overlay.step
stages/model/cad/prev/step_parts/Подшипник_вала_6200.step
stages/model/cad/prev/stl_asm/55_Подшипник вала 6200.stl
stages/fix11/cad/step/10_cam_5.step
stages/model/cad/prev/stl_asm/47_Гайка М4.stl
stages/model/cad/prev/stl_asm/42_Конусная гайка М10.stl
stages/fix11/cad/step/21_retainer_one.step
stages/model/cad/prev/step_parts/Подшипник-ролик_6200.step
stages/model/cad/prev/stl_asm/26_Пружина прижимная.stl
stages/fix11/cad/step/09_6200_roller.step
stages/model/cad/prev/step_parts/Болт_М6x25.step
stages/model/cad/prev/stl_asm/21_Линейный подшипник LMF10UU.stl
stages/model/cad/prev/stl_asm/06_Вал Ø10×120.stl
stages/fix1/cad/step/01_collar.step
stages/fix1/cad/step/02_shaft.step
stages/fix1/cad/step/03_spring.step
stages/fix1/cad/step/04_overlay.step
stages/fix1/cad/step/05_table.step
stages/fix1/cad/step/06_bracket.step
stages/fix1/cad/step/07_axle.step
stages/fix1/cad/step/08_lmk10uu.step
stages/fix1/cad/step/09_6200.step
stages/fix1/cad/step/09_6200_roller.step
stages/fix1/cad/step/10_cam_10.step
stages/fix1/cad/step/10_cam_3.step
stages/fix1/cad/step/10_cam_5.step
stages/fix1/cad/step/11_podstol.step
stages/fix1/cad/step/12_ubolt.step
stages/fix1/cad/step/20_drive_shaft.step
stages/fix1/cad/step/21_retainer.step
stages/fix1/cad/step/22_frame.step
stages/fix1/cad/step/25_spring_washer.step
stages/fix1/cad/step/vibrotable_assembly.step
stages/fix1/cad/stl/frame.stl
stages/fix1/cad/stl/groups/grp_frame.stl
stages/fix1/cad/stl/groups/grp_retainer.stl
stages/fix1/cad/stl/groups/grp_steel.stl
stages/fix1/cad/stl/groups/grp_table.stl
stages/fix1/cad/stl/podstol.stl
stages/fix1/cad/stl/vibrotable_assembly.stl
stages/fix10l/cad/step/04_shaft_washers.step
stages/fix10l/cad/step/04_washers.step
stages/fix10l/cad/step/05_spring_washers.step
stages/fix10l/cad/step/10_base.step
stages/fix10l/cad/step/11_podstol.step
stages/fix10l/cad/step/12_beams_long.step
stages/fix10l/cad/step/13_beams_trans.step
stages/fix10l/cad/step/15_springs.step
stages/fix10l/cad/step/17_drive_shaft.step
stages/fix10l/cad/step/18_weld_nut.step
stages/fix10l/cad/step/19_cam_3.step
stages/fix10l/cad/step/19_cam_5.step
stages/fix10l/cad/step/20_cam_washers.step
stages/fix10l/cad/step/21_cam_nuts.step
stages/fix10l/cad/step/22_axle.step
stages/fix10l/cad/step/23_roller.step
stages/fix10l/cad/step/25_roller_washers.step
stages/fix10l/cad/step/27_bracket_left.step
stages/fix10l/cad/step/27_brackets.step
stages/fix10l/cad/step/28_bracket_screws.step
stages/fix10l/cad/step/29_pad_screws.step
stages/fix10l/cad/step/29_table_screws.step
stages/fix10l/cad/step/30_ubolts.step
stages/fix10l/cad/step/31_ubolt_hw.step
stages/fix10l/cad/step/33_drill.step
stages/fix10l/cad/step/35_cartridge.step
stages/fix10l/cad/step/35_nyloc_nuts.step
stages/fix10l/cad/step/37_shaft_jams.step
stages/fix10l/cad/step/38_pod_bolt.step
stages/fix10l/cad/step/38_pod_bolt_nut.step
stages/fix10l/cad/step/38_pod_bolt_washer.step
stages/fix10l/cad/stl/vibrotable_assembly.stl
stages/fix11/cad/step/01_collar.step
stages/fix11/cad/step/02_shaft.step
stages/fix11/cad/step/05_table.step
stages/fix11/cad/step/07_axle.step
stages/fix11/cad/step/08_lmk10uu.step
stages/fix11/cad/step/10_cam_3.step
stages/fix11/cad/step/12_ubolt.step
stages/fix11/cad/step/13_bracket_screws.step
stages/fix11/cad/step/13_table_screws.step
stages/fix11/cad/step/14_angle.step
stages/fix11/cad/step/14_angles.step
stages/fix11/cad/step/15_bracket_nuts.step
stages/fix11/cad/step/15_lmk_nuts.step
stages/fix11/cad/step/15_table_nuts.step
stages/fix11/cad/step/16_cam_locknuts.step
stages/fix11/cad/step/16_shaft_locknuts.step
stages/fix11/cad/step/18_podstol_bolts.step
stages/fix11/cad/step/19_ubolt_nuts.step
stages/fix11/cad/step/21_retainer.step
stages/fix11/cad/step/22_T01.step
stages/fix11/cad/step/22_T02.step
stages/fix11/cad/step/22_T03.step
stages/fix11/cad/step/22_T04.step
stages/fix11/cad/step/22_T05.step
stages/fix11/cad/step/22_T08.step
stages/fix11/cad/step/22_T10.step
stages/fix11/cad/step/22_T11.step
stages/fix11/cad/step/22_T12.step
stages/fix11/cad/step/22_T13.step
stages/fix11/cad/step/22_T14.step
stages/fix11/cad/step/22_T15.step
stages/fix11/cad/step/22_T16.step
stages/fix11/cad/step/22_T18.step
stages/fix11/cad/step/22_frame.step
stages/fix11/cad/step/22_plugs.step
stages/fix11/cad/step/23_lmk_screws.step
stages/fix11/cad/step/24_angle_bolts.step
stages/fix11/cad/step/24_angle_nuts.step
stages/fix11/cad/step/24_clamp_bolts.step
stages/fix11/cad/step/25_spring_washer.step
stages/fix11/cad/step/30_shield_screws.step
stages/fix11/cad/step/31_rubber_pads.step
stages/fix11/cad/step/33_cam_washers.step
stages/fix11/cad/step/34_cam_nuts.step
stages/fix11/cad/step/35_cartridge.step
stages/fix11/cad/step/42_clamp_bottom.step
stages/fix11/cad/step/42_clamp_stack.step
stages/fix11/cad/step/43_clamp_press.step
stages/fix11/cad/step/45_clamp_top.step
stages/fix11/cad/step/46_shaft_washers.step
stages/fix11/cad/stl/vibrotable_assembly.stl
stages/fix2/cad/step/01_collar.step
stages/fix2/cad/step/02_shaft.step
stages/fix2/cad/step/03_spring.step
stages/fix2/cad/step/04_overlay.step
stages/fix2/cad/step/05_table.step
stages/fix2/cad/step/06_bracket.step
stages/fix2/cad/step/07_axle.step
stages/fix2/cad/step/08_lmk10uu.step
stages/fix2/cad/step/09_6200.step
stages/fix2/cad/step/09_6200_roller.step
stages/fix2/cad/step/10_cam_10.step
stages/fix2/cad/step/10_cam_3.step
stages/fix2/cad/step/10_cam_5.step
stages/fix2/cad/step/11_podstol.step
stages/fix2/cad/step/12_ubolt.step
stages/fix2/cad/step/16_shaft_locknuts.step
stages/fix2/cad/step/17_shaft_conical_nuts.step
stages/fix2/cad/step/18_podstol_bolts.step
stages/fix2/cad/step/19_ubolt_nuts.step
stages/fix2/cad/step/20_drive_shaft.step
stages/fix2/cad/step/21_retainer.step
stages/fix2/cad/step/22_frame.step
stages/fix2/cad/step/24_crab_bolts.step
stages/fix2/cad/step/24_crab_screws.step
stages/fix2/cad/step/25_spring_washer.step
stages/fix2/cad/step/27_podstol_nuts.step
stages/fix2/cad/step/vibrotable_assembly.step
stages/fix2/cad/stl/cam_10.stl
stages/fix2/cad/stl/cam_3.stl
stages/fix2/cad/stl/cam_5.stl
stages/fix2/cad/stl/frame.stl
stages/fix2/cad/stl/groups/grp_bearing.stl
stages/fix2/cad/stl/groups/grp_frame.stl
stages/fix2/cad/stl/groups/grp_retainer.stl
stages/fix2/cad/stl/groups/grp_steel.stl
stages/fix2/cad/stl/groups/grp_table.stl
stages/fix2/cad/stl/table.stl
stages/fix2/cad/stl/vibrotable_assembly.stl
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
