inutcin/boomboom/.opencode/agents/build.md

---
mode: primary
model: deepseek/deepseek-flash
temperature: 0.1
tools:
  write: true 
  edit: true
  bash: true 
---
