inutcin/boomboom/stages/fix11/Assembly.md

# Инструкция по сборке вибростола fix11

Обозначения: поз. — позиция из [`spec.csv`](./spec.csv); моменты — из
[`torque.csv`](./torque.csv). Размеры — мм. Перед сборкой проверить
комплектность по спецификации и листам [`fig/`](./fig/).

## 0. Инструмент и подготовка

- шестигранники 2,5; 3; 4; 5; 6; 8 мм, ключи 7; 10; 13; 17 мм;
- динамометрический ключ 1…20 Н·м;
- плашка/резьбонарезной инструмент M10 для концов валов;
- фиксатор резьбы (LMK, кожух, подстолье, кулачок, шпильки поджима,
  гайки валов), клей для гаек LMK;
- оправка/кондуктор для отверстий валов, свёрла Ø4,5; Ø10; Ø10,5;
- проверка рамы: габарит 360×200×300 ±1, диагонали ±1, все резы 90°,
  стойки одним куском, верхние балки виброотсека лежат на стойках.

Перед сборкой рама должна быть окрашена/загрунтована. После сварки
выполнить: отверстия Ø10,5 под валы; прорези R15×5; **4 отверстия Ø10
только в верхней грани нижних поперечин T13/T14** (X=10/150,
**Y=60/140**; нижнюю грань не сверлить); резьбу M4 под кожух.
Отверстия под накладки в стойках **не сверлить** — по fix11 их нет.
Направляющие валы: Ø10 h6, L=176; на обоих концах нарезать резьбу
**M10×15**, снять фаску 0,5×45° и заусенцы, поверхность h6 не повреждать.

**Доступ к сверлению T13/T14:** Ø10 в верхней стенке нижних поперечин
сверлить **до сварки средних поперечин** (T17/T18) или укороченным
сверлом с угловой насадкой: сверху мешает средняя поперечина
(Z=150…170). Контроль глубины — 2 мм, нижнюю стенку не пробивать.

Заглушки: 6 шт. 20×20 в открытые торцы рамы, 4 шт. 16×16 в верхние
торцы виброотсека (внутрь, под кожух), 4 шт. 16×16 — в торцы балки 21.

## 1. Сборка стола: линейные подшипники, накладка, кронштейны

1.1. **LMK10UU (поз. 8, 4 шт.).** Уложить стол (поз. 5) верхом вверх.
Снизу вставить в каждый LMK винты M4×12 (поз. 23) с головкой Ø7×4:
головка входит в цековку фланца 4×Ø7,2×4,2. Винт проходит отверстие
фланца Ø4,5, отверстие стола Ø5 и входит в гайку M4 nyloc (поз. 15),
утопленную в шестигранное углубление 7,2 AF×5 сверху стола. Гайку
посадить на клей, утопить заподлицо. Затяжка 1,5 Н·м; фиксатор резьбы.
Проверить: головка не выступает снизу фланца; гайка не выступает над
столом; LMK вращается свободно, без закусывания.

1.2. **Накладка (поз. 4).** Положить накладку на стол, совместить 4
угловых отверстия Ø4,2 с отверстиями стола; ввернуть 4 потайных M4×20
(поз. 13) с гайками M4 nyloc (поз. 15) снизу стола. Затяжка 1,5 Н·м.
Проверить: накладка прилегает, вогнутость сверху, отверстия Ø12 под валы
совпадают с Ø11 стола.

1.3. **Кронштейны ролика (поз. 6, 2 шт.).** Сверху стола в углубление
Ø8×5 вставить винт M4×16 (поз. 39) с головкой Ø7×4; винт проходит
отверстие Ø5 стола и вытянутый паз 10×5 кронштейна; снизу — гайка M4
nyloc (поз. 15). Паз позволяет регулировать кронштейн по X. Затяжка
1,5 Н·м. Проверить: ролик (6200) сидит на оси, ось Ø10,1 в стойках
кронштейна, кронштейн не задевает LMK и накладку.

1.4. **Подстолье (поз. 11)** собирается отдельно — см. шаг 6.

## 2. Монтаж стола на валы

2.1. Вставить 4 направляющих вала (поз. 2, Ø10 h6, **L=176**, резьба
**M10×15** на концах) снизу вверх через отверстия Ø10,5 средних
поперечин рамы (T17/T18). На нижний конец каждого вала надеть гайку
M10 (поз. 45), затем шайбу Ø18/Ø10,5×1,5 (поз. 46) и завести вал снизу
вверх: гайка Z=140,5…148,5, шайба Z=148,5…150. Затяжка 8 Н·м, фиксатор
резьбы. На каждый вал надеть
резиновое кольцо-демпфер (поз. 32, Ø10,5/Ø18×7) до верхней грани
средней поперечины (Z=170…177).

2.2. Надеть собранный стол с LMK на валы: валы проходят через LMK и
отверстия Ø11 стола. Сверху на стол положить шайбу пружины (поз. 25,
Ø18/Ø10,5×1,5), затем пружину (поз. 3, установленная длина 36 мм), затем
вторую шайбу. Пропустить валы через отверстия Ø10,5 верхних поперечин
(T15/T16). На верхний конец каждого вала надеть шайбу Ø18 (поз. 46) и
гайку M10 (поз. 45) над верхней поперечиной (Z=300…309,5); затяжка
8 Н·м, фиксатор резьбы.

2.3. Проверить: вал неподвижен в раме (гайки снизу и сверху), стол
перемещается по валам свободно, пружина стоит между шайбами, длина
пружины 36 мм в верхнем положении. Резьбовые участки 15 мм должны быть
вне LMK: нижний Z=137…152, верхний Z=298…313.

2.4. Проверить ход стола: вниз до касания кулачка/буферов, вверх —
до буферов; пружины не задевают вал (ID 14,0 при вале Ø10), шайбы не
соскальзывают.

## 3. Балка 21, накладки и шпильки поджима

3.1. **Балка 21 (поз. 21, 2 шт.)** — стальная труба 20×20×2, L=159,6.
В верхней стенке — прорезь-седло R15×5; в верхней и нижней гранях —
2 сквозных Ø10 на **Y=60/140**; по X — 4 отверстия Ø4,5 на
Y=30/45/155/170. Вставить в каждую балку 4 распорные втулки
16×16×2, L=16 (поз. 37) в местах отверстий Ø4,5.

3.2. **Накладки (поз. 14, 8 шт.)** — плоские, сталь 2 мм, 50×50,
ширина 25. На каждый конец балки — пара накладок (передняя и задняя
грани). Соединить пару с балкой 2 винтами **M4×35** (поз. 24) с
цилиндрической головкой, гайками M4 nyloc и шайбами Ø9/Ø4,3×1 с двух
сторон. Головки — снаружи, гайки — с внутренней стороны. Затяжка 2,5 Н·м.
**К стойкам накладки не крепить:** лепесток 50 перекрывает стойку на
20 мм и служит упором/направляющей. Отверстия и пазы в стойках не
сверлить.

3.3. **Шпильки (поз. 41, 4 шт.)** — строительные **M10×117**, 4.6.
Вставить шпильку наклонно через отверстие Ø10 прижимной балки в гнездо
Ø10 верхней стенки нижней поперечины T13/T14 (**Y=60/140**,
X=10/150). Низ шпильки — Z=18 (в гнезде), верх — Z=135.

3.4. **Опора шпильки.** На верхнюю грань нижней поперечины (Z=20)
положить шайбу Ø20/Ø10,5×1,5 (поз. 44) и навернуть гайку M10 nyloc
(поз. 42) до упора в шайбу. Шпилька опирается на эту гайку; на дно
балки не опирается. Затяжка 8 Н·м; фиксатор резьбы.

3.5. **Поджим балки.** Снизу прижимной балки (Z=110) поставить шайбу
Ø20/Ø10,5×1,5 (поз. 44) и гайку M10 (поз. 43); навернуть гайку до
касания шайбы с балкой. **Сверху на шпильку ничего не накручивать.**
Затяжка 10 Н·м; фиксатор резьбы.

3.6. Выставить балку: верх Z=130, прорезь R15×5 совпадает с седлом
рамы, зазор до стойки 0,2 мм. Верх шпильки — **Z=135, не более 5 мм**
над балкой; до нижних гаек валов (Z=140,5) — 5,5 мм, по Y они разнесены
на 10 мм. Проверить: балка не качается; накладки упираются в стойки, но
не притянуты; винты не выступают в зону 6200.

3.7. **Нижнее положение (ход 20 мм).** Отдать поджимную гайку 43 на
20 мм (≈13 оборотов); балка опускается до Z=90…110, прорезь уходит
ниже 6200 на 15 мм. Опорная гайка 42 и шпилька остаются на месте.
Верх шпильки по-прежнему Z=135 — ниже нижних гаек валов (140,5).

3.8. **Съём балки.** Отдать и снять поджимную гайку 43 с шайбой;
опустить балку на 20 мм; поднять балку со шпильками на 2 мм, чтобы низ шпилек
вышел из гнёзд (Z=18→20); снять балку вперёд. Затем снять опорную
гайку 42 с шайбой, поднять шпильку на 2 мм и вынуть из гнезда.
Сборка — в обратном порядке; шпильки смазать.

## 4. Сборка картриджа основного вала

4.1. Шпилек вала привода с приваренной гайкой — **3 комплекта**
(поз. 20; 1 установлен, 2 запасных). Материал — **8.8 высокопрочная**,
не строительная. Ось ролика (поз. 7) — также 8.8.

4.2. На шпильку вала надеть 6200 №1 (X=10) и 6200 №2 (X=150). С каждой
стороны каждого 6200 установить конусную гайку (поз. 17) малым торцом к
внутреннему кольцу и контргайку M10 nyloc (поз. 16) снаружи конуса.
Затяжка конуса 5 Н·м, контргайки 8 Н·м.

4.3. Установить кулачок (поз. 10) на приваренную гайку M10 (X=74…82),
совместив шестигранник 17,1. Слева и справа — шайбы Ø40/Ø10,5×2,5
(поз. 33), гайки M10 (поз. 34) и контргайки M10 nyloc (поз. 16).
Затяжка гаек 8 Н·м, контргаек 8 Н·м; фиксатор резьбы.

4.4. Проверить осевой стек: гайка/конус/6200/конус/гайка без зазоров;
кулачок не проворачивается на шестиграннике; осевой люфт 0; биение
кулачка — по возможности ≤0,05 мм. Сменные диски 3/5/10 — на этот же
вал; для смены диска используется запасная шпилька с гайкой.

## 5. Монтаж картриджа при помощи балок

5.1. Опустить балки 21 в нижнее положение на 20 мм (см. 3.7); снять
поджимные гайки 43 с шайбами. Прорезь балки уходит ниже 6200.

5.2. Вставить картридж (поз. 35) сверху/снизу в седла R15×5 средних
поперечин рамы: 6200 №1 — в X=10, 6200 №2 — в X=150. Кулачок — в
X=74…86. Проверить, что ролик (6200 на кронштейне) касается кулачка.

5.3. Поднять балки 21 до Z=130: поставить поджимные шайбы и гайки 43,
затянуть 10 Н·м; верх шпильки ≤5 мм над балкой. Проверить: 6200 зажат
между рамой и балкой, осевой зазор 0,2 мм; балка не касается
кулачка/вала; стол двигается, ролик катится по кулачку.

5.4. Смена кулачка/картриджа: опустить балки на 20 мм, опустить блок на
44 мм и выдвинуть вперёд; сборка — в обратном порядке. Перед пуском
проверить крепление кожуха и отсутствие посторонних предметов.

## 6. Сборка подстолья с U-образными хомутами

6.1. Положить подстолье (поз. 11) на верхние балки выноса (Z=190).
Сверху вставить 4 потайных M6×60 (поз. 18) в зенковки Ø12/90°;
винты проходят отверстия Ø6,6 подстолья и балок и входят в приварные
гайки M6 (поз. 22.7) снизу балок. Затяжка 5 Н·м; фиксатор резьбы.
Выступание винта ниже гайки ~22 мм — допустимо.

6.2. Установить 2 U-образных хомута (поз. 12) в отверстия Ø6,6
подстолья (X=250/300, Y=47/153); сверху — шайбы Ø12 и гайки M6
(поз. 19), по 2 на ножку. Затяжка 5 Н·м.

6.3. Уложить дрель (поз. 28) на резиновую подкладку под подстольем;
хвостовик вала — в патрон; совместить ось вала с осью дрели. Затянуть
U-хомуты. Проверить: дрель не проворачивается, биение вала
минимальное, курок/регулятор доступны, кабель не задевает вращающиеся
части. Направление вращения — против часовой стрелки.

6.4. Проверить сборку: масса без дрели ≈**9,12 кг** (3 шпильки вала:
1 установлена + 2 запасных; запасные в массу сборки не входят); рама
стоит на тяжёлой станине и прижата струбцинами; все болты затянуты по
[`torque.csv`](./torque.csv); заглушки на месте; кожух не касается
стола и пружин.

## 7. Быстрая проверка после сборки

1. Стол перемещается по валам без закусывания; пружины 36 мм.
2. Ролик касается кулачка на всех дисках 3/5/10; зазор/контакт
   проверены.
3. 6200 зажаты, осевой люфт 0; кулачок не проворачивается.
4. Балки 21 опускаются на 20 мм поджимной гайкой; верх шпильки ≤5 мм
   над балкой; нижние гайки валов не задеваются.
5. Накладки упираются в стойки, но не притянуты; шпильки M10 не
   качаются; опорные гайки затянуты.
6. Кожух закреплён 22 винтами; резьба M4 не сорвана.
7. Подстолье и дрель закреплены; U-хомуты затянуты.
8. Все моменты — по [`torque.csv`](./torque.csv); проверки — по
   [`cad/checks.csv`](./cad/checks.csv).

## 8. Ссылки

- эскизы: [`fig/vibrotable_views.svg`](./fig/vibrotable_views.svg),
  [`fig/frame_tubes.svg`](./fig/frame_tubes.svg),
  [`fig/details.svg`](./fig/details.svg),
  [`fig/clamp.svg`](./fig/clamp.svg),
  [`fig/assembly_steps.svg`](./fig/assembly_steps.svg);
- рендеры: [`pic/render_iso.png`](./pic/render_iso.png),
  [`pic/render_frame.png`](./pic/render_frame.png),
  [`pic/render_beam.png`](./pic/render_beam.png),
  [`pic/render_clamp_unit.png`](./pic/render_clamp_unit.png),
  [`pic/render_table_bottom.png`](./pic/render_table_bottom.png),
  [`pic/render_podstol.png`](./pic/render_podstol.png);
- спецификация: [`spec.csv`](./spec.csv), [`tube_cut.csv`](./tube_cut.csv),
  [`shopping.csv`](./shopping.csv);
- проверки: [`cad/checks.csv`](./cad/checks.csv).
