inutcin/boomboom/stages/fix10l/Assembly.md

# Инструкция по сборке вибростола fix10l («орочья» версия)

Обозначения: поз. — [`spec.csv`](./spec.csv); моменты — [`torque.csv`](./torque.csv);
размеры — мм; листы — [`fig/`](./fig/). Перед сборкой проверить комплектность.
Все острые кромки фанеры и труб притупить.

## 0. Инструмент и подготовка

- шестигранники 3; 4; 5; 6; 8 мм, ключи 10; 13; 17 мм;
- дрель/шуруповёрт, сверла Ø3,3; Ø4,2; Ø6; Ø7; Ø10,2; Ø11; коронка/перовое
  Ø22; пила/лобзик;
- динамометрический ключ 1…20 Н·м;
- смазка (графит/литол) для шпилек, фиксатор резьбы;
- кондуктор/струбцины для сверления отверстий Ø11 после раскроя.

Порядок изготовления:

1. Раскроить фанеру: стол 200×200×10; платформа 200×200×10 с вырезом
   120×120; основание 400×200×24; подстолье 200×200×10; 2 полосы
   пружин 200×25×5.
2. Просверлить отверстия по [`fig/details.svg`](./fig/details.svg):
   - стол: 4×Ø11 (X=30/175, Y=15/185), 4×Ø4,2×6 глухих (X=5/195,
     Y=30/170) под саморезы накладки, 8×Ø4,2 снизу под саморезы кронштейнов;
   - платформа: 4×Ø11 + вырез 120×120;
   - основание: 6×Ø11 + 6 цековок Ø22×20 снизу;
   - подстолье: 2×Ø11 (X=385, Y=15/185), 4×Ø7 (X=240/300, Y=30/170).
3. Нарезать трубы 20×20×2: 2×400 (продольные), 2×200 (поперечные).
   Просверлить по [`beam_cut.csv`](./beam_cut.csv):
   продольные — 3×Ø11 (X=30/175/385);
   поперечные — 2×Ø11 (Y=15/185) и Ø10,2 (Y=100, Z=140).
4. Нарезать шпильки M10: 4×300, 2×220; торцы обработать напильником.
5. Подготовить 2 уголка 50×50×2, ширина 20: отверстие Ø10,5 на 20 мм ниже
   полки и 4×Ø4,2 в полке (см. `fig/details.svg`).
6. Накладку и кулачки взять из fix9 без изменений.

## 1. Основание

1.1. Вставить 6 шпилек M10 (4×300 + 2×220) в отверстия основания
400×200×24. Снизу на каждую шпильку — шайба M10, **nyloc** и **обычная
контрагайка** в цековку Ø22×20 (заподлицо). Сверху — шайба M10, гайка и
контрагайка (h=8).
1.2. Сверху затянуть 8 Н·м; проверить: основание стоит плоско, шпильки
вертикальны, X=30/175/385, Y=15/185, диагонали ±1 мм.
1.3. Нанести смазку на верхние 250 мм четырёх передних шпилек.

## 2. Поперечные балки и вал привода

2.1. Надеть на шпильки X=30/175 поперечные балки 20×20×2 (Y=0…200):
передняя X=20…40, задняя X=165…185, Z=130…150. Снизу — шайба, гайка и
контрагайка h=8; сверху — гайка и общая контрагайка h=8 с
продольной балкой. Затянуть 8 Н·м.
2.2. Вставить вал M10 L=226 в отверстия Ø10,2 обеих балок. На каждой
стороне каждой балки — **2 шайбы, гайка и контрагайка**, стянутые между
собой, но не прижимающие балку (зазор 0,5 мм):
- передняя балка, спереди: шайбы 16/18, гайка 7,5…15,5, jam 3,5…7,5;
- передняя балка, сзади: шайбы 40/42, гайка 44,5…52,5, jam 52,5…56,5;
- задняя балка, спереди: шайбы 161/163, гайка 152,5…160,5, jam 148,5…152,5;
- задняя балка, сзади: шайбы 185/187, гайка 189,5…197,5, jam 197,5…201,5.
Вал выходит за каждую балку на **20 мм**; передний торец X=0, задний X=226.
2.3. Кулачок fix9 надеть на приваренную к валу гайку M10 (X=94…102).
Слева — шайба 82…84 и гайка 74…82; справа — шайба 106…108 и гайка
108…116. Затянуть 8 Н·м; кулачок не должен проворачиваться; ролик — точно
под серединой стола (X=100).
2.4. Проверить: вал вращается от руки, стопки не прижимают балки, осевой
люфт минимален; кулачок не задевает балки и кронштейн.

## 3. Продольные балки и подстолье

3.1. Надеть на 4 передние и 2 задние шпильки продольные балки 20×20×2
(Y=15/185) до Z=174…194. Снизу — гайка 166…174 и контрагайка h=8
158…162; сверху — шайба 190…192, гайка 192…200 и контрагайка 200…204.
Затянуть 8 Н·м.
3.2. Задние шпильки X=385: снизу — гайка 162…170 и контрагайка 158…162;
сверху — подстолье, шайба 200…202 и **только nyloc** 202…212 (без
контрагайки).
3.3. Положить подстолье 200×200×10 на продольные балки (X=200…400) и
надеть на задние шпильки; сверху — nyloc; затянуть 8 Н·м.
3.4. Свободную часть подстолья (X=250, Y=15) притянуть болтом **M10×50**:
головка сверху, тело проходит через подстолье и обе стенки продольной
балки; снизу — шайба и **nyloc M10**. Затянуть 4 Н·м.
В ТЗ указана гайка M4 при болте M10 — это несовместимо; принят M10 nyloc
по болту. При необходимости M4 — заменить болт на M4×40 и гайку на M4 nyloc.
3.5. Проверить: подстолье горизонтально, начинается сразу за столом
(X=200), задние шпильки не выступают в зону дрели, болт не мешает дрели.

## 4. Стол, накладка, подкладки, пружины

4.1. Положить накладку fix9 200×150 на стол 200×200 по центру (Y=25…175).
Совместить 4 отверстия; ввернуть 4 самореза M4×12 (тот же тип, что у
кронштейна) в пилотные отверстия 6 мм (X=5/195, Y=30/170); головки — в
зенковку накладки. Затянуть 1,5 Н·м.
4.2. Надеть стол на 4 передние шпильки (X=30/175, отверстия Ø11). Стол
должен свободно ходить по шпилькам, без закусывания.
4.3. На стол положить две полосы 200×25×5 (Y=0…25 и 175…200) и
привернуть их 6 саморезами M4×12 (X=60/100/140, Y=12.5/187.5), 1,5 Н·м.
Полосы должны прилегать к краям накладки, не заходить под неё.
4.4. На шпильки — шайбы Ø20×2 (240…242), пружины Ø17×1,5×60 (242…278),
шайбы Ø20×2 (278…280).
4.5. Надеть верхнюю платформу 200×200×10 (вырез 120×120) на 4 шпильки;
сверху — шайбы M10 и **nyloc** (292…300). Затянуть 4 Н·м; пружины должны
быть 36 мм (проверить штангенциркулем).
4.6. Проверить: платформа не касается пружин/гаек; шайбы Ø20×2 касаются
кромки накладки (расчётное касание); стол перемещается вниз на 3/5/10 мм.

## 5. Кронштейн ролика

5.1. Снизу стола поставить два уголка 50×50×2 так, чтобы вертикальные
стойки были на X=88…90 и 110…112, полки — к столу. Привернуть каждый
уголок 4 саморезами M4×12 (X=53/78 и 117/140, Y=95/105), 1,5 Н·м.
5.2. Вставить ось M10 L=44 в отверстия Ø10,5 стоек. Между стойками:
шайба, шайба, тонкое кольцо, подшипник 6200, тонкое кольцо, шайба, шайба;
снаружи — шайбы и **nyloc** гайки. Затянуть 4 Н·м: внутреннее кольцо 6200
зажато, наружное вращается свободно.
5.3. Проверить: ролик входит в ложбинку кулачка; стойки выступают ниже
верха кулачка на 10…15 мм; ролик не задевает стол и накладку.

## 6. Дрель и U-болты

6.1. Положить на подстолье 2 резиновых полукольца Ø100/134 (X=240/300)
и вставить U-болты M6 R70 ногами в отверстия Ø7 (Y=30/170).
6.2. Подвесить дрель под подстолье так, чтобы патрон смотрел на вал:
патрон X=206…226, корпус X=226…351, рукоятка до X=381. Задние шпильки
X=385 — зазор 4 мм. U-болты затянуть 5 Н·м.
6.3. Вставить вал в патрон; совместить ось. Проверить: дрель не
проворачивается, биение минимально, курок и регулятор доступны.
6.4. При необходимости добавить резиновые подкладки под кожух дрели.

## 7. Быстрая проверка

1. Стол ходит по шпилькам без закусывания; пружины 36 мм.
2. Ролик касается кулачка на дисках 3/5/10; при ходе 10 мм зазор до
нижнего демпфера ≈1 мм.
3. Вал вращается в двух опорах; кулачок не проворачивается.
4. Подстолье и дрель закреплены; U-болты затянуты.
5. Все моменты — по [`torque.csv`](./torque.csv); проверки — по
   [`cad/checks.csv`](./cad/checks.csv).
6. Шпильки смазаны; ограждение (C1) установить отдельно; не работать без
   закрепления основания на тяжёлой станине.

## 8. Ссылки

- эскизы: [`fig/vibrotable_views.svg`](./fig/vibrotable_views.svg),
  [`fig/mechanism.svg`](./fig/mechanism.svg),
  [`fig/details.svg`](./fig/details.svg),
  [`fig/beams.svg`](./fig/beams.svg),
  [`fig/assembly_steps.svg`](./fig/assembly_steps.svg),
  [`fig/spec.svg`](./fig/spec.svg);
- рендеры: [`pic/render_iso.png`](./pic/render_iso.png),
  [`pic/render_front.png`](./pic/render_front.png),
  [`pic/render_left.png`](./pic/render_left.png),
  [`pic/render_top.png`](./pic/render_top.png),
  [`pic/render_mechanism.png`](./pic/render_mechanism.png),
  [`pic/render_cam.png`](./pic/render_cam.png);
- спецификация: [`spec.csv`](./spec.csv), [`beam_cut.csv`](./beam_cut.csv);
- 3D: `cad/step/vibrotable_assembly.step`,
  `cad/stl/vibrotable_assembly.stl`.
