inutcin/boomboom/stages/fix9/Assembly.md

# Инструкция по сборке вибростола fix9

Обозначения: поз. — позиция из [`spec.csv`](./spec.csv); моменты — из
[`torque.csv`](./torque.csv). Размеры — мм. Перед сборкой проверить
комплектность по спецификации и листам [`fig/`](./fig/).

## 0. Инструмент и подготовка

- шестигранники 2,5; 3; 4; 5; 6; 8 мм, ключи 7; 10; 13; 17 мм;
- динамометрический ключ 1…20 Н·м;
- фиксатор резьбы (LMK, кожух, подстолье, кулачок), клей для гаек LMK;
- оправка/кондуктор для отверстий валов и фрезеровки седел;
- проверка рамы: габарит 360×200×300 ±1, диагонали ±1, все резы 90°,
  стойки одним куском, верхние балки виброотсека лежат на стойках.

Перед сборкой рама должна быть окрашена/загрунтована, отверстия Ø10,5 под
валы, прорези R15×5, отверстия Ø6,6 и резьба M4 — выполнены после сварки.
Заглушки: 6 шт. 20×20 в открытые торцы рамы, 4 шт. 16×16 в верхние
торцы виброотсека (внутрь, под кожух), 4 шт. 16×16 — в торцы балки 21.

## 1. Сборка стола: линейные подшипники, накладка, кронштейны

1.1. **LMK10UU (поз. 8, 4 шт.).** Уложить стол (поз. 5) верхом вверх.
Снизу вставить в каждый LMK винты M4×12 (поз. 23) с головкой Ø7×4:
головка входит в цековку фланца 4×Ø7,2×4,2. Винт проходит отверстие
фланца Ø4,5, отверстие стола Ø5 и входит в гайку M4 nyloc (поз. 15),
утопленную в шестигранное углубление 7,2 AF×5 сверху стола. Гайку
посадить на клей, утопить заподлицо. Затяжка 1,5 Н·м; фиксатор резьбы.
Проверить: головка не выступает снизу фланца; гайка не выступает над
столом; LMK вращается свободно, без закусывания.

1.2. **Накладка (поз. 4).** Положить накладку на стол, совместить 4
угловых отверстия Ø4,2 с отверстиями стола; ввернуть 4 потайных M4×20
(поз. 13) с гайками M4 nyloc (поз. 15) снизу стола. Затяжка 1,5 Н·м.
Проверить: накладка прилегает, вогнутость сверху, отверстия Ø12 под валы
совпадают с Ø11 стола.

1.3. **Кронштейны ролика (поз. 6, 2 шт.).** Сверху стола в углубление
Ø8×5 вставить винт M4×16 (поз. 39) с головкой Ø7×4; винт проходит
отверстие Ø5 стола и вытянутый паз 10×5 кронштейна; снизу — гайка M4
nyloc (поз. 15). Паз позволяет регулировать кронштейн по X. Затяжка
1,5 Н·м. Проверить: ролик (6200) сидит на оси, ось Ø10,1 в стойках
кронштейна, кронштейн не задевает LMK и накладку.

1.4. **Подстолье (поз. 11)** собирается отдельно — см. шаг 6.

## 2. Монтаж стола на валы

2.1. Вставить 4 направляющих вала (поз. 2, Ø10×166) снизу вверх через
отверстия Ø10,5 средних поперечин рамы (T17/T18). На каждый вал надеть
резиновое кольцо-демпфер (поз. 32, Ø10,5/Ø18×7) до верхней грани средней
поперечины (Z=170…177).

2.2. Надеть собранный стол с LMK на валы: валы проходят через LMK и
отверстия Ø11 стола. Сверху на стол положить шайбу пружины (поз. 25,
Ø18/Ø10,5×1,5), затем пружину (поз. 3, установленная длина 36 мм), затем
вторую шайбу. Пропустить валы через отверстия Ø10,5 верхних поперечин
(T15/T16).

2.3. Установить ограничители WCS10FR (поз. 1): нижний — под средней
поперечиной (Z=142…150), верхний — над верхней поперечиной
(Z=300…308). Затяжка 4 Н·м. Проверить: вал неподвижен в раме, стол
перемещается по валам свободно, пружина стоит между шайбами, длина
пружины 36 мм в верхнем положении.

2.4. Проверить ход стола: вниз до касания кулачка/ограничителей, вверх —
до буферов; пружины не задевают вал (ID 14,0 при вале Ø10), шайбы не
соскальзывают.

## 3. Сборка прижимных балок и плоских уголков

3.1. **Балка 21 (поз. 21, 2 шт.)** — стальная труба 20×20×2, L=159,6, с
прорезью-седлом R15×5 в верхней стенке и 4 отверстиями Ø6,6. Вставить в
каждую балку 4 распорные втулки 16×16×2, L=16 (поз. 37) в местах
отверстий; втулки должны совпасть с отверстиями.

3.2. **Уголки (поз. 14, 8 шт.)** — плоские, 80×80, ширина 25, толщина
2 мм; без выреза под стойку. На каждый конец балки — пара уголков
(передняя и задняя грани балки/стойки). Соединить пару с балкой 2 болтами M6×40 (поз. 24) с
шестигранной головкой, гайками M6 nyloc и шайбами Ø18/Ø6,4×1,6
с двух сторон. Головки —
снаружи, гайки — с внутренней стороны. Затяжка 6 Н·м.

3.3. Собранную балку с уголками установить на стойки: пазы 26,6×6,6 с концами R3
уголков надеваются на отверстия стоек Ø6,6 (Y=10/190, Z=59/94), по
2 болта M6×40 на пару, гайки nyloc с шайбами Ø18/Ø6,4×1,6. Пазы должны быть на
средней оси стойки; наружная кромка уголка — вровень с рамой (Y=0/200),
внутрь +5 мм; верхний паз проходит и через горизонтальную полку над
стойкой (болты балки Y=30/60 — вне паза). Затяжка 6 Н·м.

3.4. Выставить балку: верх балки Z=130, прорезь R15×5 совпадает с
седлом рамы; зазор до стойки 0,2 мм. Проверить: балка не качается,
пазы имеют запас 20 мм вниз, болты не выступают в зону 6200.

## 4. Сборка картриджа основного вала

4.1. На шпильку вала (поз. 20) надеть 6200 №1 (X=10) и 6200 №2
(X=150). С каждой стороны каждого 6200 установить конусную гайку
(поз. 17) малым торцом к внутреннему кольцу и контргайку M10 nyloc
(поз. 16) снаружи конуса. Затяжка конуса 5 Н·м, контргайки 8 Н·м.

4.2. Установить кулачок (поз. 10) на приваренную гайку M10 (X=74…82),
совместив шестигранник 17,1. Слева и справа — шайбы Ø40/Ø10,5×2,5
(поз. 33), гайки M10 (поз. 34) и контргайки M10 nyloc (поз. 16).
Затяжка гаек 8 Н·м, контргаек 8 Н·м; фиксатор резьбы.

4.3. Проверить осевой стек: гайка/конус/6200/конус/гайка без зазоров;
кулачок не проворачивается на шестиграннике; осевой люфт 0; биение
кулачка — по возможности ≤0,05 мм. Сменные диски 3/5/10 — на этот же
вал.

## 5. Монтаж картриджа при помощи балок

5.1. Ослабить болты уголков и опустить балки 21 на 20 мм (пазы 26,6 мм
позволяют). Прорезь балки уходит ниже 6200.

5.2. Вставить картридж (поз. 35) сверху/снизу в седла R15×5 средних
поперечин рамы: 6200 №1 — в X=10, 6200 №2 — в X=150. Кулачок — в
X=74…86. Проверить, что ролик (6200 на кронштейне) касается кулачка.

5.3. Поднять балки 21 до Z=130, завести прорези R15×5 под 6200 и
затянуть болты уголков 6 Н·м. Проверить: 6200 зажат между рамой и
балкой, осевой зазор 0,2 мм; балка не касается кулачка/вала; стол
двигается, ролик катится по кулачку.

5.4. Смена кулачка/картриджа: ослабить уголки, опустить балки на 20 мм,
опустить картридж на 44 мм и выдвинуть вперёд; сборка — в обратном
порядке. Перед пуском проверить крепление кожуха и отсутствие
посторонних предметов.

## 6. Сборка подстолья с U-образными хомутами

6.1. Положить подстолье (поз. 11) на верхние балки выноса (Z=190).
Сверху вставить 4 потайных M6×60 (поз. 18) в зенковки Ø12/90°;
винты проходят отверстия Ø6,6 подстолья и балок и входят в приварные
гайки M6 (поз. 22.7) снизу балок. Затяжка 5 Н·м; фиксатор резьбы.
Выступание винта ниже гайки ~22 мм — допустимо.

6.2. Установить 2 U-образных хомута (поз. 12) в отверстия Ø6,6
подстолья (X=250/300, Y=47/153); сверху — шайбы Ø12 и гайки M6
(поз. 19), по 2 на ножку. Затяжка 5 Н·м.

6.3. Уложить дрель (поз. 28) на резиновую подкладку под подстольем;
хвостовик вала — в патрон; совместить ось вала с осью дрели. Затянуть
U-хомуты. Проверить: дрель не проворачивается, биение вала
минимальное, курок/регулятор доступны, кабель не задевает вращающиеся
части. Направление вращения — против часовой стрелки.

6.4. Проверить сборку: масса без дрели ≈9,3 кг; рама стоит на тяжёлой
станине и прижата струбцинами; все болты затянуты по
[`torque.csv`](./torque.csv); заглушки на месте; кожух не касается
стола и пружин.

## 7. Быстрая проверка после сборки

1. Стол перемещается по валам без закусывания; пружины 36 мм.
2. Ролик касается кулачка на всех дисках 3/5/10; зазор/контакт
   проверены.
3. 6200 зажаты, осевой люфт 0; кулачок не проворачивается.
4. Балки 21 опускаются на 20 мм; картридж снимается/ставится.
5. Кожух закреплён 22 винтами; резьба M4 не сорвана.
6. Подстолье и дрель закреплены; U-хомуты затянуты.
7. Все моменты — по [`torque.csv`](./torque.csv); проверки — по
   [`cad/checks.csv`](./cad/checks.csv).

## 8. Ссылки

- эскизы: [`fig/vibrotable_views.svg`](./fig/vibrotable_views.svg),
  [`fig/frame_tubes.svg`](./fig/frame_tubes.svg),
  [`fig/details.svg`](./fig/details.svg),
  [`fig/assembly_steps.svg`](./fig/assembly_steps.svg);
- рендеры: [`pic/render_iso.png`](./pic/render_iso.png),
  [`pic/render_frame.png`](./pic/render_frame.png),
  [`pic/render_beam.png`](./pic/render_beam.png),
  [`pic/render_table_bottom.png`](./pic/render_table_bottom.png),
  [`pic/render_podstol.png`](./pic/render_podstol.png);
- спецификация: [`spec.csv`](./spec.csv), [`tube_cut.csv`](./tube_cut.csv);
- проверки: [`cad/checks.csv`](./cad/checks.csv).
