inutcin/boomboom/stages/fix11/cad/print.csv

Деталь | Материал | Слой, мм | Периметры | Заполнение | Поддержки | Ориентация | Габарит | Масса по модели, г
Стол (5) | PLA | 0,20 | 5 | 30% | нет | плашмя, верх вверх | 200×150×10 | 359.3
Накладка (4) | PLA | 0,12 | 5 | 30% | нет | плашмя, вогнутость вверх | 200×150×6 | 200.2
Подстолье (11) | PETG | 0,20 | 4 | 40% | нет | плашмя | 160×200×12 | 483.0
cam_3 (10) | PLA | 0,12 | 6 | 100% | нет | плашмя, бортик вверх | ≈104×104×22 | 110.3
cam_5 (10) | PLA | 0,12 | 6 | 100% | нет | плашмя, бортик вверх | ≈104×104×22 | 105.9
cam_10 (10) | PLA | 0,12 | 6 | 100% | нет | плашмя, бортик вверх | ≈104×104×22 | 95.4
