inutcin/boomboom/stages/fix10l/cad/print.csv

Деталь | Материал | Слой, мм | Периметры | Заполнение | Поддержки | Ориентация | Габарит | Масса по модели, г
Накладка (7) | PLA | — | — | — | — | переиспользование fix9 | 200×150×6 | 200.2
cam_3 (19) | PLA | — | — | — | — | переиспользование fix9 | ≈104×104×22 | 110.3
cam_5 (19) | PLA | — | — | — | — | переиспользование fix9 | ≈104×104×22 | 105.9
cam_10 (19) | PLA | — | — | — | — | переиспользование fix9 | ≈104×104×22 | 95.4
Новых печатных деталей | — | — | — | — | — | нет | — | 0,0
