inutcin/boomboom/stages/fix4/cad/print.csv

Деталь | Материал | Слой, мм | Периметры | Заполнение | Поддержки | Ориентация | Габарит | Масса по модели, г
Рама (22) | PETG | 0,20 | 4 | 100% | да | вертикально, Z вверх | 360×200×300 | 1880.9
Стол (5) | PLA | 0,20 | 5 | 30% | нет | плашмя, верх вверх | 200×150×10 | 362.7
Накладка (4) | PLA | 0,12 | 5 | 30% | нет | плашмя, вогнутость вверх | 200×150×6 | 200.2
Подстолье (11) | PETG | 0,20 | 4 | 40% | нет | плашмя | 160×200×12 | 483.8
Балка 21 (21) | PETG | 0,12 | 4 | 100% | нет | плашмя, седло вверх | 20×160×20 | 78.5
cam_3 (10) | PLA | 0,12 | 6 | 100% | нет | плашмя, бортик вверх | ≈104×104×12 | 102.6
cam_5 (10) | PLA | 0,12 | 6 | 100% | нет | плашмя, бортик вверх | ≈104×104×12 | 98.2
cam_10 (10) | PLA | 0,12 | 6 | 100% | нет | плашмя, бортик вверх | ≈104×104×12 | 87.7
Кожух (29) | поликарбонат | — | — | — | нет | раскрой листа 5 мм | 2×(160×300) + бортики | 868.4
