inutcin/boomboom/stages/fix1/cad/print.csv

Деталь | Материал | Слой, мм | Периметры | Заполнение | Поддержки | Ориентация | Габарит | Масса по модели, г
Рама (22) | PETG | 0,20 | 4 | 100% | да | вертикально, Z вверх | 400×200×300 | 2169.5
Стол (5) | PLA | 0,20 | 5 | 30% | нет | плашмя, верх вверх | 240×150×10 | 437.5
Накладка (4) | PLA | 0,12 | 5 | 30% | нет | плашмя, вогнутость вверх | 240×150×6 | 245.6
Подстолье (11) | PETG | 0,20 | 4 | 40% | нет | плашмя, рёбра вниз | 200×160×22 | 516.3
Балка 21 (21) | PETG | 0,12 | 4 | 100% | нет | плашмя, седло вверх | 20×158×20 | 77.7
cam_3 (10) | PLA | 0,12 | 6 | 50% | нет | плашмя | ≈100×100×12 | 101.7
cam_5 (10) | PLA | 0,12 | 6 | 50% | нет | плашмя | ≈100×100×12 | 106.1
cam_10 (10) | PLA | 0,12 | 6 | 50% | нет | плашмя | ≈100×100×12 | 117.6
