inutcin/boomboom/stages/expert2/pic/operating_map_preview.png

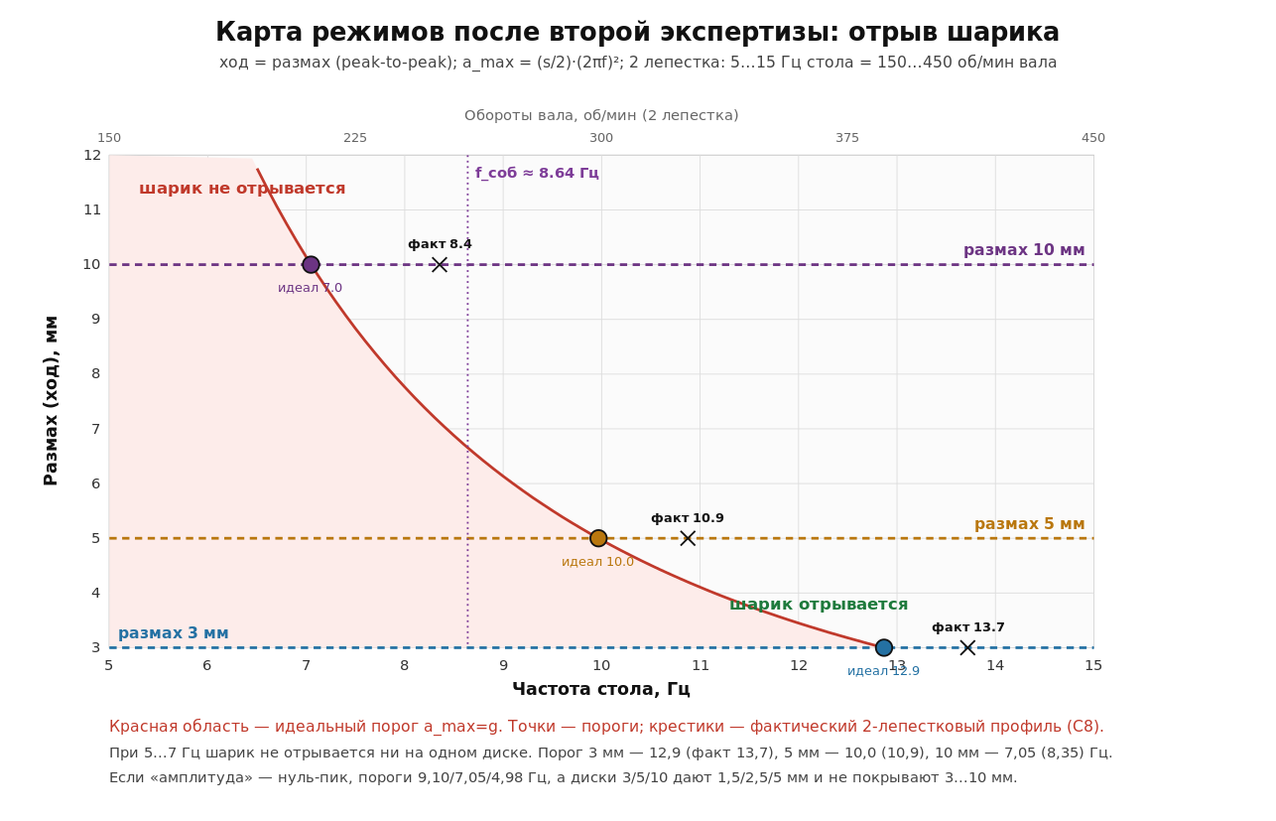
stages/expert2/pic/operating_map_preview.png
