inutcin/boomboom/stages/fix10l/pic/assembly_steps.png

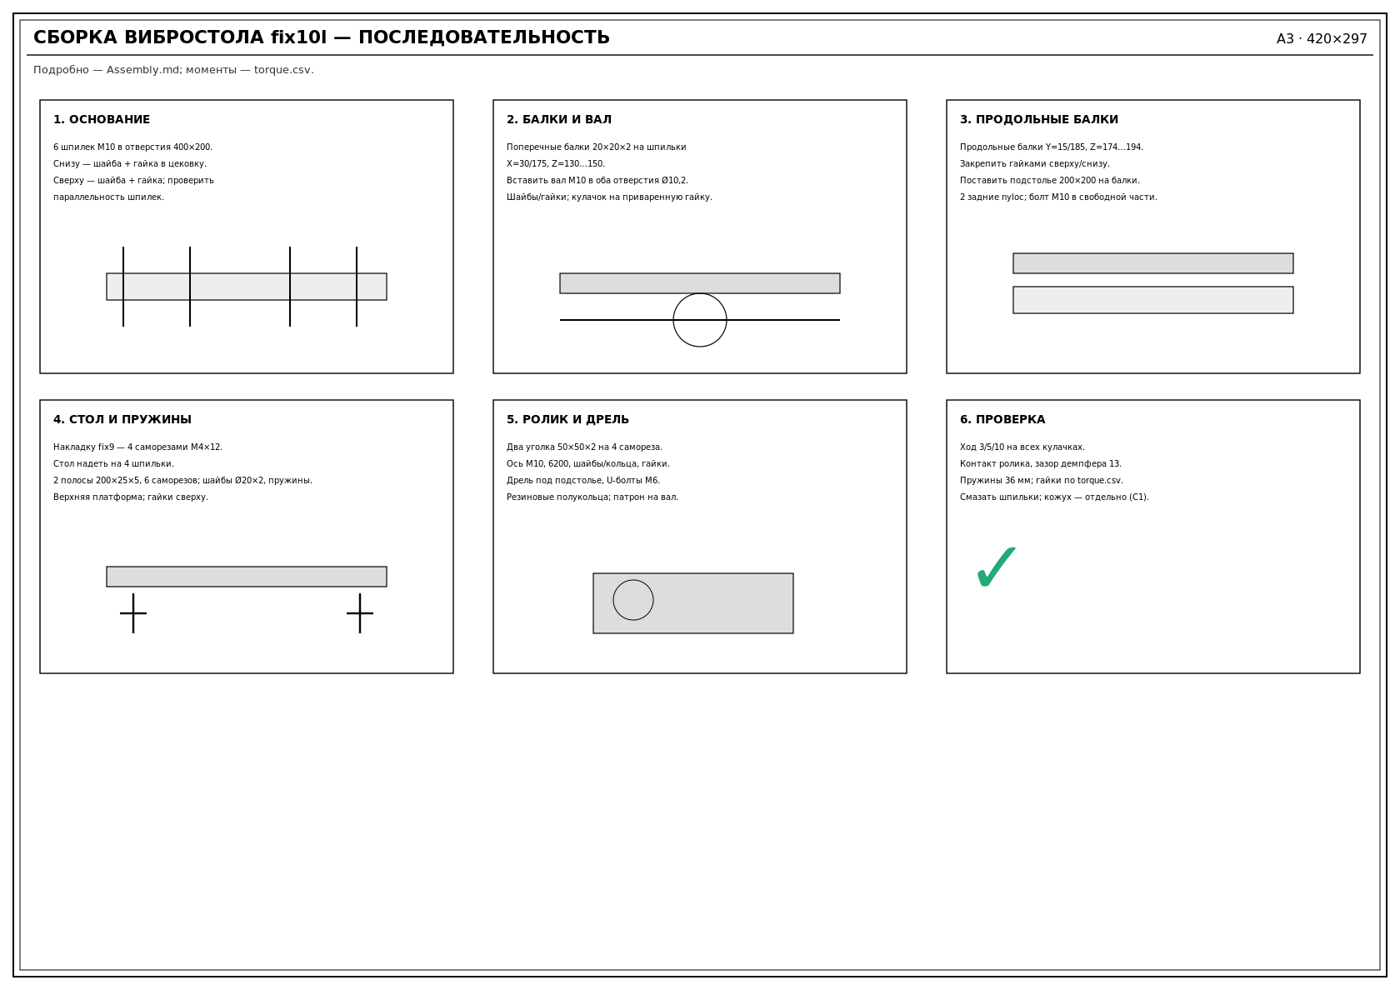
stages/fix10l/pic/assembly_steps.png
