inutcin/boomboom/stages/fix11/pic/assembly_steps.png

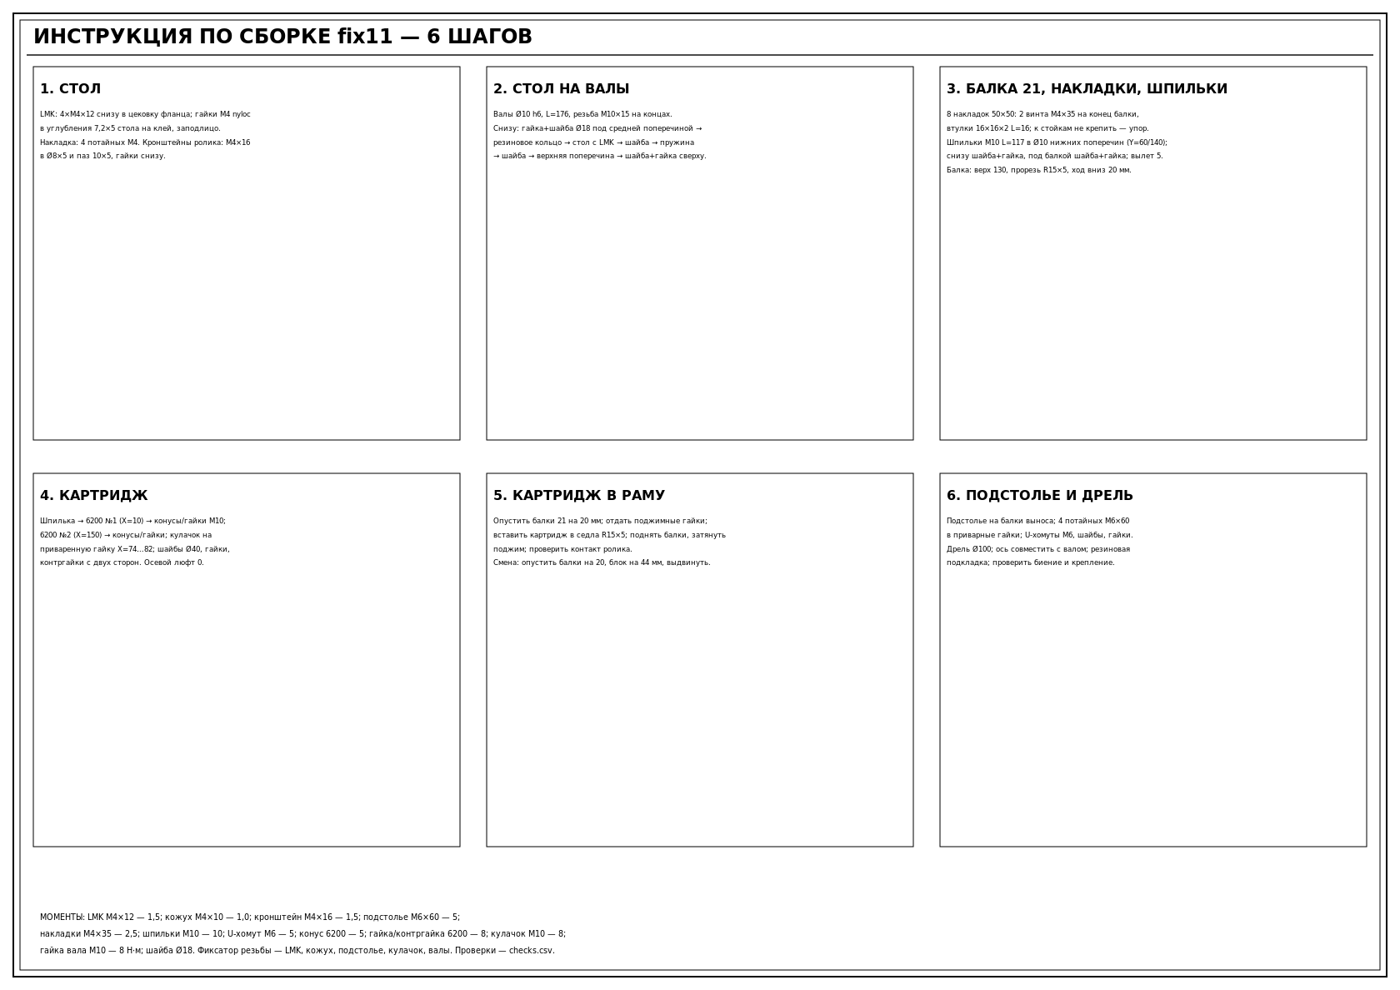
stages/fix11/pic/assembly_steps.png
