inutcin/boomboom/stages/fix11/README.md

# Третья корректировка после третьей инженерной экспертизы

Продолжаем совершенствовать имперскую модель fix9. Цель - устранить недостаток
из за которого прижимная балка держится только на трении

С учётом замечаний ниже сделать:

- 3D-модель в установленном формате;
- эскиз в трёх проекциях (вид сбоку, вид слева, вид сверху);
- трёхмерное изображение конструкции;
- подготовь комплект эскизов с размерами всех деталей, требующих доработки или
  изготовления.
- лист с деталировкой отрезов труб и схемой сварки рамы.
- спецификацию деталей, включая отреды труб
- инструкцию по сборке
    + сборка стола - крепление линейных подшипников, подстолья
    + монтаж стола на валы - продевание валов через среднюю поперечину, демпфер,
    собранный стол, шайбу, пружину, шайбу, верхнюю поперечину и крепление
    гайками M10 с шайбами Ø18.
    + сборку прижимных балок и накладок-уголков на крепеж
    + сборку картриджа основного вала с подшипниками и кулачковым диском
    + монтаж картриджа при поможи балок
    + сборку подстолья с U-образными хомутами
- сформироваться список покупок сгрупировав необходимые детали по номенклатуре.

# Замечания

1. В накладках-уголках не фрезеровать протолговатые отверстия, по которым балка
фиксатор подшипников скольжит вниз и не сверлить в раме отверстия под
фиксирующие в нужном положении болты

2. У уголков забирвется функция удерживания балки фиксации подшипника от падения 
вниз и остаётся функция удерживать балку от вываливания вперёд и назад. 
От вываливания балки влево-вправо удерживают стойки рамы.

3. В верхнем грани нижней балки рамы по на расстоянии 30мм от осевой линии (на
расстоянии 60мм друг от друга) просверлить 2 отверстия 10мм диаметром. Нижнюю
грань не сверлить

4. В прижимной балке вертикально над этими отверстиями просверлить сквозные
отверстия 10мм через верхнюю и нижнюю грани балки. 

5. В получившиеся отверстия в нижней балке вставить строительную шпильку M10, 
и пропустить её через поджимную балку. Длина шпилей толжна быть такой, чтобы она
могла извлекаться из отверстия в нижней балки, по полностью проходить через
прижимную балку в е верхнем положении.

6. Между нижней балкой и прижимной балкой поместить шайбы и гайки, чтобы
затягиванием и ослаблением верхних гаем можно было бы опускать прижимную балку
вниз. 

7. Накладки-уголки более не несут силовой функции, поэтому их лепестки укоротить
до 50мм, а к верхней балке крепить болтами с самоконтрящейся гайкой М4, а не М6.
Фиксировать накладки-уголки к стойкам не надо вовсе.

8. Шпильку, используемую под основной вал привода и ось ролика промаркировать в
спецификации как высокопрочную

9. Шпилек основного вала с наваренной гайкой изготовить 3 комплекта под картриджи с
разными валами привода.

10. Шпильки, используемые для поджима балки фиксации подшипника промаркировать в
спецификации как строительную

# Результаты этапа

- Отчёт: [Report.md](./Report.md)
- Вопросы и решения: [Interview.md](./Interview.md)
- Инструкция по сборке: [Assembly.md](./Assembly.md)
- 3D-модель: `cad/step/vibrotable_assembly.step`; отрезки рамы —
  `cad/step/22_T01…T18.step`; шпильки/опора/поджим —
  `41_clamp_studs.step`, `42_clamp_bottom.step`, `43_clamp_press.step`;
  блок — `35_cartridge.step`
- Исходники: `cad/model.py`, `params.py`, `build.py`, `draw_sheet.py`,
  `export_groups.py`, `render_views.py`
- Печатные детали: `cad/stl/table.stl`, `overlay.stl`, `podstol.stl`,
  `cam_3/5/10.stl`; параметры — `cad/print.csv`
- Эскизы: `fig/vibrotable_views.svg` (3 проекции), `fig/frame_tubes.svg`
  (отрезки труб + сварка; размеры 300/200/360, 160/200, 140, 180,
  110/130),
  `fig/details.svg`, `fig/clamp.svg` (узел
  поджима), `fig/cam.svg`, `fig/vibrotable_shield.svg`,
  `fig/assembly_steps.svg`
- Пробные детальные чертежи по STEP: [`tachdraw/`](./tachdraw/README.md) —
  **28 листов** A4 портрет, М 1:2, PDF: вал Ø10 h6, стол/подстолье/
  накладка, уголки, балка 21, кулачок (3 варианта) и 18 отрезков труб;
  STEP отрезков дополнены всеми отверстиями/прорезями;
  `tachdraw/pdf/*.pdf`; отчёт — [tachdraw/Report.md](./tachdraw/Report.md)
- Раскрой 4 труб 1000 мм на раму: [`techdraw/`](./techdraw/README.md) —
  A4 альбом, М 1:5, PDF/SVG/PNG; 18 отрезков рамы, рез ≤5 мм,
  остаток 170 мм; балки 21 — из отдельной трубы;
  отчёт — [techdraw/Report.md](./techdraw/Report.md)
- Раскрой направляющих валов: [`techdraw/`](./techdraw/README.md) —
  A4 альбом, М 1:2,5, PDF/SVG/PNG/CSV; 2 прутка Ø10×500 → 4 вала
  V01…V04 по 176 мм (166 + 5×2), резьба M10×15, рез 5 мм, остаток
  276 мм; отчёт — [techdraw/Report.md](./techdraw/Report.md)
- Чертёж вала: [`tachdraw/pdf/02_shaft.pdf`](./tachdraw/pdf/02_shaft.pdf) —
  Ø10 h6, L=176, M10×15, деталь А 2:1
- Спецификация / параметры: `spec.csv` (45 поз.), `shopping.csv`
  (47 строк), `params.csv`, `tube_cut.csv`, `torque.csv`
- Проверки / массы: `cad/checks.csv` (207: 204 OK, 3 предупреждения),
  `cad/mass.csv`
- Рендеры: `pic/render_*.png` (Blender EEVEE); превью листов —
  `pic/*.png`

**Ключевые числа.** Рама — сварная сталь 20×20×2, 18 отрезков; в T13/T14
4×Ø10 только в верхней стенке (Y=60/140); балка 21 — 2×Ø10 и 4×Ø4,5;
накладки — 8×50×50, ширина 25, 2 мм, M4×35, без крепления к стойкам;
шпильки поджима — 4×M10×117, строительные 4.6, Y=60/140; сверху ничего,
опора — шайба+гайка на нижней балке, поджим — шайба+гайка снизу балки;
верх шпильки Z=135 (5 мм над балкой, до нижних гаек валов 5,5 мм); вал
привода — 3 компл. (1+2 запасных), 8.8; масса без дрели — **9,123 кг**;
207 проверок: **204 OK, 3 предупреждения** (седло 2 мм, f_соб, резьба
кожуха). Съём балки/шпилек проверен: подъём шпильки 2 мм, верх 137 мм.
Направляющие валы — 2 прутка Ø10×500 на 4 вала по **176 мм**
(166 + 5×2), резьба M10×15, гайки M10 + шайбы Ø18; кольца WCS10FR
удалены; рез 5 мм, остаток 276 мм.
