inutcin/boomboom/stages/fix10l/README.md

# Первая версия орочьего вибростола 

Устройство, до версии fix9 не может быть изготовдено в условиях отсутствия
многих инструментов, материалов и навыков. Поэтому надо сделать отдельную 
`орочью` ветвь устройства и  в дальнейшем обозначать суффиксом `l`, например 
`fix10l`.

Имперская полная версия, наследник fix9 будет в дальнейшем без суффикса.

## Основные принципы

1. Сохранить по максимуму унификацию по деталям с обычной моделью.

2. Обязательно переиспользовать напечатанные кулачковые диски и вогнутую
накладку стола.

3. Размеры приблизительные. Необходимо сохранить размеры примерно как у 
имперской версии устройства, но с учетом общих габаритов не более 300 в высоту, 
200 в ширину и 400 в глубину. При этом взаимное расположение частей должно быть
таким, чтобы обеспечивать минимальную прочность.

4. Устройство будет без рамы. Роль стоек выполняют шпильки М10, на которых на гайках 
будут крепиться основные элемента. Элементы на гайках и шайбах могут
регулироваться при сборке.

5. Поясняющие эскизы орочьей версии
- [Вид спереди](./pic/vibrotable_front.png)
- [Вид слева](./pic/vibrotable_left.png)

## Изменения по сравнению с имперской версией устройства

### Виброотсека.

1. Поперечные и продолтные балки рамы отсутствуют вместо них верхняя платфома из 
фанеры с прямоугольным вырезом посерединие, примерно совпадающим размерами с 
окном сверху у имперской версии. Крепится вертикальных стойках-шпильках с 
помощью гаек и шайб.

2. Ниже верхней платформычерез шайбу идёт основная прижимающая пружина. Она
будет как и в имперской версии прижимать ролик к кулачковому диску.

3. Далее через шайбу накладка стола и стол. Через отверстия в накладке и столе
шпильки проходят ниже (отверстие в столе и накладке чуть больше, чтобы шпилька
проходила с люфтом). 

4. Далее через шайбу идет нижняя демпферная пружина. Она слабее и её цель -
центрироватье шпильки в отверстии стола и смягчение хода внизу, если амплитуда
окажется слишком большой. Подумать о том, а нужна ли она или можно будет просто
положить туда кольца из сантехнических прокладок.

5. Далее через шайбу идёт гайка, крепящая шпильку к продольной балке, идущей
через всю глубину конструкции. Цель продольной балки - придать жесткость креплению дрели 
к основному валу.

6. Продольная балка снизу фиксируется на шпильке шайбой и гайкой. Гайка
фиксируется контрагайкой.

7. Далее вниз по шпильке контагайка, гайка и шайба, фиксирующие сверху
поперечную балку.

8. В орочьей модели в отличие от имерской нет балки фиксации подшипника
основного вала и самого подшипника тоде нет. Вал врашается прямо в отверстии,
просверленном в поперечной балке. У этом узле вращения трение снижают 2 шайбы
надетые, и эти шайбы виксируются к поперечной балке с небольшим люфтом.
Аналогично фиксируется через пару шайб гайкой и контрагайкой с люфтом.

9. Поперечная балка сниду фиксируется шайбой гайкой и контрагайкой.

10. Ниже по шпильке идет станина из фареры, которая фиксируется внизу шайбами,
гайками и контрагайками.

11. Кронштейн, состояних из двух уголков толщиной 2 мм крепится на 4 самореза
каждый уголок. Между уголком и подшипником, в отличие от имперской модели, 2-3
шайбы с тонким кольцом, фиксируюшим внетреннее кольцо подшипника, но дающие
свободно вращаться внешнему. Всё это зажимается на оси М10 двумя самоконтащимися
гайками или гайкой и контрагайкой.

12. Кронштейн должен выступать вниз достаточно, чтобы кулачковый диск входил в
него как в напрабвляющие на 10-15мм.

13. Кулачковый диск крепитася аналогично имперской версии - на приваренную на
валу гайку, котора зажимается с боков найбой, гайкой и контрагайкой.

### Вынос

1. Конструкция выноса по сравнению с имперской моделью остайтся почти
неизмменной, за исключением того, что
- роль стоек выполняют шпильки из за чего отсутствуют потайные болты препления
- так как рамы нет, подстолье крепится на продольные балки и шапильки.
- роль нижней поперечной балки выполняет фанерная станина

## Результат проектирования

С учетом описанных изменений сделать:

- 3D-модель в установленном формате;
- эскиз в трёх проекциях (вид сбоку, вид слева, вид сверху);
- трёхмерное изображение конструкции;
- подготовь комплект эскизов с размерами всех деталей, требующих доработки или
  изготовления.
- лист с деталировкой отрезов труб.
- спецификацию деталей, включая отреды труб

# Результаты этапа

- Отчёт: [Report.md](./Report.md)
- Вопросы и решения: [Interview.md](./Interview.md)
- Инструкция по сборке: [Assembly.md](./Assembly.md)
- 3D-модель: `cad/step/vibrotable_assembly.step`; детали —
  `cad/step/01_studs.step` … `cad/step/35_cartridge.step`
- Печатные/переиспользуемые: `cad/stl/overlay.stl`, `cam_3/5/10.stl`;
  новых печатных деталей нет
- Эскизы: `fig/vibrotable_views.svg` (3 проекции),
  `fig/mechanism.svg`, `fig/details.svg`, `fig/beams.svg`,
  `fig/assembly_steps.svg`, `fig/spec.svg`, `fig/iso.svg`
- Пробные детальные чертежи по STEP: [`tachdraw/`](./tachdraw/README.md) —
  12 листов A4 портрет, М 1:2, PDF: стол/подстолье/накладка, 4 отреза
  труб B01…B04, 2 уголка кронштейна, кулачок 3/5/10; размеры на чертеже
  без координатных таблиц; `tachdraw/pdf/*.pdf`;
  отчёт — [tachdraw/Report.md](./tachdraw/Report.md)
- Спецификация / параметры: `spec.csv` (38 поз.), `params.csv`,
  `beam_cut.csv`, `torque.csv`, `cad/print.csv`
- Проверки / массы: `cad/checks.csv` (75: 72 OK, 3 предупреждения),
  `cad/mass.csv`
- Рендеры: `pic/render_*.png`; превью листов — `pic/*.png`

**Ключевые числа.** 6 шпилек M10; стол 200×200 из фанеры 10; накладка
fix9 200×150 по центру; вырез платформы 120×120; 4 пружины
Ø17×1,5×60 (L=36); нижние демпферы — резина; вал M10 в двух опорах
скольжения; кулачки fix9 R45/50; габарит 400×200×300; масса без дрели —
**6,080 кг**; 75 проверок: **72 OK, 3 предупреждения** (f_соб ≈14,9 Гц,
C1, C2).
