inutcin/boomboom/stages/fix9/README.md

# Вторая корректировка после третьей инженерной экспертизы

С учётом замечаний ниже сделать:

- 3D-модель в установленном формате;
- эскиз в трёх проекциях (вид сбоку, вид слева, вид сверху);
- трёхмерное изображение конструкции;
- подготовь комплект эскизов с размерами всех деталей, требующих доработки или
  изготовления.
- лист с деталировкой отрезов труб и схемой сварки рамы.
- спецификацию деталей, включая отреды труб
- инструкцию по сборке
    + сборка стола - крепление линейных подшипников, подстолья
    + монтаж стола на валы - продевание валов через среднюю поперечину, демпфер,
    собранный стол, шайбу, пружину, шайбу, верхнюю поперечину и крепление
    ограничителей.
    + сборку прижимных балок и накладок-уголков на крепеж
    + сборку картриджа основного вала с подшипниками и кулачковым диском
    + монтаж картриджа при поможи балок
    + сборку подстолья с U-образными хомутами

# Замечания

1. Для крепления линейных подшипником использовать винты с цилиндрической
головкой под шестигранник (М4, диаметр головки 7 мм, высота головки винта 4мм, длина 
резьбовой части 10мм), головка винта входит в углубление синзу, резьбовая часть 
проходит через посадочное отверстие подшипника и отверстие в столе и с обратной 
стороны затягивается гайкой М4 с нейлоновым кольцом, которая утоплена в 
углубление в столе вровень со столом и зафиксирована на клей. Высота гайки М4 и 
углубления в столе - 5мм.

2. Кожух крепится к корпусу винтами М4 с цилиндрической головкой. Длина
резьбовой части 10мм, высота головки винта 4 мм, диамитр головки винта 7мм. При
этом с обратной стороны не используется гайка. Для этого в отверстиях в раме
рарезается резьба М4. 

3. Для крепления подстолья к раме используются потайные винты М6 на 60 мм. При 
этом гайка М6 с нижней части рамы приваривается к раме для простоты затяжки.

4. Для крепления кронштейнов ролика-подшипника используется винт с
цилиндрической головкой под шестигранник (М4, диаметр головки 7 мм, высота
головки винта 4мм, длина резьбовой части 16мм) и гайка M4 с нейлоновым кольцом.
Винт сверху стола входит в углубление диаметром 8мм и высотой 5мм, проходит
через отверстие 5 мм и с обратной стороны проходит через вытянутое
регулировочное отверстие в кронштейне и затягивается гайко1 М4 с нейлоновм
кольцом.

5. Уголок-накладка 60x60 ширина 25 (вровень с внешними контурами рамы, выступает
за внутренний), крепление на балку 2 болтами М6 на 40мм с шестигранной головкой 
через отврестия в балке и уголке с обратной стороны на гайку М6 с нейлоновым
кольцом. Регулируемое крепление на стойку через 2 болта М6 на 40мм, в раме
отверстие круглое, в уголке 2 продолговатый длиной достаточной для дохода балки
15мм.

6. Раба будет сварена из стальных труб квадратного сечения 20 на 20 мм и
толщиной стенки 2 мм. Размер и расположение труб выбирается так, чтобы:
- верхние горизонтальные балки лежалт сверху на стойках
- стойки опирались на нижние горизонтальные балки
- стойки были одним куском трубы без разрезов.
- рез трубы - только под прямым углом, стыки под 45 градусов не допускаются.

7. В открытые части рам будут вставлены пластиковые заглушки

# Результаты этапа

- Отчёт: [Report.md](./Report.md)
- Вопросы и решения: [Interview.md](./Interview.md)
- Инструкция по сборке: [Assembly.md](./Assembly.md)
- 3D-модель: `cad/step/vibrotable_assembly.step`, отрезки рамы —
  `cad/step/22_T01…T18.step`, блок — `35_cartridge.step`
- Исходники: `cad/model.py`, `params.py`, `build.py`, `draw_sheet.py`,
  `export_groups.py`, `render_views.py`
- Печатные детали: `cad/stl/table.stl`, `overlay.stl`, `podstol.stl`,
  `cam_3/5/10.stl`; параметры — `cad/print.csv`
- Эскизы: `fig/vibrotable_views.svg` (3 проекции), `fig/frame_tubes.svg`
  (отрезки труб + сварка), `fig/details.svg`, `fig/cam.svg`,
  `fig/vibrotable_shield.svg`, `fig/assembly_steps.svg`
- Спецификация / параметры: `spec.csv` (45 поз.), `params.csv`,
  `tube_cut.csv`, `torque.csv`
- Проверки / массы: `cad/checks.csv` (180: 177 OK, 3 предупреждения),
  `cad/mass.csv`
- Рендеры: `pic/render_*.png` (новые, Blender EEVEE); превью листов —
  `pic/*.png`

**Ключевые числа.** Рама — сварная сталь 20×20×2, 18 отрезков; балка 21 —
стальная труба, прорезь R15×5; 8 плоских уголков 2 мм, ширина 25, M6×40;
LMK — M4×12; кожух — 22 винта M4×10; подстолье — M6×60; масса без дрели —
**9,458 кг**; 180 проверок: **177 OK, 3 предупреждения** (седло 6200 в
стенке 2 мм, f_соб 12,8 Гц, резьба M4 в стенке 2 мм). Остальные
замечания expert2/expert3 — в отчёте, раздел 7.

**Уточнение после приёмки (fix9):** уголок-накладка — **80×80**, ширина
25, сталь 2 мм; ход балки **20 мм**; пазы **26,6×6,6 с концами R3**;
вырез под стойку убран. Обновлены `params.csv`, `spec.csv`, модель,
`checks.csv`, `details.svg`, отчёт и инструкция.
