inutcin/boomboom/stages/fix8/README.md

# Первая корректировка после третьей инженерной экспертизы

База: [`stages/fix7`](../fix7/README.md). Выполнено выбранное в третьей
экспертизе оптимальное решение для **размаха (peak-to-peak)** 3/5/10 мм:
пружина **4×Ø17×1,5×60, 9 активных витков**. Остальные замечания expert2 /
expert3 в этом этапе **не выполнялись**.

## Замечание

Заменить пружины fix7 (4×Ø12×1,0 L0=70) на оптимальную пружину для режимов
5/10/15 Гц × 3/5/10 мм (размах), выбранную в
[`../expert3/optimum.md`](../expert3/optimum.md):

- Ø17 мм, проволока 1,5 мм, свободная длина 60 мм;
- 9 активных витков (11 полных), закрытые шлифованные концы;
- 4 шт.; установленная длина 36 мм; шайбы Ø18/Ø10,5×1,5 — существующие.

## Результаты этапа

- Отчёт: [Report.md](./Report.md)
- Вопросы и решения: [Interview.md](./Interview.md)
- 3D-модель: `cad/step/vibrotable_assembly.step`, блок — `35_cartridge.step`;
  исходники — `cad/model.py`, `cad/params.py`, `cad/build.py`
- Печатные детали: `cad/stl/` (`frame`, `table`, `overlay`, `podstol`,
  `retainer`, `cam_3/5/10`); параметры — `cad/print.csv`
- Эскизы: [fig/vibrotable_views.svg](./fig/vibrotable_views.svg) — 3
  проекции; [fig/vibrotable_spec.svg](./fig/vibrotable_spec.svg) —
  спецификация; изометрия — [fig/iso.svg](./fig/iso.svg),
  [fig/iso_open.svg](./fig/iso_open.svg)
- Спецификация / параметры: [spec.csv](./spec.csv) (36 поз.),
  [params.csv](./params.csv), [cad/checks.csv](./cad/checks.csv) (241:
  240 OK, 1 предупреждение), [cad/mass.csv](./cad/mass.csv)
- Рендеры: `pic/render_*.png` (новые, Blender EEVEE); превью листов —
  `pic/vibrotable_views.png`, `vibrotable_spec.png`, `iso.png`, `iso_open.png`

**Ключевые числа.** k=1,497 Н/мм; 4k=5,989 Н/мм; преднатяг=143,7 Н; сила
внизу (L=46)=83,9 Н; контакт 15 Гц/10 мм — **111,8 Н (2,72×)**; τ=479/279 МПа;
f_соб=12,81 Гц; масса пружины 24,6 г на 4; масса без дрели — **6405,8 г**.
Все 9 режимов 5/10/15 Гц × 3/5/10 мм — с запасом ≥2,72× (подробная таблица —
в [`../expert3/optimum.md`](../expert3/optimum.md)).

**Важно.** Это вариант для **размаха** 3/5/10 мм. Для нуль-пик 3/5/10 мм
(размах 6/10/20) нужна другая пружина — см.
[`../expert3/optim-pick-pick.md`](../expert3/optim-pick-pick.md); в fix8 она
не реализована.

**Остальные замечания.** C1–C8, I1–I23, W1–W8 из expert2 и S1–S6 из expert3,
кроме выбора пружины, остаются; в fix8 они не выполнялись.

**Следующий этап** — по результатам проверки fix8; отдельный каталог не
создавался.
