inutcin/boomboom/stages/fix6/README.md

# Третья корректировка после инженерной экспертизы

С учётом замечаний ниже сделать:

- 3D-модель в установленном формате;
- эскиз в трёх проекциях (вид сбоку, вид слева, вид сверху);
- трёхмерное изображение конструкции;
- спецификацию деталей.

# Замечания

1. Оба подшипника подвески оснвного вала привода должны поджиматься с боков
коническими подшипинками, которае должны контриться гайками M10.

# Результаты этапа

База: [`stages/fix5`](../fix5/README.md). Выполнено замечание 1: у обоих
опорных 6200 вала привода (X=10 и X=150) исправлен и проверен осевой зажим —
по два конуса Ø12→Ø16×5,5 на каждый подшипник (по одному с каждой стороны)
и по одной контргайке M10 nyloc снаружи каждого конуса. В fix5 левая
контргайка 6200 №2 стояла поверх конуса
(137,5…145,5 вместо 132…140, пересечение 403 мм³); теперь стек строится от
центра подшипника, пересечений нет.

- Отчёт: [Report.md](./Report.md)
- Вопросы и решения: [Interview.md](./Interview.md)
- 3D-модель: `cad/step/vibrotable_assembly.step`, блок — `35_cartridge.step`;
  исходники — `cad/model.py`, `cad/params.py`, `cad/build.py`
- Печатные детали: `cad/stl/` (`frame`, `table`, `overlay`, `podstol`,
  `retainer`, `cam_3/5/10`); параметры — `cad/print.csv`
- Эскизы: [fig/vibrotable_views.svg](./fig/vibrotable_views.svg) — 3
  проекции без кожуха (лист 1/2);
  [fig/vibrotable_spec.svg](./fig/vibrotable_spec.svg) — спецификация
  (лист 2/2); изометрия — [fig/iso.svg](./fig/iso.svg),
  [fig/iso_open.svg](./fig/iso_open.svg)
- Спецификация / параметры: [spec.csv](./spec.csv) (36 поз.),
  [params.csv](./params.csv) (237 параметров),
  [cad/checks.csv](./cad/checks.csv) (240 проверок: 238 OK,
  2 предупреждения), [cad/mass.csv](./cad/mass.csv)
- Рендеры: `pic/render_*.png` (общий вид, механизм, кулачок, кольца,
  буферы, кожух, подстолье, зажим 6200 №1, №2 справа и слева, общий вид
  зажима); превью листов — `pic/*.png`

**Итог:** оба 6200 поджаты с двух сторон конусами (4 шт.), каждая
конусная гайка законтрена снаружи гайкой M10 nyloc (4 шт.); осевые стеки
−8…0 / 0…5,5 / 5,5…14,5 / 14,5…20 / 20…28 и 132…140 / 140…145,5 /
145,5…154,5 / 154,5…160 / 160…168. Конус—6200 — касание, конус—гайка —
0, гайка—подшипник 5,5 мм, гайка—балка/поперечина 0,19 мм. Остальные
детали, масса (6,39 кг) и два прежних предупреждения — как в fix5.
