inutcin/boomboom/stages/fix7/README.md

# Первая корректировка и замечания после второй инженерной экспертизы

База: [`stages/fix6`](../fix6/README.md). Выполнено только замечание 1
пользователя — параметры прижимных пружин. Остальные замечания второй
экспертизы ([`findings.csv`](../expert2/findings.csv)) в этом этапе **не
выполнялись**: они остаются для следующих корректировок.

## Замечание 1

Задать параметры прижимных пружин:

- длина — **70 мм**;
- диаметр — **12 мм**;
- проволока — **1 мм**.

## Что сделано

- В [`params.csv`](./params.csv): `spring_free=70`, `spring_od=12`,
  `spring_wire=1,0`, `spring_turns=11`, 4 шт.; установленная длина осталась
  **36 мм** (её задаёт геометрия: стол 241, верхняя поперечина 280, шайбы
  2×1,5).
- В [`spec.csv`](./spec.csv), поз. 3: «Ø12, проволока 1,0; L0=70; покупное;
  установленная 36 мм; ID 10,2».
- В [`cad/checks.csv`](./cad/checks.csv): 241 проверка, **239 OK,
  2 предупреждения** (пружина ID 10,0 при вале Ø10; стенка 3 мм у R32 на
  диске 10). Добавлены проверки свободной длины L0=70 и установленной
  36/46 мм.
- 3D-модель, STEP/STL и листы пересобраны. Геометрия пружины в модели —
  **установленная** (36 мм), потому что пружина покупная и в собранном виде
  сжата; свободная длина 70 мм задана в спецификации и в расчётах.
- Масса без дрели — **6390,8 г** (не изменилась: пружина 2,4 г/шт., её
  проволока та же).
- Рендеры — из fix6: геометрия установленной пружины и остальных деталей не
  менялась; параметр L0=70 не влияет на 3D-форму сжатой пружины.

## Результаты этапа

- Отчёт: [Report.md](./Report.md)
- Вопросы и допущения: [Interview.md](./Interview.md)
- 3D-модель: `cad/step/vibrotable_assembly.step`, блок — `35_cartridge.step`;
  исходники — `cad/model.py`, `cad/params.py`, `cad/build.py`
- Печатные детали: `cad/stl/` (`frame`, `table`, `overlay`, `podstol`,
  `retainer`, `cam_3/5/10`); параметры — `cad/print.csv`
- Эскизы: [fig/vibrotable_views.svg](./fig/vibrotable_views.svg) — 3
  проекции; [fig/vibrotable_spec.svg](./fig/vibrotable_spec.svg) —
  спецификация; изометрия — [fig/iso.svg](./fig/iso.svg),
  [fig/iso_open.svg](./fig/iso_open.svg)
- Спецификация / параметры: [spec.csv](./spec.csv) (36 поз.),
  [params.csv](./params.csv), [cad/checks.csv](./cad/checks.csv),
  [cad/mass.csv](./cad/mass.csv)
- Рендеры: `pic/render_*.png`; превью листов — `pic/*.png`

**Ключевые числа.** k≈0,677 Н/мм; 4 пружины — 2,708 Н/мм; преднатяг при
L=36 — **92,1 Н**; сила внизу (L=46) — **65,0 Н**; f_соб≈8,64 Гц; контакт
ролика на 15 Гц/10 мм — **60,3 Н** по идеальной синусоиде (1,48 от
инерционной) и **72,0 Н** по фактическому 2-лепестковому профилю (2,48).
Подробная проверка пружин и контакта — в третьей экспертизе:
[`stages/expert3`](../expert3/README.md).

**Рекомендация третьей экспертизы:** текущая 4×Ø12×1,0 L0=70
перегружена (τ≈729 МПа) и по гармонической синусоиде даёт только 1,48×;
оптимальная замена — **4×Ø17×1,5×60, 9 активных витков** (контакт 2,72×,
τ≈479 МПа, f_соб≈12,8 Гц). Подробно — [`../expert3/optimum.md`](../expert3/optimum.md).

**Следующий этап:** [Третья инженерная экспертиза](../expert3/README.md) —
только пружины и контакт ролика; остальные части не проверяются.
