inutcin/boomboom/stages/fix4/README.md

# Первая корректировка и замечания после инженерной экспертизы

Рекомендации и замечания написанные в promos.md не выполнять,
оставить для информации

Выполнять замечания ниже по тексту

С учетом замечаний ниже сделать.

- 3D модель в установленном формате 
- эскиз в 3 проекциях: вид сбоку и вид слева
- трёхмерное изображение конструкции.
- спецификацию деталей

## Замечания.

1. Кулачковый диск сделать симметричным, чтобы у него было 2 максимальных
радиуса и 2 минимальных. Отверстия расположить таким образом, чтобы они по
радиуму приходились на максимумы и минимумы

2. Сделать кожух из 4-5 мм поликарбоната, закрывающий
- боковые части рамы в области вибромеханизма - пластины от нижней
  балки до
  верхней
- на верхней части рамы блока вибромеханижма изнутри по 4-м
  сторонам, а снаружи по двум (по двум другим закрывает большой кощух) сделать 
  вниз бортики поликарбоната до верхней точки колебания стола + запас 5 мм.
    + изнутри это не позволит шарику закатиться под раму и вызвать 
    заклинивание механизма
    + снаружи закроет большую часть пружины. 
- вынос кожухом не закрывать
- элементы кощуха к реме крепить на саморезы с прижимной шляпкой

3. Для фиксации кулачкового вала заменить на контактную шайбу с 
насечками + еще одну гайку для контрения. А на кулачковом диске 
убрать фаску вокруг центрального отверстия и сделать радиальные 
насечки шариной 3 см от края центрального отверстия

4. В углы между верхними поперечинами рамы блока вибромеханизма и 
вертикальными стойками вклеить 2 прямоугольных кусочка рещизы в промежутке 
между пружиной и стойкой. До прулины необходимо 
оставить расстояние 5 мм, а до максимальной точки хода стола - 
3 мм. Это должно защитить кожух от разружения при отрыве стола

5. Снизу на валы между средней поперечиной и линейным подшимником надо надеть 
резиновые кольца (сантех прокладки или кусок шланга) таким образом, чтобы от 
них до нижней границы максимального колебания стола оставалось 3 мм. 

6. Предполагается делать обцию блок из кулачкового диска, оси и подшипников, 
чтобы менять их открутив и отжав прижимные балки без радбора вала.

7. В стыках печатной рамы для прочности сделать вогнутые галтели радиусом 10мм
кроме тех мест, где они будут мешать уже принятым конструктивным элементам

## Результаты этапа

Этап выполнен по семи замечаниям выше. Рекомендации `promos.md` (C1–C7,
I1–I18, W1–W8) **не выполнялись** — оставлены для информации, как указано в
задании.

- Отчёт: [Report.md](./Report.md)
- Вопросы, решения и допущения: [Interview.md](./Interview.md)
- 3D-модель: [cad/step/vibrotable_assembly.step](./cad/step/vibrotable_assembly.step),
  блок кулачка — `cad/step/35_cartridge.step`, детали — `cad/step/*.step`;
  исходники — [cad/](./cad/) (`model.py`, `params.py`, `build.py`,
  `draw_sheet.py`, `export_groups.py`, `render_views.py`)
- Печатные детали: [cad/stl/](./cad/stl/) (`frame.stl`, `table.stl`,
  `overlay.stl`, `podstol.stl`, `retainer.stl`, `cam_3/5/10.stl`); параметры
  печати — [cad/print.csv](./cad/print.csv); раскрой кожуха — `shield.stl`
- Эскизы:
  [fig/vibrotable_views.svg](./fig/vibrotable_views.svg) — 3 проекции без
  кожуха (лист 1/4);
  [fig/vibrotable_shield.svg](./fig/vibrotable_shield.svg) — кожух (лист 2/4);
  [fig/cam_symmetric.svg](./fig/cam_symmetric.svg) — кулачок, шайба, осевой
  стек (лист 3/4);
  [fig/vibrotable_spec.svg](./fig/vibrotable_spec.svg) — спецификация
  (лист 4/4); изометрия — [fig/iso.svg](./fig/iso.svg),
  [fig/iso_open.svg](./fig/iso_open.svg)
- Спецификация / параметры: [spec.csv](./spec.csv) (35 поз.),
  [params.csv](./params.csv), [cad/checks.csv](./cad/checks.csv) (215
  проверок: 214 OK, 1 предупреждение), [cad/mass.csv](./cad/mass.csv)
- Рендеры: [pic/render_iso.png](./pic/render_iso.png),
  [render_iso_rear.png](./pic/render_iso_rear.png),
  [render_left.png](./pic/render_left.png),
  [render_top.png](./pic/render_top.png),
  [render_front.png](./pic/render_front.png),
  [render_shield.png](./pic/render_shield.png),
  [render_mechanism.png](./pic/render_mechanism.png),
  [render_cam.png](./pic/render_cam.png),
  [render_washer.png](./pic/render_washer.png),
  [render_ring.png](./pic/render_ring.png),
  [render_pad.png](./pic/render_pad.png),
  [render_retainer_down.png](./pic/render_retainer_down.png),
  [render_podstol.png](./pic/render_podstol.png); превью листов — `pic/*.png`

**Итог:** кулачок стал симметричным (2 максимума и 2 минимума, 4×Ø12 на
радиусах лепестков); добавлен кожух из поликарбоната 5 мм с бортиками до
Z=246; кулачок фиксируется буртиком вала, контактной шайбой Ø70 с насечками,
гайкой и контргайкой; в углах — 8 резиновых буферов, на валах — 4 кольца;
кулачок, вал и 6200 собраны в общий блок; в свободных стыках рамы — 20
вогнутых галтелей R10. Масса без дрели — 6,59 кг (кожух 0,87 кг).
Осталось одно предупреждение — номинальный ID пружины 10,0 мм при вале Ø10
(в модели 10,2).

**Следующий этап:** [fix5 — Вторая корректировка после инженерной экспертизы](../fix5/README.md).
