inutcin/boomboom/stages/fix5/README.md

# Вторая корректировка после инженерной экспертизы

База: [`stages/fix4`](../fix4/README.md). Этап учитывает замечания пользователя
после просмотра fix4. Рекомендации `promos.md` по-прежнему не выполняются.

С учётом замечаний ниже сделать:

- 3D-модель в установленном формате;
- эскиз в трёх проекциях (вид сбоку, вид слева, вид сверху);
- трёхмерное изображение конструкции;
- спецификацию деталей.

## Замечания

1. Отверстие в кулачковом диске под вал — чтобы туда плотно заходила гайка
   М10.

2. С одной стороны диска вокруг отверстия сделать буртик высотой 1 см, чтобы
   остатки сварки не мешали затянуть диск на валу. Диаметр буртика 40 мм. На
   буртике радиальные насечки не нужны. С другой стороны диска насечки тоже
   не нужны.

3. К шпильке вала в месте размещения диска закрутить и приварить гайку М10.

4. Шайбы должны быть с обоих сторон диска — и где есть буртик, и где нет. И с
   обоих сторон они должны притягиваться гайкой и контргайкой.

5. Облегчающих отверстий должно быть 8 того же размера и на том же расстоянии
   от центра: 2 на максимум, 2 на минимум и ещё 4 между ними.

6. Резиновые вставки по обе стороны от пружины не нужны. Достаточно в угол
   между поперечиной и стойками, прижать их и к поперечине, и к стойкам.

7. Сделать галтели на стыке нижней поперечины и стоек, а также везде внутри
   балок выноса.

8. Бортики из поликарбоната внутри не нужны, так как от последствий
   закатывания шарика страхуют резиновые ограничители.

## Результаты этапа

- Отчёт: [Report.md](./Report.md)
- Вопросы и решения: [Interview.md](./Interview.md)
- 3D-модель: `cad/step/vibrotable_assembly.step`, блок — `35_cartridge.step`;
  исходники — `cad/model.py`, `cad/params.py`, `cad/build.py`
- Печатные детали: `cad/stl/` (`frame`, `table`, `overlay`, `podstol`,
  `retainer`, `cam_3/5/10`); параметры — `cad/print.csv`
- Эскизы: [fig/vibrotable_views.svg](./fig/vibrotable_views.svg) — 3
  проекции без кожуха (лист 1/2);
  [fig/vibrotable_spec.svg](./fig/vibrotable_spec.svg) — спецификация
  (лист 2/2); изометрия — [fig/iso.svg](./fig/iso.svg),
  [fig/iso_open.svg](./fig/iso_open.svg)
- Спецификация / параметры: [spec.csv](./spec.csv) (36 поз.),
  [params.csv](./params.csv), [cad/checks.csv](./cad/checks.csv) (222
  проверки: 220 OK, 2 предупреждения), [cad/mass.csv](./cad/mass.csv)
- Рендеры: `pic/render_*.png` (общий вид, механизм, кулачок, кольца,
  буферы, кожух, подстолье); превью листов — `pic/*.png`

**Итог:** кулачок получил шестигранное отверстие 17,1 под гайку M10,
буртик Ø40×10, 8×Ø10 на R32 (2 макс + 2 мин + 4 между), без насечек;
гайка M10 приварена к шпильке; шайбы Ø40 и гайки/контргайки стоят с двух
сторон; 4 резиновых буфера — в углах «поперечина — стойка»; в раме 26
галтелей R10, включая 6 в выносе; внутренних бортиков кожуха нет, остались
2 боковые панели и 2 наружных бортика (22 самореза). Масса — 6,39 кг.
Предупреждения:
пружина ID 10,0 при вале Ø10 и стенка 3 мм у отверстий R32 на минимуме
диска 10.
