inutcin/boomboom/stages/fix11/cad/mass.csv

Узел | Поз. | Материал | Объём, см³ | Кол. | Масса, г
frame | 22 | steel | 534.16 | 1 | 4193.1
frame_plugs | 22.7 | plastic | 15.04 | 10 | 15.0
table | 5 | pla | 289.78 | 1 | 359.3
overlay | 4 | pla | 161.41 | 1 | 200.2
podstol | 11 | petg | 380.29 | 1 | 483.0
shaft | 2 | steel | 55.29 | 4 | 434.0
shaft_nuts | 45 | steel | 10.48 | 8 | 82.2
shaft_washers | 46 | steel | 2.01 | 8 | 15.8
spring | 3 | steel | 3.13 | 4 | 24.6
spring_washer | 25 | steel | 2.01 | 8 | 15.8
lmk | 8 | bearing | 56.88 | 4 | 446.5
drive_shaft | 20 | steel | 19.05 | 3 | 149.5
cam | 10 | pla | 85.38 | 1 | 105.9
shaft_bearings | 9 | bearing | 11.28 | 2 | 88.6
cam_washers | 33 | steel | 5.85 | 2 | 45.9
cam_nuts | 34 | steel | 2.7 | 2 | 21.2
cam_locknuts | 16 | steel | 2.7 | 2 | 21.2
shaft_conical_nuts | 17 | steel | 1.61 | 4 | 12.7
shaft_locknuts | 16 | steel | 5.39 | 4 | 42.3
roller | 9 | bearing | 5.64 | 1 | 44.3
axle | 7 | steel | 3.46 | 1 | 27.1
roller_nuts | 16/17 | steel | 3.5 | 4 | 27.5
bracket | 6 | steel | 5.8 | 2 | 45.5
retainer | 21 | steel | 56.75 | 2 | 445.5
retainer_plugs | 21.7 | plastic | 5.12 | 4 | 5.1
angles | 14 | steel | 31.49 | 8 | 247.2
ubolts | 12 | steel | 17.33 | 2 | 136.1
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
