inutcin/boomboom/stages/fix11/techdraw/README.md

# techdraw — раскрой fix11

Комплект из двух самостоятельных листов **A4 альбом**:

1. раскрой четырёх труб **20×20×2** длиной **1000 мм** на 18 отрезков
   сварной рамы `T01…T18`;
2. раскрой двух сплошных прутков **Ø10 h6** длиной **500 мм** на
   четыре направляющих вала `V01…V04`.

В обоих случаях рез **5 мм**, масштаб листа указан в основной надписи.

## 1. Раскрой труб рамы

Чертёж раскроя четырёх труб **20×20×2** длиной **1000 мм** на 18 отрезков
сварной рамы `T01…T18`. Задние стойки `T05/T06` входят в раскрой.
Поджимные балки 21 (`2×159,6 мм`) — из отдельной трубы.
Лист **A4 альбом**, масштаб **1:5**, рез **≤5 мм**.

### Раскладка

| Труба | Отрезки по порядку | Длины, мм | Резов | Занято, мм | Остаток, мм |
|---|---|---|---|---:|---:|---:|
| 1 | T07, T08, T11 | 360, 360, 200 | 3 | 935 | 65 |
| 2 | T01, T02, T03, T05 | 260, 260, 260, 150 | 4 | 950 | 50 |
| 3 | T09, T10, T13, T14, T15, T16 | 6×160 | 6 | 990 | 10 |
| 4 | T17, T18, T04, T12, T06 | 160, 160, 260, 200, 150 | 5 | 955 | 45 |
| **Итого** | **18 отрезков** | **3740** | **18** | **3830** | **170** |

Каждый отрезок отделяется своим резом. При резе 5 мм:
`3740 + 18×5 = 3830 мм`; из 4×1000 мм остаётся **170 мм**.

Позиции резов от левого торца:

- труба 1: `360, 725, 930`;
- труба 2: `260, 525, 790, 945`;
- труба 3: `160, 325, 490, 655, 820, 985`;
- труба 4: `160, 325, 590, 795, 950`.

### Файлы листа труб

```
cut_layout.py            генератор листа (SVG, PDF, PNG, CSV)
cut_plan.csv             порезка по позициям
fig/tube_cut_layout.svg  векторный чертёж
pic/tube_cut_layout.png  растровое превью
pdf/tube_cut_layout.pdf  печатный лист A4 альбом
```

### Что на листе труб

- четыре полосы заготовок 1000 мм в масштабе 1:5;
- маркировка отрезков `T01…T18` в порядке резки;
- позиции резов от левого торца;
- размерные цепочки готовых длин;
- остатки `65 / 50 / 10 / 45`;
- деталь А `1:1`: два торца трубы, стенка 2 мм, ширина реза 5 мм;
- таблица раскроя и примечания.

### Ограничения листа труб

1. Поджимные балки 21 (`2×159,6 мм`) в раскрой **не входят**: для них
   нужна отдельная труба длиной не менее **330 мм**.
2. Отверстия и прорези на этом листе не размечаются — они есть на
   индивидуальных листах `../tachdraw/pdf/22_T01…T18.pdf` и
   `../tachdraw/pdf/21_beam.pdf`.
   T13/T14 — Ø10 только в верхней стенке; T17/T18 — прорезь R15;
   B21 — 2×Ø10 и 4×Ø4,5.
3. Раскрой рассчитан на рез ровно 5 мм. При меньшем резе длины отрезков
   не меняются, остатки увеличиваются; резать следует по длинам, а
   абсолютные позиции резов пересчитать. При резе больше 5 мм раскладка
   не гарантируется.
4. Схема сварки — `../fig/frame_tubes.svg`.

## 2. Раскрой направляющих валов

Чертёж раскроя двух сплошных прутков **Ø10 h6** длиной **500 мм** на
четыре направляющих вала поз. 2. Лист **A4 альбом**, масштаб **1:2,5**,
рез **5 мм**.

Длина вала — **176 мм**: `166 мм` номинал плюс по **5 мм с каждого
торца**. На обоих концах — резьба **M10×15**. Крепление — гайка M10
(17 AF) и шайба **Ø18/Ø10,5×1,5** снаружи средней и верхней поперечин.
Кольца-ограничители WCS10FR не применяются.

### Раскладка

| Пруток | Отрезки по порядку | Длины, мм | Резов | Занято, мм | Остаток, мм |
|---|---|---|---|---:|---:|---:|
| 1 | V01, V02 | 176, 176 | 2 | 362 | 138 |
| 2 | V03, V04 | 176, 176 | 2 | 362 | 138 |
| **Итого** | **4 вала** | **704** | **4** | **724** | **276** |

Каждый отрезок отделяется своим резом. При резе 5 мм:
`704 + 4×5 = 724 мм`; из 2×500 мм остаётся **276 мм** (2×138).

Позиции резов от левого торца каждого прутка:

- пруток 1: `176, 357`;
- пруток 2: `176, 357`.

### Файлы листа валов

```
shaft_cut_layout.py            генератор листа (SVG, PDF, PNG, CSV)
shaft_cut_plan.csv             порезка по позициям
fig/shaft_cut_layout.svg       векторный чертёж
pic/shaft_cut_layout.png       растровое превью
pdf/shaft_cut_layout.pdf       печатный лист A4 альбом
```

### Что на листе валов

- два прутка Ø10×500 в масштабе 1:2,5;
- маркировка валов `V01…V04`;
- позиции резов `176` и `357` от левого торца;
- размерные цепочки `176 / 176 / ост. 138`;
- красная заливка зоны реза;
- деталь А `2:1`: два торца вала, Ø10 h6, сплошное сечение и ширина
  реза 5 мм;
- примечания: резьба M10×15 на свободных концах, фаска 0,5×45°,
  заусенцы снять, поверхность h6 не повреждать, гайка M10 + шайба Ø18.

### Ограничения листа валов

1. Длина **176 мм** — конструктивная: 166 + 5 мм с каждого торца.
   В 3D-модели и спецификации уже стоит 176 мм, валы `Z=137…313`.
2. Резьба M10×15 нарезается на обоих концах; на листе раскроя она
   задана примечанием, подробный чертёж — `../tachdraw/pdf/02_shaft.pdf`.
3. Маркировка `V01…V04` — для учёта; валы взаимозаменяемы.

## Общие файлы и запуск

```
techdraw_prompt.md   исходные задачи и принятые решения
Report.md            проверки и стоимость
```

Из `stages/fix11/techdraw`:

```bash
python3 cut_layout.py
python3 shaft_cut_layout.py
```

`cut_layout.py` проверяет: 18 уникальных позиций, сумму 3740 мм, 18 резов,
занято 3830 мм, остаток 170 мм.

`shaft_cut_layout.py` проверяет: 4 уникальных вала `V01…V04`, сумму
704 мм, 4 реза, занято 724 мм, остаток 276 мм и отсутствие отрицательных
остатков.

## Принятые изменения

Пользователь вернулся к варианту «рама без поджимных балок»: задние
стойки `T05/T06` снова включены в раскрой, балки 21 (`2×159,6`)
исключены и режутся из отдельной трубы. Принята безопасная перестановка
`200 ↔ 150` между трубами 2 и 4: труба 2 — `260,260,260,150`
(остаток 50), труба 4 — `160,160,260,200,150` (остаток 45). Все
18 отрезков рамы закрываются, общий остаток — 170 мм.

Для валов принята длина **176 мм**: по **5 мм** добавлено с каждого
торца относительно 166 мм. На концах — резьба **M10×15**; крепление —
гайка M10 и шайба Ø18. Кольца-ограничители WCS10FR удалены. Раскладка
на два прутка по 500 мм сохраняется, остаток — по 138 мм на пруток.
