inutcin/boomboom/stages/fix11/Interview.md

# Интервью по этапу «Третья корректировка после третьей инженерной экспертизы»

Дата: 2026-11-03; дополнение по валам — 2026-11-05
Этап: `stages/fix11`
База: [`stages/fix9`](../fix9/README.md) (имперская ветвь)
Задача: [`README.md`](./README.md)

Этап выполняет **10 замечаний** README с уточнениями пользователя.
Остальные C1–C8, I1–I23, W1–W8 (expert2) и S3, S5, S6 (expert3) в этап
не входят.

## 1. Вопросы и решения

**В1. Геометрия накладок-уголков?**

Принято: плоские, сталь 2 мм, **50×50, ширина 25**, 8 шт. (2 на конец
балки). Лепесток 50 перекрывает стойку на 20 мм и **упирается** в неё;
крепления к стойке нет — накладка работает как направляющая/упор.
Отверстия и пазы в стойках не выполняются. К балке — 2 винта
**M4×35** с гайкой nyloc и шайбами через пару накладок и втулку
16×16×2 L=16.

**В2. Шпильки поджима — положение, диаметр, длина?**

Принято по уточнению: **по 40 мм от осевой линии**, то есть
**Y=60/140** (80 мм между шпильками), X=10/150. Шпильки —
**4×M10×117**, строительные 4.6. Низ Z=18 (в гнезде Ø10 верхней стенки
T13/T14), верх **Z=135** — не более **5 мм** над прижимной балкой.
Нижнюю грань T13/T14 не сверлить.

**В3. Как устроен поджим?**

Принято: **сверху на шпильку ничего не накручивается**; по всей длине
только две гайки. Опора — шайба Ø20/Ø10,5×1,5 и гайка M10 nyloc на
верхней грани нижней поперечины (Z=20); шпилька опирается на гайку.
Поджим — шайба и гайка M10 **снизу** прижимной балки (Z=100,5…110).
Ход балки 20 мм — вращением поджимной гайки. Моменты: опора 8 Н·м,
поджим 10 Н·м.

**В4. Съём балки и шпилек?**

Принято: отдать поджимную гайку, опустить балку на 20 мм, поднять её
со шпильками на 2 мм (низ шпилек 18→20, верх 137 < 150), наклонить
балку вперёд и снять со шпилек. Затем снять опорные гайки с шайбами,
поднять шпильки на 2 мм и вынуть из гнёзд.

**В5. 3 комплекта шпилек привода?**

Принято: **только шпильки с приваренной гайкой** — 3 компл. (1
установлена + 2 запасных). Подшипники 6200, кулачок, конусы и
контргайки — по одному комплекту, как в fix9; полные 3 картриджа не
делались.

**В6. Материалы и прочность?**

Принято: шпильки вала привода и ось ролика — **8.8 высокопрочные**;
шпильки поджима балки — **строительные 4.6**. В спецификации это
отмечено отдельно.

**В7. Крепление накладок к балке?**

Принято: 2 винта M4×35 на конец балки (8 шт. на 8 накладок), гайки
nyloc, шайбы Ø9/Ø4,3×1 с двух сторон; в балке — Ø4,5 и втулки
16×16×2 L=16 (4 на балку). К стойкам — без крепления.

**В8. Масса?**

Принято: масса сборки без дрели — **9,123 кг** (одна шпилька вала
установлена). Две запасные шпильки с гайками — вне сборки, +≈0,30 кг;
транспортная масса ≈9,61 кг.

## 2. Принятые допущения

| Вопрос | Принято | Почему |
|---|---|---|
| База | fix9 | README этапа |
| Накладки | 50×50×25×2, 8 шт. | замечание 7 |
| Крепление накладок | M4×35, 2 на конец | замечание 7 |
| К стойкам | не крепить, только упор 20 мм | замечания 1–2 |
| Шпильки | M10×117, 4 шт., 4.6 | замечания 3–5, 10 |
| Положение шпилек | Y=60/140 (40 от оси) | уточнение пользователя |
| Гнёзда | Ø10 только верхняя стенка T13/T14 | замечание 3 |
| Верх шпильки | Z=135, ≤5 мм над балкой | уточнение пользователя |
| Опора | шайба + nyloc на нижней балке | уточнение пользователя |
| Поджим | шайба + гайка снизу балки | уточнение пользователя |
| Сверху | ничего | уточнение пользователя |
| Вал привода | 3 компл., 8.8 | замечания 8–9 |
| Ось ролика | 8.8 | замечание 8 |
| Масса | 9,123 кг | по модели |

## 3. Что не проверялось

1. Усталость/ресурс шпилек M10 4.6, гаек и опоры при вибрации.
2. Смятие/люфт седла 6200 в стенке 2 мм (наследие fix9).
3. Динамика с шариком, удар, податливость PLA, шум, резонанс рамы.
4. Точные k/L0/ID пружины и её паспорт.
5. Гармонический профиль кулачка (C8) и контакт по синусоиде.
6. Привод/дрель, патрон, хвостовик, биение (C2).
7. Ограждение/аварийный останов (C1).
8. Реальная технология сварки/мехобработки и допуски производства.
9. Масса по реальным деталям (в модели — по объёмам и плотностям).
10. Доступ к опорной гайке внутри рамы и к сверлению T13/T14 при
    собранной раме (рекомендация — до сварки средних поперечин).

## 4. Противоречия и предложения

1. **Доступ к Ø10 в T13/T14** — сверху мешает средняя поперечина
   (Z=150…170). Сверлить до сварки T17/T18 или угловой насадкой.
2. **Опорная гайка nyloc** на верхней грани нижней балки — доступ
   изнутри рамы; при верхнем положении балки зазор ≈80 мм, гайка не
   мешает. Проверить ключом 17.
3. **3 шпильки вала** без полных картриджей: для смены диска нужно
   переставлять 6200/кулачок/конусы. Если нужна быстрая смена — сделать
   3 полных картриджа (6×6200, 12 конусов, 12 контргаек).
4. **Накладки не крепятся к стойкам** — упор работает в одну сторону
   (от вываливания); влево-вправо балку держат стойки. Это
   соответствует замечанию 2.
5. **Верх шпильки 5 мм** — зазор до нижних гаек валов 5,5 мм;
   при сборке контролировать, чтобы шпилька не была вывернута выше.

## 5. Связь с предыдущими этапами

Основание — `stages/fix9` (рама, балка 21, седла, стол, кулачок,
подстолье). В fix11 изменены узел поджима балки 21, накладки, крепёж и
обозначения прочности; геометрия стола, накладки, кулачка, вала привода,
6200, ролика, пружин и подстолья не менялась.

## 6. Уточнения по раскрою труб (`techdraw`)

**В9. Что входит в раскрой из 4 труб по 1000 мм?**

Принято: все 18 отрезков рамы `T01…T18`, включая задние стойки
`T05/T06`. Поджимные балки 21 (`2×159,6 мм`) режутся из отдельной
трубы (нужно ≥330 мм) и в раскрой не входят.

**В10. Влезает ли это в 4×1000 мм?**

Принято: да. Сумма длин 3740 мм, 18 резов по 5 мм, занято 3830 мм,
остаток 170 мм.

**В11. Формат листа и выходные файлы?**

Принято: A4 альбом, масштаб 1:5; PDF + SVG + PNG (PDF для печати,
SVG в `fig/`, PNG в `pic/`).

**В12. Какая раскладка основная?**

Принято: труба 1 — `360,360,200` (остаток 65); труба 2 —
`260,260,260,150` (остаток 50); труба 3 — `6×160` (остаток 10);
труба 4 — `160,160,260,200,150` (остаток 45). Перестановка `200 ↔ 150`
между трубами 2 и 4 даёт запас на рез.

## 7. Изменение концепции крепления валов

**В13. Чем заменить кольца-ограничители?**

Принято: кольца WCS10FR (поз. 1) удалить из модели, спецификации,
чертежей, рисунков и рендеров. Валы крепить гайками M10 с шайбами
Ø18/Ø10,5×1,5 снаружи средней и верхней поперечин: 2 гайки + 2 шайбы
на вал, 8 + 8 на сборку. Затяжка 8 Н·м, фиксатор резьбы.

**В14. Как изменится длина и обработка валов?**

Принято: длина **176 мм** — по 5 мм добавлено с каждого торца к
прежним 166 мм. На обоих концах — резьба **M10×15**. Валы `Z=137…313`.
Резьбовые участки вне LMK: нижний 137…152, верхний 298…313.

**В15. Что с раскроем и чертежами?**

Принято: раскрой на 2 прутка Ø10×500 остаётся: 4×176 + 4×5 = 724 мм,
остаток 276 мм. Лист `techdraw` обновлён: L=176, M10×15, гайка + шайба.
В `tachdraw` добавлен лист `02_shaft.pdf` (Ø10 h6, L=176, M10×15,
деталь А 2:1).
