inutcin/boomboom/stages/fix4/promos.md

# Первая корректировка и замечания после инженерной экспертизы

**Статус: задание сформировано, этап не выполнен.** Это следующий этап после
[инженерной экспертизы](../expert/README.md); модель fix3 не менялась.

База: [`stages/fix3`](../fix3/README.md)
Экспертиза: [`stages/expert/Report.md`](../expert/Report.md),
[`findings.csv`](../expert/findings.csv), [`cad/calc.csv`](../expert/cad/calc.csv),
[`cad/map.csv`](../expert/cad/map.csv)

## 1. Цель этапа

Устранить замечания экспертизы и получить модель, которую можно изготовить,
собрать и безопасно эксплуатировать в эксперименте с шариком 20/33 г:
7 критичных, 18 важных и 8 пожеланий. Сначала — критичные (безопасность и
работоспособность), затем важные (точность, ресурс, удобство), пожелания — по
остатку времени.

**До моделирования ответить на вопросы** [`expert/Interview.md`](../expert/Interview.md):
В1 (амплитуда — размах или нуль-пик), В2 (обязательные режимы 5…15 Гц ×
3…10 мм), В3 (реальная дрель/патрон), В4 (PETG-рама или сталь по README),
В5 (крепление к станине), В6 (борт/ударная пластина), В7 (материал кулачка),
В8 (протокол приёмки). Ответы записать в `stages/fix4/Interview.md`.

## 2. Критичные корректировки (C1–C7)

| ID | Что исправить | Критерий приёмки |
|---|---|---|
| **C1** | Ограждение вращающихся частей (кулачок, вал, гайки, патрон), блокированная дверца, аварийный останов, маркировка. | Зазор ≥10 мм до подвижных частей; E-stop; проверка на 900 об/мин. |
| **C2** | Выбрать дрель; смоделировать патрон/рукоятку; хвостовик Ø10 h6 с лыской/квадратом; гибкая муфта или квадратный привод; осевой упор; согласовать длину вала. | Хвостовик в патроне ≥20 мм; биение ≤0,05 мм; осевой люфт ≤0,2 мм; вал не упирается в корпус. |
| **C3** | Ступенчатый вал с буртиками/поясами под 6200; шпонка/лыска для кулачка; стальные упорные шайбы или стальная втулка; ответный конус 45° или плоская шайба; положительный осевой упор. | Осевое смещение кулачка ≤0,1 мм; биение ≤0,05 мм; кулачок не проворачивается при 2× моменте. |
| **C4** | Регулируемые опоры валов (сухари/пазы/шайбы) или расточка H7 + шлифованные валы с буртиками; юстировка по индикатору; рассмотреть 2 вала/4 втулки. | Параллельность ≤0,02 мм на 100 мм; ход без закусывания; страгивание ≤20 Н. |
| **C5** | Положительный упор под балкой 21 (буртик/шпонка/стальной кронштейн), домкратный винт/клин, страховочная скоба под 6200; контроль момента. | 3× статическая нагрузка без смещения; после 1 ч 15 Гц смещение ≤0,05 мм; 6200 не выпадает при ослаблении одного болта. |
| **C6** | Уточнить «амплитуду»; опубликовать карту режимов; расширить комплект дисков (например, 10/15/20 мм размаха) или сузить частоты; предусмотреть удержание шарика. | Для каждого обязательного режима `a_max≥1,5g`; карта в паспорте; шарик остаётся в лотке. |
| **C7** | Задать k, L0, витки, материал и допуск пружин; выбрать k≥1,3 Н/мм (запас 2×) или 6…8 пружин; регулировка преднатяга; демпфирование. | Сила контакта ≥2× инерционной; преднатяг регулируется; амплитуда ±0,2 мм после 1 ч. |

## 3. Важные корректировки (I1–I18)

| ID | Что исправить | Критерий приёмки |
|---|---|---|
| **I1** | Быстросъёмный кулачок на шпонке/фланце с одной гайкой; диски с общей базой; шкала; инструкция. | Замена ≤5 мин без снятия вала; повторяемость ±0,1 мм. |
| **I2** | Обновить корневой README (PETG 20×20 сплошной, стол 200×150 по X) или зафиксировать возврат к стали; один источник истины. | README, params/spec и модель не противоречат. |
| **I3** | Шлифованный ступенчатый вал Ø10/Ø12 с поясами h6 и буртиками. | Биение ≤0,05 мм; прогиб ≤0,05 мм; запас усталости ≥2. |
| **I4** | Стальные/расточенные вкладыши или заменяемые корпуса 6200; осевой преднатяг 0,02…0,05 мм; пластины 3 мм/стальной кронштейн. | Люфт 6200 ≤0,05 мм; износ ≤0,02 мм за 10 ч. |
| **I5** | Покупные шлифованные валы Ø10 h6, HRC60; указать Ra и допуск. | Вал h6, HRC60, Ra≤0,4; люфт ≤0,02 мм после 10 ч. |
| **I6** | Две втулки на вал/линейные каретки; увеличить базу; проверить перекос. | Перекос стола ≤0,05 мм на 140 мм; без закусывания. |
| **I7** | Общая база/максимальный радиус дисков; шайбы/винты преднатяга; шкала высоты. | Средняя высота ±0,5 мм для всех дисков; преднатяг фиксируется. |
| **I8** | Галтели R3…5; разъёмная рама/заменяемые стальные кронштейны; циклические испытания. | Нет трещин после 10⁶ циклов; ремонт без перепечатки всей рамы. |
| **I9** | Расточка/развёртывание по кондуктору; отдельные опоры/вкладыши; контроль координат и параллельности. | Координаты ±0,05 мм; параллельность ≤0,02/100; карман 9,0…9,1 мм. |
| **I10** | Борт/прозрачное кольцо; сменная закалённая пластина 2 мм; глубже лоток; материал. | Шарик остаётся в лотке; пластина меняется без разборки; износ ≤0,02 мм за серию. |
| **I11** | Выбрать дрель; регулируемые хомуты/сменные седла; резиновая подкладка; при необходимости рёбра подстолья. | Дрель без люфта; рукоятка/курок не касаются; патрон соосен; прогиб ≤0,2 мм. |
| **I12** | 4×M6 в нижних балках + стальные/фанерные подкладки; резиновый коврик; схема крепления. | Рама не смещается при 15 Гц; PETG не смят; 3× момент. |
| **I13** | Допуск гармоничности ≤2% или коррекция профиля кулачка; проверка хода/ускорения. | Отклонение ≤2% размаха; ход ±0,1 мм. |
| **I14** | Метка на валу + тахометр/стробоскоп; калибровка ручки; при необходимости encoder/VFD. | Частота ±0,2 Гц; карта «ручка → Гц»; проверка под нагрузкой. |
| **I15** | Обновить `mass.csv` реальными массами LMK/6200; пересчитать движущуюся массу, f_соб, контакт; исправить текст отчёта. | Массовая ведомость ±5%; динамика пересчитана; отчёт согласован. |
| **I16** | Домкратный винт/клин, направляющие, страховочный упор; процедура. | Опускание/подъём плавно, без защемления; фиксация в обоих положениях. |
| **I17** | Два M4 на кронштейн ролика или M4 + шпонка/штифт; стальная шайба/вставка; упор по X. | Смещение ≤0,02 мм при 2× силе; центровка ролика ±0,1 мм. |
| **I18** | Обновить `spec.csv`, `params.csv`, отчёт и README; проверка согласованности «модель — спецификация — отчёт». | Все размеры/массы совпадают; противоречий нет. |

## 4. Пожелания (W1–W8)

| ID | Пожелание | Критерий (если делается) |
|---|---|---|
| **W1** | Сократить число движущихся частей и точек трения (2 вала/4 втулки, положительный кулачок, меньше регулировок). | Меньше деталей/точек трения при сохранении хода и точности. |
| **W2** | Линейно выразить частоту/амплитуду через геометрию: тахометр/редуктор, шкала, таблица режимов. | Паспортная таблица «диск × частота → ход». |
| **W3** | Модульная/гибридная рама (стальной/алюминиевый профиль + печатные вкладыши) вместо одной печатной детали. | Ремонт узла без перепечатки рамы. |
| **W4** | Заменить бытовую дрель приводом с обратной связью (geared motor + VFD/encoder). | Частота ±0,1 Гц; меньше шума/вибраций. |
| **W5** | Стандартные покупные опоры вместо печатных карманов (pillow blocks, линейные опоры, шафт-холдеры). | Посадочные размеры из каталога; замена без печати. |
| **W6** | Демпфирование стола/пружин (эластомерные втулки/демпферы). | Снижение резонансного пика/шума без потери хода. |
| **W7** | Инструментарий: шкала амплитуды, тахометр, держатель микрофона, шаблон протокола, калибровка. | Повторяемость времени между ударами; протокол на режим. |
| **W8** | Обслуживание: быстросъёмный кулачок, невыпадающий крепёж, ЗИП (накладка/пластина), метки моментов, инструкция. | Замена расходника ≤10 мин; крепёж не теряется. |

## 5. Что должно быть в результате fix4

1. Обновлённая 3D-модель и STEP-сборка; отдельные STEP/STL деталей;
   печатные детали с ориентацией и параметрами печати.
2. Эскиз в трёх проекциях (HLR) и изометрия; спецификация и параметры;
   проверки и массы.
3. Новые проверки по критериям C1–C7 и I1–I18 (геометрия, зазоры, ходы,
   усилия, допуски, отсутствие пересечений) — в `cad/checks.csv`.
4. Ограждение/E-stop, муфта/хвостовик, ступенчатый вал, упор балки 21,
   регулируемые опоры, крепление к станине — в модели и спецификации.
5. Обновлённые `README.md`, `spec.csv`, `params.csv`, `mass.csv`; один
   источник истины; исправленные расхождения I2/I18.
6. Рендеры/листы, показывающие новые узлы; протокол статической и
   динамической проверки.
7. Отчёт `stages/fix4/Report.md` с таблицей «замечание → что сделано →
   проверка», стоимостью генерации и ограничениями.

## 6. Порядок выполнения

1. **Ответы на В1…В8** (`Interview.md`); зафиксировать решение по амплитуде,
   режимам, дрели, раме, креплению, шарику, материалам и приёмке.
2. **C1–C7**: ограждение, привод/патрон, вал/фиксация, юстировка,
   положительный упор балки 21, режимная карта/диски, пружины. Без этого
   модель не считается работоспособной.
3. **I1–I18**: точность, ресурс, удобство, документация. Начать с I2/I18
   (документы), I3/I4/I5/I17 (валы/опоры/кронштейн), I8/I9/I12 (рама/печать/
   крепление), I10/I11/I14 (шарик/дрель/частота), I1/I7/I16 (смена диска/
   преднатяг/обслуживание).
4. **W1–W8** — по остатку времени; не ухудшая C/I.
5. **Проверки**: статическая сборка, прокрутка вручную, 1 ч на 15 Гц,
   амплитуда/частота, момент затяжек, температура; протокол.

## 7. Критерии готовности этапа

- Все C1–C7 закрыты с подтверждением в `checks.csv`/протоколе.
- Все I1–I18 либо закрыты, либо явно отложены с обоснованием в отчёте.
- Модель собирается без пересечений; ход 3…10 мм (или принятый диапазон)
  без касаний; шарик остаётся в лотке на обязательных режимах.
- Документы (README, spec, params, mass, отчёт) согласованы с моделью.
- Есть ограждение/E-stop и инструкция по безопасной эксплуатации.

## 8. Результаты этапа

_Заполняется после выполнения fix4:_ ссылки на `Report.md`, `Interview.md`,
`cad/step/*.step`, `cad/stl/*.stl`, `fig/*.svg`, `pic/*.png`, `spec.csv`,
`params.csv`, `checks.csv`, `mass.csv`.
