inutcin/boomboom/stages/fix11/tachdraw/techdraw_prompt.md

Создай в fix11 каталог tachdraw.  В который него для детали, взяв за исходники модель в step-файле, создай чертёж с рамкой в масштабе 1:2, в двух наиболее подходящих проекциях, в котором укажи размеры:
- габариты деталей
- расстояния от краёв до центров отверстий и диаметры отверстий
- расстояния от краёв деталей до краёв вырезов
- расстояний указывай не в виде координат в таблице, а размерами на чертеже

Для каждого чертежа
- чертёж на одном листе формата А4 в портретной ориентации
- формат выходного фалйа pdf (svg и png не нужны) 
- чертёж сделать только для деталей, требующих изготовления
  - торезы труб до сварки, включая отверстия и прорези в них
  - стол, подстолье. некладка для стола
  - уголки кронштейна, накладки на поджимную балку
  - поджимная балка
  - кулачковый диск
- чертежи покупных деталей не делать

Этот промпт записать в файл techdraw_prompt.md

# Дополнение fix11 (2026-11-05)

Направляющие валы больше не покупные: они изготавливаются из прутка
Ø10 h6 — резка до L=176 и резьба M10×15 на обоих концах. Добавить
отдельный лист `02_shaft.pdf` с главным видом, резьбой и деталью А
2:1. Крепление — гайка M10 + шайба Ø18 снаружи поперечин.
