inutcin/boomboom/stages/fix11/techdraw/techdraw_prompt.md

Создай в каталоге fix11/techdraw чертёж с размерами, показывающий как
разрезать 4 трубы длиной 1000 мм, чтобы использовать полученные отрезки для
сваривания рамы. Толщину реза может быть до 5 мм.

Уточнение: поджимные балки 21 будем вырезать из другой трубы. Задние
стойки снова включи в раскрой, а балки 21 исключи.

Принятые решения:
- в раскрой входят все 18 отрезков рамы T01…T18, включая задние стойки
  T05/T06;
- поджимные балки 21 (2×159,6 мм) — из отдельной трубы, в раскрой не входят;
- лист A4 альбом, масштаб 1:5;
- рез 5 мм, каждый отрезок отделяется резом;
- безопасная раскладка: труба 2 — 260,260,260,150; труба 4 —
  160,160,260,200,150;
- выход: PDF + SVG + PNG.

# Раскрой направляющих валов

Добавь в `fix11/techdraw` раскрой на 4 направляющих вала из двух сплошных
отрезков валов круглого сечения длиной 500 мм. Толщина реза 5 мм.
Аналогично трубам для рамы. Размер бумаги также A4. Масштаб подобрать
самостоятельно.

Уточнение: изменить концепцию крепления валов — убрать кольца-ограничители
WCS10FR, удлинить валы на 5 мм с каждой стороны, нарезать резьбу M10×15
на обоих концах и затянуть гайками M10 с шайбами Ø18.

Принятые решения:
- заготовка: 2 сплошных прутка Ø10 h6 длиной 500 мм;
- готовые валы: 4 шт. V01…V04, длина 176 мм (166 + 5×2);
- резьба M10×15 на обоих концах;
- крепление: гайка M10 (17 AF) + шайба Ø18/Ø10,5×1,5 снаружи
  средней и верхней поперечин;
- кольца-ограничители WCS10FR удалены из модели, спецификации,
  чертежей и рендеров;
- лист A4 альбом, масштаб 1:2,5;
- рез 5 мм, каждый отрезок отделяется своим резом;
- раскладка каждого прутка: 176, рез 176–181, 176, рез 357–362,
  остаток 138 мм;
- итого: 4×176 = 704 мм, 4 реза = 20 мм, занято 724 мм, остаток 276 мм;
- выход: PDF + SVG + PNG + CSV.
