inutcin/boomboom/stages/fix11/tachdraw/pdf/22_T03.pdf

# СТОЙКА ВЫСОКАЯ (T03)

### Чертёж детали по STEP · A4 · М 1:2

Разраб.

Пров.

Т. контр.

Н. контр.

Утв.

# Стойка высокая (T03)

поз. 22.2 · 1 шт.

### труба 20×20×2

по STEP-модели

М 1:2

масштаб

### Лист 1/1

Формат A4

## fix11.TD.22.2

tachdraw · batch.py

Масса 0,294 кг

## ВИД X

## ВИД Z

260

20

20

20

ПРИМЕЧАНИЯ

Труба 20×20×2; L=260; рез 90°; стенка 2. Размеры — по STEP; кромки притупить. Неуказанные отклонения ±0,5 мм.
Размеры отверстий — от левого/нижнего края.
