inutcin/boomboom/stages/fix11/tachdraw/pdf/22_T05.pdf

# СТОЙКА ЗАДНЯЯ (T05)

### Чертёж детали по STEP · A4 · М 1:2

Разраб.

Пров.

Т. контр.

Н. контр.

Утв.

# Стойка задняя (T05)

поз. 22.5 · 1 шт.

### труба 20×20×2

по STEP-модели

М 1:2

масштаб

### Лист 1/1

Формат A4

## fix11.TD.22.5

tachdraw · batch.py

Масса 0,17 кг

ВИД X | ВИД Z

150

20

20

20

ПРИМЕЧАНИЯ

Труба 20×20×2; L=150; рез 90°; стенка 2. Размеры — по STEP; кромки притупить. Неуказанные отклонения ±0,5 мм.
Размеры отверстий — от левого/нижнего края.
