inutcin/boomboom/stages/fix11/cad/checks.csv

Проверка | Значение | Норма | Статус | Примечание
Рама — число отрезков | 18 | 18 | OK | 4 высокие + 2 задние + 2 нижние + 2+2+2 поперечины + 6 верхних
Рама — сечение / стенка | 20×20 / 2 мм | 20×20×2 | OK | сталь, сварка; все резы 90°
Рама — габарит X×Y×Z | 360.0×200.0×300.0 | 360×200×300 | OK
Стойки — одним куском / без разрезов | 6 шт. | 6 | OK | 4 высокие 260, 2 задние 150
Верхние балки виброотсека — на стойках | Z=280…300 | лежат сверху | OK | T09/T10 на T01–T04
Стойки — на нижних балках | Z=20…280 | опираются | OK | нижние продольные T07/T08
Стойки — число / длины | 4×260 + 2×150 | 4 + 2 | OK
Заглушки рамы | 6 × 20×20 + 4 × 16×16 | 10 | OK | 6 наружных + 4 внутренних; +4 заглушки балки 21 16×16
Распорные втулки | 8 × 16×16×2, L=16 | 8 | OK | 4 в каждой балке 21; в стойках нет
Рама — приварные гайки M6 | 4 | 4 | OK | снизу верхних балок выноса
Рама — сварной шов | катет 3 мм | 3 | OK | по периметру стыков
Рама — седла 6200 | 2 × прорезь R15×5 в стенке 2 мм | R15×5 | ВНИМАНИЕ | без вкладыша; контакт по кромке 2 мм — проверить
Рама — отверстия валов | 4 × Ø10,5 | Ø10,5 | OK | сверлить после сварки по кондуктору
Рама — отверстия под шпильки | 4 × Ø10, только верхняя стенка | 4 | OK | T13/T14; x=10/150, y=60/140; низ не сверлить
Рама — отверстия под накладки в стойках | 0 | 0 | OK | по fix11 п.1–2 крепления к стойкам нет
Стол, X×Y×T | 200.0×150.0×10.0 | 200×150×10 | OK | X=−20…180, Y=25…175
Стол — отверстия LMK | 16 × Ø5 | Ø5 | OK | 4 на каждый LMK
Стол — углубления под гайки LMK | 16 × 7,2 AF×5 | 5 | OK | гайка nyloc на клей, заподлицо
Стол — остаток под гайкой | 5 мм | ≥4 | OK | 10−5
LMK — цековка фланца | 4 × Ø7,2×4,2 | Ø7,2×4,2 | OK | головка Ø7×4; остаток фланца 1,8 мм
LMK — винт | M4×12 | резьба 12 | OK | зацепление гайки 5 мм
LMK — гайка / углубление | M4 nyloc / 7,2×5 | 5 | OK | утоплена в стол, на клей
Кронштейн ролика — углубление в столе | Ø8×5 | Ø8×5 | OK | винт M4×16, головка Ø7×4
Кронштейн ролика — отверстие / паз | Ø5 / 10×5 | 5 / 5 | OK | регулировка по X
Кронштейн ролика — гайка | M4 nyloc | 5 мм | OK | снизу кронштейна
Отверстия под валы: стол / накладка | Ø11 / Ø12 | Ø11 / Ø12 | OK | зазор 0,5 / 1,0 мм
Валы — длина | 176 мм | 176 | OK | 166 + 5 мм с каждой стороны
Валы — резьба на концах | M10×15 | M10×15 | OK | с обоих торцов; Z=137…152 и 298…313
Валы — крепление | 2 гайки M10 + 2 шайбы Ø18 на вал | 2+2 | OK | снаружи средней и верхней поперечин; 8 Н·м
Валы — резьба вне LMK | LMK Z=190…225; резьба 137…152 / 298…313 | вне зоны LMK | OK | рабочая поверхность вала под LMK гладкая
Накладка — крепление | 4 × M4×20 потайной + гайки | 4 | OK | гайки снизу стола
Балка 21 — материал / длина | сталь 20×20×2 / 159.6 | 2 шт. | OK | прорезь R15×5 в верхней стенке
Балка 21 — прорезь 6200 | R15×5, ширина 9,4 | R15×5 | OK | без вкладыша; контакт по кромке
Балка 21 — отверстия под шпильки | 2 × Ø10, Y=60/140 | 2 | OK | сквозь верхнюю и нижнюю грани; X=10/150
Балка 21 — отверстия под накладки | 4 × Ø4,5, Y=30/45/155/170 | 4 | OK | Z=120; втулки 16×16×2 L=16
Балка 21 — втулки | 4 × 16×16×2 L=16 | 4 | OK | на балку
Накладки — количество | 8 | 8 | OK | 2 на конец балки
Накладки — толщина / ширина | 2 / 25 мм | 2 / 25 | OK | плоская; сталь
Накладки — лепестки | 50×50 | 50×50 | OK | вертикальный 25×50, горизонтальный 50×25
Накладки — перекрытие стойки | 20 мм | 20 | OK | упор без крепления; направляющая
Накладки — крепление к стойкам | нет | нет | OK | по fix11 п.7; отверстия/пазы в стойках убраны
Накладки — винты | 8 × M4×35 + 8 nyloc + 16 шайб | 8 | OK | 2 на конец балки; втулка 16×16×2 L=16
Накладки — пазы | нет | нет | OK | по fix11 п.1
Шпильки поджима — количество | 4 × M10 | 4 | OK | 2 на балку; строительные 4.6
Шпильки — длина / вылет | 117 / 5 мм | 117 / ≤5 | OK | низ 18, верх 135; над балкой 5
Шпильки — гнездо в нижней балке | Ø10, глубина 2 (верхняя стенка) | Ø10 | OK | низ не сверлить; низ шпильки 18
Шпильки — опора снизу | шайба + гайка nyloc на нижней балке | 1 + 1 | OK | Z=20…29,5; шпилька опирается на гайку
Шпильки — поджим балки | шайба + гайка снизу балки | 1 + 1 | OK | Z=100,5…110; сверху ничего
Шпильки — сверху | ничего не накручено | нет | OK | по fix11 п.3
Шпильки — зазор до нижних гаек валов | 5.5 мм | >2 | OK | верх 135; низ гайки вала 140,5; по Y разнесены на 10 мм
Шпильки — зазор до средней поперечины | 15.0 мм | >0 | OK | верх 135; низ поперечины 150
Шпильки — зазор до 6200 | 20.0 мм | >5 | OK | шпилька Y=60; 6200 начинается с Y=85
Ход балки вниз | 20 мм | 20 | OK | балка 130→110; 6200 освобождается
Зазор балки 21 — стойка | 0.2 мм | 0,2 | OK | накладки не крепятся к стойке
Балка 21 — после опускания | верх 110 < низа 6200 125 | <125 | OK
Съём балки — порядок | снять поджим, опустить и поднять балку | проверить | OK | шпильки/накладки не мешают; см. Assembly.md
Съём — подъём шпильки из гнезда | 2 мм | <8 | OK | низ 18→20; верх 137 < низа средней поперечины 150
Съём — верх шпильки | 5 мм | ≤5 | OK | не задевает нижние гайки валов (низ 140,5); по Y разнесены
Съём — балка над шпильками | 2 мм | ≤8 | OK | низ 18→20; верх шпильки 137 < 150; наклон вперёд
Материал шпилек поджима | 4.6 строительная | 4.6 | OK | fix11 п.10; не высокопрочная
Материал вала / оси | 8.8 / 8.8 | 8.8 | OK | fix11 п.8; высокопрочная
Комплектов вала привода | 3 (1 + 2 запасных) | 3 | OK | fix11 п.9; в сборке 1
Седло 6200: рама / балка | 150 / 130 | 5+5 мм | OK | 6200 Ø30; осевой зазор 0,2
Кулачок — ход | 3 / 5 / 10 | 2e | OK | e=1,5/2,5/5
Кулачок — макс./мин. радиус (диск 5) | 50 / 45 | 50 / 45 | OK | r(θ)=r0+e·cos2θ
Кулачок — 8×Ø10 R32 | 8 | 8 | OK | стенка 3 мм на минимуме диска 10 — предупреждение
Кулачок — шестигранник / буртик | 17,1 / Ø40×10 | 17,1 | OK | гайка M10 приварена к шпильке
Осевой стек кулачка | гайка + шайба + диск + шайба + гайка | без люфта | OK | контргайки с двух сторон
Ролик / ось | 6200 + M10 L=44 | Ø10 | OK | кронштейн 40×40×20×2
Пружина — L0 / установленная | 60 / 36 | 60 / 36 | OK | 4 шт.
Пружина — 4k / контакт 15/10 | 5,989 Н/мм / 111,8 Н | ≥2× | OK | из expert3; f_соб 12,8 Гц
f_соб стола | 12,8 Гц | вне 5…15 или демпфер | ВНИМАНИЕ | S3 expert3 остаётся; резиновые кольца — демпфер
Подстолье, X×Y×Z | 160.0×200.0×12.0 | 160×200×12 | OK | X=200…360, Y=0…200
Подстолье — крепление | 4 × M6×60 потайной | 4 | OK | гайки M6 приварены снизу балок
Подстолье — выступание винта | 22 мм | info | OK | 60−12−20−5=23; ниже гайки
Подстолье — хомуты | 2 × U M6 | 2 | OK | раствор 100
Подстолье — дрель Ø100 | 0,0 мм | прилегает | OK | ось Z=140; подстолье Z=190
Кожух — винты | 22 × M4×10, головка Ø7×4 | 22 | OK | резьба M4 в стенке 2 мм
Кожух — резьба в стенке | 2 мм | ≥2 (принято) | ВНИМАНИЕ | threadlocker; при ослаблении — бобышки
Габарит сборки | 382.0×218.0×313.0 | 382×218×313 | OK | X — стол −20 + заглушка 362; Y — головки 218; Z — 313 (верх вала)
Масса без дрели | 9.12 кг | — | OK | стальная рама/балка/уголки
Масса рамы | 4.19 кг | ≈4,4 | OK | 18 труб + втулки/гайки
Область печати | ≥210×210×30 | — | OK | рама и балка не печатаются
Рама — стол | 0.000 мм³ | <0,5 мм³ | OK
Рама — LMK10UU | 0.000 мм³ | <0,5 мм³ | OK
Рама — подстолье | 0.000 мм³ | <0,5 мм³ | OK
Рама — кулачок 5 | 0.000 мм³ | <0,5 мм³ | OK
Рама — балка 21 | 0.000 мм³ | <0,5 мм³ | OK
Рама — уголки | 0.000 мм³ | <0,5 мм³ | OK
Рама — вал привода | 0.000 мм³ | <0,5 мм³ | OK
Рама — направляющие валы | 0.000 мм³ | <0,5 мм³ | OK
Рама — гайки валов | 0.000 мм³ | <0,5 мм³ | OK
Рама — шайбы валов | 0.000 мм³ | <0,5 мм³ | OK
Рама — пружины | 0.000 мм³ | <0,5 мм³ | OK
Рама — шайбы пружин | 0.000 мм³ | <0,5 мм³ | OK
Рама — U-хомуты | 0.000 мм³ | <0,5 мм³ | OK
Рама — кронштейны | 0.000 мм³ | <0,5 мм³ | OK
Рама — кожух | 0.000 мм³ | <0,5 мм³ | OK
Рама — винты LMK | 0.000 мм³ | <0,5 мм³ | OK
Рама — болты подстолья | 0.000 мм³ | <0,5 мм³ | OK
Стол — кронштейн | 0.000 мм³ | <0,5 мм³ | OK
Стол — LMK10UU | 0.000 мм³ | <0,5 мм³ | OK
Стол — накладка | 0.000 мм³ | <0,5 мм³ | OK
Стол — вал привода | 0.000 мм³ | <0,5 мм³ | OK
Стол — направляющие валы | 0.000 мм³ | <0,5 мм³ | OK
Стол — подстолье | 0.000 мм³ | <0,5 мм³ | OK
Стол — уголки | 0.000 мм³ | <0,5 мм³ | OK
Стол — кожух | 0.000 мм³ | <0,5 мм³ | OK
Накладка — направляющие валы | 0.000 мм³ | <0,5 мм³ | OK
Кулачок — кронштейн | 0.000 мм³ | <0,5 мм³ | OK
Кулачок — ролик | 0.000 мм³ | <0,5 мм³ | OK
Кулачок — шайбы | 0.000 мм³ | <0,5 мм³ | OK
Кулачок — гайки | 0.000 мм³ | <0,5 мм³ | OK
Кулачок — контргайки | 0.000 мм³ | <0,5 мм³ | OK
Кронштейн — гайки ролика | 0.000 мм³ | <0,5 мм³ | OK
Балка 21 — уголки | 0.000 мм³ | <0,5 мм³ | OK
Накладки — винты | 0.000 мм³ | <0,5 мм³ | OK
Накладки — гайки | 0.000 мм³ | <0,5 мм³ | OK
Рама — шпильки поджима | 0.000 мм³ | <0,5 мм³ | OK
Балка 21 — шпильки поджима | 0.000 мм³ | <0,5 мм³ | OK
Шпильки — опора | 0.000 мм³ | <0,5 мм³ | OK
Шпильки — поджим | 0.000 мм³ | <0,5 мм³ | OK
Балка 21 — поджим | 0.000 мм³ | <0,5 мм³ | OK
Опора — рама | 0.000 мм³ | <0,5 мм³ | OK
Поджим — 6200 | 0.000 мм³ | <0,5 мм³ | OK
Уголки — вал привода | 0.000 мм³ | <0,5 мм³ | OK
Уголки — направляющие валы | 0.000 мм³ | <0,5 мм³ | OK
Уголки — LMK10UU | 0.000 мм³ | <0,5 мм³ | OK
Уголки — опорные 6200 | 0.000 мм³ | <0,5 мм³ | OK
Балка 21 — винты накладок | 0.000 мм³ | <0,5 мм³ | OK
Валы — гайки | 0.000 мм³ | <0,5 мм³ | OK
Валы — шайбы | 0.000 мм³ | <0,5 мм³ | OK
Гайки валов — шайбы | 0.000 мм³ | <0,5 мм³ | OK
Пружины — шайбы | 0.000 мм³ | <0,5 мм³ | OK
Шайбы — накладка | 0.000 мм³ | <0,5 мм³ | OK
Подстолье — U-хомуты | 0.000 мм³ | <0,5 мм³ | OK
Подстолье — вал привода | 0.000 мм³ | <0,5 мм³ | OK
Подстолье — LMK10UU | 0.000 мм³ | <0,5 мм³ | OK
U-хомуты — рама | 0.000 мм³ | <0,5 мм³ | OK
Вал привода — шайбы кулачка | 0.000 мм³ | <0,5 мм³ | OK
Вал привода — гайки кулачка | 0.000 мм³ | <0,5 мм³ | OK
Вал привода — контргайки кулачка | 0.000 мм³ | <0,5 мм³ | OK
Вал привода — гайки 6200 | 0.000 мм³ | <0,5 мм³ | OK
Вал привода — контргайки 6200 | 0.000 мм³ | <0,5 мм³ | OK
6200 — гайки 6200 | 0.000 мм³ | <0,5 мм³ | OK
6200 — контргайки 6200 | 0.000 мм³ | <0,5 мм³ | OK
Конусы 6200 — контргайки 6200 | 0.000 мм³ | <0,5 мм³ | OK
Конусы 6200 — рама | 0.000 мм³ | <0,5 мм³ | OK
Контргайки 6200 — рама | 0.000 мм³ | <0,5 мм³ | OK
Конусы 6200 — балка 21 | 0.000 мм³ | <0,5 мм³ | OK
Контргайки 6200 — балка 21 | 0.000 мм³ | <0,5 мм³ | OK
Конусы 6200 — уголки | 0.000 мм³ | <0,5 мм³ | OK
Контргайки 6200 — уголки | 0.000 мм³ | <0,5 мм³ | OK
Конусы 6200 — кулачок | 0.000 мм³ | <0,5 мм³ | OK
Контргайки 6200 — кулачок | 0.000 мм³ | <0,5 мм³ | OK
Кронштейн — ролик | 0.000 мм³ | <0,5 мм³ | OK
Кронштейн — ось | 0.000 мм³ | <0,5 мм³ | OK
Ролик — ось | 0.000 мм³ | <0,5 мм³ | OK
Винты LMK — LMK | 0.000 мм³ | <0,5 мм³ | OK
Гайки LMK — стол | 0.000 мм³ | <0,5 мм³ | OK
Винты кронштейна — стол | 0.000 мм³ | <0,5 мм³ | OK
Гайки кронштейна — стол | 0.000 мм³ | <0,5 мм³ | OK
Винты накладки — стол | 0.000 мм³ | <0,5 мм³ | OK
Гайки накладки — стол | 0.000 мм³ | <0,5 мм³ | OK
Болты подстолья — рама | 0.000 мм³ | <0,5 мм³ | OK
Болты подстолья — подстолье | 0.000 мм³ | <0,5 мм³ | OK
Кожух — саморезы | 0.000 мм³ | <0,5 мм³ | OK
Буферы — рама | 0.000 мм³ | <0,5 мм³ | OK
Буферы — стол | 0.000 мм³ | <0,5 мм³ | OK
Буферы — накладка | 0.000 мм³ | <0,5 мм³ | OK
Буферы — пружины | 0.000 мм³ | <0,5 мм³ | OK
Кольца — рама | 0.000 мм³ | <0,5 мм³ | OK
Кольца — валы | 0.000 мм³ | <0,5 мм³ | OK
Кольца — LMK | 0.000 мм³ | <0,5 мм³ | OK
Кольца — пружины | 0.000 мм³ | <0,5 мм³ | OK
Кулачок — приваренная гайка | 0.000 мм³ | <0,5 мм³ | OK
Шайбы — гайки кулачка | 0.000 мм³ | <0,5 мм³ | OK
Гайки — контргайки кулачка | 0.000 мм³ | <0,5 мм³ | OK
Шайбы — контргайки кулачка | 0.000 мм³ | <0,5 мм³ | OK
Рама — винты кожуха | резьбовое соединение M4 | допустимо | OK | винт ввёрнут в стенку 2 мм; пересечение резьбы не считается
Стол при ходе 5 мм, низ — рама | 0.000 мм³ | <0,5 мм³ | OK
Стол при ходе 5 мм, низ — балка 21 | 0.000 мм³ | <0,5 мм³ | OK
Стол при ходе 5 мм, низ — уголки | 0.000 мм³ | <0,5 мм³ | OK
Стол при ходе 5 мм, низ — направляющие | 0.000 мм³ | <0,5 мм³ | OK
Стол при ходе 5 мм, низ — подстолье | 0.000 мм³ | <0,5 мм³ | OK
Стол при ходе 5 мм, низ — кожух | 0.000 мм³ | <0,5 мм³ | OK
Стол при ходе 5 мм, верх — рама | 0.000 мм³ | <0,5 мм³ | OK
Стол при ходе 5 мм, верх — балка 21 | 0.000 мм³ | <0,5 мм³ | OK
Стол при ходе 5 мм, верх — уголки | 0.000 мм³ | <0,5 мм³ | OK
Стол при ходе 5 мм, верх — направляющие | 0.000 мм³ | <0,5 мм³ | OK
Стол при ходе 5 мм, верх — подстолье | 0.000 мм³ | <0,5 мм³ | OK
Стол при ходе 5 мм, верх — кожух | 0.000 мм³ | <0,5 мм³ | OK
Кулачок 3: макс. вверху — ролик | 0.000 мм³ | <0,5 мм³ | OK | верх стола 241
Кулачок 3: мин. вверху — ролик | 0.000 мм³ | <0,5 мм³ | OK | стол опущен на 3 мм
Кулачок 5: макс. вверху — ролик | 0.000 мм³ | <0,5 мм³ | OK | верх стола 241
Кулачок 5: мин. вверху — ролик | 0.000 мм³ | <0,5 мм³ | OK | стол опущен на 5 мм
Кулачок 10: макс. вверху — ролик | 0.000 мм³ | <0,5 мм³ | OK | верх стола 241
Кулачок 10: мин. вверху — ролик | 0.000 мм³ | <0,5 мм³ | OK | стол опущен на 10 мм
Балка 21, опущена на 20 мм — рама | 0.000 мм³ | <0,5 мм³ | OK
Балка 21, опущена на 20 мм — 6200 | 0.000 мм³ | <0,5 мм³ | OK
Балка 21, опущена на 20 мм — кулачок | 0.000 мм³ | <0,5 мм³ | OK
Накладки, опущены на 20 мм — рама | 0.000 мм³ | <0,5 мм³ | OK | без пазов; упор скользит по стойке
Блок, опущен на 44 мм — рама | 0.000 мм³ | <0,5 мм³ | OK
Блок, опущен на 44 мм — уголки | 0.000 мм³ | <0,5 мм³ | OK
Блок, опущен на 44 мм — стол | 0.000 мм³ | <0,5 мм³ | OK
Блок, опущен на 44 мм — кожух | 0.000 мм³ | <0,5 мм³ | OK
Блок, опущен и выдвинут вперёд — рама | 0.000 мм³ | <0,5 мм³ | OK
