inutcin/boomboom/stages/fix11/techdraw/shaft_cut_plan.csv

Пруток | Поз. | Длина, мм | Начало, мм | Конец, мм | Рез после, мм | Занято, мм | Остаток, мм | Примечание
1 | V01 | 176 | 0 | 176 | 176–181 | 362 | 138 | Ø10 h6; L=176 = 166 + 5×2; M10×15
1 | V02 | 176 | 181 | 357 | 357–362 | 362 | 138 | Ø10 h6; L=176 = 166 + 5×2; M10×15
2 | V03 | 176 | 0 | 176 | 176–181 | 362 | 138 | Ø10 h6; L=176 = 166 + 5×2; M10×15
2 | V04 | 176 | 181 | 357 | 357–362 | 362 | 138 | Ø10 h6; L=176 = 166 + 5×2; M10×15
Итого | 4 вала | 704 |  |  | 4 реза × 5 мм | 724 | 276 | 2 прутка × 500 мм
