inutcin/boomboom/stages/fix11/techdraw/cut_plan.csv

Труба | Поз. | Длина, мм | Начало, мм | Конец, мм | Рез после, мм | Занято, мм | Остаток, мм | Примечание
1 | T07 | 360 | 0 | 360 | 360–365 | 935 | 65 | 3×Ø4,5
1 | T08 | 360 | 365 | 725 | 725–730 | 935 | 65 | 3×Ø4,5
1 | T11 | 200 | 730 | 930 | 930–935 | 935 | 65 | 4×Ø6,6
2 | T01 | 260 | 0 | 260 | 260–265 | 950 | 50 | 2×Ø4,5
2 | T02 | 260 | 265 | 525 | 525–530 | 950 | 50 | 2×Ø4,5
2 | T03 | 260 | 530 | 790 | 790–795 | 950 | 50
2 | T05 | 150 | 795 | 945 | 945–950 | 950 | 50
3 | T09 | 160 | 0 | 160 | 160–165 | 990 | 10 | 3×Ø4,5
3 | T10 | 160 | 165 | 325 | 325–330 | 990 | 10 | 3×Ø4,5
3 | T13 | 160 | 330 | 490 | 490–495 | 990 | 10 | Ø10 только верхняя стенка
3 | T14 | 160 | 495 | 655 | 655–660 | 990 | 10 | Ø10 только верхняя стенка
3 | T15 | 160 | 660 | 820 | 820–825 | 990 | 10 | 2×Ø10,5; 3×Ø4,5
3 | T16 | 160 | 825 | 985 | 985–990 | 990 | 10 | 2×Ø10,5; 3×Ø4,5
4 | T17 | 160 | 0 | 160 | 160–165 | 955 | 45 | прорезь R15; 2×Ø10,5
4 | T18 | 160 | 165 | 325 | 325–330 | 955 | 45 | прорезь R15; 2×Ø10,5
4 | T04 | 260 | 330 | 590 | 590–595 | 955 | 45
4 | T12 | 200 | 595 | 795 | 795–800 | 955 | 45 | 4×Ø6,6
4 | T06 | 150 | 800 | 950 | 950–955 | 955 | 45
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
