inutcin/boomboom/stages/fix8/params.csv

Параметр | Значение | Ед. | Источник | Статус | Примечание
L_frame | 360.0 | мм | fix3: виброотсек −40 | fix3 | длина рамы
W_frame | 200.0 | мм | вид сверху, вид спереди | эскиз | ширина рамы
H_frame | 300.0 | мм | вид спереди | эскиз | высота виброотсека
L_vibro | 160.0 | мм | fix3: 200−40 | fix3 | длина виброотсека
L_ext | 200.0 | мм | фикс. вынос | fix3 | длина выноса дрели
tube | 20.0 | мм | fix1 п. 0 | fix1 | сечение балок рамы 20x20
frame_wall | 20.0 | мм | fix1 п. 0 | fix1 | сплошное сечение (без полости)
frame_material | PETG | — | принято | принято | печать одним куском
frame_fillet_r | 10.0 | мм | fix4 п.7: вогнутые галтели | fix4 | радиус галтелей R10
frame_gusset_n | 26 | шт | fix5 п.7: + вынос | fix5 | 20 в корпусе + 6 в выносе
frame_gusset_ext | 6 | шт | fix5 п.7: внутри балок выноса | fix5 | верх/низ выноса
base_h | 20.0 | мм | принято | принято | высота нижнего пояса
mid_z0 | 150.0 | мм | принято | принято | низ средней поперечины
mid_z1 | 170.0 | мм | mid_z0+tube | расчёт | верх средней поперечины
top_z0 | 280.0 | мм | H_frame−20 | расчёт | низ верхних балок
top_z1 | 300.0 | мм | H_frame | эскиз | верх рамы
ext_top_z0 | 170.0 | мм | принято | принято | низ верхних балок выноса
ext_top_z1 | 190.0 | мм | принято | принято | верх балок выноса (низ подстолья)
table_x0 | -20.0 | мм | fix1: вылет 20 спереди | fix1 | кромка стола по X
table_x1 | 180.0 | мм | fix3: L_vibro+20 | fix3 | кромка стола по X
table_y0 | 25.0 | мм | 200−20−5 | расчёт | кромка стола по Y (зазор 5)
table_y1 | 175.0 | мм | 200−20−5 | расчёт | кромка стола по Y (зазор 5)
table_t | 10.0 | мм | поз. 5 (3D-печать) | fix1 | толщина стола
table_z0 | 225.0 | мм | принято | принято | низ стола
table_z1 | 235.0 | мм | table_z0+table_t | расчёт | верх стола
table_overhang | 20.0 | мм | fix1 | fix1 | вылет стола за раму по X
side_gap | 5.0 | мм | fix1 | fix1 | зазор стола до боковых стоек
table_hole_d | 11.0 | мм | fix3: вал Ø10 + 1 | fix3 | Ø отверстия вала в столе
overlay_hole_d | 12.0 | мм | fix3: вал Ø10 + 2 | fix3 | Ø отверстия вала в накладке
overlay_t | 6.0 | мм | поз. 4 (3D-печать) | fix1 | толщина накладки
dish_dia | 140.0 | мм | вид спереди/сверху | принято | вогнутость накладки
dish_depth | 2.0 | мм | вид спереди | принято | глубина вогнутости
overlay_z0 | 235.0 | мм | table_z1 | расчёт | низ накладки
overlay_z1 | 241.0 | мм | overlay_z0+overlay_t | расчёт | верх накладки
overlay_inset | 5.0 | мм | принято | принято | отступ угловых M4 от кромки
guide_x1 | 10.0 | мм | fix1: центр передней поперечины | fix1 | вал 1, 3
guide_x2 | 150.0 | мм | fix3: центр граничной поперечины | fix3 | вал 2, 4
guide_y1 | 50.0 | мм | принято (фланец LMK на столе) | принято | вал 1, 2
guide_y2 | 150.0 | мм | принято (фланец LMK на столе) | принято | вал 3, 4
guide_span_x | 140.0 | мм | guide_x2−guide_x1 | расчёт | шаг валов по глубине
shaft_d | 10.0 | мм | поз. 2 | эскиз | вал Ø10
shaft_z0 | 142.0 | мм | под средней поперечиной | принято | низ вала
shaft_z1 | 308.0 | мм | над верхней поперечиной | принято | верх вала
shaft_guide_len | 166.0 | мм | shaft_z1−shaft_z0 | расчёт | длина направляющего вала
guide_hole_d | 10.5 | мм | фикс. в раме | fix1 | Ø отверстия вала в поперечинах
collar_d | 30.0 | мм | WCS10FR | fix1 | наружный Ø ограничителя
collar_t | 8.0 | мм | WCS10FR | fix1 | ширина ограничителя
spring_od | 17.0 | мм | fix8: оптимальная пружина expert3 | fix8 | наружный Ø пружины
spring_wire | 1.5 | мм | fix8: оптимальная пружина expert3 | fix8 | проволока
spring_free | 60.0 | мм | fix8: оптимальная пружина expert3 | fix8 | свободная длина L0
spring_inst | 36.0 | мм | 241…280 с шайбами | расчёт | установленная длина (геометрия не менялась)
spring_turns | 9.0 | шт | fix8: оптимальная пружина expert3 | fix8 | активных витков; концы закрытые/шлифованные
spring_washer_od | 18.0 | мм | fix1: шайбы пружин | fix1 | наружный Ø шайбы
spring_washer_id | 10.5 | мм | fix1: шайбы пружин | fix1 | внутренний Ø шайбы
spring_washer_t | 1.5 | мм | fix1: шайбы пружин | fix1 | толщина шайбы
lmk_body_d | 19.0 | мм | LMK10UU | fix1 | корпус линейного подшипника
lmk_body_h | 29.0 | мм | LMK10UU | fix1 | длина корпуса
lmk_flange | 40.0 | мм | LMK10UU | fix1 | квадратный фланец
lmk_flange_t | 6.0 | мм | LMK10UU | fix1 | толщина фланца
lmk_hole_pitch | 32.0 | мм | LMK10UU | fix1 | сетка крепёжных отверстий
lmk_hole_d | 4.5 | мм | LMK10UU | fix1 | Ø отверстий фланца
lmk_z0 | 190.0 | мм | 225−6−29 | расчёт | низ корпуса LMK
lmk_z1 | 225.0 | мм | table_z0 | расчёт | верх фланца LMK
drive_y | 100.0 | мм | ось симметрии | расчёт | ось вала привода
drive_z | 140.0 | мм | принято | принято | высота оси вала привода
shaft_x0 | -10.0 | мм | fix2: передняя контргайка снаружи | fix2 | левый конец вала
shaft_x1 | 215.0 | мм | fix3: 255−40 | fix3 | конец в патроне
shaft_len | 225.0 | мм | shaft_x1−shaft_x0 | расчёт | длина вала привода
shaft_fix_nut_len | 5.5 | мм | fix6: длина конуса | fix6 | конусная гайка на 6200
shaft_lock_w | 8.0 | мм | fix6: гайка M10 nyloc | fix6 | ширина контргайки M10
shaft_cone_big_d | 16.0 | мм | fix6: конус | fix6 | Ø большого торца конуса
shaft_cone_small_d | 12.0 | мм | fix6: конус у 6200 | fix6 | Ø малого торца конуса
shaft_fix_conical | 4 | шт | fix6: по 2 на 6200 | fix6 | конусные гайки на валу
shaft_fix_lock | 4 | шт | fix6: по 1 на конус | fix6 | контргайки M10 на конусах
bearing_x1 | 10.0 | мм | fix1: центр передней поперечины | fix1 | первый 6200
bearing_x2 | 150.0 | мм | fix3: центр граничной поперечины | fix3 | второй 6200
b6200_od | 30.0 | мм | поз. 9 | эскиз | 6200 наружный
b6200_id | 10.0 | мм | поз. 9 | эскиз | 6200 внутренний
b6200_w | 9.0 | мм | поз. 9 | эскиз | 6200 ширина
bearing_groove_r | 15.0 | мм | b6200_od/2 | расчёт | радиус седла 6200
bearing_groove_depth | 5.0 | мм | принято | принято | глубина седла в грани
bearing_pocket_w | 9.4 | мм | 9 + 2×0,2 | fix2 | ширина кармана 6200 по оси X
bearing_pocket_clear | 0.2 | мм | принято | fix2 | осевой зазор 6200 в кармане
bearing_pocket_shoulder | 5.3 | мм | (20−9,4)/2 | расчёт | плечо кармана в балке 20 мм
cam_x0 | 74.0 | мм | fix3: симметрично 10…150 | fix3 | левый торец кулачка
cam_x1 | 86.0 | мм | fix3: cam_x0+12 | fix3 | правый торец кулачка
cam_w | 12.0 | мм | cam_x1−cam_x0 | расчёт | ширина кулачка
cam_axis_x | 80.0 | мм | fix3: середина пролёта | fix3 | ось кулачка и ролика
cam_lobes | 2 | шт | fix4 п.1: 2 макс. и 2 мин. | fix4 | число лепестков
cam_rmax | 50.0 | мм | fix4: верхнее положение стола | fix4 | макс. радиус профиля
cam_rmin | 45.0 | мм | cam_rmax − cam_stroke_base | расчёт | мин. радиус профиля
cam_rbase | 47.5 | мм | (cam_rmax+cam_rmin)/2 | расчёт | средний радиус профиля
cam_ecc | 2.5 | мм | (cam_rmax−cam_rmin)/2 | расчёт | амплитуда профиля
cam_profile | r0+e·cos2θ | — | fix4 п.1: симметричный | fix4 | 2 лепестка, r(θ)=r(θ+π)
cam_flange_r | 52.0 | мм | cam_rmax+2 | расчёт | макс. радиус буртика
cam_groove_w | 9.5 | мм | ширина 6200 + 0,5 | принято | ширина ложбинки
cam_rim_angle | 58.0 | град | fix3: бортик скошен | fix3 | угол конуса бортика
cam_hole_n | 8 | шт | fix5 п.5: 2 макс + 2 мин + 4 между | fix5 | отверстий облегчения
cam_hole_d | 10.0 | мм | fix5 п.5: как в fix3 | fix5 | Ø отверстий облегчения
cam_hole_r | 32.0 | мм | fix5 п.5: единый радиус | fix5 | радиус отверстий 8×Ø10
cam_hex_af | 17.1 | мм | fix5 п.1: плотно под гайку M10 | fix5 | шестигранное отверстие 17,1 AF
cam_boss_d | 40.0 | мм | fix5 п.2: буртик | fix5 | Ø буртика
cam_boss_h | 10.0 | мм | fix5 п.2: высота 1 см | fix5 | высота буртика
cam_boss_x0 | 64.0 | мм | fix5 п.2: левая сторона | fix5 | начало буртика
cam_boss_x1 | 74.0 | мм | cam_x0 | fix5 | конец буртика
cam_washer_id | 10.5 | мм | fix5 п.4 | fix5 | внутренний Ø шайбы
cam_washer_n | 2 | шт | fix5 п.4: с двух сторон | fix5 | шайбы кулачка
weld_nut_af | 17.0 | мм | fix5 п.3: гайка M10 приварена | fix5 | гайка на шпильке
weld_nut_x0 | 74.0 | мм | fix5 п.3 | fix5 | начало приваренной гайки
weld_nut_x1 | 82.0 | мм | fix5 п.3 | fix5 | конец приваренной гайки
cam_chamfer | 0.0 | мм | fix5: фаски нет | fix5 | фаски вокруг отверстия нет
cam_notch_n | 0 | шт | fix5 п.2: насечки не нужны | fix5 | насечек нет
cam_notch_w | 0.0 | мм | fix5 п.2: насечки не нужны | fix5 | ширина насечки
cam_notch_len | 0.0 | мм | fix5 п.2: насечки не нужны | fix5 | длина насечки
cam_notch_depth | 0.0 | мм | fix5 п.2: насечки не нужны | fix5 | глубина насечки
cam_washer_od | 40.0 | мм | fix5 п.4: шайба по буртику | fix5 | наружный Ø шайбы
cam_washer_t | 2.5 | мм | fix5 п.4 | fix5 | толщина шайбы
cam_washer_ridge | 0.0 | мм | fix5 п.2: гладкая шайба | fix5 | без насечек
cam_washer_l_x0 | 61.5 | мм | fix5 п.4: левая шайба | fix5 | шайба у буртика
cam_washer_l_x1 | 64.0 | мм | cam_boss_x0 | fix5 | шайба у буртика
cam_washer_r_x0 | 86.0 | мм | cam_x1 | fix5 | правая шайба
cam_washer_r_x1 | 88.5 | мм | cam_washer_r_x0 + cam_washer_t | fix5 | правая шайба
cam_nut_l_x0 | 53.5 | мм | fix5 п.4: левая гайка | fix5 | гайка кулачка слева
cam_nut_l_x1 | 61.5 | мм | cam_washer_l_x0 | fix5 | гайка кулачка слева
cam_lock_l_x0 | 45.5 | мм | fix5 п.4: левая контргайка | fix5 | контргайка слева
cam_lock_l_x1 | 53.5 | мм | cam_nut_l_x0 | fix5 | контргайка слева
cam_nut_r_x0 | 88.5 | мм | cam_washer_r_x1 | fix5 | гайка кулачка справа
cam_nut_r_x1 | 96.5 | мм | fix5 п.4: правая гайка | fix5 | гайка кулачка справа
cam_lock_r_x0 | 96.5 | мм | cam_nut_r_x1 | fix5 | контргайка справа
cam_lock_r_x1 | 104.5 | мм | fix5 п.4: правая контргайка | fix5 | контргайка справа
cam_stroke_base | 5.0 | мм | R45…50 | эскиз | ход базового диска
cam_stroke_min | 3.0 | мм | сменный диск | эскиз | ход малого диска
cam_stroke_max | 10.0 | мм | сменный диск | эскиз | ход большого диска
roller_z | 205.0 | мм | drive_z+50+15 | расчёт | центр ролика
axle_d | 10.0 | мм | поз. 7 | эскиз | ось ролика M10
axle_len | 44.0 | мм | cam_axis_x±22 | расчёт | длина оси ролика
bracket_leg | 40.0 | мм | поз. 6 | эскиз | уголок 40x40x20x2
bracket_w | 20.0 | мм | поз. 6 | эскиз | ширина уголка
bracket_t | 2.0 | мм | поз. 6 | эскиз | толщина уголка
bracket_leg_x1 | 28.0 | мм | fix3: левая полка | fix3 | полка кронштейна 1
bracket_leg_x2 | 130.0 | мм | fix3: правая полка | fix3 | полка кронштейна 2
bracket_plate_x1 | 68.0 | мм | fix3 | fix3 | левая стойка кронштейна
bracket_plate_x2 | 92.0 | мм | fix3 | fix3 | правая стойка кронштейна
bracket_slot_x1 | 45.0 | мм | fix3: центр левой полки | fix3 | паз M4 в столе
bracket_slot_x2 | 110.0 | мм | fix3: центр правой полки | fix3 | паз M4 в столе
ret_z0 | 110.0 | мм | fix1: ниже поперечины | fix1 | низ балки 21
ret_z1 | 130.0 | мм | fix1: ниже поперечины | fix1 | верх балки 21
ret_y0 | 20.2 | мм | fix3: зазор 0,2 до стойки | fix3 | кромка балки 21
ret_y1 | 179.8 | мм | W_frame−ret_y0 | расчёт | кромка балки 21
ret_len | 159.6 | мм | ret_y1−ret_y0 | расчёт | длина балки 21
ret_material | PETG | — | fix1 | fix1 | сплошная 20x20
crab_t | 2.0 | мм | fix4: сталь 2 мм | fix3 | толщина накладки
crab_arm | 60.0 | мм | fix3: 60 на 60 | fix3 | длина полки уголка
crab_w | 20.0 | мм | fix3: шириной 20 | fix3 | ширина полки уголка
crab_z_top | 130.0 | мм | fix3: верх балки 21 | fix3 | верх горизонтальной полки
crab_z_beam | 110.0 | мм | fix3: низ балки 21 | fix3 | низ горизонтальной полки
crab_z_bot | 50.0 | мм | fix3: вертикальная полка вниз | fix3 | низ вертикальной полки
crab_slot_h | 20.0 | мм | fix3: паз-направляющая | fix3 | высота паза
crab_slot_z1 | 58.0 | мм | fix3 | fix3 | низ нижнего паза
crab_slot_z2 | 84.0 | мм | fix3 | fix3 | низ верхнего паза
crab_clamp_z1 | 61.0 | мм | fix3: прижимной болт 1 | fix3 | болт стяжки стойки 1
crab_clamp_z2 | 87.0 | мм | fix3: прижимной болт 2 | fix3 | болт стяжки стойки 2
crab_travel | 15.0 | мм | ход опускания (10 + 5 запас) | fix3 | ход балки вниз
crab_travel_req | 10.0 | мм | 5 (карман) + 5 (запас) | расчёт | нужный ход
crab_beam_bolt_z | 120.0 | мм | fix3: середина балки | fix3 | болт крепления к балке
crab_beam_bolt_y1 | 30.0 | мм | fix3 | fix3 | болт балки 1
crab_beam_bolt_y2 | 60.0 | мм | fix3 | fix3 | болт балки 2
crab_bolt_d | 4.0 | мм | fix3: M4 | fix3 | прижимной болт и болт балки
crab_bolt_len | 30.0 | мм | fix3: 3+20+3+гайка | fix3 | болт M4×30
podstol_x0 | 200.0 | мм | fix3: L_vibro+40 | fix3 | начало подстолья
podstol_x1 | 360.0 | мм | fix3: вровень с рамой | fix3 | конец подстолья
podstol_y0 | 0.0 | мм | fix2: вся ширина рамы | fix2 | кромка подстолья по Y
podstol_y1 | 200.0 | мм | fix2: вся ширина рамы | fix2 | кромка подстолья по Y
podstol_z0 | 190.0 | мм | ext_top_z1 | расчёт | низ подстолья
podstol_z1 | 202.0 | мм | podstol_z0+podstol_t | расчёт | верх подстолья
podstol_t | 12.0 | мм | fix1 | fix1 | толщина подстолья
podstol_rib | нет | — | fix3: рёбра убраны | fix3 | рёбер нет (п. 3)
podstol_bolt_x1 | 220.0 | мм | fix3 | fix3 | болт подстолья 1
podstol_bolt_x2 | 320.0 | мм | fix3 | fix3 | болт подстолья 2
podstol_bolt_y1 | 10.0 | мм | fix2 | fix2 | болт подстолья по Y=10
podstol_bolt_y2 | 190.0 | мм | fix2 | fix2 | болт подстолья по Y=190
podstol_bolt_len | 45.0 | мм | fix3: 12+20+гайка | fix3 | M6×45 с головкой сверху
podstol_nut_h | 5.0 | мм | M6 | расчёт | высота гайки M6
drill_d | 100.0 | мм | принято | принято | корпус дрели условно
drill_x0 | 210.0 | мм | fix3: 250−40 | fix3 | передняя точка корпуса
drill_x1 | 340.0 | мм | fix3: 380−40 | fix3 | задняя точка корпуса
drill_dir | против часовой | — | fix1 | fix1 | направление вращения
ubolt_x1 | 250.0 | мм | fix3: 290−40 | fix3 | первый хомут
ubolt_x2 | 300.0 | мм | fix3: 340−40 | fix3 | второй хомут
ubolt_inner | 100.0 | мм | поз. 12, R=90…100 | принято | раствор хомута
ubolt_leg | 70.0 | мм | принято | принято | длина ножки над осью
ubolt_d | 6.0 | мм | поз. 12, M6 | эскиз | диаметр хомута
flange_screw_len | 16.0 | мм | 6 (фланец)+10 (стол) | расчёт | M4 фланца LMK
overlay_screw_len | 20.0 | мм | 6+10+гайка | расчёт | M4 накладки
bracket_screw_len | 16.0 | мм | 10+2+гайка | расчёт | M4 кронштейна
m4 | 4.0 | мм | поз. 13, 15 | эскиз | потайной болт
m6 | 6.0 | мм | поз. 12, 18, 19 | эскиз | болт/гайка M6
m10 | 10.0 | мм | поз. 16, 17, 20 | эскиз | конусная/контрагайка, шпилька
shield_t | 5.0 | мм | fix4 п.2: 4…5 мм | fix4 | толщина поликарбоната
shield_x0 | 0.0 | мм | fix4: только виброотсек | fix4 | начало кожуха
shield_x1 | 160.0 | мм | fix4: вынос не закрываем | fix4 | конец кожуха
shield_side_y0 | -5.0 | мм | fix4: снаружи рамы | fix4 | наружная плоскость панели
shield_side_y1 | 205.0 | мм | fix4: снаружи рамы | fix4 | наружная плоскость панели
shield_z0 | 20.0 | мм | fix4: от нижней балки | fix4 | низ боковых панелей
shield_z1 | 280.0 | мм | fix4: до верхней балки | fix4 | верх боковых панелей
table_top_max | 241.0 | мм | overlay_z1 при макс. радиусе | расчёт | верхняя точка колебания
shield_skirt_z | 246.0 | мм | table_top_max + 5 | fix4 | низ бортиков
shield_skirt_gap | 5.0 | мм | fix4 п.2: запас 5 мм | fix4 | зазор до стола
shield_inner_front_x1 | 26.0 | мм | 20 + shield_t | fix4 | внутренний борт, перед
shield_inner_rear_x0 | 134.0 | мм | 140 − shield_t | fix4 | внутренний борт, зад
shield_inner_left_y1 | 26.0 | мм | 20 + shield_t | fix4 | внутренний борт, левый
shield_inner_right_y0 | 174.0 | мм | 180 − shield_t | fix4 | внутренний борт, правый
shield_screw_d | 4.0 | мм | fix4 п.2: саморез | fix4 | саморез с прижимной шляпкой
shield_screw_len | 16.0 | мм | fix4 п.2 | fix4 | длина самореза
shield_screw_head | 8.0 | мм | fix4 п.2: прижимная шляпка | fix4 | Ø шляпки
shield_screw_n | 22 | шт | fix5 п.8: без внутренних бортиков | fix5 | 16 боковых + 6 наружных
shield_plates_n | 4 | шт | fix5 п.8: 2 панели + 2 бортика | fix5 | внутренних бортиков нет
shield_inner_n | 0 | шт | fix5 п.8: не нужны | fix5 | защита — резиновые ограничители
shield_pilot_d | 3.5 | мм | fix4: пилот под саморез | fix4 | Ø отверстия в PETG
rubber_pad_n | 4 | шт | fix5 п.6: 1 на угол | fix5 | буферы в углах балка-стойка
rubber_pad_x | 20.0 | мм | ширина верхней балки | fix4 | размер буфера по X
rubber_pad_w | 19.0 | мм | fix5: от стойки до пружины | fix5 | размер буфера по Y
rubber_pad_z0 | 244.0 | мм | table_top_max + 3 | fix4 | низ буфера
rubber_pad_z1 | 280.0 | мм | top_z0 | расчёт | верх буфера
rubber_gap_spring | 5.0 | мм | fix4 п.4 | fix4 | зазор буфер — пружина
rubber_gap_table | 3.0 | мм | fix4 п.4 | fix4 | зазор буфер — стол
ring_n | 4 | шт | fix4 п.5: на каждый вал | fix4 | кольца под LMK
ring_id | 10.5 | мм | fix4 п.5: сантех. прокладка | fix4 | внутренний Ø
ring_od | 18.0 | мм | fix4 п.5 | fix4 | наружный Ø
ring_h | 7.0 | мм | fix4 п.5: кусок шланга | fix4 | высота кольца
ring_z0 | 170.0 | мм | верх средней поперечины | расчёт | низ кольца
ring_z1 | 177.0 | мм | ring_z0 + ring_h | расчёт | верх кольца
ring_gap | 3.0 | мм | fix4 п.5: до нижней границы 10 мм | fix4 | зазор до LMK при диске 10 мм
cartridge_n | 1 | компл. | fix4 п.6: общий блок | fix4 | вал + кулачок + 6200
print_vol_x | 370.0 | мм | L_frame+10 | расчёт | минимальная область печати
print_vol_y | 210.0 | мм | W_frame+10 | расчёт | минимальная область печати
print_vol_z | 310.0 | мм | H_frame+10 | расчёт | минимальная область печати
