inutcin/boomboom/stages/fix10l/cad/mass.csv

Узел | Поз. | Материал | Объём, см³ | Кол. | Масса, г
studs | 1/2 | steel | 128.81 | 6 | 1011.1
beams_long | 12 | steel | 112.54 | 2 | 883.4
beams_trans | 13 | steel | 55.43 | 2 | 435.1
table | 6 | plywood | 394.18 | 1 | 236.5
overlay | 7 | pla | 161.41 | 1 | 200.2
top_platform | 9 | plywood | 252.2 | 1 | 151.3
base | 10 | plywood | 1872.1 | 1 | 1123.3
podstol | 11 | plywood | 395.61 | 1 | 237.4
spring_pads | 8 | plywood | 47.09 | 2 | 28.3
springs | 15 | steel | 3.13 | 4 | 24.6
spring_washers | 5 | steel | 3.64 | 8 | 28.6
bumpers | 16 | rubber | 4.75 | 4 | 5.5
nuts | 3 | steel | 31.43 | 24 | 246.7
jam_nuts | 36 | steel | 34.05 | 26 | 267.3
nyloc_nuts | 35 | steel | 18.33 | 12 | 143.9
washers | 4 | steel | 11.83 | 26 | 92.9
shaft_nuts | 3 | steel | 5.24 | 4 | 41.1
shaft_jams | 37 | steel | 5.24 | 4 | 41.1
shaft_washers | 4 | steel | 3.64 | 8 | 28.6
drive_shaft | 17 | steel | 17.75 | 1 | 139.3
weld_nut | 18 | steel | 1.35 | 1 | 10.6
cam | 19 | pla | 85.38 | 1 | 105.9
cam_washers | 20 | steel | 0.91 | 2 | 7.1
cam_nuts | 21 | steel | 2.62 | 2 | 20.6
axle | 22 | steel | 3.46 | 1 | 27.1
roller | 23 | bearing | 5.64 | 1 | 44.3
roller_nuts | 24 | steel | 2.62 | 2 | 20.6
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
