inutcin/boomboom/stages/fix8/cad/mass.csv

Узел | Поз. | Материал | Объём, см³ | Кол. | Масса, г
frame | 22 | petg | 1484.67 | 1 | 1885.5
table | 5 | pla | 292.5 | 1 | 362.7
overlay | 4 | pla | 161.41 | 1 | 200.2
podstol | 11 | petg | 380.91 | 1 | 483.8
shaft | 2 | steel | 52.15 | 4 | 409.4
collar | 1 | steel | 40.11 | 8 | 314.9
spring | 3 | steel | 3.13 | 4 | 24.6
spring_washer | 25 | steel | 2.01 | 8 | 15.8
lmk | 8 | bearing | 58.55 | 4 | 459.6
drive_shaft | 20 | steel | 19.05 | 1 | 149.5
cam | 10 | pla | 85.38 | 1 | 105.9
shaft_bearings | 9 | bearing | 11.28 | 2 | 88.6
cam_washers | 33 | steel | 5.85 | 2 | 45.9
cam_nuts | 34 | steel | 2.7 | 2 | 21.2
cam_locknuts | 16 | steel | 2.7 | 2 | 21.2
shaft_conical_nuts | 17 | steel | 1.61 | 4 | 12.7
shaft_locknuts | 16 | steel | 5.39 | 4 | 42.3
roller | 9 | bearing | 5.64 | 1 | 44.3
axle | 7 | steel | 3.46 | 1 | 27.1
roller_nuts | 16/17 | steel | 3.5 | 4 | 27.5
bracket | 6 | steel | 5.82 | 2 | 45.7
retainer | 21 | petg | 123.68 | 2 | 157.1
angles | 14 | steel | 41.09 | 8 | 322.6
ubolts | 12 | steel | 17.33 | 2 | 136.1
ubolt_nuts | 12/19 | steel | 1.64 | 8 | 12.9
podstol_bolts | 18 | steel | 5.75 | 4 | 45.1
podstol_nuts | 27 | steel | 1.64 | 4 | 12.9
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
