inutcin/boomboom/stages/fix1/cad/mass.csv

Узел | Поз. | Материал | Объём, см³ | Кол. | Масса, г
frame | 22 | petg | 1708.24 | 1 | 2169.5
table | 5 | pla | 352.84 | 1 | 437.5
overlay | 4 | pla | 198.05 | 1 | 245.6
podstol | 11 | petg | 406.51 | 1 | 516.3
shaft | 2 | steel | 52.15 | 4 | 409.4
collar | 1 | steel | 40.11 | 8 | 314.9
spring | 3 | steel | 1.22 | 4 | 9.5
spring_washer | 25 | steel | 2.01 | 8 | 15.8
lmk | 8 | bearing | 58.55 | 4 | 459.6
drive_shaft | 20 | steel | 20.03 | 1 | 157.2
cam | 10 | pla | 85.57 | 1 | 106.1
shaft_bearings | 9 | bearing | 11.28 | 2 | 88.6
conical_nuts | 17 | steel | 1.47 | 2 | 11.5
locknuts | 16 | steel | 3.37 | 2 | 26.5
roller | 9 | bearing | 5.64 | 1 | 44.3
axle | 7 | steel | 3.46 | 1 | 27.1
roller_nuts | 16/17 | steel | 3.5 | 4 | 27.5
bracket | 6 | steel | 5.9 | 2 | 46.3
retainer | 21 | petg | 122.35 | 2 | 155.4
crabs | 14 | steel | 13.55 | 4 | 106.3
ubolts | 12 | steel | 17.33 | 2 | 136.1
ubolt_nuts | 12/19 | steel | 1.64 | 8 | 12.9
podstol_bolts | 18 | steel | 3.87 | 4 | 30.4
flange_screws | 23 | steel | 4.14 | 16 | 32.5
table_screws | 13 | steel | 1.6 | 6 | 12.5
table_nuts | 15 | steel | 0.52 | 6 | 4.1
crab_screws | 24 | steel | 2.86 | 12 | 22.5
ИТОГО |  |  |  |  | 5625.8
