inutcin/boomboom/stages/fix10l/Interview.md

# Интервью по этапу «Первая версия орочьего вибростола»

Дата: 2026-11-02
Этап: `stages/fix10l`
База: [`stages/fix9`](../fix9/README.md)

Этап — отдельная «орочья» ветвь. Полная имперская версия (наследник fix9)
остаётся без суффикса. В этап входят только требования
[`README.md`](./README.md); остальные замечания expert2/expert3 — в отчёте.

## 1. Вопросы и решения

**В1. Ориентация стола и накладки?**

Первоначально принято: стол **200 по глубине × 150 по ширине**, накладка
fix9 200×150 без поворота. При увеличении выреза верхней платформы до
**120×120** это перестало помещаться: шпильки и шайбы пружин попадали в
вырез. По согласованию принято:

- стол **200×200** (фанера 10 мм);
- накладка fix9 **200×150 по центру** (Y=25…175);
- шпильки виброотсека **Y=15/185**, X=30/175;
- пружины опираются на **стол вне накладки**, через две полосы 200×25×5;
- накладка крепится к столу 4 саморезами M4×12 и **не имеет отверстий под
  шпильки**.

**В2. Сколько шпилек?**

Принято: **6 шпилек M10** — 4 в виброотсеке + 2 задние под подстолье.
Задние шпильки X=385, Y=15/185. Это исключает консольное крепление дрели.

**В3. Чем заменить нижнюю демпферную пружину?**

Принято: **4 резиновых кольца** Ø30/12×2, без преднатяга. Они не уменьшают
прижим ролика и работают только как страховка внизу. Зазор до стола 11 мм;
при ходе 10 мм остаётся 1 мм.

**В4. Материал стола?**

Принято: **фанера 10 мм**. Накладка и кулачки — переиспользование fix9;
новых печатных деталей нет.

**В5. Сколько опор вала привода?**

Принято: **две опоры скольжения** — в передней и задней поперечных балках
20×20×2. Вал M10 проходит через оба отверстия Ø10,2; кулачок между опорами.
Это жёстче, чем одна опора, и уменьшает консоль кулачка.

**В6. Кулачок: R45/50 или R55/60?**

На эскизе пользователя указаны `Rmin=55`, `Rmax=60` (Ø120), но README
требует переиспользовать напечатанные диски fix9. Принято:
**переиспользовать fix9 R45/50** (Ø100). Расхождение с эскизом зафиксировано;
при необходимости Ø120 — отдельный этап с новыми дисками и другим ходом.

**В7. Вырез верхней платформы?**

Принято: **120×120** (X=40…160, Y=40…160). Для этого стол расширен до
200×200; шпильки вынесены на Y=15/185; пружины перенесены на свободные
полосы стола. Это единственный вариант сохранить прямоугольный вырез
120×120 при накладке 150 мм.

**В8. Материалы и крепёж?**

- шпильки — M10, резьба по всей длине;
- балки — труба 20×20×2, все резы 90°;
- фанера 10 мм (стол, платформа, подстолье), 20 мм (основание),
  5 мм (полосы пружин);
- кронштейн ролика — два уголка 50×50×2, ширина 20, 4 самореза M4×12
  на каждый;
- U-болты M6 R70 + резиновые полукольца Ø100/134;
- кулачок на приваренной к новому валу гайке M10 (X=94…102).

**В9. Что с кожухом и приводом?**

Кожух (C1) и муфта/патрон (C2) в этап не входят; отмечены как остатки.
Дрель — условная модель Ø100, в массу не входит.

**В10. Центровка ролика?**

Принято: старый вал с приваренной гайкой **не переиспользуется**. Новый вал
M10 L=220; гайка M10 приварена в X=94…102. Кулачок fix9 сдвинут на +20 по X
(84…106), ролик — X=100, Y=100: **точно середина стола 200×200**. Кронштейн
и ось ролика сдвинуты вместе с кулачком.

**В11. Крепление накладки?**

Принято: **4 самореза M4×12** — тот же тип, что у кронштейна ролика.
Пилотные отверстия в столе — глухие, 6 мм; сквозные отверстия и гайки не
нужны.

**В12. Крепление подстолья к продольным балкам?**

Принято: подстолье держится на двух задних шпильках M10 (**nyloc** сверху)
и дополнительно притянуто **болтом M10×50** в свободной части (X=250,
Y=15). Саморезы/винты подстолья из модели убраны.

**В13. Шайбы пружин?**

Принято: те же M10, что и везде — **Ø20/Ø10,5×2 мм**. Из-за толщины 2 мм
низ пружины опущен: подкладки 5 мм, шайба 240…242, пружина 242…278,
верхняя шайба 278…280, платформа 280. Установленная длина пружины — 36 мм.

**В14. Подкладки пружин?**

Принято вместо четырёх квадратов — **две полосы 200×25×5 мм** из фанеры:
левая Y=0…25, правая Y=175…200, во всю длину стола X=0…200. В каждой по
2 отверстия Ø12 под шпильки (X=30/175) и 3 отверстия Ø4,2 под саморезы
M4×12 (X=60/100/140). Крепление к столу — 6 саморезов; толщина 5 мм
сохраняет пружину 36 мм и платформу на Z=280.

**В15. Nyloc и контрагайки?**

Принято:
- nyloc M10 — низ станины (6), верх подстолья (2), верх платформы (4),
  ось ролика (2), болт подстолья (1); всего 15;
- контрагайки M10 обычные h=8 — все неоконцовочные крепления шпилек
  (26 шт.; верх подстолья — только nyloc);
- контрагайки оси вала — 4 шт. (по одной на каждую стопку).

**В16. Вал привода?**

Принято: вал M10 L=226. Он выходит за каждую поперечную балку на 20 мм.
С каждой стороны каждой балки — **2 шайбы, гайка и контрагайка**; гайка
и контрагайка стянуты между собой, но не прижимаются к балке (зазор
0,5 мм), чтобы вал свободно вращался. Балки: X=20…40 и 165…185.

**В17. Крепление свободной части подстолья?**

Принято: **болт M10×50**, головка сверху, тело через подстолье и обе
стенки продольной балки (X=250, Y=15); снизу — шайба и **nyloc M10**.
В ТЗ указана гайка M4 при болте M10 — это несовместимо; принят M10 nyloc
по болту. Если нужен M4, заменить болт на M4×40 и гайку на M4 nyloc.

**В18. Верх подстолья?**

Принято: на двух задних шпильках — **только nyloc M10**, без
контрагаек. Контрагайки остаются на балках/основании, но не на
подстолье.

**В19. Заглушки торцов труб?**

Принято: **не применяются** — убраны по решению пользователя. Торцы труб
остаются открытыми.

**В20. Высота контрагаек?**

Принято: вместо тонких h=4 — **обычные M10 h=8**. Из-за этого основание
утолщено с 20 до 24 мм (цековки Ø22×20), продольные балки подняты на
Z=174…194, подстолье — Z=194…204, демпферы (Ø30/12×2) — Z=212…214.
Зазор демпфер–стол 11 мм.

## 2. Принятые допущения

| Вопрос | Принято | Почему |
|---|---|---|
| Амплитуда | размах 3/5/10 мм | как fix8/expert3 |
| Пружины | 4×Ø17×1,5×60, L=36 | fix8/expert3 |
| Шайбы пружин | Ø20/Ø10,5×2 | как общие M10 |
| Подкладки пружин | 2 полосы 200×25×5; 6 саморезов | от края стола до накладки |
| Nyloc | 15 шт. | низ станины, подстолье, платформа, ролик, болт |
| Контрагайки шпилек | 26 обычных h=8 | основание и балки; подстолье — nyloc |
| Болт подстолья | M10×50 + nyloc | головка сверху, гайка снизу |
| Вал | M10 L=226; 4 стопки | 2 шайбы + гайка + jam с каждой стороны |
| f_соб | ≈14,9 Гц (m≈685 г) | на верхней границе 5…15 |
| Шпильки | 6×M10 | 4+2, подстолье не консольное |
| Стол | фанера 200×200×10 | вырез 120×120, минимум печати |
| Накладка | fix9 200×150, без изменений | требование README |
| Кулачки | fix9 3/5/10, R45/50 | требование README |
| Вал | M10, новый вал, приваренная гайка | две опоры скольжения; ролик в центре |
| Ролик | X=100 (центр стола) | требование пользователя |
| Накладка | 4 самореза M4×12 | тот же тип, что у кронштейна |
| Подстолье | 2 задние шпильки | отдельный крепёж не нужен |
| Кулачок | приваренная гайка M10 | вал не переиспользуется |
| Демпфер | резина Ø30/12×2 | не отрывает ролик |
| Крепёж | M10/M6/M4, саморезы | доступно в строительном магазине |
| Допуск | ±1…2 мм; отверстия по месту | ручная сборка |
| Смазка | графит/литол по шпилькам | сталь по стали |
| Масса | по объёмам и плотностям | без дрели |

## 3. Что не проверялось

1. Усталость/ресурс шпилек, балок, уголков и саморезов 10^6 циклов.
2. Износ вала M10 в отверстиях Ø10,2 поперечных балок; люфт после обкатки.
3. Динамика с шариком, удар, податливость фанеры/PLA, шум, резонанс.
4. Точные k/L0/ID пружин и их паспорт.
5. Гармонический профиль кулачка (C8) и контакт по идеальной синусоиде.
6. Демпфирование (S3), регулировка преднатяга (S6).
7. Привод/дрель, патрон, биение, хвостовик (C2).
8. Ограждение/аварийный останов (C1).
9. Реальная технология раскроя/сверления и допуски конкретной мастерской.
10. Масса по реальным деталям (в модели — по объёмам и плотностям).

## 4. Противоречия и предложения

1. **Вырез 120×120 vs накладка 150 мм.** Прямоугольный вырез 120×120
   несовместим с проходом шпилек через накладку 150 мм. Принято: стол
   200×200, шпильки только через стол, пружины на столе.
2. **Кулачок R55/60 на эскизе vs R45/50 fix9.** Принят fix9; новые диски —
   отдельный этап.
3. **Нижняя пружина.** Заменена резиновыми кольцами, чтобы не уменьшать
   прижим ролика.
4. **Две опоры вала.** README говорит «в отверстии поперечной балки»;
   принято две балки — передняя и задняя. Это не противоречит идее, но
   добавляет вторую балку.
5. **Кожух.** В «орочьей» версии отсутствует; при работе с вращающимся
   кулачком и пружинами требуется отдельное ограждение.
6. **Вал с приваренной гайкой.** Старый вал fix9 не переиспользуется;
   гайка переварена под центр стола, ролик X=100.
7. **Болт M10 / гайка M4.** В ТЗ указана гайка M4 при болте M10 —
   несовместимо; принят M10 nyloc по болту. Это зафиксировано; при
   необходимости M4 — заменить болт и гайку.
7. **Крепёж накладки/подстолья.** Накладка — 4 самореза M4×12; подстолье —
   только 2 задние шпильки. Это упрощает «орочью» версию.

## 5. Связь с предыдущими этапами

- `fix9` — рама, LMK10UU, направляющие валы, 6200, балка 21; в fix10l
  заменены шпильками и фанерой.
- `fix8`/`expert3` — пружины Ø17×1,5×60, установленная 36 мм; сохранены.
- `fix9` — накладка импортируется без изменений; кулачки — без изменений
  по геометрии, сдвинуты на +20 по X под центр стола.
- `expert3` — f_соб и контакт; пересчитаны для массы 685 г: f_соб≈14,9 Гц,
  контакт по-прежнему с запасом, но требует демпфера/испытаний.
