inutcin/boomboom/stages/fix9/Interview.md

# Интервью по этапу «Вторая корректировка после третьей инженерной экспертизы»

Дата: 2026-11-02
Этап: `stages/fix9`
База: [`stages/fix8`](../fix8/README.md)

Этап выполняет **только 7 замечаний** [`README.md`](./README.md). Остальные
C1–C8, I1–I23, W1–W8 (expert2) и S3, S5, S6 (expert3) в этап не входят и
перечислены в отчёте как остатки.

## 1. Вопросы и решения

**В1. Амплитуда — размах или нуль-пик?**

Принято: **размах (peak-to-peak) 3/5/10 мм**, как в fix8 и expert3. Для
нуль-пик 3/5/10 нужен другой комплект дисков/пружин — отдельный этап.

**В2. Материал и конструкция рамы?**

Принято по замечанию 6: **сварная сталь 20×20×2**. Все резы 90°, стыки 45°
не допускаются; стойки — один кусок трубы; верхние балки виброотсека лежат
на стойках; стойки опираются на нижние продольные балки.

**В3. Седла 6200 — вкладыши или прорезь?**

Принято по решению пользователя: **прорезь в стенке трубы 2 мм**, без
вкладыша. Это относится к раме и к балке 21. Контакт идёт по кромке стенки
2 мм; в проверках — предупреждение, после обкатки проверить смятие/люфт.

**В4. Балка 21 — материал?**

Принято: **стальная труба 20×20×2**, L=159,6. Внутренние втулки
16×16×2, L=16 — 8 шт. (по 4 на балку); заглушки 16×16 — 4 шт.

**В5. Крепление LMK10UU — длина винта?**

Принято по решению пользователя: **M4 с резьбовой частью 12 мм** (M4×12),
а не 10 мм. Это даёт зацепление гайки 5 мм при углублении в столе 5 мм.
Головка Ø7×4 входит в цековку фланца LMK 4×Ø7,2×4,2; остаток фланца
1,8 мм. Гайка M4 nyloc — в шестигранном углублении 7,2 AF×5 стола, на клей,
заподлицо; сверху закрыта накладкой.

**В6. Кожух — как крепить?**

Принято по замечанию 2: **22 винта M4×10 с цилиндрической головкой Ø7×4**,
без гаек; резьба M4 нарезается в стенке рамы 2 мм. Резьба в стенке 2 мм
даёт ~2 мм зацепления; в проверках — предупреждение, в сборке — фиксатор
резьбы. При ослаблении предусмотреть приварные бобышки/заклёпочные гайки.

**В7. Подстолье — крепление?**

Принято по замечанию 3: **4 потайных M6×60**, зенковка Ø12/90° в подстолье;
гайки M6 приварены снизу верхних балок выноса. Выступание винта ниже гайки
≈22 мм — в проверках как info.

**В8. Кронштейн ролика — крепление?**

Принято по замечанию 4: **M4×16 с цилиндрической головкой Ø7×4**, гайка
M4 nyloc. Сверху стола — углубление Ø8×5; отверстие в столе Ø5; в
кронштейне — вытянутый паз 10×5.

**В9. Уголок-накладка — геометрия?**

Принято по замечанию 5 и уточнению пользователя:

- уголок **плоский**, сталь **2 мм** (не 5);
- 8 шт., по 2 на конец балки;
- лепестки **80×80**; ширина **25 мм**; без выреза под стойку
  (верхний паз проходит и через горизонтальную полку над стойкой);
- наружная кромка по Y **вровень** с рамой (Y=0/200), внутрь +5 мм;
- регулировочные пазы 2×26,6×6,6 с концами **R3** остаются на
  средней оси стойки Y=10/190, т.е. смещены на 2,5 мм от центра
  25-мм лепестка; ход увеличен до **20 мм**;
- отверстия в стойке — Ø6,6, Y=10/190, Z=59/94: верхнее 104→94
  (−10), нижнее 74→59 (−15), шаг 30→35; верхний паз заходит в
  горизонтальную полку на 7,3 мм вместо 17,3;
- крепление к балке — 2 болта M6×40 с шестигранной головкой, гайка
  nyloc, шайбы Ø18/Ø6,4×1,6 с двух сторон;
- крепление к стойке — 2 болта M6×40, пазы 26,6 мм с R3
  обеспечивают ход 20 мм;
- в стойках и балке — распорные втулки 16×16×2, L=16;
- M6×40 при стеке 1,6+2+20+2+1,6+5 = 32,2 мм даёт вылет ≈7,8 мм;
  шайбы Ø18/Ø6,4×1,6 с каждой стороны; в проверке — info.

**В10. Заглушки?**

Принято: **10 заглушек в раме**: 6 наружных 20×20×6 (нижние продольные 4 и
верхние выноса сзади 2) + 4 внутренних 16×16×4 в верхних торцах
виброотсека (под кожухом), и **4 заглушки 16×16×5** в торцы балки 21.

**В11. Что с остальными замечаниями?**

Не выполнялись. В отчёте — остатки C1–C8, I1–I23, W1–W8, S3, S5, S6.

## 2. Принятые допущения

| Вопрос | Принято | Почему |
|---|---|---|
| Амплитуда | размах 3/5/10 мм | как fix8 |
| Рама | сталь 20×20×2, сварка | замечание 6 |
| Седла 6200 | прорезь R15×5 в стенке 2 мм | решение пользователя |
| Балка 21 | сталь 20×20×2, прорезь | решение пользователя |
| LMK | M4×12 | решение пользователя |
| Уголки | плоские 2 мм, 80×80, ширина 25, 8 шт.; ход 20 | замечание 5 + уточнения |
| Подстолье | M6×60, приварные гайки | замечание 3 |
| Кожух | M4×10, резьба в раме 2 мм | замечание 2 |
| Заглушки | 6×20×20 + 4×16×16 (рама); 4×16×16 (балка) | замечание 7 |
| Материал рамы | сталь Ст3/09Г2С | принято |
| Допуск рамы | ±1 мм; диагонали ±1 мм | принято |
| Отверстия валов | сверлить после сварки по кондуктору | принято |
| Седла | фрезеровать после сварки | принято |
| Моменты | см. `torque.csv` | ориентировочно |

## 3. Что не проверялось

1. Усталость/ресурс рамы, балки 21, уголков и сварных швов 10^6 циклов.
2. Реальная прочность седла 6200 в стенке 2 мм; смятие/люфт после обкатки.
3. Динамика с шариком, удар, податливость PLA, шум, резонанс рамы.
4. Точные k/L0/ID покупной пружины и её паспорт.
5. Гармонический профиль кулачка (C8) и контакт по идеальной синусоиде.
6. Демпфирование (S3), регулировка преднатяга (S6).
7. Привод/дрель, патрон, хвостовик, биение (C2).
8. Ограждение/аварийный останов (C1).
9. Реальная технология сварки/мехобработки и допуски конкретного производства.
10. Масса по реальным деталям (в модели — по объёмам и плотностям).

## 4. Противоречия и предложения

1. **Седло 6200 в стенке 2 мм** — принято, но контакт по кромке; при
   появлении люфта/смятия добавить стальную накладку/вкладыш отдельным
   этапом.
2. **Резьба M4 в стенке 2 мм** — для кожуха допустима, но слабая; при
   ослаблении — приварные бобышки или заклёпочные гайки.
3. **M6×40 при уголках 2 мм** — вылет ~7,8 мм; шайбы Ø18/Ø6,4×1,6
   с двух сторон; по замечанию оставлен M6×40.
4. **Балки выноса** — лежат на задних коротких стойках; к средней высокой
   стойке — Т-стык без разреза стойки; это соответствует «стойки одним
   куском», но не «балка сверху на стойке» для средней стойки. Отражено на
   листе `frame_tubes.svg`.
5. **README проекта** — толщина стенки исправлена с 1,5 на 2 мм, чтобы не
   противоречить замечанию 6 и модели.

## 5. Связь с предыдущими этапами

Основание — `stages/fix8` (пружины 4×Ø17×1,5×60, 9 витков) и
`stages/expert3` (контакт 111,8 Н, запас 2,72×). В fix9 пружины, кулачок,
валы, 6200, ролик, кожух (геометрия) и подстолье (геометрия) не менялись;
изменены рама, балка 21, уголки, крепёж стола/кожуха/подстолья/кронштейнов
и заглушки.
