inutcin/boomboom/stages/fix8/Interview.md

# Интервью по этапу «Первая корректировка после третьей инженерной экспертизы»

Дата: 2026-10-30
Этап: `stages/fix8`
База: [`stages/fix7`](../fix7/README.md)

Вопросы ниже — уточнения к выбранной оптимальной пружине для размаха
3/5/10 мм. Все решения продублированы в [`params.csv`](./params.csv),
[`spec.csv`](./spec.csv) и [`cad/checks.csv`](./cad/checks.csv).

## 1. Вопросы и решения

**В1. Какая амплитуда имеется в виду — размах или нуль-пик?**

Решение: **размах (peak-to-peak) 3/5/10 мм**, как у сменных дисков fix6/fix7
и в [`../expert3/optimum.md`](../expert3/optimum.md). Для нуль-пик 3/5/10
(размах 6/10/20) в fix8 пружина не менялась бы на эту; там нужен вариант
[`../expert3/optim-pick-pick.md`](../expert3/optim-pick-pick.md).

**В2. Почему выбрана именно Ø17×1,5×60, 9 витков?**

Это оптимум expert3 для 4 пружин: контакт 2,72× на 15 Гц/10 мм, τ=479 МПа,
f_соб=12,8 Гц; при L0=70 (4×1,0) контакт 1,48× и τ=729 МПа, при 4×1,5 L0=70
f_соб ближе к 10 Гц. Подробно — [`../expert3/optimum.md`](../expert3/optimum.md).

**В3. Почему в 3D-модели пружина имеет 36 мм, а не 60 мм?**

В собранном виде пружина сжата до 36 мм; модель показывает установленное
состояние. Свободная длина 60 мм — параметр покупной пружины и расчёта; STL
пружины нет. Это так же, как в fix7 (там L0=70, установленная 36).

**В4. Меняются ли шайбы, число пружин и другие детали?**

Решение: **нет**. 4 пружины, шайбы Ø18/Ø10,5×1,5 — существующие; OD17 <18,
ID14 >10: пружина надевается на вал и не соскальзывает с шайбы. Геометрия
рамы, стола, кулачка, вала и крепежа не менялась. Изменились только
параметры пружины, спецификация, проверки, масса и листы.

**В5. Что с массой?**

Пружина в модели 6,15 г/шт. (24,6 г на 4) вместо 2,4 г/шт. в fix7; масса без
дрели — **6405,8 г** (было 6390,8). Движущаяся масса с учётом пружин —
≈0,924 кг; расчёт контакта учёл это.

**В6. Что с предупреждениями проверок?**

Было два: пружина ID 10,0 при вале Ø10 и стенка 3 мм у R32 на диске 10.
Первое снято: ID=14,0 при вале Ø10, зазор 4,0 мм. Осталось только
предупреждение по стенке 3 мм (принято ранее); всего **240/241 OK**.

**В7. Выполнены ли остальные замечания expert2/expert3?**

Решение: **нет**. Выполнен только выбор оптимальной пружины (S1/S2
в части пружинного пакета). Остальные C1–C8, I1–I23, W1–W8 и S3–S6
остаются; в fix8 они не проверялись.

**В8. Нужен ли отдельный этап для нуль-пик?**

Да, если пользователь переходит на нуль-пик 3/5/10 (размах 6/10/20):
нужна **4×Ø17×1,8×65, 12 витков** (см. `optim-pick-pick.md`), это отдельная
корректировка. В fix8 она не реализована.

**В9. Какой протокол приёмки?**

Проверить k (сжатие 20 мм — 29,9 Н), L0=60, ID/OD, отсутствие заклинивания
на валу, силу при 36/46 мм (143,7/83,9 Н), 10^6 циклов, остаточную
деформацию ≤0,5 %, контакт 15 Гц/10 мм ≥82 Н, p0/износ кулачка; протокол.

## 2. Принятые допущения

| Вопрос | Принято | Почему |
|---|---|---|
| Амплитуда | размах 3/5/10 мм | как диски fix6/fix7 |
| Пружина | 4×Ø17×1,5×60, 9 активных витков | optimum.md expert3 |
| Установленная длина | 36 мм | геометрия 241…280 с шайбами |
| Шайба | Ø18/Ø10,5×1,5 | существующая |
| Материал / концы | 65Г/60С2ХА; закрытые шлифованные | optimum.md |
| Допускаемое τ | 500…700 МПа | ориентир expert3 |
| Остальные замечания | не выполнялись | scope fix8 |

## 3. Что не проверялось

1. Усталость/ресурс 10^6 циклов и реальные k/L0/ID пружины.
2. Динамика с шариком, удар, податливость PLA, шум.
3. Кулачок/ролик p0 при новой силе (ориентировочно 42 МПа).
4. Остальные части устройства — вне scope fix8.
5. Нуль-пик-вариант — отдельный этап.

## 4. Связь с expert3

Основание — [`../expert3/optimum.md`](../expert3/optimum.md) (размах) и
[`../expert3/Report.md`](../expert3/Report.md). Fix8 реализует выбранную
пружину; следующая проверка — испытания и, при необходимости, исправление
C8/демпфирования.
