inutcin/boomboom/stages/fix6/Interview.md

# Интервью по этапу «Третья корректировка после инженерной экспертизы»

Дата: 2026-10-30
Этап: `stages/fix6`
База: [`stages/fix5`](../fix5/README.md)

Вопросы ниже — уточнения к единственному замечанию README этапа. Все решения
продублированы в [`params.csv`](./params.csv) со статусом `fix6` и в
[`cad/checks.csv`](./cad/checks.csv).

## 1. Вопросы и решения

**В1. «Коническими подшипниками» — это конические гайки или конические
(роликовые) подшипники?**

Решение: **конические гайки M10**. В замечаниях fix1 и fix2 та же идея
сформулирована как «прижать с обоих сторон каждого подшипника коническими
гайками и законтрить ещё одной гайкой» (fix2, «Фиксация подшипников на
валу»). Замена 6200 на конические роликовые подшипники потребовала бы
переделки карманов, вала, регулировки преднатяга и не следует из текста.
Если имелись в виду именно роликовые подшипники — нужен отдельный этап.

**В2. Что именно было неверно в fix5?**

Решение: при переносе 6200 №2 с X=190 на X=150 (этап fix3) левая
контргайка сохранила старое смещение: в fix5 она занимала X=137,5…145,5,
то есть **стояла поверх конуса** 140…145,5. Пересечение «конус —
контргайка» — **403 мм³**; второй подшипник слева был поджат конусом без
отдельной контргайки. В fix6 стек строится от центра 6200 и его ширины,
левая гайка 6200 №2 — **X=132…140**.

**В3. Какие именно «оба подшипника»?**

Решение: два **опорных 6200 вала привода** — X=10 и X=150. Роликовый 6200
(ось Z=205) в замечание не входит: у него с fix2 уже 2 конуса и 2
контргайки. LMK10UU — линейные подшипники стола, а не подшипники вала.

**В4. Как ориентированы конусы?**

Решение: **малый торец Ø12 — к 6200, большой Ø16 — к контргайке**.
Конус прижимает внутреннее кольцо подшипника; наружное кольцо остаётся
в кармане 9,4 мм. Длина конуса 5,5 мм, гайка M10 — 8 мм.

**В5. Чем контрить — обычной гайкой или nyloc?**

Решение: **M10 nyloc**, как в fix2 и по требованию fix1 («все гайки,
испытывающие колебания, — с самоконтрящимся пластиковым кольцом»).
Одна гайка на каждый конус, всего 4 на вал. Спецификация, поз. 16:
8 шт. — 4 опорных 6200 + 2 кулачок + 2 ролик (позиция не меняется).

**В6. Что происходит с наружными кольцами 6200?**

Решение: без изменений. Наружное кольцо лежит в кармане шириной 9,4 мм
(6200 — 9 мм, осевой зазор 0,2 мм) и радиально зажато между средней
поперечиной и балкой 21. Замечание относится к осевой фиксации **вала**:
конусы зажимают внутренние кольца, поэтому вал не смещается вдоль оси.

**В7. Хватает ли места контргайкам и можно ли их затянуть?**

Решение: гайки вынесены по X за 20-мм балку/поперечину: X=20…28 и
132…140 (плюс наружные −8…0 и 160…168). До подшипника — 5,5 мм (конус),
до балки 21/поперечины — **0,19 мм** в модели. Модель рисует правильный
шестигранник 17 AF (e=19,63 мм); у покупной гайки M10 e≈18,9 мм, поэтому
реальный зазор ≈0,55 мм. Ключ заводится сбоку по Y, вращению ничего не
мешает.

**В8. Меняются ли другие детали, спецификация и масса?**

Решение: **нет**. Кулачок, шайбы, приваренная гайка, кожух, буферы, кольца,
рама, стол, балка 21, подстолье и крепёж — как в fix5. Изменилось только
положение левой контргайки 6200 №2; масса осталась **6390,8 г**. Число
позиций спецификации — 36.

**В9. Это отдельный этап?**

Решение: да, `fix6`, база — `fix5`: меняются модель, проверки, эскизы и
отчёт; в корневом README ссылка уже есть.

**В10. Какие три проекции на листе?**

Решение: **вид спереди (со стороны −X), вид слева (со стороны −Y), вид
сверху (−Z)** — как в fix4/fix5. Этих проекций достаточно, чтобы показать
раму, привод, стол, вынос и все посадочные базы; вид справа отличается
только кожухом и выносом.

## 2. Принятые допущения

| Вопрос | Принято | Почему |
|---|---|---|
| «Конические подшипники» | конические гайки M10 | терминология fix1/fix2; 6200 не меняем |
| Подшипники | 2 опорных 6200 вала привода | ролик и LMK не относятся к валу |
| Конус | Ø12→Ø16×5,5, малый торец к 6200 | прижим внутреннего кольца |
| Контргайка | M10 nyloc, 8 мм, снаружи конуса | fix1/fix2; одна на конус |
| Стек 6200 №1 | −8…0 / 0…5,5 / 5,5…14,5 / 14,5…20 / 20…28 | от центра X=10 и ширины 9 |
| Стек 6200 №2 | 132…140 / 140…145,5 / 145,5…154,5 / 154,5…160 / 160…168 | от центра X=150; исправление регрессии |
| Наружное кольцо | карман 9,4 мм, зазор 0,2 мм | без изменений fix2 |
| Остальные детали | без изменений fix5 | замечание только про вал |

## 3. Что не проверялось

1. Момент затяжки конусов и контргаек, величина преднатяга, смятие
   внутреннего кольца и резьбы.
2. Фреттинг и ослабление при вибрации 5…15 Гц; nyloc и фиксатор резьбы.
3. Резьба M10 как посадочная поверхность 6200 (замечание экспертизы I3);
   гладкие пояса/буртики вала не вводились.
4. Биение и балансировка вала с 4 конусами и 4 гайками.
5. Точность покупных конусов/гаек, реальные размеры e и фасок.
6. Динамика, пружины, дрель, удержание шарика — как в fix5.
7. Прочность сварки приваренной гайки и шестигранного отверстия кулачка.

## 4. Противоречия и предложения

1. **Зазор 0,19 мм** до балки/поперечины в модели — следствие правильного
   шестигранника 17 AF. У реальной гайки зазор больше; если попадётся
   гайка с большой фаской/покрытием, проверить по месту или применить
   тонкую контргайку/снять фаску.
2. **Наружное кольцо** имеет осевой зазор 0,2 мм; при стуке на высоких
   оборотах можно добавить регулировочные шайбы в карман — вне замечания.
3. **Шпилька M10** под 6200 — по-прежнему компромисс (экспертиза I3).
   Предложение: ступенчатый вал Ø10 h6 под подшипники и резьбовые концы.
4. **Nyloc как контргайка** фиксирует от проворота, но не создаёт
   контрнатяг на конус. При ослаблении — проверить момент и, при
   необходимости, заменить на обычную гайку + фиксатор резьбы.
5. **Четыре конуса и четыре гайки** увеличивают число точек трения
   (желательное требование README п. 1), но это прямое требование
   замечания fix2/fix6.
