inutcin/boomboom/stages/fix7/Interview.md

# Интервью по этапу «Первая корректировка после второй инженерной экспертизы»

Дата: 2026-10-30
Этап: `stages/fix7`
База: [`stages/fix6`](../fix6/README.md)

Вопросы ниже — уточнения к замечанию 1 (параметры прижимных пружин). Все
решения продублированы в [`params.csv`](./params.csv) и
[`cad/checks.csv`](./cad/checks.csv).

## 1. Вопросы и решения

**В1. «Длина 70» — это свободная длина L0 или установленная длина в
собранном виде?**

Решение: **свободная длина L0=70 мм**. Установленная длина в модели —
36 мм; её задаёт геометрия: верх стола 241 мм, низ верхней поперечины
280 мм, две шайбы по 1,5 мм: 280−241−3=36. Если 70 мм — установленная длина,
нужно поднимать верхнюю поперечину/менять стойки и всю геометрию; это
отдельный этап, в fix7 не делалось.

**В2. Число витков, концы, материал и количество пружин?**

Решение: 11 активных витков (как в fix6), концы закрытые/шлифованные,
материал «пружинная сталь», 4 пружины. В задании эти параметры не указаны;
они приняты по fix6. Если пружина покупная с другими витками/концами,
жёсткость и преднатяг нужно пересчитать (см. expert3).

**В3. Почему в 3D-модели пружина имеет длину 36, а не 70 мм?**

Решение: в собранном виде пружина сжата до 36 мм; модель показывает
**установленное** состояние. Свободная длина 70 мм — параметр покупной
пружины и расчёта, а не отдельная печатная деталь. STL пружины нет.

**В4. Меняются ли другие детали, спецификация и масса?**

Решение: геометрия рамы, стола, кулачка, вала и крепежа **не менялась**.
Изменились `params.csv` (L0=70, Ø12, проволока 1,0), `spec.csv` (поз. 3),
`checks.csv` (добавлены проверки L0 и установленной длины) и листы. Масса
без дрели осталась **6390,8 г**: проволока та же, 2,4 г/шт.

**В5. Какие ещё замечания второй экспертизы выполнены в fix7?**

Решение: **никакие**. Пользователь поручил только параметры пружин.
Остальные C1–C8, I1–I23, W1–W8 из [`../expert2/findings.csv`](../expert2/findings.csv)
остаются для следующих корректировок и в fix7 не проверялись.

**В6. Что проверять в третьей экспертизе?**

Решение: только пружины и контакт ролика: жёсткость, преднатяг, силы,
напряжения, усталость, собственная частота, ID/вал, сборка, контакт
ролика с кулачком, сила контакта и её запас, влияние 2-лепесткового
профиля. Остальные части — вне expert3.

**В7. Какой критерий контакта считать обязательным?**

Решение: из второй экспертизы — **сила контакта ≥2× инерционной** на всех
режимах. Дополнительно проверить положительный контакт на фактическом
профиле и на идеальной синусоиде (после возможного исправления C8).

**В8. Допустимое напряжение в пружине?**

Решение: в задании не задано. Для экспертизы принята пружинная сталь
(65Г/60С2ХА или аналог) с допускаемым напряжением кручения порядка
500…700 МПа для усталости; точное значение зависит от материала и
термообработки. В expert3 это будет указано как допущение и проверено.

## 2. Принятые допущения

| Вопрос | Принято | Почему |
|---|---|---|
| «Длина 70» | свободная L0 | установленная 36 задана геометрией |
| Диаметр / проволока | 12 / 1,0 мм | задание |
| Витки / концы | 11 / закрытые шлифованные | как fix6 |
| Количество | 4 | как fix6 |
| Материал | пружинная сталь | как spec.csv |
| Установленная длина | 36 мм | 280−241−2×1,5 |
| Масса пружины | 2,4 г/шт. | проволока не менялась |
| Остальные замечания | не выполнялись | scope fix7 |

## 3. Что не проверялось

1. Усталость и напряжение пружины — вынесены в expert3.
2. Контакт ролика — вынесен в expert3.
3. Сборка сжатой пружины 70→36 мм (усилие 92 Н на 4 пружины) — в expert3.
4. Остальные части устройства — вне scope fix7/expert3.
5. Точность покупной пружины (L0, k, ID, концы) — нужны измерения.

## 4. Связь с expert3

Третья экспертиза — [`stages/expert3`](../expert3/README.md) — проверяет
только пружины и контакт ролика. Её выводы могут потребовать изменения
параметров пружин (k, L0, число, материал) или профиля кулачка; это будет
следующая корректировка.
