inutcin/boomboom/stages/fix4/Interview.md

# Интервью по этапу «Первая корректировка и замечания после инженерной экспертизы»

Дата: 2026-10-30
Этап: `stages/fix4`
База: [`stages/fix3`](../fix3/README.md)
Экспертиза: [`stages/expert/Report.md`](../expert/Report.md)

Вопросы заданы до моделирования; ответы пользователя по fix4 в переписке
касались только семи пунктов README. Рекомендации [`promos.md`](./promos.md)
(C1–C7, I1–I18, W1–W8) по указанию задания **не выполнялись**. Ниже —
решения, принятые по семи пунктам, и места, где формулировка допускает
толкование. Все они продублированы в [`params.csv`](./params.csv) со
статусом `fix4`.

## 1. Вопросы и решения

**В1. Как именно сделать кулачок симметричным с двумя максимумами и двумя
минимумами?**

Решение: профиль `r(θ) = r0 + e·cos2θ`, где `r0 = 50 − s/2`, `e = s/2`,
`s` — ход (3/5/10 мм). При θ=90° и 270° — максимумы `R50`, при 0° и 180° —
минимумы `R50−s`. Верхнее положение стола одинаково для всех дисков —
241 мм (максимальный радиус 50 + ролик 6200 Ø30 + ось Z=140), ход
направлен **вниз**. Стол совершает два колебания за оборот вала: 5…15 Гц
соответствуют 150…450 об/мин дрели. Это создаёт удобный низкооборотный
режим и снижает требования к патрону.

**В2. Что означает «отверстия по радиусу приходились на максимумы и
минимумы»?**

Решение: по одному отверстию на каждый лепесток — **4 отверстия Ø12**:
на радиусах максимумов `R38`, на радиусах минимумов `R28`. При диске 10 мм
минимальный радиус 40, стенка до контура 6 мм; при диске 5 — 11 мм.
Восемь отверстий (как в fix3) пришлось бы ставить парами на одной радиальной
линии, и стенка между ними или до контура стала бы тоньше 2…3 мм. Если
нужны именно 8 отверстий, их можно добавить на свободных углах 45°/135°,
но это уменьшит жёсткость и симметрию mass; в текущей модели 4.

**В3. «Радиальные насечки шириной 3 см от края центрального отверстия» —
это 3 см ширины или 3 см длины?**

Решение: прочитано как **длина 30 мм от края отверстия** (R5,1…R35,1),
ширина **3 мм**, глубина **0,5 мм**, 8 насечек на правом торце. Они
смещены на 22,5° от отверстий облегчения, чтобы не пересекать их.
Если имелось в виду «ширина 30 мм», насечка превратится в широкий сектор —
это ухудшит контакт шайбы; просьба подтвердить.

**В4. Какая именно «контактная шайба с насечками» и «ещё одна гайка для
контрения»?**

Решение: стальная шайба **Ø70/Ø10,5×2,5** с 8 радиальными рёбрами
3×29,8×0,5, входящими в пазы кулачка; основная гайка M10 (8 мм) и
контргайка M10 nyloc (8 мм). Кулачок прижат к **буртику вала Ø16**
(X=70,5…74), поэтому осевое положение задаёт вал, а не трение конуса.
Фаска 1×45° вокруг отверстия кулачка убрана, торец под шайбу плоский.
Осевой стек: буртик 70,5…74 / кулачок 74…86 / шайба 86…88,5 / гайка
88,5…96,5 / контргайка 96,5…104,5. Конусные гайки на кулачке удалены
(на опорных 6200 и ролике остались).

**В5. Как понимать кожух «боковые части рамы … изнутри по 4-м сторонам, а
снаружи по двум»?**

Решение:
- **2 боковые панели** 160×300×5 мм на наружных плоскостях Y=−5…0 и
  200…205, X=0…160, Z=0…300 — «большой кожух»;
- **4 внутренних бортика** (передний, задний, левый, правый) от верхней
  рамы вниз до **Z=246** = верх стола 241 + 5 мм;
- **2 наружных бортика** на X=−5…0 и 160…165, тоже до Z=246 — закрывают
  большую часть пружин;
- вынос X>165 не закрыт;
- крепление — **34 самореза M4×16** с прижимной шляпкой Ø8, пилоты Ø3,5
  в PETG (16 боковых + 12 внутренних + 6 наружных).

**В6. Что считать «верхней точкой колебания стола» для бортиков?**

Решение: **241 мм** — верх накладки при максимальном радиусе кулачка 50.
Бортики до 246 мм; при штатном ходе (241 → 236/231) зазор 5…15 мм.
Резиновые буферы — до 244 мм (3 мм до стола). Стол при отрыве выше 246 мм
упирается в бортик; при 244 мм — в буфер.

**В7. Как расположить «2 прямоугольных кусочка резины» в углах?**

Решение: **по 2 буфера на каждую пружину** (всего 8), с двух сторон по Y:
Y=26…39 и 61…74 для пружин Y=50, Y=126…139 и 161…174 для Y=150; размер
20×13×36, низ Z=244, верх 280 (под верхней поперечиной). До пружины Ø12 —
5 мм, до верхней точки стола — 3 мм. Буферы вклеены; они мягко
останавливают стол при отрыве и защищают бортик кожуха.

**В8. «Кольца … между средней поперечиной и линейным подшипником, до
нижней границы максимального колебания стола 3 мм» — при каком диске?**

Решение: при **максимальном диске 10 мм**. Низ LMK при нижнем ходе —
180 мм; верх кольца — 177 мм; кольцо Ø18/Ø10,5×7, Z=170…177. При диске
5 мм зазор 8 мм, при 3 мм — 10 мм. Кольцо лежит на средней поперечине
(верх 170) и работает как мягкий упор; при 10 мм оно сминается на 3 мм
раньше, чем LMK дойдёт до поперечины.

**В9. Что входит в «общий блок» и как его менять?**

Решение: блок = вал (20) + кулачок (10) + 2×6200 (9) + контактная шайба
(33) + гайка (34) + контргайка (16). Он собран на валу и вынимается
целиком. Проверено геометрически: после **снятия** балок 21 (16 болтов M4
уголков) блок опускается на 44 мм (верх кулачка 148 < 150 — низ средней
поперечины), выдвигается вперёд и выходит из рамы; стол, кожух и уголки
не мешают. «Только отжать балки на 15 мм» недостаточно: балки нужно снять,
а блок — поддержать/опустить (винт/домкрат или помощник). Это отличие от
формулировки п. 6 зафиксировано в отчёте.

**В10. Нужно ли закрывать нижние части передней и задней сторон?**

Решение: по п. 2 — нет: боковые панели закрывают бока, верхние бортики —
верх; нижние передняя/задняя стороны остаются открытыми (доступ к
кулачку/валу, вынос). Это остаточный риск: кулачок на Z=88…192 виден
спереди через проём под средней поперечиной. Предложение — съёмная
прозрачная нижняя панель или окно; в текущей модели не добавлено, чтобы не
выходить за семь пунктов. См. Report.md, раздел «Остаточные риски».

**В11. Нужны ли резьбовые вставки под саморезы кожуха?**

Решение: нет, в модели пилоты Ø3,5 под саморез M4 в PETG. При частой
сборке/разборке (смена блока) PETG теряет натяг; предложение — латунные
вставки M4 или винты M4 в закладные гайки. В спецификации — саморезы.

**В12. Как согласуются 2 лепестка и требование «частота 5…15 Гц»?**

Решение: частота стола = 2 × частота вала. Дрель должна устойчиво
работать на 150…450 об/мин; при её минимальных оборотах возможен
проскальзывающий режим. Проверить на реальной дрели; в модели дрель —
заглушка Ø100. Частотная карта экспертизы (5…15 Гц) для шарика остаётся
в силе: 2 лепестка не меняют ускорение при том же размахе.

**В13. Где именно делать галтели R10 и где их пропустить?**

Решение: добавлены **20 вогнутых галтелей R10**:
- 4 — во внутренних углах нижнего пояса (XY, Z=0…20);
- 8 — в стыках средних поперечин со стойками (YZ, Z=140…150 и 170…180);
- 8 — в стыках верхних и нижних поперечин со стойками (XZ, Z=270…280 и
  20…30).

Не добавлены в верхних внутренних углах (X=20/140, Y=20/180, Z=280…300):
там стоят внутренние бортики кожуха и резиновые буферы; это и есть
исключение, разрешённое п. 7. Галтели — добавленный материал (вогнутые),
рама остаётся одним телом; масса +11 г.

## 2. Принятые допущения

| Вопрос | Принято | Почему |
|---|---|---|
| Профиль кулачка | `r0=50−s/2`, `e=s/2`, максимум вверху | верх стола 241 одинаков для дисков |
| Отверстия облегчения | 4×Ø12: R38/R28 | по одному на лепесток, стенка ≥6 мм |
| Насечки | 8 × 3×30×0,5, смещение 22,5° | 3 см — длина от края отверстия |
| Контактная шайба | Ø70/Ø10,5×2,5, 8 рёбер | перекрывает насечки, прижимается гайкой |
| Буртик вала | Ø16, X=70,5…74 | положительный осевой упор кулачка |
| Кожух | PC 5 мм, 8 пластин, 34 самореза | п. 2 README |
| Бортики | низ 246 (стол 241 + 5) | п. 2 README |
| Буферы | 8 (2 на пружину), низ 244 | п. 4 README; 3 мм до стола, 5 до пружины |
| Кольца | 4 × Ø18/Ø10,5×7, Z=170…177 | 3 мм до LMK при диске 10 мм |
| Блок | вал + кулачок + 2×6200 + шайба + гайки | п. 6 README |
| Частота | 5…15 Гц стола = 150…450 об/мин вала | 2 лепестка |
| Материал кожуха | поликарбонат 5 мм | п. 2 README |
| Саморезы | M4×16, шляпка Ø8, пилот 3,5 | п. 2 README |
| Дрель | заглушка Ø100, против часовой | не выбрана (В3 экспертизы) |

## 3. Что не проверялось

1. Прочность/жёсткость кожуха, буферов, колец и рамы — только геометрия и
   зазоры; удары шарика/стола по поликарбонату не моделировались.
2. Динамика с 2-лепестковым кулачком: гармоничность, отрыв ролика,
   контактные силы; аналитическая оценка экспертизы для эксцентрика не
   пересчитывалась. Частота/амплитуда — кинематика.
3. Усталость и износ: PETG-пилоты саморезов, PLA-кулачок, 6200 в PETG,
   фреттинг балки 21 — без испытаний.
4. Реальная дрель, патрон, биение, осевой люфт, минимальные обороты.
5. Тепловое поведение PC/PETG/PLA, УФ-старение поликарбоната.
6. Точность печати и сборки; посадки кулачка Ø10,2/вал Ø10 и шайбы.
7. Электрическая безопасность, E-stop и блокировка — не входят в семь
   пунктов (см. promos.md C1).
8. Извлечение блока на реальном изделии: проверено только геометрически
   (опускание 44 мм и выдвижение вперёд), без учёта веса и трения.

## 4. Противоречия и предложения

1. **Нижние передняя/задняя стороны** виброотсека остаются открытыми:
   вращающийся кулачок доступен спереди. Предложение — добавить съёмную
   нижнюю панель/окно из PC (X=−5…0 и 160…165, Z≈20…246) или перенести
   боковые панели на все четыре стороны. Не сделано, чтобы не выходить за
   п. 2.
2. **Смена блока кулачка** требует снять балки 21 и опустить блок на
   44 мм, а не только «отжать» их. Предложение — домкратный винт/упор под
   блок или быстросъёмные балки; иначе операция неудобна и небезопасна.
3. **Пружины** не выбирались: при диске 10 мм установленная длина 46 мм,
   сжатие 9 мм; контакт ролика на верхних режимах не гарантирован
   (C7 экспертизы). Предложение — пружины с `k≥1,3 Н/мм` или 6…8 пружин.
4. **Кожух** закрывает доступ к прижимным болтам балок 21; для смены
   блока панели снимаются (34 самореза). При частой смене — вставки и
   невыпадающие саморезы.
5. **Стол** имеет одинаковый верх 241, но среднее положение для дисков
   3/5/10 разное (239,5/238,5/236); экспертное пожелание I7 (общая база)
   выполнено только по верхней точке. Если нужна общая средняя высота —
   сдвинуть ось кулачка/ролика.
6. **Саморезы в PETG** — расходный ресурс; при 10…20 сборках пилот
   разбивается. Предложение — вставки M4.
