inutcin/boomboom/stages/fix5/Interview.md

# Интервью по этапу «Вторая корректировка после инженерной экспертизы»

Дата: 2026-10-30
Этап: `stages/fix5`
База: [`stages/fix4`](../fix4/README.md)

Вопросы ниже — уточнения к семи замечаниям пользователя. Рекомендации
`promos.md` не выполняются. Все решения продублированы в
[`params.csv`](./params.csv) со статусом `fix5`.

## 1. Вопросы и решения

**В1. Что значит «отверстие в кулачке, чтобы туда плотно заходила гайка
М10» — круглое Ø17 или шестигранник?**

Решение: **шестигранное отверстие 17,1 мм AF** (across flats) через весь
диск и буртик. Гайка M10 имеет 17 AF; посадка с зазором 0,1 мм «плотная».
Круглое Ø17 не передавало бы момент (касание только по серединам граней);
шестигранник — передаёт. Гайка приварена к шпильке (В3) и работает как
привод кулачка.

**В2. С какой стороны буртик и какой у него размер?**

Решение: **слева** (со стороны сварки), **Ø40 × 10 мм**,
X=64…74. Кулачок 74…86. Буртик отодвигает левую шайбу на 10 мм от
остатков сварки. Радиальных насечек нет ни на буртике, ни на правом торце
(они удалены). Фаска вокруг отверстия тоже отсутствует.

**В3. Где именно приваривается гайка и как она моделируется?**

Решение: гайка M10 (17 AF, толщина 8 мм) на шпильке в **X=74…82**, внутри
кулачка; в модели — шестигранный буртик на валу (сварка не моделируется,
но гайка неразъёмная). Кулачок надевается шестигранником 17,1 на неё.
Момент передаётся гранями, а не трением шайб.

**В4. Какие шайбы и как они затягиваются?**

Решение: **2 гладкие стальные шайбы Ø40/Ø10,5×2,5** — слева на буртике
(X=61,5…64) и справа на плоском торце (X=86…88,5). С каждой стороны:
шайба → гайка M10 → контргайка M10 nyloc. Слева: гайка 53,5…61,5,
контргайка 45,5…53,5; справа: гайка 88,5…96,5, контргайка 96,5…104,5.
Шайбы прижимаются гайками с двух сторон; контргайки фиксируют.

**В5. «8 отверстий того же размера и на том же расстоянии» — это Ø10 R32
или Ø12?**

Решение: **8 × Ø10 на R32** — как в fix3 (там было 8×Ø10 R32). Углы:
0°, 45°, 90°, 135°, 180°, 225°, 270°, 315°; 2 на максимумах (90/270),
2 на минимумах (0/180), 4 между. Это буквально «того же размера и на том
же расстоянии». **Риск:** для диска 10 мм минимум R40, стенка до контура
`40−(32+5)=3 мм`. Это записано как предупреждение; при необходимости
уменьшить до Ø8 или R30. Для дисков 3/5 мм стенка 10/8 мм.

**В6. Как ставить резиновые буферы, если по обе стороны пружины не
нужны?**

Решение: **4 буфера, по одному в каждый верхний угол** «поперечина —
стойка»: X=0…20 и 140…160, Y=20…39 и 161…180, Z=244…280; размер
20×19×36. Буфер прижат к нижней грани верхней поперечины (Z=280) и к
боковой грани стойки (Y=20/180). До пружины Ø12 — 5 мм (Y=44/156), до
верхней точки стола 241 — 3 мм. Восемь буферов fix4 (по 2 на пружину)
удалены.

**В7. Какие именно галтели добавить?**

Решение: **26 галтелей R10**: 20 из fix4 (низ 4, средние поперечины 8,
верх/низ поперечин 8) + **6 в выносе**:
- 2 — верхние продольные балки у граничной поперечины (X=160…170,
  Z=160…170);
- 2 — верхние продольные балки у задних стоек (X=330…340,
  Z=160…170);
- 2 — нижние продольные балки у задних стоек (X=330…340, Z=20…30).
Нижний стык выноса у X=160 заподлицо (обе балки Z=0…20), галтель там не
нужна — это исключение. Верхние внутренние углы виброотсека по-прежнему
без галтелей: там бортики кожуха и буферы.

**В8. Нужны ли внутренние бортики кожуха, если есть резиновые ограничители?**

Решение: **нет**. 4 внутренних бортика поликарбоната удалены; остались
2 боковые панели 160×300 и 2 наружных бортика до Z=246. Крепёж — **22
самореза** (16 боковых + 6 наружных); 12 отверстий/пилотов внутренних
бортиков удалены. От закатывания шарика страхуют 4 резиновых буфера в
углах (и вогнутость накладки). Это уменьшает массу кожуха на 164,8 г и
число саморезов на 12. **Следствие:** сплошного борта по периметру стола
больше нет; если шарик всё же уходит с края вне углов, потребуется
вернуть локальный борт/кольцо — это не проверялось динамически.

**В9. Это отдельный этап или продолжение fix4?**

Решение: **отдельный этап `fix5`**, потому что исправления меняют
geometry/спецификацию/проверки; база — fix4. В корневом README добавлена
ссылка.

## 2. Принятые допущения

| Вопрос | Принято | Почему |
|---|---|---|
| Отверстие кулачка | шестигранник 17,1 AF | плотная посадка гайки M10 |
| Буртик | Ø40×10, слева, X=64…74 | п. 2; защита от сварки |
| Приваренная гайка | M10 17 AF, X=74…82, часть вала | п. 3 |
| Шайбы | 2 × Ø40/Ø10,5×2,5 | по буртику; гладкие |
| Гайки/контргайки | по 1+1 с каждой стороны | п. 4 |
| Облегчение | 8×Ø10 R32, 45° | как в fix3; 2 макс/2 мин/4 между |
| Буферы | 4 × 20×19×36, 1 на угол | п. 6 |
| Галтели | 26 × R10 | 20 + 6 в выносе |
| Кожух | 2 панели + 2 наружных бортика; 22 самореза | п. 8; внутренних нет |
| Блок кулачка | без изменений по составу | вал + кулачок + 6200 + шайбы/гайки |

## 3. Что не проверялось

1. Прочность сварки гайки со шпилькой, качество сварки, деформация шпильки.
2. Прочность 3-мм стенки кулачка у отверстий R32 на минимуме диска 10;
   циклические испытания PLA.
3. Балансировка кулачка с буртиком и шайбами с одной стороны.
4. Момент затяжки шайб/гаек, смятие PLA шайбой Ø40, ослабление при
   вибрации.
5. Точность шестигранного отверстия 17,1 после FDM-печати (усадка,
   допуск) и посадка гайки.
6. Удержание шарика без внутренних бортиков: проверено только
   геометрически (буферы в углах + вогнутость); динамика не считалась.
6. Динамика, пружины, дрель, шарик — как в fix4.
7. Реальный путь извлечения блока с новыми шайбами/гайками (проверено
   геометрически).

## 4. Противоречия и предложения

1. **3-мм стенка** у двух отверстий на минимуме диска 10 — риск. Если
   важнее прочность, а не «тот же размер», заменить Ø10 на Ø8 (стенка
   4 мм) или R32 на R30 (стенка 5 мм). В текущей модели — по замечанию.
2. **Буртик и шайбы только с одной стороны смещают массу** кулачка;
   при 450 об/мин это может дать вибрацию. Предложение — уравновесить
   буртик/шайбу или уменьшить Ø буртика.
3. **Шайба Ø40 на PLA** при затяжке может смять торец; предложение —
   стальная вставка/большая шайба или печать с 100 % и шайба Ø50.
4. **Приваренная гайка** — стандартная M10; при сварке возможен перекос
   и деформация резьбы. Предложение — приваривать гайку на оправке,
   проверять биение и проходить метчиком.
5. **Извлечение блока** по-прежнему требует снять балки 21 и опустить
   блок на 44 мм; новые шайбы/гайки добавили 25 мм слева, но путь
   проверен.
6. **Удержание шарика** теперь только за счёт вогнутости и 4 угловых
   буферов; по середине краёв борта нет. Если шарик уходит — вернуть
   локальные бортики/кольцо.
7. **Открытые нижние передняя/задняя стороны** кожуха — как в fix4;
   не входили в новые замечания.
