inutcin/boomboom/stages/fix3/Interview.md

# Интервью по этапу «Третье устранение замечаний по первоначальной версии модели»

Дата: 2026-10-30
Этап: `stages/fix3`
Предыдущий этап: [`stages/fix2`](../fix2/README.md)

Вопросы заданы до начала моделирования. Ответы пользователя помечены как
«решение»; всё, что не задано явно, вынесено в «Принятые допущения» и
продублировано в [`params.csv`](./params.csv) со статусом `fix3`.

## 1. Вопросы и ответы

**В1. Как выполнить «плоские уголки как в fix1», чтобы балка 21 была
поджата к седлу 6200 и ничего не выступало над её верхней гранью?**

Решение: **полка под балку + прижимные винты M6**. На каждый конец балки —
два Γ-образных уголка (сталь 2 мм) на передней и задней гранях: вертикальная
полка 62 (по Y) × 54 (по Z) на грани стойки/балки, горизонтальная полка 10×42 мм
**под** балкой (Z=108…110), 2 прижимных винта M6 с контргайками поджимают балку
снизу вверх. Полок на верхней грани балки нет; верх уголка `Z=110`.

**В2. Сохранять ли возможность опустить балку 21 на 20 мм для замены вала
привода (требование основного README п. 6)?**

Решение: **да**. В вертикальной полке уголка — два вертикальных паза 20 мм под
болты M6 к стойке; при ослаблении уголки вместе с балкой опускаются на 20 мм,
6200 освобождается.

**В3. «Отверстия под валы больше на 1 мм в столе и на 2 мм в накладке» —
относительно чего?**

Решение: **относительно вала Ø10**: в столе Ø11, в накладке Ø12 (в fix2 было
Ø10,5 в обоих).

**В4. Куда ставить кулачковый диск после сокращения виброотсека на 40 мм?**

Решение: **симметрично между опорными 6200**: X=74…86, ось диска X=80
(в fix2 было 94…106). Соответственно сдвинуты кронштейны ролика (68…70 и
90…92), ось ролика (58…102) и пазы в столе (X=45 и 110).

**В5. Уменьшилась ли длина направляющих валов?**

Решение: **нет**. Высота устройства не меняется: направляющие валы — Ø10,
L=166 (Z=142…308), пружины, ограничители, ход стола и отверстия в поперечинах
рамы (Ø10,5) без изменений. Меняются только координаты X пар валов: 10 и 150
вместо 10 и 190 (шаг по глубине 180→140). Уменьшается на 40 мм только вал
основного привода — это прямо задано п. 7 замечаний.

**В6. После сокращения виброотсека рама становится 360 мм или остаётся
400 мм с удлинённым выносом?**

Решение: **рама 360 мм**: виброотсек 160 + вынос 200 (без изменений).
Подстолье, дрель и хомуты переезжают вперёд на 40 мм; вал привода укорачивается
до X=−10…215.

## 2. Принятые допущения

| Вопрос | Принято | Почему |
|---|---|---|
| Материал накладок | сталь 2 мм | указание «2 мм» |
| Габарит накладки | полки 60×20, полный габарит 80×80 | «уголки 60 на 60 шириной 20» |
| Крепление к балке | 2 болта M4×30 насквозь через пару накладок и балку | жёстко, «сбоку», работа на срез |
| Крепление к стойке | 2 прижимных болта M4×30 на пару, пазы 20 мм | регулируемая стяжка стойки с двух сторон |
| Ход опускания балки | 15 мм (пазы 20 мм) | нужно 10 мм (5 + 5 запас) |
| Балка 21 по Y | 20,2…179,8 (L=159,6) | 0,2 мм зазора до стоек; в распор между стойками |
| Бортик ложбинки кулачка | конический, от r_work до r_flange (2 мм) на толщине буртика 1,25 мм | самоцентровка ролика, печать без поддержек |
| Облегчение кулачка | 8×Ø10 на R32 | не задевает ни ступицу, ни рабочую поверхность |
| Фаска отверстия кулачка | 1×45° с обеих сторон | плотный контакт с конусной гайкой |
| Отверстия под валы | стол Ø11, накладка Ø12 | В3 |
| Болты подстолья | 4×M6×45, шестигранная головка сверху, шайба + гайка nyloc снизу | п. 1 замечаний; длина 12+20+1,6+5+4 |
| Подстолье | 160×200×12 без рёбер, X=200…360 | п. 3 замечаний |
| Поперечины выноса | нет; верхние продольные балки 140…360 | п. 2 замечаний |
| Граничная поперечина | X=140…160 (обрезана с 180…220) | поперечина не должна заходить в вынос |

## 3. Уточнения после первой сборки fix3 (итерация 2)

По результатам просмотра модели пользователь уточнил два пункта. Решения
внесены в модель, спецификацию и отчёт.

**У1. Сколько отверстий облегчения в кулачковом диске?**

Решение: **8 отверстий** Ø10 на R32 (было 6). Шаг 45°, хорда между
отверстиями 24,5 мм; отверстия не задевают ни ступицу Ø10,2, ни рабочую
поверхность R45…50.

**У2. Форма накладок и способ крепления прижимной балки 21.**

Решение (заменяет В1 в части формы и крепления):

- накладки — **плоские Γ-образные** (перевёрнутая L), сталь **2 мм**,
  полки **60×20**; пара накладок стоит на передней и задней гранях балки
  и не выходит за её габарит;
- **нижней полки нет** — под балкой ничего;
- горизонтальная полка ложится на **боковую грань балки** (Z=110…130,
  Y=20…80) и стягивается с балкой **2 болтами M4 насквозь** (головка
  снаружи, гайка nyloc внутри) — крепление жёсткое, «сбоку»;
- вертикальная полка идёт **вниз по стойке** (Z=50…130, Y=0…20) и имеет
  два паза 20 мм — направляющие для **2 прижимных болтов M4** на пару;
  пара обжимает стойку с двух сторон (передняя и задняя грани), крепление
  регулируемое;
- ход опускания балки — **15 мм**: требуется 10 мм (5 мм — выход кольца
  6200 из паза + 5 мм запас), пазы 20 мм дают 15 мм хода с резервом;
  после опускания верх балки 115 мм < 125 мм (низ кольца 6200);
- прижимные винты M6 и полка под балкой из первой итерации fix3 удалены,
  как и 16 гаек/винтов к ним; вместо них — 8 прижимных M4×30 + 8 болтов
  M4×30 к балке с гайками.

**У3. Толщина накладок и возможность замены покупной деталью.**

Решение: накладки — **сталь 2 мм** (было 3 мм). В спецификации (поз. 14,
раздел «Изготовление») указано: «изготовление / краб «угол» 20×20», в
примечании — «Допускается замена покупной краб-системой «угол» для
профильной трубы 20×20». Размеры посадочных мест (пазы под M4, отверстия
Ø4,5, полки 60×20) от толщины не зависят; болты остаются M4×30.

## 4. Места, требующие проверки на реальном изделии

1. **Стяжка накладок** — проверить, что 2 прижимных болта M4 на пару
   удерживают балку 21 с кольцом 6200 от проскальзывания по стойке; при
   недостатке — шайбы, больший момент или M5.
2. **Накладки 2 мм** — проверить жёсткость в зоне пазов при затяжке; при
   деформации — 3 мм или уменьшить зазор в пазах.
3. **Пазы 20 мм / ход 15 мм** — свободное опускание балки 21 (верх до
   115 мм), выход кольца 6200 из паза и доступ к гайкам вала.
4. **Конический бортик кулачка** — проверить самоцентровку ролика на дисках
   3/5/10 мм и отсутствие заклинивания.
5. **Отверстия Ø11/Ø12** — проверить, что вал не касается стола и накладки
   при ходе −5/+5 мм.
6. **Рама 360 мм** — после удаления поперечин выноса жёсткость обеспечивают
   подстолье и продольные балки; проверить на собранном изделии.
7. **Печать рамы** — 360×200×300 одним куском, принтер ≥370×210×310.
