inutcin/boomboom/stages/fix1/Interview.md

# Интервью по этапу «Устранение замечания по первоначальной версии модели»

Дата: 2026-10-30
Этап: `stages/fix1`
Предыдущий этап: [`stages/model`](../model/README.md)

Вопросы заданы до начала моделирования. Ответы пользователя помечены как
«решение»; всё, что не задано явно, вынесено в «Принятые допущения» и
продублировано в [`params.csv`](./params.csv).

## 1. Вопросы и ответы

**В1. Ключевая перекомпоновка: стол вытянут вдоль оси привода и выступает за
раму. Какой вариант принять?**

Ответ: **стол 240×150, валы 180×100**.
- стол `X=−20…220`, `Y=25…175`;
- вылет 20 мм с переднего торца и со стороны выноса;
- зазор 5 мм до боковых стоек;
- валы в центрах средних поперечин: `X=10` и `190`; по `Y=50` и `150`.

**В2. Рама печатается одним куском. Какое сечение принять?**

Ответ: **сплошное сечение 20×20**. Это упрощает печать, снимает вопрос
тонких стенок и внутренних полостей, даёт прочные сёдла 6200 и отверстия
валов.

**В3. Из чего делать балку фиксации подшипников (поз. 21) и крабы (поз. 14)?**

Ответ: **балка 21 — PETG, сплошная 20×20; крабы — сталь 1,2 мм, угловые,
форма как в примере** (`pic/krab_view.png`, `pic/krab_plan.png`).

**В4. Как фиксировать 4 направляющих вала к верхней и средней поперечинам?**

Ответ: **8 ограничителей WCS10FR** — по 2 на вал (под средней поперечиной и
над верхней). Валы проходят через сплошные поперечины.

**В5. Рама 400×200×300 одним куском требует принтера с областью печати не
меньше ~410×210×310 мм. Что закладывать?**

Ответ: **принтер есть, рама одним куском**. Разъёмную раму не делать.

**В6. Подстолье должно обеспечить жёсткость вместо удалённой задней нижней
поперечины. Какая конструкция?**

Ответ: **12 мм + рёбра снизу**. Подстолье `200×160×12`, два продольных ребра
10×10 по боковым краям снизу, вне зоны дрели Ø100.

## 2. Принятые допущения

| Вопрос | Принято | Почему |
|---|---|---|
| Материал рамы | PETG | В ответе выбрано только сечение; PETG выбран по рекомендации — меньше хрупкость при вибрации |
| Линейные подшипники | LMK10UU (квадратный фланец 40×40) | В примерах этапа `fix1` указан LMK10UU, а не LMF10UU; это же изображение в `pic/LMK10UU.png` |
| Фланец LMK | 40×40×6, 4×Ø4,5 по сетке 32×32, корпус Ø19×29 | Стандарт LMK10UU; в модели корпус 29 + фланец 6 |
| Ограничители вала | WCS10FR, Ø30×8 | `pic/WCS10FR.png`; в этапе 1 в модели был заниженный Ø16 — исправлено |
| Крабы | Сталь 1,2 мм, 62×62, полки 35,5, отверстия Ø4,5/Ø6,5 | Форма и размеры с `pic/krab_plan.png`; схема применения — Т-узел «стойка — балка 21» |
| Крепление крабов | Винты M4 в резьбовые вставки PETG | Рама и балка 21 печатные; вставки дают разборность |
| Крепление фланцев LMK | 16 винтов M4×16 во вставки стола | Стол печатный, 10 мм |
| Крепление накладки | 4 потайных M4 по углам, отступ 5 мм; гайки nyloc снизу | Замечание «не в середине, а по углам»; отступ выбран из условия обхода фланцев LMK |
| Гайки на столе | M4 nyloc — 6, M10 nyloc — 2 (ролик) | Замечание о самоконтрящихся гайках |
| Шайбы пружин | Ø18/Ø10,5×1,5, 8 шт. | Замечание «шайбы между пружиной и столом/поперечиной» |
| Фаска кулачка | 1×45° с обоих торцов отверстия Ø10,2 | Замечание «небольшая фаска под конические гайки» |
| Подстолье | 200×160×12, рёбра 10×10 снизу по краям, `Z=190…202` | Ответ В6; верх подстолья поднят на 2 мм относительно этапа 1 |
| Верх выноса | 170…190 мм, без изменений | Подстолье 12 мм ставится сверху |
| Задняя нижняя поперечина | Удалена | Замечание п. 4 рамы |
| Средние продольные балки и центральная балка | Удалены | Замечания п. 1, 2 рамы |
| Стол и накладка | Печать, отдельные детали | Замечание: сомнения в конечной верхней поверхности |
| Дрель | Заглушка Ø100, ось `Z=140` | Точная модель будет позже; в спецификации — требования к дрели |
| Вращение дрели | Против часовой стрелки (проверить затяжку гаек) | Замечание; направление указано в спецификации и на листе |
| Вал привода | Шпилька M10, `X=0…255`; кулачок `X=94…106` | Компоновка с подшипниками в `X=10` и `190` |
| Осевая фиксация вала привода | Патрон дрели + гайки кулачка | Отдельный упор не вводился; отмечено в ограничениях |

## 3. Места, требующие проверки на реальном изделии

1. **Крабы 1,2 мм** — тонкий металл; при недостаточной жёсткости заменить на
   2 мм или перейти на M5. Проверить пятно контакта с PETG-стойкой.
2. **LMK10UU**: проверить фактическую сетку крепёжных отверстий (32×32) и
   толщину фланца; при другой сетке — поправить `params.csv`.
3. **6200 на шпильке M10**: резьба уменьшает посадочную поверхность; при
   люфте — вал с гладкими поясами под подшипники.
4. **Пружины 12×1,0**: номинал даёт ID 10,0 при вале Ø10; в модели принят
   ID 10,2. При сборке проверить/притереть.
5. **Печать рамы**: 400×200×300 одним куском, поддержки под верхними
   поперечинами и балками выноса; проверить коробление.
6. **Подстолье 12 мм с рёбрами**: проверить прогиб под массой дрели.
7. **Дрель**: направление вращения, мягкий пуск, регулировка оборотов,
   фиксируемый курок — обязательны при покупке.

## 4. Предложение по основному README

Основной [`README.md`](../../README.md) описывает сварную стальную раму из
трубы 20×20×1,5 и стол, вытянутый по Y. Этап `fix1` заменяет это на печатную
PETG-раму сплошного сечения 20×20 и стол 240×150, вытянутый по X. После
приёмки этапа предлагается обновить раздел «Описание конструкции» основного
README, чтобы он не противоречил модели.
