inutcin/boomboom/stages/fix2/Interview.md

# Интервью по этапу «Повторное устранение замечаний по первоначальной версии модели»

Дата: 2026-10-30
Этап: `stages/fix2`
Предыдущий этап: [`stages/fix1`](../fix1/README.md)

Перед моделированием были сформулированы вопросы по неоднозначным местам
замечаний. Ответ пользователя на план — «Делай», поэтому ниже зафиксированы
принятые варианты. Они же продублированы в [`params.csv`](./params.csv) со
статусом `fix2`.

## 1. Вопросы и принятые решения

**В1. Как понимать «полукруглую выемку только на глубину подшипника и в
центральной части»?**

Решение: карман шириной **9,4 мм** (6200 шириной 9 мм + по 0,2 мм на сторону),
радиальная глубина остаётся 5 мм, карман расположен по центру подшипника
(`X=10` и `X=190`). Плечи в балке 20×20 — по **5,3 мм** с каждой стороны.
Так наружное кольцо 6200 фиксируется и в радиальном, и в осевом направлении.

**В2. Сколько гаек ставить на каждый опорный 6200?**

Решение: по **две конусные гайки** (с обеих сторон подшипника) и по **две
контргайки M10 nyloc** — по одной на каждую конусную гайку. Всего на вал:
4 конусные + 4 контргайки; с кулачком и роликом — 8 + 8.

**В3. Как выполнить краб-систему, чтобы она не занимала место над балкой?**

Решение: на каждое соединение — **две пластины 1,2 мм**, вертикальная часть
62×62 на передней и задней гранях стойки и балки 21; горизонтальная лапка
9 мм внутрь под балку. Верх пластин — **Z=130** (вровень с верхом балки),
ниже — вертикальная часть до Z=48. В пластине — паз 24 мм (20 мм хода + радиус M6) под болт M6,
поэтому краб вместе с балкой опускается для замены вала. Пластины стянуты
болтом M6 через стойку и дополнительно прикручены M4 к балке через лапки.
Форма упрощена по сравнению с покупным G-крабом (`../fix1/pic/krab_plan.png`):
сохранены габарит 62×62, толщина 1,2, лапка 9 мм и схема двух пластин.

**В4. Что считать «выступами из рамы на заднем торце под болты»?**

Решение: удалена задняя верхняя поперечина — два участка `X=380…400`,
`Y=0…50` и `Y=150…200` при `Z=170…190`. Болты подстолья теперь проходят через
верхние продольные балки, дополнительная балка не нужна.

**В5. Как развернуть подстолье и как его крепить?**

Решение: подстолье **160×200×12**, `X=240…400`, `Y=0…200`, `Z=190…202`.
Оно не доходит до стола 20 мм по X и занимает всю ширину рамы. Крепление —
4 потайных болта **M6×35** сквозь подстолье и верхние продольные балки
(`X=260/360`, `Y=10/190`), гайки снизу. Рёбра 8×10 развёрнуты вдоль Y у
переднего и заднего краёв, вне зоны дрели.

**В6. Нужно ли удлинять вал привода вперёд?**

Решение: да, до `X=−10`. Передняя контргайка (`X=−8…0`) остаётся снаружи
рамы; габарит сборки не меняется, потому что стол уже выступает до `X=−20`.

## 2. Принятые допущения

| Вопрос | Принято | Почему |
|---|---|---|
| Ширина кармана 6200 | 9,4 мм | 9 мм + 0,2 мм на сторону; осевой зазор 0,2 |
| Плечо кармана | 5,3 мм | (20−9,4)/2; достаточно для PETG |
| Контргайки на 6200 | 2 на подшипник | Одна на каждую конусную гайку; надёжнее при вибрации |
| Передняя контргайка | Снаружи рамы, `X=−8…0` | Внутри 20 мм стойки две гайки и подшипник не помещаются |
| Краб | 2 пластины 1,2 мм, 62×62, лапка 9 мм | Замечание fix2; упрощение покупного G-краба |
| Верх краба | Z=130 | Вровень с верхом балки, выше ничего нет |
| Паз краба | 24 мм (ход 20) | Ход опускания балки для замены вала |
| Крепление краба | 1×M6 через стойку + 4×M4 в балку на соединение | Соответствует схеме «болты + винты в профиль» |
| Задняя верхняя поперечина | Удалена | Болты идут через продольные балки, жёсткость — подстолье |
| Подстолье | 160×200×12, X=240…400, Y=0…200 | Разворот на 90°, вровень с задним торцом |
| Крепление подстолья | 4×M6×35 сквозь балки, гайки снизу | Замечание fix2; без дополнительной балки |
| Рёбра подстолья | 2×(8×10) вдоль Y, X=240…248 и 392…400 | Вне дрели, stiffening свободных краёв |
| Материалы | PETG рама/балка/подстолье; PLA стол/накладка/кулачок; сталь крабы/крепёж | Как в fix1 |

## 3. Места, требующие проверки на реальном изделии

1. **Карман 6200 9,4 мм** — проверить фактическую ширину 6200 и точность
   печати; при необходимости притереть плечи.
2. **Гайки на валу** — резьба M10 уменьшает посадочную поверхность; при люфте
   заменить участки под подшипниками на гладкие пояса.
3. **Краб-система** — 1,2 мм сталь; проверить усилие зажима и пятно контакта
   с PETG. При недостаточной жёсткости — 2 мм или M5.
4. **Паз 20 мм** — проверить свободное опускание балки и доступ к гайкам.
5. **Подстолье** — проверить прогиб 12 мм PETG под массой дрели; при
   необходимости усилить рёбра.
6. **Задняя часть рамы** — после удаления верхней поперечины проверить
   жёсткость; подстолье работает как диафрагма.
7. **Печать рамы** — 400×200×300 одним куском, принтер ≥410×210×310;
   поддержки под верхними балками выноса.
