inutcin/boomboom/stages/fix10l/cad/checks.csv

Проверка | Значение | Норма | Статус | Примечание
Габарит сборки X×Y×Z | 400.0×200.0×300.0 | 400×200×300 | OK | X=0…400, Y=0…200, Z=0…300
Шпильки — количество | 6 | 6 | OK | 4 виброотсека + 2 подстолья
Шпильки — положение X | 20 / 180 / 385 | по модели | OK | Y=15/185
Шпильки — длины | 4×300 + 2×220 | 4×300 + 2×220 | OK | M10
Стол — размер | 200.0×200.0×10.0 | 200×200×10 | OK | фанера 10
Накладка — размер | 200.0×150.0×6.0 | 200×150×6 | OK | переиспользование fix9; без отверстий под шпильки
Верхняя платформа — размер | 200.0×200.0×10.0 | 200×200×10 | OK | фанера 10
Вырез платформы | 120×120 | 120×120 | OK | X=40…160, Y=40…160
Основание — размер | 400.0×200.0×24.0 | 400×200×24 | OK | фанера 24; цековки Ø22×20
Подстолье — размер | 200.0×200.0×10.0 | 200×200×10 | OK | X=200…400
Продольные балки | 2×L400, 20×20×2 | 2 | OK | Y=15/185; 3×Ø11
Поперечные балки | 2×L200, 20×20×2 | 2 | OK | X=20/180; Ø10,2 под вал
Вал привода — опоры | 2 отверстия Ø10,2 | 2 | OK | две поперечные балки; вал X=0…220
Пружины — количество / L | 4 / 36 мм | 4 / 36 | OK | Ø17×1,5×60; fix8/expert3
Пружины — преднатяг при L=36 | 143,7 Н | — | OK | 4k=5,989 Н/мм
Пружины — сила при L=46 | 83,9 Н | — | OK | нижнее положение cam_10
Подкладки пружин | 2×200×25×5; 4×Ø12 | 2 | OK | полосы от края стола до накладки; 6 саморезов
Нижний демпфер | 4×Ø30/12×2 | 4 | OK | резиновые кольца, без преднатяга
Зазор демпфер — стол | 11 мм | ≥10 | OK | при ходе 10 мм остаётся 1 мм
Кронштейн ролика | 2 уголка 50×50×2, ширина 20 | 2 | OK | 8 саморезов M4×12; стойки до Z=175
Ролик — центр стола | X=100 / 200 | 100 | OK | кулачок и ролик точно под серединой стола
Ролик / ось | 6200 + M10 L=44 | Ø10 | OK | 2 гайки, 6 шайб, 2 тонких кольца
Кулачки — переиспользование | 3/5/10; R45…50 | fix9 | OK | STEP/STL fix9; без изменений
Кулачок 5 — объём | 85378 мм³ | 85378 | OK | совпадает с fix9
Накладка — объём | 161413 мм³ | 161413 | OK | совпадает с fix9
Дрель — корпус | Ø100 условно | — | OK | X=226…351; патрон X=206…226
U-болты | 2×M6 R70 | 2 | OK | ноги Y=30/170; X=240/300
Зазор U-болт — дрель | 17 мм | подкладка | OK | резиновое полукольцо Ø100/134
Масса без дрели | 6.08 кг | — | OK | по объёмам и плотностям
Пересечения (все пары) | 0.000 мм³ / 0 пар | <0,5 мм³ | OK | bbox-фильтр + common; 40 деталей
Стол, cam_3 макс: пересечения | 0.000 мм³ | <0,5 мм³ | OK | стол опущен на -0 мм
Контакт ролик — cam_3 макс | 0.0000 мм | 0…0,05 | OK | distToShape
Кронштейн — cam_3 макс | 0.000 мм³ | <0,5 мм³ | OK
Стол, cam_3 мин: пересечения | 0.000 мм³ | <0,5 мм³ | OK | стол опущен на 3 мм
Контакт ролик — cam_3 мин | 0.0000 мм | 0…0,05 | OK | distToShape
Кронштейн — cam_3 мин | 0.000 мм³ | <0,5 мм³ | OK
Стол, cam_5 макс: пересечения | 0.000 мм³ | <0,5 мм³ | OK | стол опущен на -0 мм
Контакт ролик — cam_5 макс | 0.0000 мм | 0…0,05 | OK | distToShape
Кронштейн — cam_5 макс | 0.000 мм³ | <0,5 мм³ | OK
Стол, cam_5 мин: пересечения | 0.000 мм³ | <0,5 мм³ | OK | стол опущен на 5 мм
Контакт ролик — cam_5 мин | 0.0000 мм | 0…0,05 | OK | distToShape
Кронштейн — cam_5 мин | 0.000 мм³ | <0,5 мм³ | OK
Стол, cam_10 макс: пересечения | 0.000 мм³ | <0,5 мм³ | OK | стол опущен на -0 мм
Контакт ролик — cam_10 макс | 0.0000 мм | 0…0,05 | OK | distToShape
Кронштейн — cam_10 макс | 0.000 мм³ | <0,5 мм³ | OK
Стол, cam_10 мин: пересечения | 0.000 мм³ | <0,5 мм³ | OK | стол опущен на 10 мм
Контакт ролик — cam_10 мин | 0.0000 мм | 0…0,05 | OK | distToShape
Кронштейн — cam_10 мин | 0.000 мм³ | <0,5 мм³ | OK
Стол — ход вниз | до 10 мм | 3/5/10 | OK | шпильки-направляющие, люфт 0,5 мм
Стол — отверстия под шпильки | 4×Ø11 | Ø11 | OK | радиальный зазор 0,5 мм
Стол — накладка | 4×M4×12 саморез | 4 | OK | тот же тип, что у кронштейна; накладка без отверстий под шпильки
Шайбы пружин | 8×Ø20/10,5×2 | 8 | OK | те же, что общие M10
Подкладки — саморезы | 6×M4×12 | 6 | OK | 3 на каждую полосу; пилот 7 мм
Стол — пружинные подкладки | 2 полосы 200×25×5 | 2 | OK | от края стола до накладки; 6 саморезов M4×12
Платформа — зазор до шайб | 5 мм | ≥5 | OK | вырез 120×120; шайбы Ø20×2
Дрель — патрон / задняя балка | 21 мм | ≥2 | OK | патрон X=206; балка до 185
Дрель — продольные балки | 35 мм | ≥5 | OK | корпус Y=50…150; балки Y=5…25/175…195
Дрель — задние шпильки | 4 мм | ≥2 | OK | рукоятка до 381; шпильки X=385
Подстолье — крепление | 2 nyloc; 0 jam | 2 | OK | свободная часть — болт M10 + nyloc снизу
Основание — цековки | 6×Ø22×20 | 6 | OK | nyloc + контрагайка h=8 не выступают
Смазка шпилек | обязательна | — | OK | сталь по стали; графит/литол
Nyloc — низ станины | 6 | 6 | OK | снизу, в цековках
Nyloc — верх подстолья | 2 | 2 | OK | сверху шпилек 385; без jam
Nyloc — верх платформы | 4 | 4 | OK | оконцовка шпилек
Nyloc — ось ролика | 2 | 2 | OK | концы оси
Nyloc — болт подстолья | 1 | 1 | OK | снизу балки
Болт подстолья | M10×50 + nyloc | 1 | OK | X=250, Y=15; головка сверху, гайка снизу
Контрагайки — шпильки | 26 | 26 | OK | M10 h=8; база, балки; подстолье — только nyloc
Контрагайки — вал | 4 | 4 | OK | по 1 на стопку
Вал — вылет за балку | 20 мм | 20 | OK | место под 2 шайбы + гайку + контрагайку
Вал — стопки у балок | 4 стопки | 4 | OK | 2 шайбы + гайка + контрагайка с каждой стороны
Ограждение | нет | C1 | ВНИМАНИЕ | орочья версия без кожуха; добавить отдельно
Привод дрель-вал | патрон + шпилька | C2 | ВНИМАНИЕ | без муфты; биение проверять при сборке
Движущаяся масса | 685 г | — | OK | стол + накладка + кронштейны + ролик + крепёж
f_соб стола | ≈14.9 Гц | вне 5…15 или демпфер | ВНИМАНИЕ | ≈14.9 Гц — на верхней границе; проверить демпфирование
