inutcin/boomboom/stages/fix8/cad/checks.csv

Проверка | Значение | Норма | Статус | Примечание
Рама — число тел | 1 | 1 | OK | печать одним куском; стыки слиты
Галтели рамы R10 | 26 шт. | 26 | OK | низ 4, средние поперечины 8, верх/низ поперечин 8, вынос 6; верхние внутренние углы пропущены (кожух/буферы)
Галтели в балках выноса | 6 шт. | 6 | OK | верх у граничной поперечины 2, верх у задних стоек 2, низ у задних стоек 2; нижний стык у X=160 заподлицо
Габарит рамы, X×Y×Z | 360.0×200.0×300.0 | 360×200×300 | OK
Виброотсек / вынос | 160 / 200 мм | 160 / 200 | OK | fix3: виброотсек −40 мм
Габарит сборки (стол, кожух, ограничители) | 380.0×215.0×308.0 | 380×215×308 | OK | X — вылет стола −20; Y — кожух 5 мм + шляпки 2,5; Z — 308
Стол, X×Y×T | 200.0×150.0×10.0 | 200×150×10 | OK | X=−20…180, Y=25…175
Шаг валов X×Y | 140×100 | 140×100 | OK | X=10/150, Y=50/150
Длина направляющего вала | 166 мм | 166 (без изм.) | OK | Z=142…308 — высота устройства не меняется
Вылет стола: спереди / у выноса | 20.0 / 20.0 мм | 20 / 20 | OK
Зазор стол — боковые стойки, слева / справа | 5.0 / 5.0 мм | 5 / 5 | OK | Y=25 и 175 при стойках 0…20 и 180…200
Запас фланца LMK по X, спереди / сзади | 10.0 / 10.0 мм | ≥0 | OK
Запас фланца LMK по Y | 5.0 / 5.0 мм | ≥0 | OK
Зазор гайки накладки — фланец LMK | 1.0 мм | ≥0.5 | OK | гайка M4 на углу против квадратного фланца 40×40
Отверстия под валы: стол / накладка | Ø11 / Ø12 | Ø11 / Ø12 | OK | зазор 0,5 / 1,0 мм на сторону при вале Ø10
Отверстия под валы в раме (поперечины) | Ø10.5 | Ø10,5 | OK | вал неподвижен относительно рамы
Задняя нижняя поперечина — отсутствует | 0.000 мм³ | 0 | OK | объём в зоне X=341…359, Z=1…19
Средняя боковая балка — отсутствует | 0.000 мм³ | 0 | OK | зона Y=2…18, Z=152…168
Центральная балка с окном — отсутствует | 0.000 мм³ | 0 | OK | зона Y=92…108, Z=152…168
Задняя верхняя поперечина — отсутствует | 0.000 мм³ | 0 | OK | fix2: зона X=341…359, Z=171…189
Поперечины выноса (верх) — отсутствуют | 0.000 мм³ | 0 | OK | fix3: зона X=210…330, Y=25…175, Z=171…189
Поперечины выноса (средний уровень) — отсутствуют | 0.000 мм³ | 0 | OK | fix3: зона X=210…330, Y=25…175, Z=151…169
Поперечины выноса (низ) — отсутствуют | 0.000 мм³ | 0 | OK | fix3: зона X=210…330, Y=25…175, Z=1…19
Верхние балки выноса | X=140…360 | 140…360 | OK | опираются на граничную поперечину по Z=170
Карман 6200 — ширина / плечо | 9.4 / 5.3 мм | 9,4 / 5,3 | OK | только центральная часть поперечины и балки 21
Осевой зазор 6200 в кармане | 0.2 / 0.2 мм | ≤0,2 | OK | наружное кольцо не может выпасть вдоль оси
Седло 6200: низ поперечины / верх балки 21 | 150 / 130 | 150 / 130 | OK | просвет 20 мм; седла по 5 мм; 6200 Ø30
Перекрытие седел 6200 (5+5+20−30) | 0.0 мм | 0 | OK | радиальный зажим 5+5 мм
Рама — опорные 6200 (карман) | 0.000 мм³ | <0,5 мм³ | OK | касание в кармане
Балка 21 — опорные 6200 (карман) | 0.000 мм³ | <0,5 мм³ | OK | касание в кармане
Балка 21 — низ / верх | 110 / 130 | 110 / 130 | OK | опускается при освобождении уголков
Балка 21 — длина / зазор до стойки | 159.6 / 0.2 мм | 159,6 / 0,2 | OK | в распор между стойками
Вал привода — концы / длина | -10…215 / 225 мм | −10…215 / 225 | OK | fix3: −40 мм вместе с виброотсеком
Конусные гайки / контргайки 6200 | 4 / 4 | 4 / 4 | OK | по 2 конуса и по 2 контргайки M10 на каждый 6200
Вал привода — осевой люфт | 0 (зажат) | 0 | OK | внутренние кольца 6200 зажаты конусами с двух сторон
6200 №1 — осевой стек | гайка -8.0…0.0 | конус 0.0…5.5 | 6200 5.5…14.5 | конус 14.5…20.0 | гайка 20.0…28.0 | симметрично | OK | fix6: контргайка снаружи конуса, а не поверх него
6200 №1 — гайка к конусу | 0.000 мм | 0 | OK | гайка прижата к большому торцу конуса
6200 №2 — осевой стек | гайка 132.0…140.0 | конус 140.0…145.5 | 6200 145.5…154.5 | конус 154.5…160.0 | гайка 160.0…168.0 | симметрично | OK | fix6: контргайка снаружи конуса, а не поверх него
6200 №2 — гайка к конусу | 0.000 мм | 0 | OK | гайка прижата к большому торцу конуса
6200 №1 — левый конус | 0.000 мм | 0 (касание) | OK | малый торец конуса прижат к внутреннему кольцу
6200 №1 — правый конус | 0.000 мм | 0 (касание) | OK | малый торец конуса прижат к внутреннему кольцу
6200 №2 — левый конус | 0.000 мм | 0 (касание) | OK | малый торец конуса прижат к внутреннему кольцу
6200 №2 — правый конус | 0.000 мм | 0 (касание) | OK | малый торец конуса прижат к внутреннему кольцу
Контргайка 6200 — подшипник | 5.5 мм | ≥5 | OK | конус 5,5 мм разносит гайку и наружное кольцо
Контргайки 6200 — балка 21 / поперечина | 0.19 / 0.19 мм | ≥0,1 | OK | гайки вынесены по X за балку; у покупной гайки e≈18,9
Передняя контргайка — вылет за раму | 8 мм | 8 | OK | габарит сборки не меняется: стол до X=−20
Задняя контргайка — подстолье | 32.0 мм | ≥10 | OK | X=160…168 против подстолья X≥200
Уголки — количество / на конец балки | 8 / 2 | 8 / 2 | OK | 4 конца × (передняя + задняя грань)
Накладка — верх / низ | 130 / 50 мм | 130 / 50 | OK | верх = верх балки 21; ниже 50 мм не идёт
Накладка — зазор до LMK / стола | 60 / 95 мм | ≥60 / ≥90 | OK | накладка не мешает столу и линейному подшипнику
Верхняя грань балки 21 — свободна | 0.000 мм³ | 0 | OK | fix3: накладки на боковых гранях, сверху балки ничего нет
Под балкой (нижняя полка) — отсутствует | 0.000 мм³ | 0 | OK | зона Y=20…180, Z=100…109,5 под балкой
Накладка — пазы / ход опускания | 2 × 20 / 15 мм | 2×20 / ≥10 | OK | опускание балки для извлечения 6200 из пазов
Накладка — низ после опускания / зазор до нижнего пояса | 35 / 15 мм | ≥5 | OK | нижний пояс Z=0…20
Балка 21 после опускания на 15 мм — верх | 115 мм | <125 (низ 6200) | OK | 6200 освобождается, вал снимается
Крепление накладок к балке | 2×M4 насквозь, сбоку | жёсткое | OK | болты M4×30 через пару накладок и балку при Z=120
Прижимные болты накладок | 2×M4 на пару (8) | 8 | OK | стягивают стойку с двух сторон через пазы
Подстолье, X×Y×Z | 160.0×200.0×12.0 | 160×200×12 | OK | X=200…360, Y=0…200
Подстолье — рёбра отсутствуют | 0.000 мм³ | 0 | OK | fix3: зона под подстольем Z=178…190
Подстолье — зазор до стола по X / Z | 20 / 23 мм | 20 / ≥15 | OK | при нижнем ходе стола Z-зазор 18 мм
Подстолье — зазор до LMK | 30 мм | ≥5 | OK | фланец LMK X≤170, подстолье X≥200
Подстолье — дрель Ø100 | 0.0 мм | 0 (прилегает) | OK | ось Z=140, верх 190 = низ подстолья 190
Подстолье — крепление | 4×M6×45, головка сверху | 4, обычные болты | OK | fix3: без зенковки; X=220/320, Y=10/190
Подстолье — зенковки нет (материал у болта) | 202.9 мм³ | ≈203 (без зенковки) | OK | объём в зоне X=216…224, Y=6…14, Z=196…202
Ход стола (диски 3/5/10, max R50) | 3 / 5 / 10 мм | 3…10 мм | OK | fix4: верхнее положение 241 одинаково для всех дисков
Верхняя точка стола | 241 мм | 241 | OK | overlay_z1 при максимальном радиусе кулачка 50
Пружина свободная L0 | 60 мм | 60 | OK | fix8: оптимальная пружина expert3
Пружина установленная (верх) | 36 мм | ≤L0 (60) | OK | 36 мм при верхнем положении; 46 мм при нижнем
Пружина при верхнем/нижнем | 36…46 мм | ≤60 | OK | сжатие 24…14 мм (диск 10); свободная 60
Зазор LMK10UU — верх средней поперечины | 10 мм | ≥5 | OK | номинал 20 мм; при нижнем ходе 10 мм — 10 мм
Зазор ограничителя Ø30 — балка 21 | 12 мм | ≥5 | OK | низ вала 142, верх балки 130
Пружина ID — вал Ø10 | 4.0 мм | ≥0.3 | OK | ID 14.0 при вале Ø10; в модели 14.2
Кулачок — лепестки (макс./мин.) | 2 / 2 | 2 / 2 | OK | r(θ)=r0+e·cos2θ; два максимума и два минимума
Кулачок — симметрия r(θ)=r(θ+π) | 7.11e-15 мм | = 0 | OK | профиль фиксирован аналитически
Кулачок — максимум/минимум радиуса (диск 5) | 50.0 / 45.0 мм | 50 / 45 | OK | ход = 2e = 5 мм
Кулачок — ход по дискам | 3 / 5 / 10 мм | 2e = 3/5/10 | OK | e = 1,5 / 2,5 / 5 мм
Кулачок — отверстие под гайку M10 | 17.1 AF (гайка 17 AF) | 17,0…17,2 | OK | плотная посадка; гайка приварена к шпильке (п. 3)
Кулачок — буртик | Ø40×10, X=64…74 | Ø40×10 | OK | левый торец; защищает затяжку от остатков сварки
Кулачок — насечки | 0 шт. | 0 | OK | по fix5 п. 2 насечек нет ни на буртике, ни на другом торце
Фаска отверстия кулачка | 0.0 мм | 0 | OK | фаски нет
Бортик ложбинки кулачка | конус 58° | скошен | OK | от рабочего радиуса к +2 мм — самоцентровка ролика
Ложбинка кулачка — глубина | 2.0 мм | 1…2 | OK | буртик +2 мм на торце
Облегчение кулачка | 8×Ø10 на R32 | 8×Ø10 R32; 2 макс + 2 мин + 4 между | OK | стенка до контура: 13.0 / 8.0 / 3.0 мм (макс./45°/мин., диск 10)
Облегчение — стенка на минимуме (диск 10) | 3.0 мм | ≥3 (принято) | ВНИМАНИЕ | R32/Ø10 на минимуме R40: 3 мм; риск для PLA, предложение Ø8 или R30
Шайбы кулачка | 2 × Ø40/Ø10.5×2.5 | 2, с двух сторон | OK | слева — на буртике (61,5…64), справа — на плоском торце (86…88,5)
Гайки кулачка | 2 × M10 + 2 × контргайка | по одной с каждой стороны | OK | слева 45,5…61,5, справа 88,5…104,5; шайба между гайкой и диском
Приваренная гайка M10 | 1 × 17 AF, X=74…82 | 17 AF | OK | закручена и приварена к шпильке; входит в шестигранник диска
Осевой стек кулачка | контргайка 45.5…53.5 / гайка 53.5…61.5 / шайба 61.5…64.0 / буртик 64.0…74.0 / диск 74…86 / шайба 86.0…88.5 / гайка 88.5…96.5 / контргайка 96.5…104.5 | без зазоров | OK | затяжка с двух сторон; гайка внутри диска — привод
Частота стола = 2 × частота вала | 5…15 Гц → 150…450 об/мин | 2 лепестка | OK | на 2 лепестках стол совершает 2 колебания за оборот
Кожух — толщина / материал | 5 мм / поликарбонат | 4…5 мм | OK | 4 пластины: 2 боковые + 2 наружных бортика
Кожух — боковые панели | 2 × (160×300) | закрыть бока | OK | Y=−5…0 и 200…205; от нижней до верхней балки
Кожух — внутренние бортики | 0 шт. | 0 | OK | не нужны (п. 8); защита — резиновые ограничители в углах
Кожух — наружные бортики | 2; низ 246 мм | 2 стороны | OK | закрывают большую часть пружин
Кожух — зазор до верхней точки стола | 5 мм | 5 | OK | бортики до Z=246 при столе 241
Кожух — вынос не закрыт | 0.000 мм³ | 0 | OK | объём кожуха в зоне выноса X=170…360
Кожух — саморезы | 22 × M4×16, шляпка Ø8 | саморезы с прижимной шляпкой | OK | пилоты Ø3,5 в PETG; 16 боковых + 6 наружных
Кожух — зазор до пружин | 2 мм | ≥4 | OK | наружный бортик X=−5…0; пружина X=4…16 (зазор 4 мм)
Буферы — количество / на угол | 4 / 1 | 4 / 1 | OK | по одному в каждый угол «поперечина — стойка»; по обе стороны от пружины не ставим
Буферы — низ / зазор до стола | 244 / 3 мм | 244 / 3 | OK | верхняя точка стола 241
Буферы — зазор до пружины | 2 мм | 5 | OK | буфер Y=20…39; пружина Y=44…56; задний — Y=161…180
Буферы — прижаты к поперечине и стойке | Z=280 / Y=20 | обе поверхности | OK | верх — низ верхней поперечины, бок — грань стойки
Кольца на валах | 4 × Ø10.5/Ø18×7 | 4 кольца | OK | сантех. прокладка/шланг, Z=170…177
Кольцо — зазор до LMK при диске 10 мм | 3 мм | 3 | OK | низ LMK 180 при нижнем ходе 10 мм; верх кольца 177
Кольцо — зазор до LMK при диске 5 мм | 8 мм | ≥3 | OK | низ LMK 185; верх кольца 177
Кольцо — зазор до средней поперечины | 0 мм | ≥0 | OK | верх поперечины 170; кольцо лежит на ней
Ролик/6200 — ось | 0.1 мм | 0.05…0.2 | OK | Ø10,1
U-хомут — дрель Ø100 | 0.0 мм | 0 (касание) | OK | раствор 100
Рама — стол | 0.000 мм³ | <0,5 мм³ | OK
Рама — накладка | 0.000 мм³ | <0,5 мм³ | OK
Рама — LMK10UU | 0.000 мм³ | <0,5 мм³ | OK
Рама — подстолье | 0.000 мм³ | <0,5 мм³ | OK
Рама — кулачок 5 | 0.000 мм³ | <0,5 мм³ | OK
Рама — балка 21 | 0.000 мм³ | <0,5 мм³ | OK
Рама — уголки | 0.000 мм³ | <0,5 мм³ | OK
Рама — вал привода | 0.000 мм³ | <0,5 мм³ | OK
Рама — направляющие валы | 0.000 мм³ | <0,5 мм³ | OK
Рама — ограничители | 0.000 мм³ | <0,5 мм³ | OK
Рама — пружины | 0.000 мм³ | <0,5 мм³ | OK
Рама — шайбы пружин | 0.000 мм³ | <0,5 мм³ | OK
Рама — U-хомуты | 0.000 мм³ | <0,5 мм³ | OK
Рама — кронштейны | 0.000 мм³ | <0,5 мм³ | OK
Стол — кронштейн | 0.000 мм³ | <0,5 мм³ | OK
Стол — LMK10UU | 0.000 мм³ | <0,5 мм³ | OK
Стол — накладка | 0.000 мм³ | <0,5 мм³ | OK
Стол — вал привода | 0.000 мм³ | <0,5 мм³ | OK
Стол — направляющие валы | 0.000 мм³ | <0,5 мм³ | OK
Стол — подстолье | 0.000 мм³ | <0,5 мм³ | OK
Стол — уголки | 0.000 мм³ | <0,5 мм³ | OK
Накладка — направляющие валы | 0.000 мм³ | <0,5 мм³ | OK
Кулачок — кронштейн | 0.000 мм³ | <0,5 мм³ | OK
Кулачок — ролик | 0.000 мм³ | <0,5 мм³ | OK
Кулачок — шайбы | 0.000 мм³ | <0,5 мм³ | OK
Кулачок — гайки | 0.000 мм³ | <0,5 мм³ | OK
Кулачок — контргайки | 0.000 мм³ | <0,5 мм³ | OK
Кронштейн — гайки ролика | 0.000 мм³ | <0,5 мм³ | OK
Балка 21 — уголки | 0.000 мм³ | <0,5 мм³ | OK
Уголки — прижимные болты | 0.000 мм³ | <0,5 мм³ | OK
Уголки — гайки прижимные | 0.000 мм³ | <0,5 мм³ | OK
Уголки — болты балки | 0.000 мм³ | <0,5 мм³ | OK
Уголки — гайки балки | 0.000 мм³ | <0,5 мм³ | OK
Уголки — вал привода | 0.000 мм³ | <0,5 мм³ | OK
Уголки — ограничители | 0.000 мм³ | <0,5 мм³ | OK
Уголки — направляющие валы | 0.000 мм³ | <0,5 мм³ | OK
Уголки — LMK10UU | 0.000 мм³ | <0,5 мм³ | OK
Уголки — опорные 6200 | 0.000 мм³ | <0,5 мм³ | OK
Балка 21 — болты накладок | 0.000 мм³ | <0,5 мм³ | OK
Ограничители — валы | 0.000 мм³ | <0,5 мм³ | OK
Пружины — шайбы | 0.000 мм³ | <0,5 мм³ | OK
Шайбы — накладка | 0.000 мм³ | <0,5 мм³ | OK
Подстолье — U-хомуты | 0.000 мм³ | <0,5 мм³ | OK
Подстолье — вал привода | 0.000 мм³ | <0,5 мм³ | OK
Подстолье — LMK10UU | 0.000 мм³ | <0,5 мм³ | OK
U-хомуты — рама | 0.000 мм³ | <0,5 мм³ | OK
Вал привода — шайбы кулачка | 0.000 мм³ | <0,5 мм³ | OK
Вал привода — гайки кулачка | 0.000 мм³ | <0,5 мм³ | OK
Вал привода — контргайки кулачка | 0.000 мм³ | <0,5 мм³ | OK
Вал привода — гайки 6200 | 0.000 мм³ | <0,5 мм³ | OK
Вал привода — контргайки 6200 | 0.000 мм³ | <0,5 мм³ | OK
6200 — гайки 6200 | 0.000 мм³ | <0,5 мм³ | OK
6200 — контргайки 6200 | 0.000 мм³ | <0,5 мм³ | OK
Конусы 6200 — контргайки 6200 | 0.000 мм³ | <0,5 мм³ | OK
Конусы 6200 — рама | 0.000 мм³ | <0,5 мм³ | OK
Контргайки 6200 — рама | 0.000 мм³ | <0,5 мм³ | OK
Конусы 6200 — балка 21 | 0.000 мм³ | <0,5 мм³ | OK
Контргайки 6200 — балка 21 | 0.000 мм³ | <0,5 мм³ | OK
Конусы 6200 — уголки | 0.000 мм³ | <0,5 мм³ | OK
Контргайки 6200 — уголки | 0.000 мм³ | <0,5 мм³ | OK
Конусы 6200 — кулачок | 0.000 мм³ | <0,5 мм³ | OK
Контргайки 6200 — кулачок | 0.000 мм³ | <0,5 мм³ | OK
Кронштейн — ролик | 0.000 мм³ | <0,5 мм³ | OK
Кронштейн — ось | 0.000 мм³ | <0,5 мм³ | OK
Ролик — ось | 0.000 мм³ | <0,5 мм³ | OK
Фланцевые винты — стол | 0.000 мм³ | <0,5 мм³ | OK
Фланцевые винты — LMK | 0.000 мм³ | <0,5 мм³ | OK
Винты накладки — стол | 0.000 мм³ | <0,5 мм³ | OK
Гайки накладки — стол | 0.000 мм³ | <0,5 мм³ | OK
Прижимные болты — рама | 0.000 мм³ | <0,5 мм³ | OK
Гайки прижимные — рама | 0.000 мм³ | <0,5 мм³ | OK
Болты подстолья — рама | 0.000 мм³ | <0,5 мм³ | OK
Болты подстолья — подстолье | 0.000 мм³ | <0,5 мм³ | OK
Гайки подстолья — рама | 0.000 мм³ | <0,5 мм³ | OK
Рама — кожух | 0.000 мм³ | <0,5 мм³ | OK
Стол — кожух | 0.000 мм³ | <0,5 мм³ | OK
Накладка — кожух | 0.000 мм³ | <0,5 мм³ | OK
Пружины — кожух | 0.000 мм³ | <0,5 мм³ | OK
LMK — кожух | 0.000 мм³ | <0,5 мм³ | OK
Подстолье — кожух | 0.000 мм³ | <0,5 мм³ | OK
Вал привода — кожух | 0.000 мм³ | <0,5 мм³ | OK
Кулачок — кожух | 0.000 мм³ | <0,5 мм³ | OK
Балка 21 — кожух | 0.000 мм³ | <0,5 мм³ | OK
Уголки — кожух | 0.000 мм³ | <0,5 мм³ | OK
Кронштейн — кожух | 0.000 мм³ | <0,5 мм³ | OK
U-хомуты — кожух | 0.000 мм³ | <0,5 мм³ | OK
Кожух — саморезы | 0.000 мм³ | <0,5 мм³ | OK
Рама — саморезы кожуха | 0.000 мм³ | <0,5 мм³ | OK
Буферы — рама | 0.000 мм³ | <0,5 мм³ | OK
Буферы — стол | 0.000 мм³ | <0,5 мм³ | OK
Буферы — накладка | 0.000 мм³ | <0,5 мм³ | OK
Буферы — пружины | 0.000 мм³ | <0,5 мм³ | OK
Буферы — кожух | 0.000 мм³ | <0,5 мм³ | OK
Кольца — рама | 0.000 мм³ | <0,5 мм³ | OK
Кольца — валы | 0.000 мм³ | <0,5 мм³ | OK
Кольца — LMK | 0.000 мм³ | <0,5 мм³ | OK
Кольца — пружины | 0.000 мм³ | <0,5 мм³ | OK
Кулачок — приваренная гайка | 0.000 мм³ | <0,5 мм³ | OK
Шайбы — гайки кулачка | 0.000 мм³ | <0,5 мм³ | OK
Гайки — контргайки кулачка | 0.000 мм³ | <0,5 мм³ | OK
Шайбы — контргайки кулачка | 0.000 мм³ | <0,5 мм³ | OK
Стол при ходе 5 мм, низ — рама | 0.000 мм³ | <0,5 мм³ | OK
Стол при ходе 5 мм, низ — балка 21 | 0.000 мм³ | <0,5 мм³ | OK
Стол при ходе 5 мм, низ — уголки | 0.000 мм³ | <0,5 мм³ | OK
Стол при ходе 5 мм, низ — направляющие | 0.000 мм³ | <0,5 мм³ | OK
Стол при ходе 5 мм, низ — подстолье | 0.000 мм³ | <0,5 мм³ | OK
Стол при ходе 5 мм, низ — кожух | 0.000 мм³ | <0,5 мм³ | OK
Стол при ходе 5 мм, верх — рама | 0.000 мм³ | <0,5 мм³ | OK
Стол при ходе 5 мм, верх — балка 21 | 0.000 мм³ | <0,5 мм³ | OK
Стол при ходе 5 мм, верх — уголки | 0.000 мм³ | <0,5 мм³ | OK
Стол при ходе 5 мм, верх — направляющие | 0.000 мм³ | <0,5 мм³ | OK
Стол при ходе 5 мм, верх — подстолье | 0.000 мм³ | <0,5 мм³ | OK
Стол при ходе 5 мм, верх — кожух | 0.000 мм³ | <0,5 мм³ | OK
Кулачок 3: макс. вверху — ролик | 0.000 мм³ | <0,5 мм³ | OK | верх стола 241; касание ролика
Кулачок 3: мин. вверху — ролик | 0.000 мм³ | <0,5 мм³ | OK | стол опущен на 3 мм; касание ролика
Кулачок 3: мин. вверху — зазор стола | 3.0 мм | = ходу | OK | верхнее положение при мин. лепестке
Кулачок 5: макс. вверху — ролик | 0.000 мм³ | <0,5 мм³ | OK | верх стола 241; касание ролика
Кулачок 5: мин. вверху — ролик | 0.000 мм³ | <0,5 мм³ | OK | стол опущен на 5 мм; касание ролика
Кулачок 5: мин. вверху — зазор стола | 5.0 мм | = ходу | OK | верхнее положение при мин. лепестке
Кулачок 10: макс. вверху — ролик | 0.000 мм³ | <0,5 мм³ | OK | верх стола 241; касание ролика
Кулачок 10: мин. вверху — ролик | 0.000 мм³ | <0,5 мм³ | OK | стол опущен на 10 мм; касание ролика
Кулачок 10: мин. вверху — зазор стола | 10.0 мм | = ходу | OK | верхнее положение при мин. лепестке
Стол +2,9 — буферы | 0.000 мм³ | 0 | OK | до буфера 0,1 мм: штатный ход не задевает
Стол +3,1 — буферы | 112.0 мм³ | >0 (мягкий упор) | OK | при отрыве буфер сминается на 0,1 мм
Стол +4,9 — кожух | 0.000 мм³ | 0 | OK | до бортика 0,1 мм
Стол +5,1 — кожух | 150.0 мм³ | >0 (барьер) | OK | бортик не пропускает стол выше +5 мм
Блок, опущен на 44 мм — рама | 0.000 мм³ | <0,5 мм³ | OK | камера: верх кулачка 148 < 150 (низ средней поперечины)
Блок, опущен на 44 мм — уголки | 0.000 мм³ | <0,5 мм³ | OK | камера: верх кулачка 148 < 150 (низ средней поперечины)
Блок, опущен на 44 мм — стол | 0.000 мм³ | <0,5 мм³ | OK | камера: верх кулачка 148 < 150 (низ средней поперечины)
Блок, опущен на 44 мм — кожух | 0.000 мм³ | <0,5 мм³ | OK | камера: верх кулачка 148 < 150 (низ средней поперечины)
Блок, опущен и выдвинут вперёд — рама | 0.000 мм³ | <0,5 мм³ | OK | извлечение вперёд после снятия балок 21
Масса без дрели | 6.41 кг | — | OK | по объёмам модели и плотностям
Область печати рамы | ≥370×210×310 | — | OK | рама одним куском; поддержки
Дрель: направление и функции | против часовой; пуск/обороты/курок | по fix1 | OK | в 3D-модель не входит
