inutcin/boomboom/stages/fix1/pic/iso_sheet.png

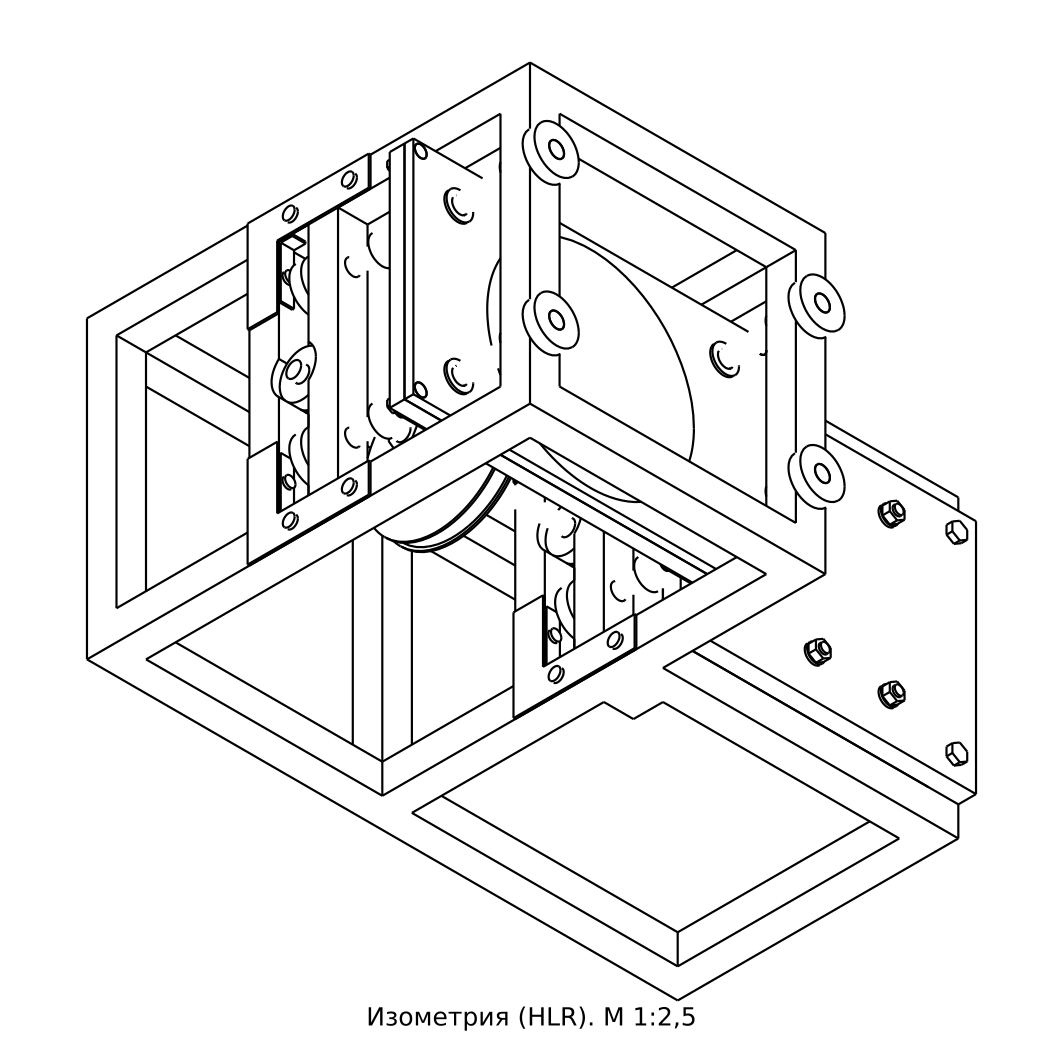
stages/fix1/pic/iso_sheet.png
