inutcin/boomboom/stages/fix1/pic/render_clamp.png

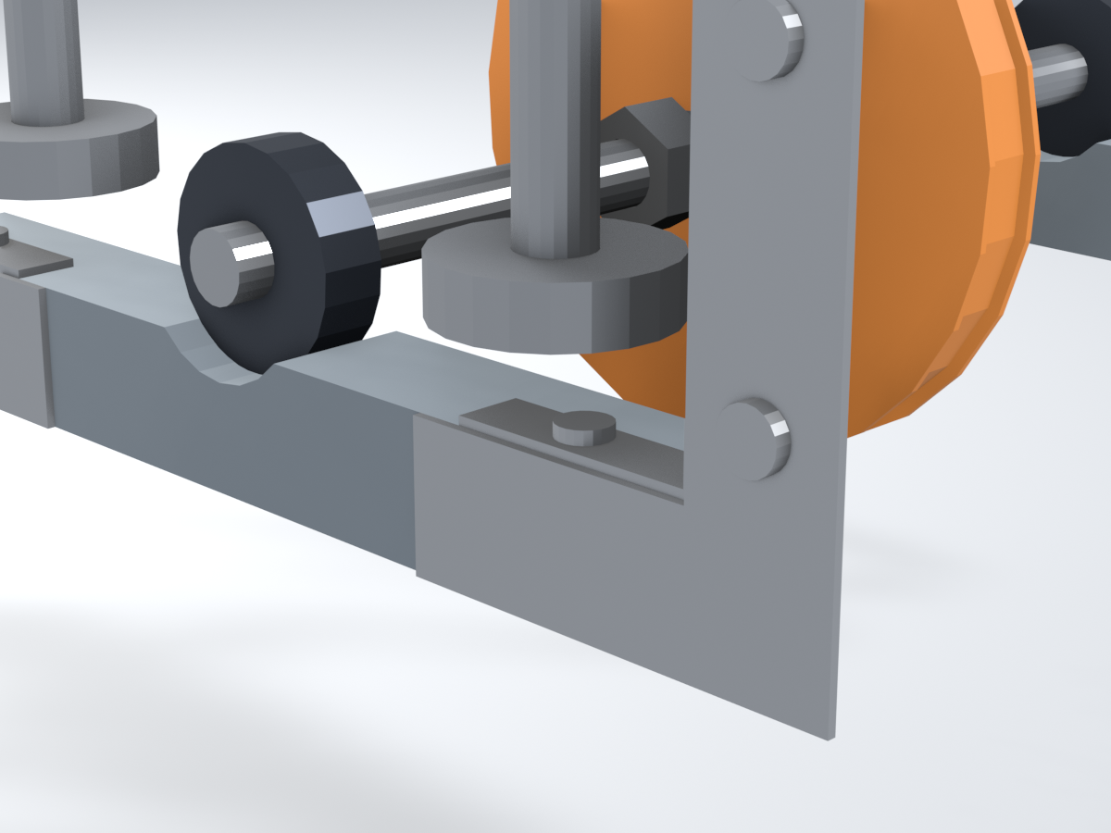
stages/fix1/pic/render_clamp.png
