inutcin/boomboom/stages/fix1/pic/render_front.png

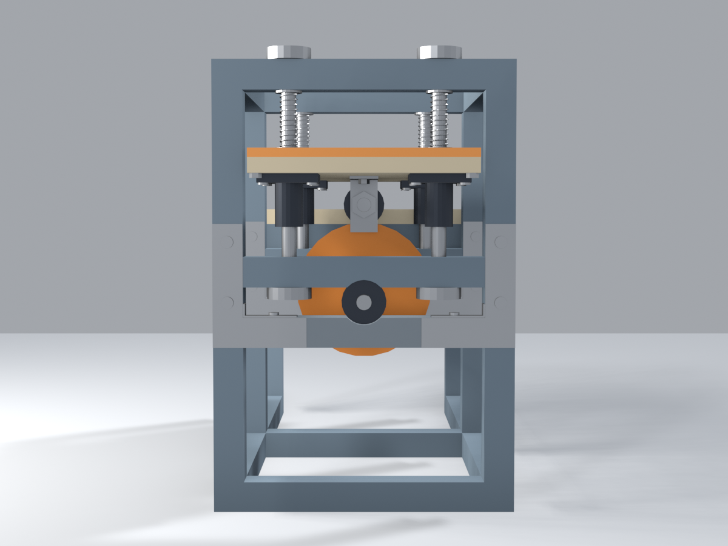
stages/fix1/pic/render_front.png
