inutcin/boomboom/stages/fix1/pic/render_iso.png

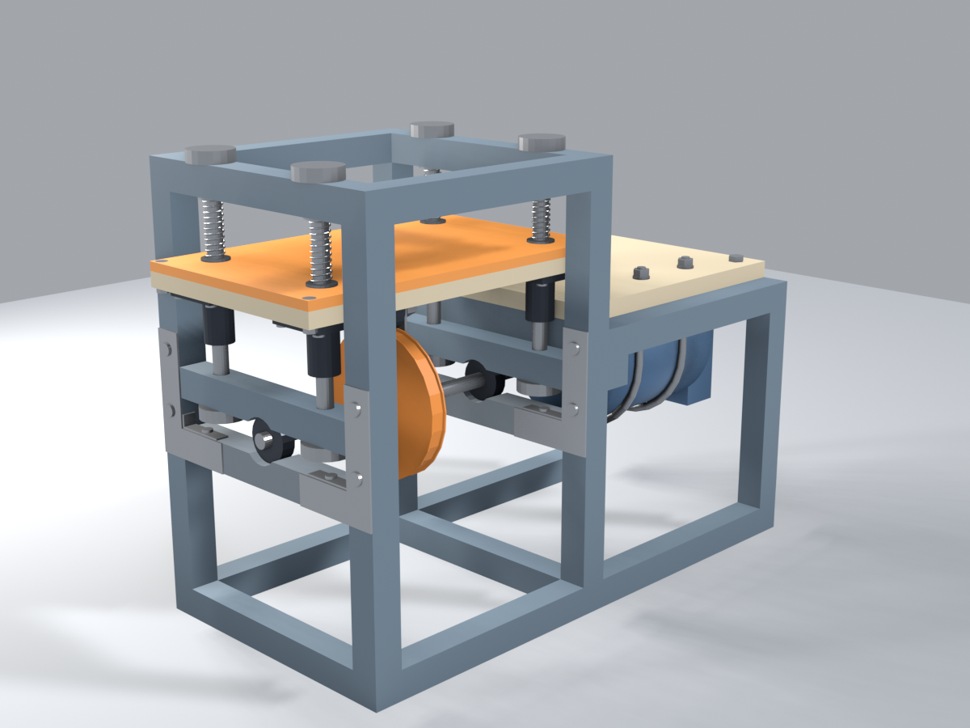
stages/fix1/pic/render_iso.png
