inutcin/boomboom/stages/fix1/pic/render_iso_rear.png

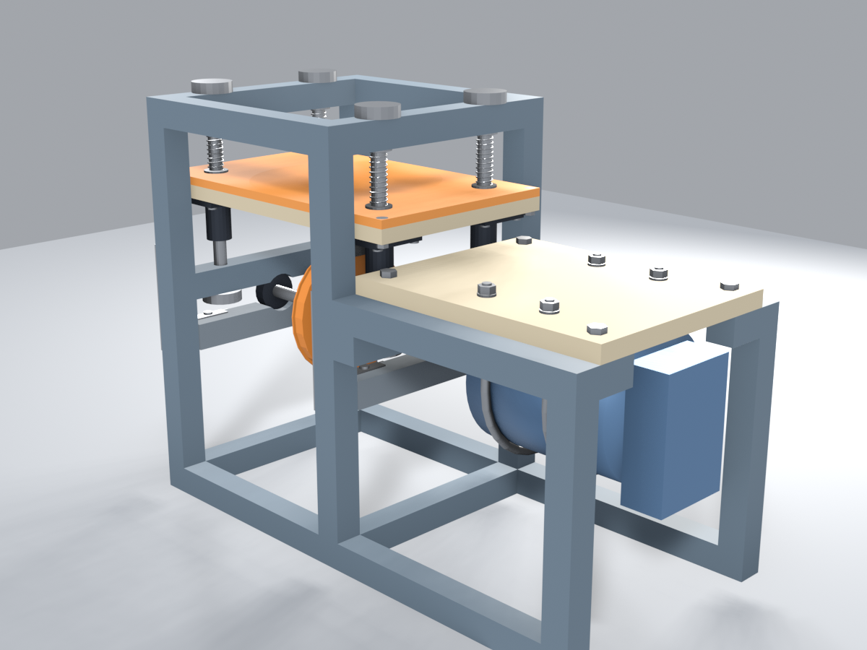
stages/fix1/pic/render_iso_rear.png
