inutcin/boomboom/stages/fix1/pic/render_left.png

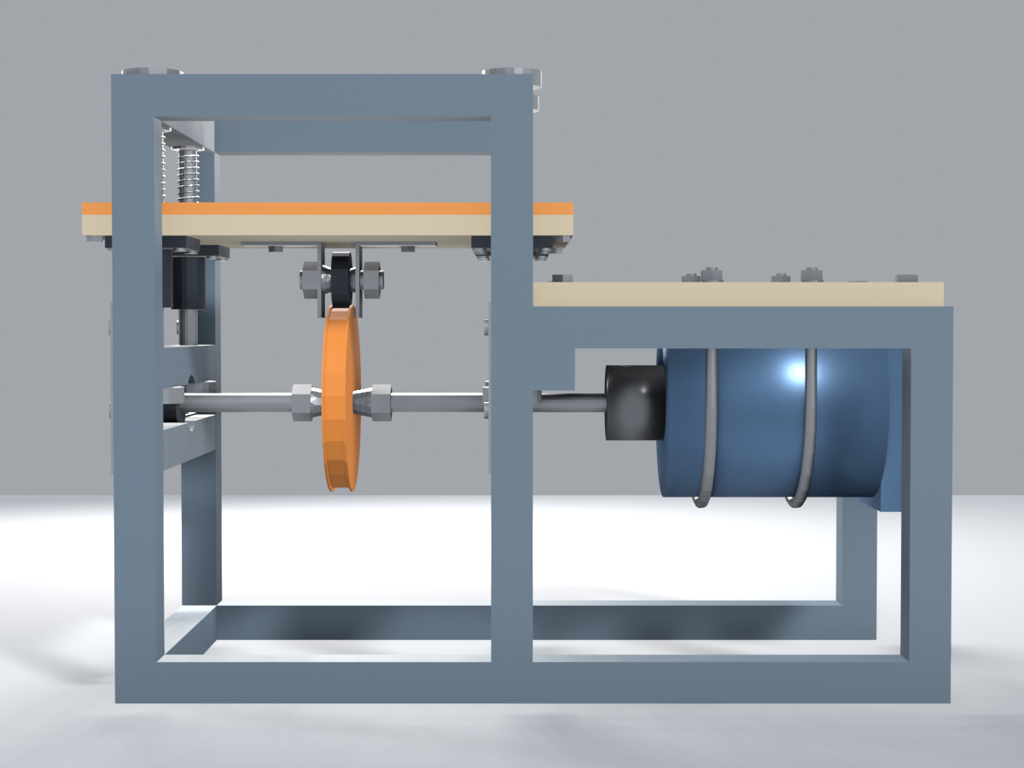
stages/fix1/pic/render_left.png
