inutcin/boomboom/stages/fix1/pic/render_mechanism.png

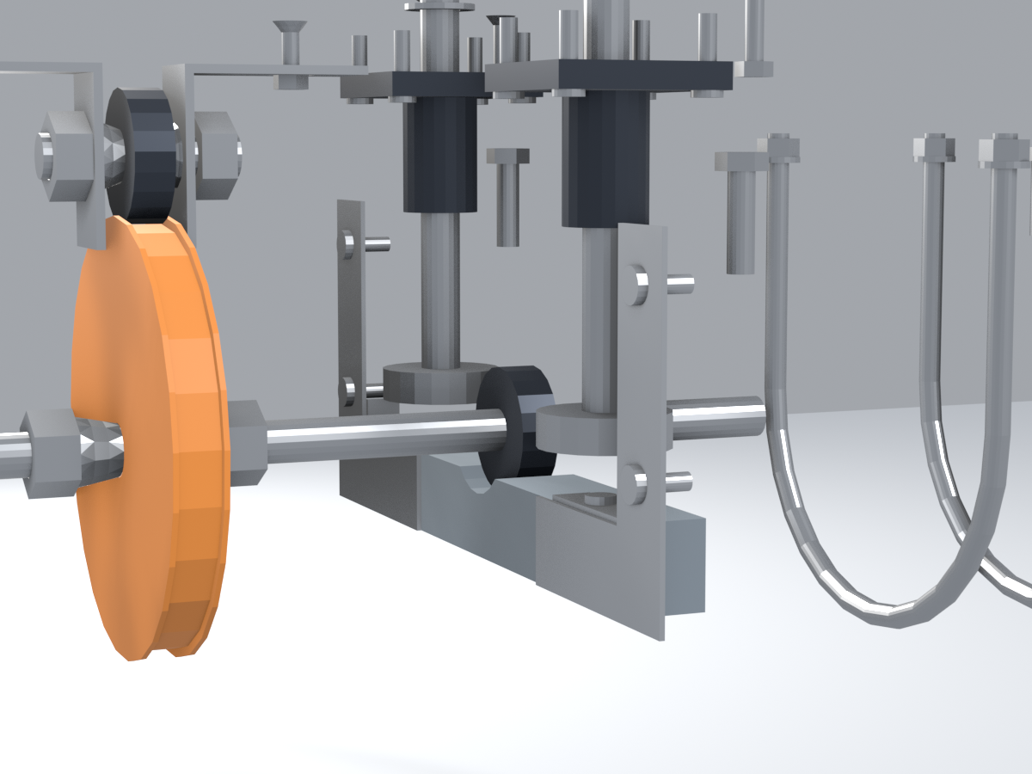
stages/fix1/pic/render_mechanism.png
