inutcin/boomboom/stages/fix1/pic/render_retainer_down.png

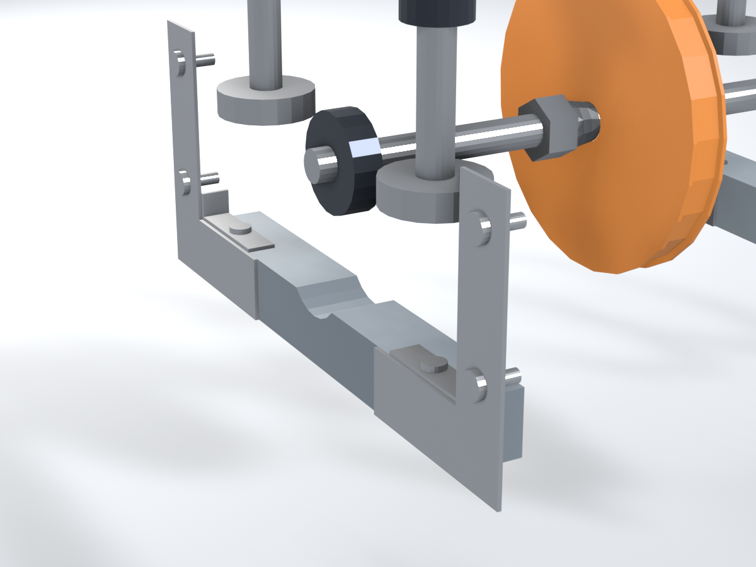
stages/fix1/pic/render_retainer_down.png
