inutcin/boomboom/stages/fix1/pic/render_top.png

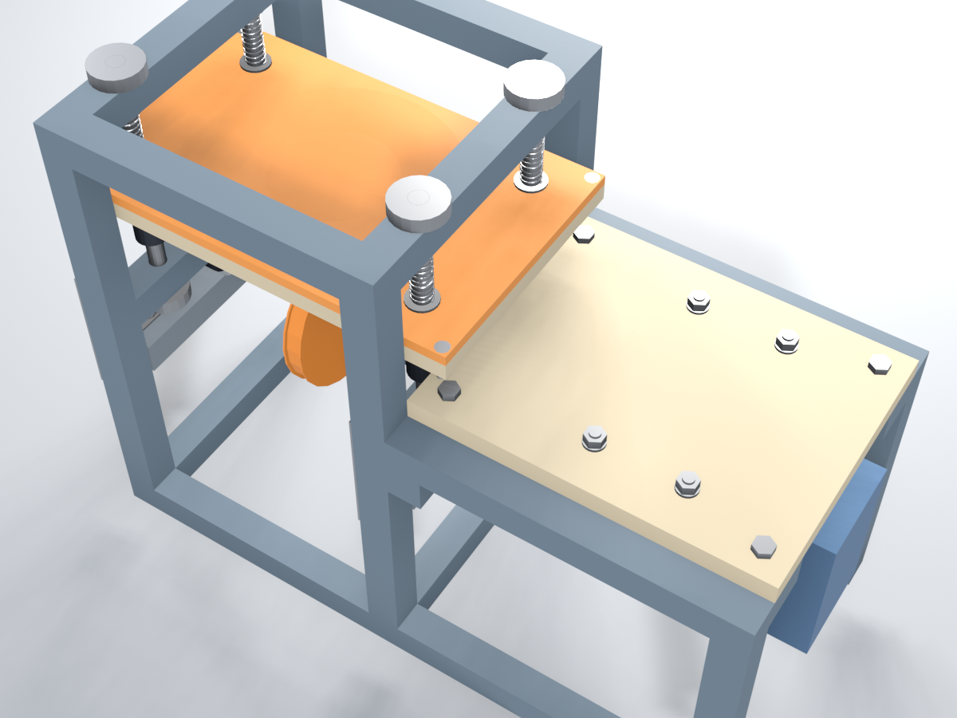
stages/fix1/pic/render_top.png
