inutcin/boomboom/stages/fix1/pic/views_sheet.png

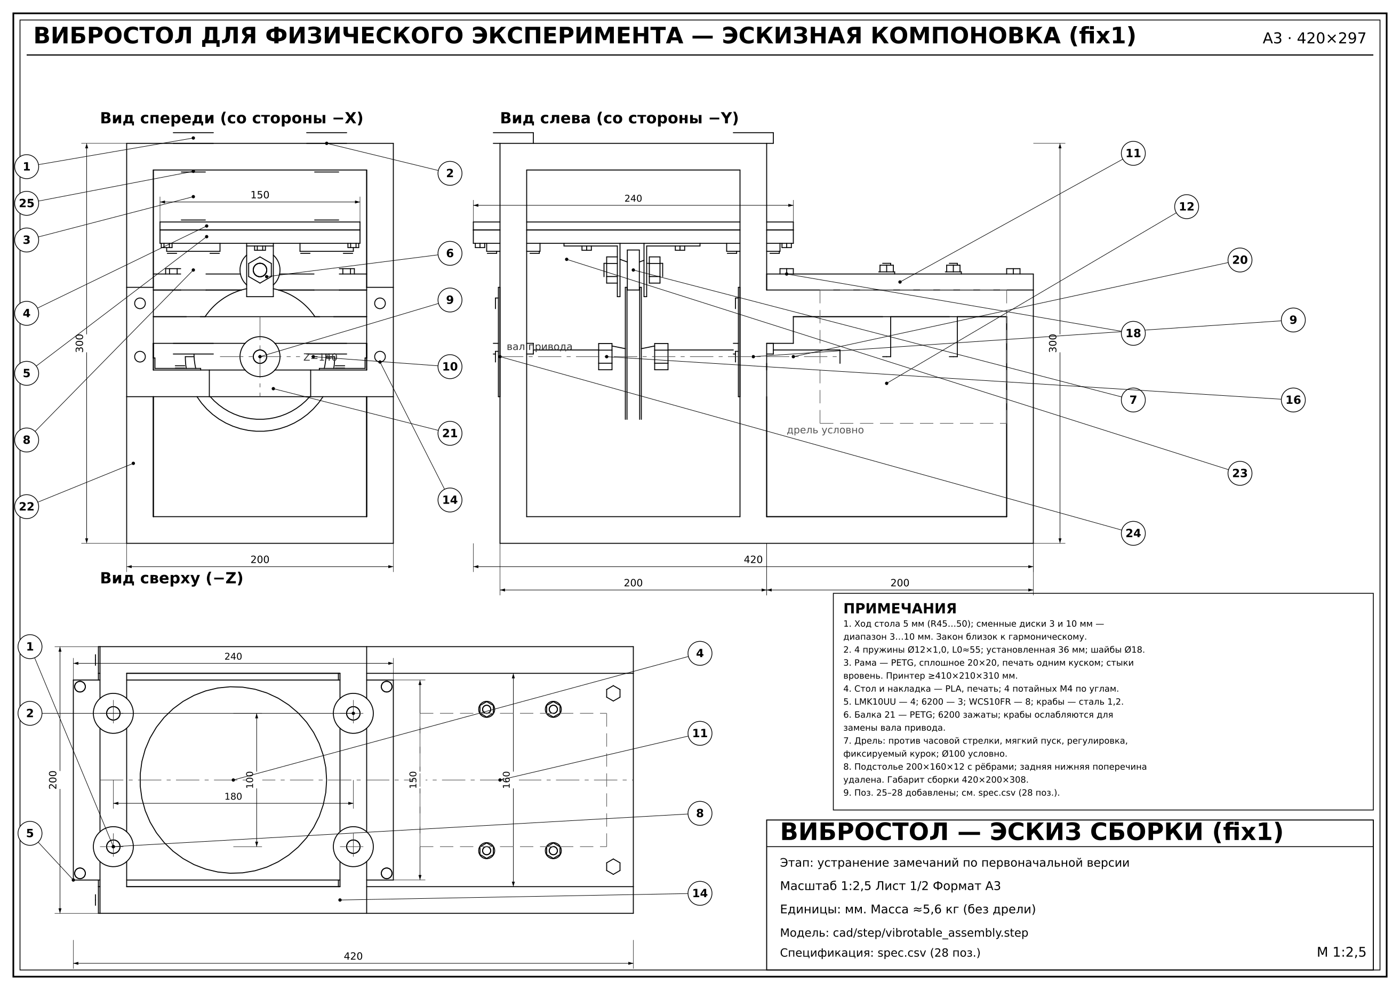
stages/fix1/pic/views_sheet.png
