inutcin/boomboom/stages/fix3/pic/iso_sheet.png

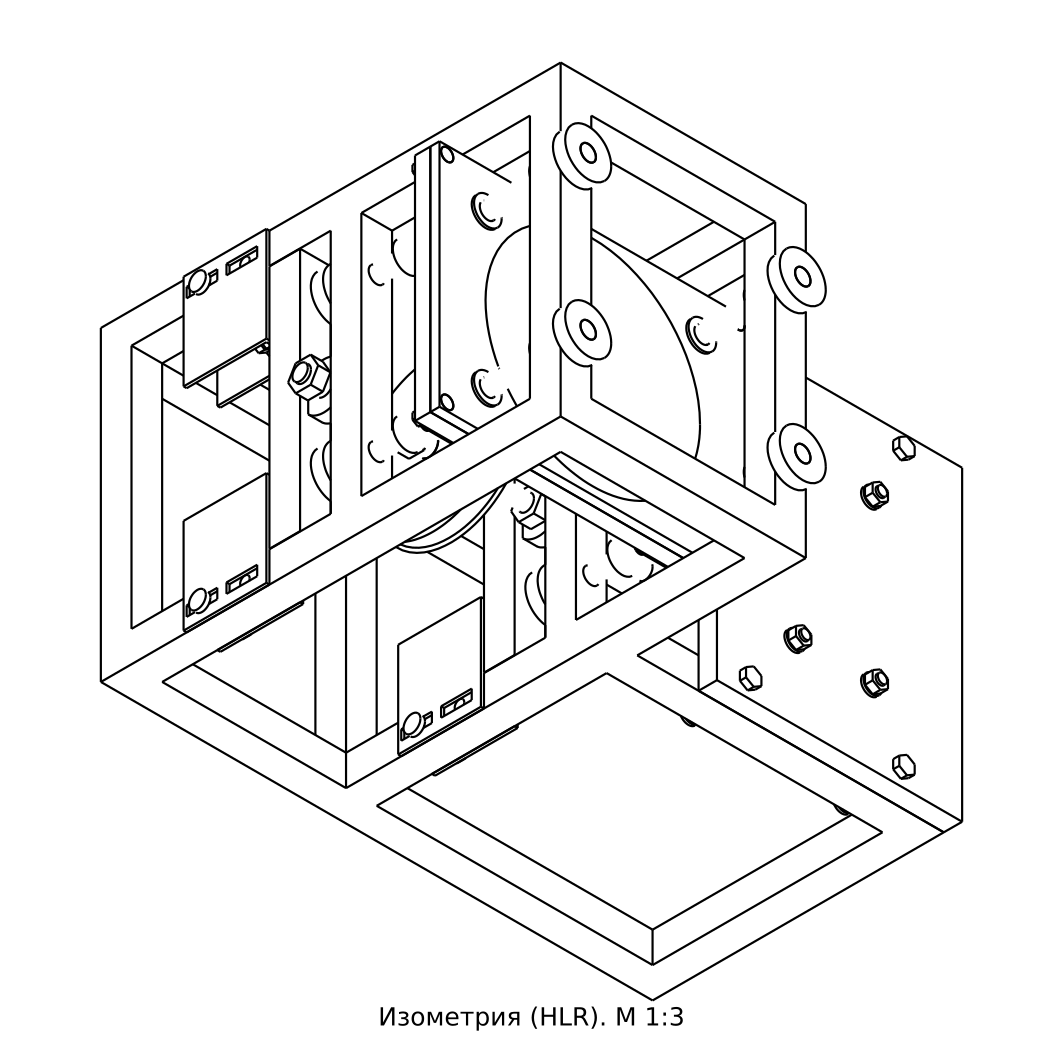
stages/fix3/pic/iso_sheet.png
