inutcin/boomboom/stages/fix3/pic/render_bearing_pocket.png

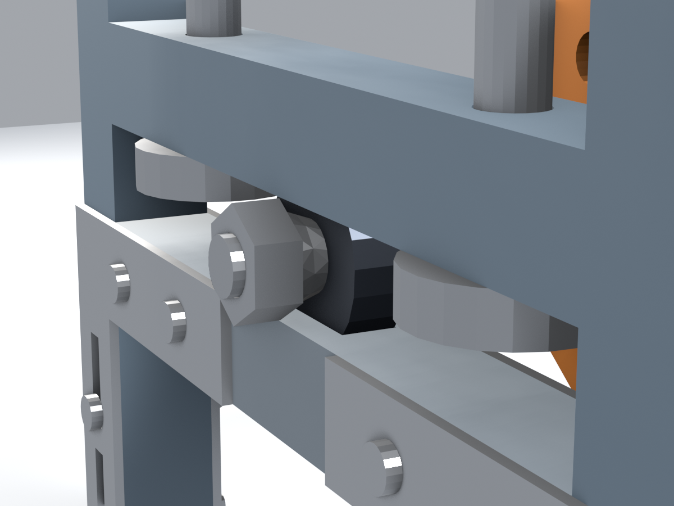
stages/fix3/pic/render_bearing_pocket.png
