inutcin/boomboom/stages/fix3/pic/render_clamp.png

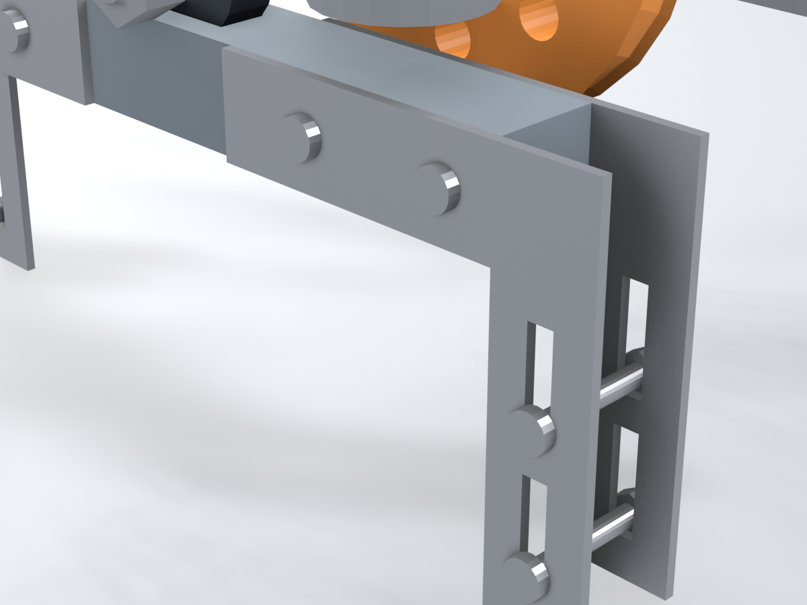
stages/fix3/pic/render_clamp.png
