inutcin/boomboom/stages/fix3/pic/render_crab.png

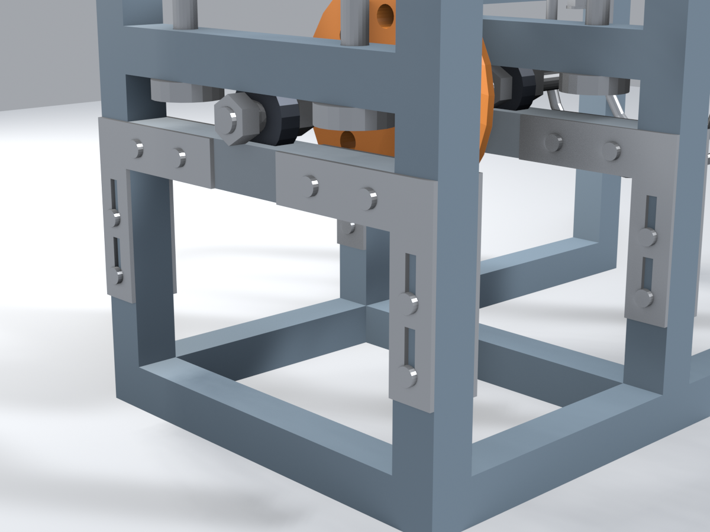
stages/fix3/pic/render_crab.png
