inutcin/boomboom/stages/fix3/pic/render_front.png

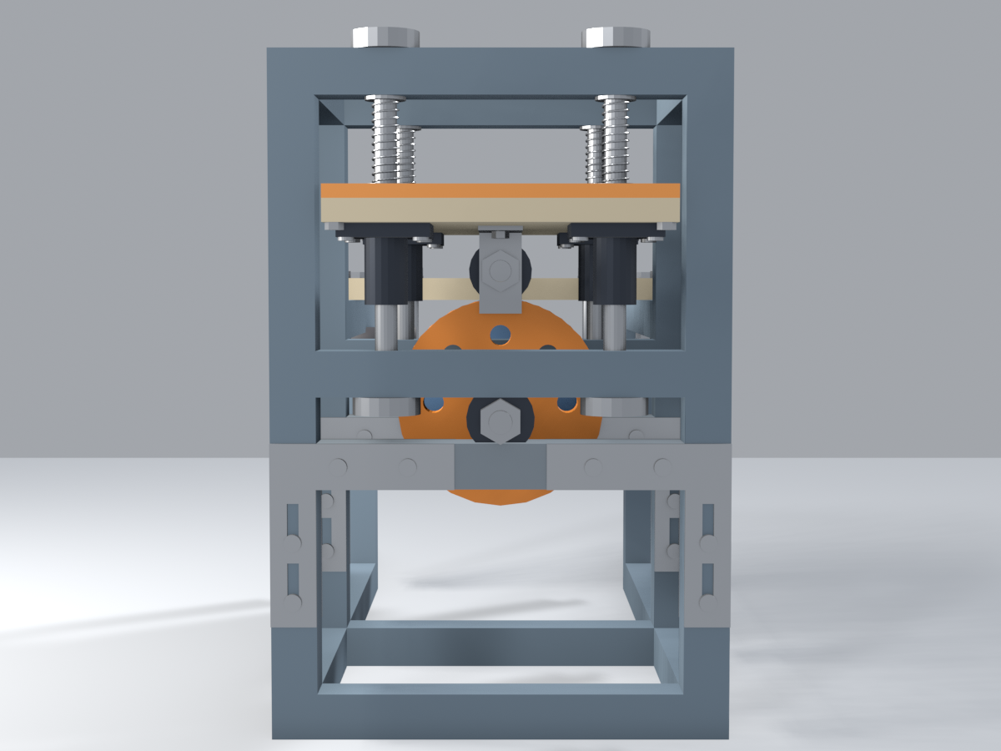
stages/fix3/pic/render_front.png
