inutcin/boomboom/stages/fix3/pic/render_iso.png

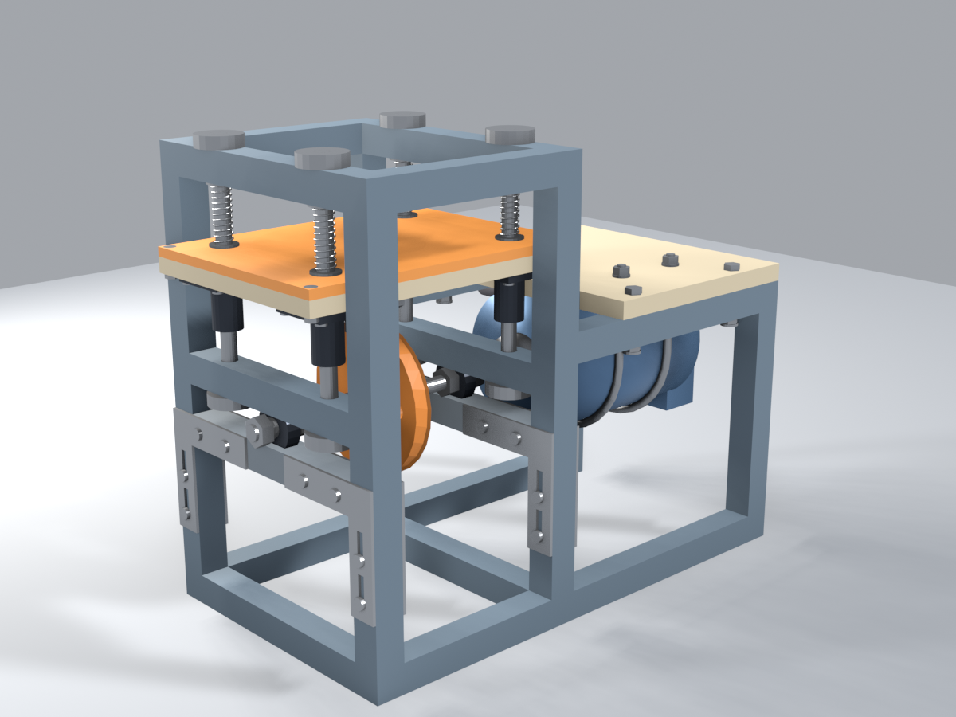
stages/fix3/pic/render_iso.png
