inutcin/boomboom/stages/fix3/pic/render_iso_rear.png

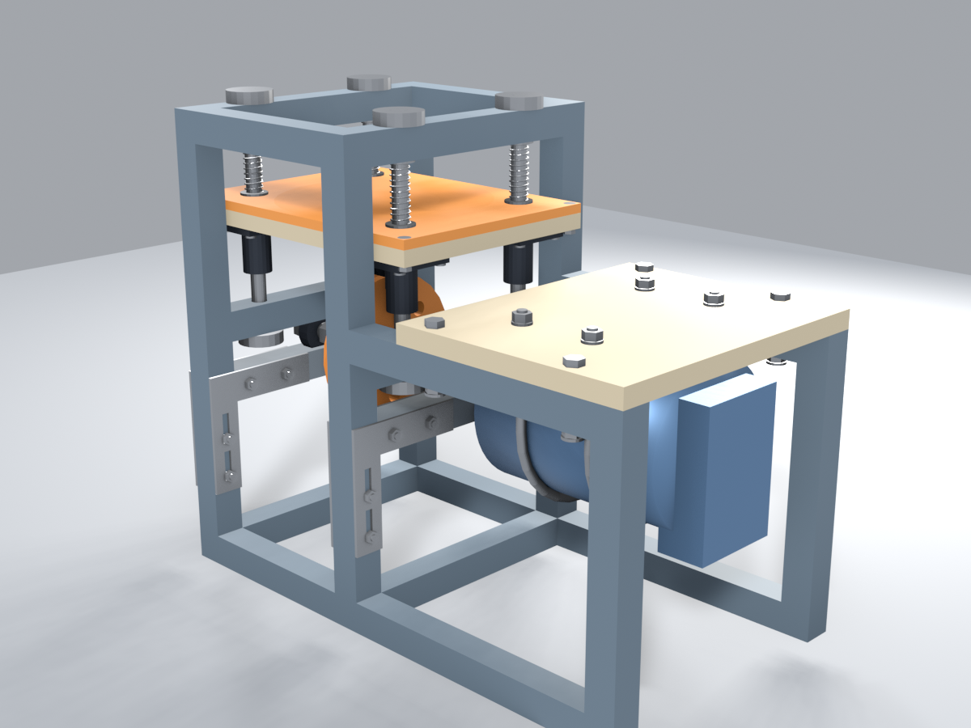
stages/fix3/pic/render_iso_rear.png
