inutcin/boomboom/stages/fix3/pic/render_left.png

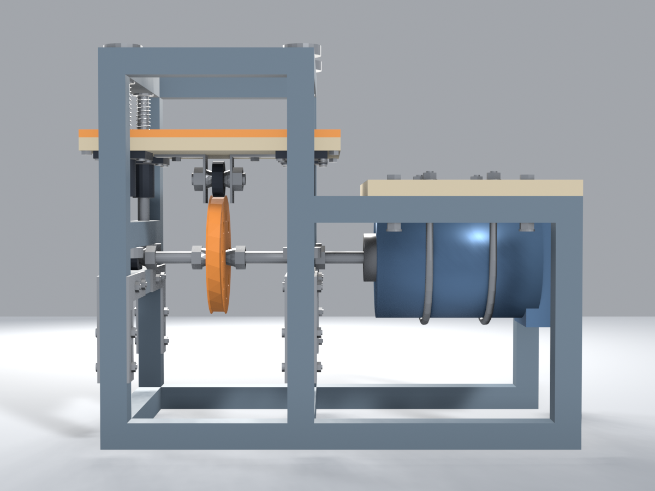
stages/fix3/pic/render_left.png
