inutcin/boomboom/stages/fix3/pic/render_podstol.png

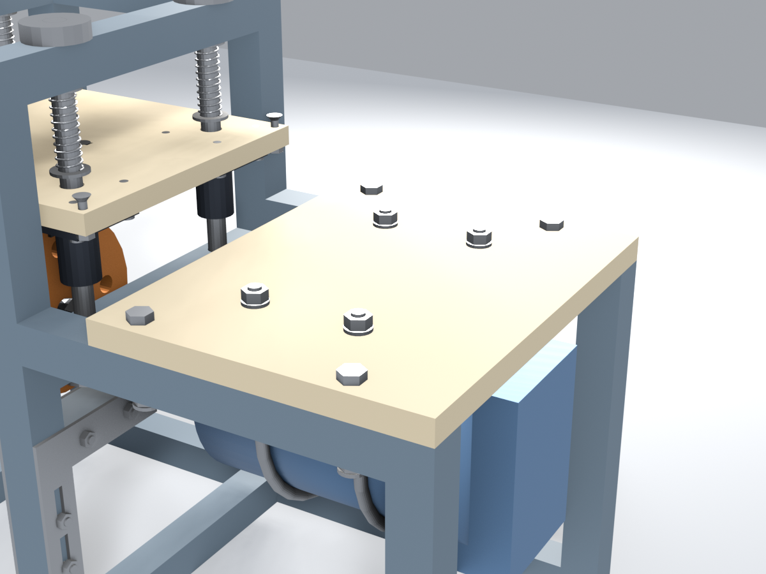
stages/fix3/pic/render_podstol.png
