inutcin/boomboom/stages/fix3/pic/render_retainer_down.png

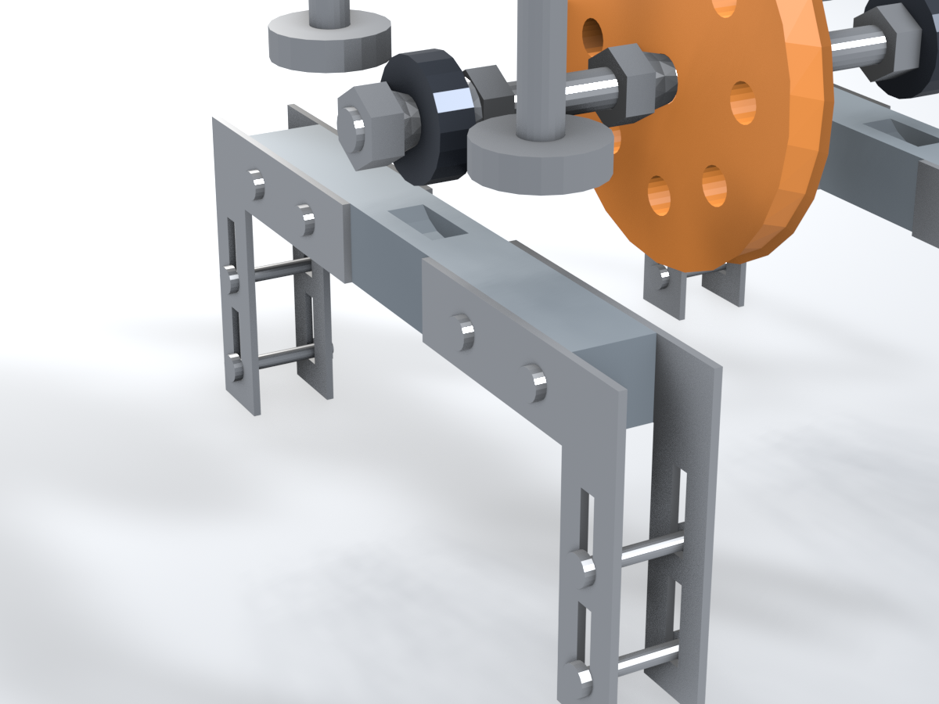
stages/fix3/pic/render_retainer_down.png
