inutcin/boomboom/stages/fix3/pic/render_shaft_nuts.png

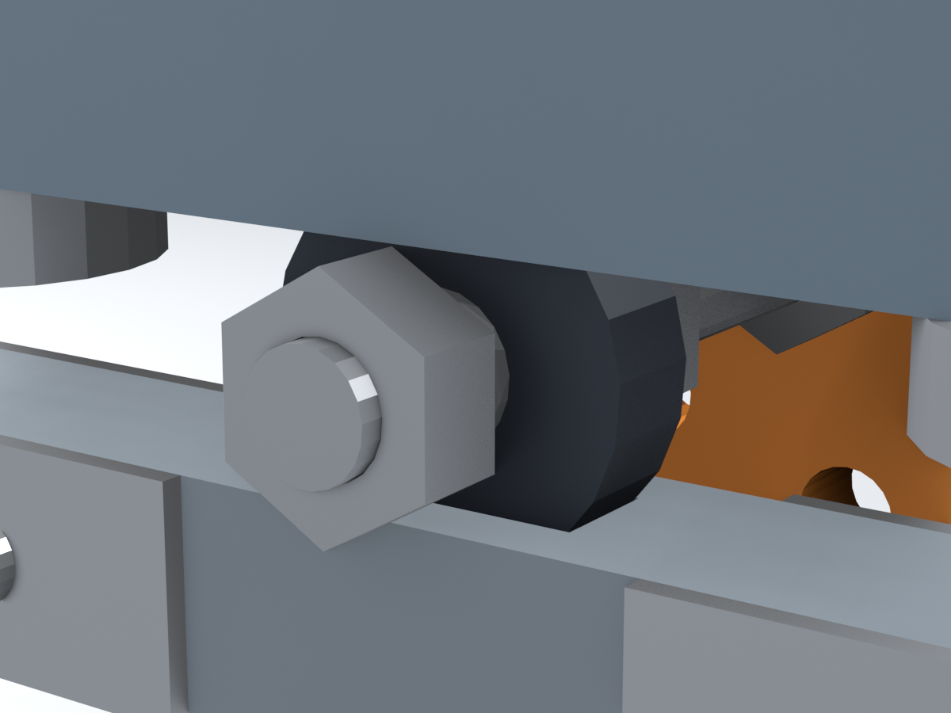
stages/fix3/pic/render_shaft_nuts.png
