inutcin/boomboom/stages/fix3/pic/render_top.png

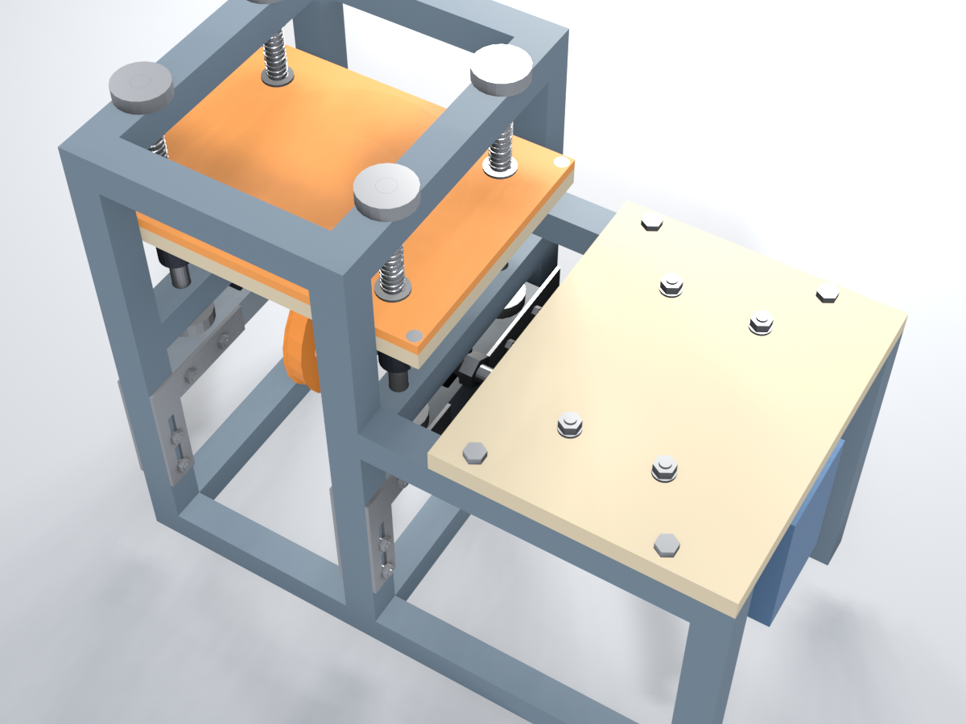
stages/fix3/pic/render_top.png
