inutcin/boomboom/stages/fix3/pic/views_sheet.png

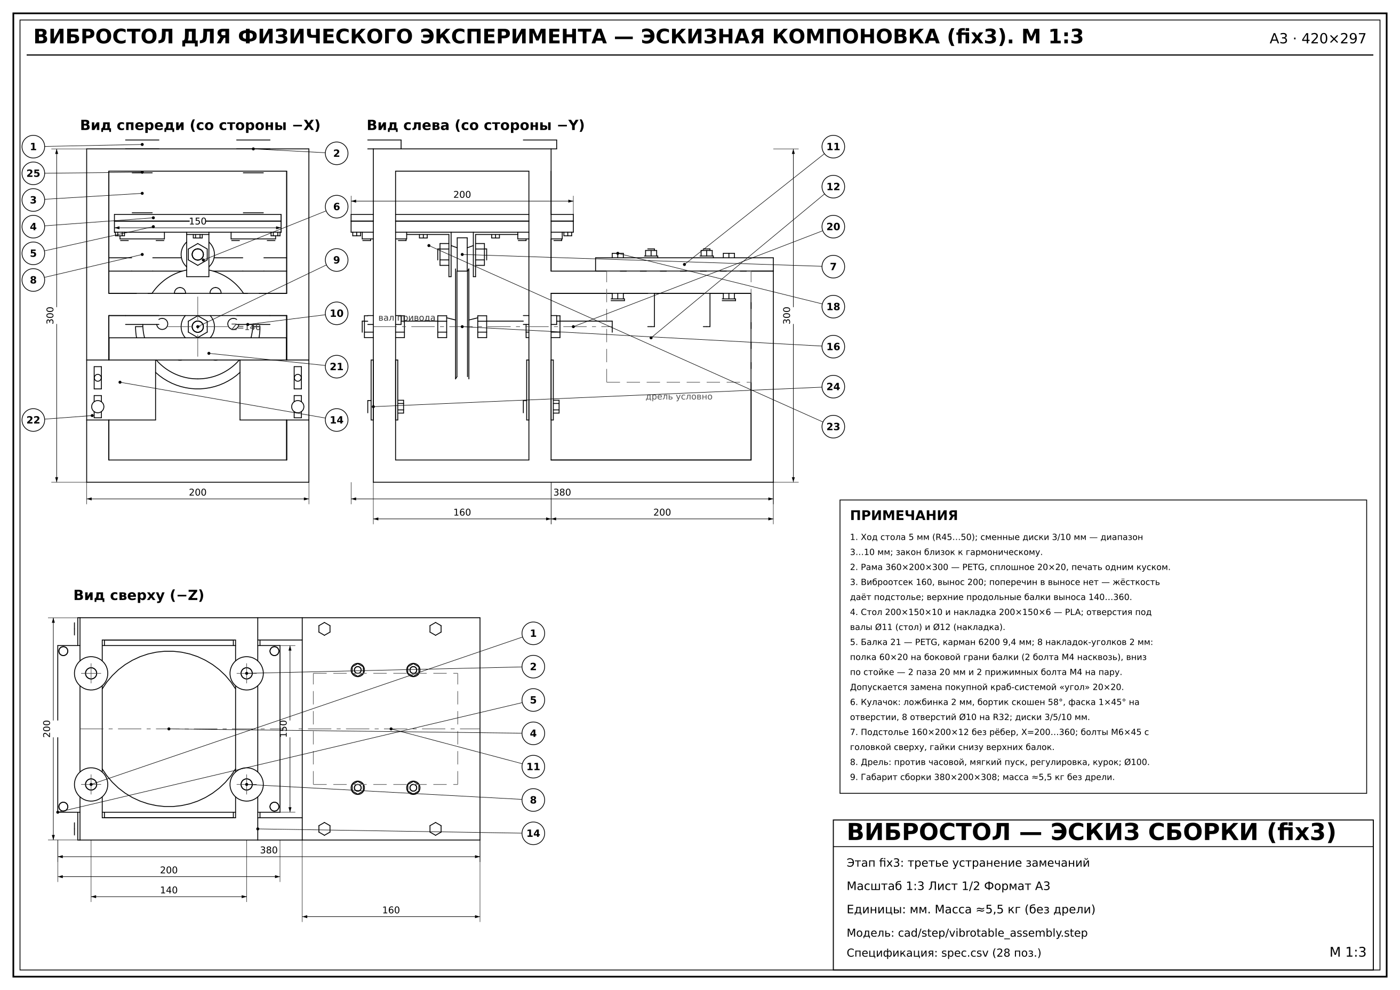
stages/fix3/pic/views_sheet.png
