inutcin/boomboom/stages/fix4/pic/cam_symmetric.png

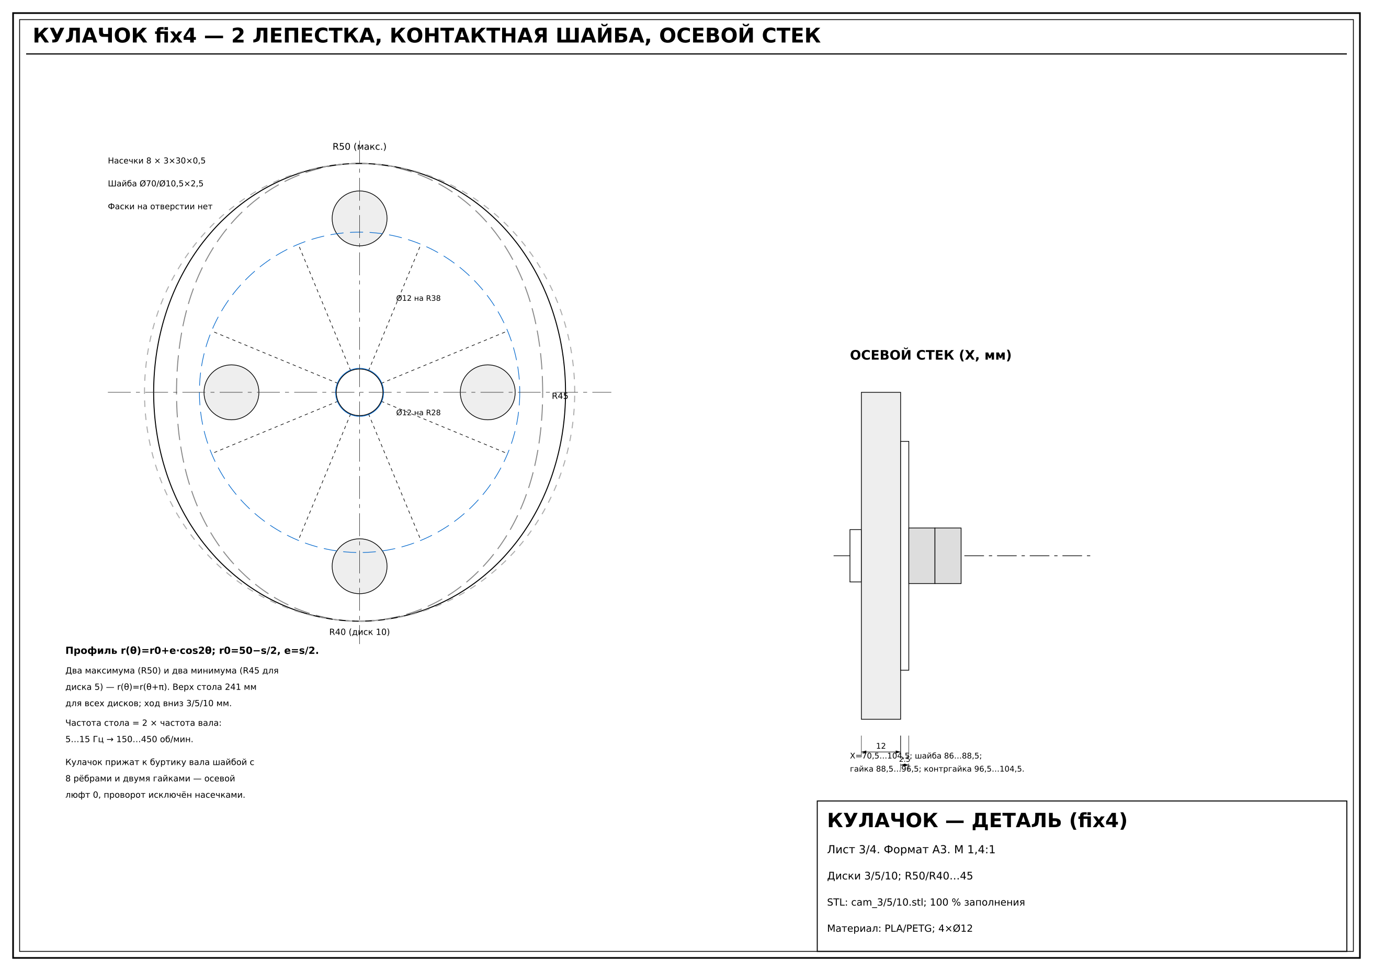
stages/fix4/pic/cam_symmetric.png
