inutcin/boomboom/stages/fix10l/pic/beams.png

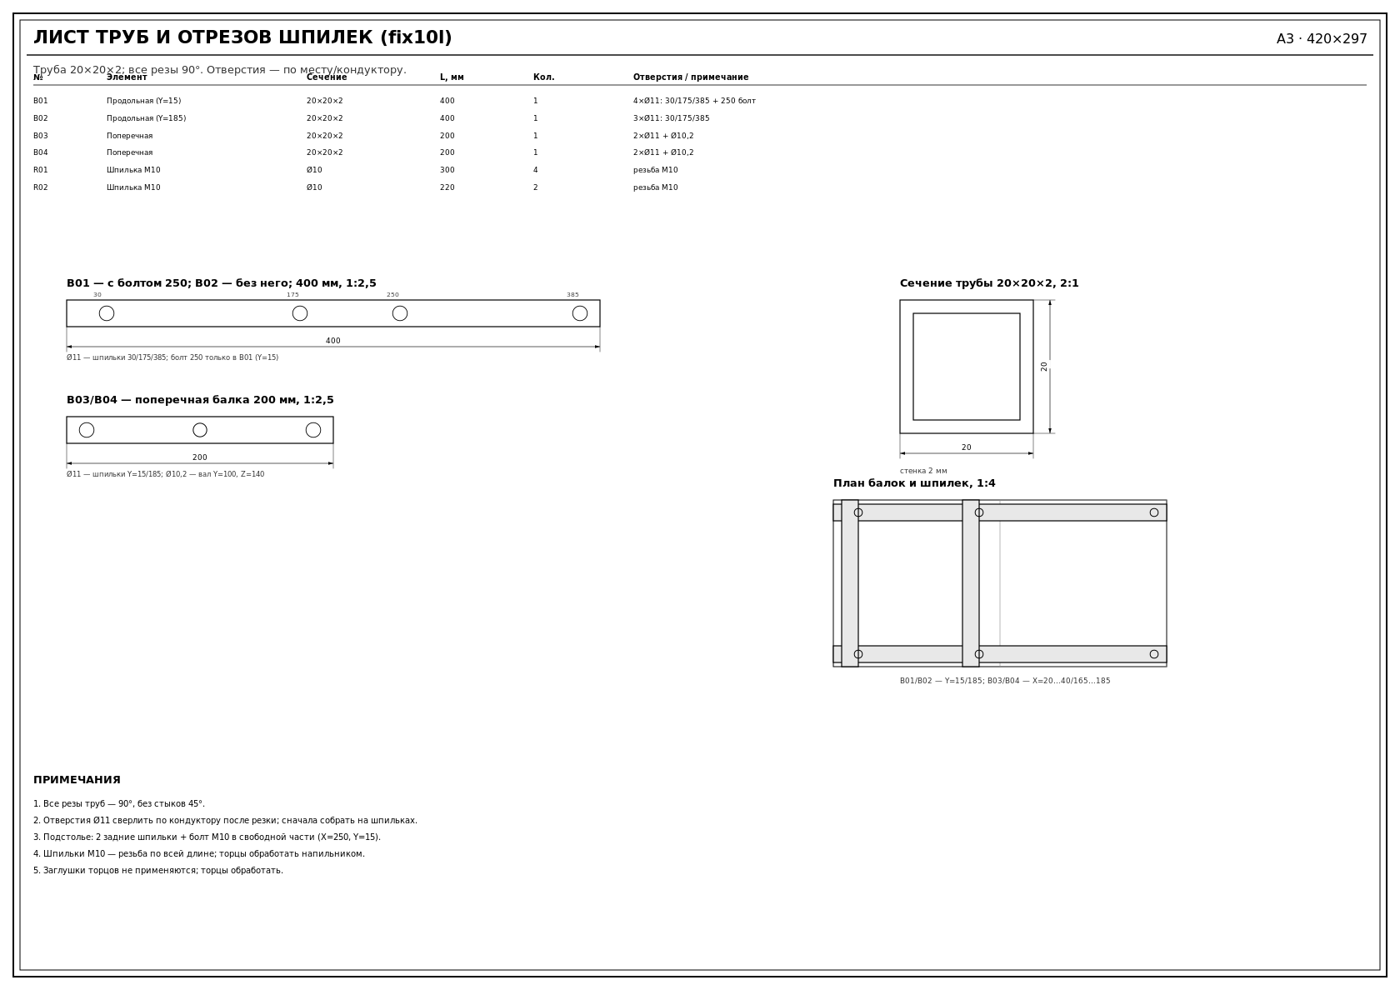
stages/fix10l/pic/beams.png
