inutcin/boomboom/stages/fix10l/pic/details.png

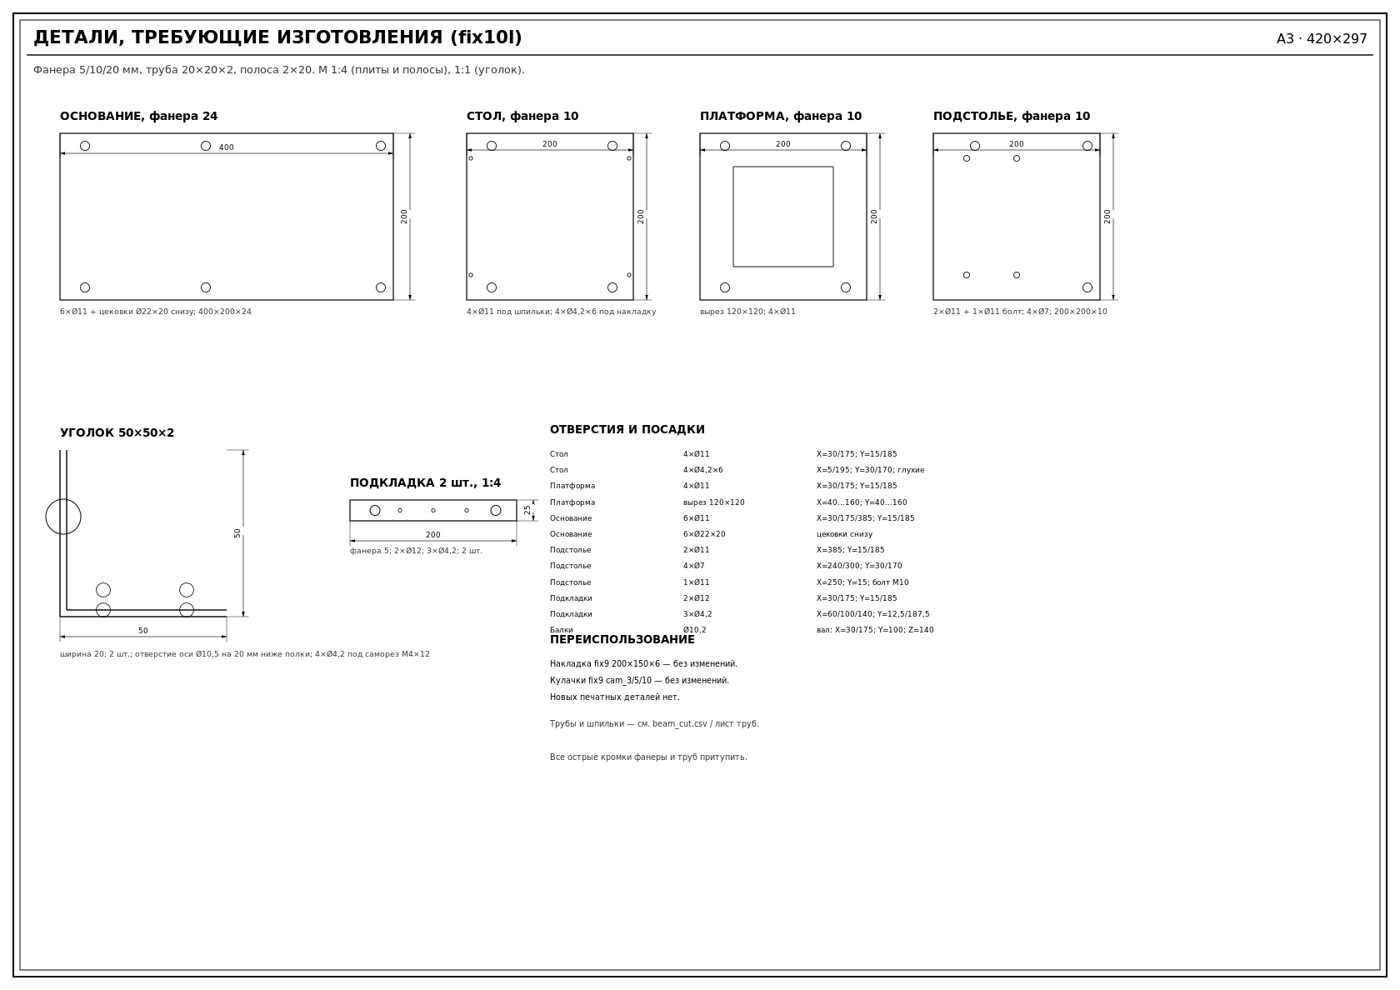
stages/fix10l/pic/details.png
