inutcin/boomboom/stages/fix10l/pic/iso.png

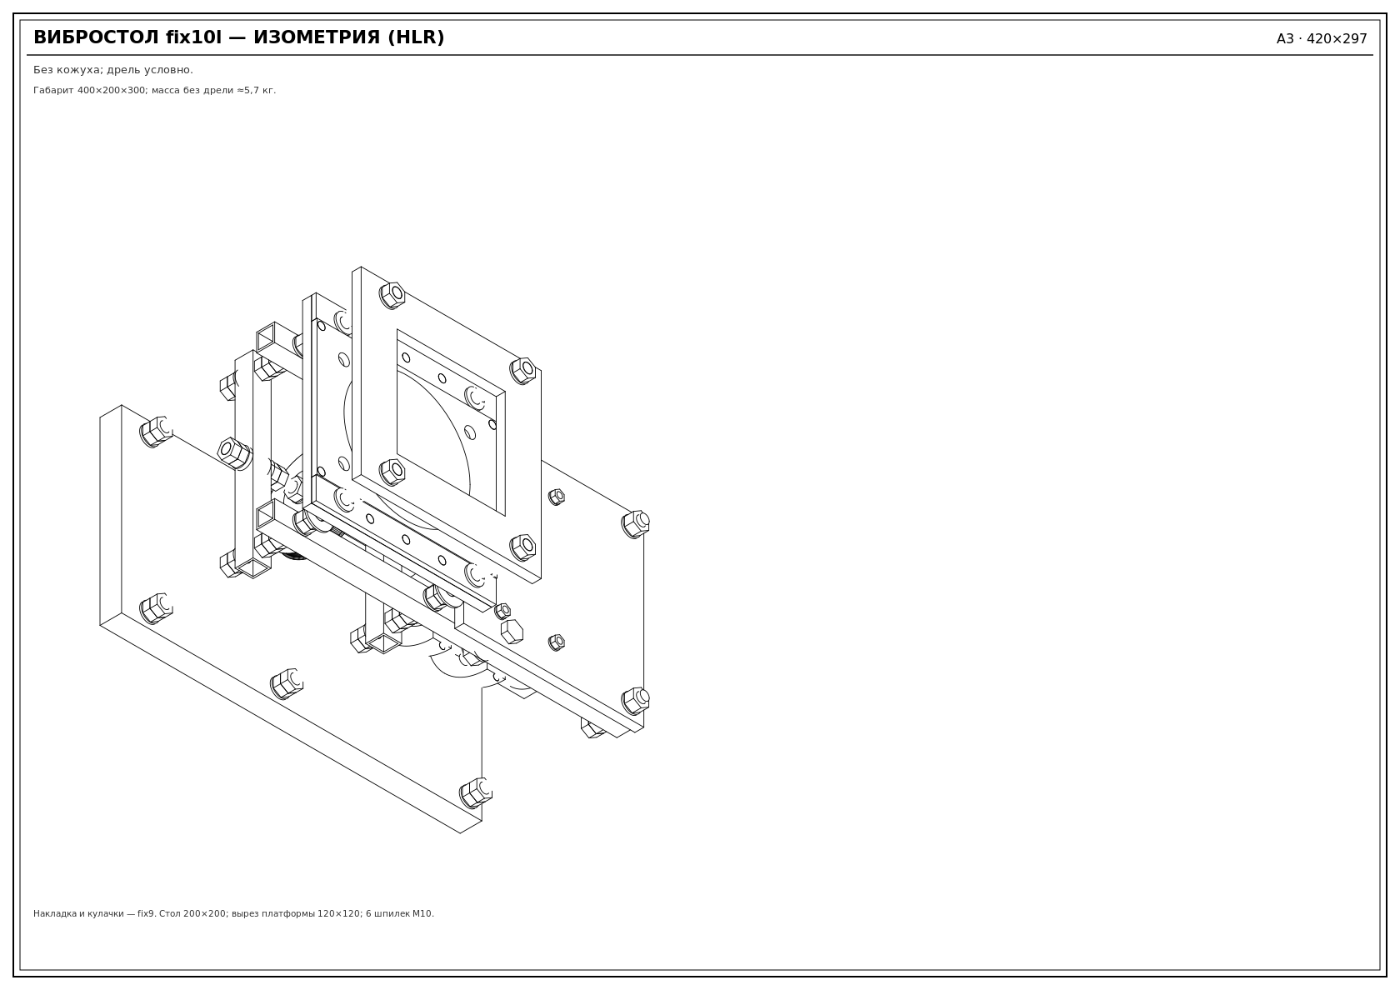
stages/fix10l/pic/iso.png
