inutcin/boomboom/stages/fix10l/pic/mechanism.png

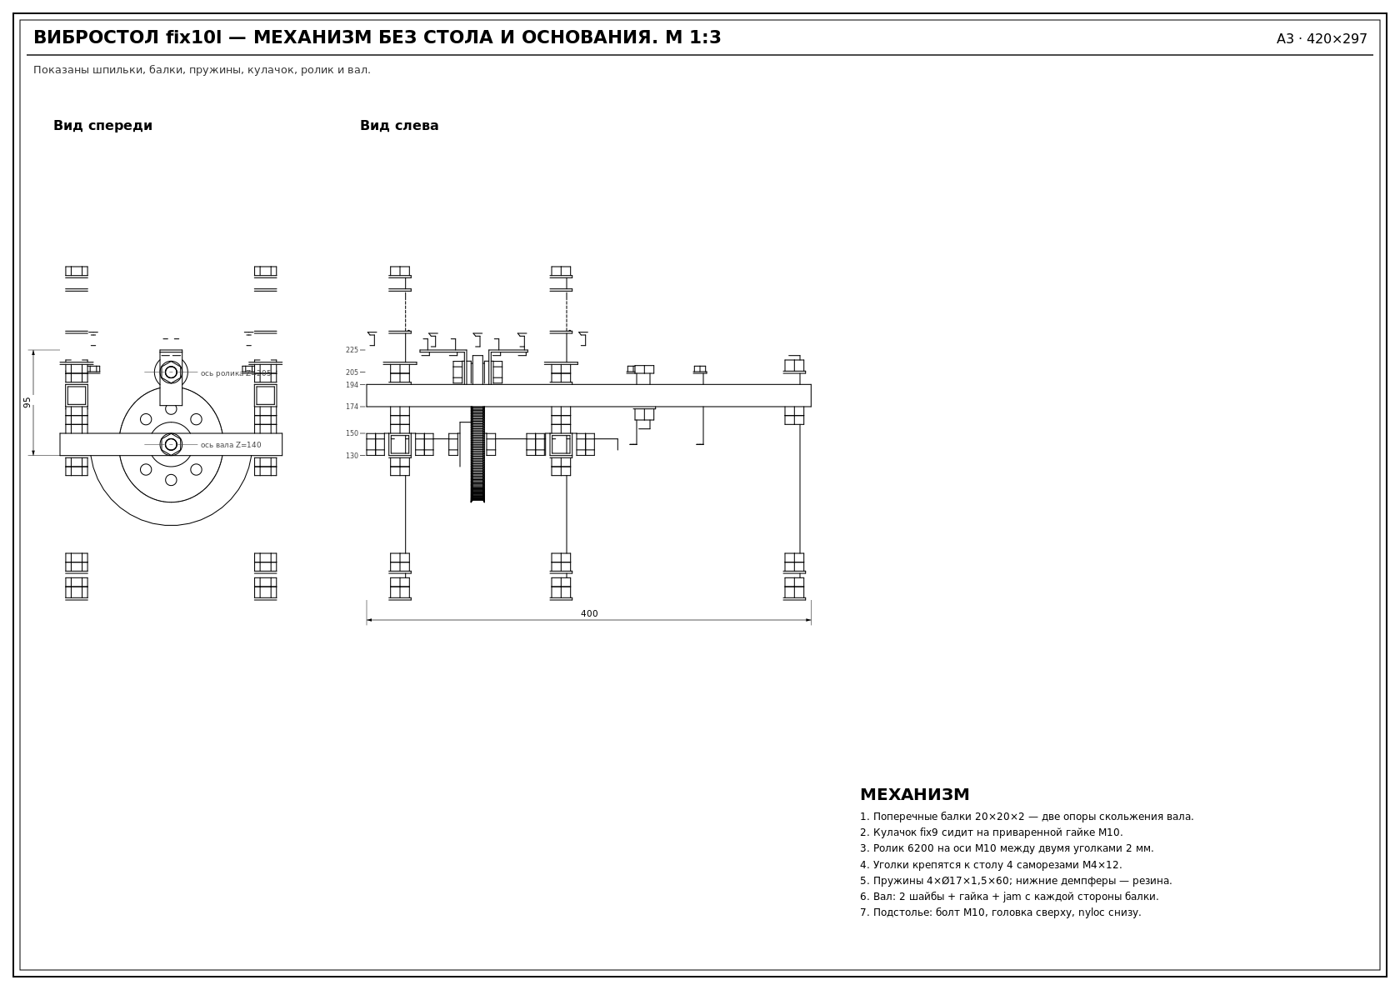
stages/fix10l/pic/mechanism.png
