inutcin/boomboom/stages/fix10l/pic/render_cam.png

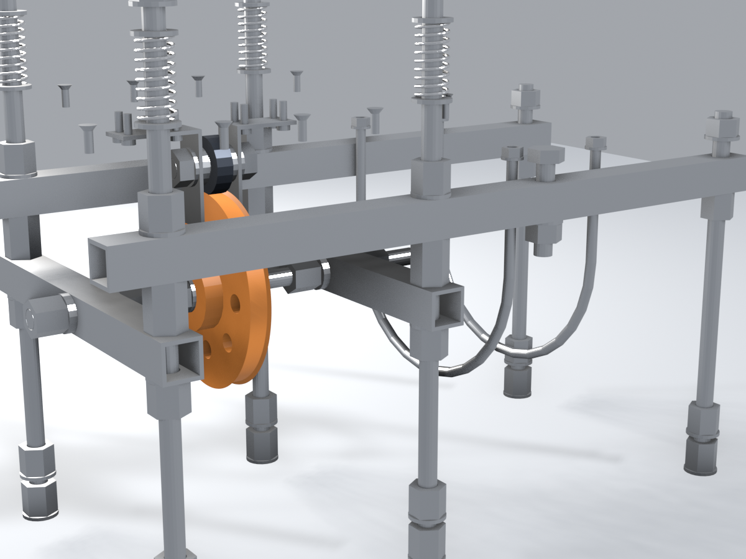
stages/fix10l/pic/render_cam.png
