inutcin/boomboom/stages/fix10l/pic/render_front.png

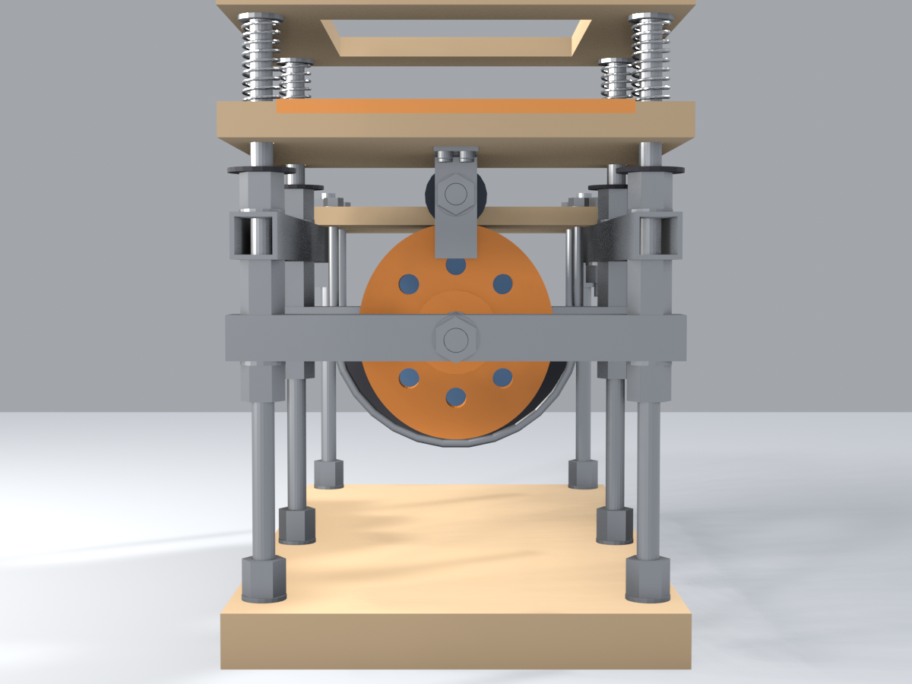
stages/fix10l/pic/render_front.png
