inutcin/boomboom/stages/fix10l/pic/render_iso.png

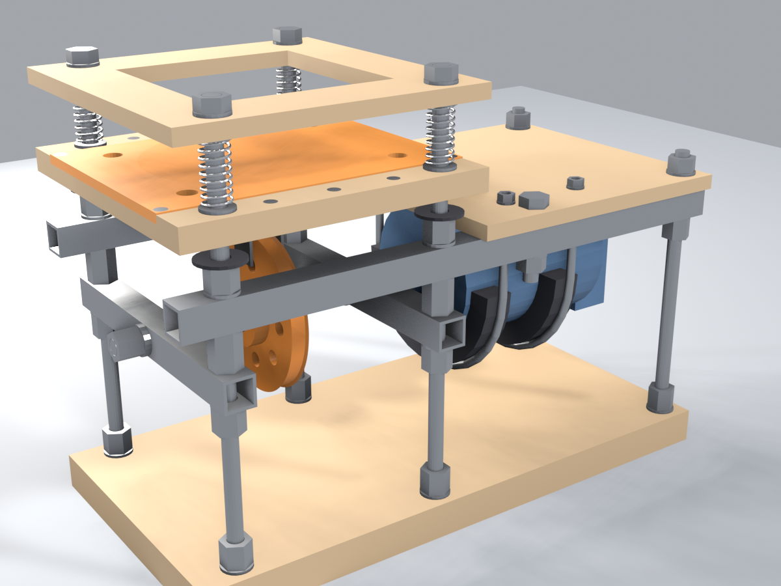
stages/fix10l/pic/render_iso.png
