inutcin/boomboom/stages/fix10l/pic/render_iso_rear.png

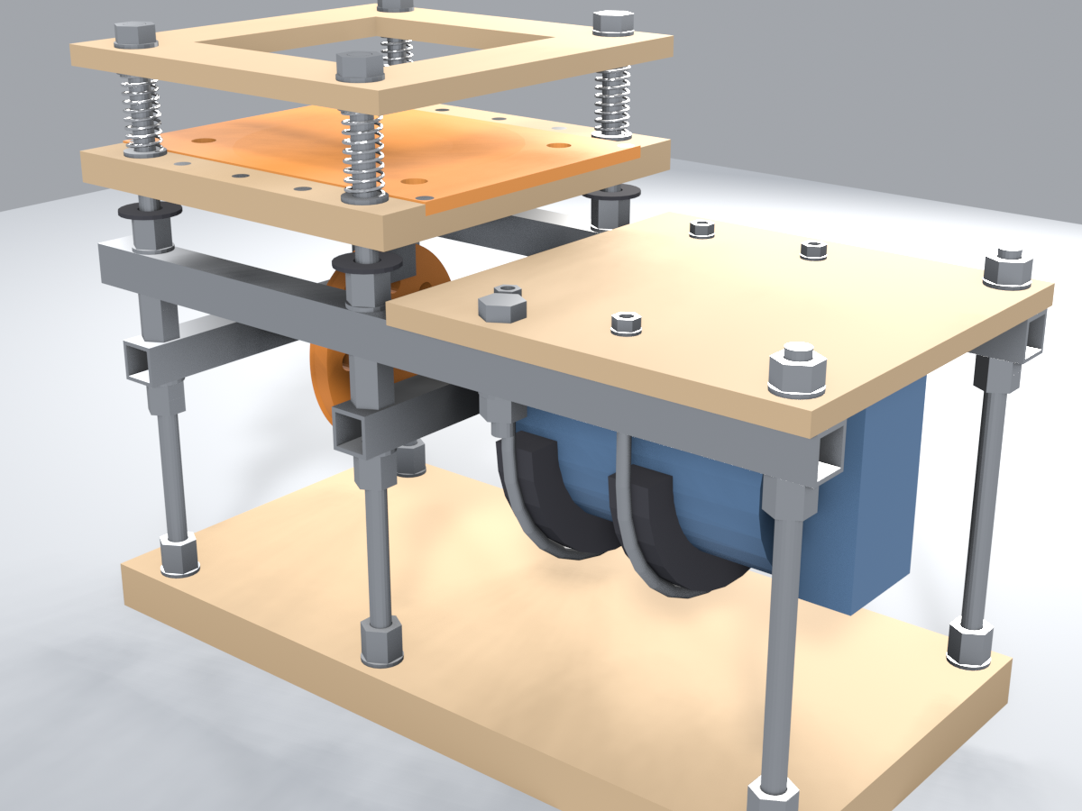
stages/fix10l/pic/render_iso_rear.png
