inutcin/boomboom/stages/fix10l/pic/render_left.png

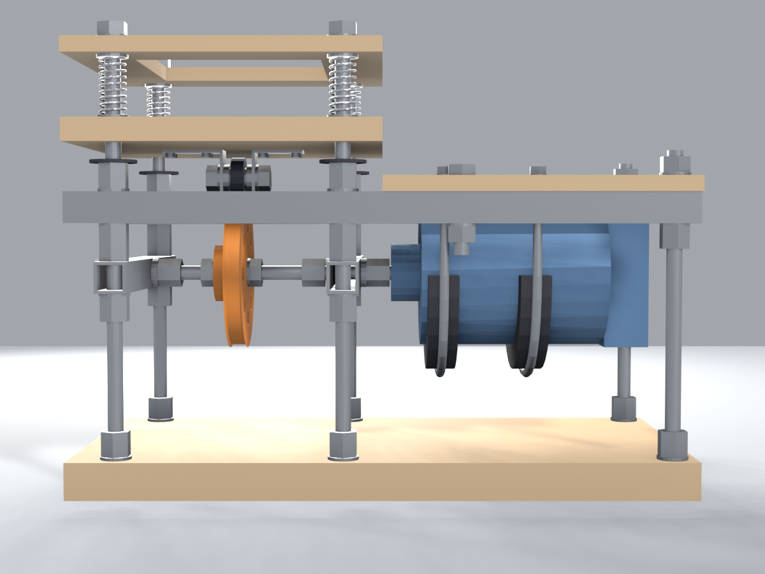
stages/fix10l/pic/render_left.png
