inutcin/boomboom/stages/fix10l/pic/render_mechanism.png

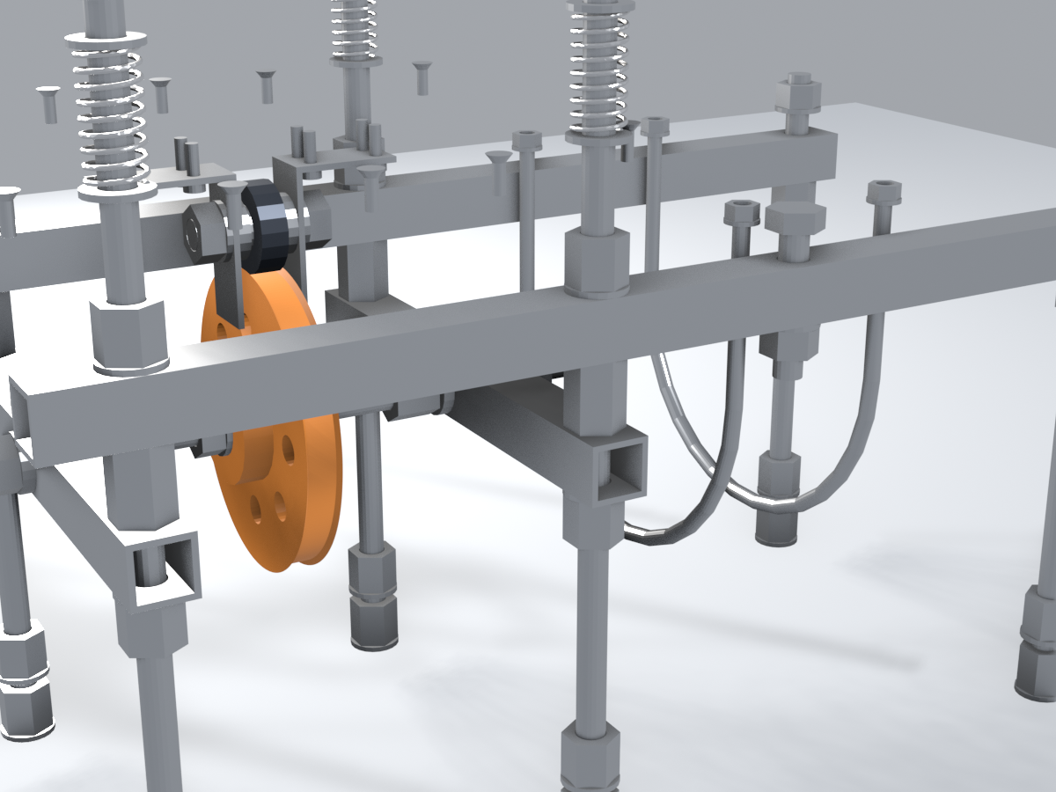
stages/fix10l/pic/render_mechanism.png
