inutcin/boomboom/stages/fix10l/pic/render_rear.png

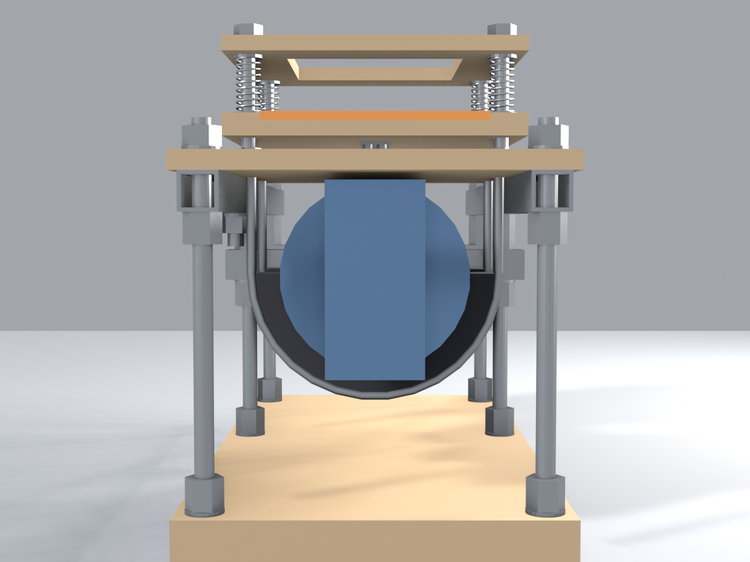
stages/fix10l/pic/render_rear.png
