inutcin/boomboom/stages/fix10l/pic/render_table_top.png

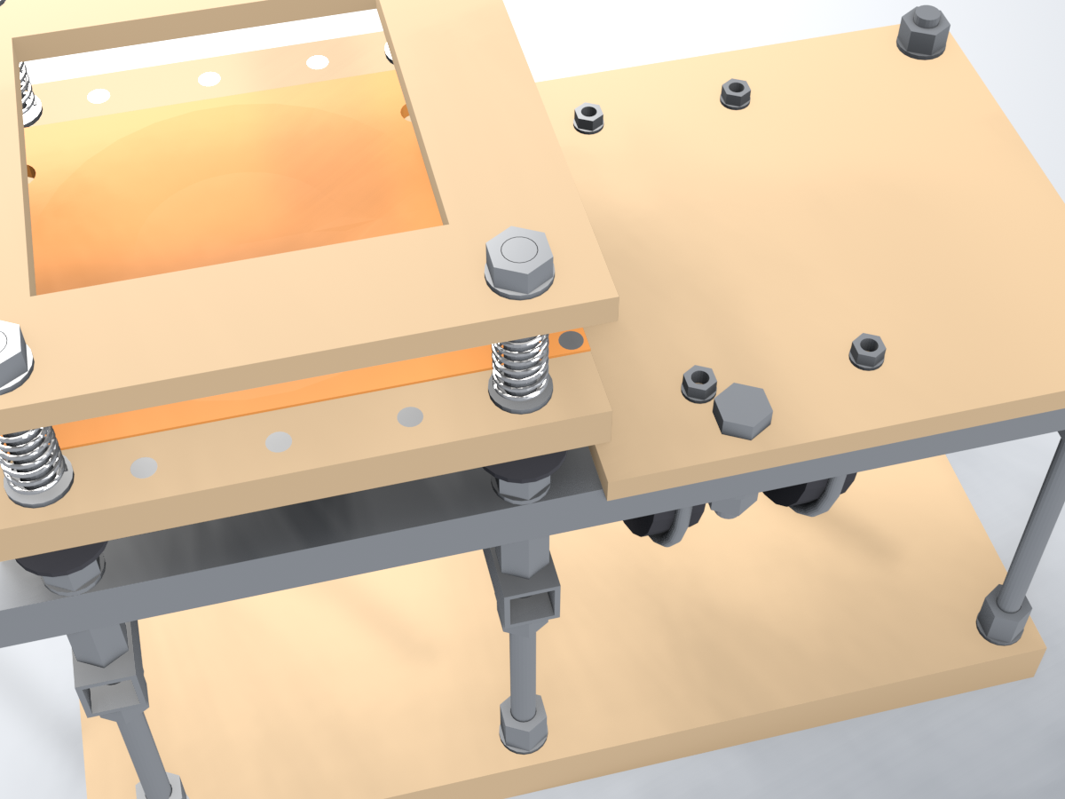
stages/fix10l/pic/render_table_top.png
