inutcin/boomboom/stages/fix10l/pic/render_top.png

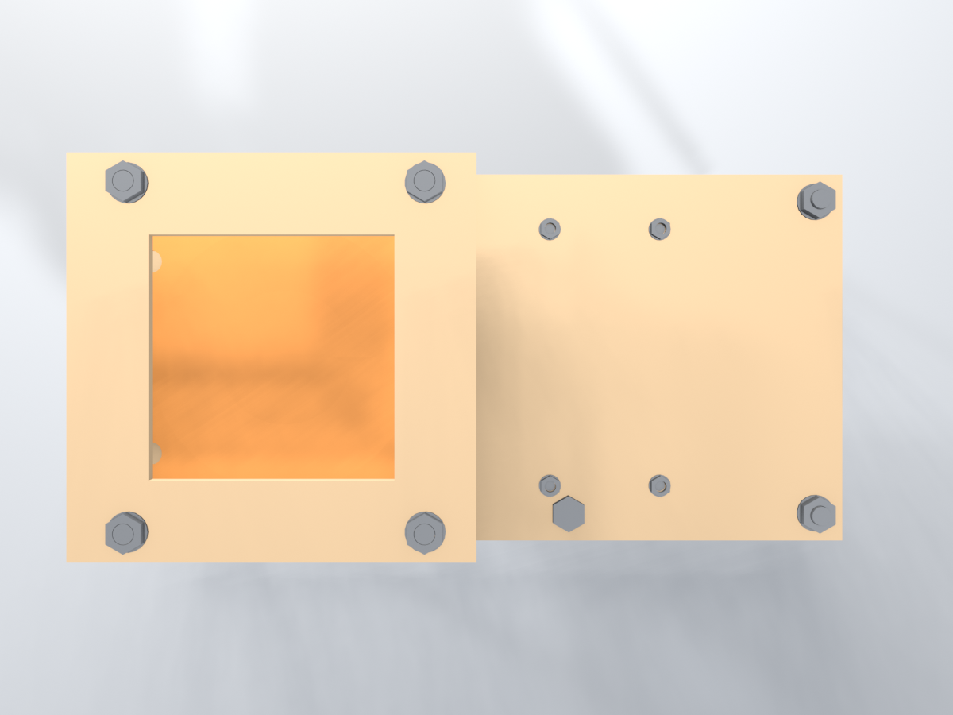
stages/fix10l/pic/render_top.png
