inutcin/boomboom/stages/fix10l/pic/vibrotable_front.png

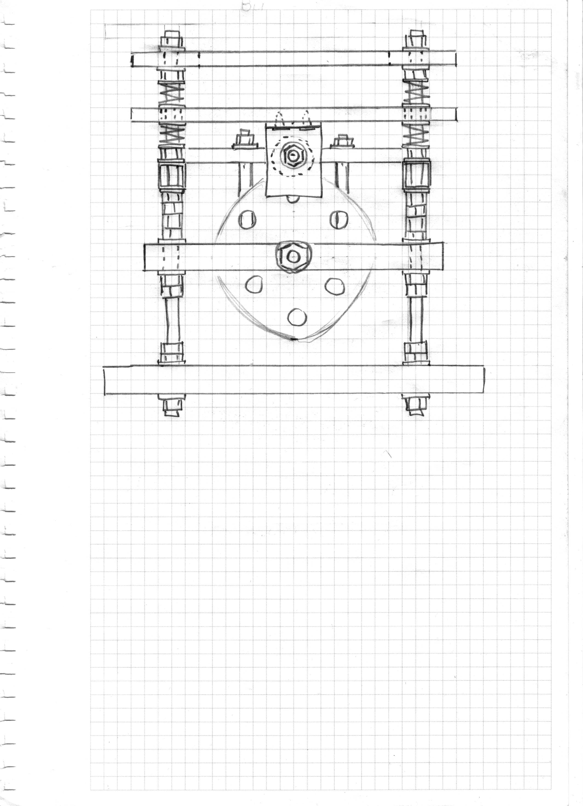
stages/fix10l/pic/vibrotable_front.png
