inutcin/boomboom/stages/fix10l/pic/vibrotable_left.png

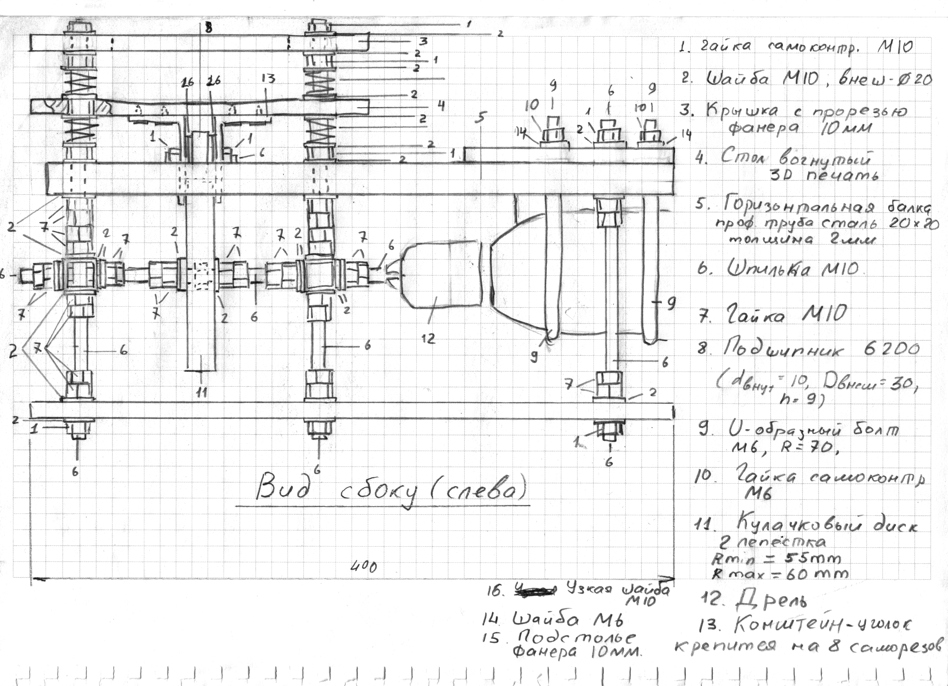
stages/fix10l/pic/vibrotable_left.png
