inutcin/boomboom/stages/fix10l/pic/vibrotable_views.png

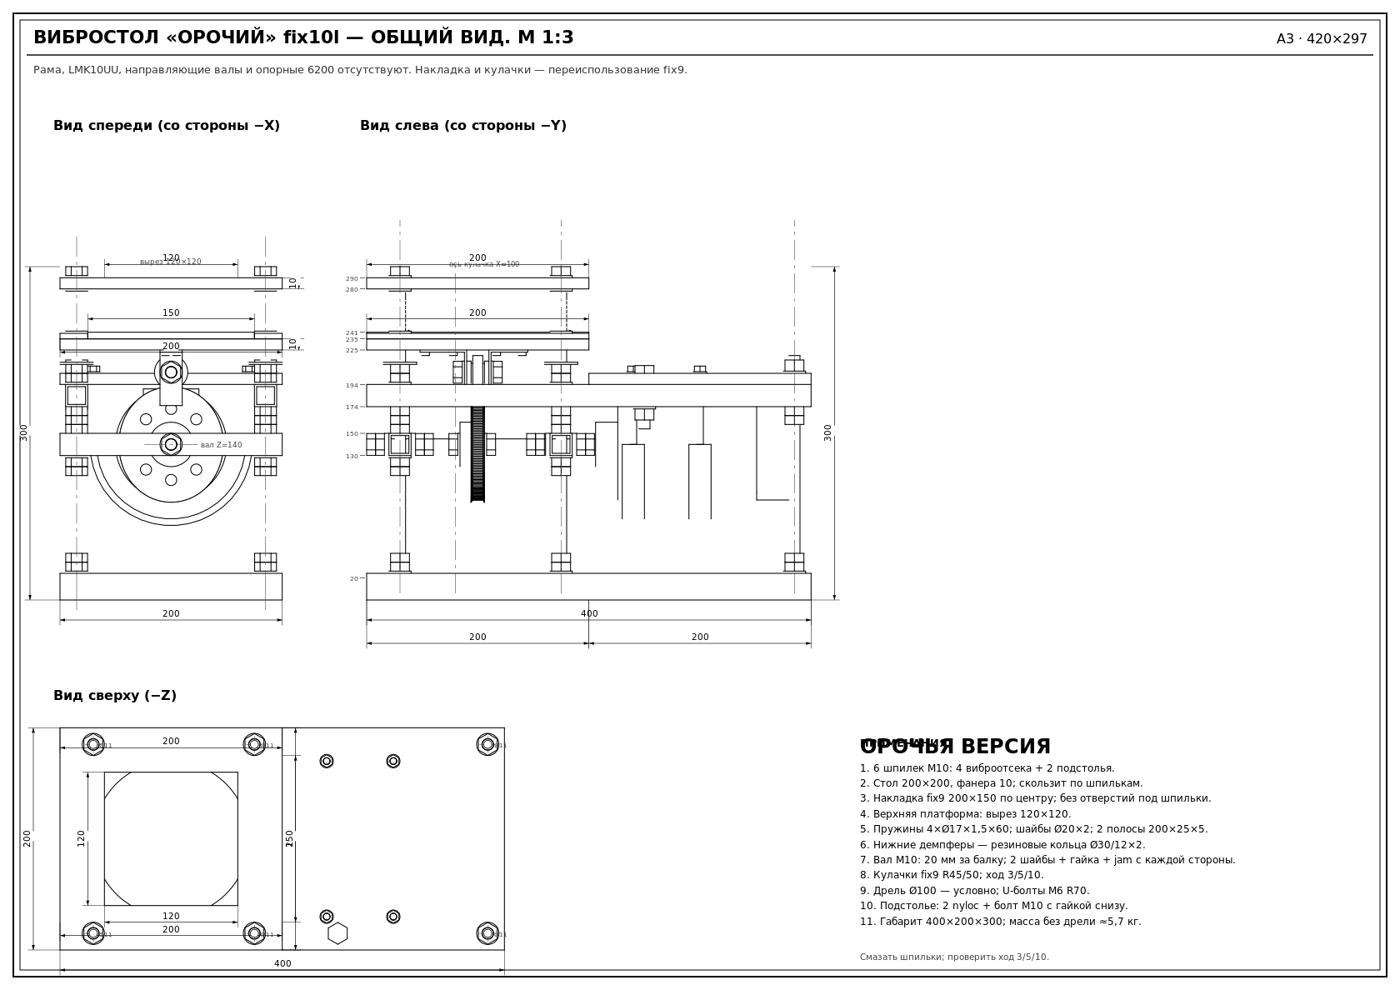
stages/fix10l/pic/vibrotable_views.png
