inutcin/boomboom/stages/fix11/pic/cam.png

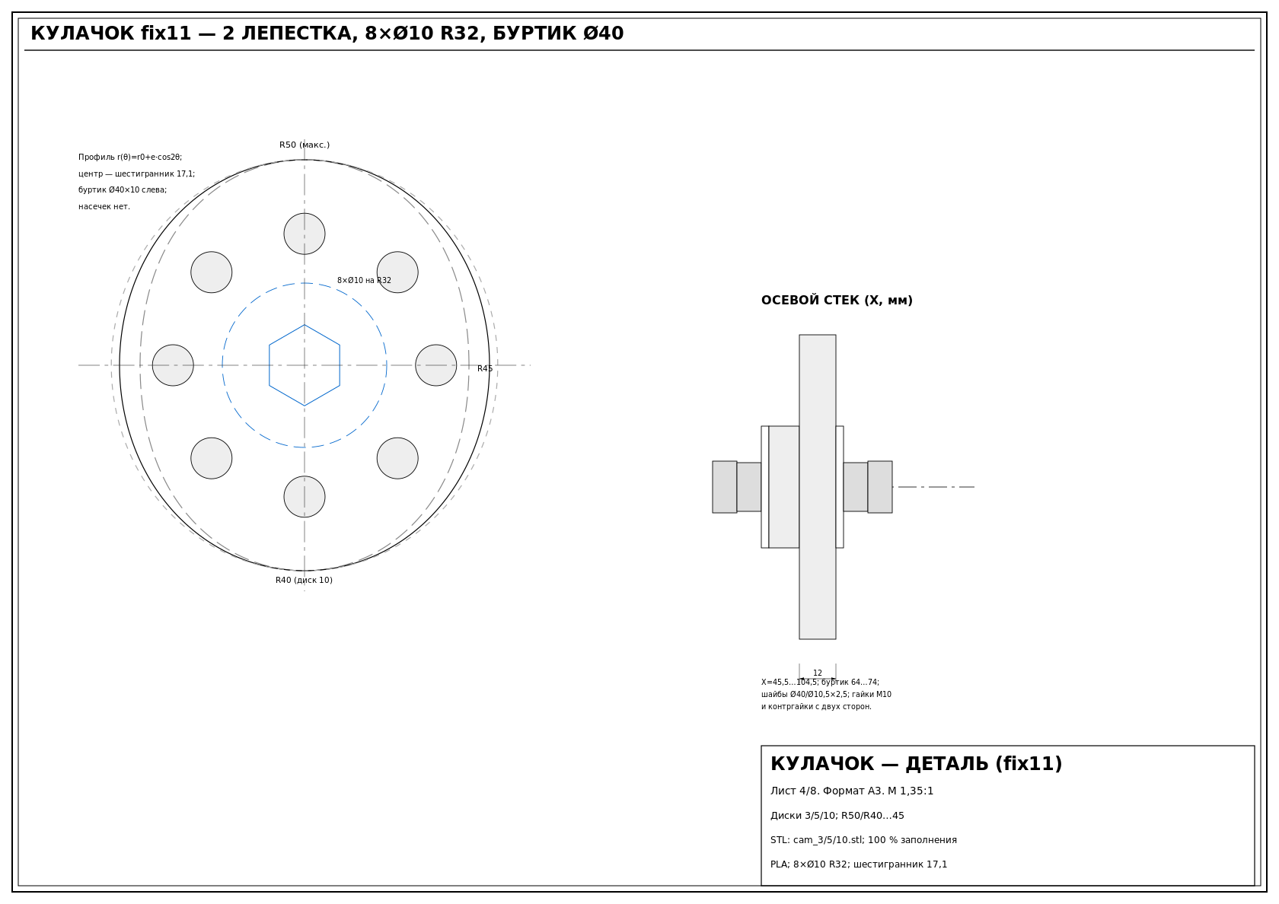
stages/fix11/pic/cam.png
