inutcin/boomboom/stages/fix11/pic/clamp.png

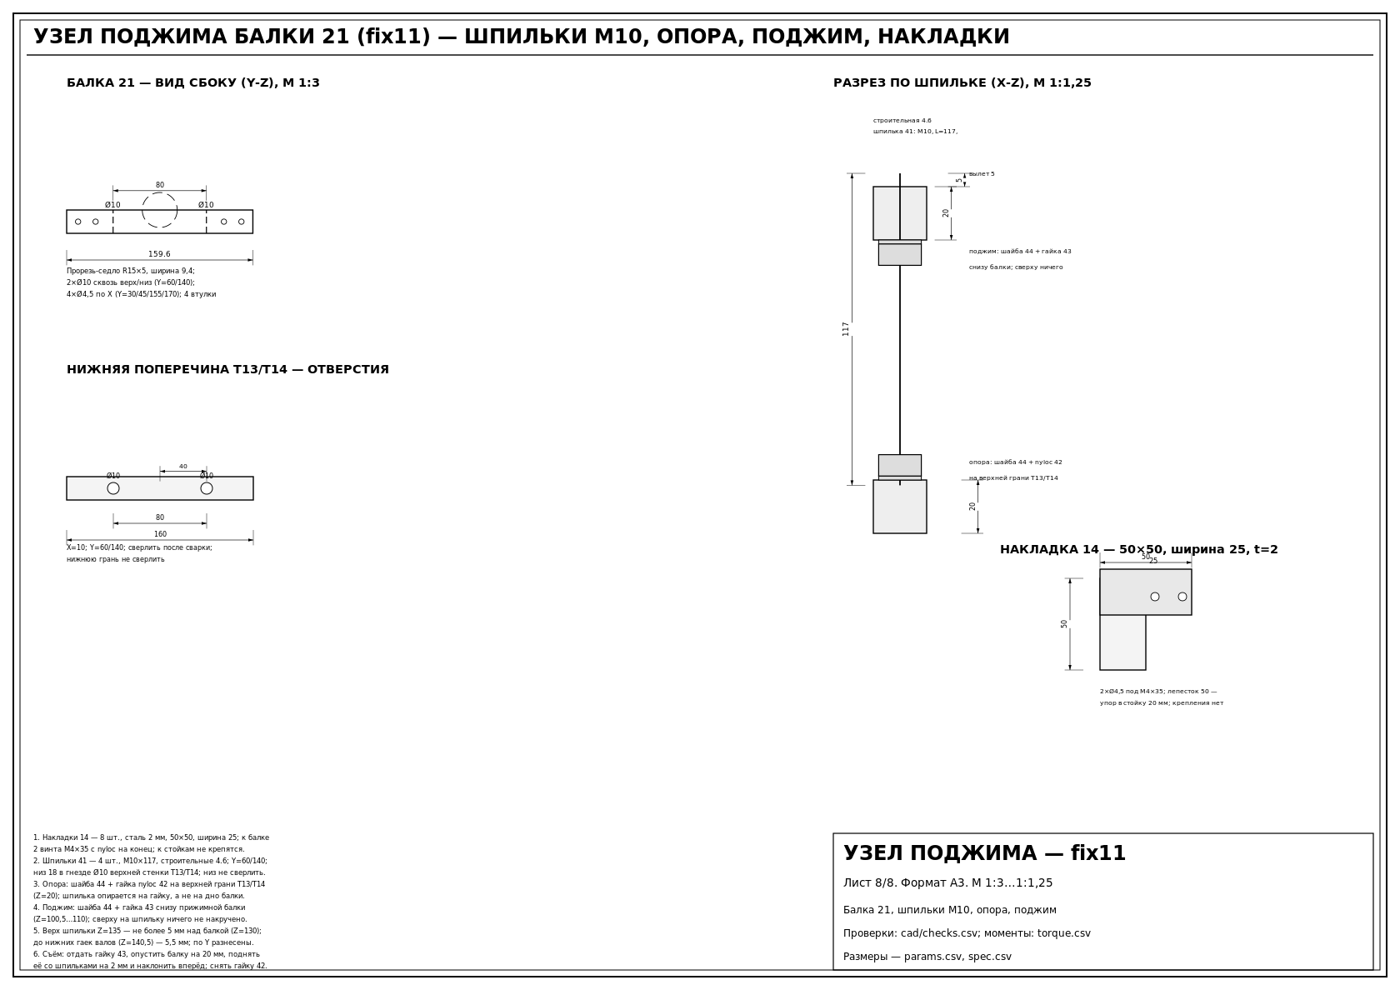
stages/fix11/pic/clamp.png
