inutcin/boomboom/stages/fix11/pic/details.png

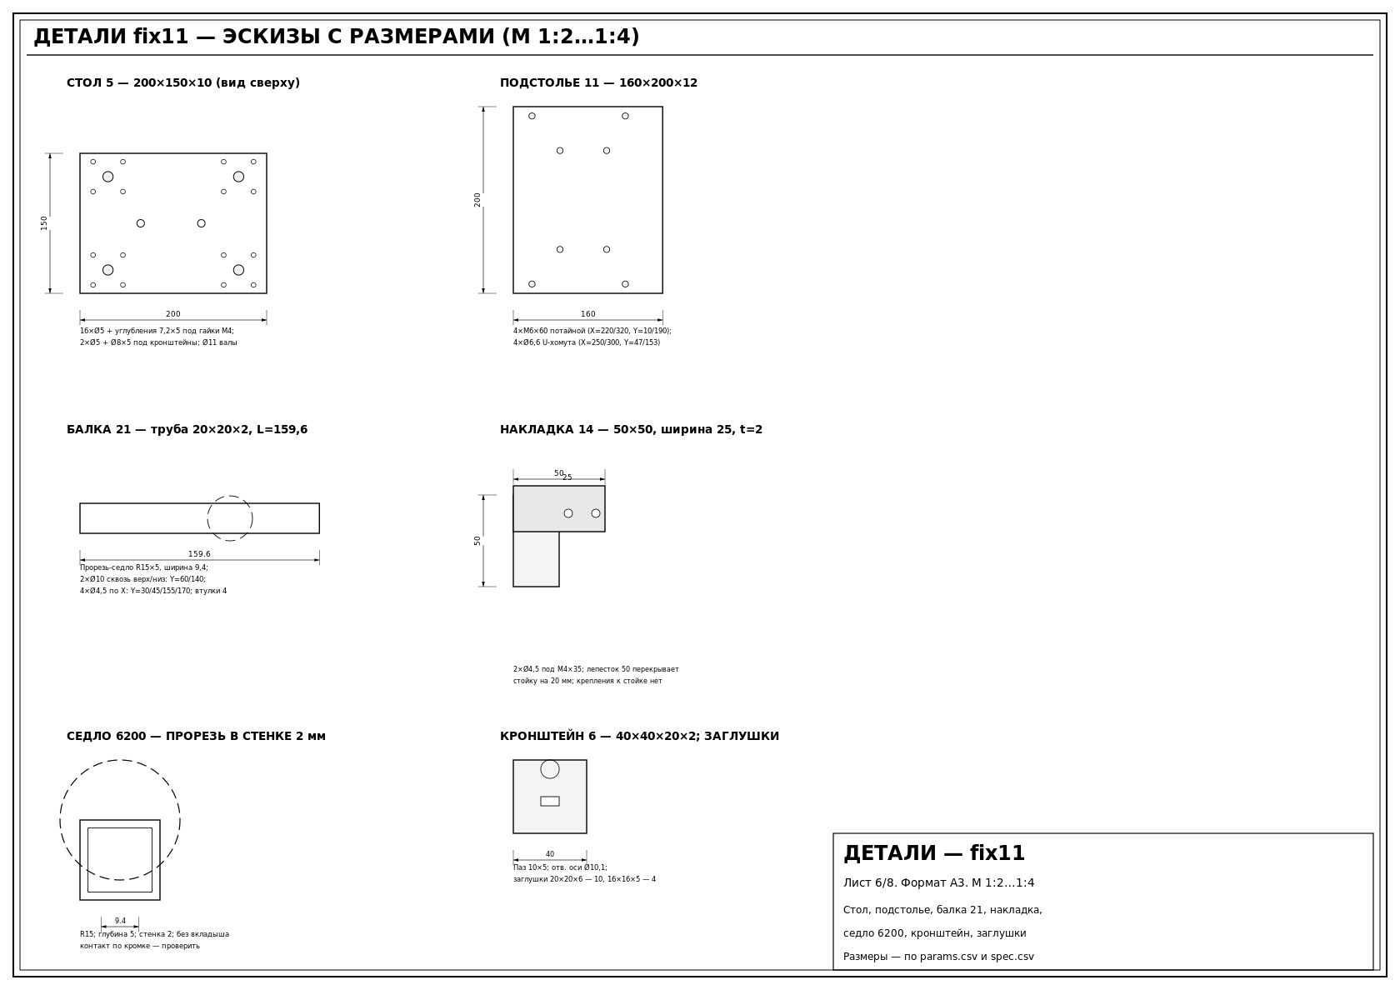
stages/fix11/pic/details.png
