inutcin/boomboom/stages/fix11/pic/frame_tubes.png

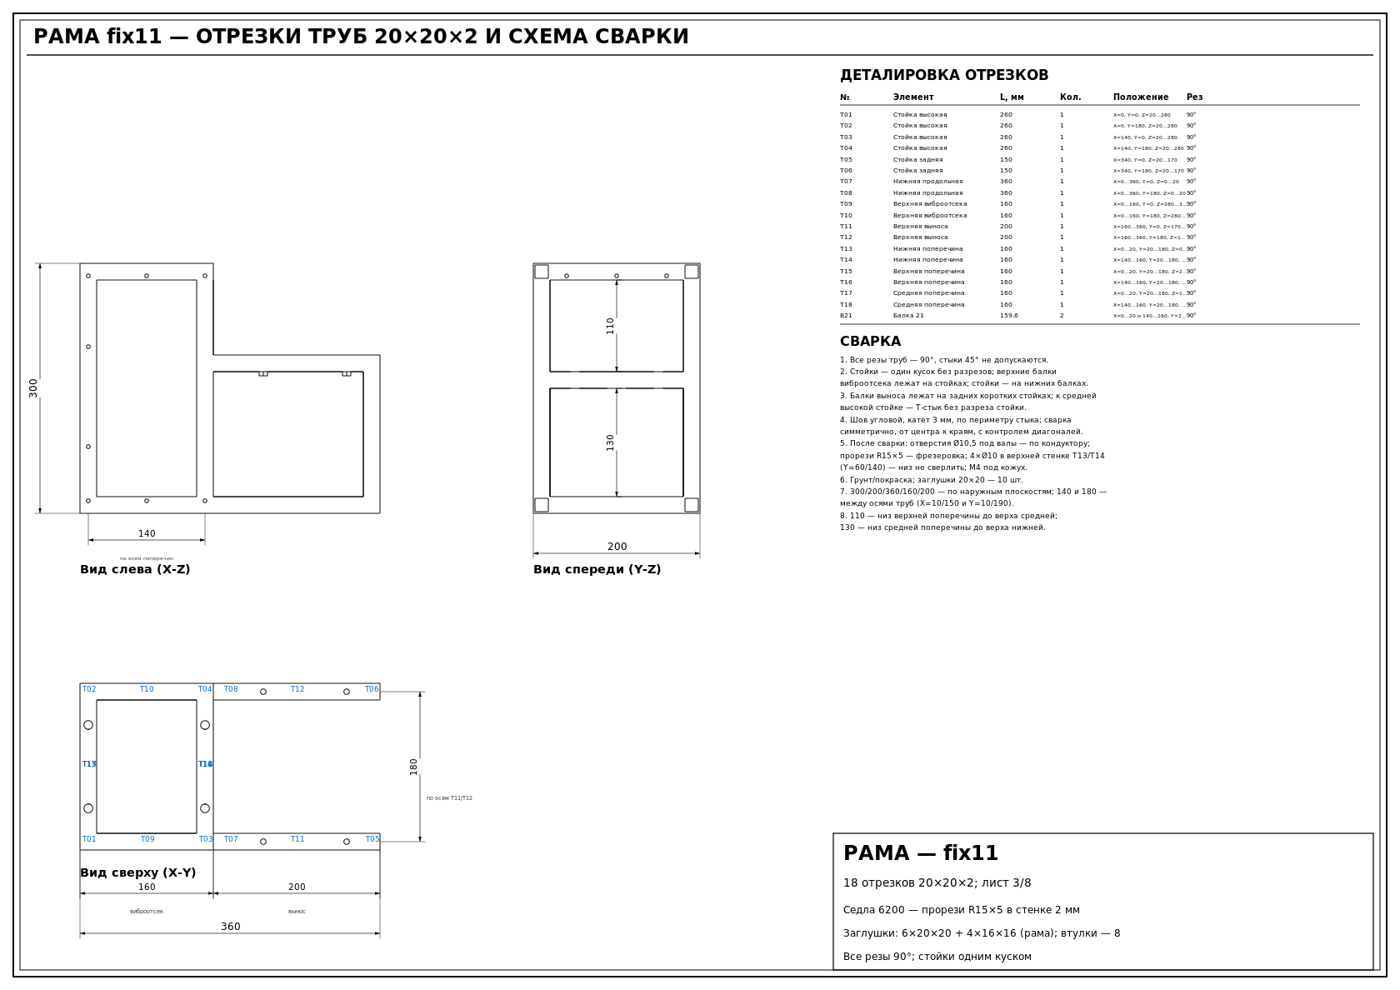
stages/fix11/pic/frame_tubes.png
