inutcin/boomboom/stages/fix11/pic/iso.png

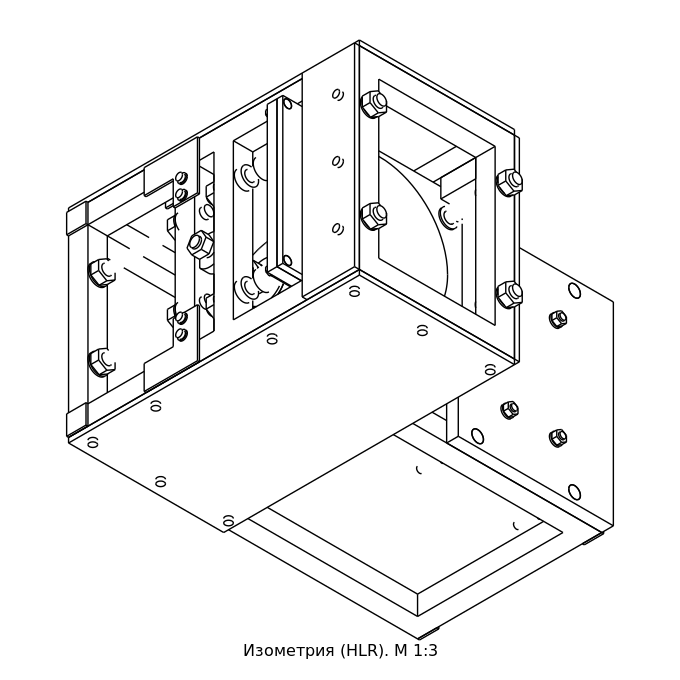
stages/fix11/pic/iso.png
