inutcin/boomboom/stages/fix11/pic/render_beam.png

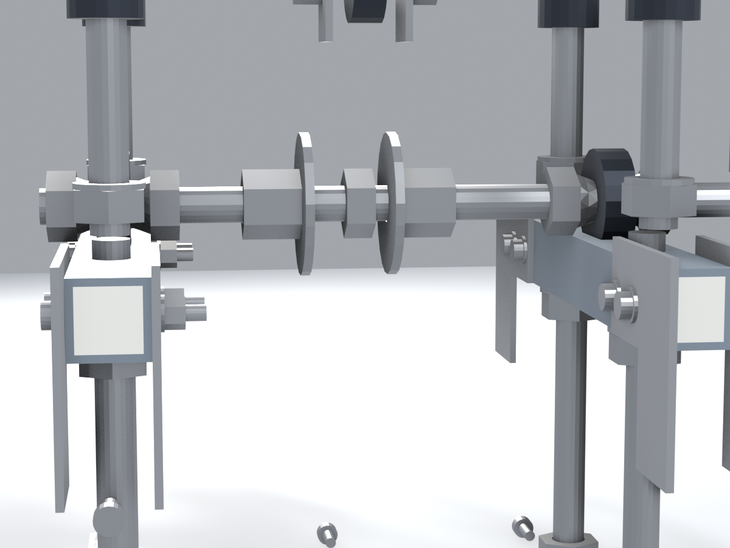
stages/fix11/pic/render_beam.png
