inutcin/boomboom/stages/fix11/pic/render_bearing_1.png

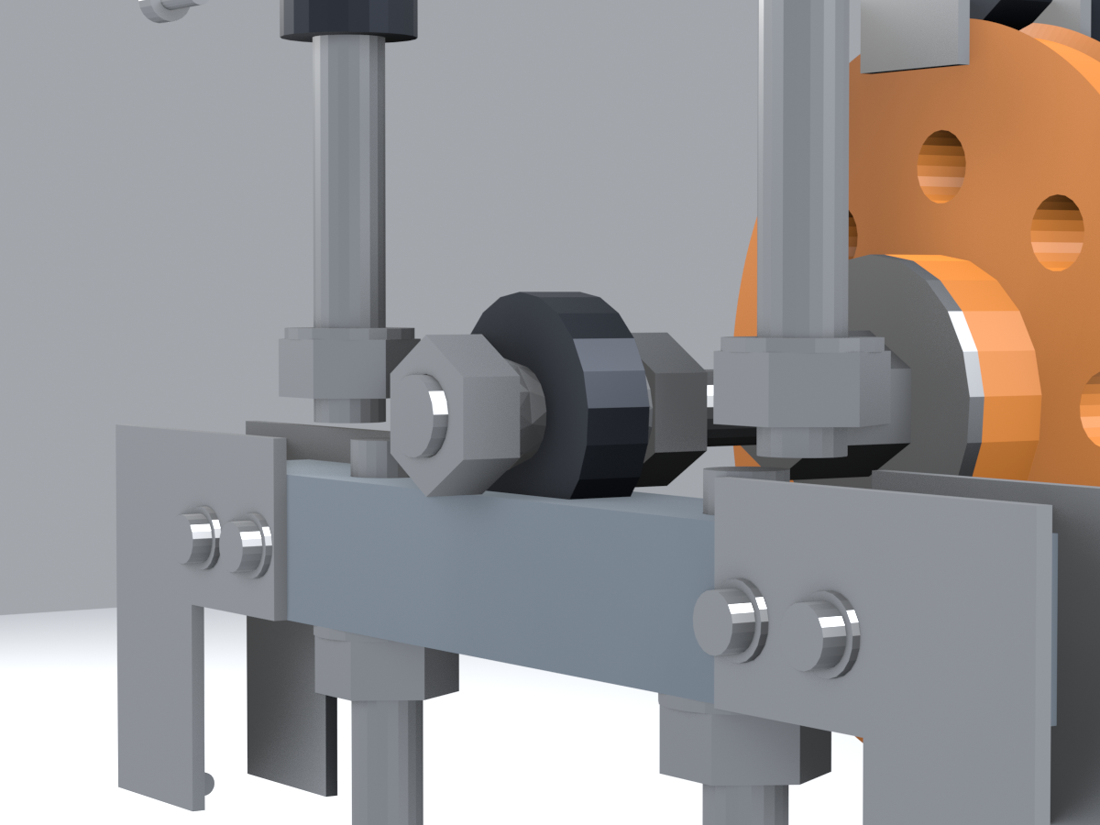
stages/fix11/pic/render_bearing_1.png
