inutcin/boomboom/stages/fix11/pic/render_bearing_2.png

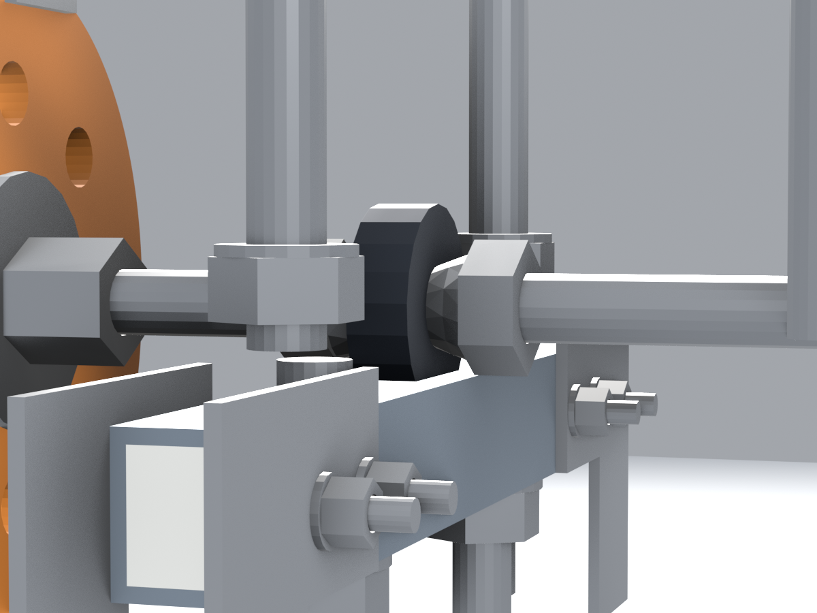
stages/fix11/pic/render_bearing_2.png
