inutcin/boomboom/stages/fix11/pic/render_bearing_2_left.png

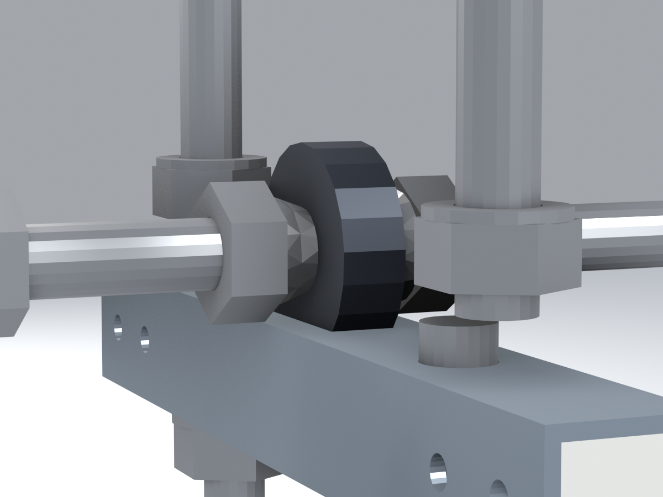
stages/fix11/pic/render_bearing_2_left.png
