inutcin/boomboom/stages/fix11/pic/render_bearing_clamp.png

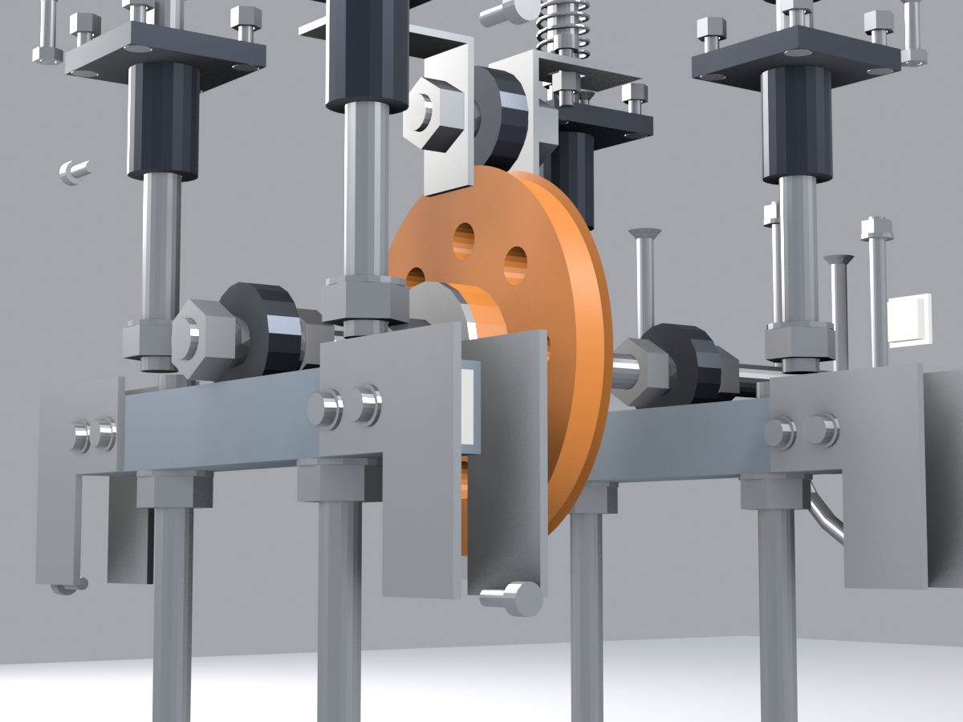
stages/fix11/pic/render_bearing_clamp.png
