inutcin/boomboom/stages/fix11/pic/render_cam.png

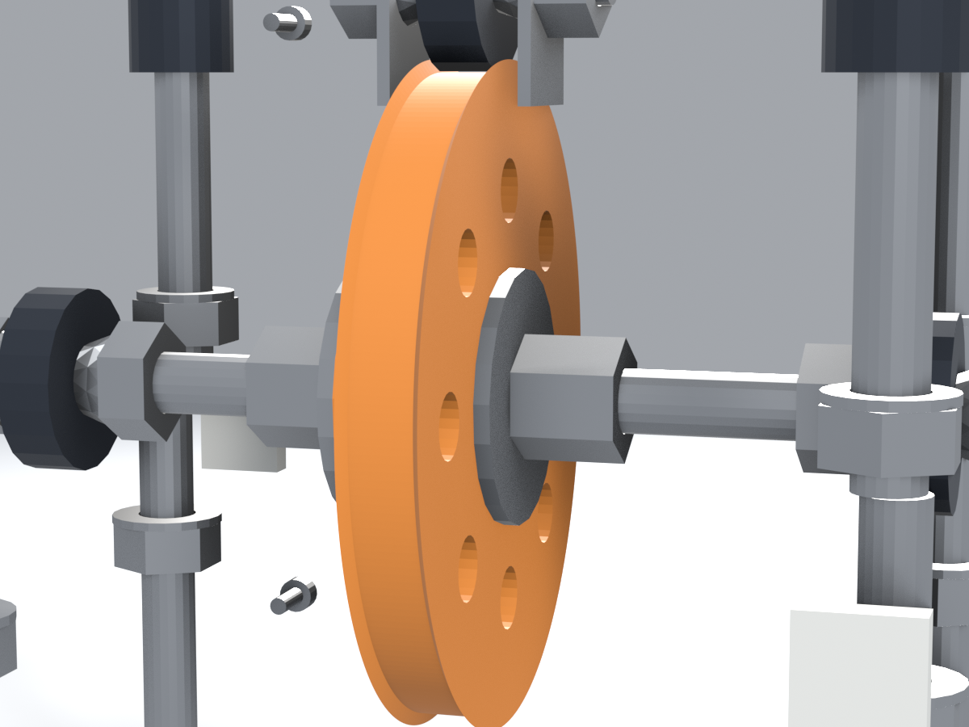
stages/fix11/pic/render_cam.png
