inutcin/boomboom/stages/fix11/pic/render_clamp_unit.png

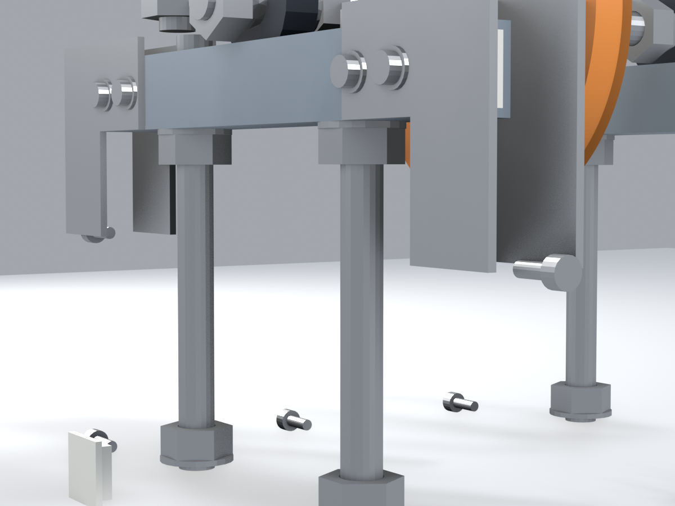
stages/fix11/pic/render_clamp_unit.png
