inutcin/boomboom/stages/fix11/pic/render_frame.png

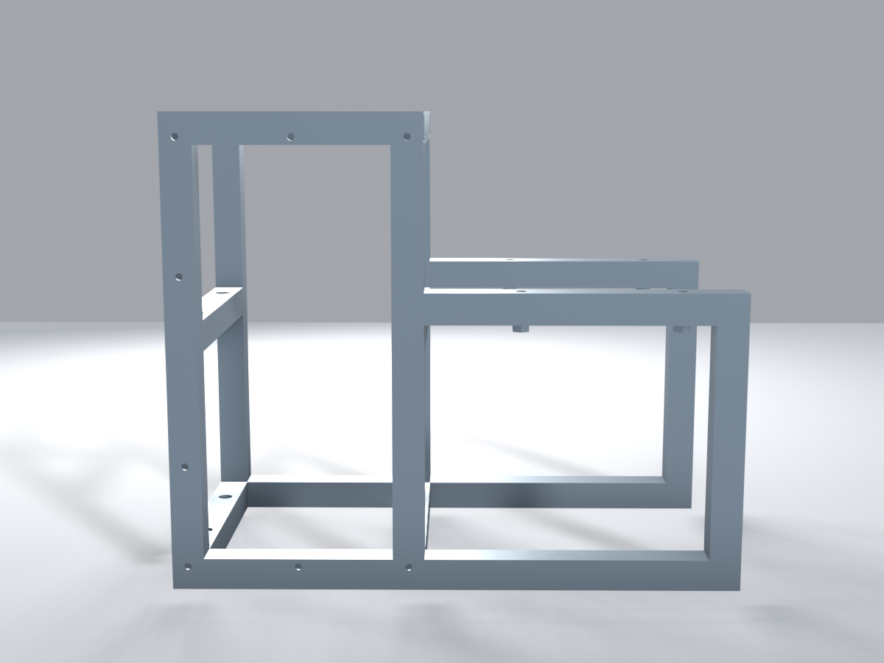
stages/fix11/pic/render_frame.png
