inutcin/boomboom/stages/fix11/pic/render_front.png

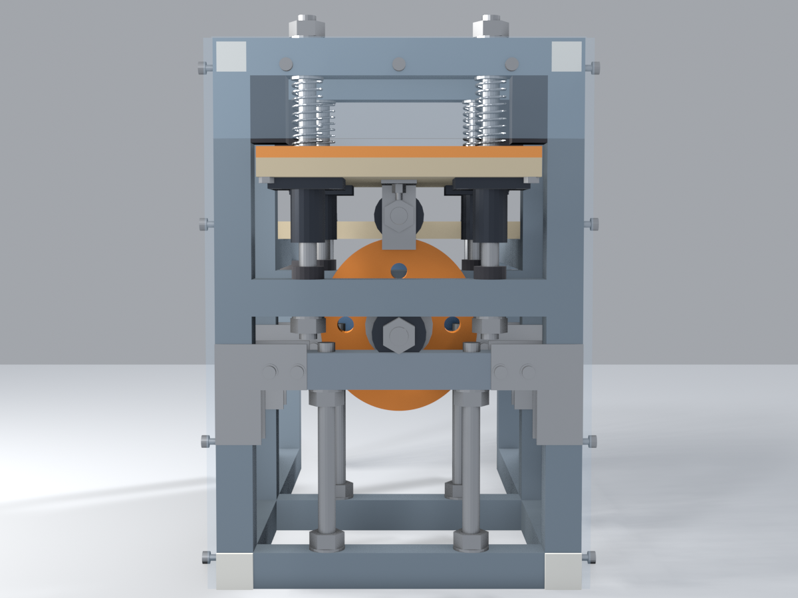
stages/fix11/pic/render_front.png
