inutcin/boomboom/stages/fix11/pic/render_iso.png

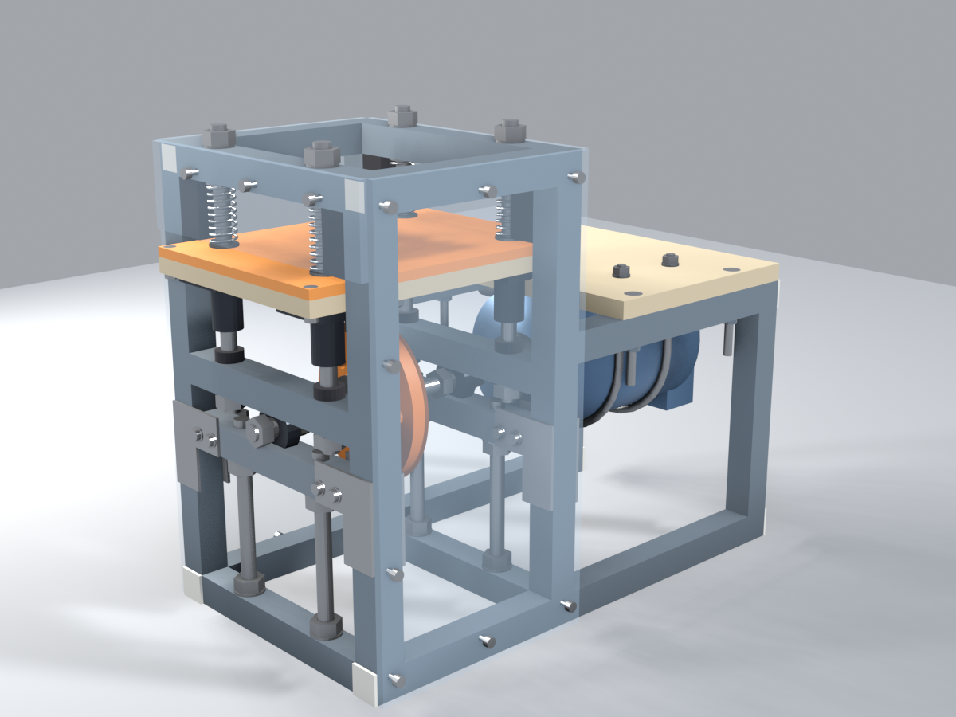
stages/fix11/pic/render_iso.png
