inutcin/boomboom/stages/fix11/pic/render_left.png

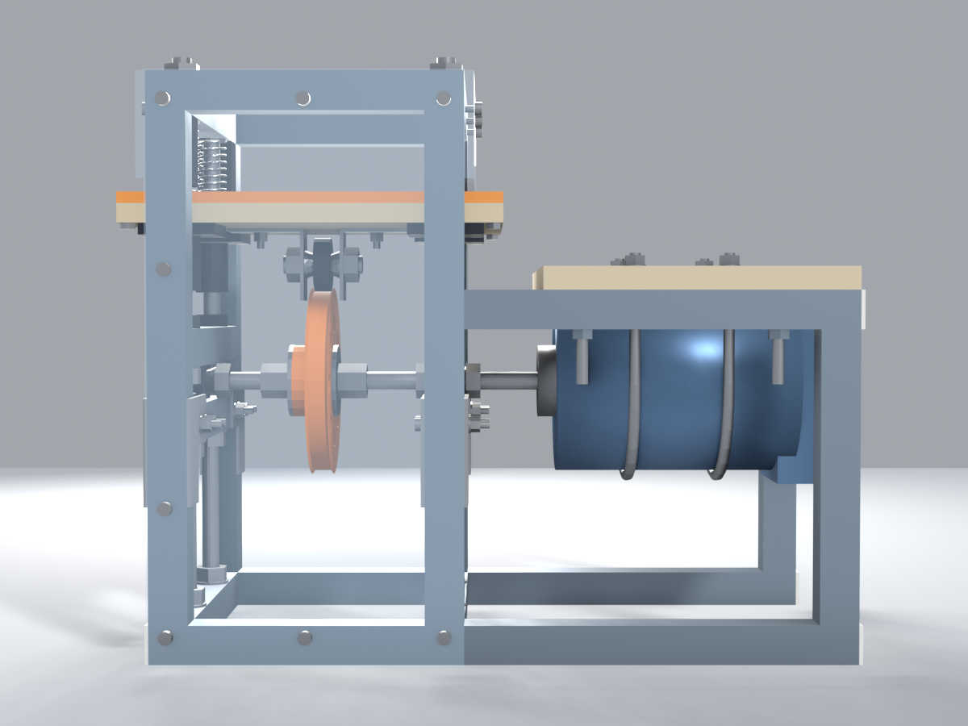
stages/fix11/pic/render_left.png
