inutcin/boomboom/stages/fix11/pic/render_mechanism.png

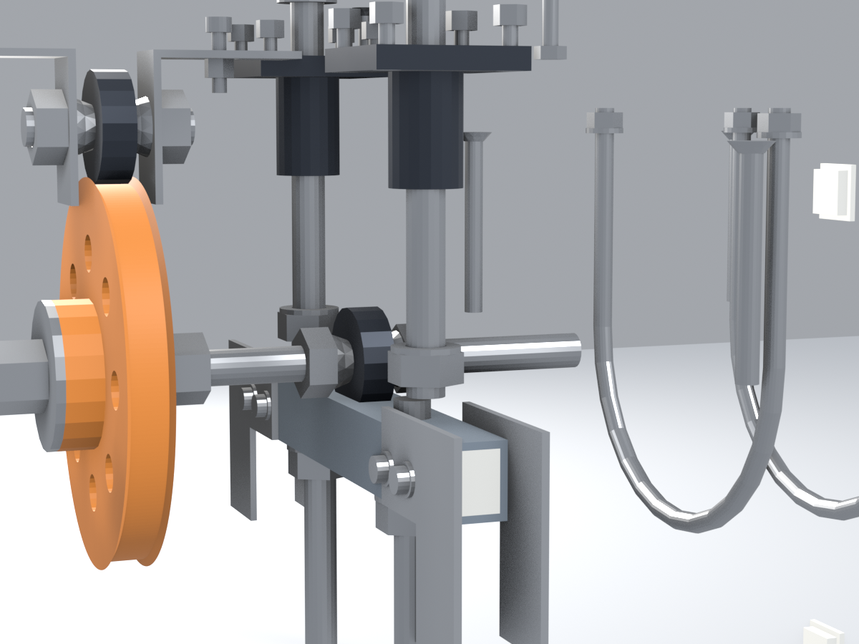
stages/fix11/pic/render_mechanism.png
