inutcin/boomboom/stages/fix11/pic/render_pad.png

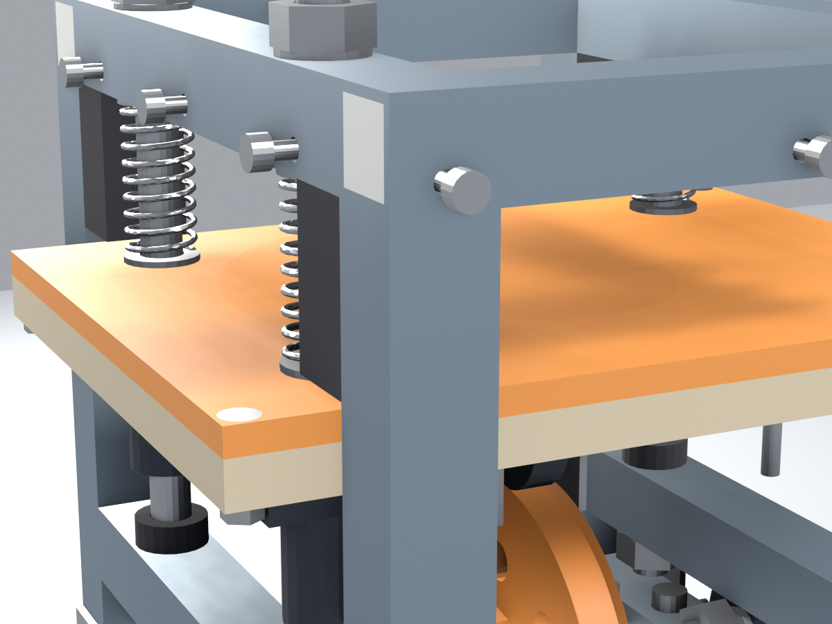
stages/fix11/pic/render_pad.png
