inutcin/boomboom/stages/fix11/pic/render_retainer_down.png

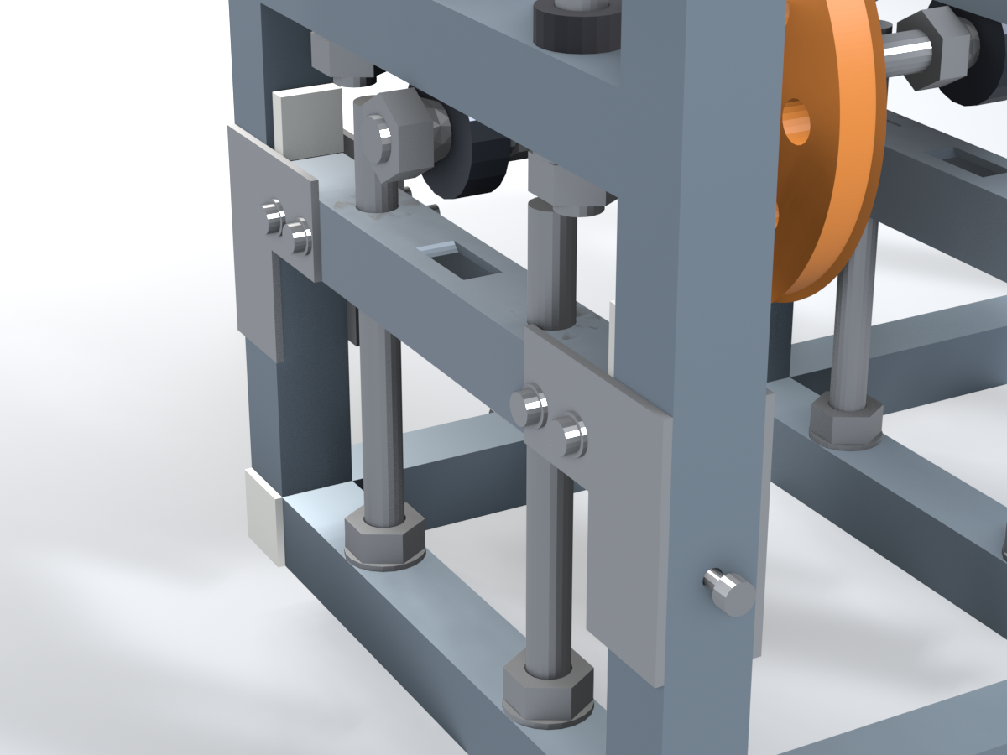
stages/fix11/pic/render_retainer_down.png
