inutcin/boomboom/stages/fix11/pic/render_ring.png

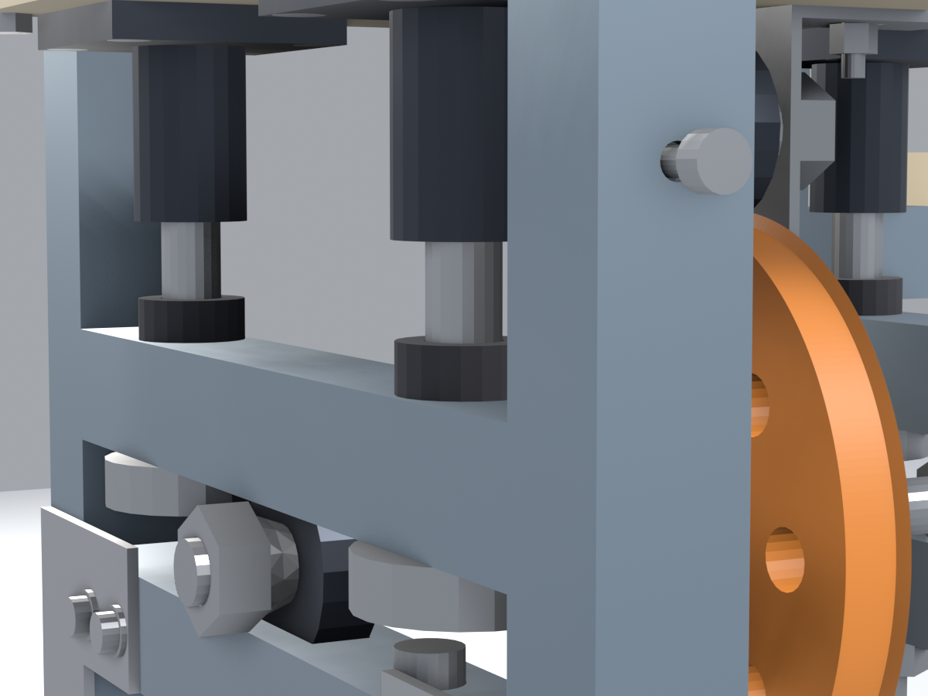
stages/fix11/pic/render_ring.png
