inutcin/boomboom/stages/fix11/pic/render_shield.png

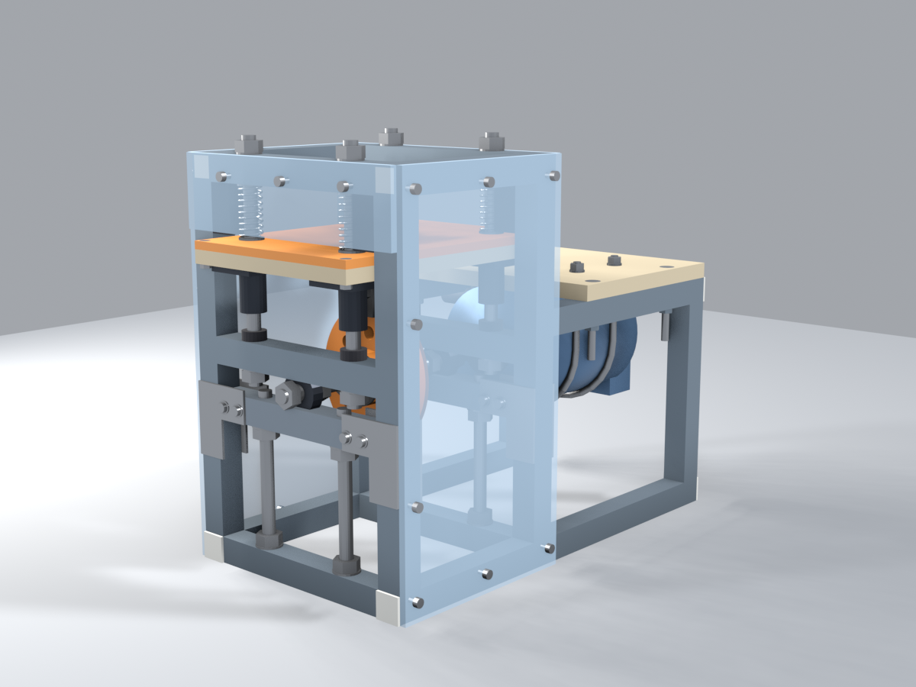
stages/fix11/pic/render_shield.png
