inutcin/boomboom/stages/fix11/pic/render_table_bottom.png

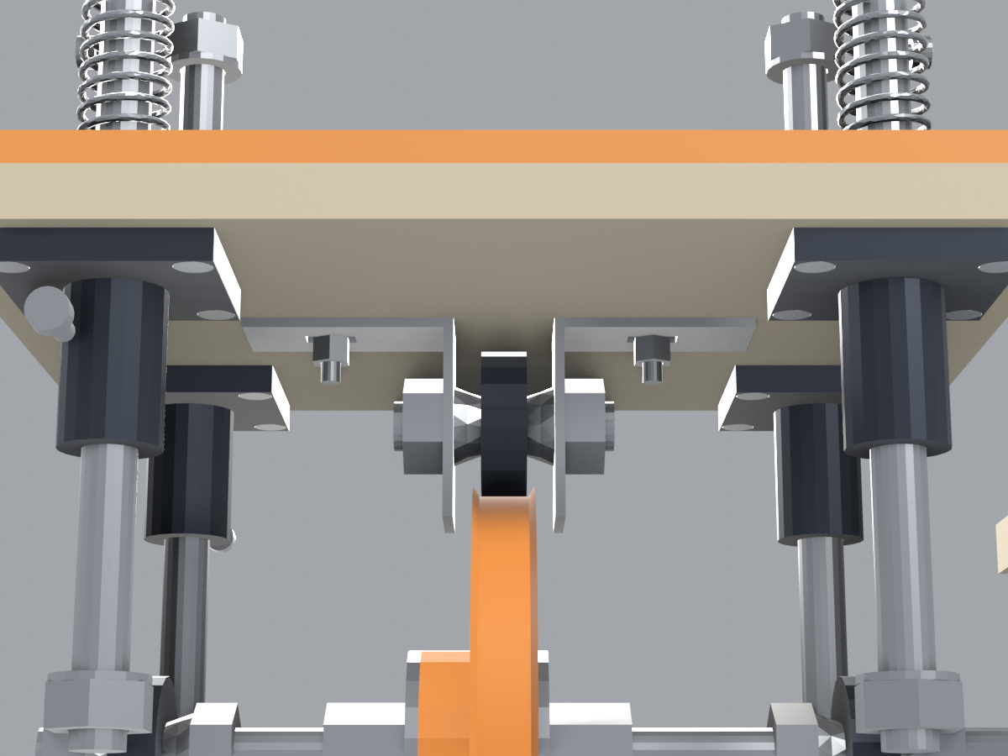
stages/fix11/pic/render_table_bottom.png
