inutcin/boomboom/stages/fix11/pic/render_top.png

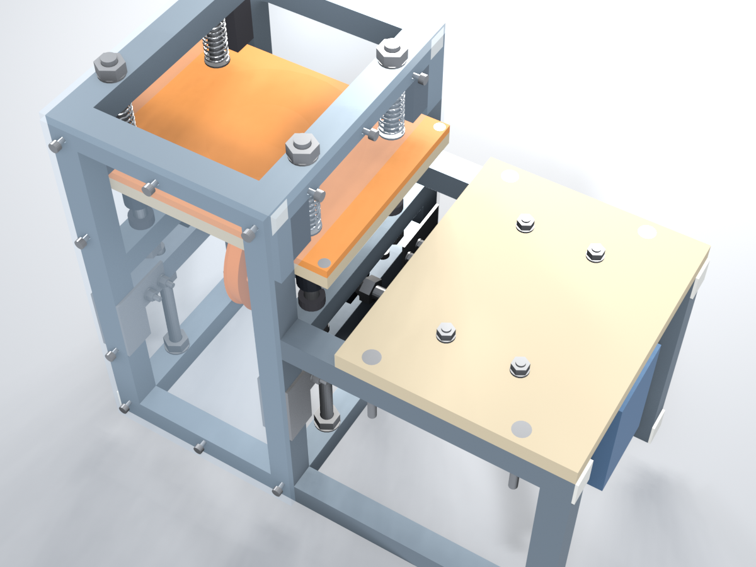
stages/fix11/pic/render_top.png
