inutcin/boomboom/stages/fix11/pic/render_washer.png

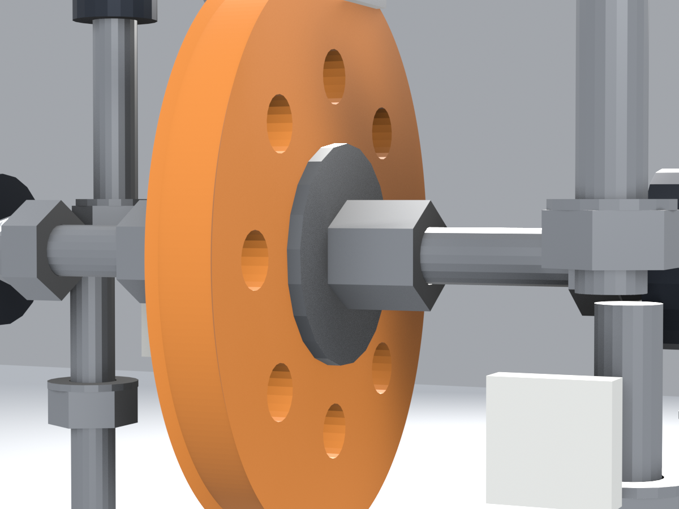
stages/fix11/pic/render_washer.png
