inutcin/boomboom/stages/fix11/pic/vibrotable_shield.png

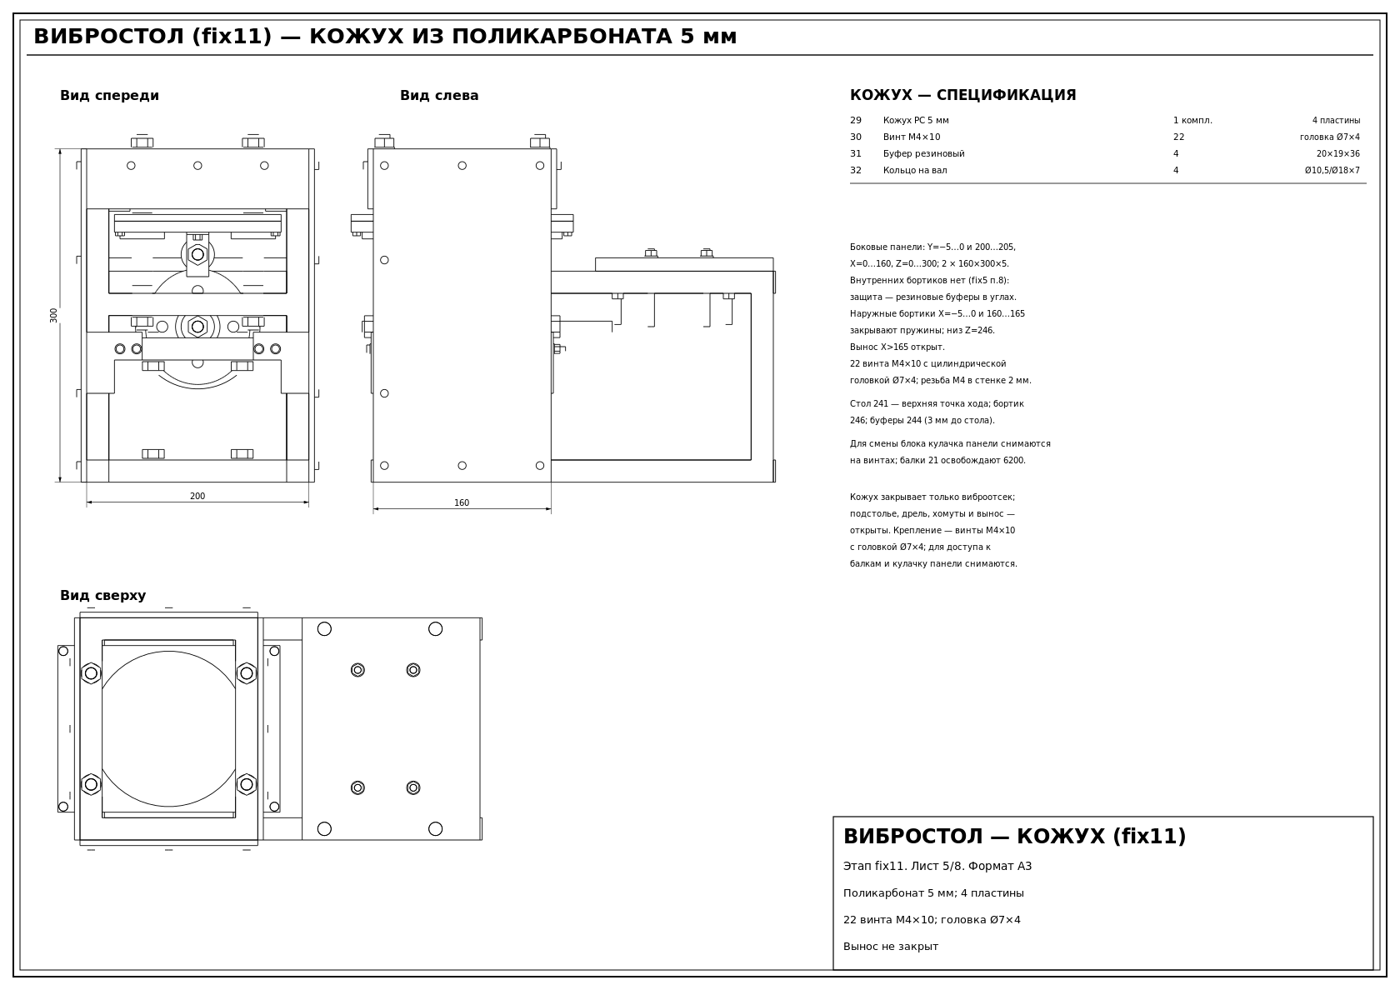
stages/fix11/pic/vibrotable_shield.png
