inutcin/boomboom/stages/fix11/pic/vibrotable_views.png

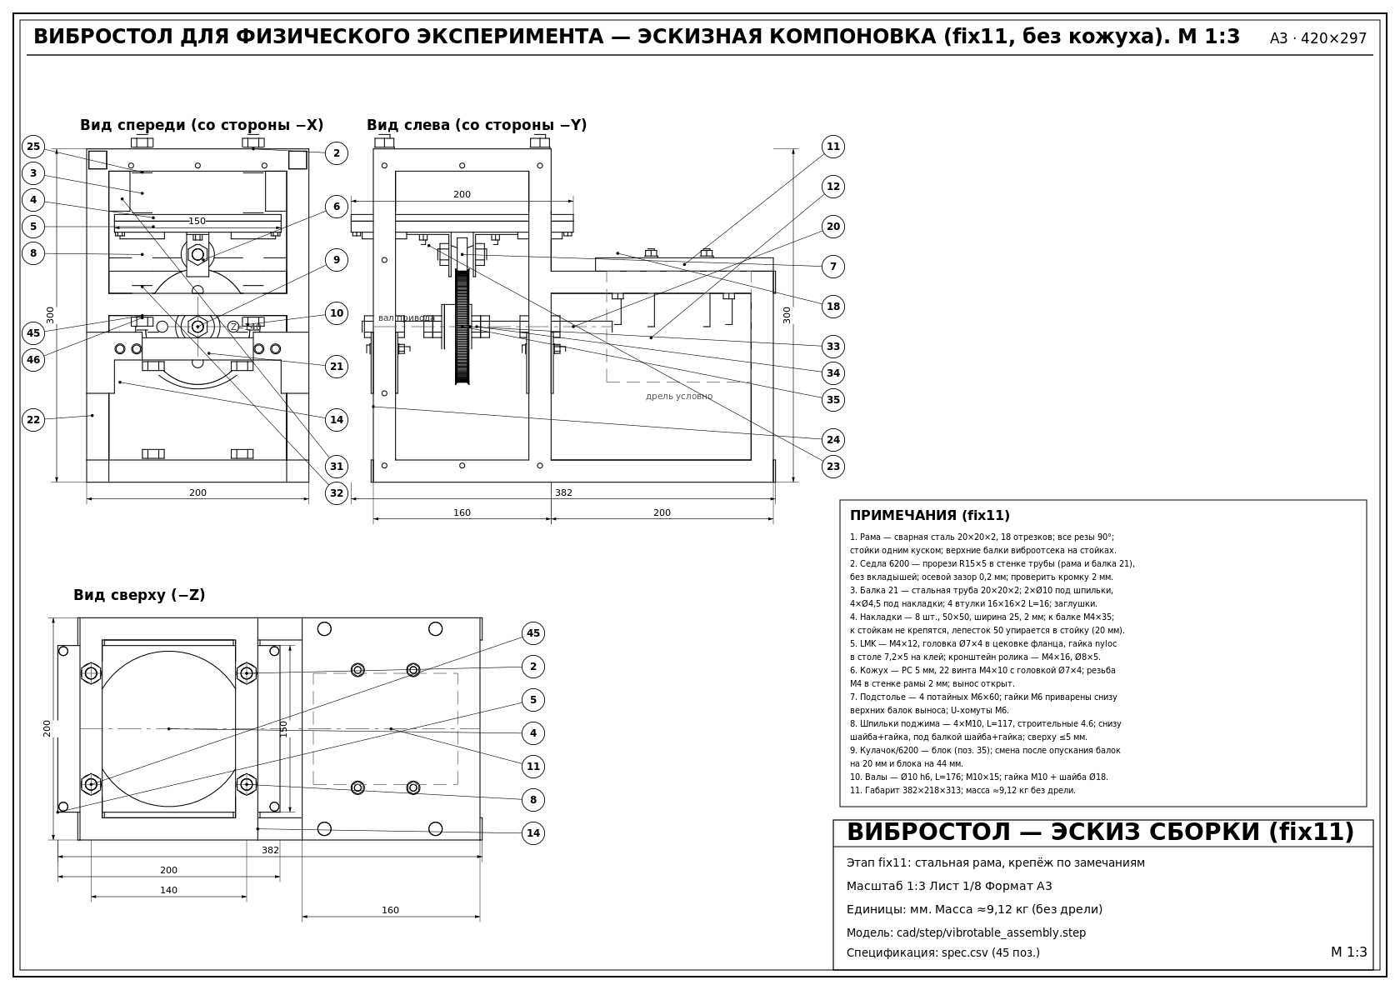
stages/fix11/pic/vibrotable_views.png
