inutcin/boomboom/stages/fix11/techdraw/pic/tube_cut_layout.png

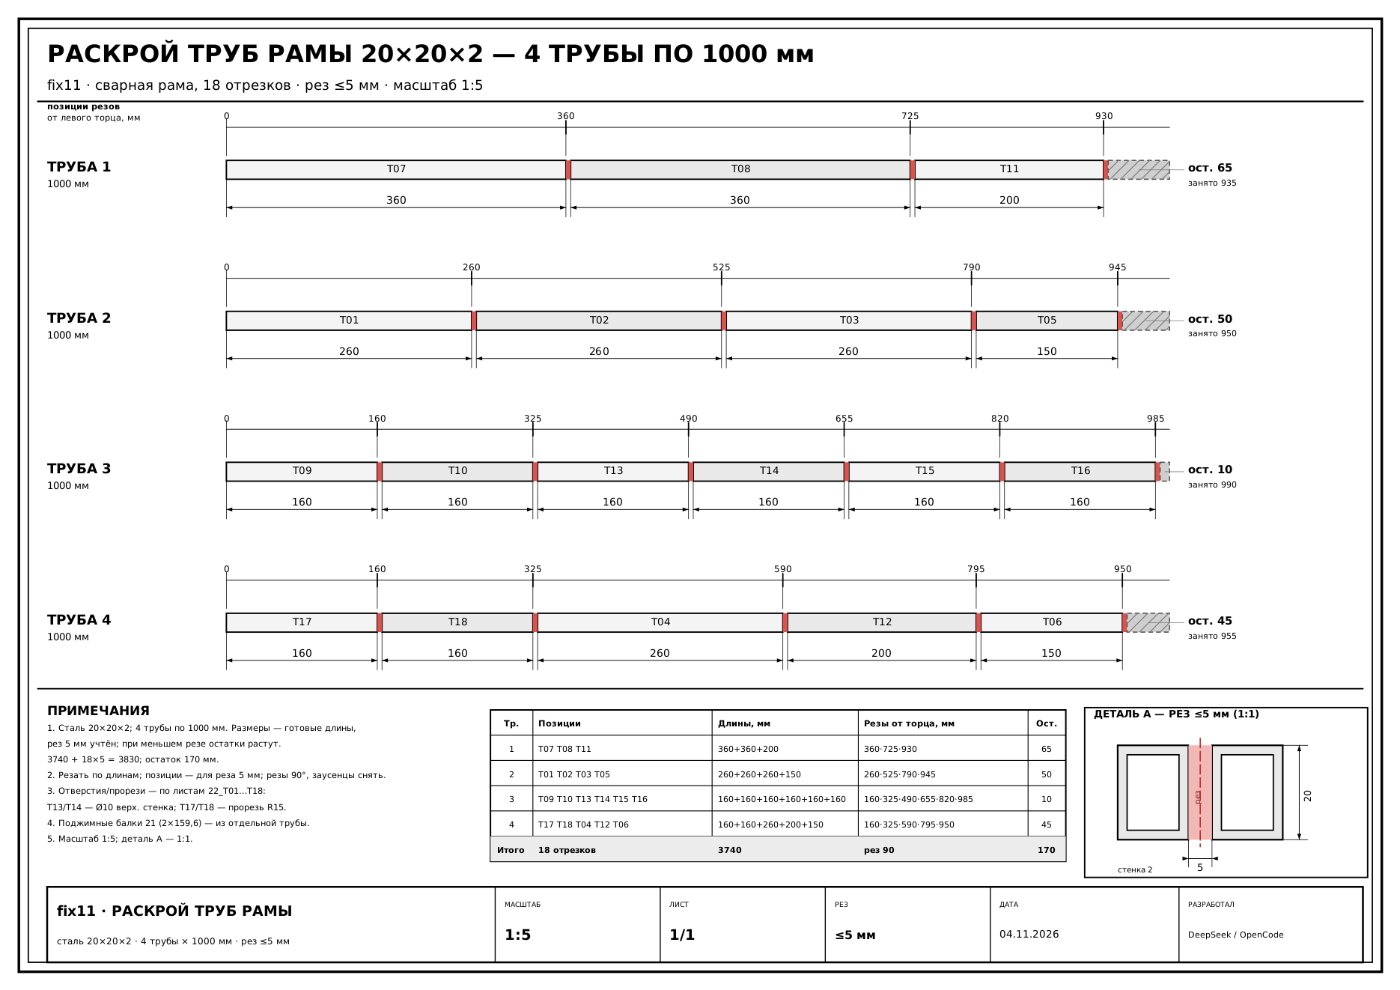
stages/fix11/techdraw/pic/tube_cut_layout.png
