inutcin/boomboom/stages/fix11/tachdraw/pdf/02_shaft.pdf

# ВАЛ НАПРАВЛЯЮЩИЙ

## ГЛАВНЫЙ ВИД · М 1:2

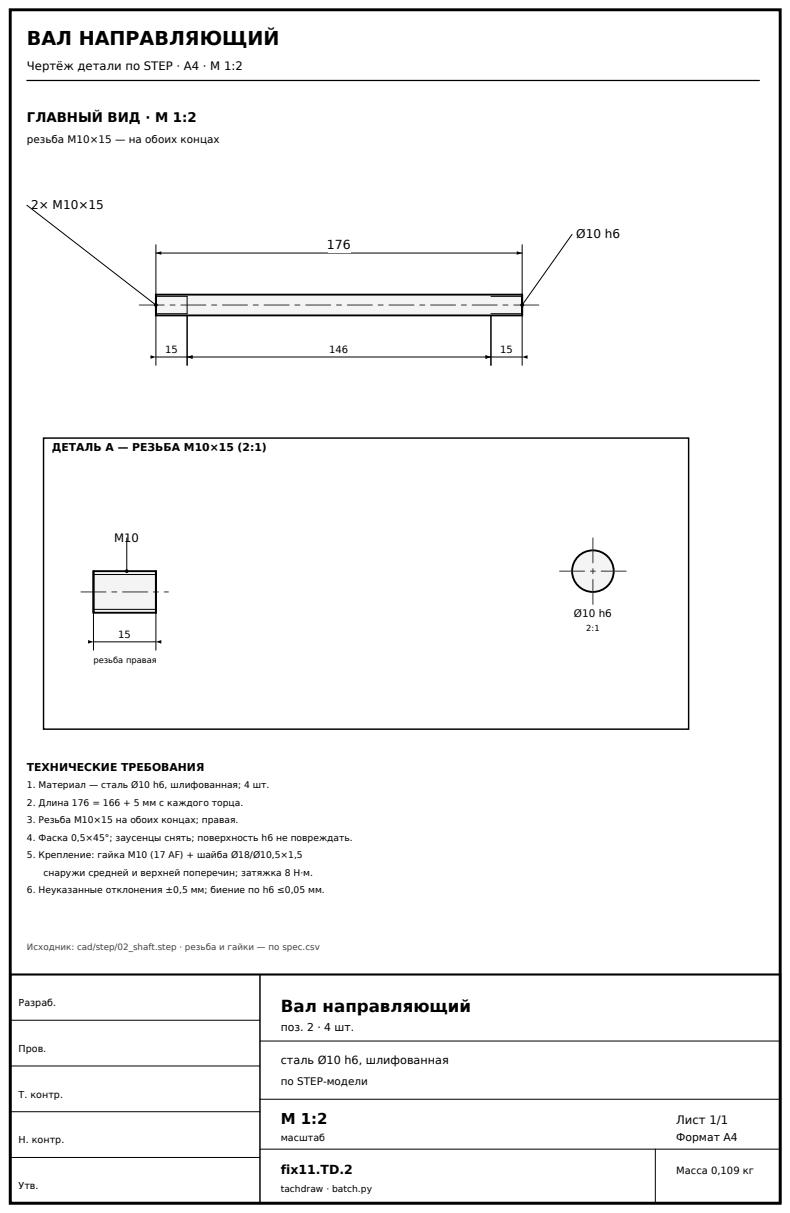
[picture p241: page 1]
Разраб.; Пров.; Т. контр.; Н. контр.; Утв.; Вал направляющий; поз. 2 · 4 шт.; масштаб; Лист 1/1 Формат A4; fix11.TD.2; Масса 0,109 кг; ДЕТАЛЬ А — РЕЗЬБА M10×15 (2:1); резьба правая

Чертёж детали по STEP · A4 · М 1:2

резьба M10×15 — на обоих концах

ТЕХНИЧЕСКИЕ ТРЕБОВАНИЯ
1. Материал — сталь Ø10 h6, шлифованная; 4 шт.
2. Длина 176 = 166 + 5 мм с каждого торца.
3. Резьба M10×15 на обоих концах; правая.
4. Фаска 0,5×45°; заусенцы снять; поверхность h6 не повреждать.
5. Крепление: гайка M10 (17 AF) + шайба Ø18/Ø10,5×1,5
снаружи средней и верхней поперечин; затяжка 8 Н·м.
6. Неуказанные отклонения ±0,5 мм; биение по h6 ≤0,05 мм.

Исходник: cad/step/02_shaft.step · резьба и гайки — по spec.csv

сталь Ø10 h6, шлифованная
по STEP-модели

tachdraw · batch.py
