inutcin/boomboom/stages/fix11/techdraw/pdf/shaft_cut_layout.pdf

# РАСКРОЙ НАПРАВЛЯЮЩИХ ВАЛОВ Ø10 — 2 ПРУТКА ПО 500 мм

## fix11 · 4 вала поз. 2 · L=176 (166 + 5×2) · M10×15 · рез ≤5 мм · масштаб 1:2,5

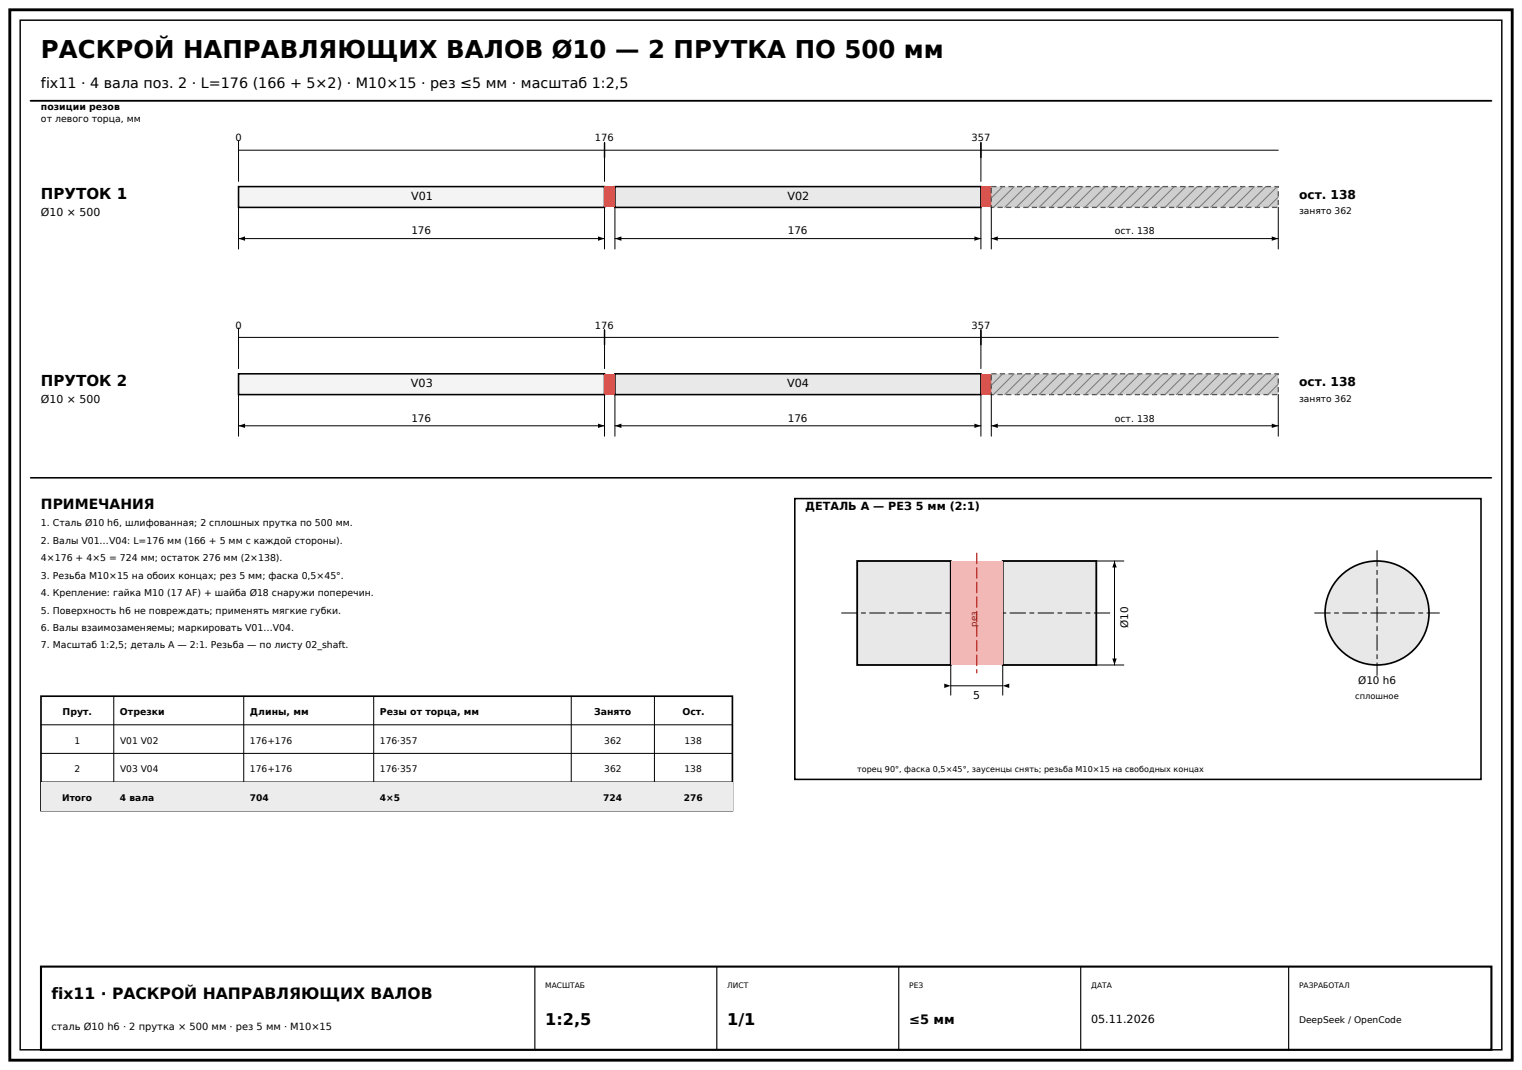
[picture p242: page 1]
ПРУТОК 1; ост. 138; занято 362; ПРУТОК 2; ПРИМЕЧАНИЯ; Прут.; Отрезки; Длины, мм; Резы от торца, мм; Занято; Ост.; Итого; 4 вала; сплошное; МАСШТАБ; ЛИСТ; РЕЗ; ДАТА; РАЗРАБОТАЛ; DeepSeek / OpenCode

позиции резов
от левого торца, мм

ДЕТАЛЬ А — РЕЗ 5 мм (2:1)рез 5

1. Сталь Ø10 h6, шлифованная; 2 сплошных прутка по 500 мм.
2. Валы V01…V04: L=176 мм (166 + 5 мм с каждой стороны).
4×176 + 4×5 = 724 мм; остаток 276 мм (2×138).
3. Резьба M10×15 на обоих концах; рез 5 мм; фаска 0,5×45°.
4. Крепление: гайка M10 (17 AF) + шайба Ø18 снаружи поперечин.
5. Поверхность h6 не повреждать; применять мягкие губки.
6. Валы взаимозаменяемы; маркировать V01…V04.
7. Масштаб 1:2,5; деталь А — 2:1. Резьба — по листу 02_shaft.

торец 90°, фаска 0,5×45°, заусенцы снять; резьба M10×15 на свободных концах

fix11 · РАСКРОЙ НАПРАВЛЯЮЩИХ ВАЛОВ

сталь Ø10 h6 · 2 прутка × 500 мм · рез 5 мм · M10×15
