inutcin/boomboom/stages/fix11/techdraw/pdf/tube_cut_layout.pdf

# РАСКРОЙ ТРУБ РАМЫ 20×20×2 — 4 ТРУБЫ ПО 1000 мм

## fix11 · сварная рама, 18 отрезков · рез ≤5 мм · масштаб 1:5

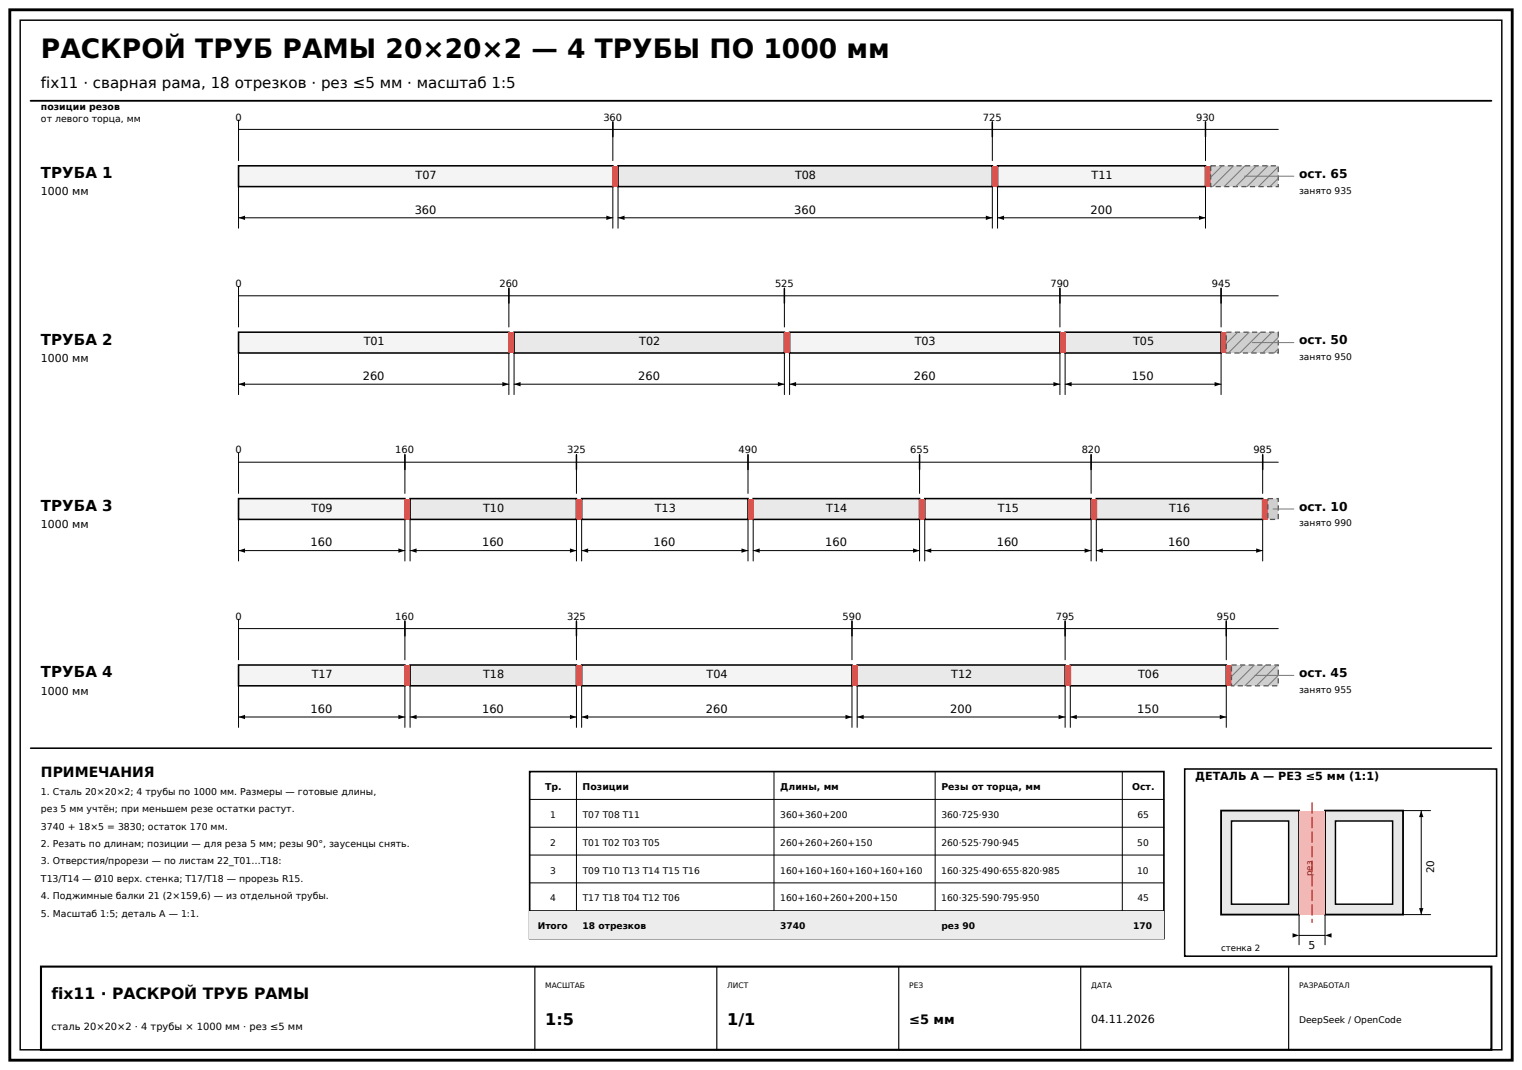
[picture p243: page 1]
ТРУБА 1; ост. 65; занято 935; ТРУБА 2; ост. 50; занято 950; ТРУБА 3; ост. 10; занято 990; ТРУБА 4; ост. 45; занято 955; ПРИМЕЧАНИЯ; Позиции; Длины, мм; Резы от торца, мм; Ост.; Итого; 18 отрезков; рез 90; стенка 2; МАСШТАБ; ЛИСТ; РЕЗ; ДАТА; РАЗРАБОТАЛ; DeepSeek / OpenCode

позиции резов
от левого торца, мм

ДЕТАЛЬ А — РЕЗ ≤5 мм (1:1) рез 5

1. Сталь 20×20×2; 4 трубы по 1000 мм. Размеры — готовые длины,
рез 5 мм учтён; при меньшем резе остатки растут.
3740 + 18×5 = 3830; остаток 170 мм.
2. Резать по длинам; позиции — для реза 5 мм; резы 90°, заусенцы снять.
3. Отверстия/прорези — по листам 22_T01…T18:
T13/T14 — Ø10 верх. стенка; T17/T18 — прорезь R15.
4. Поджимные балки 21 (2×159,6) — из отдельной трубы.
5. Масштаб 1:5; деталь А — 1:1.

fix11 · РАСКРОЙ ТРУБ РАМЫ

сталь 20×20×2 · 4 трубы × 1000 мм · рез ≤5 мм
