inutcin/boomboom/stages/fix10l/tachdraw/pdf/06_table.pdf

# СТОЛ 200×200

## ВИД Z

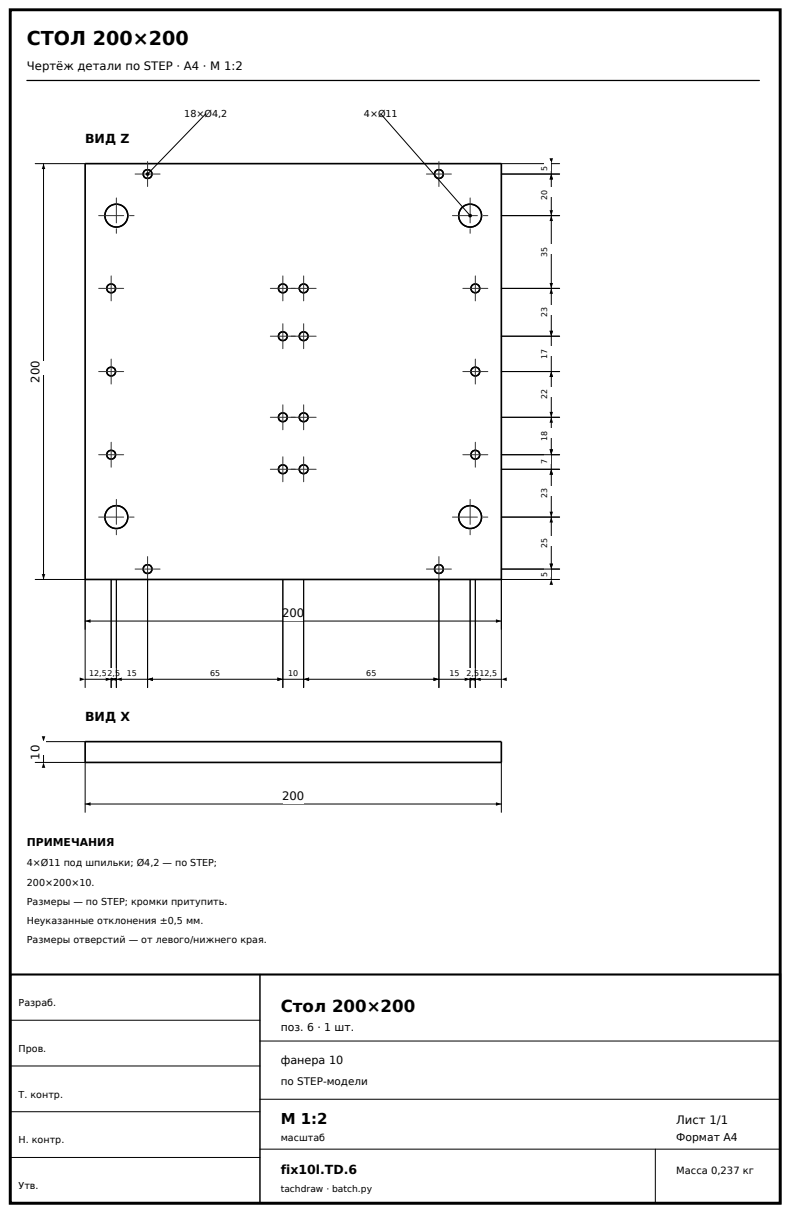
[picture p244: page 1]
Разраб.; Пров.; Т. контр.; Н. контр.; Утв.; Стол 200×200; поз. 6 · 1 шт.; масштаб; Лист 1/1 Формат A4; fix10l.TD.6; Масса 0,237 кг; ВИД X; ПРИМЕЧАНИЯ

Чертёж детали по STEP · A4 · М 1:2

4×Ø11 под шпильки; Ø4,2 — по STEP;
Размеры — по STEP; кромки притупить.
Неуказанные отклонения ±0,5 мм.
Размеры отверстий — от левого/нижнего края.

фанера 10
по STEP-модели

tachdraw · batch.py
