inutcin/boomboom/stages/fix10l/tachdraw/pdf/07_overlay.pdf

# НАКЛАДКА ВОГНУТАЯ

## ВИД Z

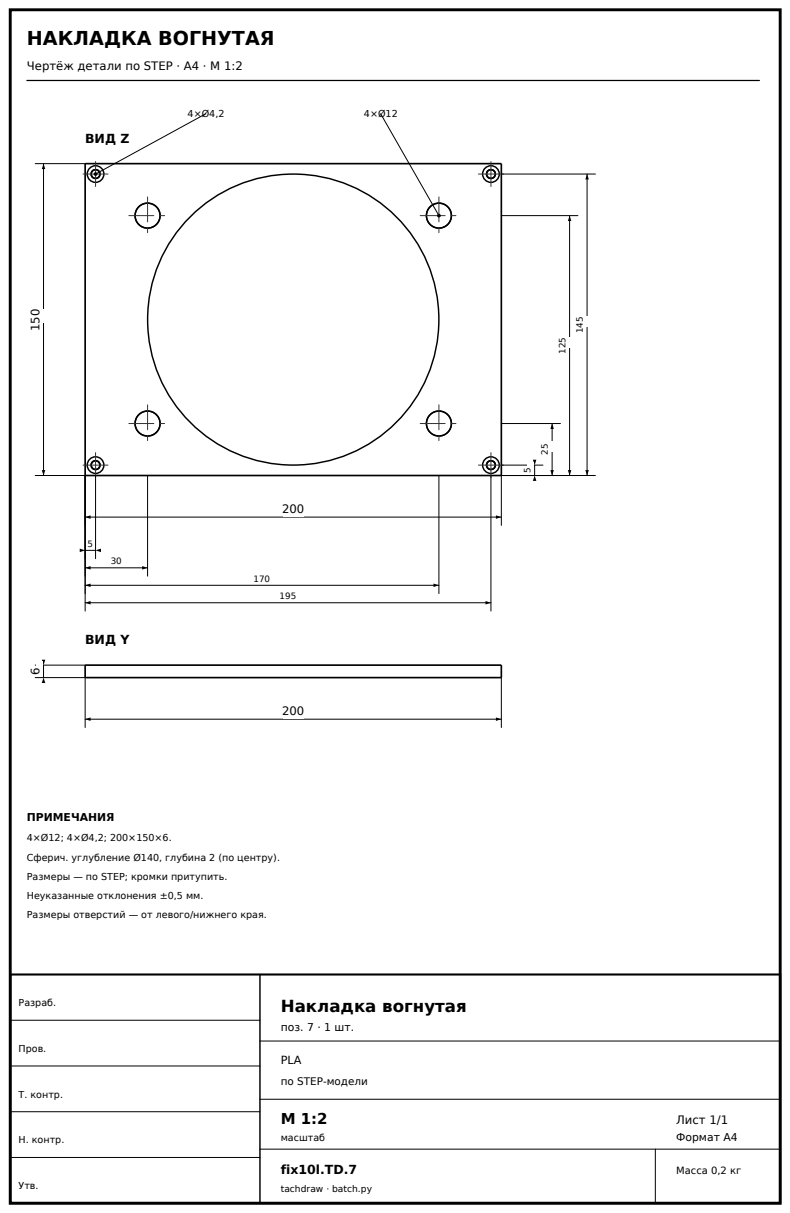
[picture p245: page 1]
Разраб.; Пров.; Т. контр.; Н. контр.; Утв.; Накладка вогнутая; поз. 7 · 1 шт.; масштаб; Лист 1/1 Формат A4; fix10l.TD.7; Масса 0,2 кг; ВИД Y; ПРИМЕЧАНИЯ

Чертёж детали по STEP · A4 · М 1:2

Сферич. углубление Ø140, глубина 2 (по центру).
Размеры — по STEP; кромки притупить.
Неуказанные отклонения ±0,5 мм.
Размеры отверстий — от левого/нижнего края.

PLA
по STEP-модели

tachdraw · batch.py
