inutcin/boomboom/stages/fix10l/tachdraw/pdf/11_podstol.pdf

# ПОДСТОЛЬЕ

## ВИД Z

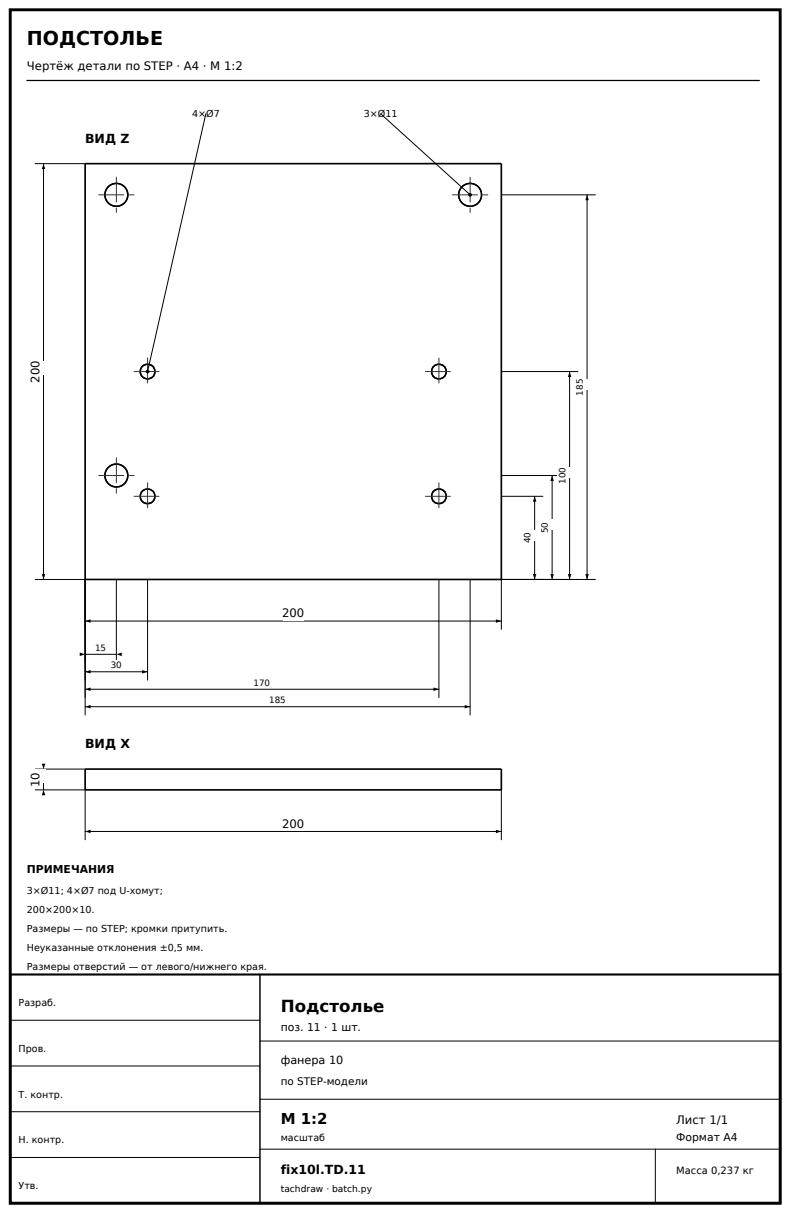
[picture p246: page 1]
Разраб.; Пров.; Т. контр.; Н. контр.; Утв.; Подстолье; поз. 11 · 1 шт.; масштаб; Лист 1/1 Формат A4; fix10l.TD.11; Масса 0,237 кг; ВИД X; ПРИМЕЧАНИЯ

Чертёж детали по STEP · A4 · М 1:2

3×Ø11; 4×Ø7 под U-хомут;
Размеры — по STEP; кромки притупить.
Неуказанные отклонения ±0,5 мм.
Размеры отверстий — от левого/нижнего края.

фанера 10
по STEP-модели

tachdraw · batch.py
