inutcin/boomboom/stages/fix10l/tachdraw/pdf/12_B01.pdf

# ПРОДОЛЬНАЯ БАЛКА B01

## Чертёж детали по STEP · A4 · М 1:2

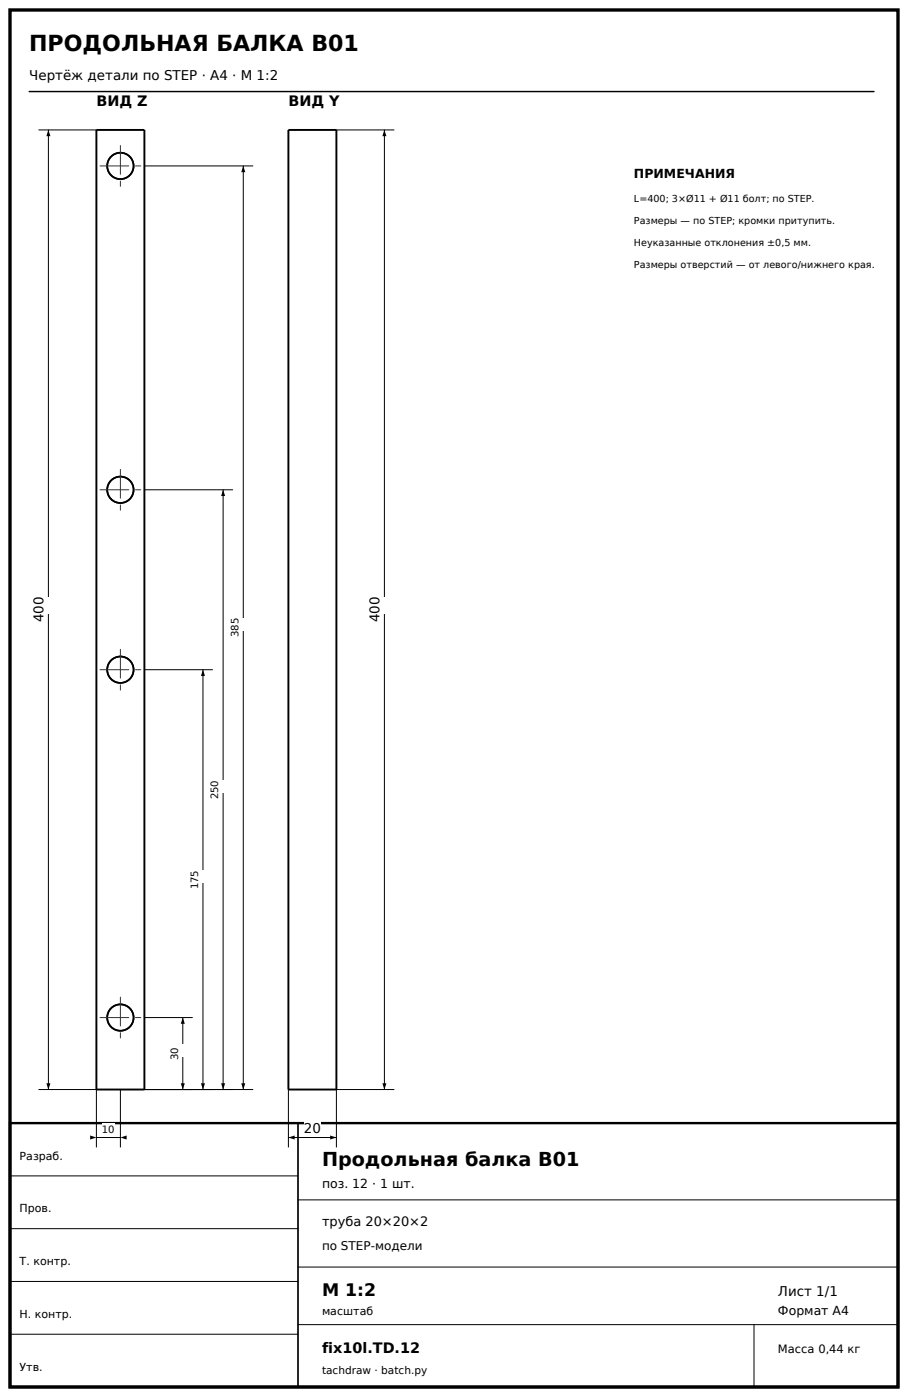
[picture p247: page 1]
Разраб.; Пров.; Т. контр.; Н. контр.; Утв.; Продольная балка B01; поз. 12 · 1 шт.; масштаб; Лист 1/1 Формат A4; fix10l.TD.12; Масса 0,44 кг; ВИД Z; ВИД Y; ПРИМЕЧАНИЯ

L=400; 3×Ø11 + Ø11 болт; по STEP.

Размеры — по STEP; кромки притупить.

Неуказанные отклонения ±0,5 мм.

Размеры отверстий — от левого/нижнего края.

труба 20×20×2
по STEP-модели

tachdraw · batch.py
