inutcin/boomboom/stages/fix10l/tachdraw/pdf/13_B03.pdf

# ПОПЕРЕЧНАЯ БАЛКА B03

## ВИД Z

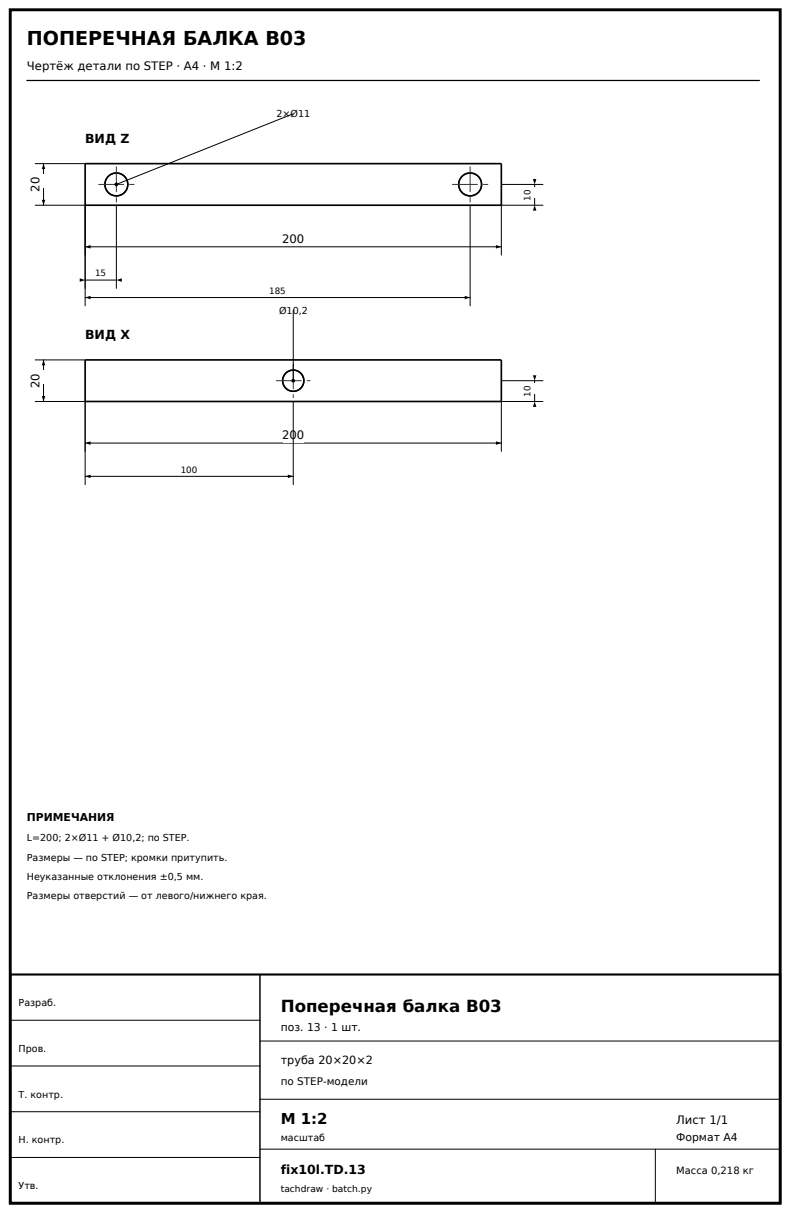
[picture p249: page 1]
Разраб.; Пров.; Т. контр.; Н. контр.; Утв.; Поперечная балка B03; поз. 13 · 1 шт.; масштаб; Лист 1/1 Формат A4; fix10l.TD.13; Масса 0,218 кг; ВИД X; ПРИМЕЧАНИЯ

Чертёж детали по STEP · A4 · М 1:2

L=200; 2×Ø11 + Ø10,2; по STEP.
Размеры — по STEP; кромки притупить.
Неуказанные отклонения ±0,5 мм.
Размеры отверстий — от левого/нижнего края.

труба 20×20×2
по STEP-модели

tachdraw · batch.py
