inutcin/boomboom/stages/fix10l/tachdraw/pdf/27_bracket_left.pdf

# УГОЛОК КРОНШТЕЙНА ЛЕВЫЙ

ВИД Z | ВИД X

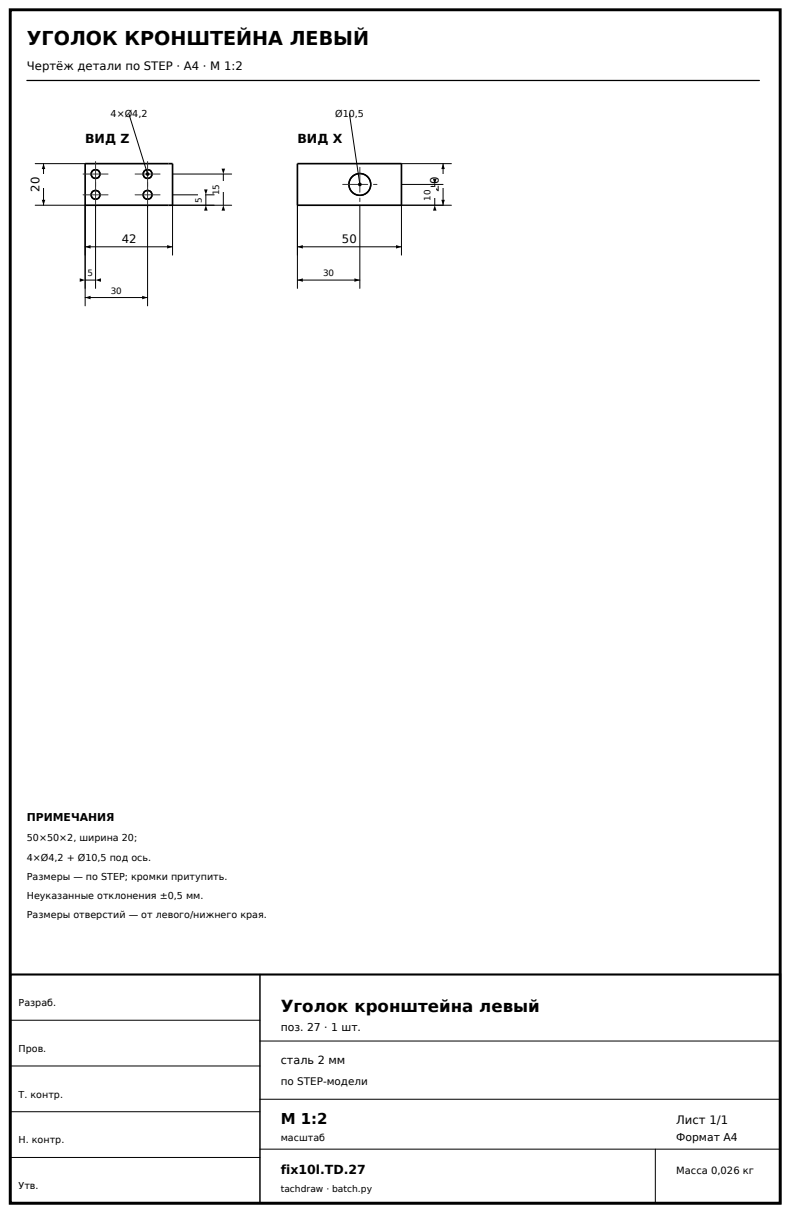
[picture p251: page 1]
Разраб.; Пров.; Т. контр.; Н. контр.; Утв.; поз. 27 · 1 шт.; масштаб; Лист 1/1 Формат A4; fix10l.TD.27; Масса 0,026 кг; ПРИМЕЧАНИЯ

Чертёж детали по STEP · A4 · М 1:2

50×50×2, ширина 20;
4×Ø4,2 + Ø10,5 под ось.
Размеры — по STEP; кромки притупить.
Неуказанные отклонения ±0,5 мм.
Размеры отверстий — от левого/нижнего края.

Уголок кронштейна левый

сталь 2 мм
по STEP-модели

tachdraw · batch.py
