inutcin/boomboom/stages/fix10l/tachdraw/pdf/27_bracket_right.pdf

# УГОЛОК КРОНШТЕЙНА ПРАВЫЙ

ВИД Z | ВИД X

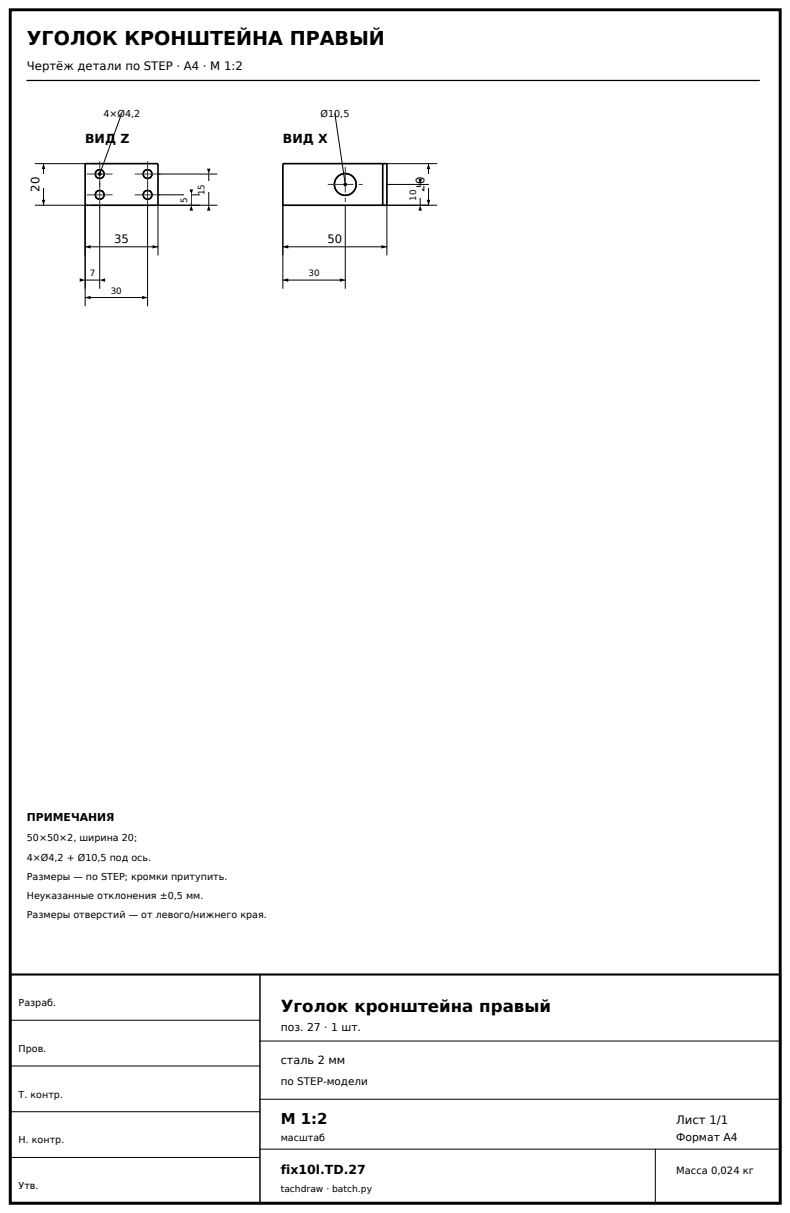
[picture p252: page 1]
Разраб.; Пров.; Т. контр.; Н. контр.; Утв.; поз. 27 · 1 шт.; масштаб; Лист 1/1 Формат A4; fix10l.TD.27; Масса 0,024 кг; ПРИМЕЧАНИЯ

Чертёж детали по STEP · A4 · М 1:2

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

Уголок кронштейна правый

сталь 2 мм
по STEP-модели

tachdraw · batch.py
