inutcin/boomboom/stages/fix11/tachdraw/pdf/04_overlay.pdf

# НАКЛАДКА ВОГНУТАЯ

## ВИД Z

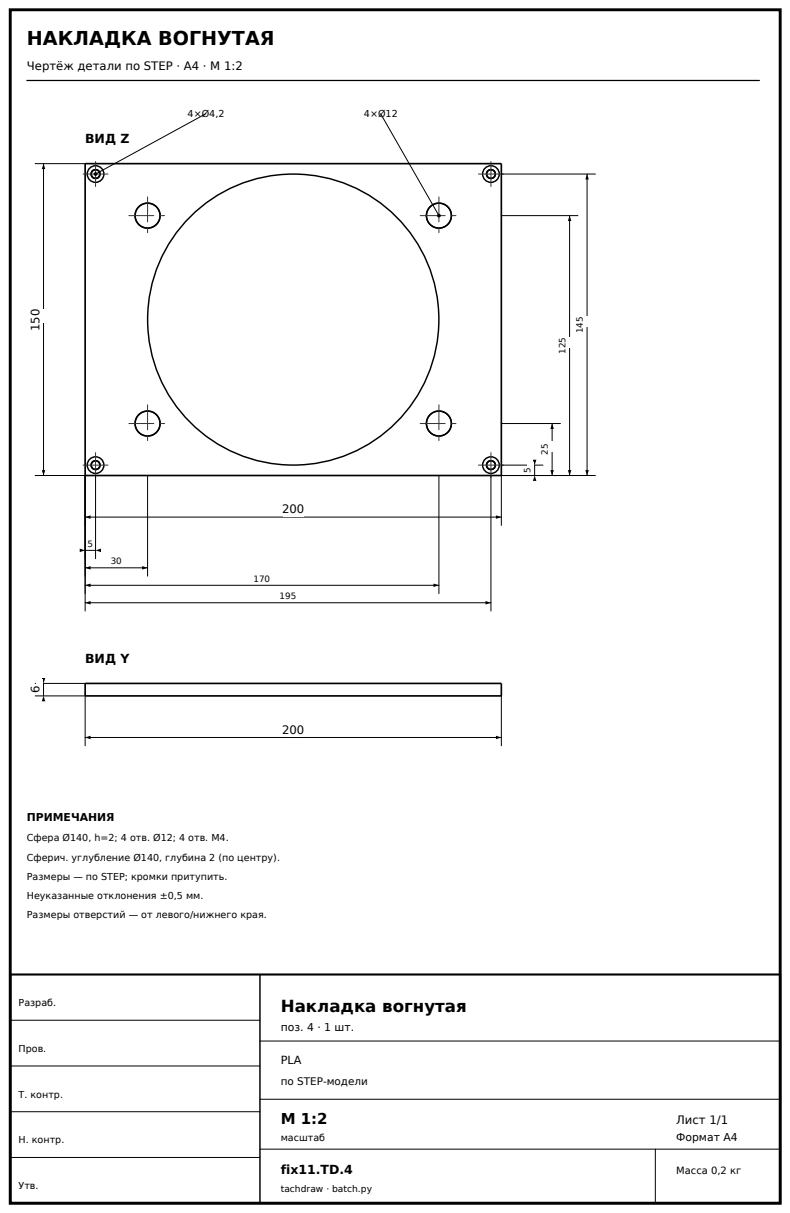
[picture p253: page 1]
Разраб.; Пров.; Т. контр.; Н. контр.; Утв.; Накладка вогнутая; поз. 4 · 1 шт.; масштаб; Лист 1/1 Формат A4; fix11.TD.4; Масса 0,2 кг; ВИД Y; ПРИМЕЧАНИЯ

Чертёж детали по STEP · A4 · М 1:2

Сфера Ø140, h=2; 4 отв. Ø12; 4 отв. M4.
Сферич. углубление Ø140, глубина 2 (по центру).
Размеры — по STEP; кромки притупить.
Неуказанные отклонения ±0,5 мм.
Размеры отверстий — от левого/нижнего края.

PLA
по STEP-модели

tachdraw · batch.py
