inutcin/boomboom/stages/fix11/tachdraw/pdf/05_table.pdf

# СТОЛ

## ВИД Z

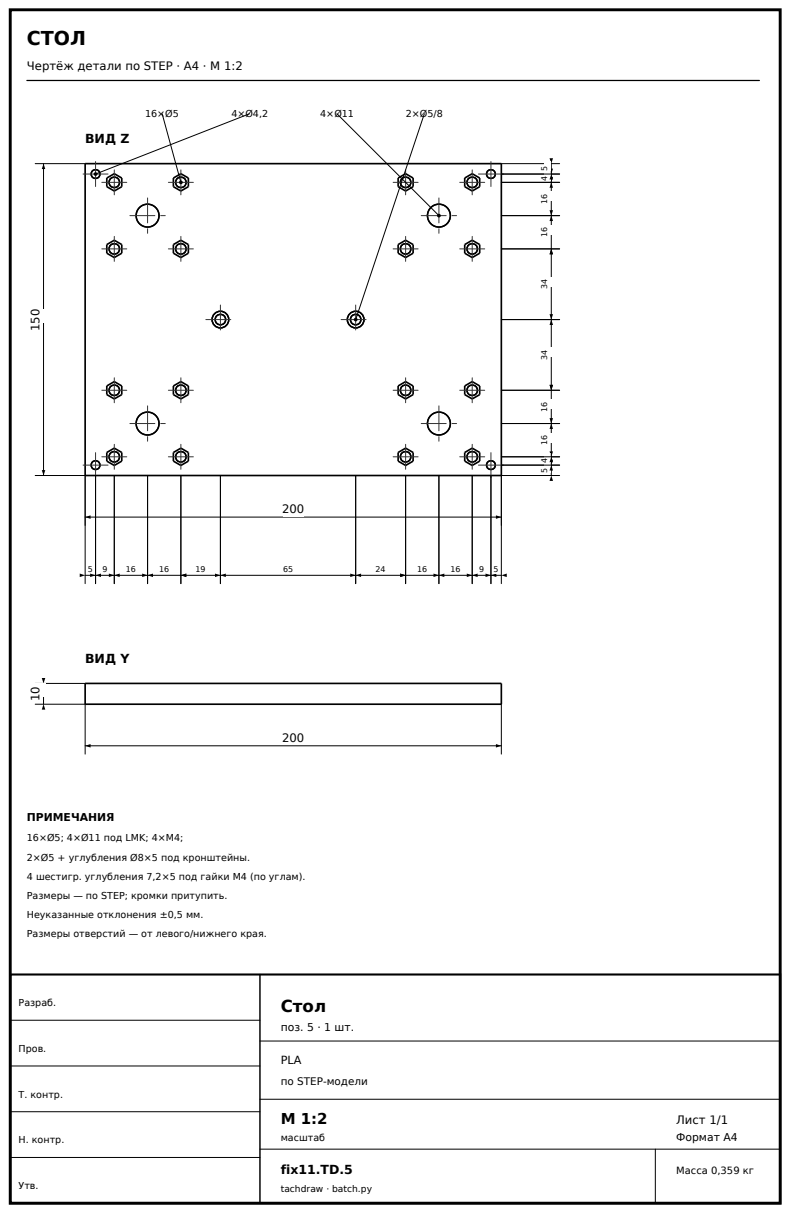
[picture p254: page 1]
Разраб.; Пров.; Т. контр.; Н. контр.; Утв.; Стол; поз. 5 · 1 шт.; масштаб; Лист 1/1 Формат A4; fix11.TD.5; Масса 0,359 кг; ВИД Y; ПРИМЕЧАНИЯ

Чертёж детали по STEP · A4 · М 1:2

16×Ø5; 4×Ø11 под LMK; 4×M4;
2×Ø5 + углубления Ø8×5 под кронштейны.
4 шестигр. углубления 7,2×5 под гайки M4 (по углам).
Размеры — по STEP; кромки притупить.
Неуказанные отклонения ±0,5 мм.
Размеры отверстий — от левого/нижнего края.

PLA
по STEP-модели

tachdraw · batch.py
