inutcin/boomboom/stages/fix11/tachdraw/pdf/06_bracket.pdf

# КРОНШТЕЙН РОЛИКА

ВИД X | ВИД Z

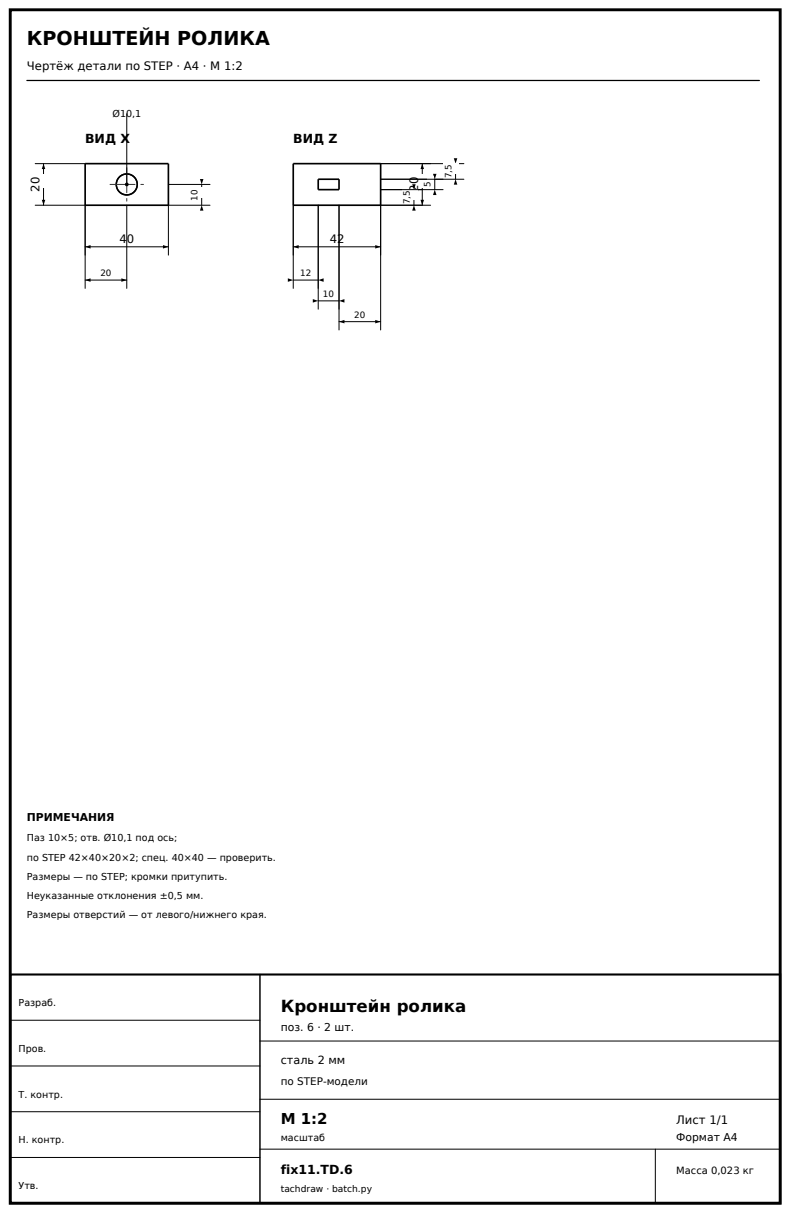
[picture p255: page 1]
Разраб.; Пров.; Т. контр.; Н. контр.; Утв.; Кронштейн ролика; поз. 6 · 2 шт.; масштаб; Лист 1/1 Формат A4; fix11.TD.6; Масса 0,023 кг; ПРИМЕЧАНИЯ

Чертёж детали по STEP · A4 · М 1:2

Паз 10×5; отв. Ø10,1 под ось;
по STEP 42×40×20×2; спец. 40×40 — проверить.
Размеры — по STEP; кромки притупить.
Неуказанные отклонения ±0,5 мм.
Размеры отверстий — от левого/нижнего края.

сталь 2 мм
по STEP-модели

tachdraw · batch.py
