inutcin/boomboom/stages/fix11/tachdraw/pdf/10_cam_10.pdf

# КУЛАЧКОВЫЙ ДИСК (ХОД 10)

## ВИД X

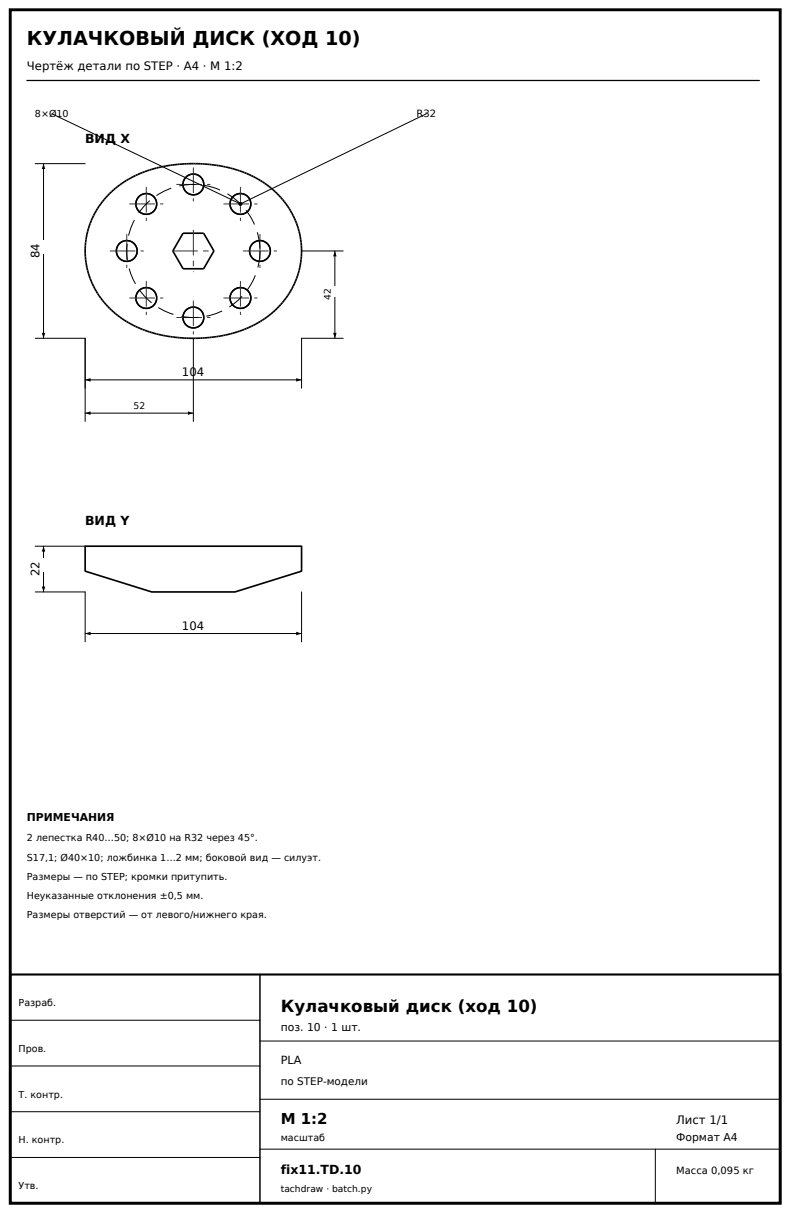
[picture p256: page 1]
Разраб.; Пров.; Т. контр.; Н. контр.; Утв.; поз. 10 · 1 шт.; масштаб; Лист 1/1 Формат A4; fix11.TD.10; Масса 0,095 кг; ВИД Y; ПРИМЕЧАНИЯ

Чертёж детали по STEP · A4 · М 1:2

2 лепестка R40…50; 8×Ø10 на R32 через 45°.
S17,1; Ø40×10; ложбинка 1…2 мм; боковой вид — силуэт.
Размеры — по STEP; кромки притупить.
Неуказанные отклонения ±0,5 мм.
Размеры отверстий — от левого/нижнего края.

Кулачковый диск (ход 10)

PLA
по STEP-модели

tachdraw · batch.py
