inutcin/boomboom/stages/fix11/tachdraw/pdf/11_podstol.pdf

# ПОДСТОЛЬЕ

## ВИД Z

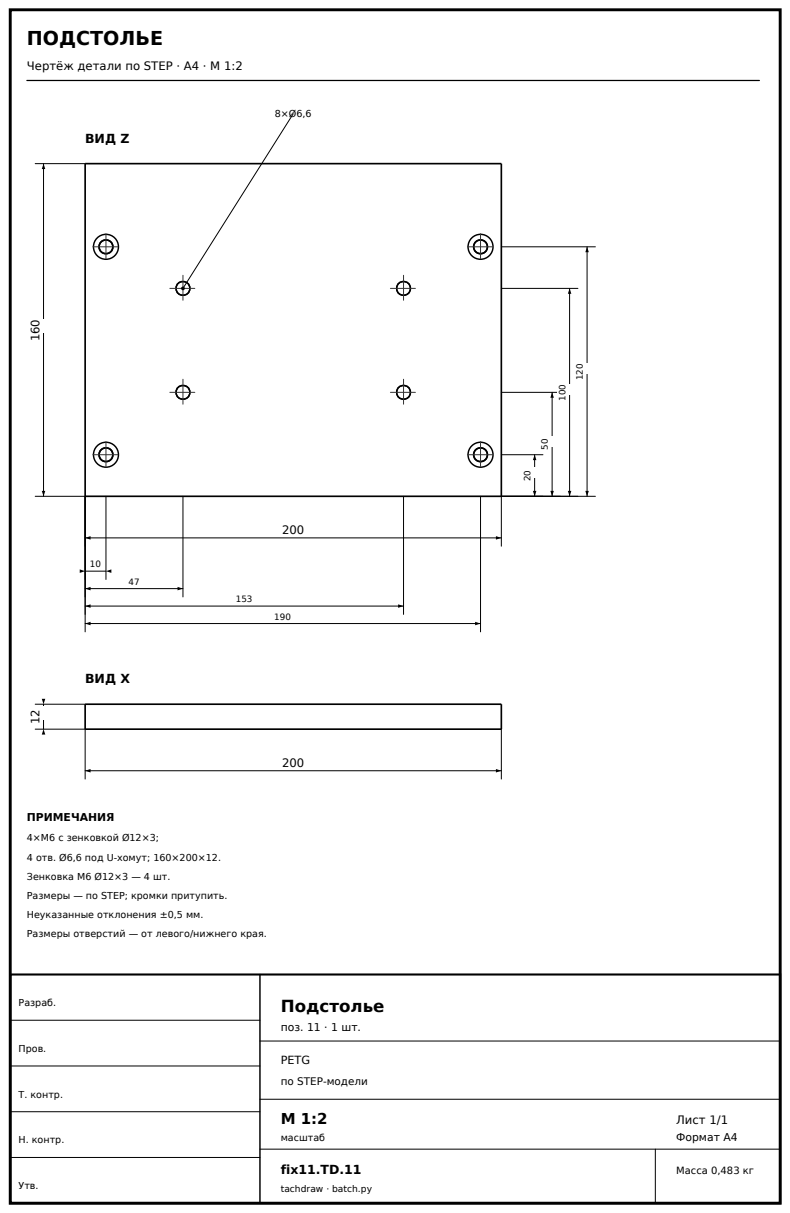
[picture p257: page 1]
Разраб.; Пров.; Т. контр.; Н. контр.; Утв.; Подстолье; поз. 11 · 1 шт.; масштаб; Лист 1/1 Формат A4; fix11.TD.11; Масса 0,483 кг; ВИД X; ПРИМЕЧАНИЯ

Чертёж детали по STEP · A4 · М 1:2

4×M6 с зенковкой Ø12×3;
4 отв. Ø6,6 под U-хомут; 160×200×12.
Зенковка M6 Ø12×3 — 4 шт.
Размеры — по STEP; кромки притупить.
Неуказанные отклонения ±0,5 мм.
Размеры отверстий — от левого/нижнего края.

PETG
по STEP-модели

tachdraw · batch.py
