inutcin/boomboom/stages/fix11/tachdraw/pdf/14_angle.pdf

# НАКЛАДКА-УГОЛОК БАЛКИ 21

ВИД X | ВИД Y

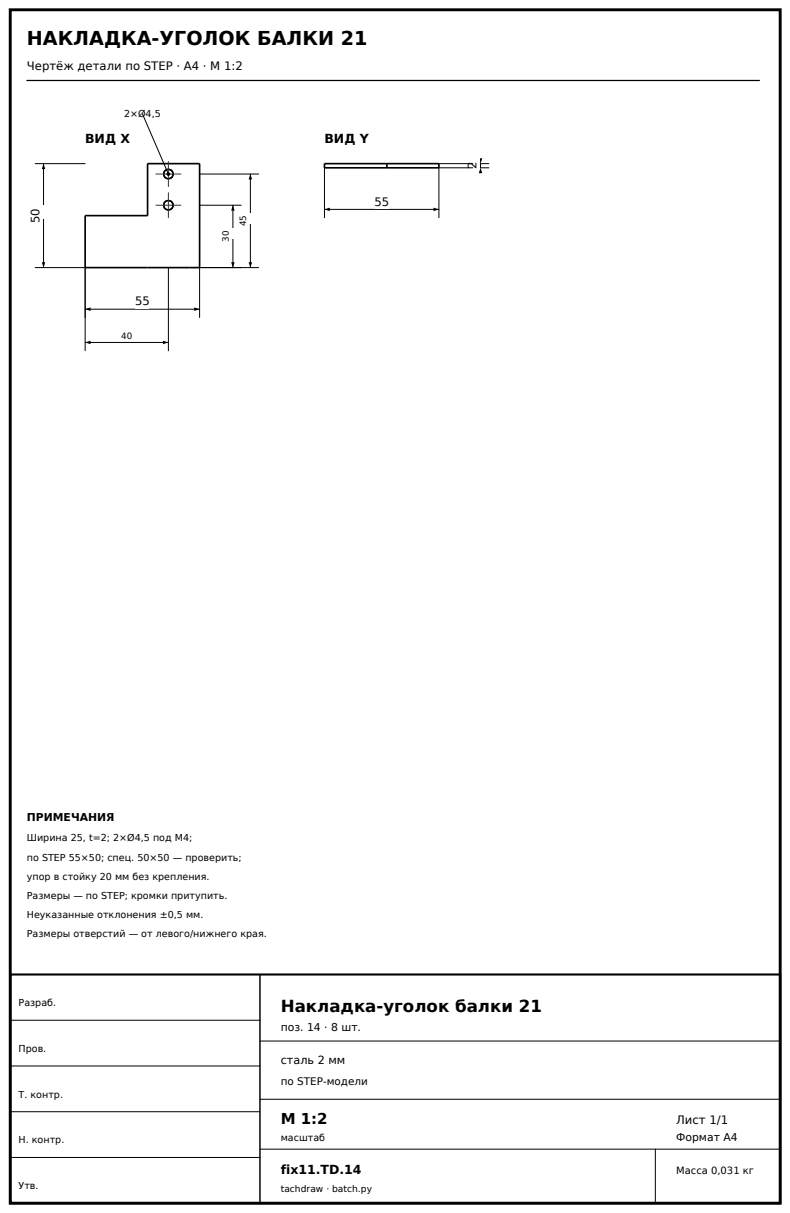
[picture p258: page 1]
Разраб.; Пров.; Т. контр.; Н. контр.; Утв.; поз. 14 · 8 шт.; масштаб; Лист 1/1 Формат A4; fix11.TD.14; Масса 0,031 кг; ПРИМЕЧАНИЯ

Чертёж детали по STEP · A4 · М 1:2

Ширина 25, t=2; 2×Ø4,5 под M4;
по STEP 55×50; спец. 50×50 — проверить;
упор в стойку 20 мм без крепления.
Размеры — по STEP; кромки притупить.
Неуказанные отклонения ±0,5 мм.
Размеры отверстий — от левого/нижнего края.

Накладка-уголок балки 21

сталь 2 мм
по STEP-модели

tachdraw · batch.py
