inutcin/boomboom/stages/fix11/tachdraw/pdf/21_beam.pdf

# БАЛКА 21 — ПОДЖИМНАЯ БАЛКА

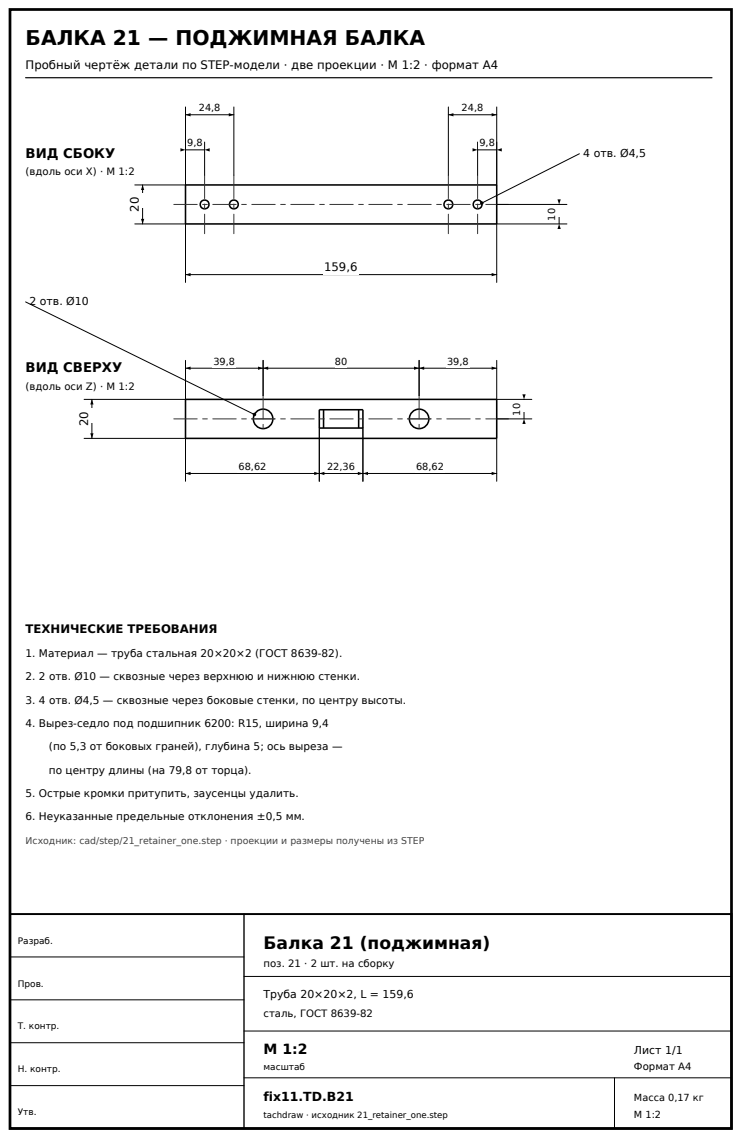
[picture p259: page 1]
Разраб.; Пров.; Т. контр.; Н. контр.; Утв.; Балка 21 (поджимная); Труба 20×20×2, L = 159,6; сталь, ГОСТ 8639-82; масштаб; Лист 1/1 Формат A4; fix11.TD.B21; Масса 0,17 кг; ВИД СБОКУ; (вдоль оси X) · М 1:2; ВИД СВЕРХУ; (вдоль оси Z) · М 1:2; 4 отв. Ø4,5; 2 отв. Ø10; ТЕХНИЧЕСКИЕ ТРЕБОВАНИЯ

Пробный чертёж детали по STEP-модели · две проекции · М 1:2 · формат A4

1. Материал — труба стальная 20×20×2 (ГОСТ 8639-82).
2. 2 отв. Ø10 — сквозные через верхнюю и нижнюю стенки.
3. 4 отв. Ø4,5 — сквозные через боковые стенки, по центру высоты.
4. Вырез-седло под подшипник 6200: R15, ширина 9,4
(по 5,3 от боковых граней), глубина 5; ось выреза —
по центру длины (на 79,8 от торца).
5. Острые кромки притупить, заусенцы удалить.
6. Неуказанные предельные отклонения ±0,5 мм.

Исходник: cad/step/21_retainer_one.step · проекции и размеры получены из STEP

поз. 21 · 2 шт. на сборку

tachdraw · исходник 21_retainer_one.step
