inutcin/boomboom/stages/fix11/tachdraw/pdf/22_T01.pdf

# СТОЙКА ВЫСОКАЯ (T01)

## ВИД Y

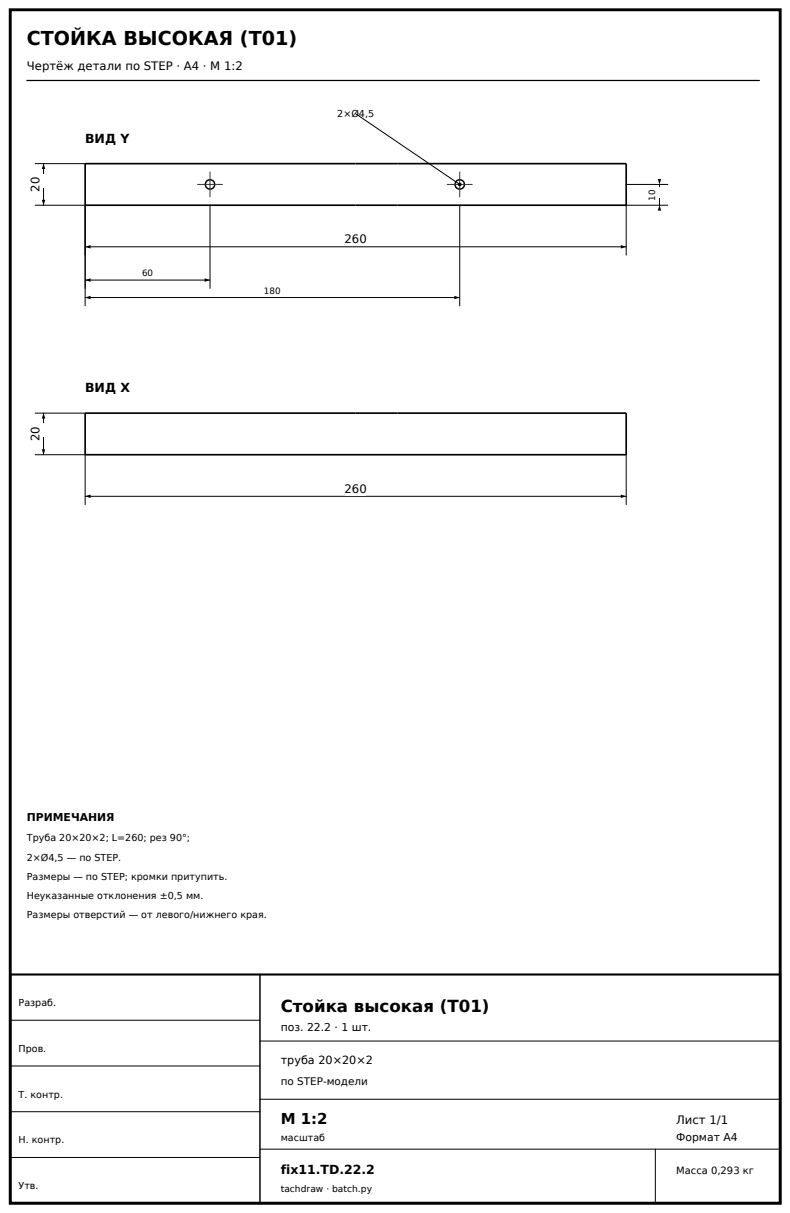
[picture p260: page 1]
Разраб.; Пров.; Т. контр.; Н. контр.; Утв.; Стойка высокая (T01); поз. 22.2 · 1 шт.; масштаб; Лист 1/1 Формат A4; fix11.TD.22.2; Масса 0,293 кг; ВИД X; ПРИМЕЧАНИЯ

Чертёж детали по STEP · A4 · М 1:2

Труба 20×20×2; L=260; рез 90°;
2×Ø4,5 — по STEP.
Размеры — по STEP; кромки притупить.
Неуказанные отклонения ±0,5 мм.
Размеры отверстий — от левого/нижнего края.

труба 20×20×2
по STEP-модели

tachdraw · batch.py
