inutcin/boomboom/stages/fix11/tachdraw/pdf/22_T07.pdf

# НИЖНЯЯ ПРОДОЛЬНАЯ (T07)

## Чертёж детали по STEP · A4 · М 1:2

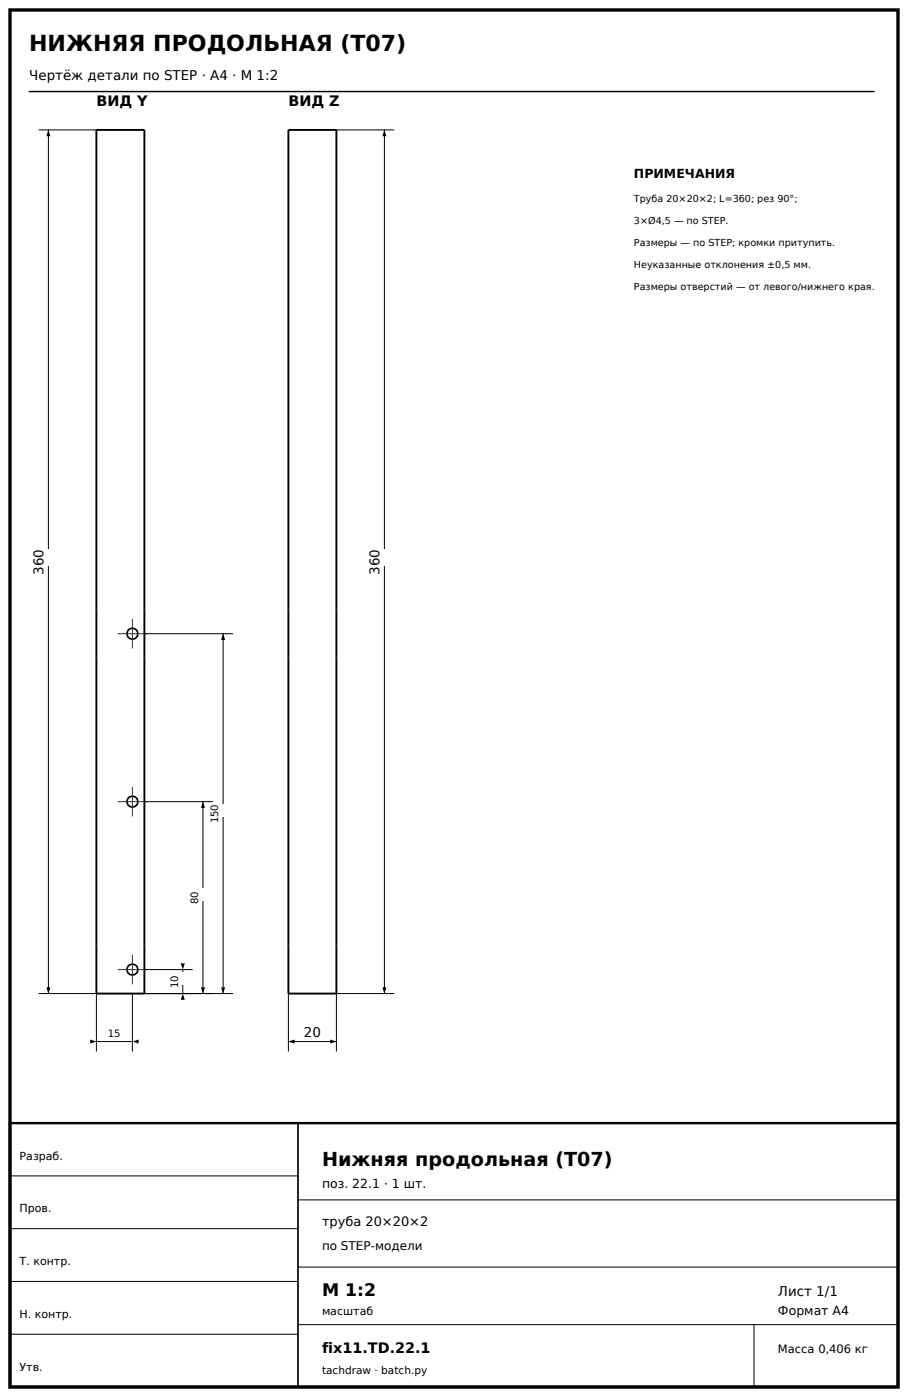
[picture p261: page 1]
Разраб.; Пров.; Т. контр.; Н. контр.; Утв.; Нижняя продольная (T07); поз. 22.1 · 1 шт.; масштаб; Лист 1/1 Формат A4; fix11.TD.22.1; Масса 0,406 кг; ВИД Y; ВИД Z; ПРИМЕЧАНИЯ; Труба 20×20×2; L=360; рез 90°;; 3×Ø4,5 — по STEP.

Размеры — по STEP; кромки притупить.

Неуказанные отклонения ±0,5 мм.

Размеры отверстий — от левого/нижнего края.

труба 20×20×2
по STEP-модели

tachdraw · batch.py
