inutcin/boomboom/stages/fix11/tachdraw/pdf/22_T09.pdf

# ВЕРХНЯЯ ВИБРООТСЕКА (T09)

## ВИД Y

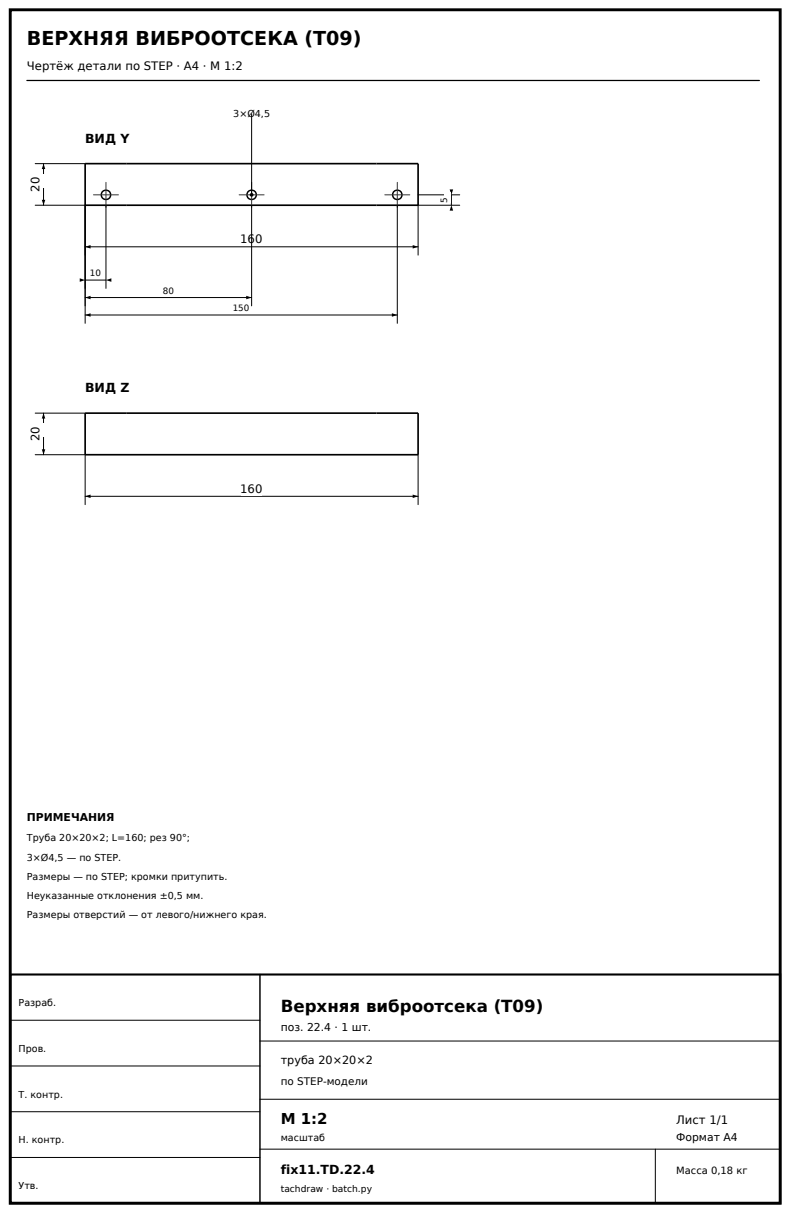
[picture p262: page 1]
Разраб.; Пров.; Т. контр.; Н. контр.; Утв.; Верхняя виброотсека (T09); поз. 22.4 · 1 шт.; масштаб; Лист 1/1 Формат A4; fix11.TD.22.4; Масса 0,18 кг; ВИД Z; ПРИМЕЧАНИЯ

Чертёж детали по STEP · A4 · М 1:2

Труба 20×20×2; L=160; рез 90°;
3×Ø4,5 — по STEP.
Размеры — по STEP; кромки притупить.
Неуказанные отклонения ±0,5 мм.
Размеры отверстий — от левого/нижнего края.

труба 20×20×2
по STEP-модели

tachdraw · batch.py
