inutcin/boomboom/stages/fix11/tachdraw/pdf/22_T11.pdf

# ВЕРХНЯЯ ВЫНОСА (T11)

## ВИД Z

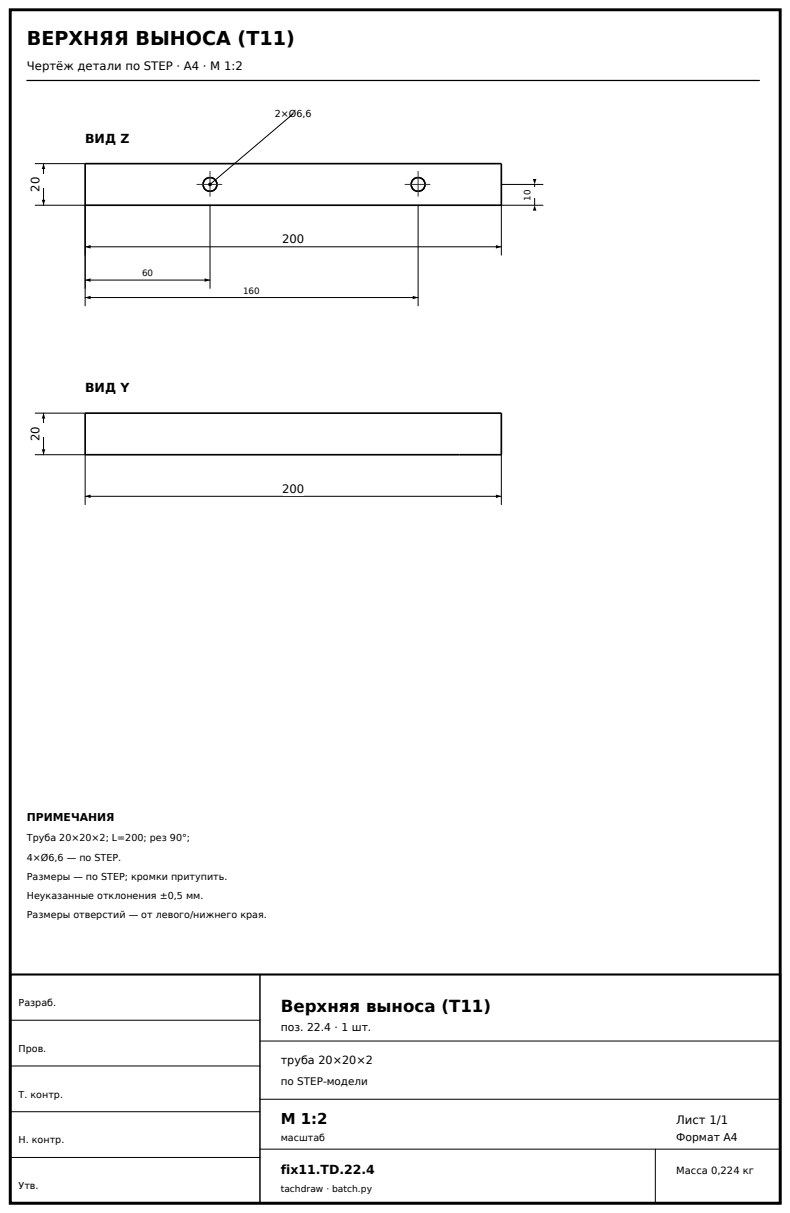
[picture p263: page 1]
Разраб.; Пров.; Т. контр.; Н. контр.; Утв.; Верхняя выноса (T11); поз. 22.4 · 1 шт.; масштаб; Лист 1/1 Формат A4; fix11.TD.22.4; Масса 0,224 кг; ВИД Y; ПРИМЕЧАНИЯ

Чертёж детали по STEP · A4 · М 1:2

Труба 20×20×2; L=200; рез 90°;
4×Ø6,6 — по STEP.
Размеры — по STEP; кромки притупить.
Неуказанные отклонения ±0,5 мм.
Размеры отверстий — от левого/нижнего края.

труба 20×20×2
по STEP-модели

tachdraw · batch.py
