inutcin/boomboom/stages/fix11/tachdraw/pdf/22_T13.pdf

# НИЖНЯЯ ПОПЕРЕЧИНА (T13)

## ВИД Z

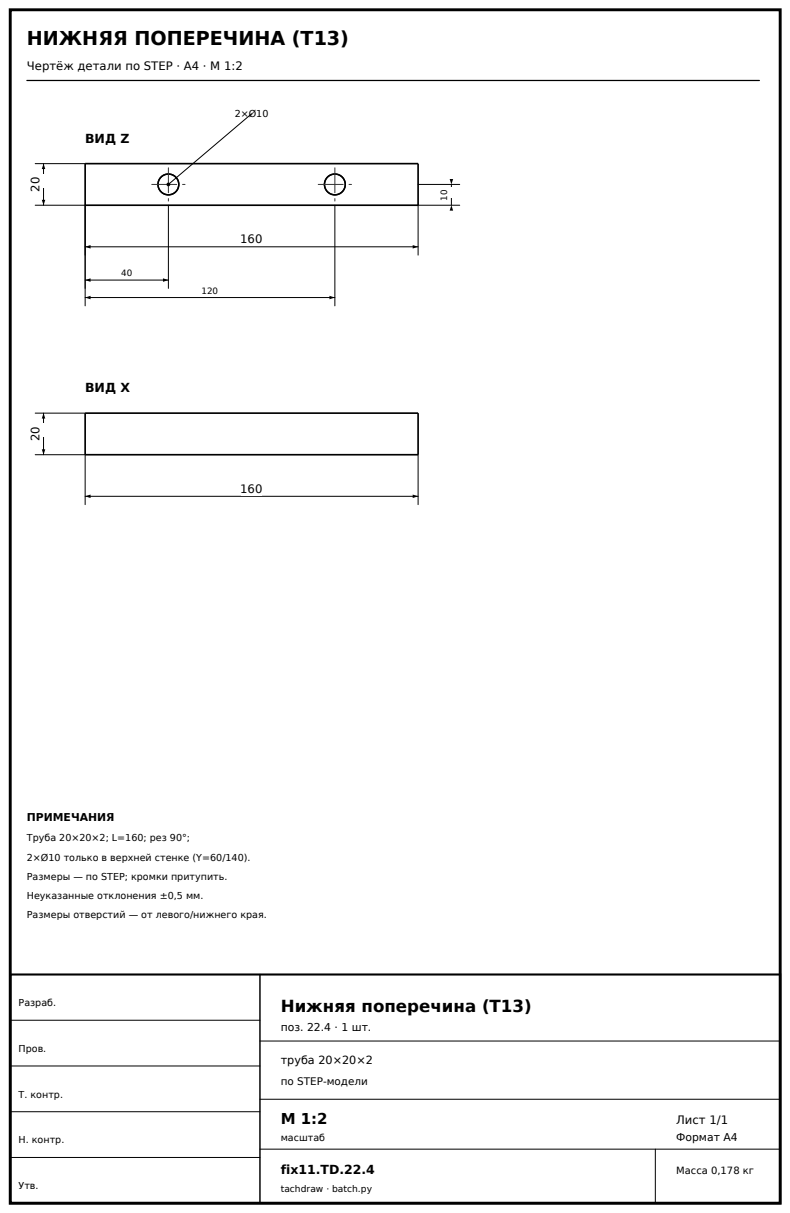
[picture p264: page 1]
Разраб.; Пров.; Т. контр.; Н. контр.; Утв.; Нижняя поперечина (T13); поз. 22.4 · 1 шт.; масштаб; Лист 1/1 Формат A4; fix11.TD.22.4; Масса 0,178 кг; ВИД X; ПРИМЕЧАНИЯ

Чертёж детали по STEP · A4 · М 1:2

Труба 20×20×2; L=160; рез 90°;
2×Ø10 только в верхней стенке (Y=60/140).
Размеры — по STEP; кромки притупить.
Неуказанные отклонения ±0,5 мм.
Размеры отверстий — от левого/нижнего края.

труба 20×20×2
по STEP-модели

tachdraw · batch.py
