inutcin/boomboom/stages/fix11/tachdraw/pdf/22_T17.pdf

# СРЕДНЯЯ ПОПЕРЕЧИНА (T17)

## ВИД -Z

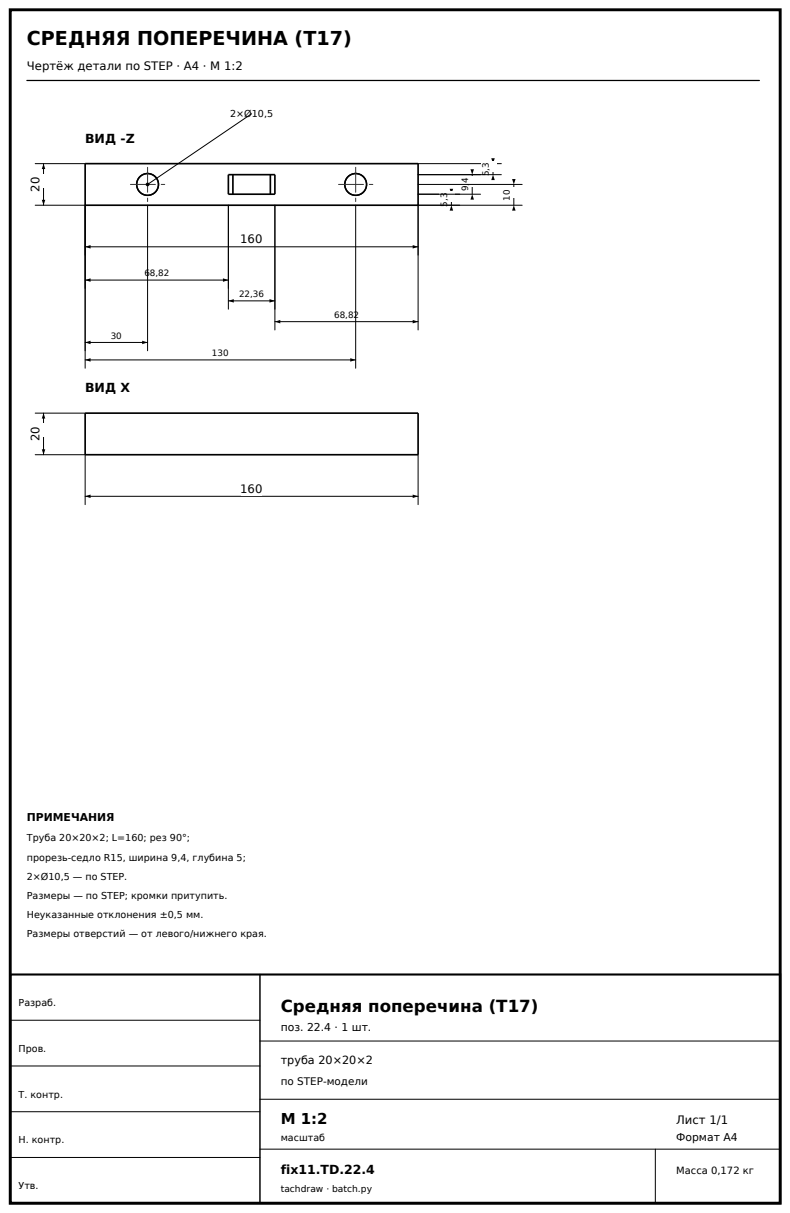
[picture p266: page 1]
Разраб.; Пров.; Т. контр.; Н. контр.; Утв.; Средняя поперечина (T17); поз. 22.4 · 1 шт.; масштаб; Лист 1/1 Формат A4; fix11.TD.22.4; Масса 0,172 кг; ВИД X; ПРИМЕЧАНИЯ

Чертёж детали по STEP · A4 · М 1:2

Труба 20×20×2; L=160; рез 90°;
прорезь-седло R15, ширина 9,4, глубина 5;
2×Ø10,5 — по STEP.
Размеры — по STEP; кромки притупить.
Неуказанные отклонения ±0,5 мм.
Размеры отверстий — от левого/нижнего края.

труба 20×20×2
по STEP-модели

tachdraw · batch.py
