inutcin/boomboom/(commit log)

2026-10-27 Этам модели. Начало
2026-10-27 Первая версия модели
2026-10-27 Корректировки и замечания часть 1
2026-10-27 Корректировки часть 1.
2026-10-27 Задание на этам инженерной экспертизы.
2026-10-27 Инженерная экспертиза
2026-10-28 Экспертиза инженерная и корректировки по ней
2026-10-28 Save last stage and repeat all for new sketch
2026-10-28 New device description
2026-10-28 1-st stage
2026-10-29 CAD-oriented fixing
2026-11-02 Frame tubes and corners
2026-11-04 tubes cut
2026-11-04 tubes cut 2
2026-11-05 shaft cut
